oznav2/tectile_skin/electronics/README.md

<div dir="rtl" lang="he">

עברית · [English](README.en.md)

# אלקטרוניקת החישה של ROBOSKIN

זו תת־מערכת חישה עצמאית במתח נמוך לעור אלקטרוני מודולרי. טלאי מלא מודד 28 אתרי מגע נפרדים ושתי טמפרטורות מקומיות. כל טלאי ממיר את אותותיו מקומית ושולח אותם בצמת הזנה ו־CAN FD בעלת ארבעה חוטים. הבנייה הראשונית משתמשת ב־**ספק מעבדה מבודד ומיוצב של 5 V**.

## מה מסופק

- [מעגל טלאי](patch_circuit.json), [חיבורי פינים](patch_circuit_connections.csv) ו[שרטוט מעגל](../assets/electronics/patch_schematic.svg): ‏222 רכיבים ו־104 רשתות, כולל חיישנים מודפסים מרוחקים ונגדי אבחון. בבקר 88 נגדים ו־52 קבלים; 28 נגדי סוף הקו המרוחקים הם נוספים.
- [מעגל אזורי](region_circuit.json), [חיבורים אזוריים](region_circuit_connections.csv) ו[שרטוט צמה](../assets/electronics/wiring_diagram.svg): הזנה מוגנת, חיווי תקלה, איפוס ידני, שני סיומים קבועים ושמונה הסתעפויות מפוזרות על קו ראשי ליניארי רציף.
- [טבלת קצות צמה](harness_connections.csv), [חוזה הזנה](supply_contract.json), [הרכבה וקבלה](assembly_and_acceptance.md), [יומן מקורות יצרן](datasheet_traceability.md), [נתוני עלות רכיבים](patch_cost_inputs.csv), [BOM של המערכת](system_bom.csv) ו[תרחישי עלות](cost_scenarios.json).

ה־JSON הוא **מפרט מעגל ברמת פינים** הניתן לעריכה. קובצי `.net` התואמים הם יצוא בפורמט החלפה XML של KiCad. מחרוזות מארז הן רמזים, ולא הפניות מוסמכות לספריית טביעות רגל. קבצים אלה אינם סכמה מקורית, PCB מנותב, סטנסיל או שחרור לייצור. שרטוט סכמה ו־ERC, אימות טביעות רגל, ניתוב PCB ו־DRC ובדיקות פיזיות נשארים שלבי הנדסה נדרשים. אין טענה לאימות חומרה.

הפיקו מחדש ובדקו את קובצי המעגל המקוריים ללא חיבור לרשת:

<div dir="ltr">

```sh
python3 electronics/build_circuit.py
python3 electronics/test_circuit.py
```

</div>

שמונה בדיקות מכסות קישוריות, הקצאות פינים במארז, מיעון חיישנים עצמאי, כיסוי הגנה, טופולוגיית הזנה, מצב המתנה, סיום אפיק ועקביות פורמט ההחלפה. הן אינן מוכיחות חסינות להפרעות אלקטרומגנטיות, תשואת ייצור או תמונת קושחת MCU פועלת.

## חוזה חשמלי

השתמשו ב־4.75–5.25 V בכניסה האזורית, ובמתח נומינלי 5.00 V. יעד האדווה הוא לכל היותר 100 mV משיא לשיא ברוחב פס מדידה של 20 MHz. בצומת הרחוק ביותר, כניסת ה־LDO המוגנת חייבת להישאר לפחות 3.8 V תחת עומס השיא המדוד. לטלאי מוקצים 30 mA בממוצע ו־80 mA בשיא; לאזור של שמונה צמתים 240 mA בממוצע ו־640 mA בשיא. אלה הקצאות תכנון עד למדידה. הנתיך האלקטרוני האזורי הננעל בכיבוי הוא נומינלית 1 A; מגבלת ספק המעבדה היא 1.5 A לאחר בדיקות התנעה של צמתים נפרדים.

CAN FD משתמש ב־1 Mbit/s בבוררות וב־2 Mbit/s לנתונים. הגבילו את הקו הראשי הליניארי ל־2 m וכל הסתעפות ל־50 mm. הרכיבו בדיוק שני נגדי סיום של 120 Ω על הקו הראשי הקבוע. התנגדות CANH–CANL כאשר המתח כבוי צריכה להיות כ־60 Ω. ניתוק צומת משאיר את הקו הראשי ואת הסיומים שלמים; קצר בקו הראשי עדיין יכול להשבית את כל האזור.

מתאם הייחוס למעבדה הוא **PEAK IPEH-004022** המבודד. בחיבור D-sub שלו: פין 7 הוא CANH, פין 2 הוא CANL ופינים 3/6 הם אדמת החיישנים. השאירו את פין ההזנה האופציונלי 1 לא מחובר ואת הסיום הפנימי כבוי. קשרו את ממשק המארח למספר הסידורי או לנתיב USB של המתאם הפיזי. שם כמו `can0` אינו זהות התקן. [ממשק ומפת פינים של היצרן](https://www.peak-system.com/products/hardware/external-pc-interfaces/pcan-usb-fd/).

האדמה בצד האפיק של המתאם המבודד שייכת להזנת החיישנים. אוסצילוסקופ או מתכנת מוארק עלולים לגשר בשוגג על בידוד זה. השתמשו במדידה מבודדת או דיפרנציאלית מתאימה ואמתו את כל מסלולי הזרם החוזר לפני חיבור מתח למתקן.

## היקף החישה ודוגמת עלות

הטלאי הבסיסי מספק מיקום מגע, עוצמת מגע סדרית ושתי **טמפרטורות נקודתיות אמיתיות**. הוא אינו מספק כוח מכויל, גזירה, קִרבה, תמונה תרמית רציפה או עצירה בעלת דירוג בטיחות. מסלול סוף הקו המרוחק מזהה חלק מהנתקים במוליכים; הוא אינו יכול להוכיח שציפוי רגיש ללחץ שלם.

ב[דוגמה הכללית של שמונה בקרים](example_configuration.json) מספרי האתרים הפעילים הם `4, 6, 4, 6, 6, 28, 6, 28`: **88 אתרי מגע ו־16 נקודות NTC**. זו תצורת בדיקה נייחת, ולא טענה להתאמה או לכיסוי ברובוט מסוים. מסכות שהוכנסו לשירות משביתות ערוצי ADC שאינם בשימוש.

עלות היחידה המחושבת לטלאי מלא היא **$34.78 בכמות ייצור מונחת של 1,000 טלאים**: ‏($29.24 חומר והרכבה חיצונית + $3.30 תהליך סופי + $0.50 תיקון צפוי) / תשואה של 95%. הקצבת התהליך היא 345 שניות בנוכחות מפעיל בתעריף $24 לשעה, בתוספת 300 שניות תחנה בתעריף $12 לשעה. זו אינה הצעת מחיר קמעונאית לאב־טיפוס בן שמונה יחידות. בדוגמת היריעות הקצרות עלויות הבקר קבועות, ומונחות שש יריעות ב־$6 ושתיים ב־$12, כך שעלות חומרת הטלאים המחושבת היא $242.24. עם שער מעבדה אחד ב־$400, הקצבה של $67 לצמה אזורית, מפצל ומארז ותקציב $300 לספק רב־פעמי, הדוגמה מסתכמת ב־**$1,009.24**. הצעות מחיר בפועל לחומר בכמות קטנה, PCB והרכבה עשויות להיות גבוהות משמעותית. כלי ייצור, הנדסה, מחשב מארח, מכשירים אחרים, מס ומשלוח אינם כלולים.

ארבעה אזורים עצמאיים עם אותם שמונה טלאים מסתכמים במודל ב־$2,410.24. שמונה טלאים מלאים בני 28 אתרים באזור אחד מסתכמים ב־$1,045.24; ‏80 טלאים מלאים עם עשרה שערי מעבדה מבודדים ושתי רכזות USB מסתכמים ב־$7,852.40. אלה תרחישי רכש המסומנים בבירור, ולא מחירי מכירה מובטחים.

[כיול אינרציאלי מקומי אופציונלי](optional_calibration.md) מוסיף הקצבת חומרה נפרדת של $159.60 לשמונה IMU, ללא הנדסת קושחה, סנכרון וכיול. לטלאי המגע והטמפרטורה הבסיסי אין IMU והוא אינו יכול לבצע כיול עצמי אינרציאלי לבדו.

</div>
