oznav2/tectile_skin/hardware/03_Harness/README.md

<div dir="rtl" lang="he">

עברית · [English](README.en.md)

# צמות החיווט

כאן רשימת החומרים לצמות, 43 שרטוטי PDF ומפרט הכנה והרכבה.

| מסמך | תוכן |
| --- | --- |
| [רשימת חומרים](ROBOSKIN_Harness_BOM.xlsx) | 42 סוגי צמות: שם, חתך מוליך, מחברים, מגעים וכמויות |
| [שרטוטי ייצור](Drawings/) | המידות, הכיוונים, הסבולות והחיבורים לכל צמה |
| [מפרט הרכבה](Harness_Manufacturing_Specification.docx) | הכנה, סיומות ובדיקות |

יש להתאים את שם הצמה לשרטוט. ARM_10 מפנה ל־ARM_10_Signal_Cable.pdf. אין להסיק את חיבורי צמה אחת מחיבורי צמה בעלת שם דומה.

כבל הזנת הבקר שבדוגמה משתמש בחוט סיליקון 18AWG ובתקע XT30 זכר; אורכו הסופי 120±5 mm. כבל הסוללה לבקר הוא צמה אחרת, עם 14AWG, XT60 ו־300±10 mm.

[שרטוט BODY01](Drawings/ROBOSKIN-BODY01-0_Cable.pdf) · [רשימת חומרים לרובוט](../04_BOM/README.md) · [חומרה](../README.md)

## קטלוג מלא של שרטוטי הצמות

הבדיקה מול עץ המקור, מהדורה `18ca38832cde37a8a4349cff8fbb565f05c6f254`, מאשרת שכל **46 קובצי המקור** נמצאים במאגר: 43 שרטוטי PDF, רשימת חומרים אחת, מפרט הרכבה אחד ומסמך README. עם הגרסה האנגלית של README יש בתיקייה 47 קבצים. [רשומת המקור והמסירה](../provenance/delivery_inventory.json) מתעדת את נתיבי המקור והנתיבים המותאמים.

המספרים 1–42 להלן הם המספרים הסידוריים בגליון הראשון של רשימת החומרים, ולא מספרי חלק חדשים. הכמויות הועתקו מאותו גליון ומסתכמות ב־60 צמות; יש לאמת את התאמתן לתצורת הרובוט הנבנית. הגליון השני חוזר על פריטים 35–42 ואינו רשימת כמויות נוספת. לכל קובץ קישור ישיר; להורדה ב־GitHub יש לבחור **Download raw file**.

| פריט ברשימת החומרים | שם הצמה וקישור לשרטוט PDF | אזור ברשימת החומרים | כמות בגליון הראשון |
| --- | --- | --- | --- |
| 1 | [רשת בין NX לראש](Drawings/NX_Ethernet_HEAD_Cable.pdf) | ראש | 1 |
| 2 | [צמת ראש ROBOSKIN-HEAD1](Drawings/ROBOSKIN-HEAD1_Cable.pdf) | ראש | 1 |
| 3 | [צמת ראש ROBOSKIN-HEAD2](Drawings/ROBOSKIN-HEAD2_Cable.pdf) | ראש | 1 |
| 4 | [צמת ראש ROBOSKIN-HEAD3](Drawings/ROBOSKIN-HEAD3_Cable.pdf) | ראש | 1 |
| 5 | [צמת גוף ROBOSKIN-BODY01-0](Drawings/ROBOSKIN-BODY01-0_Cable.pdf) | בקר ראשי | 1 |
| 6 | [צמת גוף ROBOSKIN-BODY02-0](Drawings/ROBOSKIN-BODY02-0_Cable.pdf) | בקר ראשי | 1 |
| 7 | [צמת גוף ROBOSKIN-BODY03-0](Drawings/ROBOSKIN-BODY03-0_Cable.pdf) | בקר ראשי | 1 |
| 8 | [צמת גוף ROBOSKIN-BODY04-0](Drawings/ROBOSKIN-BODY04-0_Cable.pdf) | בקר ראשי | 1 |
| 9 | [צמת גוף ROBOSKIN-BODY05-0](Drawings/ROBOSKIN-BODY05-0_Cable.pdf) | בקר ראשי | 1 |
| 10 | [צמת גוף ROBOSKIN-BODY06-0](Drawings/ROBOSKIN-BODY06-0_Cable.pdf) | בקר ראשי | 1 |
| 11 | [רשת גוף Body_ETH](Drawings/Body_Ethernet_Cable.pdf) | בקר ראשי | 2 |
| 12 | [תקשורת גוף Body-485](Drawings/Body_RS485_Cable.pdf) | בקר ראשי | 1 |
| 13 | [עצירת חירום BODY-stop](Drawings/BODY_Estop_Cable.pdf) | בקר ראשי | 1 |
| 14 | [צמת לוח תאורה](Drawings/Lighting_Board_Cable.pdf) | בקר ראשי | 1 |
| 15 | [צמת זרוע ROBOSKIN-ARM01-0](Drawings/ROBOSKIN-ARM01-0_Cable.pdf) | זרוע / כף יד | 2 |
| 16 | [צמת זרוע ROBOSKIN-ARM02-0](Drawings/ROBOSKIN-ARM02-0_Cable.pdf) | זרוע / כף יד | 2 |
| 17 | [צמת זרוע ROBOSKIN-ARM03-0](Drawings/ROBOSKIN-ARM03-0_Cable.pdf) | זרוע / כף יד | 2 |
| 18 | [צמת זרוע ROBOSKIN-ARM04-0](Drawings/ROBOSKIN-ARM04-0_Cable.pdf) | זרוע / כף יד | 2 |
| 19 | [צמת זרוע ROBOSKIN-ARM05-0](Drawings/ROBOSKIN-ARM05-0_Cable.pdf) | זרוע / כף יד | 2 |
| 20 | [צמת זרוע ROBOSKIN-ARM06-0](Drawings/ROBOSKIN-ARM06-0_Cable.pdf) | זרוע / כף יד | 2 |
| 21 | [צמת זרוע ROBOSKIN-ARM07-0](Drawings/ROBOSKIN-ARM07-0_Cable.pdf) | זרוע / כף יד | 2 |
| 22 | [צמת זרוע ROBOSKIN-ARM08-0](Drawings/ROBOSKIN-ARM08-0_Cable.pdf) | זרוע / כף יד | 2 |
| 23 | [כבל אות ARM_10](Drawings/ARM_10_Signal_Cable.pdf) | זרוע / כף יד | 2 |
| 24 | [כבל מתאם לכף יד](Drawings/Hand_Adapter_Cable.pdf) | זרוע / כף יד | 2 |
| 25 | [צמת רגל ROBOSKIN-LEG01-0](Drawings/ROBOSKIN-LEG01-0_Cable.pdf) | רגל | 2 |
| 26 | [צמת רגל ROBOSKIN-LEG02-0](Drawings/ROBOSKIN-LEG02-0_Cable.pdf) | רגל | 2 |
| 27 | [צמת רגל ROBOSKIN-LEG03-0](Drawings/ROBOSKIN-LEG03-0_Cable.pdf) | רגל | 2 |
| 28 | [צמת רגל ROBOSKIN-LEG04-0](Drawings/ROBOSKIN-LEG04-0_Cable.pdf) | רגל | 2 |
| 29 | [צמת רגל ROBOSKIN-LEG05-0](Drawings/ROBOSKIN-LEG05-0_Cable.pdf) | רגל | 2 |
| 30 | [צמת רגל ROBOSKIN-LEG06-0](Drawings/ROBOSKIN-LEG06-0_Cable.pdf) | רגל | 2 |
| 31 | [צמת רגל ROBOSKIN-LEG07-0](Drawings/ROBOSKIN-LEG07-0_Cable.pdf) | רגל | 2 |
| 32 | [אותות Back-GPIO](Drawings/Back_GPIO_Cable.pdf) | לוח אחורי | 1 |
| 33 | [לחצן Back-Key](Drawings/Back_Key_Cable.pdf) | לוח אחורי | 1 |
| 34 | [רשת בין הלוח האחורי ל־NX](Drawings/Back_Ethernet_NX_Cable.pdf) | לוח אחורי | 1 |
| 35 | [הזנת BACK-POWER-NX](Drawings/BACK_POWER_NX_Cable.pdf) | לוח אחורי | 1 |
| 36 | [הזנת סוללה ללוח האחורי](Drawings/Battery_to_Back_Power_Cable.pdf) | לוח אחורי | 1 |
| 37 | [הזנת סוללה לבקר הראשי](Drawings/Battery_to_Main_Power_Cable.pdf) | לוח אחורי | 1 |
| 38 | [כבל אספקת הסוללה](Drawings/Battery_Power_Cable.pdf) | לוח אחורי | 1 |
| 39 | [כבל ארוך להגנת סוללת גיבוי](Drawings/Backup_Battery_Protection_Long_Cable.pdf) | לוח אחורי | 1 |
| 40 | [כבל קצר להגנת סוללת גיבוי](Drawings/Backup_Battery_Protection_Short_Cable.pdf) | לוח אחורי | 1 |
| 41 | [צמת הספק ROBOSKIN-POWER01-0](Drawings/ROBOSKIN-POWER01-0_Cable.pdf) | מותן | 1 |
| 42 | [צמת הספק ROBOSKIN-POWER02-0](Drawings/ROBOSKIN-POWER02-0_Cable.pdf) | מותן | 1 |
| ללא שורה נפרדת | [כבל הזנת הבקר](Drawings/Controller_Supply_Cable.pdf) | בקר ראשי | לא הוגדרה ב־BOM |

## פערי מקור שיש ליישב לפני ייצור

- **ARM_10:** פריט 23 ברשימת החומרים מציין `28AWG`, ואילו השרטוט המקורי מציין `22AWG`. הפער נשמר ומתועד; אין להזמין לפי אחד הערכים בלי אישור מפרט מאוחד.
- **ROBOSKIN-POWER02-0:** בשרטוט המקורי, רשימת החומרים והמידה הראשית מציינות אורך כולל של מוליך האות `190 mm`, ואילו טבלת חיבורי הפינים מציינת `260 mm`. אין לבחור אורך על סמך הדמיון ל־POWER01.
- **כבל הזנת הבקר:** השרטוט ה־43 קיים, אך אין לו שורה נפרדת ברשימת 42 סוגי הצמות. יש להגדיר את הכמות והשיוך שלו לתצורה לפני הפקת הזמנה.

אלה פערים שאותרו בבדיקת הקטלוג, ולא אישור הנדסי של כל פין או של כושר נשיאת הזרם. ההרכבה מחייבת הצלבה בין השרטוט המתאים, רשימת החומרים ומפרט ההכנה; יש לבדוק כיוון מבט במחבר, קוטביות, רציפות והיעדר קצר לפני חיבור מתח. לשרטוטים ולכמויות של עור החישה עצמו יש מסמך נפרד בקישור להלן.

[החיווט הנפרד של העור האלקטרוני](../../electronics/harness_connections.csv)

</div>
