oznav2/tectile_skin/hardware/00_Docs/README.en.md

[עברית](README.md) · English

# Hardware documents

[Hardware system architecture](ROBOSKIN_Hardware_Architecture.pdf)

First select the bill of materials for the required configuration. Then find the design and manufacturing files by ROBOSKIN part number.

| Document | Contents |
| --- | --- |
| [Bills of materials](../04_BOM/README.en.md) | Part numbers and quantities for each configuration |
| [Mechanics](../01_Mechanic/README.en.md) | Assemblies, models, drawings and manufacturing requirements |
| [Printed circuit boards](../02_PCB/README.en.md) | Component lists, Gerber files, placement coordinates and assembly requirements |
| [Harnesses](../03_Harness/README.en.md) | Bills of materials, drawings and assembly specification |

[Back to ROBOSKIN hardware](../README.en.md)
