oznav2/tectile_skin/hardware/02_PCB/11_RBE_PWR_140WCHG/README.md

<div dir="rtl" lang="he">

עברית · [English](README.en.md)

# הוראות הרכבה ללוח 140WCHG

[מעגלים](../README.md) · [חומרה](../../README.he.md)

מספר חלק: ROBOSKIN.0042. מהדורה: V1.0.

| סימון | מצב הרכבה | כמות ללוח |
| --- | --- | --- |
| R59 | NC - אין להרכיב | 0 |

הגיליון הראשי ב[רשימת הרכיבים](01_BOM_140WCHG_2026-09-09.xlsx) וב[קובץ CPL](04_CPL_140WCHG_2026-09-16.xlsx) כולל 164 סימוני רכיבים להרכבה.

הנגד 47kΩ, מספר יצרן FRC0603F4702TS, מורכב במיקומים R17,R30, בכמות 2 ללוח. NC_List שומר את R59 בכמות 0, ואין לכלול אותו בכמות לרכש.

בשורה 57 של ה־BOM, Unique ID משמר את קבוצת הייצוא המקורית, שכללה R59. המיפוי בין כל מזהה לסימון רכיב לא אומת. לרכש ולהרכבה יש להסתמך על Designator ו־Quantity בגיליון הראשי ועל ה־CPL התקף. בייצוא BOM להרכבה יש להשתמש בגיליון הראשי בלבד, ללא NC_List.

</div>
