oznav2/tectile_skin/electronics/datasheet_traceability.md

<div dir="rtl" lang="he">

עברית · [English](datasheet_traceability.en.md)

# יומן מקורות המעגל של ROBOSKIN

נבדק מול מסמכי יצרן בתאריך 2026-10-25. התכנון ברמת הפינים משתמש במארז ובגרסה המדויקים ששמם מופיע להלן. החלפה ברכיב דומה מאותה משפחה דורשת סקירה מחודשת של פינים, מתח והתנהגות. בדיקות קישוריות אינן מחליפות סקירת פריסת PCB או מדידות.

| סימון במעגל | רכיב מדויק / מקור | החלטת תכנון הנתמכת במקור |
|---|---|---|
| U1 | [ST STM32G0B1, DS13560](https://www.st.com/resource/en/datasheet/stm32g0b1vc.pdf) | STM32G0B1CBT6, ‏LQFP48 בגרסה שאינה N. טבלת פיני המארז והפונקציות החלופיות קובעות הקצאות ADC, FDCAN, SWD ו־I2C2 אופציונלי. |
| U2 | [TI TPS2553-1, SLVS841F](https://www.ti.com/lit/ds/symlink/tps2553-1.pdf) | פיני DBV: ‏IN 1, GND 2, EN 3, FAULT 4, ILIM 5, OUT 6. גרסת **-1** ננעלת בכיבוי; ל־TPS2553 הרגיל אין אותה תגובת תקלה. נגד קביעת זרם של 200 kΩ נמצא בתחום המוגדר; יש למדוד זרם ניתוק בתנאים המיועדים. |
| U3; אזורי U_MON | [TI TPS7A24, SBVS386E](https://www.ti.com/lit/ds/symlink/tps7a24.pdf) | גרסת 3.3 V קבועה: IN 1, GND 2, EN 3, NC 4, OUT 5. היצרן מתיר לחבר NC בגרסה הקבועה לאדמה לצורך ביצועים תרמיים. EN מחובר ל־IN. קיבול המוצא האפקטיבי חייב לעמוד בדרישת היציבות לאחר הפחתה עקב מתח הטיה וטמפרטורה. |
| U4 | [TI TCAN3413, SLLSFS8A](https://www.ti.com/lit/ds/symlink/tcan3413.pdf) | SOIC8: ‏TXD 1, GND 2, VCC 3, RXD 4, VIO 5, CANL 6, CANH 7, STB 8. ‏VCC ו־VIO משתמשים ב־3.3 V. נגד משיכה חומרתי שומר על מצב המתנה בזמן איפוס. |
| U_MUX0–3 | [TI TMUX1308, SCDS426E](https://www.ti.com/lit/ds/symlink/tmux1308.pdf) | PW/TSSOP16: ‏S0…S7 ממופים לפינים 13,14,15,12,1,5,2,4; ‏D=3; ‏EN=6 פעיל בנמוך; ‏7=NC; ‏8=GND; ‏A2/A1/A0=9/10/11; ‏VDD=16. שמרו מתחי חיישנים בתחום ההזנה הרגיל; התנהגות בהזרקת תקלה אינה מצב הפעלה. |
| D_A0–7 | [TI TPD4E1U06, SLVSBQ9E](https://www.ti.com/lit/ds/symlink/tpd4e1u06.pdf) | ערוצי הגנה DBV/SOT23-6 בפינים 1,6,3,4; אדמה 2; ‏NC 5. מקמו במחבר עם נתיבי חזרת פריקה קצרים. דירוגי ESD ברמת הרכיב אינם קובעים את חסינות מערכת העור. |
| D_CAN | [Nexperia PESD2CANFD24V-T](https://assets.nexperia.com/documents/data-sheet/PESD2CANFD24V-T.pdf) | שני קווי אפיק בפינים 1/2 והחזרה משותפת ב־3, כפי שמוצג במעגל יישום CAN. הימנעו מלולאות אדמה ארוכות וממסלולים מוגנים ולא מוגנים המקבילים זה לזה. |
| Y1 | [מתנד Abracon ASV](https://abracon.com/Oscillators/ASV.pdf) | פין 1 אפשור, 2 אדמה/מארז, 3 מוצא, 4 הזנה. ASV-8.000MHZ-LC-T בוחר 8 MHz, ‏3.3 V, ‏−40…85 °C ו־±50 ppm. נדרשת תצורת HSE bypass; זהו מתנד, ולא גביש חשוף. |
| אזורי U_REG | [TI TPS2595, SLVSE57C](https://www.ti.com/lit/ds/symlink/tps2595.pdf) | TPS259530 הוא הגרסה בעלת הגבלת מתח 5.7 V, אפשור פעיל בגבוה ונעילה בכיבוי. dVdt 1, EN/UVLO 2, IN 3/4, OUT 5, FAULT 6, ILM 7, GND 8; הפד החשוף מחובר לאדמה. פין 9 ברשימת הרשתות בפורמט ההחלפה מייצג פד חשוף זה. |
| צמה J1 / בית מחבר הסתעפות | [סדרת JST GH](https://www.jst-mfg.com/product/pdf/eng/eGH.pdf) | מחבר לוח BM04B-GHS-TBT עם בית GHR-04V-S ומגעי SSHL-002T-P0.2. אשרו טווח חוט ובידוד למסוף, כלי לחיצה וכיוון חיבור. מספור פינים חשמלי לבדו אינו שרטוט מבט מחבר. |
| גרסה אינרציאלית אופציונלית | [ST LSM6DSOX](https://www.st.com/resource/en/datasheet/lsm6dsox.pdf), [מודול Adafruit 4438](https://www.adafruit.com/product/4438) | גרסת IMU מקומית נפרדת; הזרם, הקושחה, הסנכרון והכיול שלה אינם כלולים בשקט בטלאי הבסיסי. |

אין גיליון נתונים של יצרן למבנה תאי החישה המודפס המותאם. טווח ההתנגדות, היסטרזיס, זחילה, הזדקנות, תגובה ללחות וסבולות למינציה חייבים להגיע ממדידות הקופונים והאצוות המתועדות. נגד סוף קו מודפס מוכיח מסלול מוליך, ולא ציפוי רגיש ללחץ שלם. השילוב הסופי של יריעה, מחבר ולוח חייב לעבור את רצף הקבלה לפני שהמערכת יכולה לדווח על כיסוי עור שימושי.

</div>
