oznav2/tectile_skin/templates/rfq.en.md

[עברית](rfq.md) · English

# Draft RFQ — protected 28-cell contact-skin cassette, revision 2

Status: draft, not sent. Buyer: Ilan. Delivery destination: Israel (complete address and Incoterm in the purchase order).

Please quote separately for 5, 30, 100, 1,000 and 10,000 units. State currency, quote validity, MOQ, lead time, tooling/NRE, tooling maintenance, payment terms, sample charges, shipment and taxes separately. Do not substitute materials or remove tests without an itemized alternate offer.

Reference: electronic_skin.md revision 2. The scope must identify one of:

- Complete printed sensor sheet: 28 independent resistive cells, 23 mm active squares on 25 mm pitch, seven columns/four rows; nominal sensing rectangle 175 x 100 mm; sealing margins, tail and detailed drawing attached at release.
- Controller PCBA: attached reviewed schematic, Gerbers, exact-MPN BOM, placement files, programming/test specification.
- Converted protective cover/cassette assembly: attached mechanical drawing, approved material grades/gauges, thermal-island and vent interfaces.

Sensor requirements: all 28 remote EOL resistors 100 kOhm nominal, 80–120 kOhm including specified aging; independent wiring with no passive matrix ghosting; 40-contact reinforced tail to the stated Hirose connector; isolated resistive islands; controlled spacers and back-directed vents; serialized lots and 100% continuity inspection. Quote internal sheet lamination and test in the sheet price. External protective cover, thermal flex and final force calibration are separate unless explicitly itemized.

Please provide:

1. Approved material/process stack, tolerances, tooling registration, tail contact construction, bend limits and storage life.
2. Sample raw resistance/force data, hysteresis, hold drift, humidity/temperature behavior and lifetime test conditions/sample sizes. Distinguish measured data from targets.
3. Quote for the test plan in sections 18–19, fixture/NRE costs, first-pass and final yield assumptions, rework/scrap policy, and test data export format.
4. Actual process time, operator attendance and station occupancy. Do not combine these into an undocumented flat calibration fee.
5. Artwork/tool ownership, material change notification, traceability, process/IP restrictions, second-source or continuity-of-supply terms.
6. A technical exception list against every unmet requirement. State whether the $12 sheet-cost objective at 1,000 units is attainable; if not, quote the real cost and the changes needed.

No production commitment is made by this inquiry. Sample acceptance and purchasing require the controlled drawing revision and written acceptance criteria. No supplier outreach was performed in preparing this draft.
