oznav2/tectile_skin/research/reference_index.en.md

[עברית](reference_index.md) · English

# Cheng bibliography: all 84 requested references

Evidence audit dated 24 October 2026. Original numbering is preserved. This covers the specified bibliography, not every publication in the field.

**Reading status matters:** full text available with specified section review is different from complete reading of every page; partial/indexed excerpts, abstracts and citations are explicitly labeled. See each record’s `read_scope`. No unavailable methods or measurements are invented.

| Access level | References |
|---|---:|
| ABSTRACT_ONLY | 29 |
| CITATION_ONLY | 13 |
| FULL_TEXT | 25 |
| PARTIAL_TEXT | 17 |

Detailed dossiers:

- [Sensing and materials](sensing_materials/review.en.md)
- [Calibration and networking](calibration_networks/review.en.md)
- [Control and applications](control_applications/review.en.md)

[Structured records](reference_index.json) retain source URLs, reading scope, findings, limitations and plan decisions.

| No. | Original source | Access | Exact reading scope |
|---:|---|---|---|
| 1 | [Automated tactile sensing](https://journals.sagepub.com/doi/10.1177/027836498200100201) | CITATION_ONLY | Publisher metadata and exposed footnotes; full article unavailable. Not treated as a full-text or abstract review. |
| 2 | [E-skin: From humanoids to humans](https://eprints.gla.ac.uk/183481/1/183481.pdf) | FULL_TEXT | Accepted manuscript: introduction and sections comparing electronic-skin requirements, integration routes and flexible/printed electronics; not every concluding paragraph or cited work. |
| 3 | [Tactile sensing—From humans to humanoids](https://www.robotcub.org/misc/papers/10_Dahiya_etal.pdf) | PARTIAL_TEXT | Indexed author/project PDF excerpts: classification figure 2, section III physiology, encoding and regional sensing requirements. Direct PDF retrieval failed; author-uploaded proof excerpts also located. |
| 4 | [Directions toward effective utilization of tactile skin: A review](https://eprints.gla.ac.uk/95989/) | ABSTRACT_ONLY | Glasgow institutional abstract and bibliographic record; TUM institutional abstract. Full original text not read. |
| 5 | [Proximity sensing in robot manipulator motion planning: System and implementation issues](https://www.edcheung.com/job/sbr/IEEE88.pdf) | FULL_TEXT | Author-hosted manuscript: system architecture/local planning, approximately manuscript pages 2–4; author project page identifying the publication. Not all experiments. |
| 6 | [Sensitive skin](https://resenv.media.mit.edu/classarchive/MAS965/readings/sensitiveskin.pdf) | FULL_TEXT | Original article via MIT teaching archive: introduction; hardware/device requirements and low-cost-process discussion, printed pp.46–47. Other portions not exhaustively read. |
| 7 | [Conformable, flexible, large-area networks of pressure and thermal sensors with organic transistor active matrixes](https://pmc.ncbi.nlm.nih.gov/articles/PMC1187825/) | FULL_TEXT | Open primary main text, fabrication and pressure/thermal experiments, figures 1–5 captions; not supplementary data or independent replication. |
| 8 | [Artificial Skin in Robotics: A Comprehensive Interface for System-Environment Interaction](https://publikationen.bibliothek.kit.edu/1000028782/2186259) | FULL_TEXT | Selected thesis text: design tradeoffs in chapter 3; chapter 4.1 test procedures, printed pp.152–159; conclusions. Not the complete 217-page PDF. |
| 9 | [Conformable and scalable tactile sensor skin for curved surfaces](https://bdml.stanford.edu/twiki/pub/Haptics/TactileChapterReferences/Ohmura-ICRA06.pdf) | FULL_TEXT | Original six-page article: abstract, requirements, sections III–IV and beginning of V, figure captions 1–10. Remaining experiment/conclusion paragraphs not exhaustively read. |
| 10 | [Development of the tactile sensor system of a human-interactive robot RI-MAN](https://repository.gatech.edu/bitstreams/39fe7cef-a8a4-4ebb-81a4-097c885fa7bd/download) | PARTIAL_TEXT | Indexed original first-page abstract/introduction from Georgia Tech repository. PDF download returned 403; main experiments not read. |
| 11 | [ARMAR-III: An integrated humanoid platform for sensory-motor control](https://h2t.iar.kit.edu/pdf/Asfour2006b.pdf) | FULL_TEXT | Original article sections on arm sensing and artificial skin, pp.2–3 of PDF, and hierarchical architecture/figure 5. Not all platform experiments. |
| 12 | [Design of human symbiotic robot TWENDY-ONE](https://waseda.elsevierpure.com/en/publications/design-of-human-symbiotic-robot-twendy-one/) | ABSTRACT_ONLY | Author-institution publication record and abstract. Original seven-page article not accessed. |
| 13 | [Humanoid robot which can lift a 30 kg box by whole body contact and tactile feedback](https://www.isi.imi.i.u-tokyo.ac.jp/publication/) | CITATION_ONLY | Author laboratory bibliography and publisher record link verified. Original article unavailable; secondary syndicated abstract seen but not used as verified experimental evidence. |
| 14 | [Whole body haptics for augmented humanoid task capabilities](https://link.springer.com/chapter/10.1007/978-3-642-14743-2_6) | ABSTRACT_ONLY | Publisher abstract, chapter metadata and references; subscription full chapter unavailable. |
| 15 | [An embedded artificial skin for humanoid robots](https://robotcub.org/misc/papers/08_cannata.pdf) | FULL_TEXT | Entire substantive five-page original article, including architecture, transducer, microcontroller, experiments and conclusions; figure captions. Images not independently resolved. |
| 16 | [Methods and technologies for the implementation of large-scale robot tactile sensors](https://www.researchgate.net/publication/224238240_Methods_and_Technologies_for_the_Implementation_of_Large-Scale_Robot_Tactile_Sensors) | FULL_TEXT | Author-uploaded manuscript: sections I, III, V and VI-A–D, assembly figure captions. Not every hysteresis equation or grasping trial. |
| 17 | [A flexible and robust large scale capacitive tactile system for robots](https://arxiv.org/pdf/1411.6837) | FULL_TEXT | Author manuscript sections III–IV, integration text and experimental figure captions; most main text read, not supplementary data. |
| 18 | [A new silicone structure for uSkin—A soft, distributed, digital 3-axis skin sensor and its integration on humanoid robot iCub](https://qmro.qmul.ac.uk/xmlui/bitstream/handle/123456789/55045/Jamone%20A%20New%20Silicone%202018%20Accepted.pdf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) | PARTIAL_TEXT | Indexed primary accepted manuscript section III-A/B, tableI and figure 1–2 captions; direct repository PDF retrieval failed. Calibration/results not fully read. |
| 19 | [An adjustable force sensitive sensor with an electromagnet for a soft, distributed, digital 3-axis skin sensor](https://waseda.elsevierpure.com/en/publications/an-adjustable-force-sensitive-sensor-with-an-electromagnet-for-a-/) | ABSTRACT_ONLY | Author-institution abstract and publication identity; original full text not read. |
| 20 | [A real-time distributed architecture for large-scale tactile sensing](https://ewh.ieee.org/soc/ras/conf/financiallycosponsored/IROS/2014/www.iros2014.org/images/download/IROS2014-Full-Conference-Digest.pdf) | ABSTRACT_ONLY | Official IROS2014 digest, p.134, and author-uploaded abstract; original seven-page paper not obtained. |
| 21 | [A real-time data acquisition and processing framework for large-scale robot skin](https://www.sciencedirect.com/science/article/pii/S0921889015000172) | PARTIAL_TEXT | Publisher-indexed introduction and selected architecture/implementation sections, including Skinware abstraction and historical test platform. Full results and figures not reviewed. |
| 22 | [Asynchronous, event-driven readout of POSFET devices for tactile sensing](https://doi.org/10.1109/ISCAS.2014.6865717) | CITATION_ONLY | Identity and conference pages2648–2651 checked against ISCAS proceedings contents; original abstract/body not obtained. DOI corroborated by later scholarly reference lists. |
| 23 | [Event-driven encoding of off-the-shelf tactile sensors for compression and latency optimisation for robotic skin](https://www.researchgate.net/publication/321816551_Event-driven_encoding_of_off-the-shelf_tactile_sensors_for_compression_and_latency_optimisation_for_robotic_skin) | PARTIAL_TEXT | Author-uploaded manuscript excerpts: architecture, encoding comparison and conclusions. Primary IIT laboratory publication listing also checked. Full paper was not independently downloaded. |
| 24 | [The event-driven software library for YARP—With algorithms and iCub applications](https://www.frontiersin.org/journals/robotics-and-ai/articles/10.3389/frobt.2017.00073/full) | PARTIAL_TEXT | Publisher-indexed sections3.2–3.3 on event representation, readers/queues and processing; complete article body not retrieved. |
| 25 | [Reactive motion control for human-robot tactile interaction](https://doi.org/10.1109/ROBOT.2002.1014313) | CITATION_ONLY | Citation identity checked against DBLP; a ResearchGate-hosted abstract was found, but no primary full text or primary abstract was successfully retrieved. The secondary abstract is not used as implementation evidence. |
| 26 | [Real-time collision avoidance in teleoperated whole-sensitive robot arm manipulators](https://ntrs.nasa.gov/citations/19930059726) | ABSTRACT_ONLY | NASA repository abstract and metadata. Author-hosted TR91.pdf was identified as an earlier technical report, not silently treated as the exact 1993 journal article. |
| 27 | [Whole-arm reactive collision avoidance control of kinematically redundant manipulators](https://dblp.org/rec/conf/icra/BoddyT93) | CITATION_ONLY | DBLP identity and secondary Science Explorer abstract located. No author/publisher full text retrieved; secondary abstract is excluded as technical proof. |
| 28 | [Programming by touch: The different way of human-robot interaction](https://elib.dlr.de/11914/) | CITATION_ONLY | DLR publication record; repository explicitly does not supply the full text. No algorithm inferred from the title. |
| 29 | [Manual guidance for industrial robot programming](https://iris.univpm.it/handle/11566/228093) | ABSTRACT_ONLY | University repository metadata and complete abstract; no attached full text available. |
| 30 | [Tactile sensing in intelligent robotic manipulation—A review](https://www.researchgate.net/publication/228667424_Tactile_sensing_in_intelligent_robotic_manipulation_-_a_review) | FULL_TEXT | Author-uploaded text: introduction, sections 5.2–5.7 and conclusions. KTH thesis reprint located but oversized PDF could not be retrieved. |
| 31 | [Sensitive manipulation: Manipulation through tactile feedback](https://lornat75.github.io/pdfs/2018-torresjara-sensitive.pdf) | FULL_TEXT | Author manuscript abstract/introduction, hardware figure 1 and sections 4.1.3–4.3, PDFpp.12–15. Not all experiments. |
| 32 | [High-density conformable tactile sensing glove](https://ieeexplore.ieee.org/document/6100898) | CITATION_ONLY | Author laboratory bibliography verified; original full text not accessed. Exact-paper syndicated abstract and a distinct 2012 JRSJarticle abstract were seen, and are not substituted for the original. |
| 33 | [Development and applications of high-density tactile sensing glove](https://link.springer.com/chapter/10.1007/978-3-642-31401-8_40) | ABSTRACT_ONLY | Publisher abstract and bibliographic record; subscription chapter not read in full. |
| 34 | [Tactile object class and internal state recognition for mobile manipulation](https://jsturm.de/publications/data/chitta10icra.pdf) | PARTIAL_TEXT | Indexed author-hosted original conference PDF methods/results excerpts, especially tablesII–IV. Direct PDF retrieval timed out; later journal version was kept distinct. |
| 35 | [Learning inverse dynamics models with contacts](https://www.robertocalandra.com/papers/calandra_icra_2016.pdf) | FULL_TEXT | Author PDF, 6 pages; abstract, §§II–III, §IV-A through E and conclusion read. Filename says 2016; bibliographic paper is 2015. |
| 36 | [A simple tactile sensing foot for humanoid robot and active ground slope recognition](https://doi.org/10.1109/ICMECH.2009.4957223) | ABSTRACT_ONLY | Publisher abstract and introduction excerpt, not the complete sensor/control evaluation. |
| 37 | [Design and experiment of the NAO humanoid robot’s plantar tactile sensor for surface classification](https://www.researchgate.net/publication/321122717_Design_and_Experiment_of_the_NAO_Humanoid_Robot%27s_Plantar_Tactile_Sensor_for_Surface_Classification) | FULL_TEXT | Author-uploaded original: abstract, sections III–Vthrough classifier setup, diagrams/captions. Final result table and conclusion not exhaustively read. |
| 38 | [An adaptive sensor foot for a bipedal and quadrupedal robot](https://www.dfki.de/web/forschung/projekte-publikationen/publikation/6214) | ABSTRACT_ONLY | DFKI institutional publication abstract and metadata. Original paper not read. |
| 39 | [A ZMP sensor for a biped robot](https://researchmap.jp/read0072509/published_papers/15818833/attachment_file.pdf) | PARTIAL_TEXT | Indexed author-hosted first-page abstract. Direct PDF retrieval 403; complete derivation and experiments not read. |
| 40 | [High-speed pressure sensor grid for humanoid robot foot](https://tus.elsevierpure.com/en/publications/high-speed-pressure-sensor-grid-for-humanoid-robot-foot/) | ABSTRACT_ONLY | Author-institution abstract and bibliographic record. Original six-page paper not accessed. |
| 41 | [Humanoid multimodal tactile-sensing modules](https://portal.fis.tum.de/en/publications/humanoid-multimodal-tactile-sensing-modules/) | ABSTRACT_ONLY | University bibliographic record and abstract; full methods, circuit and characterization tables not obtained. |
| 42 | [Integrating discrete force cells into multi-modal artificial skin](https://mediatum.ub.tum.de/doc/1116556/214040.pdf) | PARTIAL_TEXT | Repository-indexed first-page abstract, force-cell construction and introduction. Full force/displacement graphs and durability results not reviewed. |
| 43 | [Towards autonomous robotic skin spatial calibration: A framework based on vision and self-touch](https://doi.org/10.1109/IROS.2017.8202151) | CITATION_ONLY | Primary university publication list verifies identity; a secondary abstract describes RGB-D/self-touch, but original abstract/body was not obtained. The secondary <2mm result is deliberately not adopted as validated evidence. |
| 44 | [3D surface reconstruction for robotic body parts with artificial skins](https://mediatum.ub.tum.de/doc/1116558/621068.pdf) | PARTIAL_TEXT | Repository first-page abstract/introduction and university abstract. The supplied2019 review §II-C supplies additional secondary explanation of reconstruction. |
| 45 | [Open-loop self-calibration of articulated robots with artificial skins](https://mediatum.ub.tum.de/doc/1116557/877587.pdf) | PARTIAL_TEXT | Repository-indexed pages1–2 including algorithms1–2, requirements and experimental/simulation scope; university abstract read directly. Full numerical results not obtained. |
| 46 | [Automatic robot kinematic modeling with a modular artificial skin](https://portal.fis.tum.de/en/publications/automatic-robot-kinematic-modeling-with-a-modular-artificial-skin/) | ABSTRACT_ONLY | University abstract and bibliographic record read directly. Original six-page article unavailable. Supplied2019 review §II-D is secondary evidence for axis/SVD/radius sequence. |
| 47 | [3D spatial self-organization of a modular artificial skin](https://portal.fis.tum.de/en/publications/3d-spatial-self-organization-of-a-modular-artificial-skin) | ABSTRACT_ONLY | Primary university abstract and identity. Full equations and numerical experiments not obtained. |
| 48 | [Touch, in Principles of Neural Science, fifth edition, chapter23](https://accessmedicine.mhmedical.com/book.aspx?bookID=1049) | CITATION_ONLY | User-supplied2019 bibliography identifies chapter23, pp.498–529. Full chapter not obtained; publisher book URL is a locator, not a claim of chapter access. |
| 49 | [Touch is a team effort: Interplay of submodalities in cutaneous sensibility](https://pubmed.ncbi.nlm.nih.gov/25257208/) | ABSTRACT_ONLY | Original article abstract indexed by PubMed; full review body not obtained. |
| 50 | [Event-based signaling for reducing required data rates and processing power in a large-scale artificial robotic skin](https://mediatum.ub.tum.de/doc/1281179/868479268848.pdf) | PARTIAL_TEXT | Repository-indexed results page6, figures7–8/table/conclusion, plus official conference abstract. Whole methods not retrieved. |
| 51 | [Event-based signaling for large-scale artificial robotic skin—Realization and performance evaluation](https://mediatum.ub.tum.de/doc/1335609/document.pdf) | PARTIAL_TEXT | Repository-indexed introduction/architecture and primary university abstract; complete experiment methods not accessed. |
| 52 | [Efficient event-driven reactive control for large scale robot skin](https://mediatum.ub.tum.de/doc/1366849/document.pdf) | PARTIAL_TEXT | Repository first-page abstract/introduction. Detailed control proofs and full experimental plots not accessed. |
| 53 | [A128×128120dB15µs latency asynchronous temporal contrast vision sensor](https://doi.org/10.1109/JSSC.2007.914337) | PARTIAL_TEXT | Original journal-paper reproduction, concluding page575 and indexed abstract. The reproduction is on a secondary host; full article not retrieved. |
| 54 | [An asynchronous time-based image sensor](https://publications.ait.ac.at/en/publications/an-asynchronous-time-based-image-sensor/) | CITATION_ONLY | Primary institutional bibliographic metadata checked. A secondary abstract was found, but no original body or complete primary abstract was reviewed. |
| 55 | [AER EAR: A matched silicon cochlea pair with address event representation interface](https://researchers.westernsydney.edu.au/en/publications/aer-ear-a-matched-silicon-cochlea-pair-with-address-event-represe-3/) | ABSTRACT_ONLY | Primary institutional abstract. This is the2005conference paper, not the later similarly named journal work. |
| 56 | [VLSI analogs of neuronal visual processing: A synthesis of form and function](https://authors.library.caltech.edu/records/g2vmh-8fe19) | ABSTRACT_ONLY | Caltech thesis repository metadata and abstract. The full thesis was located but not read. |
| 57 | [Point-to-point connectivity between neuromorphic chips using address events](https://web.stanford.edu/group/brainsinsilicon/documents/00_journ_IEEEtsc_Point.pdf) | PARTIAL_TEXT | Author-hosted abstract and repository-indexed discussion/arbiter figures; not all19journal pages. |
| 58 | [Asynchronous DC-free serial protocol for event-based AER systems](https://iris.polito.it/handle/11583/2646243) | ABSTRACT_ONLY | Primary university abstract; original article file is restricted and was not requested from authors. |
| 59 | [A QVGA143dB dynamic range frame-free PWM image sensor with lossless pixel-level video compression and time-domain CDS](https://ieeexplore.ieee.org/document/5648367) | CITATION_ONLY | IEEE title/record and primary AIT institutional identity; original methods and figures not obtained. Similar2010ISSCC conference versions are not substituted. |
| 60 | [A new protocol for a low power sensor network](https://www.researchgate.net/publication/4075406_A_new_protocol_for_a_low_power_sensor_network) | ABSTRACT_ONLY | Author-uploaded abstract and official conference contents; original protocol details and results not read. |
| 61 | [Send-on-delta concept: An event-based data reporting strategy](https://mdpi-res.com/d_attachment/sensors/sensors-06-00049/article_deploy/sensors-06-00049.pdf) | FULL_TEXT | Official MDPI static PDF downloaded locally; all15pages49–63 read, including equations1–13, tables1–2, software example and references. Figure3 on p.58 visually inspected. |
| 62 | [A robust and efficient dynamic network protocol for a large-scale artificial robotic skin](https://mediatum.ub.tum.de/doc/1459302/136167106011.pdf) | PARTIAL_TEXT | Repository-indexed abstract, first-page introduction and topology/rerouting figure. Detailed implementation and remaining experiments not read. |
| 63 | [Realizing whole-body tactile interactions with a self-organizing, multi-modal artificial skin on a humanoid robot](https://staff.aist.go.jp/e.yoshida/papers/Mittendorfer_2014AR.pdf) | FULL_TEXT | Author PDF, 17 pages; hardware tables, §§3–4.3, §5, grasping experiments and limitations/conclusion examined. Equations for activity and sensory-motor mapping checked. |
| 64 | [From multi-modal tactile signals to a compliant control](https://mediatum.ub.tum.de/doc/1335611/document.pdf) | FULL_TEXT | Author PDF, 7 pages; §§II–III, IV-A and IV-D–F, experimental section and conclusion read. |
| 65 | [Whole-body active compliance control for humanoid robots with robot skin](https://portal.fis.tum.de/en/publications/whole-body-active-compliance-control-for-humanoid-robots-with-rob/) | ABSTRACT_ONLY | TUM author-affiliated abstract and metadata; original full paper unavailable. Cheng 2019's summary is secondary evidence, not a substitute full-text read. |
| 66 | [TOMM: Tactile omnidirectional mobile manipulator](https://portal.fis.tum.de/en/publications/tomm-tactile-omnidirectional-mobile-manipulator/) | ABSTRACT_ONLY | TUM publication record and full abstract; original implementation paper not read. |
| 67 | [An overview of null space projections for redundant, torque-controlled robots](https://elib.dlr.de/101443/2/NullspaceSurvey.pdf) | FULL_TEXT | DLR author manuscript, 17 PDF pages; §2 assumptions, consistency formulations, §4.2 actuator-limited experiment and §§5.1–5.2 discussion read. |
| 68 | [Synthesis of whole-body behaviors through hierarchical control of behavioral primitives](https://ai.stanford.edu/~lsentis/files/ijhr-05.pdf) | FULL_TEXT | Author-hosted journal PDF, 14 pages; §§1–4 including equations 17–22, §5 simulated example and discussion read. |
| 69 | [Efficient distributed torque computation for large scale robot skin](https://portal.fis.tum.de/en/publications/efficient-distributed-torque-computation-for-large-scale-robot-sk/) | ABSTRACT_ONLY | TUM abstract; original author PDF at mediatum/1459300 returned rate/access errors. Detailed fixed-point/poly approximation description available only through the user-supplied Cheng 2019 review. |
| 70 | [Tactile-based whole-body compliance with force propagation for mobile manipulators](https://portal.fis.tum.de/en/publications/tactile-based-whole-body-compliance-with-force-propagation-for-mo/) | ABSTRACT_ONLY | TUM abstract; primary PDF mediatum/1474210 identified but access failed. Earlier conference paper [77] read separately and not represented as this journal article. |
| 71 | [Humanoid robot HRP-2](https://doi.org/10.1109/ROBOT.2004.1307969) | CITATION_ONLY | Citation identity checked; third-party PDF mirror found but not successfully retrieved. Related AIST platform material is not substituted for the original article. |
| 72 | [Integration of robotic technologies for rapidly deployable robots](https://mediatum.ub.tum.de/doc/1446657/883306792253.pdf) | FULL_TEXT | Author PDF contains duplicated proof material (22 pages for an approximately 11-page manuscript); architecture, §V deployment/application results, footnote 13 and conclusion read. |
| 73 | [A survey of unknown object grasping and our fast grasping algorithm—C shape grasping](https://repository.tudelft.nl/record/uuid%3Ae16cac95-3ada-4950-b9ac-a0cdfc8cdaef) | ABSTRACT_ONLY | TU Delft original conference repository abstract and metadata. Related thesis chapter located but not used as a complete read of the conference paper. |
| 74 | [A unified approach for motion and force control of robot manipulators: The operational space formulation](https://khatib.stanford.edu/publications/pdfs/Khatib_1987_RA.pdf) | ABSTRACT_ONLY | Author-hosted first-page abstract/introduction indexed by search; direct PDF fetch repeatedly timed out. Full equation audit uses [64,68] and the supplied Cheng 2019 text instead. |
| 75 | [Robot Control: The Task Function Approach](https://books.google.com/books/about/Robot_Control.html?id=-DZSAAAAMAAJ) | CITATION_ONLY | Bibliographic book metadata; no chapter text retrieved or read. |
| 76 | [Integration of reactive, torque-based self-collision avoidance into a task hierarchy](https://elib.dlr.de/79360/4/Dietrich_TRO2012.pdf) | FULL_TEXT | DLR author manuscript, 15 PDF pages; formulation, damping/task-transition treatment, experiment setup and limitations examined. |
| 77 | [Tactile-based compliance with hierarchical force propagation for omnidirectional mobile manipulators](https://mediatum.ub.tum.de/doc/1336140/document.pdf) | FULL_TEXT | Author PDF, 6 pages; introduction and §II modeling assumptions, skin-force and propagation formulation read; not a complete experimental replication audit. |
| 78 | [Safe and dependable physical human-robot interaction in anthropic domains: State of the art and challenges](https://www.diag.uniroma1.it/~labrob/pub/papers/PHRIDOM_IROS06.pdf) | FULL_TEXT | Author-hosted workshop manuscript, 15 PDF pages; §§II-A, III-A/B and IV sensor/dependability discussion read. Version/pagination differ from publisher metadata; standards discussion is historical, not current compliance advice. |
| 79 | [Impedance control: An approach to manipulation: Part III—Applications](https://bpb-us-e1.wpmucdn.com/sites.mit.edu/dist/5/1384/files/2025/02/1985-impedance-control-an-approach-to-manipulation-part-III-applications.pdf) | FULL_TEXT | MIT-hosted original paper, 8 pages; introduction, impedance selection and obstacle-avoidance derivation read, especially pp. 17–20 and simplifying assumptions. |
| 80 | [A new actuation approach for human friendly robot design](https://khatib.stanford.edu/publications/pdfs/Zinn_2004_IJRR.pdf) | ABSTRACT_ONLY | Author-hosted journal abstract/first page and one search-indexed §3.1.3 passage on saturation inspected. Direct full PDF fetch failed. Closely titled ISER/ICRA versions are not substituted. |
| 81 | [Control of generalized contact motion and force in physical human-robot interaction](https://www.diag.uniroma1.it/deluca/pHRI_elective/ICRA15_Magrini_Flacco_ADL_ContactMotionForceControl_pHRI.pdf) | ABSTRACT_ONLY | Author-hosted abstract/introduction and search-indexed early modeling passages inspected; repeated direct PDF fetches timed out. Classified conservatively because full paper was not retrieved. |
| 82 | [Human-robot coexistence and contact handling with redundant robots](https://www.diag.uniroma1.it/~deluca/pHRI_elective/IROS17_Magrini_ADL_HRCoexistenceContactRedundant.pdf) | FULL_TEXT | Author PDF, 7 pages; introduction, §III including Remark 1, §IV handling logic and transition description read. |
| 83 | [Human body part multicontact recognition and detection methodology](https://sites.utexas.edu/hcrl/files/2016/01/paper-kwan-suk-icra.pdf) | ABSTRACT_ONLY | UT Austin author-hosted abstract/introduction via search index. Direct PDF fetch failed; author-uploaded secondary full text found but not substituted for a verified full read. |
| 84 | [Long-term training with a brain-machine interface-based gait protocol induces partial neurological recovery in paraplegic patients](https://www.nature.com/articles/srep30383) | ABSTRACT_ONLY | Publisher-indexed abstract and bibliographic identity; publisher full text redirected to an inaccessible identity service and PMC4980986 returned a browser challenge. No methods-section audit claimed. |

## Decisions and unresolved evidence

### [1] Automated tactile sensing

**Supported finding:** An early review establishing the historical depth of automated tactile sensing. No quantitative sensor result from this article is adopted here.

**Limit:** Published material reflects information acquired before January 1981; historical recommendations are not current component specifications.

**Action for this project:** Use only as historical background. Set limb requirements from the actual contact tasks and acceptance tests, rather than invoking human-equivalence targets from an unread historical review.

### [2] E-skin: From humanoids to humans

**Supported finding:** The viewpoint contrasts conventional components on flexible substrates with printed and ultrathin electronics. More discrete functionality competes with conformability; requirements depend on the application.

**Limit:** A perspective article is not evidence that a particular printed film has acceptable fatigue life, manufacturing yield, cost or multimodal accuracy.

**Action for this project:** Keep a small number of proven modalities in the first product. Put packaged electronics on mechanically supported islands; qualify the complete interconnect and cover. Track area, installed mass and repair time separately from sensor-element thickness.

### [3] Tactile sensing—From humans to humanoids

**Supported finding:** The review distinguishes cutaneous from joint/force sensing, fingertip arrays from large-area skin, and slowly adapting from rapidly adapting tactile channels. Receptor density and required temporal/spatial performance differ by body site.

**Limit:** Biological receptor counts and perceptual acuity do not directly specify electronic taxel pitch, ADC resolution or required robot bandwidth. This is a review, not validation of our sensor stack.

**Action for this project:** Preserve held-contact state alongside onset/change events. Specify coarse arm/leg contact localization independently from fingertip dexterity; retain joint encoders and actuator feedback. Test a sustained load so baseline adaptation cannot erase a real contact.

### [4] Directions toward effective utilization of tactile skin: A review

**Supported finding:** The authors frame useful tactile skin as a system problem involving distributed coverage, simultaneous contacts, acquisition, calibration and real-time interpretation.

**Limit:** The abstract supplies no verified circuit values, experimental operating envelope or manufacturing economics.

**Action for this project:** Keep an acceptance matrix spanning material, acquisition, communication, body coordinates and application. A working single taxel cannot close the multi-contact, coverage or latency requirements.

### [5] Proximity sensing in robot manipulator motion planning: System and implementation issues

**Supported finding:** The tested infrared arrangement provides a roughly 10–15 cm obstacle-detection envelope around the arm and coordinates sensing with about 50 commanded positions per second. Motion is constrained by the sensed free envelope.

**Limit:** The collision-avoidance argument depends on coverage, robot velocities, sensor characteristics and control timing; it is not a guarantee for arbitrary robots or objects.

**Action for this project:** Do not describe our pressure-only skin as detecting obstacles before touch. If proximity is added, validate every joint pose and object reflectance/angle against the actual stopping envelope and measured latency.

### [6] Sensitive skin

**Supported finding:** The paper explicitly links local processing, simple sensing structures, fault tolerance, repairability and manufacture. It discusses rigid active islands joined by flexible interconnects and warns that large-area signal paths collect noise.

**Limit:** The manufacturing costs and forecasts are historical; they cannot be imported into a 2026 BOM. Proposed future millions-of-sensors systems are not demonstrated production yield.

**Action for this project:** Keep analog runs short, digitize regionally, provide failed-channel reporting, and cost scrap/rework and replacement operations. Compare complete installed harnesses rather than copper mass alone.

### [7] Conformable, flexible, large-area networks of pressure and thermal sensors with organic transistor active matrixes

**Supported finding:** A 12×12 network with 4 mm pitch combines pressure and thermal layers. Net geometry permits 25% extension; larger extension breaks strut wiring. The reported 2, 000 cycles at 20% concern simplified gold test structures, not complete skin. Organic circuitry uses −20/−40 V biases.

**Limit:** The combined thermal demonstration and transistor protection do not establish long-term humidity, abrasion or joint-fatigue performance of a commercial laminate.

**Action for this project:** Use the established layered idea with simpler low-voltage electronics, but test heat paths and full-assembly strain independently. Do not substitute conductor-coupon fatigue for connector, adhesive, sensor and wear-cover fatigue.

### [8] Artificial Skin in Robotics: A Comprehensive Interface for System-Environment Interaction

**Supported finding:** The thesis separates sensitivity and collision protection and evaluates the sensor with its electronics. Its proposed testing includes static indentation, repeatability, dynamic impact, recovery and overload; filtering affects sensitivity and reaction time.

**Limit:** These proposed evaluation procedures are not a universal certification standard. The thesis itself identifies unresolved performance tradeoffs.

**Action for this project:** Add controlled dynamic indentation with an independent load/time reference, overload recovery and identical deployed filter settings. The thin TPU wear film is not an impact-energy absorber. Measure seam and mounted-curvature behavior, not flat coupons alone.

### [9] Conformable and scalable tactile sensor skin for curved surfaces

**Supported finding:** The implementation places 32 photo-reflector sensing elements and a microcontroller on a cut/fold flexible substrate. Optical emitters are time-shared to control power; local SMBus connects to an in-body ring network. Bus capacitance constrains scaling.

**Limit:** Address-space capacity is not simultaneous full-skin throughput. The reported bare-sheet mass excludes subsequently added foam and the complete installed network. Foldability does not imply repeated stretchability.

**Action for this project:** Use a small panel family and controlled mechanical relief. Measure aggregate power at the actual scan duty cycle, installed mass, and complete-frame freshness at maximum node count. Retain compact local analog wiring and a robust regional digital link.

### [10] Development of the tactile sensor system of a human-interactive robot RI-MAN

**Supported finding:** The original abstract reports an integrated soft areal tactile system on RI-MAN and a human-dummy lifting demonstration. No numerical sensor accuracy or robustness result from the full article is adopted here.

**Limit:** Demonstrating a complete robot handling a dummy does not isolate sensor contribution or validate the proposed resistive panel. Semiconductive-pressure-sensor construction described in other reviews is secondary evidence only.

**Action for this project:** Use a supported, low-mass test object for initial arm/body contact experiments. Document independently what skin detection contributes, what robot actuation contributes, and what protection is provided mechanically.

### [11] ARMAR-III: An integrated humanoid platform for sensory-motor control

**Supported finding:** Shoulder and arm skin is integrated through dedicated controllers into CAN, alongside separate joint-torque and wrist force/torque sensors. The architecture separates task planning, coordination and execution.

**Limit:** This platform paper does not provide a standalone production recipe or prove that coarse skin replaces accurate joint or wrist sensing.

**Action for this project:** Expose timestamped contact, location, confidence and faults through a dedicated driver. Leave actuator regulation in the existing robot control layer; test timeout handling at every boundary.

### [12] Design of human symbiotic robot TWENDY-ONE

**Supported finding:** The design combines passive arm mechanisms and mechanical softness in joints and skin, derived from a set of assistance-task requirements.

**Limit:** The abstract does not expose contact-force limits, hazard validation, individual skin accuracy or a component-level manufacturing cost.

**Action for this project:** Specify service tasks before adding modalities. Verify joint range, friction, cable pull and sensor prestress on a limb fixture; sensing alone cannot make an otherwise stiff mechanism mechanically compliant.

### [13] Humanoid robot which can lift a 30 kg box by whole body contact and tactile feedback

**Supported finding:** The article identity/title documents an early whole-body-contact and tactile-feedback claim. The 30 kg result is a title-level reported claim here, not an audited replication.

**Limit:** No verified gains, failure statistics, force distribution or safety conditions from the original are available in this review.

**Action for this project:** Cite the precedent without importing its payload. For our proof, compare skin-enabled and disabled behavior on the same restrained, low-energy fixture with objective contact-detection and response metrics.

### [14] Whole body haptics for augmented humanoid task capabilities

**Supported finding:** The abstract reports whole-body tactile covering of an adult-size humanoid and contact-motion experiments including a 66 kg human dummy.

**Limit:** The abstract alone cannot validate the loading conditions, control robustness or economics. It cannot justify human-lifting demonstrations with a home-lab prototype.

**Action for this project:** Keep the early demonstrator on arms and legs, with bounded low-load contact tasks and no human support. Explain the eventual application without implying its hardware/control validation is already complete.

### [15] An embedded artificial skin for humanoid robots

**Supported finding:** Twelve capacitive taxels per triangle use AD7147 conversion; up to 16 triangles/192 taxels connect through local buses to one MCU/CAN. A grounded deformable electrode enables contact from insulating objects and shielding. About 500 Hz averaged sensing trades spatial detail for speed; individual channels are slower.

**Limit:** The reported prototype is six triangles, with quantitative experiments ongoing. Three-to-five-millimeter foam differs from our thin laminate. Port count does not imply adaptive rerouting.

**Action for this project:** Keep local aggregation and distinguish normal-force sensing from bare capacitive human-touch detection. If evaluating capacitive alternatives, include the full ground-electrode, dielectric and cover stack and measure both spatial detail and response time.

### [16] Methods and technologies for the implementation of large-scale robot tactile sensors

**Supported finding:** The 16-bit CDC yielded 8 usable signal bits in that assembly. Drift adaptation freezes while touched. Probe geometry changes response, and some body configurations omit a top electrode and rely on a human ground plane.

**Limit:** The extracted drift pseudocode has an apparent missing minus sign versus its stated ±0.5 deadband; never copy it blindly. Published sensor performance does not transfer to our resistive laminate.

**Action for this project:** Freeze baseline during contact; test slow ramps and sustained loads. Measure actual noise-limited resolution. Test plastic, metal and gloved contacts. Calibrate several probe diameters and mounted curvature rather than claiming pressure accuracy from one probe.

### [17] A flexible and robust large scale capacitive tactile system for robots

**Supported finding:** The design uses clothing-industry 3D spacer fabric and removable covers. On the flat 2 mm dielectric prototype, 15 load cycles with one-minute rests gave a maximum 9.1 fF cycle difference at 28.6 kPa, roughly 5% of range. Pressure-insensitive reference capacitors compensate structural thermal drift; they are not surface thermometers. The reported acquisition operates at 25 Hz.

**Limit:** Ten-minute constant-displacement relaxation is not a constant-force creep or lifetime test. Neither its thickness nor performance transfers to a 1.5 mm 100 Hzresistive stack.

**Action for this project:** Use this as a capacitive fallback benchmark, subject to full-stack comparison. Separate thermal-point sensing from pressure compensation. Test both constant-force and constant-displacement holds plus local heating while loaded.

### [18] A new silicone structure for uSkin—A soft, distributed, digital 3-axis skin sensor and its integration on humanoid robot iCub

**Supported finding:** Sixteen magnetic 3-axis cells occupy 26×27×6.05 mm; approximately 1 mm mounting tape adds thickness. Bumps and air gaps reduce normal-to-shear mechanical coupling. A first soft-silicone attempt allowed magnets to attract each other.

**Limit:** Full assembly is thicker and more complex than a thin resistive film. Performance in motor magnetic fields, chosen cover adhesives and our limb geometry remains unverified.

**Action for this project:** Reserve this modality for a shear-sensing variant. If evaluated, test magnetic interference with motors energized, overload, cross-axis coupling and mounting-tape creep; include every protective/mounting layer in thickness and cost.

### [19] An adjustable force sensitive sensor with an electromagnet for a soft, distributed, digital 3-axis skin sensor

**Supported finding:** The prototype replaces a permanent magnet with an electromagnet so current can change force sensitivity in a soft magnetic sensor.

**Limit:** The abstract does not establish a mass-production cost or justify extra power, thermal coupling and calibration for approximate normal-pressure sensing.

**Action for this project:** Exclude electromagnets from the baseline. Add them only if a specified force-range problem cannot be met passively and a measured benefit exceeds coil-power, heat and driver cost.

### [20] A real-time distributed architecture for large-scale tactile sensing

**Supported finding:** Describes an EtherCAT-based distributed network connecting computational nodes associated with skin patches and evaluates the real-time architecture.

**Limit:** The accessible material does not establish the exact hardware cost, measured deadline distribution, or fault containment available to this project. EtherCAT results cannot certify a CAN FD implementation.

**Action for this project:** Adapt its separation of local acquisition, transport and host processing. Keep CAN FD for the low-cost baseline; qualify deadlines under maximum traffic before increasing node count.

### [21] A real-time data acquisition and processing framework for large-scale robot skin

**Supported finding:** Skinware separates tactile applications from particular sensors and network technologies and treats data coherence, consistency and timing as architectural concerns. Its reported environment includes RTAI and an older Linux platform.

**Limit:** Historical software-platform results do not establish present ROS2/Linux deadline behavior or direct STM32/CAN compatibility.

**Action for this project:** Adopt immutable complete-scan snapshots with versioned metadata and bounded producer-consumer queues. Keep real-time consumers independent from visualization, file I/O and discovery.

### [22] Asynchronous, event-driven readout of POSFET devices for tactile sensing

**Supported finding:** The title establishes an earlier POSFET/event-readout line of work. No device-level performance or circuit claim from this paper is relied upon here.

**Limit:** No original circuit schematic, process, power, noise or bandwidth was available for audit; a POSFET circuit cannot be presumed equivalent to the chosen resistive film.

**Action for this project:** Do not transplant or cost a POSFET circuit from this citation. The baseline continues to use a conventional ADC and firmware change detection; identify that as sampled event reporting.

### [23] Event-driven encoding of off-the-shelf tactile sensors for compression and latency optimisation for robotic skin

**Supported finding:** Studies event encodings of existing tactile sensors, including recorded iCub fingertip data, and describes an FPGA-based acquisition path with hierarchical event addressing. Sensor conversion and event transport are distinct stages.

**Limit:** Fingertip datasets, FPGA acquisition and AS-AER links do not demonstrate whole-limb resistive-film performance. Encoding simulations and hardware properties must be distinguished.

**Action for this project:** Adopt explicit body/patch/site identifiers, acquisition timestamps and a reproducible raw-data-versus-event comparison. Keep CAN integrity and periodic absolute snapshots; reject an FPGA hub as the minimum-cost baseline.

### [24] The event-driven software library for YARP—With algorithms and iCub applications

**Supported finding:** Provides event packet representations and software handling in YARP, with processing decoupled from receipt. The discussion recognizes large variations in event traffic and computation.

**Limit:** Its illustrative large-rate examples concern vision. A flexible event library does not establish a hard skin-control deadline or justify silently skipping required control updates.

**Action for this project:** Adapt recording/replay, typed event records and independent receive/processing threads. Use bounded queues with counters and an explicit overload state; make GUI frame dropping independent of tactile validity.

### [25] Reactive motion control for human-robot tactile interaction

**Supported finding:** The bibliographic record establishes tactile interaction control as a research subject by 2002; no equation, response rate or robustness result is verified here.

**Limit:** The controller's assumptions, saturation handling and experimental limits cannot be audited from the accessed material.

**Action for this project:** Retain as historical related work only. Implement our contact-to-response state machine from explicitly specified requirements and better-accessed sources [63,64,82], not this inaccessible paper.

### [26] Real-time collision avoidance in teleoperated whole-sensitive robot arm manipulators

**Supported finding:** The abstract describes combining operator commands with whole-arm sensing for reactive obstacle avoidance in teleoperation.

**Limit:** The original proof conditions, sensor range and timing are not available in the abstract. Contact-only resistive film cannot supply pre-contact distance.

**Action for this project:** Document pre-contact detection as an external robot capability. Bench demonstrations may report contact detection and subsequent response; they must not label the film a collision-prevention sensor.

### [27] Whole-arm reactive collision avoidance control of kinematically redundant manipulators

**Supported finding:** Citation confirms an early whole-arm reactive-control contribution. Its mathematical or experimental guarantees were not verified.

**Limit:** Insufficient evidence to reproduce the controller or infer performance on the proposed robot.

**Action for this project:** Our design must explicitly handle infeasible withdrawal: abort the application task and request the platform's validated stop/hold rather than promise a retreat direction for every contact configuration.

### [28] Programming by touch: The different way of human-robot interaction

**Supported finding:** Bibliographic prior art for programming robots by physical interaction.

**Limit:** No controller parameters, sensor specifications or validation details were inspected.

**Action for this project:** Treat teaching as an explicit operator-enabled mode. Record start, stop, allowed body zones and sampled robot trajectory independently from autonomous operation. Cite this paper only for historical positioning until its original text is available.

### [29] Manual guidance for industrial robot programming

**Supported finding:** The abstract describes manual robot programming using a force/torque sensor and demonstrates an industrial application.

**Limit:** Force/torque sensing is not equivalent to an uncalibrated normal-contact film. Exact control gains, task constraints and failure behavior remain unverified.

**Action for this project:** Measure teaching time, operator interventions and replay error in a controlled benchmark. Use the robot's supported hand-guiding function when available; do not substitute skin intensity for a specified six-axis sensor.

### [30] Tactile sensing in intelligent robotic manipulation—A review

**Supported finding:** The review separates distributed contact sensing from intrinsic force/torque sensing. It discusses mechanical inversion through soft covers, FSR/capacitive drift and hysteresis, and the loss of contact-pattern information in few-wire analog schemes.

**Limit:** Its supplier listings and dimensions are historical. A single resultant force/position cannot identify an arbitrary set of simultaneous contacts.

**Action for this project:** Preserve separate taxel identities for multi-contact limb sensing. Do not infer shear, friction, material hardness or accurate force from ordinal normal readings without additional measurement and a validated model.

### [31] Sensitive manipulation: Manipulation through tactile feedback

**Supported finding:** Obrero combines compliant actuation with tactile strategies for acquiring and maintaining contact. The text explicitly notes missed contacts at unsensed joint regions and a lift/retry strategy when immediate slip sensing is inadequate.

**Limit:** Success depends on hand hardware, force control and exploration strategies absent from our coarse arm/leg panels. It does not show that simply adding taxels delivers dexterity.

**Action for this project:** Include unsensed joint seams in coverage maps. Demonstrate one bounded contact-aware behavior and compare against a baseline, recording missed contacts; do not claim general slip detection or dexterous grasping.

### [32] High-density conformable tactile sensing glove

**Supported finding:** An established high-density sensing-glove research line. Original-paper performance numbers are not independently verified in this record.

**Limit:** Bibliographic aggregators merge the 2011 conference and 2012 Japanese journal article. Their results must not be silently treated as the same document.

**Action for this project:** For our arm/leg application, evaluate range-of-motion change, cable pull and pressure offsets with the covering installed. Tree/branch geometry is a useful candidate, but requires complete laminate fatigue testing.

### [33] Development and applications of high-density tactile sensing glove

**Supported finding:** The abstract describes 1, 052 pressure sites per hand using 1 mm elements on FPC, and human experiments relating pressure distribution to external-force direction and exploratory behavior.

**Limit:** Correlation in a human-worn glove does not establish calibrated robot shear-force measurement, full-body fatigue or inexpensive manufacturing.

**Action for this project:** Keep human-dexterity claims out of the limb-panel proof. If comparing density, state active area, sensor-element size and pitch separately, with installed mass and connectivity included.

### [34] Tactile object class and internal state recognition for mobile manipulation

**Supported finding:** At 20 N probing, reported container-class accuracy is 93.9%, while internal-state accuracy varies substantially by container (water bottles 32.5%). Stronger probing improves one container result, illustrating task and stimulus dependence.

**Limit:** An overall recognition number cannot be transferred across object types or contact forces; high probing forces can damage objects. These are controlled gripper observations, not generic limb-skin intelligence.

**Action for this project:** For any classifier, report per-class confusion matrices and separate test objects/sessions from training. Keep active exploratory-force tests outside the baseline ordinal-contact product unless actuator force is independently measured.

### [35] Learning inverse dynamics models with contacts

**Supported finding:** Mixtures of Gaussian-process contact experts predict torque residuals. In §III-A, tactile data select contacts; proximal force/torque readings supply force information. Experiments use additional calibrated joint-torque sensors as targets. The multiple-contact experiment is sequential contact at alternate obstacles.

**Limit:** This does not establish torque learning from the proposed film alone or arbitrary simultaneous-contact generalization. Ground-truth sensor calibration and training coverage matter.

**Action for this project:** Keep learned dynamics outside the first control path. An optional offline comparison must log synchronized encoders, skin, reference F/T and torque targets, and split training/test by physical trial and unseen pose/contact condition.

### [36] A simple tactile sensing foot for humanoid robot and active ground slope recognition

**Supported finding:** The work uses a small set of thin force-sensitive resistors and active foot interaction to classify ground slope rather than requiring a dense whole-foot image.

**Limit:** A foot-slope demonstration does not validate arm/leg pressure sensing or balance stability. Its load paths and contact geometry differ from shell-mounted skin.

**Action for this project:** Keep feet as a separate subsystem. Establish whether a future task needs contact presence, center of pressure, slope or detailed pressure distribution before selecting sensor count.

### [37] Design and experiment of the NAO humanoid robot’s plantar tactile sensor for surface classification

**Supported finding:** A 10×16 resistive array uses 400 samples/s acquisition, but the authors explicitly state 0.4 s per full image; a 20-site subset supports faster tracking. Classification aggregates multiple walking steps.

**Limit:** The text’s 360 total datasets versus 224 training+36 test is arithmetically inconsistent. The headline accuracy is not immediate response or demonstrated cross-robot generalization. Matrix bypass-current rejection is not established by the viewed block diagram.

**Action for this project:** Publish ADC rate, per-taxel rate, full-frame rate, scan skew and reaction latency separately. Never borrow 400 Hz as a full-array benchmark. Retain independent sensing islands unless simultaneous-contact electrical crosstalk is experimentally bounded.

### [38] An adaptive sensor foot for a bipedal and quadrupedal robot

**Supported finding:** The work concerns an adaptive foot mechanism and its sensor integration for different legged platforms, rather than simply applying a sensing film to an unchanged foot.

**Limit:** The abstract is insufficient to reproduce mechanics, control or load qualification. The institutional page’s pagination conflicts with Cheng’s bibliography.

**Action for this project:** Do not roll feet into the limb-panel BOM. A foot version needs its own contact mechanics, abrasion, overload, water/soil and gait-interface requirements.

### [39] A ZMP sensor for a biped robot

**Supported finding:** The abstract reports four wires, response within 1 ms, 0.2 g/cm²areal mass, and simultaneous total load and center-of-load position.

**Limit:** These are compressed aggregate outputs, not independent contact locations.0.2 g/cm²equals 2 kg/m²; “lightweight” must be compared using consistent units. No claim about general dynamic ZMP equivalence is adopted.

**Action for this project:** Test observability before replacing arrays: two equal separated contacts and one central contact can share a centroid. Our multi-contact requirement needs independent sites or another demonstrated reconstruction method.

### [40] High-speed pressure sensor grid for humanoid robot foot

**Supported finding:** The abstract reports a 32×32 matrix, 1 kHz sampling, 14-bit conversion and 0.6 mm force-sensitive rubber. It explicitly identifies bypass-current interference and a mitigation method.

**Limit:** The abstract cannot supply the exact mitigation circuit or demonstrate our laminate’s independence, accuracy or fatigue. ADC resolution is not mechanical force accuracy.

**Action for this project:** Our 100 Hzbody panels should not be marketed as equivalent to high-speed sole sensing. Any cheaper shared resistive matrix must pass a multi-contact test including unselected-row leakage, not merely isolated single presses.

### [41] Humanoid multimodal tactile-sensing modules

**Supported finding:** Describes modular off-the-shelf multimodal skin with local digitization/processing and network connectivity, including temperature, acceleration and proximity sensing.

**Limit:** This earlier hardware generation should not be conflated with the later force-cap version. Its multimodal capability is absent from a pressure-plus-NTC patch.

**Action for this project:** Adopt local processing and replaceable modules. Publish an explicit modality table: approximate normal contact and two temperature points in baseline; no shear, proximity or inertial self-localization.

### [42] Integrating discrete force cells into multi-modal artificial skin

**Supported finding:** Uses etched CuBe2 spring structures with capacitive measurement, three force cells per skin module, and automated assembly concepts. The paper reports2.5kHz acquisition filtered to250Hz and SNR greater than50dB.

**Limit:** These figures belong to a metal-spring capacitive transducer, not a printed resistive taxel. Encapsulation and mechanical preload affect performance. CuBe processing is not proposed for the home-lab film route.

**Action for this project:** Adopt mechanical overload stops, controlled preload and a cover-specific calibration record. Reject copying its performance numbers or force-cell BOM into the resistive design.

### [43] Towards autonomous robotic skin spatial calibration: A framework based on vision and self-touch

**Supported finding:** This is relevant prior art for spatial calibration using vision and robot-generated contacts; no exact original algorithm or performance claim is used in the design.

**Limit:** Reachability, camera calibration, occlusion and force-distributed contact centroids need examination before reproduction. The source available here is insufficient to promise its accuracy.

**Action for this project:** Keep registered CAD carriers as the baseline. Use external probing at marked sites as a measurable manufacturing check; describe any future vision/self-touch implementation as a separate reproduction.

### [44] 3D surface reconstruction for robotic body parts with artificial skins

**Supported finding:** Reconstruction uses the modular skin's known structural geometry and motion-related sensing. The approach concerns shaped, connected modules rather than an arbitrary uninstrumented stretchable sheet.

**Limit:** A shared CAN address list does not reveal physical adjacency; resistive touch values do not supply gravity vectors. Stretch and slip violate a fixed module geometry assumption.

**Action for this project:** Adopt a versioned body map with per-site position and unit normal derived from the rigid carrier. Bind map revision to the installed carrier and reject unknown revisions.

### [45] Open-loop self-calibration of articulated robots with artificial skins

**Supported finding:** Uses tri-axis accelerometers and isolated joint excitation to find segment/joint activity and construct kinematic models. Requires instrumented rigid segments and a static reference. Physical KUKA results establish structural exploration; parameter estimation is additionally demonstrated in simulation.

**Limit:** Does not validate autonomous geometry from pressure-only skin. Weak excitation, reference motion and unobserved degrees of freedom can make identification ambiguous. Full numerical error bounds were not inspected.

**Action for this project:** Adapt activity-matrix validation using a reusable stationary-reference/downstream IMU fixture and known joint states. Retain CAD geometry; label the fixture an adaptation, not a full reproduction of autonomous skin localization.

### [46] Automatic robot kinematic modeling with a modular artificial skin

**Supported finding:** Uses per-cell tri-axis accelerometers, open-loop motions and circle-point analysis to build a forward kinematic model. The abstract reports a physical UR5 experiment on an inertial dual-arm platform.

**Limit:** No original numerical errors, conditioning tests or implementation parameters were accessible. One revolute motion identifies perpendicular radius, not the axial component of a sensor offset; full geometry needs additional constraints.

**Action for this project:** Use axis/perpendicular-radius estimation only as an offline cross-check against CAD. Do not claim recovery of every DH offset, mass, inertia or friction from a dual-IMU experiment.

### [47] 3D spatial self-organization of a modular artificial skin

**Supported finding:** Combines skin-patch geometry with an active LED visual marker and a calibrated monocular camera for spatial registration, including partial visibility.

**Limit:** Self-organization here is not entirely camera-free. A pressure-only film lacks the per-cell inertial and active-marker information of the studied system.

**Action for this project:** Maintain a declared manual/CAD root transform. If camera registration is used in a fixture, make camera intrinsics, marker geometry and observation quality part of its calibration record.

### [48] Touch, in Principles of Neural Science, fifth edition, chapter23

**Supported finding:** Biological background cited by the2019 review. No receptor count, frequency range or quantitative biological claim is extracted here without the original chapter.

**Limit:** A biological analogy cannot establish robot sensitivity, safety, durability or wiring requirements.

**Action for this project:** Describe the design as functionally inspired by distributed sensing. Preserve persistent contact state and temperature measurements; avoid claiming replication of human skin's complete receptor system.

### [49] Touch is a team effort: Interplay of submodalities in cutaneous sensibility

**Supported finding:** The review emphasizes joint contributions of afferent submodalities to natural touch, rather than a simple one-receptor/one-percept correspondence.

**Limit:** It does not show that two engineered layers or sparse thermal sensors reproduce the capabilities of human skin.

**Action for this project:** Keep claims modality-specific. Fuse contact and temperature at the application layer without implying that sparse NTC readings provide a complete thermal image or that normal pressure measures shear.

### [50] Event-based signaling for reducing required data rates and processing power in a large-scale artificial robotic skin

**Supported finding:** A260-cell UR5 study reports remaining traffic of16.45% at rest and47.69% under heavy stimulation without timestamps; with timestamps,21.38% and62%. Compact packets of three events suit the correlated modalities studied.

**Limit:** These are remaining-traffic fractions, not reduction percentages. Packet format, timestamps and workload matter. The baseline's64-byte absolute CAN frames will not inherit these reductions.

**Action for this project:** Use this as a benchmark design, not a promised percentage. Specify maximum50% idle snapshot-count reduction for100Hzactive/50Hzidle, with smaller total savings after extra overhead.

### [51] Event-based signaling for large-scale artificial robotic skin—Realization and performance evaluation

**Supported finding:** Uses two260-cell patches with local processing. The abstract reports48.2% packet and17.79% CPU reductions in reactive control; a worst-case5000-cell extrapolation gives21.2% and17.46%, respectively.

**Limit:** The5000-cell result is an extrapolation, not a physical5000-cell validation. Traffic, CPU and control-rate metrics are different quantities.

**Action for this project:** Keep a periodic diagnostic mode and a hybrid event mode in the same firmware for controlled comparison. Publish measured patch count and extrapolated counts separately.

### [52] Efficient event-driven reactive control for large scale robot skin

**Supported finding:** Evaluates event-driven reactive control on TOMM with two253-cell patches. The abstract reports controller CPU reductions of78% idle and66% during contact relative to the tested synchronous reference.

**Limit:** Controller savings cannot be substituted for network or driver savings. Unchanged pressure does not imply unchanged joint torque when robot configuration changes.

**Action for this project:** Cache contact information or link-frame wrench contributions, but recompute their mapping with current joint states in a bounded controller cycle. Separate event receipt from command execution.

### [53] A128×128120dB15µs latency asynchronous temporal contrast vision sensor

**Supported finding:** A custom asynchronous contrast imager reports120dB dynamic range,15µs latency and23mW power. Its discussion identifies event-bandwidth limitations and lack of direct DC response.

**Limit:** These are optical custom-silicon results under the paper's conditions. They do not establish response time, energy or resolution for a scanned tactile array.

**Action for this project:** Use only as historical distinction between truly asynchronous transduction and100Hz sampled send-on-delta. Retain absolute contact samples so static loads remain observable.

### [54] An asynchronous time-based image sensor

**Supported finding:** Identified as prior work on asynchronous time-based optical sensing. No quantitative device claim is adopted.

**Limit:** It is an image-sensor design, not a tactile transducer or low-cost STM32 reference circuit.

**Action for this project:** Do not add custom timing-coded hardware to the baseline on this citation alone. Ordinary absolute ADC values plus timestamps are sufficient for the intended touch task.

### [55] AER EAR: A matched silicon cochlea pair with address event representation interface

**Supported finding:** Describes paired silicon cochleae, inner-hair-cell/spiking-neuron circuitry and address-event output; its experiment uses tones from different directions.

**Limit:** An auditory analog front end offers no directly transferable tactile resolution, component price or contact-safety guarantee.

**Action for this project:** Use it as a historical example of modality-specific local event generation. Keep pressure and temperature acquisition parameters independently specified.

### [56] VLSI analogs of neuronal visual processing: A synthesis of form and function

**Supported finding:** Develops analog VLSI visual processing and communication inspired by neural systems, including retina/stereo/optic-nerve concepts.

**Limit:** A thesis abstract cannot support detailed circuit reproduction or performance comparison. Visual neuromorphic circuitry does not specify the mechanics of electronic skin.

**Action for this project:** Cite as historical context if using the artificial-nervous-system analogy. Keep the engineering argument based on tested latency, reliability, mass and cost.

### [57] Point-to-point connectivity between neuromorphic chips using address events

**Supported finding:** Analyzes address-event communication and arbitration for time-multiplexed neuromorphic connections. Queueing and contention affect event timing and throughput.

**Limit:** AER timing properties do not remove finite bandwidth, arbitration delay or buffer limits, and do not automatically apply to CAN FD.

**Action for this project:** Adopt worst-case burst and queue analysis. Preserve acquisition timestamps and distinguish age at sampling from transport delay; report queue overflow as invalid coverage.

### [58] Asynchronous DC-free serial protocol for event-based AER systems

**Supported finding:** Proposes a serial event protocol with100Mbps raw rate and up to2.9million32-bit events/s; its abstract reports successful16-bit operation with ±2% clock mismatch, explicit flow control and AC-coupling compatibility.

**Limit:** These figures refer to that protocol and implementation. A differential pair does not make it electrically or logically interchangeable with CAN.

**Action for this project:** Retain CAN FD transceivers, arbitration, error detection and diagnostics. Consider AS-AER only after a measured bandwidth bottleneck justifies separate FPGA/PHY cost.

### [59] A QVGA143dB dynamic range frame-free PWM image sensor with lossless pixel-level video compression and time-domain CDS

**Supported finding:** Identifies prior work on frame-free optical sensing with time-domain encoding; no numerical claim beyond the bibliographic title is adopted as engineering evidence.

**Limit:** The2019 review's use as an example of absolute-value event coding does not make its optical circuit an appropriate tactile design.

**Action for this project:** Carry absolute values in the MCU frames; do not integrate received signed increments as the only persistent contact state.

### [60] A new protocol for a low power sensor network

**Supported finding:** Discusses event-oriented activity for battery-powered sensor networks, relating communication scheduling to energy consumption.

**Limit:** Energy benefits depend on the radio, duty cycle and application. A wired sensor that continues sampling at100Hz does not save ADC/MCU power simply because it sends fewer packets.

**Action for this project:** Separate bandwidth reduction from power reduction in the cost/performance table. Measure total rail current in both periodic and hybrid modes with identical scan schedules.

### [61] Send-on-delta concept: An event-based data reporting strategy

**Supported finding:** Separates continuous level-crossing from periodically sampled compound implementations (p.53). Its traffic analysis depends on signal slope, peak density and threshold, and its example compares59 periodic samples with7 events over1.2s at amplitude resolution0.2 (p.58). Heartbeat updates are already described on pp.60–61.

**Limit:** The analytical comparison assumes a specified signal and resolution; it is not a universal saving, hard latency guarantee or loss/reboot protocol. The sample-count example is a simulation, not a tactile-skin experiment.

**Action for this project:** Adapt to a hybrid:100Hz scanning, delta/contact/fault triggers and fresh absolute snapshots at least every20ms while idle. Include sequence, reboot/session identity and capture time; never treat silence as healthy.

### [62] A robust and efficient dynamic network protocol for a large-scale artificial robotic skin

**Supported finding:** Tests a multi-hop skin network with up to204cells. The original abstract reports recovery within50ms and more than30% packet-loss reduction from balancing relative to its previous protocol.

**Limit:** The supplied2019 review reports40ms and32% greater network size: those are distinct source/metric statements, not interchangeable guarantees. Rerouting requires an intact alternate physical path.

**Action for this project:** Reject literal mesh routing on the single shared CAN bus. Use regional segmentation, bounded failure detection and physical fault containment. Any redundancy needs additional buses/ports and its own BOM.

### [63] Realizing whole-body tactile interactions with a self-organizing, multi-modal artificial skin on a humanoid robot

**Supported finding:** The calibration assumptions include a fixed reference, rigid links, actuated revolute joints and accelerometer-equipped cells on body parts. Gravity-aligned motion can hide activity; complementary orientations help. HRP-2 uses balance/foot tasks above tactile upper-body behavior, with designated contact zones.

**Limit:** Closed-loop/underactuated structures are outside its stated calibration assumptions. The base low-cost patch lacks the required accelerometers and proximity channel. Incomplete skin coverage can leave forces unobserved.

**Action for this project:** Use versioned CAD/manual cell-to-link positions and normals first. A removable IMU jig must have its own repeatability tests; do not advertise automatic arbitrary-sheet reconstruction. Mark coverage gaps and allowed interaction zones explicitly.

### [64] From multi-modal tactile signals to a compliant control

**Supported finding:** Skin signals become weighted normal virtual forces, then Jacobian-transpose joint commands. The torque resolver includes virtual nonlinear dynamics initialized from measured robot state and inner velocity feedback to limit virtual/real drift. Dynamic-model construction is parametric, not identification of actual masses from geometry alone.

**Limit:** The paper is not a complete deployable controller for an unspecified actuator. Gains, physical/model parameters, tracking behavior, saturation and transport delay still require platform-specific validation.

**Action for this project:** Specify command units and robot API explicitly. Never scale torque directly into a position increment. Use an OEM-supported compliance/admittance interface or a separately tested bounded trajectory generator with state feedback, tracking-error limits and reset rules.

### [65] Whole-body active compliance control for humanoid robots with robot skin

**Supported finding:** The abstract describes hierarchical whole-body compliance on a position-controlled humanoid with more than 1,260 skin cells.

**Limit:** The abstract cannot establish reproducible balance constraints, gains, fault response or equivalence with our slower, less multimodal hardware.

**Action for this project:** Keep the humanoid's existing balance/stance controller authoritative. Demonstrate the skin on a fixed-base fixture before limb integration; expose contact observations to the OEM whole-body controller rather than directly commanding leg withdrawal.

### [66] TOMM: Tactile omnidirectional mobile manipulator

**Supported finding:** The described system combines two six-DOF arms, an omnidirectional wheeled base, exchangeable end effectors and multimodal skin, with integrated hardware/software/middleware.

**Limit:** A wheeled robot integration is not proof of stable bipedal response. Its platform cost and full integration effort cannot be inferred from the abstract.

**Action for this project:** Separate skin subsystem BOM from robot, gateway, software integration and tooling. First integration contract must name joint-state rate, command interface, clocks, error states and OEM supervisor ownership.

### [67] An overview of null space projections for redundant, torque-controlled robots

**Supported finding:** Torque projection consistency depends on the inverse/weighting choice. Successive projections are not generally a strict hierarchy beyond two tasks. A reported dynamically consistent formulation became unstable when requested torques exceeded actuator limits/bandwidth.

**Limit:** Full-row-rank assumptions and inertia-model errors matter. Algebraic null-space cancellation does not guarantee feasible, stable behavior after saturation or under rank changes.

**Action for this project:** Use the existing robot constraint solver. Test conflicting three-task cases, rank loss, actuator limits and task activation/deactivation. Require bounded commands and measured violation metrics; do not declare a weighted sum or naive projector a guaranteed priority controller.

### [68] Synthesis of whole-body behaviors through hierarchical control of behavioral primitives

**Supported finding:** Constraints, task behavior and posture are prioritized. Projected Jacobian rank indicates whether lower-priority motion remains feasible; an infeasible task can be modified or removed. The presented example is a simulated 24-DOF humanoid.

**Limit:** A mathematical hierarchy under model assumptions is not a certified bound on real contact forces; the physical actuator/network limitations of our robot are unspecified by this paper.

**Action for this project:** Define ordered responsibilities: platform stability and hard limits, collision/contact policy, application trajectory, posture. Log infeasibility and stop/hold decisions. Evaluate conflict cases in simulation before authorizing bounded fixture motion.

### [69] Efficient distributed torque computation for large scale robot skin

**Supported finding:** The abstract proposes moving skin torque computations to distributed electronics to reduce central computation burden.

**Limit:** No audited original implementation, error bound or timing budget. Reduced host computation does not remove network latency, joint-state distribution, stale data or common-mode faults.

**Action for this project:** Benchmark host computation and same-link wrench aggregation first. Keep individual contact records for constraints. Introduce MCU-side kinematics only after profiling shows a real bottleneck and synchronization/fault tests pass.

### [70] Tactile-based whole-body compliance with force propagation for mobile manipulators

**Supported finding:** The abstract describes constrained, limb-level optimization and propagation of unaccommodated interactions through a mobile robot, experimentally evaluated on a dual-arm platform.

**Limit:** No original full-text audit of constraint values, feasibility conditions or controller failure handling. A mobile-manipulator result does not establish walking-humanoid balance.

**Action for this project:** Represent unaccommodated contact as explicit supervisor status. Demand solver deadline, infeasibility, actuator saturation and stop/hold behavior in the robot integration specification; no automatic propagation into biped motion in the baseline.

### [71] Humanoid robot HRP-2

**Supported finding:** Establishes the identity of the humanoid platform used in later skin demonstrations; no original platform design data are used here.

**Limit:** This bibliography entry does not provide our robot's actuator, balance, thermal or payload specification.

**Action for this project:** Require a platform-specific integration sheet, including allowable added mass/inertia by link and supervisor behavior. The skin project must not inherit HRP-2 capability or reconstruct the humanoid from this citation.

### [72] Integration of robotic technologies for rapidly deployable robots

**Supported finding:** The work integrates skin, controls and teaching. It reports installation/calibration of skin on two industrial robots in about five hours. Its functional-safety discussion explicitly identifies a starting point and preliminary productization work.

**Limit:** Installation time is setup-specific, not a promised production takt time. This article does not certify the proposed skin or establish its commercial cost.

**Action for this project:** Time assembly, programming, calibration, fitting, remapping and replacement separately. Include integration/service labor in cost comparisons and publish failed/reworked units, not only successful demonstrations.

### [73] A survey of unknown object grasping and our fast grasping algorithm—C shape grasping

**Supported finding:** The abstract surveys unknown-object grasp methods and describes C-shape grasp selection from partial point clouds, evaluated in simulation.

**Limit:** This is a grasp-planning contribution, not an affordable limb-skin fabrication or calibrated-force result.

**Action for this project:** Out of scope for the arm/leg skin prototype. Keep grasp planner and hand sensing as external systems; do not add finger hardware, camera cost or grasp-success claims to the baseline skin deliverable.

### [74] A unified approach for motion and force control of robot manipulators: The operational space formulation

**Supported finding:** The abstract introduces a task-space dynamic framework for unified motion and force control.

**Limit:** No additional theorem or exact implementation parameter is asserted from this limited read. A Jacobian-transpose mapping is only meaningful with compatible origins, frames and units.

**Action for this project:** Unit-test virtual work: f dot (Jv qdot) equals (Jv transpose f) dot qdot. Check moment-origin transformations and distinguish applied environmental wrench from selected reaction command sign.

### [75] Robot Control: The Task Function Approach

**Supported finding:** Background reference identity only. No chapter-specific technical claim is made.

**Limit:** The book cannot be treated as an implementation manual actually inspected in this review.

**Action for this project:** For each implemented task, define coordinates, error, Jacobian, units, command interface, constraints and termination conditions directly in the project specification; support implemented formulas with the accessible papers.

### [76] Integration of reactive, torque-based self-collision avoidance into a task hierarchy

**Supported finding:** The method combines repulsive collision tasks with damping and smooth task activation to control torque discontinuities. Experiments use a fast torque-controlled platform; reported controller cycle is 1 ms.

**Limit:** Geometric closest-point changes and interacting repulsive fields complicate behavior. Its actuator interface and timing differ from our 100 Hz skin acquisition.

**Action for this project:** Inflate collision geometry by the assembled skin and cable envelope. Test contact enter/leave, changing nearest points and simultaneous contacts; bound command slope and record saturation. Do not equate sample rate with full control bandwidth.

### [77] Tactile-based compliance with hierarchical force propagation for omnidirectional mobile manipulators

**Supported finding:** The modeled mobile base is holonomic with planar translation and yaw. The assumptions explicitly neglect base tilting/instability and upper-limb coupling.

**Limit:** Those omissions are material for humanoid balance and loaded arm interaction. They cannot be carried silently into a biped product.

**Action for this project:** Use a fixed base for the proof of concept. Return unresolved contact status to an existing platform supervisor; disable autonomous base/leg response unless a separate model and balance-validation campaign covers it.

### [78] Safe and dependable physical human-robot interaction in anthropic domains: State of the art and challenges

**Supported finding:** The paper treats physical design, sensing, control, fault handling and maintenance as coupled dependability concerns. A soft cover does not remove the consequences of high effective inertia.

**Limit:** Its 2006 standards and injury-limit discussion are not present-day design limits. The paper supplies no safety qualification of this new film or electronics.

**Action for this project:** Inject open, short, stale data, reboot and wrong-map faults in the complete application chain. Verify that operator-visible coverage validity and platform stop/hold state reflect them. Test on an instrumented fixture before human contact experiments.

### [79] Impedance control: An approach to manipulation: Part III—Applications

**Supported finding:** Interaction control specifies a dynamic relationship between motion and force. The illustrative optimization trades interface force against motion error under explicit simplified environmental assumptions.

**Limit:** An illustrative continuous-time optimum does not fix robust digital gains for unknown contact stiffness, transport delay, actuator bandwidth or the nonlinear resistive skin.

**Action for this project:** Validate the complete sampled robot/controller/environment loop. Sweep fixture stiffness, delays and load classes; measure oscillation, peak reference force and settling. Do not claim passivity from positive damping alone or compute physical contact power from intensity units.

### [80] A new actuation approach for human friendly robot design

**Supported finding:** The abstract motivates reducing effective impedance while preserving torque performance. The inspected saturation passage explains loss of ideal torque-source behavior when the smaller actuator saturates.

**Limit:** No complete actuation-design or experimental audit; paper-specific performance cannot be assigned to our robot or skin.

**Action for this project:** Include reflected inertia, drive friction, limits and braking behavior in the integration contract. Compare added skin/harness mass by link and resulting inertia, not just total grams saved.

### [81] Control of generalized contact motion and force in physical human-robot interaction

**Supported finding:** The inspected text treats contact-point motion/force control using robot dynamics and contact geometry. A contact on an intermediate link has a different Jacobian from the end effector.

**Limit:** No full experimental/equation audit. Normal-only resistive sensing cannot recover arbitrary shear or six-axis wrench, and not every desired contact motion is mechanically realizable.

**Action for this project:** Store each taxel's rigid link, local position and unit normal. Construct its link-specific Jacobian; test zero influence of downstream joints. Keep vector force reconstruction outside the baseline specification.

### [82] Human-robot coexistence and contact handling with redundant robots

**Supported finding:** The method changes task behavior across contact-intensity thresholds and interpolates velocity during task abort to reduce jerk. Remark 1 specifies a single-contact algorithm in the reported formulation.

**Limit:** An extension discussion is not experimental proof for arbitrary simultaneous contacts. Gradual stopping trades reduced jerk against additional motion/time.

**Action for this project:** Use explicit MONITOR, CONTACT, CONTROLLED_HOLD and FAULT states with hysteresis and latched recovery. Opposing/multiple contacts or infeasible relief request OEM hold rather than ambiguous automatic withdrawal. Test both contact onset and release.

### [83] Human body part multicontact recognition and detection methodology

**Supported finding:** The system combines a 3D time-of-flight scanner with wheel-drivetrain torque sensing to associate contacts with body parts and classify predetermined interaction gestures.

**Limit:** This is sensor fusion with a restricted gesture vocabulary, not proof that normal touch intensity alone reveals arbitrary human intent or body part.

**Action for this project:** Expose contact facts separately from application intent. Deliberate teaching/interaction requires explicit enable and allowed zones; any later gesture model must publish confusion matrices including accidental-contact negatives.

### [84] Long-term training with a brain-machine interface-based gait protocol induces partial neurological recovery in paraplegic patients

**Supported finding:** The abstract reports outcomes in eight participants after a year of a combined brain-machine-interface gait-training protocol incorporating multiple feedback/training components.

**Limit:** The abstract does not isolate electronic skin's causal contribution. It does not establish clinical benefit of this proposed skin, nor authorize extrapolation to rehabilitation products.

**Action for this project:** Keep medical/rehabilitation claims outside the proof-of-concept article and commercial baseline. Sensory feedback may be mentioned as a distinct future application requiring its own clinical evidence and development program.
