oznav2/tectile_skin/hardware/02_PCB/01_USB3_Flexible_Interconnect/06_PCB_PDF_FPC_2026-09-18.pdf

CN1

CN4

Switch( ); ןיפ עטקמ; ןאז עטקמ

No. | Quantity | Comment | Designator | Footprint | Value | Manufacturer Part | Manufacturer | Supplier Part | Supplier
1 | 2 | GT-F0512SR 18-10S0101 | CN1,CN4 | 【FPC 】GT-F0512SR18-10S0101 | | GT-F0512SR 18-10S0101 | | | C21882308 | LCSC

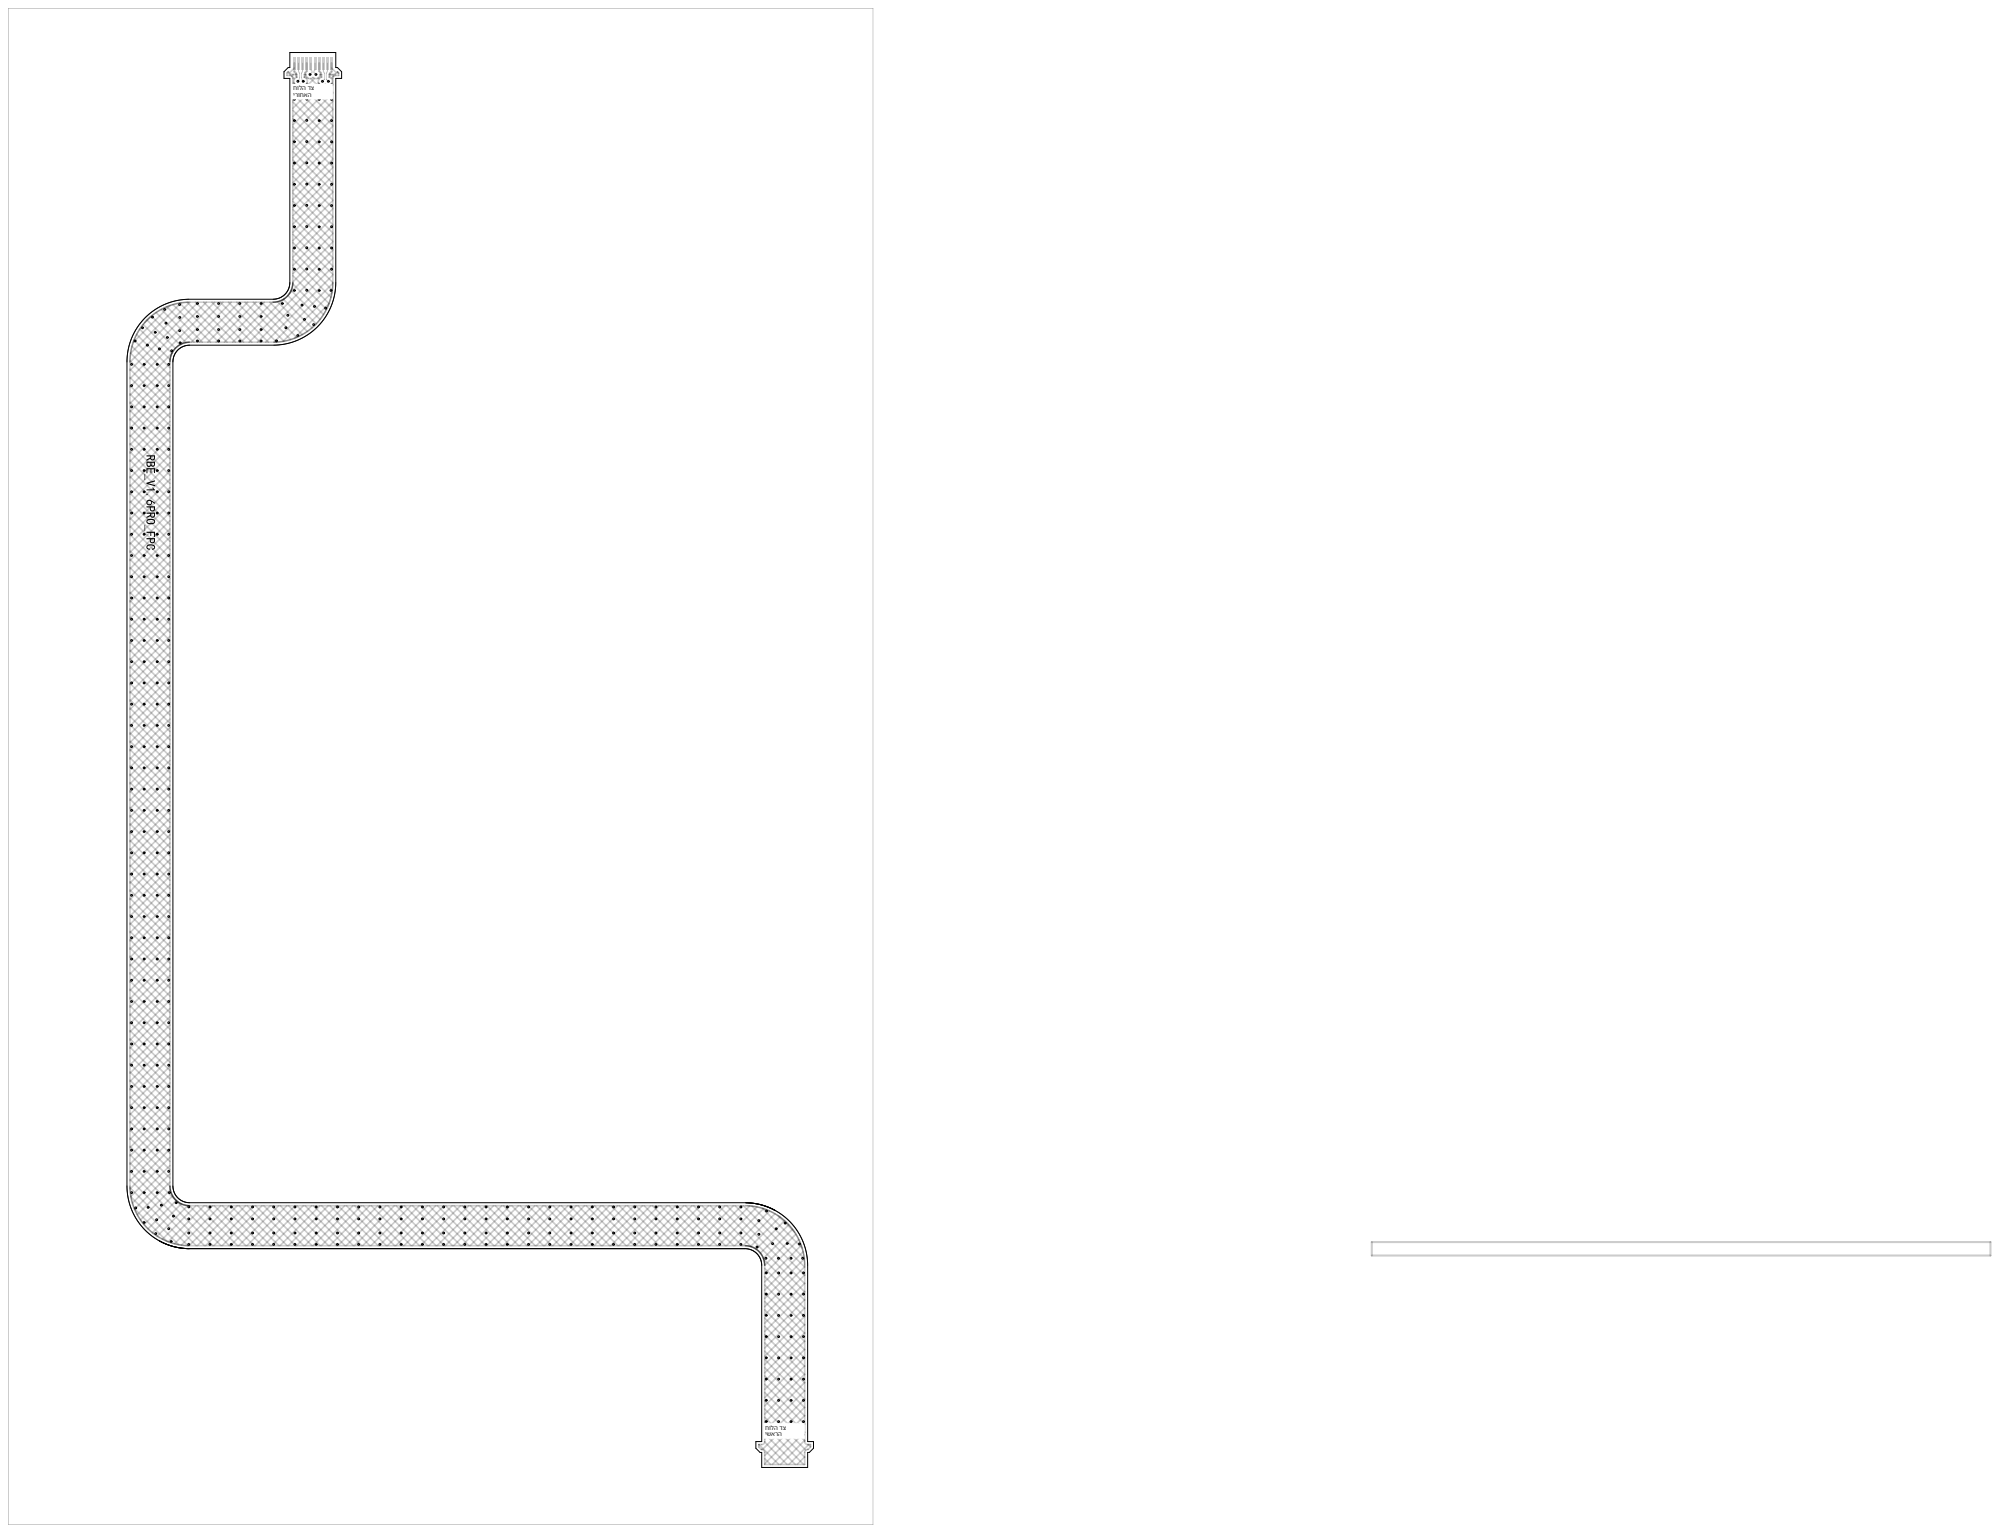
[picture p5: page 4]

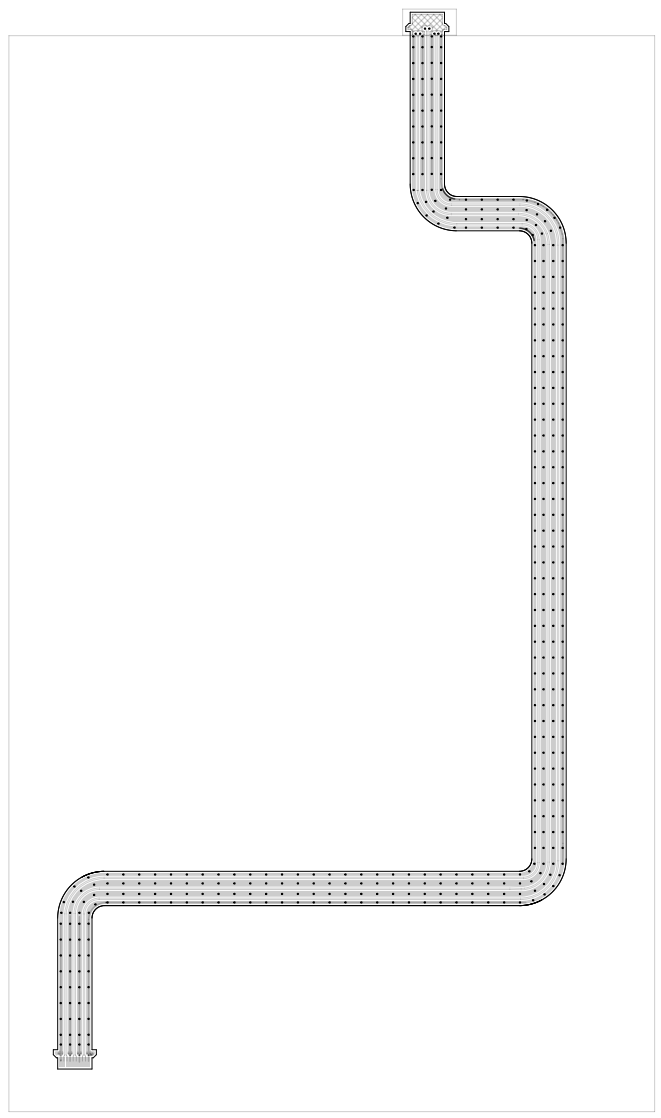
[picture p6: page 5]

ROBOSKIN | RP1-derived engineering record

English file: 06_PCB_PDF_FPC_2026-09-18.pdf
Status: derivative identification; NOT a manufacturing release.

Existing dimensions, tolerances, material and revision remain authoritative. Source engineering graphics and original attribution are retained. Technical notes may remain in the source language.
Only searchable project part IDs on original pages are replaced. Outlined/raster labels require the original CAD authoring application.

Original drawing pages: 6
Searchable ID replacements: 0
Source: Roboparty/rp1_hardware
Hardware licence: CERN-OHL-W-2.0 where applicable; see LICENSES.md. Original path and SHA256: electronic_skin/branding/file_manifest.json

Part aliases in this document:

תודימה , ורמשנ טוטרשבש תולובסהו םירמוחה . הדשו דומע ןייצמ לאמשמ רפסמה . | - ROBOSKIN טוטרשה טסקטל ירבע ארקמ

p3 T0700

ןיפ [ םש עטקמ ]

p3 T1384

ןאז [ םש עטקמ ]

p4 T1290

ירוחאה חולה דצ

p4 T0486

ישארה חולה דצ
