oznav2/tectile_skin/hardware/02_PCB/09_RBE-PWR-MINGMEI-BC/06_PCB_PDF_MINGMEI-BC_2026-09-16.pdf

U1

No. | Quantity | Comment | Designator | Footprint | Value | Manufacturer Part | Manufacturer | Supplier Part | Supplier
1 | 1 | SYCDM30P1 1R1 | U1 | SYCDM30P1 1R1

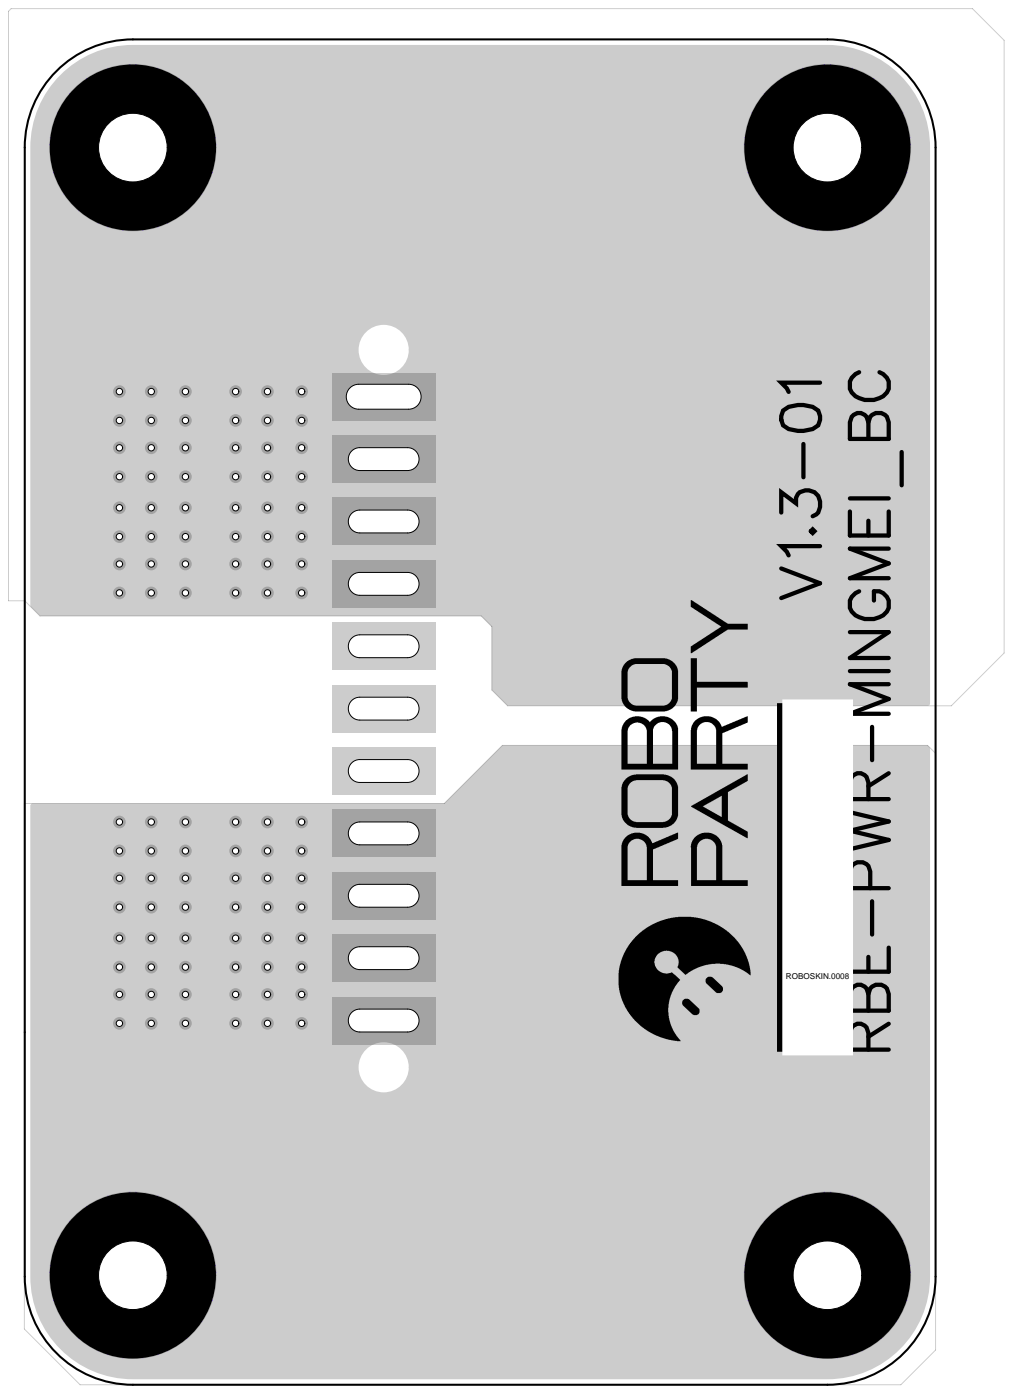
[picture p7: page 4]

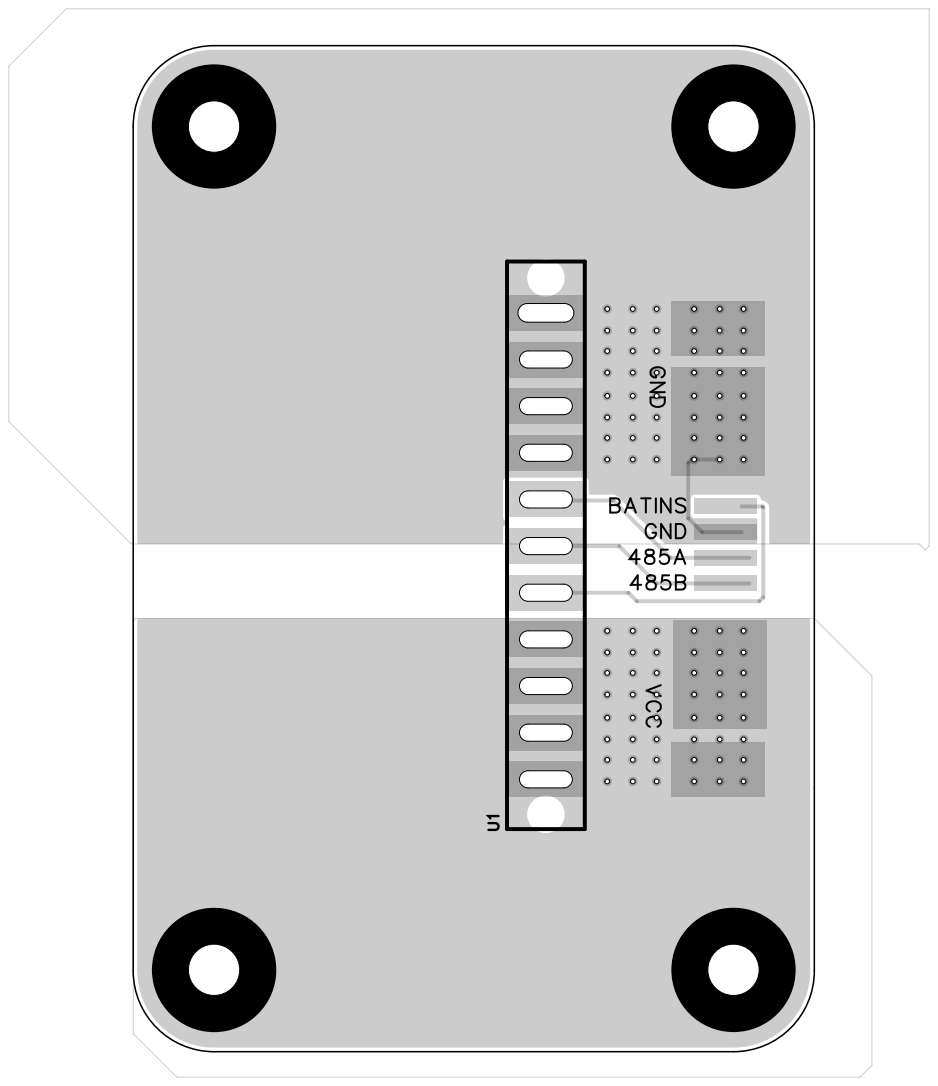
[picture p8: page 5]

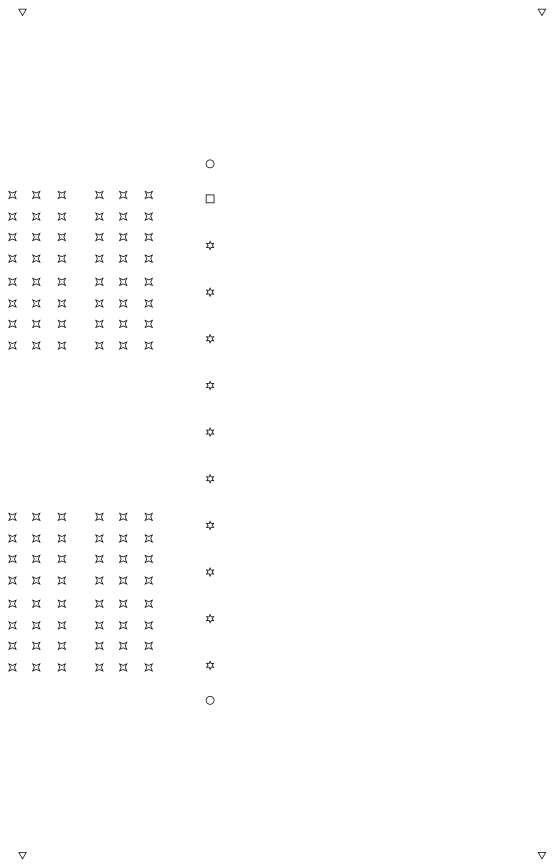
[picture p9: page 6]

ROBOSKIN | RP1-derived engineering record

English file: 06_PCB_PDF_MINGMEI-BC_2026-09-16.pdf
Status: derivative identification; NOT a manufacturing release.

Existing dimensions, tolerances, material and revision remain authoritative. Source engineering graphics and original attribution are retained. Technical notes may remain in the source language.
Only searchable project part IDs on original pages are replaced. Outlined/raster labels require the original CAD authoring application.

Original drawing pages: 6
Searchable ID replacements: 1
Source: Roboparty/rp1_hardware
Hardware licence: CERN-OHL-W-2.0 where applicable; see LICENSES.md. Original path and SHA256: electronic_skin/branding/file_manifest.json

Part aliases in this document:
YCL.E000060 -> ROBOSKIN.0008
