oznav2/tectile_skin/hardware/02_PCB/13_Lighting_Board/06_PCB_PDF_LAMP_2026-09-16.pdf

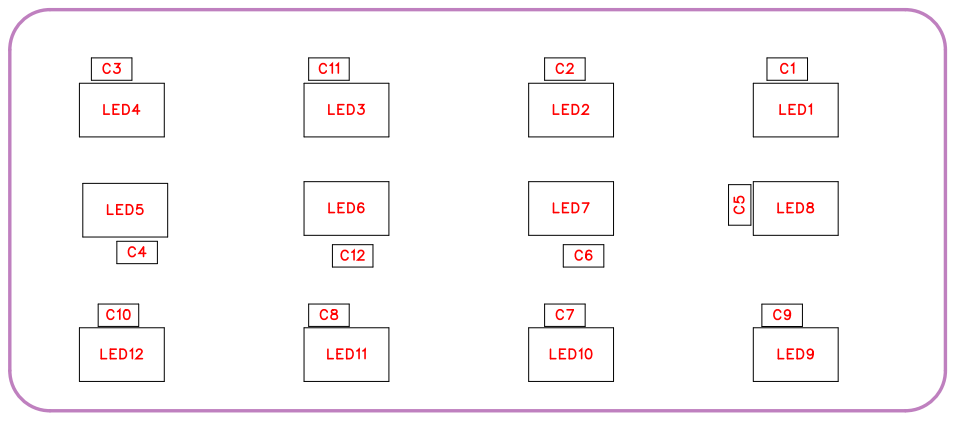
[picture p10: page 1]

No. | Quantity | Comment | Designator | Footprint | Value | Manufacturer Part | Manufacturer | Supplier Part | Supplier
1 | 12 | 100nF | C1,C2,C3,C4,C5,C6,C7,C8, C9,C10,C11,C12 | C0603 | 100nF | CC0603KRX 7R9BB104 | | | C14663 | LCSC
2 | 12 | WS2812B-MI NI-V3/W | LED1,LED2,LED3,LED4,LE D5,LED6,LED7,LED8,LED9 ,LED10,LED11,LED12 | LED-SMD_4 P-L3.5-W3.5-TL_WS2812 B | | WS2812B-MI NI-V3/W | worldsemi | | C527089 | LCSC

YAGEO( )

YAGEO

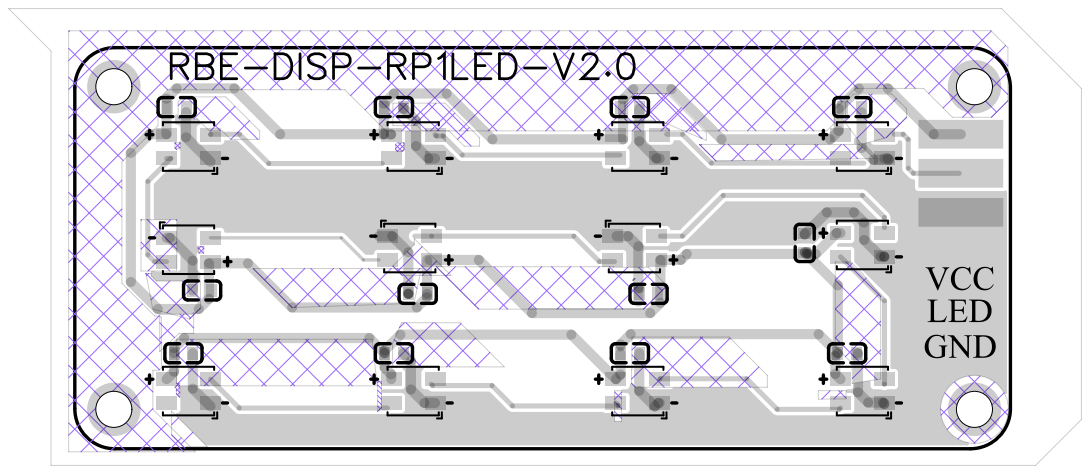
[picture p11: page 4]

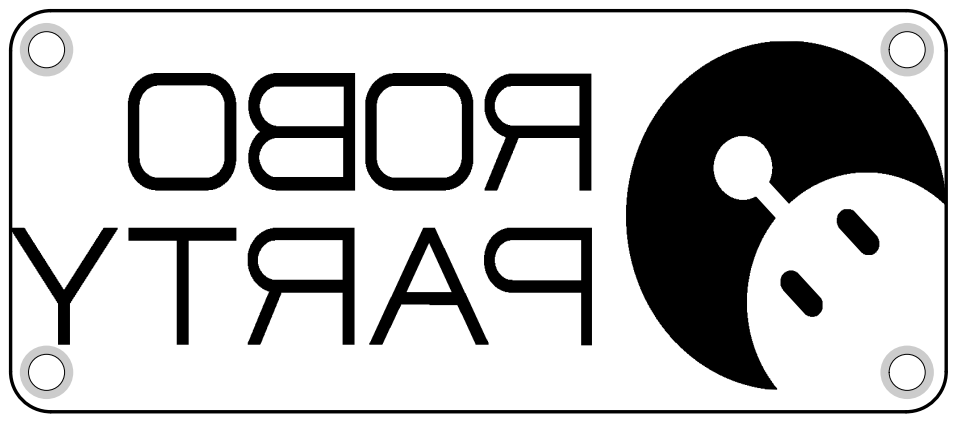
[picture p12: page 5]

ROBOSKIN | RP1-derived engineering record

English file: 06_PCB_PDF_LAMP_2026-09-16.pdf
Status: derivative identification; NOT a manufacturing release.

Existing dimensions, tolerances, material and revision remain authoritative. Source engineering graphics and original attribution are retained. Technical notes may remain in the source language.
Only searchable project part IDs on original pages are replaced. Outlined/raster labels require the original CAD authoring application.

Original drawing pages: 6
Searchable ID replacements: 0
Source: Roboparty/rp1_hardware
Hardware licence: CERN-OHL-W-2.0 where applicable; see LICENSES.md. Original path and SHA256: electronic_skin/branding/file_manifest.json

Part aliases in this document:

תודימה , ורמשנ טוטרשבש תולובסהו םירמוחה . הדשו דומע ןייצמ לאמשמ רפסמה . | - ROBOSKIN טוטרשה טסקטל ירבע ארקמ

p3 T0715

YAGEO
