oznav2/tectile_skin/hardware/02_PCB/14_Rear_Power_Indicator/06_PCB_PDF_INDICATOR_2026-09-16.pdf

H2

No. | Quantity | Comment | Designator | Footprint | Value | Manufacturer Part | Manufacturer | Supplier Part | Supplier
1 | 1 | HX PZ2.0-1x5P WZ-AM | H2 | HDR-TH_5P-P2.00-H-M_ HC-PZ200-1 0.5L-1X5PW A | | HX PZ2.0-1x5P WZ-AM | Hanxia UNI-
2 | 2 | 10k | R1,R45 | R0402 | 10k | 0402WGF10 02TCE | | C25744 | LCSC
3 | 2 | XL-A3528RG BC-BM | U1,U34 | LED-ARRAY-SMD_4P-L3. 2-W2.8-LS3. 5-BL_XL-A35 28RGBC-BM | | XL-A3528RG BC-BM | ROYAL XINGLIGHT | C3647023 | LCSC

hanxia(

) | C22438279 | LCSC

ROYAL( )

IGHT( )

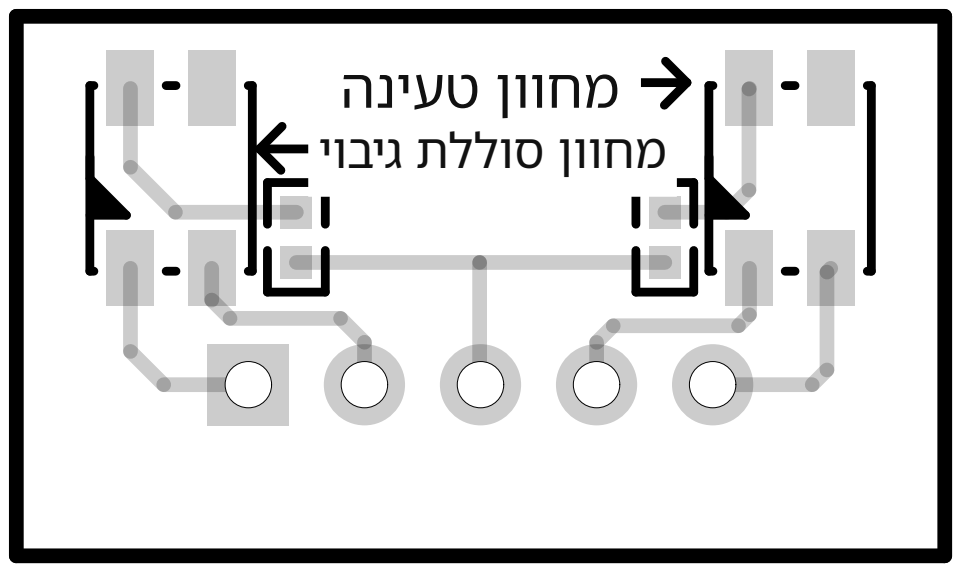
[picture p13: page 4]

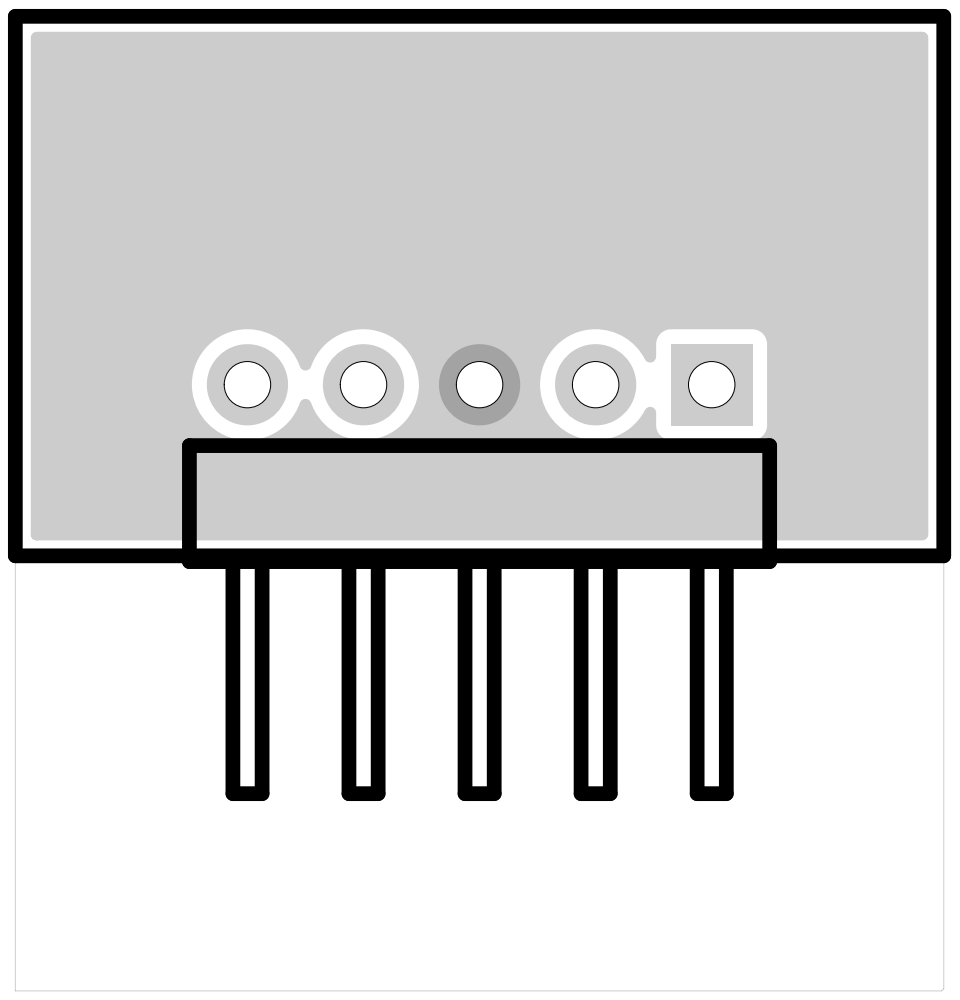
[picture p14: page 5]

ROBOSKIN | RP1-derived engineering record

English file: 06_PCB_PDF_INDICATOR_2026-09-16.pdf
Status: derivative identification; NOT a manufacturing release.

Existing dimensions, tolerances, material and revision remain authoritative. Source engineering graphics and original attribution are retained. Technical notes may remain in the source language.
Only searchable project part IDs on original pages are replaced. Outlined/raster labels require the original CAD authoring application.

Original drawing pages: 6
Searchable ID replacements: 0
Source: Roboparty/rp1_hardware
Hardware licence: CERN-OHL-W-2.0 where applicable; see LICENSES.md. Original path and SHA256: electronic_skin/branding/file_manifest.json

Part aliases in this document:

תודימה , ורמשנ טוטרשבש תולובסהו םירמוחה . הדשו דומע ןייצמ לאמשמ רפסמה . | - ROBOSKIN טוטרשה טסקטל ירבע ארקמ

p3 T1528

Hanxia

p3 T0665

UNI-ROYAL

p3 T0922

XINGLIGHT

p4 T0835

יוביג תללוס ןווחמ

p4 T0554

הניעט ןווחמ
