oznav2/tectile_skin/hardware/03_Harness/Drawings/Back_Ethernet_NX_Cable.pdf

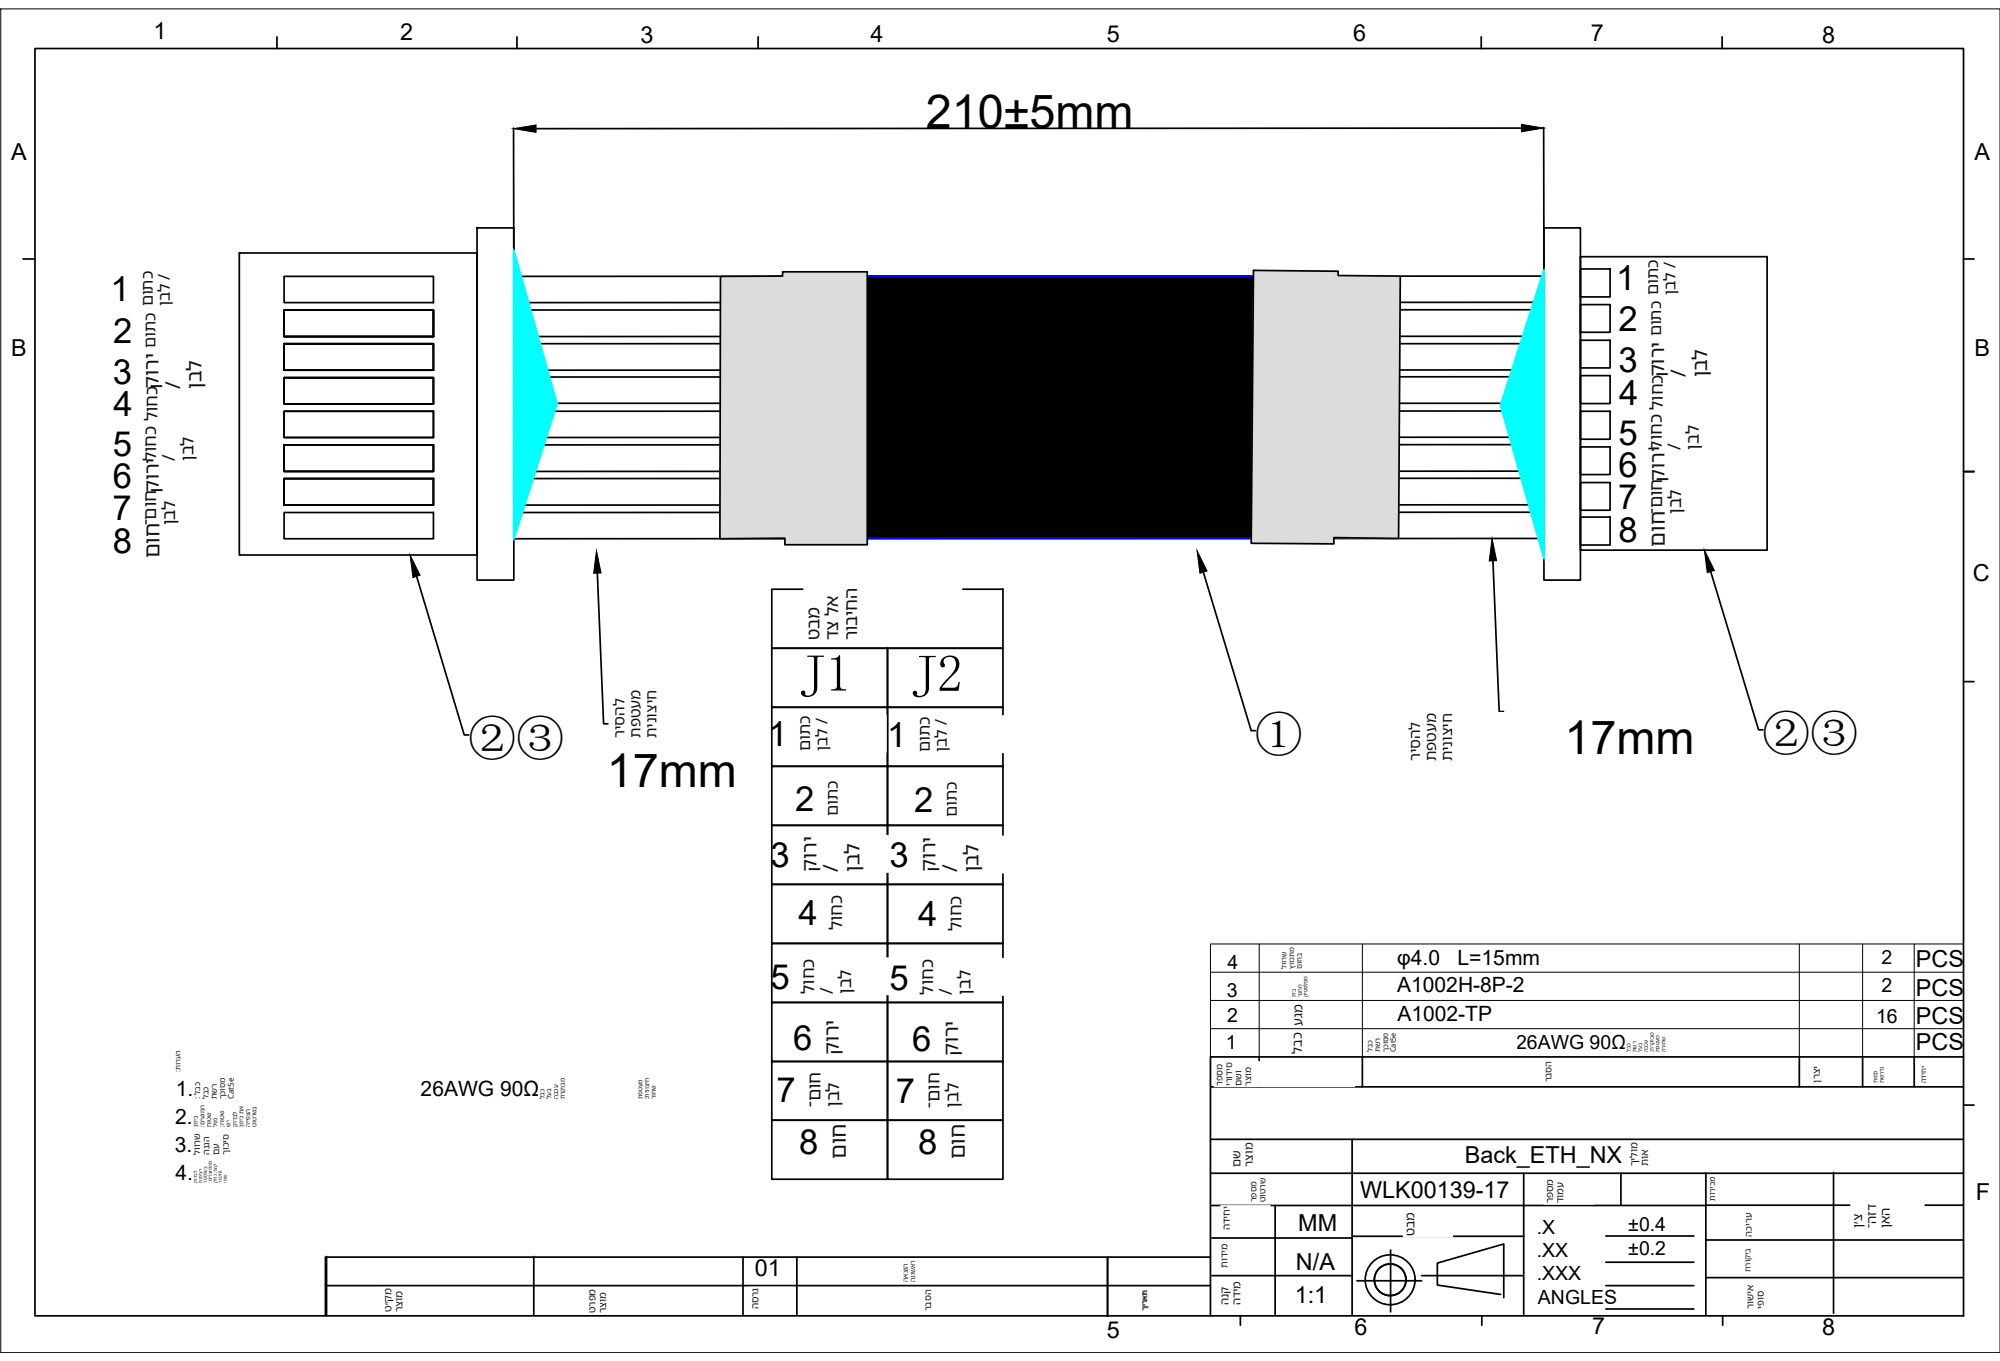
[picture p15: page 1]
MMN/A 1:1; .X.XX .XXX ANGLES ±0.4 ±0.2 1; ABCF 01; PCS PCS 1; PCS 23 210±5mm; Back_ETH_NX WLK00139-17 A1002-TP A1002H-8P-2 1.; 26AWG 90Ω 2. 3. 4.; 26AWG 90Ω 17mm 17mm; PCS; תודימ הדיחי; עגמ לבכ; ןוויכ תא; קתנ ,; ןבל / םותכ

ROBOSKIN | RP1-derived engineering record

English file: Back_Ethernet_NX_Cable.pdf
Status: derivative identification; NOT a manufacturing release.

Existing dimensions, tolerances, material and revision remain authoritative. Source engineering graphics and original attribution are retained. Technical notes may remain in the source language.
Only searchable project part IDs on original pages are replaced. Outlined/raster labels require the original CAD authoring application.

Original drawing pages: 1
Searchable ID replacements: 0
Source: Roboparty/rp1_hardware
Hardware licence: CERN-OHL-W-2.0 where applicable; see LICENSES.md. Original path and SHA256: electronic_skin/branding/file_manifest.json

Part aliases in this document:

תודימה , ורמשנ טוטרשבש תולובסהו םירמוחה . הדשו דומע ןייצמ לאמשמ רפסמה . | - ROBOSKIN טוטרשה טסקטל ירבע ארקמ

p1 T0889

רצומ םשו ירודיס רפסמ

p1 T1170

תשרדנ תומכ

p1 T0650

הדיחי

p1 T0509

רצומ םש

p1 T0717

טוטרש רפסמ

p1 T0859

תודימ

p1 T1094

הדימ הנק

p1 T1357

טבמ

p1 T1530

דומע רפסמ

p1 T1450

תוריכמ

p1 T0797

תרוקיב

p1 T1051

יפוס רושיא

p1 T1265

הכירע

p1 T0661

ןרצי

p1 T1008

ךיראת

p1 T1508

ןאה־הזד ן׳צ

p1 T0510

רצומ ט״קמ

p1 T1146

הסרג

p1 T1370

רבסה

p1 T1541

הנושאר האצוה

p1 T0511

רצומ טרפמ

p1 T1257

לבכ

p1 T1235

עגמ

p1 T0736

קיטסלפמ רבחמ תיב

תודימה , ורמשנ טוטרשבש תולובסהו םירמוחה . הדשו דומע ןייצמ לאמשמ רפסמה . | - ROBOSKIN טוטרשה טסקטל ירבע ארקמ

p1 T0540

תוא ךילומ

p1 T1372

תורעה :

p1 T1261

לבכ : ךכוסמ תשר לבכ e5Cat

p1 T1502

תרקובמ הבכע לעב לבכ

p1 T0746

תינוציח תפטעמ : רוחש

p1 T1236

םיעגמה ןוויכ : חוטש לומ חוטש ; טוטרשב הייפצה ןוויכ תא קודבל שי

p1 T0533

ךוכיס םע הנגה לוורש

p1 T0923

־ב תופיצר קודבל 100% םירצומהמ : רצק , יוגש רוביחו קתנ

p1 T0810

רוביחה דצ לא טבמ

p1 T1065

םותכ / ןבל

p1 T1064

םותכ

p1 T1271

קורי / ןבל

p1 T1339

לוחכ

p1 T1340

לוחכ / ןבל

p1 T1270

קורי

p1 T1059

ןבל־םוח

p1 T1058

םוח

p1 T1386

ךכוסמ תשר לבכ e5Cat

p1 T1504

תרקובמ הבכע לעב תשר לבכ ; הרוחש תפטעמ

p1 T0621

תינוציח תפטעמ ריסהל

p1 T1139

םוחב ץווכתמ לוורש
