oznav2/tectile_skin/hardware/03_Harness/Drawings/Hand_Adapter_Cable.pdf

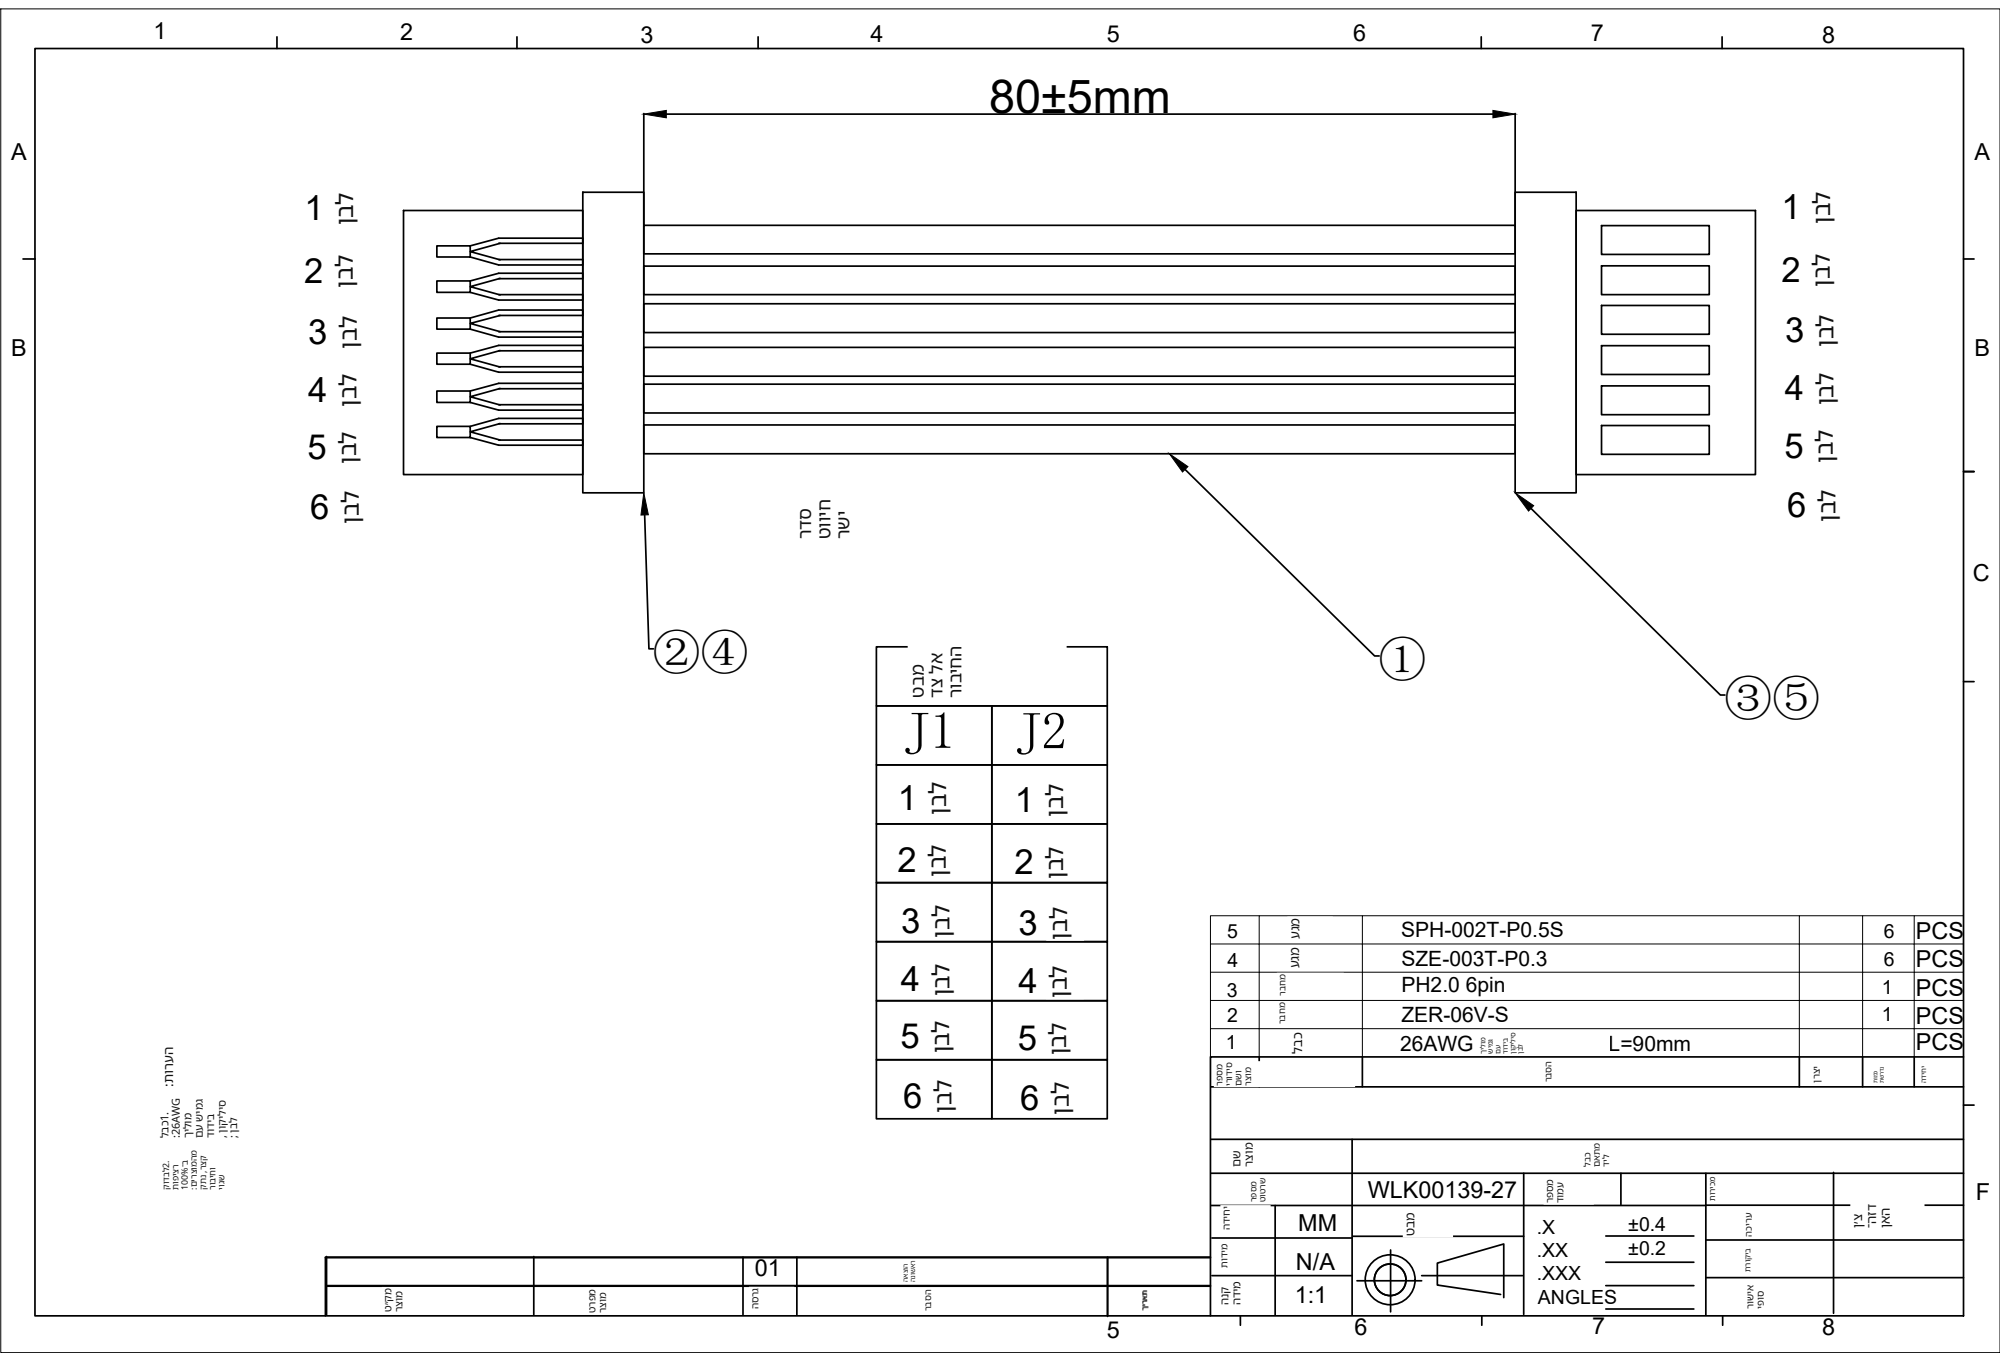
[picture p19: page 1]
MMN/A 1:1; .X.XX .XXX ANGLES ±0.4 ±0.2 1; ABCF 01; PCS PCS PCS PCS 1; PCS 2345 80±5mm; 26AWG; L=90mm ZER-06V-S PH2.0 6pin WLK00139-27 SZE-003T-P0.3 SPH-002T-P0.5S ②④; תודימ הדיחי; עגמ עגמ; לבכ 1.; םע שימג; קודבל 2.; קתנ ,

ןבל ןבל ןבל

ROBOSKIN | RP1-derived engineering record

English file: Hand_Adapter_Cable.pdf
Status: derivative identification; NOT a manufacturing release.

Existing dimensions, tolerances, material and revision remain authoritative. Source engineering graphics and original attribution are retained. Technical notes may remain in the source language.
Only searchable project part IDs on original pages are replaced. Outlined/raster labels require the original CAD authoring application.

Original drawing pages: 1
Searchable ID replacements: 0
Source: Roboparty/rp1_hardware
Hardware licence: CERN-OHL-W-2.0 where applicable; see LICENSES.md. Original path and SHA256: electronic_skin/branding/file_manifest.json

Part aliases in this document:

תודימה , ורמשנ טוטרשבש תולובסהו םירמוחה . הדשו דומע ןייצמ לאמשמ רפסמה . | - ROBOSKIN טוטרשה טסקטל ירבע ארקמ

p1 T0889

רצומ םשו ירודיס רפסמ

p1 T1170

תשרדנ תומכ

p1 T0650

הדיחי

p1 T0509

רצומ םש

p1 T0717

טוטרש רפסמ

p1 T0859

תודימ

p1 T1094

הדימ הנק

p1 T1357

טבמ

p1 T1530

דומע רפסמ

p1 T1450

תוריכמ

p1 T0797

תרוקיב

p1 T1051

יפוס רושיא

p1 T1265

הכירע

p1 T0661

ןרצי

p1 T1008

ךיראת

p1 T1508

ןאה־הזד ן׳צ

p1 T0510

רצומ ט״קמ

p1 T1146

הסרג

p1 T1370

רבסה

p1 T1541

הנושאר האצוה

p1 T0511

רצומ טרפמ

p1 T1257

לבכ

p1 T1419

רבחמ

p1 T1399

ןבל ןוקיליס דודיב םע שימג ךילומ

תודימה , ורמשנ טוטרשבש תולובסהו םירמוחה . הדשו דומע ןייצמ לאמשמ רפסמה . | - ROBOSKIN טוטרשה טסקטל ירבע ארקמ

p1 T1235

עגמ

p1 T1372

תורעה :

p1 T0039

1. לבכ AWG:26 ןוקיליס דודיב םע שימג ךילומ , ןבל ;

p1 T0065

2. ־ב תופיצר קודבל 100% םירצומהמ : רצק , יוגש רוביחו קתנ

p1 T0942

דיל םאתמ לבכ

p1 T1070

רשי טוויח רדס

p1 T0810

רוביחה דצ לא טבמ

p1 T1205

ןבל
