oznav2/tectile_skin/hardware/03_Harness/Drawings/ROBOSKIN-HEAD1_Cable.pdf

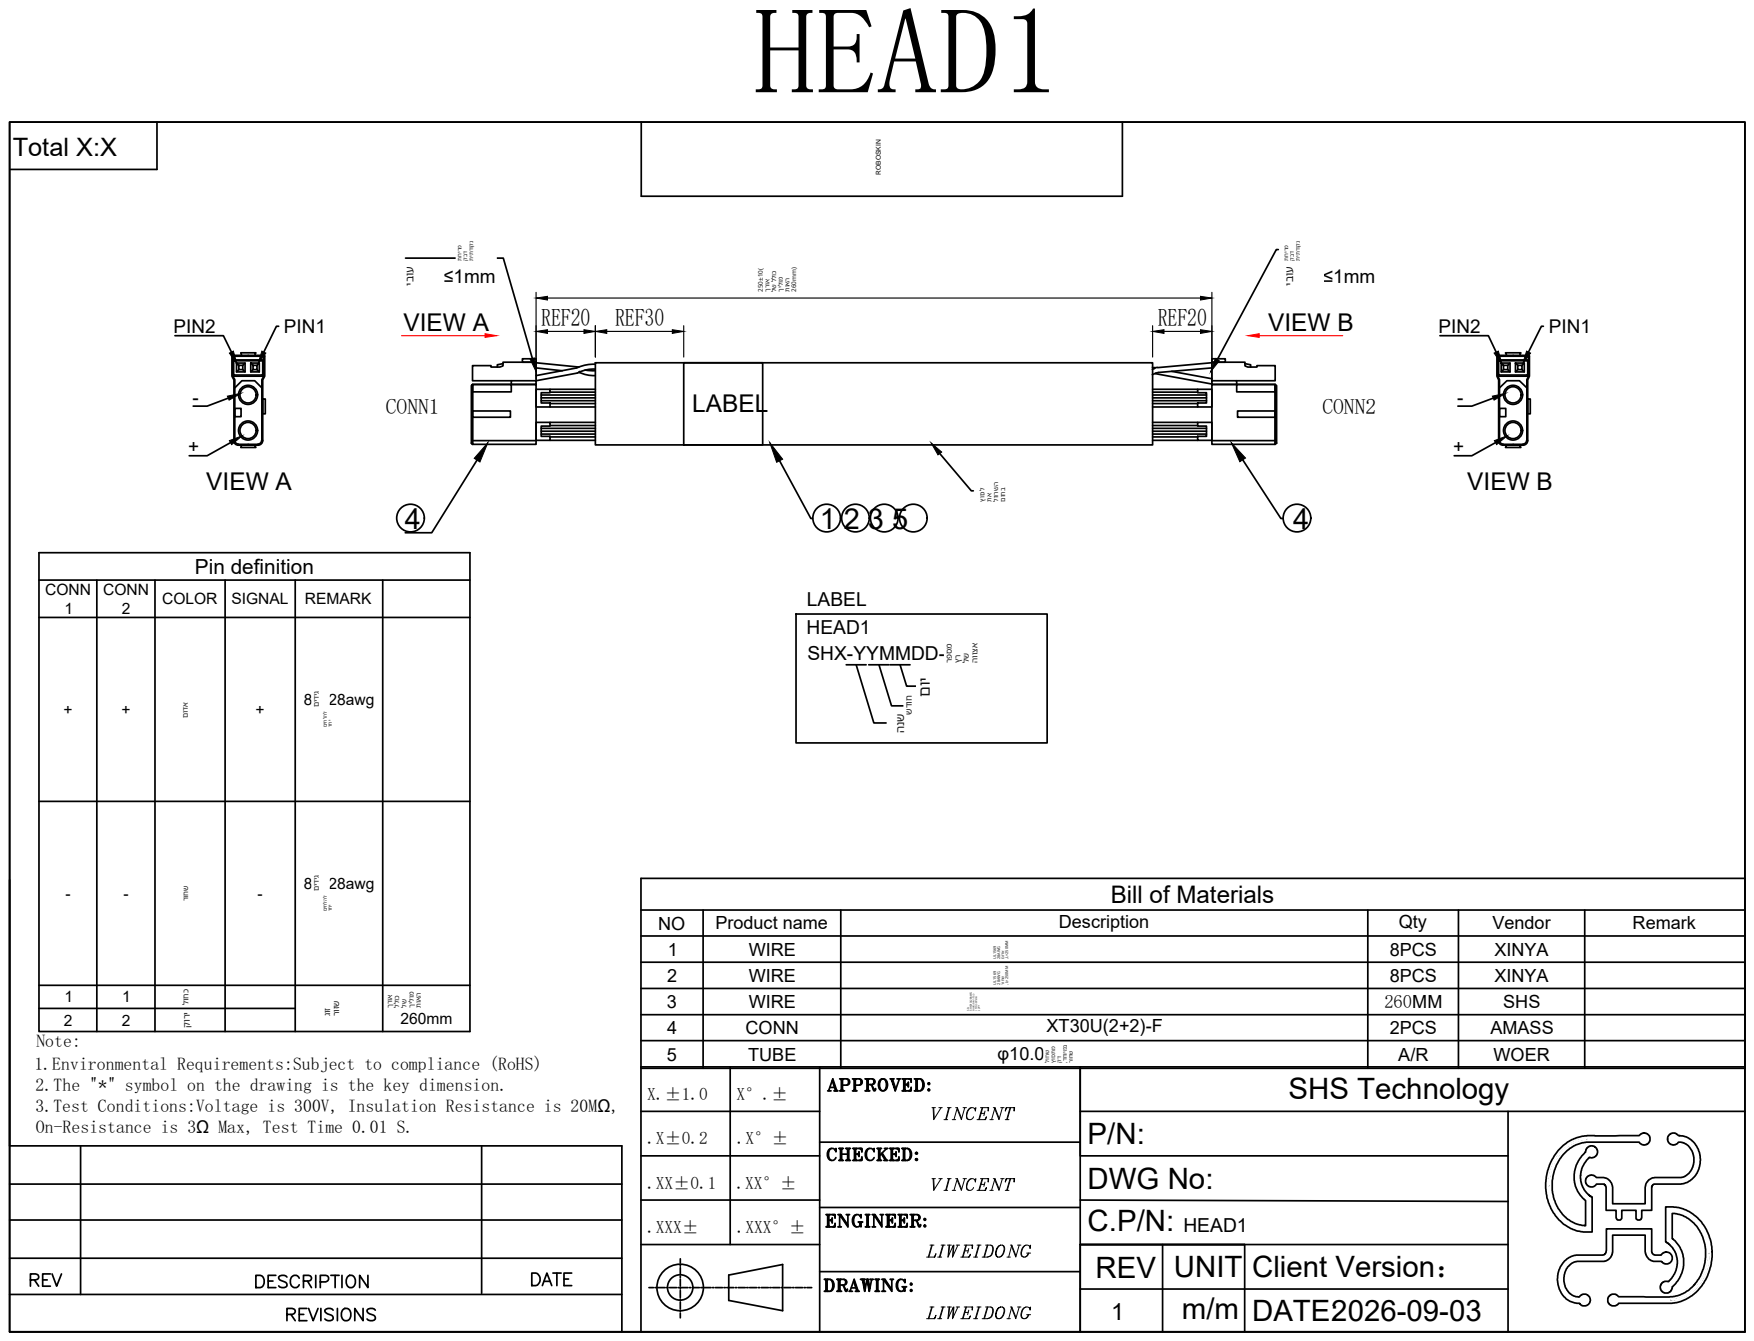
[picture p20: page 1]
+- PIN2; PIN1; .XXX±; .XXX°± .XX±0.1; DATE: C.P/N: REV; UNIT X.±1.0; DWG No:; SHS Technology P/N: 1; Client Version： Total X:X Note: 1.Environmental Requirements:Subject to compliance (RoHS) 2.The "*" symbol on the drawing is the key dimension. 3.Test Conditions:Voltage is 300V, Insulation Resistance is 20MΩ, On-Resistance is 3Ω Max, Test Time 0.01 S.; 2026-09-03 Bill of Materials NO; Product name; Description; Qty; Vendor; Remark 1; WIRE; 8PCS; XINYA 2; XINYA 3; SHS 4; CONN; 2PCS; AMASS 5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

תוגוזב תשר לבכ

## ROBOSKIN | RP1-derived engineering record

## English file: ROBOSKIN-HEAD1_Cable.pdf

Status: derivative identification; NOT a manufacturing release.

Existing dimensions, tolerances, material and revision remain authoritative. Source engineering graphics and original attribution are retained. Technical notes may remain in the source language.
Only searchable project part IDs on original pages are replaced. Outlined/raster labels require the original CAD authoring application.

## Original drawing pages: 1 Searchable ID replacements: 0 Source: Roboparty/rp1_hardware

Hardware licence: CERN-OHL-W-2.0 where applicable; see LICENSES.md.

## Original path and SHA256: electronic_skin/branding/file_manifest.json

## Part aliases in this document:

תודימה , ורמשנ טוטרשבש תולובסהו םירמוחה . הדשו דומע ןייצמ לאמשמ רפסמה . | - ROBOSKIN טוטרשה טסקטל ירבע ארקמ

p1 T0343

# ,L=250MM םודא UL1569 28AWG

p1 T0347

# ,L=250MM רוחש UL1569 28AWG

p1 T0328

## AWG28(010SHX-SR לוחכ םירוזש תוגוזב תשר לבכ / קורי )

p1 T1389

## דחוימב קד ץווכתמ לוורש , רוחש

p1 T0079

## )250±10 תואה ךילומ לש ללוכ ךרוא (mm260

p1 T1134

## תיתדוקנ קבד תחירמ

p1 T0666

## יבוע

p1 T0786

## םוחב לוורשה תא ץווכל

p1 T1247

## םודא

p1 T1282

## םידיג

p1 T0691

## דחי םיחלהל

p1 T1572

## רוחש

p1 T1339

## לוחכ

p1 T0671

## רוזש גוז

p1 T0541

## תואה ךילומ לש ללוכ ךרוא

p1 T1270

## קורי

p1 T0953

## הווצא לש ץר רפסמ

p1 T0884

## הנש

p1 T1018

## שדוח

p1 T1005

## םוי
