oznav2/tectile_skin/hardware/03_Harness/Drawings/ROBOSKIN-HEAD3_Cable.pdf

# HEAD03

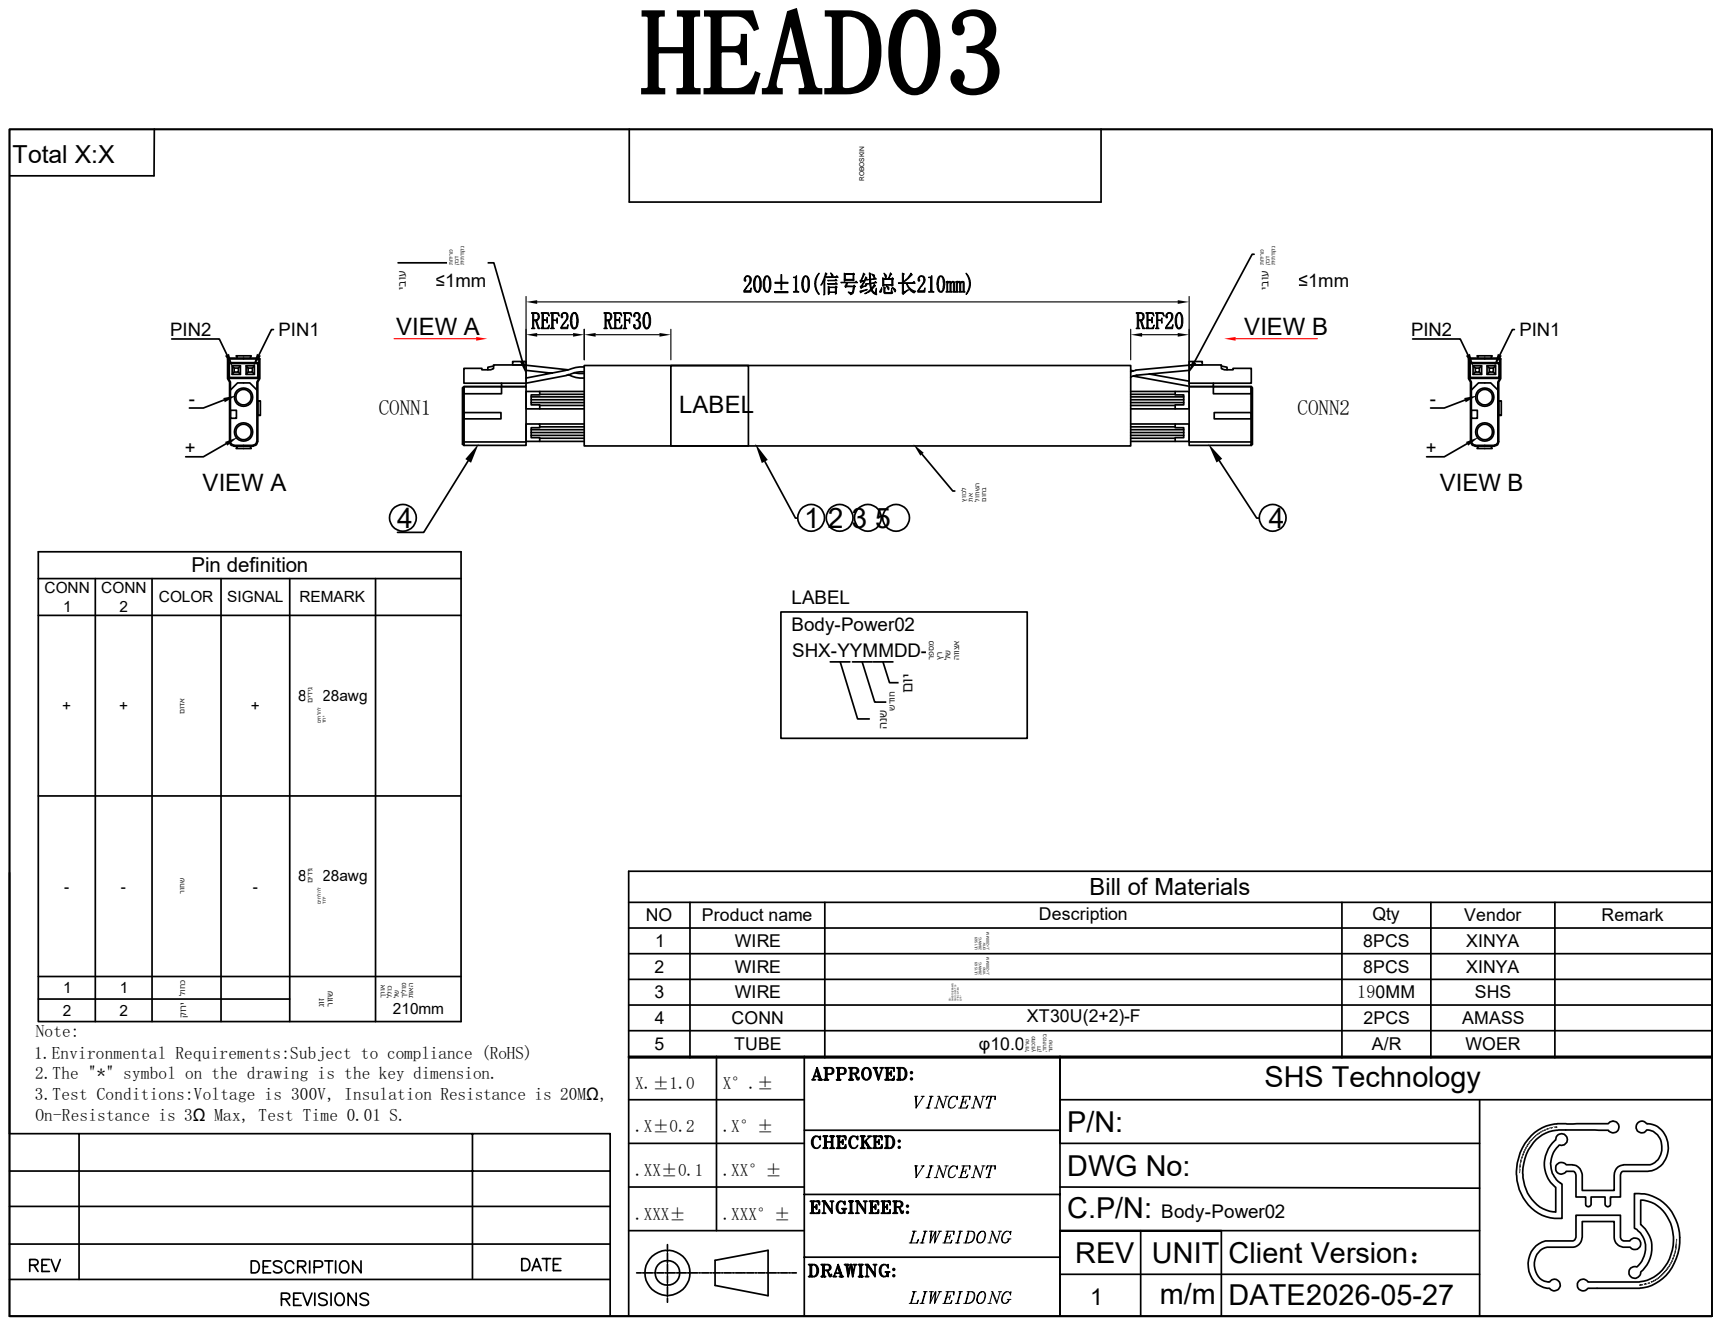
[picture p21: page 1]
+- PIN2; PIN1; .XXX±; .XXX°±; DATE:; REV; UNIT; DWG No:; SHS Technology; Client Version：; Total X:X; Product name; Description; Qty; Vendor; Remark; WIRE; 8PCS; XINYA; SHS; CONN; 2PCS; AMASS; TUBE; WOER; Body-Power02; CONN1; CONN2; +- VIEW A; PIN2; VIEW A; VIEW B; Pin definition; CONN 1; COLOR; SIGNAL; REMARK; 8 28awg -; 8 28awg; LABEL; UL1569 28AWG םודא; UL1569 28AWG רוחש; SHX010(28AWG; לוחכ םירוזש; קורי; לוורש; ץווכתמ; דחוימב; רוחש ,; תחירמ; קבד; תיתדוקנ; יבוע; ץווכל תא; לוורשה םוחב; םודא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

SHX-YYMMDD- LABEL
Body-Power02

Bill of Materials

Note:
1.Environmental Requirements:Subject to compliance (RoHS)
2.The "*" symbol on the drawing is the key dimension.
3.Test Conditions:Voltage is 300V, Insulation Resistance is 20MΩ,
On-Resistance is 3Ω Max, Test Time 0.01 S.

תוגוזב תשר לבכ

ROBOSKIN | RP1-derived engineering record

English file: ROBOSKIN-HEAD3_Cable.pdf
Status: derivative identification; NOT a manufacturing release.

Existing dimensions, tolerances, material and revision remain authoritative. Source engineering graphics and original attribution are retained. Technical notes may remain in the source language.
Only searchable project part IDs on original pages are replaced. Outlined/raster labels require the original CAD authoring application.

Original drawing pages: 1
Searchable ID replacements: 0
Source: Roboparty/rp1_hardware
Hardware licence: CERN-OHL-W-2.0 where applicable; see LICENSES.md. Original path and SHA256: electronic_skin/branding/file_manifest.json

Part aliases in this document:

תודימה , ורמשנ טוטרשבש תולובסהו םירמוחה . הדשו דומע ןייצמ לאמשמ רפסמה . | - ROBOSKIN טוטרשה טסקטל ירבע ארקמ

p1 T0342

,L=200MM םודא UL1569 28AWG

p1 T0346

,L=200MM רוחש UL1569 28AWG

p1 T0328

AWG28(010SHX-SR לוחכ םירוזש תוגוזב תשר לבכ / קורי )

p1 T1389

דחוימב קד ץווכתמ לוורש , רוחש

p1 T1134

תיתדוקנ קבד תחירמ

p1 T0666

יבוע

p1 T0786

םוחב לוורשה תא ץווכל

p1 T1247

םודא

p1 T1282

םידיג

p1 T0691

דחי םיחלהל

p1 T1572

רוחש

p1 T1339

לוחכ

p1 T0671

רוזש גוז

p1 T0541

תואה ךילומ לש ללוכ ךרוא

p1 T1270

קורי

p1 T0953

הווצא לש ץר רפסמ

p1 T0884

הנש

p1 T1018

שדוח

p1 T1005

םוי
