oznav2/tectile_skin/hardware/provenance/impedance_tables/Impedance_Stackup.he.pdf

## תובכש הנבמ | ROBOSKIN

רוקמה תלבט לש ירבע לולמת ; שדחמ בושיח אלל ורמשנ רוציי יכרע

יבוע (mm (יבוע (mil (רמוח יטרפ רמוח גוס הבכש םש

ללוכה יבועה חווט
1.4mm ~ 1.71mm L1 | דידר תשוחנ | 1oz | 1.38 | 0.0350 | L1 גרפרפ | 2116 RC54% 4.9mil | 4.58 | 0.1164
חול תביל 3L2/L | 0.13mm H/HOZ תשוחנ ללוכ וניא יבועה | 0.60 5.12 0.60 | 0.0152 0.1300 0.0152
תשוחנ אלל חול תשוחנ אלל חול | | | 0.1164 4.58 mil4.9 54%RC 2116 גרפרפ

L2
L3
| תשוחנ ללוכ וניא יבועה ; תשוחנ אלל חולל הבירצ H/H mm0.7 | | | תשוחנ אלל חול 0.7000 27.56
גרפרפ | 2116 RC54% 4.9mil | 4.58 | 0.1164
חול תביל 5L4/L | 0.13mm H/HOZ תשוחנ ללוכ וניא יבועה | 0.60 5.12 0.60 | 0.0152 0.1300 0.0152

L4
L5
גרפרפ | 2116 RC54% 4.9mil | 4.58 | 0.1164 L6 | דידר תשוחנ | 1oz | 1.38 | 0.0350 | L6

םיקיר ורמשנ םיקיר םיאת ; ךותב הבילהו תשוחנה יכרע רדס 3L2/L ךותבו 5L4/L רמשנ .

הדימ הנקב טוטרש וניאו תורושל תובכש ךיישמ ינועבצה רויאה . HOZ/H ־ו H/H רוקמ ינומיסכ ורמשנ .
