oznav2/tectile_skin/hardware/assets/images/cnc-part-drawing.png

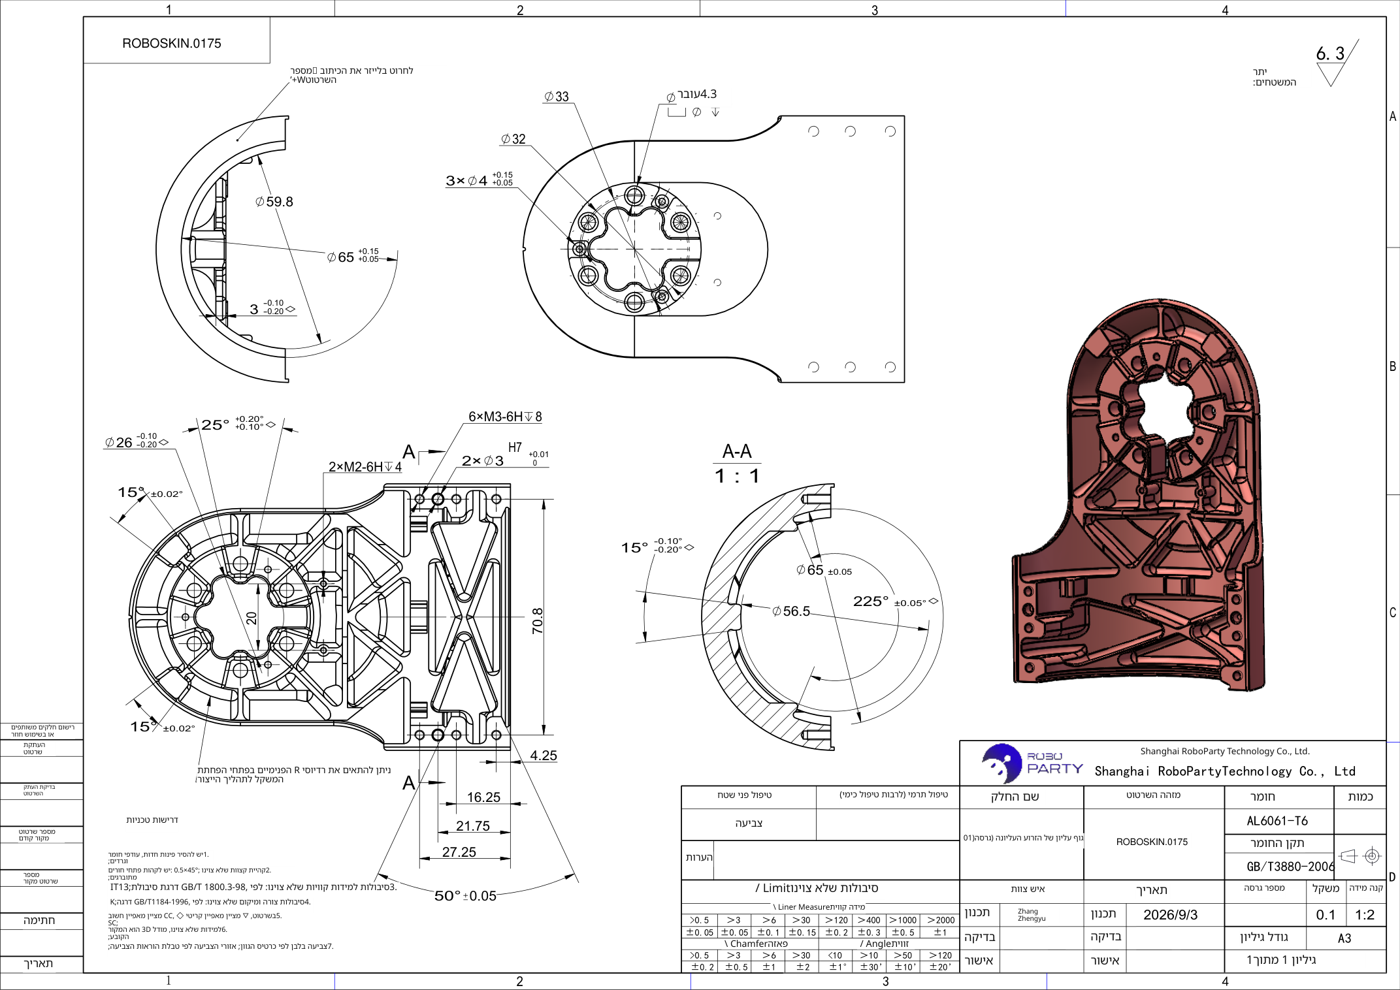
hardware/assets/images/cnc-part-drawing.png
