oznav2/tectile_skin/hardware/assets/images/harness-drawing.png

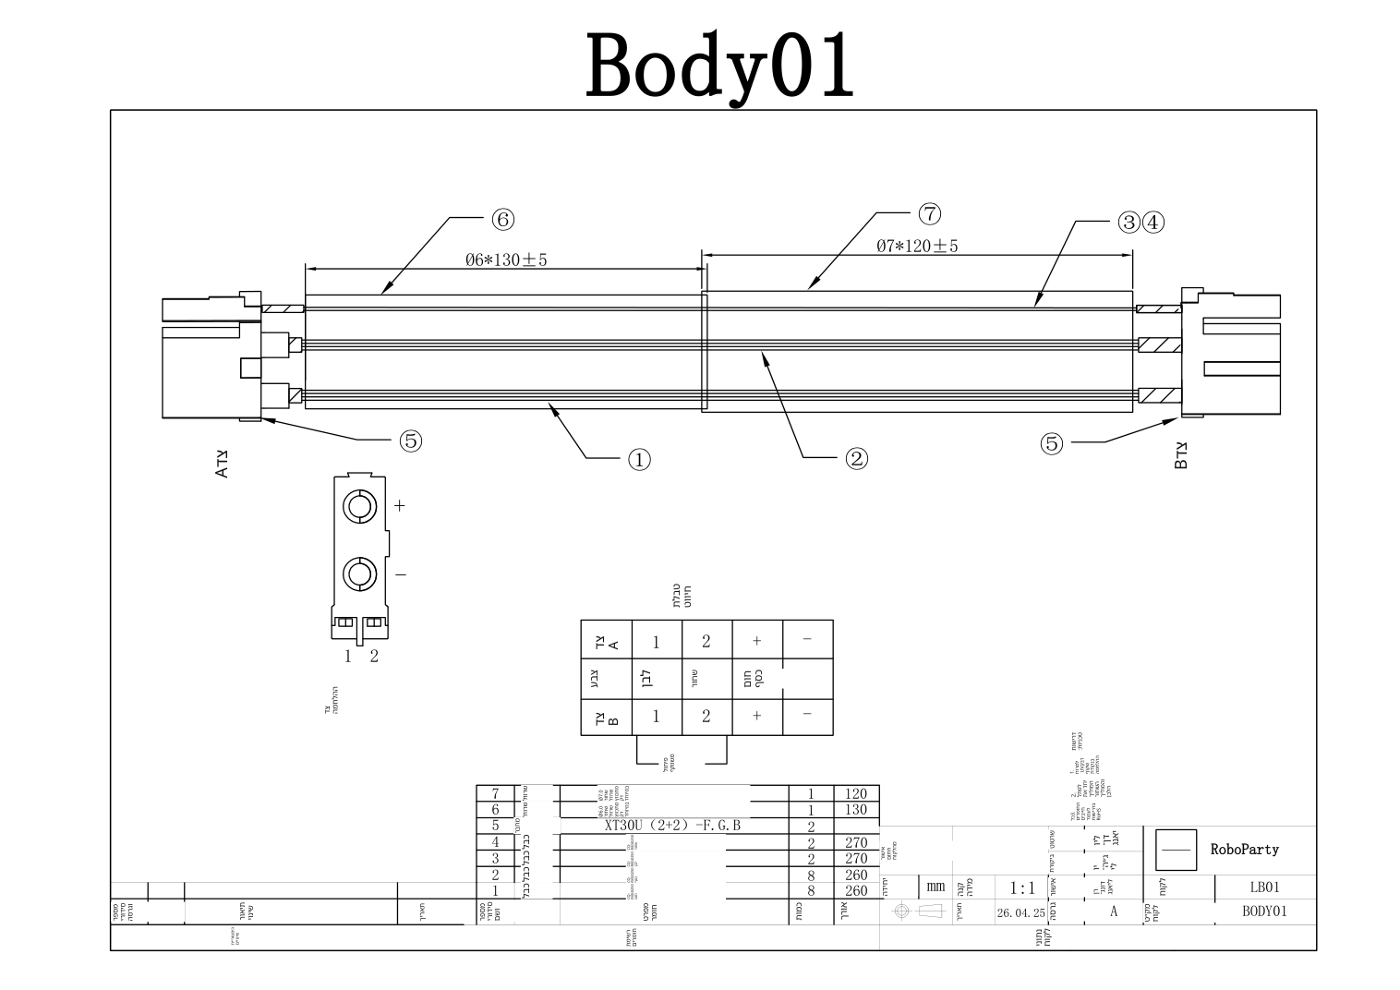
hardware/assets/images/harness-drawing.png
