oznav2/tectile_skin/hardware/assets/images/skin-placement-concept.he.png

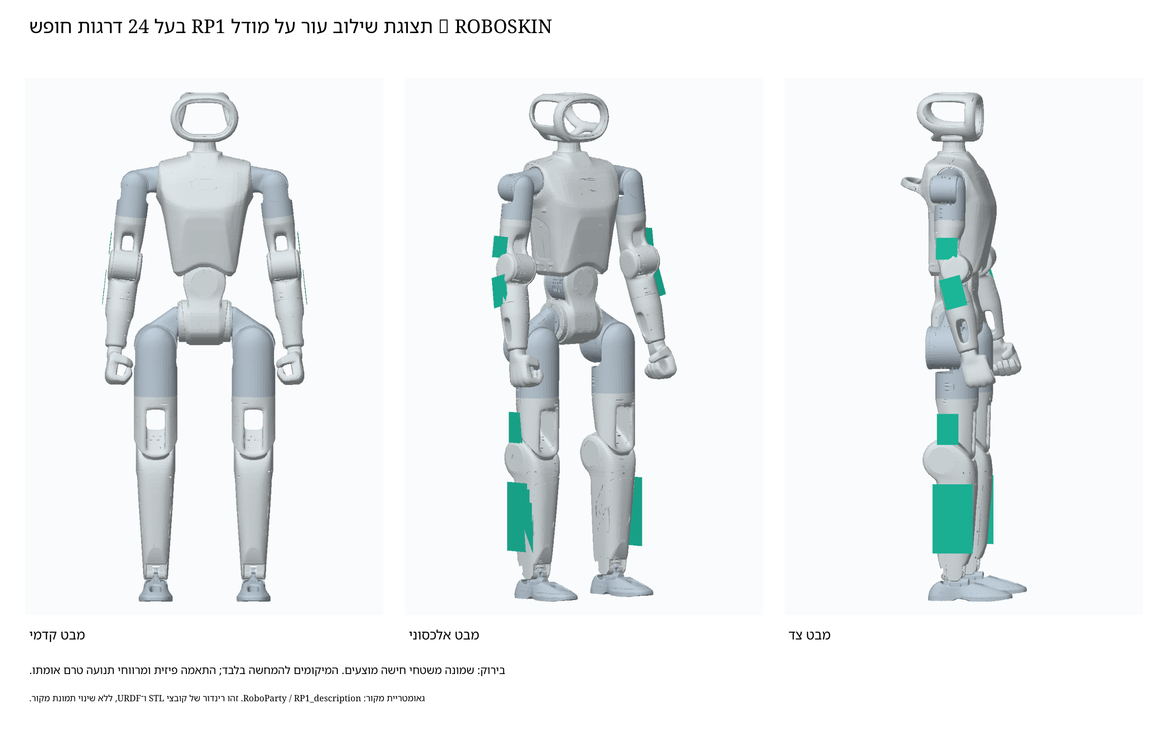
hardware/assets/images/skin-placement-concept.he.png
