oznav2/tectile_skin/hardware/provenance/impedance_tables/Impedance_Stackup.he.png

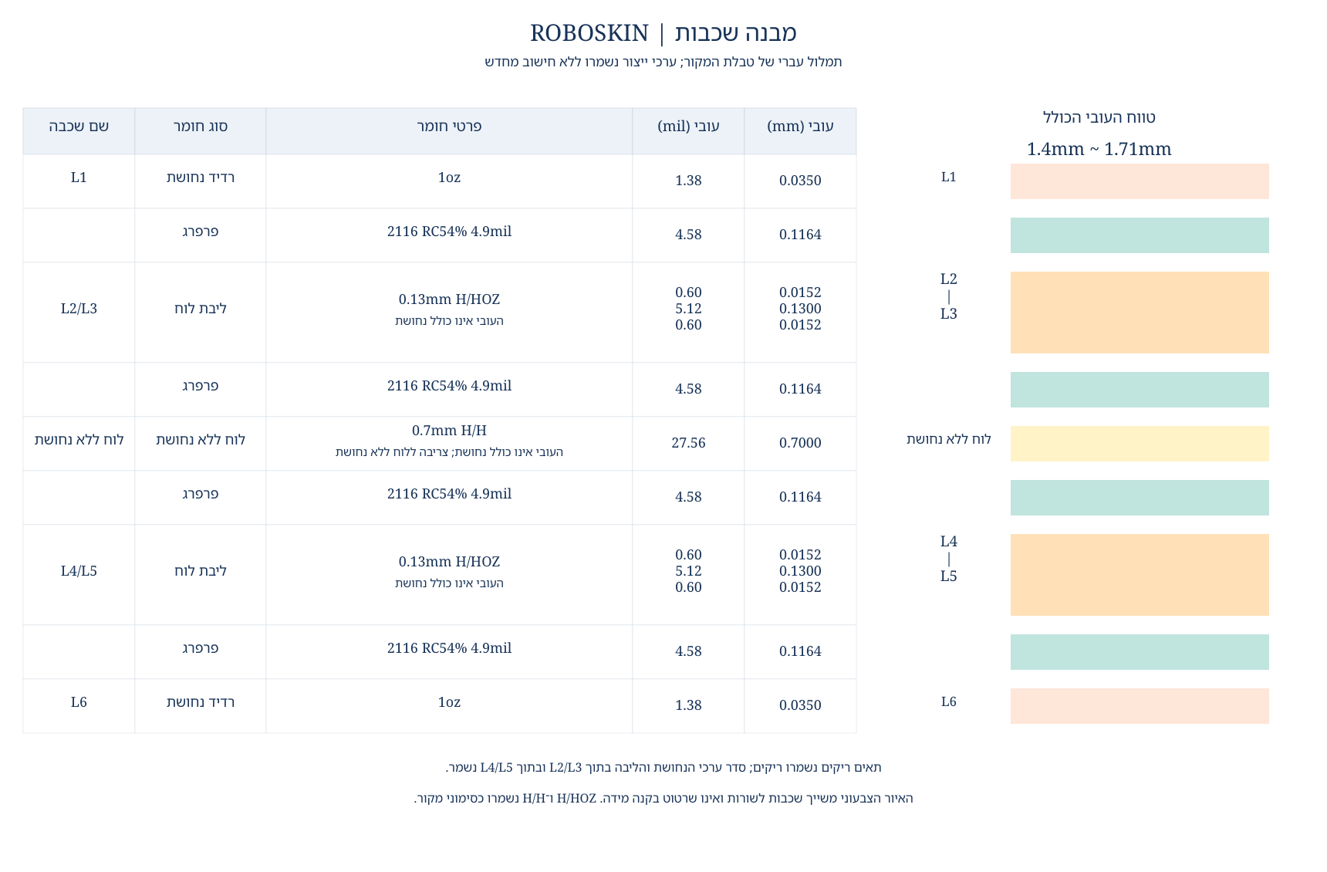
hardware/provenance/impedance_tables/Impedance_Stackup.he.png
