oznav2/tectile_skin/hardware/provenance/impedance_tables/Impedance_Traces.he.png

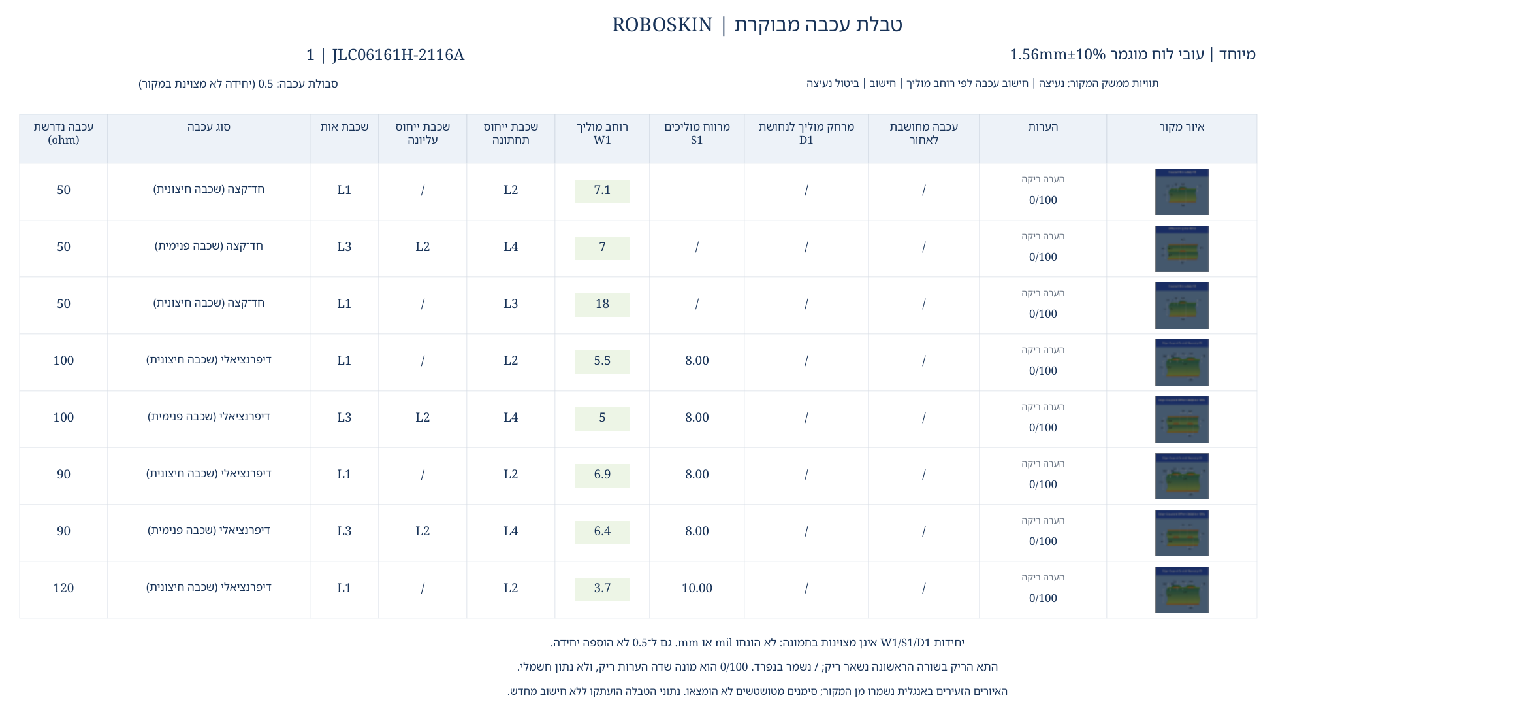
hardware/provenance/impedance_tables/Impedance_Traces.he.png
