oznav2/tectile_skin/hardware/02_PCB/01_USB3_Flexible_Interconnect/01_BOM_FPC_2026-09-18.xlsx

No. | Quantity | Comment | Designator | Footprint | Value | Manufacturer Part | Manufacturer | Supplier Part | Supplier
1 | 2 | GT-F0512SR18-10S0101 | CN1,CN4 | 【FPC】GT-F0512SR18-10S0101 |  | GT-F0512SR18-10S0101 | G-Switch | C21882308 | LCSC
