oznav2/tectile_skin/hardware/02_PCB/02_RBE-COMM-433TX/01_BOM_433TX_2026-09-20.xlsx

No. | Quantity | Comment | Designator | Footprint | Value | Manufacturer Part | Manufacturer | Supplier Part | Supplier
1 | 3 | 100nF | C1,C4,C7 | C0603 | 100nF | CC0603KRX7R9BB104,CGA0603X7R104K500JT | HRE,YAGEO | C14663,C6119867 | LCSC
2 | 2 | 30pF | C2,C3 | C0603 | 30pF | CC0603FRNPO9BN300 | YAGEO | C519491 | LCSC
3 | 1 | 1.5pF | C5 | C0603 | 1.5pF | 0603CG1R5C500NT | FH | C1639 | LCSC
4 | 1 | 100pF | C6 | C0603 | 100pF | CC0603JRNPO9BN101 | YAGEO | C14665 | LCSC
5 | 2 | 9pF | C10,C11 | C0603 | 9pF | CGA0603C0G9R0C500JT | HRE | C41361254 | LCSC
6 | 1 | 220nH | L1 | L0603 | 220nH | SDCL1608CR22JTDF | Sunlord | C22476 | LCSC
7 | 1 | 100nH | L2 | L0603 | 100nH | SDCL1608CR10JTDF | Sunlord | C74310 | LCSC
8 | 1 | 22nH | L3 | L0603 | 22nH | SDCL1608C22NJTDF | Sunlord | C12099 | LCSC
9 | 1 | KT-0603R | LED1 | LED0603-RD |  | KT-0603R | KENTO | C2286 | LCSC
10 | 1 | 4.7kΩ | R1 | R0603 | 4.7kΩ | 0603WAF4701T5E | UNI-ROYAL | C23162 | LCSC
11 | 1 | 100kΩ | R5 | R0603 | 100kΩ | 0603WAF1003T5E | UNI-ROYAL | C25803 | LCSC
12 | 1 | 10kΩ | R6 | R0603 | 10kΩ | 0603WAF1002T5E | UNI-ROYAL | C25804 | LCSC
13 | 1 | 6GHz | RF1 | IPEX-SMD_BWIPX-1-001E | 6GHz | BWIPX-1-001E | BAT WIRELESS | C496552 | LCSC
14 | 1 | SKSGPAE010 | SW1 | SW-SMD_SKSGAAE010 |  | SKSGPAE010 | ALPSALPINE | C125045 | LCSC
15 | 1 | LT4455 | U1 | SOT-23-6_L2.9-W1.6-P0.95-LS2.8-BL |  | LT4455 | Hummingbird Wireless | C5178904 | LCSC
16 | 1 | FB1527 | U2 | SOP-8_L4.9-W3.9-P1.27-LS6.0-BL |  | FB1527 | Hummingbird Wireless | C5182315 | LCSC
17 | 1 | XDCR-1220-006 | U3 | BAT-SMD_CR1220-2ZX |  | XDCR-1220-006 | LX | C7498147 | LCSC
18 | 1 | 13.56MHz | X1 | CRYSTAL-SMD_4P-L3.2-W2.5-BL-1 | 13.56MHz | TAXM13.56M4RLBCCT2T | YJX | C164051 | LCSC
