oznav2/tectile_skin/hardware/02_PCB/10_RBE-SENS-IMU/01_BOM_IMU_2026-09-09.xlsx

No. | Quantity | Comment | Designator | Footprint | Value | Manufacturer Part | Manufacturer | Supplier Part | Supplier | Pin Count | Name | Symbol | Unique ID | Datasheet
1 | 2 | 1uF | C1,C2 | C0603 | 1uF | CL10A105KO8NNNC | SAMSUNG | C1592 | LCSC | 2 | 1uF | CL10A105KO8NNNC | gge9,gge10 | https://item.szlcsc.com/datasheet/CL10A105KO8NNNC/1944.html
2 | 1 | 10uF | C3 | C0603 | 10uF | CL10A106MO8NQNC | SAMSUNG | C92487 | LCSC | 2 | 10uF | CL10A106MO8NQNC | gge4 | https://item.szlcsc.com/datasheet/CL10A106MO8NQNC/93680.html
3 | 2 | 100nF | C4,C6 | C0402 | 100nF | CL05B104KO5NNNC | SAMSUNG | C1525 | LCSC | 2 | 100nF | CL05B104KO5NNNC | gge5,gge6 | https://item.szlcsc.com/datasheet/CL05B104KO5NNNC/1877.html
4 | 2 | 100pF | C5,C7 | C0402 | 100pF | 0402CG101J500NT | FH | C1546 | LCSC | 2 | 100pF | 0402CG101J500NT | gge45,gge46 | https://atta.szlcsc.com/upload/public/pdf/source/20200305/C486355_26A10D38EF8C2A5C37091D0039909270.pdf
5 | 1 | 1N5819HW-7-F | D1 | SOD-123_L2.7-W1.6-LS3.7-RD |  | 1N5819HW-7-F | DIODES | C82544 | LCSC | 2 | 1N5819HW-7-F | 1N5819HW-7-F | gge2 | https://item.szlcsc.com/datasheet/1N5819HW-7-F/83701.html
6 | 1 | SM24CANB-02HTG | D14 | SOT-23-3_L2.9-W1.3-P1.90-LS2.4-BR |  | SM24CANB-02HTG | Littelfuse | C151237 | LCSC | 3 | SM24CANB-02HTG | SM24CANB-02HTG | gge44 | https://item.szlcsc.com/datasheet/SM24CANB-02HTG/162577.html
7 | 2 | SMD0603-010-24V | F1,F2 | F0603 |  | SMD0603-010-24V | Luhai Taiwan | C70048 | LCSC | 2 | SMD0603-010-24V | 0603-010-24V | gge42,gge43 | https://item.szlcsc.com/datasheet/SMD0603-010-24V/71143.html
8 | 1 | GL0603UG01 | LED1 | LED0603-RD |  | GL0603UG01 | Guiguang light | C51933293 | LCSC | 2 | GL0603UG01 | GL0603UG01 | gge51 | https://item.szlcsc.com/datasheet/GL0603UG01/54645989.html
9 | 3 | 1K | R1,R15,R17 | R0402 | 1K | 0402WGF330JTCE | UNI-ROYAL |  | LCSC | 2 | 1K | 0402WGF330JTCE | gge8,gge48,gge49 | https://item.szlcsc.com/datasheet/0402WGF330JTCE/25848.html
10 | 1 | 510R | R6 | R0402 | 510R | 0402WGF330JTCE | UNI-ROYAL |  | LCSC | 2 | 510R | 0402WGF330JTCE | gge50 | https://item.szlcsc.com/datasheet/0402WGF330JTCE/25848.html
11 | 1 | 120Ω | R14 | R0805 | 120Ω | 0805W8F1200T5E | UNI-ROYAL | C17437 | LCSC | 2 | 120Ω | 0805W8F1200T5E | gge47 | https://atta.szlcsc.com/upload/public/pdf/source/20200306/C422600_1E6D84923E4A46A82E41ADD87F860B5C.pdf
12 | 1 | SPX3819M5-3.3 | U1 | SOT-23-5_L2.9-W1.6-P0.95-LS2.8-BL |  | SPX3819M5-3.3 |  | C9900018941 | LCSC | 5 | SPX3819M5-3.3 | SPX3819M5-3.3 | gge11
13 | 1 | WAFER-GH1.25-4PWB | U2 | CONN-SMD_4P-P1.25_XUNPU_WAFER-GH1.25-4PWB |  | WAFER-GH1.25-4PWB | XUNPU | C3029379 | LCSC | 6 | WAFER-GH1.25-4PWB | WAFER-GH1.25-4PWB | gge52 | https://item.szlcsc.com/datasheet/WAFER-GH1.25-4PWB/3561391.html
14 | 1 | HI05XX | U3 | HI02_HI05 |  |  |  |  |  | 19 | HI05XX | HI05XX | gge1
15 | 1 | SIT3051TK | U4 | DFN-8_L3.0-W3.0-P0.65-BL-EP |  | SIT3051TK | SIT | C601078 | LCSC | 9 | SIT3051TK | SIT3051TK | gge41 | https://atta.szlcsc.com/upload/public/pdf/source/20200610/C601078_B1F4AB5D187DBA98E917965AB02FEC6C.pdf
16 | 4 | M2 בורג | U5,U6,U7,U8 | M2 בורג |  |  |  |  |  | 1 |  | M2 בורג | gge53,gge54,gge55,gge55_1
17 | 1 | SMF5.0CA | U9 | SOD-123FL_L2.8-W1.8-LS3.7-BI |  | SMF5.0CA | KUU | C2985633 | LCSC | 2 | SMF5.0CA | SMF5.0CA_C2985633 | gge56 | https://atta.szlcsc.com/upload/public/pdf/source/20211206/852276409897768D6E4CD85BFA43719B.pdf
