oznav2/tectile_skin/hardware/02_PCB/13_Lighting_Board/01_BOM_LAMP_2026-09-07.xlsx

No. | Quantity | Comment | Designator | Footprint | Value | Manufacturer Part | Manufacturer
1 | 12 | 100nF | C1,C2,C3,C4,C5,C6,C7,C8,C9,C10,C11,C12 | C0603 | 100nF | CC0603KRX7R9BB104 | YAGEO
2 | 12 | WS2812B-MINI-V3/W | LED1,LED2,LED3,LED4,LED5,LED6,LED7,LED8,LED9,LED10,LED11,LED12 | LED-SMD_4P-L3.5-W3.5-TL_WS2812B |  | WS2812B-MINI-V3/W | worldsemi
