oznav2/tectile_skin/hardware/02_PCB/14_Rear_Power_Indicator/01_BOM_INDICATOR_2026-09-16.xlsx

No. | Quantity | Comment | Designator | Footprint | Value | Manufacturer Part | Manufacturer | Supplier Part | Supplier
1 | 1 | HX PZ2.0-1x5P WZ-AM | H2 | HDR-TH_5P-P2.00-H-M_HC-PZ200-10.5L-1X5PWA |  | HX PZ2.0-1x5P WZ-AM | hanxia | C22438279 | LCSC
2 | 2 | 10kΩ | R1,R45 | R0402 | 10kΩ | 0402WGF1002TCE | UNI-ROYAL | C25744 | LCSC
3 | 2 | XL-A3528RGBC-BM | U1,U34 | LED-ARRAY-SMD_4P-L3.2-W2.8-LS3.5-BL_XL-A3528RGBC-BM |  | XL-A3528RGBC-BM | XINGLIGHT | C3647023 | LCSC
