oznav2/tectile_skin/research/sensing_materials/review.md

<div dir="rtl" lang="he">

עברית · [English](review.en.md)

# מקורות על חישה, חומרים ויישומים: סקירה ביקורתית

הוכן בתאריך 24 באוקטובר 2026 עבור התוכנית ההנדסית של הפרויקט. היקף: מקורות **1–19, 30–34 ו-36–40** של Cheng ועמיתיו, בדיוק 29 רשומות. שאר המקורות ו-ProxySKIN 2024 מטופלים בסקירה המרכזת. לא נרכש אף מאמר מקורי ולא נוצר קשר עם אף מחבר.

## מזכר שילוב

תצורת הבסיס שניתן להצדיק היא כיסוי זול וניתן להחלפה לגפיים, המזהה כמה מגעים ורמות יחסיות של העמסה בניצב למשטח, עם חישת טמפרטורה דלילה המוצהרת במפורש. סקירה זו תומכת בהמרה מקומית לדיגיטל ובתקשורת אזורית, אך **אינה** מבססת שמכלול שכבות החומר המוצע עבר את דרישות העייפות, הכיסוי, העלות או תפוקת הייצור התעשייתית התקינה. רמות הראיות שלהלן מבחינות בין גוף טקסט מלא, סעיפים נבחרים מהטקסט המלא, קטעים מקוריים מאונדקסים, תקצירים ראשוניים ואימות ביבליוגרפי בלבד.

שינויים קונקרטיים המומלצים למפרט הפרויקט:

1. **להפוך את מכניקת השכבות המותקנות לשער שחרור.** יש להכשיר את מכלול הכיסוי, הדבק, החיישן, שכבת התמיכה והכבל הסופי על עקמומיות הגפה המיועדת. יש למדוד את קו הבסיס והעומס המקדים לאחר ההתקנה ולאחר החלפת הכיסוי. יש להשתמש בתפר מחליק או חופף, או להשאיר רצועה עיוורת ממופה במפרקים; אין למתוח למינציה גמישה רגילה על פני קפל. הבסיס המתודולוגי הרלוונטי הוא [8], פרק 4.1, ו-[9], סעיפים III–IV. מוליך שניתן לכופף אינו מאמת לבדו מכלול עור.
2. **להפריד בין ההבטחות התרמיות.** שני חיישני ה-NTC מודדים את סביבתם התרמית המקומית. עצם חם קטן במקום אחר עלול שלא להתגלות. יש למפות מגע מחומם או מקורר ומבוקר על פני כל לוח ותפר, בעזרת מדידת טמפרטורת פני שטח עצמאית, ולתעד מיקום, כוח, מדרגת טמפרטורה, השהיית תגובה ואות לחץ כוזב. יש לבדוק חימום מקומי ושינוי אחיד של טמפרטורת הסביבה בנפרד. התקדים לשכבות משולבות [7] והפיצוי המבני ב-[17], סעיפים III ו-IV-E, הם מנגנונים שונים. אין לטעון לכיסוי תרמי מלא או להשתמש ב-NTC אלה כייחוס לפיצוי לחץ ללא ראיות.
3. **להוסיף בדיקות דינמיות וסטטיות בתנאים תואמים.** מפעיל קטן או חוד לחיצה עם ייחוס עומס הנדגם באופן עצמאי צריך להפעיל פרופילי מגע הניתנים לחזרה, במופעים אקראיים ביחס לסריקת 100 Hz. יש ללכוד את תחילת הכוח, רכישת ה-ADC, חותמת הזמן המשודרת והחלטת המחשב המארח על בסיס זמן משותף. יש להשתמש בהגדרות המסנן שיותקנו בפועל. יש לתעד הסתברות גילוי, כוח שיא לפני התגובה, זמן שחרור והתאוששות והיסט לאחר עומס יתר. מתחילים בלחיצה במעבדה באנרגיה נמוכה; הסרט החיצוני הדק אינו בולם פגיעה. [8], פרק 4.1, מספק את ההבחנה בין סוגי ההערכה.
4. **לאפיין ביושר את הכוח ואת גאומטריית המגע.** יש למדוד במרכז, בקצה, בתפר ובין אתרי חישה, עם חודי לחיצה קטנים, נומינליים ורחבים לפחות. יש להוסיף שני מגעים בו־זמניים, כמה מגעים סמוכים ועומס על שטח רחב; יש לדווח על בלבול בין אתרים שכנים. יש לפרסם ביצועים לפי סוגי מגע, במקום להמיר קריאות ADC שרירותיות ל-kPa. [16], סעיפים VI-B–D, חושף תלות בשטח המגע והשפעות של שדות קליטה. בטלאי שלנו, בעל פסיעה של 25 mm, שגיאת הכימות לבחירת האתר הקרוב לבדה מגיעה עד 12.5 mm בכל ציר, וכ-17.7 mm באלכסון בתוך תא מרובע אידאלי; המכניקה בפועל ואזורים מתים עלולים להחמיר אותה. זהו חסם גאומטרי, לא דיוק שנמדד.
5. **לשמור על יכולת ביקורת של ההסתגלות.** בעת אתחול יש להבחין בין כיול במצב ללא עומס שאומת, לבין מצב לא ידוע או בעל עומס מקדים. יש להקפיא את קו הבסיס כאשר מגע ננעל או נחשד, ולתעד כל קביעה מחדש של הבסיס. יש לבדוק עליית כוח איטית, עומס רצוף במשך 10 דקות ולוח ללא עומס הסובל מסחיפה תרמית. יש לאמת את השחרור בנפרד. [16], סעיף V, מספק דפוס מבוסס להקפאת אתר חישה בעת מגע, אך בפסאודו־קוד שחולץ ממנו יש אי־התאמה בסימן; יש לבדוק את המימוש שלנו בבדיקות יחידה מול תחום אי־התגובה החתום שאליו התכוונו המחברים.
6. **להשתמש בחלופת ייחוס הוגנת.** אם דגימת החומר ההתנגדותית אינה עומדת בדרישות החזרתיות, היציבות התרמית או ההזדקנות, יש להשוות מכלול קיבולי המבוסס על בד מרווח לפי [17], עם אותו שטח, עובי מותקן, כיסוי, מתקן מגע, דגימה וגבולות קבלה. אין להציג זאת כהחלפה ישירה או להניח שהקצב והעובי שפורסמו עומדים במפרט שלנו. יש לקבל הצעות מחיר עדכניות לחומרים ולתהליכים בנפרד; מאמרים ישנים מבססים מסלולי היתכנות, ולא מחירי 2026.
7. **לתקצב מידע ולא רק מספר חוטים.** שיטות מרכז־כובד בעלות ארבעה חוטים אינן יכולות לזהות באופן יחיד קבוצות שרירותיות של מגעים בו־זמניים [39]; סריקה מקומית פעילה [9, 15, 16] משמרת יותר מידע במחיר של אלקטרוניקה והספק. יש לשמר את הזהויות של כל 28 אתרי החישה. יש לתעד בנפרד את קצב המסגרות המלאות, פערי זמני הסריקה, גיל הדגימות והשהיית התעבורה. [37], סעיף IV, הוא אזהרה קונקרטית מפני פירוש שגוי של קצב המרה בודדת כקצב המערך המלא.
8. **לתחום את היישום ואת טענת החדשנות.** הפטיקה של כל הגוף, שכבות מגן, עור רב־חושי, CAN ועיבוד מקומי, ואלפי אתרי מישוש גמישים הם כולם ידע קודם. תרומה הראויה להשקעה יכולה להיות שילוב מדוד של עלות מותקנת ליחידת שטח, מסה נמוכה, החלפה מהירה, דיווח אמין על כמה מגעים וייצור שניתן לשחזר. יש להדגים זאת באמצעות מבחני ייחוס תואמים ולחשוף אזורים עיוורים. חישת עור לבדה אינה מוכיחה אינטראקציה פיזית בטוחה, בקרת כוח, שיווי משקל, מיומנות תנועה או תפיסה המקבילה לזו של אדם.

### ניסויים מוצעים בדגימות ובגפיים — המלצות הנדסיות שלנו

יש להשתמש בחמישה לוחות שהורכבו באופן עצמאי, ובהם לפחות שתי אצוות של חומר חישה או דבק כאשר הן זמינות. יש לשמור רישומי ייצור: אצוות הסרט, הכנת פני השטח, עובי הדבק, לחץ וזמן הלמינציה, יישור וזמן הקשיה או התייצבות. אין להשמיט לוחות שנכשלו בלי לדווח; יש לפרסם תפוקה תקינה במעבר ראשון ועבודת תיקון.

- בידוד חשמלי: להחליף את החיישנים בנגדים קבועים, לשנות ערוץ אחד לאורך תחום העכבה המיועד ולאמת את 27 הערוצים האחרים; לחזור כאשר PWM המנועים פעיל ותוך כיפוף הכבל. לאחר מכן לחזור על הבדיקה המכנית עם עומסים אמיתיים בשתי נקודות ועל שטח רחב. כך מפרידים בין צימוד חשמלי לפיזור מכני לגיטימי.
- סחיפה וזחילה: לתעד גם החזקות בכוח קבוע, באמצעות משקולת וגאומטריית מגע ידועה, וגם החזקות בהעתק קבוע, באמצעות חוד לחיצה מקובע, ולאחריהן שחרור והתאוששות. יש לשנות באקראי את סדר ההעמסה ולכלול מחזורים חוזרים ללא מנוחות ארוכות. יש לפרסם עקבות גולמיים וספים, כולל גילויים חיוביים ושליליים כוזבים.
- עקמומיות ותחזוקה: להשוות התקנה שטוחה, ברדיוס מינימלי וברדיוס נומינלי; החלפת כיסוי; התקנת כבל; ניגוב יבש ושימוש בנוזל הניקוי המוגדר. יש לחזור על בדיקות הגילוי אחרי כל פעולה. יש להגביל את הטענות לתנאים שנבדקו בפועל.
- תנועה: להשתמש במתקן מפרק לאורך תחום הזוויות והמהירויות המיועד, עם ניתוב הכבלים המורכב. למדוד תוספת מומנט וגרר, רפיון כבל, אירועים הנוצרים מקמטים ומאמץ במחברים. לבצע מחזורי תנועה במכלול המותקן, ולא רק ביריעה. להפריד בין מחזורי חקירה למחזורי הסמכה ולתעד כשלים.
- תרמיקה: להציב מגע בטמפרטורה ידועה מעל חיישני NTC, ביניהם ועל תפרים. לתעד את אזור הגילוי האפקטיבי ואת ההשהיה כאשר אלקטרוניקת הרובוט פועלת. לחזור תחת עומס מכני קבוע כדי לחשוף רגישות צולבת. מגע מחומם שלא התגלה מחוץ לאזור הכיסוי הנטען הוא ממצא על הכיסוי, ולא פגם בקושחה.
- כלכלת ייצור: למדוד בכל לוח את זמני המיקום, הלמינציה, הרכבת המחברים, התכנות, הבדיקה, הכיול וההחלפה. לחשב עלות ללוח שאושר לאחר פסילות ותיקונים, ולא רק את עלות חומרי הגלם. לכלול את החיישנים, הבקר, ההתקנה, ההגנה והצמה בסך המסה המותקנת.

אלה הוראות בדיקה ושערי החלטה, ולא טענות למוצר גמור שאומת בניסוי. כישלון חייב להביא לשינוי במכלול השכבות, בדרישה או בטענת המוצר; מאמר חיובי אינו יכול להחליף ראיות אלה.

## פירוט היקף הגישה למקורות

- `citation_only`: 3 מקורות.
- `primary_abstract`: 8 מקורות.
- `primary_full_text_main`: מקור 1.
- `primary_full_text_selected`: 12 מקורות.
- `primary_indexed_excerpt`: 5 מקורות.

`primary_full_text_main` פירושו שנקרא גוף הטקסט המהותי של המאמר; אין בכך טענה לשחזור עצמאי או לביקורת מלאה של כל העבודות המצוטטות. `primary_full_text_selected` מציין בכוונה היקף מצומצם יותר. `primary_indexed_excerpt` פירושו שרק החלקים הנגישים לחיפוש מתוך PDF מקורי של מחבר או מאגר היו זמינים, גם כאשר קיימת כתובת לטקסט המלא. `primary_abstract` תומך רק בטענות ברמת התקציר. `citation_only` מספק היסטוריה ביבליוגרפית, ללא טענה ניסויית שעברה ביקורת. כיתובי איורים נבדקו כאשר הדבר מצוין; תמונות שלא היו זמינות אינן מוצגות כאילו נבדקו חזותית.

ניסיונות הורדת PDF דרך המעטפת נכשלו עקב DNS בסביבת הבדיקה המוגבלת. שליפה באמצעות הדפדפן סיפקה טקסטים מלאים רבים, בעוד שמוציאים לאור מסוימים החזירו דפי אימות, 403, חריגת זמן או תשובות הזמינות למנויים בלבד. אלה פערי גישה, ולא ראיה לכך שאין במאמר תוצאות שימושיות. אין לצטט את החלקים שלא נבדקו כאילו הם מספקים פרטי מעגל מאומתים. סקירה זו אינה מבססת זמינות ספקים עכשווית, הצעות מחיר, חופש פעולה בתחום הפטנטים או הסמכת בטיחות.

## רשומות ממוספרות

### [1] Automated tactile sensing

L. D. Harmon, International Journal of Robotics Research 1(2), 3–32, 1982. [מקור ראשוני או רשומת זיהוי](https://journals.sagepub.com/doi/10.1177/027836498200100201)

**רמת ראיות:** citation_only

**היקף הקריאה:** מטא־נתונים של המוציא לאור והערות שוליים גלויות; המאמר המלא לא היה זמין. אין להתייחס לכך כסקירת טקסט מלא או תקציר.

**ממצא:** סקירה מוקדמת הממחישה את העומק ההיסטורי של חישת מישוש אוטומטית. לא מאומצת כאן שום תוצאה כמותית על חיישן מתוך מאמר זה.

**מגבלה:** החומר שפורסם משקף מידע שנאסף לפני ינואר 1981; המלצות היסטוריות אינן מפרטי רכיבים עדכניים.

**פעולה בתוכנית:** להשתמש רק כרקע היסטורי. לקבוע את דרישות הגפיים לפי משימות המגע בפועל ובדיקות הקבלה, במקום להסתמך על יעדי שקילות לאדם מתוך סקירה היסטורית שלא נקראה.

**השלכה על החדשנות:** אין לטעון שחישת מישוש במובנה הרחב היא רעיון חדש.

**הערה ביבליוגרפית או על הגישה:** המוציא לאור מציין עמודים 3–32; הביבליוגרפיה של Cheng ותעתיק המשתמש מציינים 3–31. DOI 10.1177/027836498200100201.

### [2] E-skin: From humanoids to humans

R. Dahiya, Proceedings of the IEEE 107(2), 247–252, 2019. [מקור ראשוני או רשומת זיהוי](https://eprints.gla.ac.uk/183481/1/183481.pdf)

**רמת ראיות:** primary_full_text_selected

**היקף הקריאה:** כתב יד שהתקבל לפרסום: המבוא וסעיפים המשווים בין דרישות עור אלקטרוני, מסלולי שילוב ואלקטרוניקה גמישה ומודפסת; לא כל פסקת סיכום או עבודה מצוטטת.

**ממצא:** מאמר העמדה משווה רכיבים רגילים על מצעים גמישים לאלקטרוניקה מודפסת ודקה במיוחד. תוספת תפקודים ברכיבים בדידים מתחרה ביכולת להתאים לצורת המשטח; הדרישות תלויות ביישום.

**מגבלה:** מאמר עמדה אינו ראיה לכך שלסרט מודפס מסוים יש חיי עייפות, תפוקת ייצור תקינה, עלות או דיוק רב־חושי קבילים.

**פעולה בתוכנית:** להשאיר במוצר הראשון מספר קטן של אופני חישה מוכחים. למקם אלקטרוניקה במארזים על איים הנתמכים מכנית; להכשיר את מלוא החיבורים והכיסוי. לעקוב אחר שטח, מסה מותקנת וזמן תיקון בנפרד מעובי רכיב החישה.

**השלכה על החדשנות:** עור רב־חושי גמיש ואלקטרוניקה מבוזרת כבר היו כיווני מחקר מבוססים.

**הערה ביבליוגרפית או על הגישה:** DOI 10.1109/JPROC.2018.2890729; כתב היד במאגר הוא מקור ראשוני של המחבר.

### [3] Tactile sensing—From humans to humanoids

R. S. Dahiya, G. Metta, M. Valle and G. Sandini, IEEE Transactions on Robotics 26(1), 1–20, 2010. [מקור ראשוני או רשומת זיהוי](https://www.robotcub.org/misc/papers/10_Dahiya_etal.pdf)

**רמת ראיות:** primary_indexed_excerpt

**היקף הקריאה:** קטעים מאונדקסים מתוך PDF של המחברים או הפרויקט: איור סיווג 2, סעיף III על פיזיולוגיה, קידוד ודרישות חישה אזוריות. השליפה הישירה של ה-PDF נכשלה; נמצאו גם קטעי הגהה שהעלה מחבר.

**ממצא:** הסקירה מבחינה בין חישה עורית לחישת מפרקים וכוח, בין מערכי קצות אצבעות לעור על שטח רחב, ובין ערוצי מישוש המסתגלים לאט לכאלה המסתגלים מהר. צפיפות הקולטנים והביצועים המרחביים והזמניים הנדרשים משתנים לפי אזור הגוף.

**מגבלה:** מספרי קולטנים ביולוגיים וחדות תפיסתית אינם מגדירים ישירות פסיעת אתרי חישה אלקטרוניים, רזולוציית ADC או רוחב פס נדרש לרובוט. זו סקירה, ולא אימות של מכלול החיישנים שלנו.

**פעולה בתוכנית:** לשמר מצב של מגע מתמשך לצד אירועי התחלה ושינוי. להגדיר איתור מגע גס בזרוע וברגל בנפרד ממיומנות קצות אצבעות; לשמר מקודדי מפרקים ומשוב מפעילים. לבדוק עומס מתמשך כדי שהסתגלות קו הבסיס לא תמחק מגע אמיתי.

**השלכה על החדשנות:** מבנה שכבות בהשראת ביולוגיה וצמצום נתונים בהשראה ביולוגית הם ידע קודם.

**הערה ביבליוגרפית או על הגישה:** DOI 10.1109/TRO.2009.2033627; הגהת מחבר: https://www.researchgate.net/publication/220032969_Tactile_Sensing-From_Humans_to_Humanoids

### [4] Directions toward effective utilization of tactile skin: A review

R. S. Dahiya et al., IEEE Sensors Journal 13(11), 4121–4138, 2013. [מקור ראשוני או רשומת זיהוי](https://eprints.gla.ac.uk/95989/)

**רמת ראיות:** primary_abstract

**היקף הקריאה:** תקציר מוסדי ורשומה ביבליוגרפית של Glasgow; תקציר מוסדי של TUM. הטקסט המקורי המלא לא נקרא.

**ממצא:** המחברים מציגים עור מישוש שימושי כבעיה מערכתית הכוללת כיסוי מבוזר, מגעים בו־זמניים, רכישה, כיול ופרשנות בזמן אמת.

**מגבלה:** התקציר אינו מספק ערכי מעגל מאומתים, מעטפת פעולה ניסויית או כלכלת ייצור.

**פעולה בתוכנית:** לשמר מטריצת קבלה החוצה חומר, רכישה, תקשורת, קואורדינטות גוף ויישום. אתר חישה בודד שפועל אינו סוגר את דרישות ריבוי המגעים, הכיסוי או ההשהיה.

**השלכה על החדשנות:** שילוב ברמת המערכת, בקרה מבוזרת וכיול הם נושאי מחקר ותיקים.

**הערה ביבליוגרפית או על הגישה:** DOI 10.1109/JSEN.2013.2279056. אימות נוסף של TUM: https://portal.fis.tum.de/en/publications/directions-toward-effective-utilization-of-tactile-skin-a-review/

### [5] Proximity sensing in robot manipulator motion planning: System and implementation issues

E. Cheung and V. J. Lumelsky, IEEE Transactions on Robotics and Automation 5(6), 740–751, 1989. [מקור ראשוני או רשומת זיהוי](https://www.edcheung.com/job/sbr/IEEE88.pdf)

**רמת ראיות:** primary_full_text_selected

**היקף הקריאה:** כתב יד באתר המחבר: ארכיטקטורת המערכת ותכנון מקומי, בערך עמודים 2–4 בכתב היד; דף הפרויקט של המחבר המזהה את הפרסום. לא כל הניסויים.

**ממצא:** סידור האינפרה־אדום שנבדק מספק מעטפת גילוי מכשולים של כ-10–15 cm סביב הזרוע, ומתאם את החישה עם כ-50 מיקומי פקודה בשנייה. התנועה מוגבלת למעטפת החופשית שנחשה.

**מגבלה:** הטיעון למניעת התנגשות תלוי בכיסוי, במהירויות הרובוט, במאפייני החיישנים ובתזמון הבקרה; אין זו הבטחה לכל רובוט או עצם.

**פעולה בתוכנית:** אין לתאר את העור שלנו, המבוסס על לחץ בלבד, כמזהה מכשולים לפני מגע. אם מוסיפים חישת קרבה, יש לאמת כל תנוחת מפרק וכל שילוב של החזריות עצם וזווית מול מעטפת העצירה בפועל וההשהיה שנמדדה.

**השלכה על החדשנות:** הימנעות ממכשולים באמצעות זרוע רגישה מבוזרת קדמה למוצר המוצע בעשרות שנים.

**הערה ביבליוגרפית או על הגישה:** מקור המחבר מזהה קובץ זה עם הפרסום משנת 1989 למרות שם הקובץ IEEE 88; דף הפרויקט https://www.edcheung.com/job/sbr/sbr.html.

### [6] Sensitive skin

V. J. Lumelsky, M. S. Shur and S. Wagner, IEEE Sensors Journal 1(1), 41–51, 2001. [מקור ראשוני או רשומת זיהוי](https://resenv.media.mit.edu/classarchive/MAS965/readings/sensitiveskin.pdf)

**רמת ראיות:** primary_full_text_selected

**היקף הקריאה:** המאמר המקורי דרך ארכיון הוראה של MIT: המבוא; דרישות חומרה והתקנים ודיון בתהליכים זולים, עמודים מודפסים 46–47. חלקים אחרים לא נקראו באופן ממצה.

**ממצא:** המאמר קושר במפורש עיבוד מקומי, מבני חישה פשוטים, עמידות לתקלות, יכולת תיקון וייצור. הוא דן באיים פעילים קשיחים המחוברים במוליכים גמישים, ומזהיר שנתיבי אות על פני שטח רחב קולטים רעש.

**מגבלה:** עלויות הייצור והתחזיות הן היסטוריות; אי אפשר להעבירן לרשימת חומרים של 2026. הצעות למערכות עתידיות עם מיליוני חיישנים אינן הוכחה לתפוקת ייצור תקינה.

**פעולה בתוכנית:** לשמור על קווים אנלוגיים קצרים, להמיר לדיגיטל באופן אזורי, לספק דיווח על ערוצים שנכשלו ולתמחר פסילות, תיקונים ופעולות החלפה. להשוות צמות מלאות במצב מותקן, ולא רק את מסת הנחושת.

**השלכה על החדשנות:** עור מלאכותי זול, מבוזר ועמיד לתקלות הוא יעד ותיק; הבידול חייב להימדד במימוש.

**הערה ביבליוגרפית או על הגישה:** DOI 10.1109/JSEN.2001.923586.

### [7] Conformable, flexible, large-area networks of pressure and thermal sensors with organic transistor active matrixes

T. Someya et al., PNAS 102(35), 12321–12325, 2005. [מקור ראשוני או רשומת זיהוי](https://pmc.ncbi.nlm.nih.gov/articles/PMC1187825/)

**רמת ראיות:** primary_full_text_selected

**היקף הקריאה:** גוף הטקסט הראשוני הפתוח, הייצור וניסויי הלחץ והטמפרטורה, וכיתובי איורים 1–5; ללא נתונים משלימים או שחזור עצמאי.

**ממצא:** רשת 12×12 בפסיעה של 4 mm משלבת שכבות לחץ וטמפרטורה. גאומטריית הרשת מאפשרת התארכות של 25%; התארכות גדולה יותר שוברת את החיווט במקטעי התמיכה. 2, 000 המחזורים שדווחו בהתארכות של 20% מתייחסים למבני בדיקת זהב מפושטים, ולא לעור שלם. המעגלים האורגניים משתמשים במתחי הטיה של −20/−40 V.

**מגבלה:** הדגמת החישה התרמית המשולבת והגנת הטרנזיסטורים אינן מבססות עמידות ארוכת טווח ללחות, לשחיקה או לעייפות מפרקים בלמינציה מסחרית.

**פעולה בתוכנית:** להשתמש ברעיון השכבות המבוסס עם אלקטרוניקה פשוטה יותר במתח נמוך, אך לבדוק מסלולי חום ומעוות של המכלול השלם בנפרד. אין להחליף בדיקת עייפות של מחברים, דבק, חיישן וכיסוי נשחק בבדיקת עייפות של דגימת מוליך.

**השלכה על החדשנות:** עור רב־שכבתי ללחץ ולטמפרטורה הוא ידע קודם מפורש משנת 2005.

**הערה ביבליוגרפית או על הגישה:** DOI 10.1073/pnas.0502392102. המאמר המלא נקרא עד הניסויים העיקריים המהותיים; אין טענה לבדיקה חזותית של כל התמונות.

### [8] Artificial Skin in Robotics: A Comprehensive Interface for System-Environment Interaction

M. Strohmayr, doctoral dissertation, Karlsruhe Institute of Technology, 2012. [מקור ראשוני או רשומת זיהוי](https://publikationen.bibliothek.kit.edu/1000028782/2186259)

**רמת ראיות:** primary_full_text_selected

**היקף הקריאה:** טקסט נבחר מהתזה: פשרות תכן בפרק 3; נהלי בדיקה בפרק 4.1, עמודים מודפסים 152–159; ומסקנות. לא כל קובץ ה-PDF בן 217 העמודים.

**ממצא:** התזה מפרידה בין רגישות להגנה מהתנגשות, ומעריכה את החיישן יחד עם האלקטרוניקה שלו. הבדיקות המוצעות כוללות לחיצה סטטית, חזרתיות, פגיעה דינמית, התאוששות ועומס יתר; הסינון משפיע על הרגישות ועל זמן התגובה.

**מגבלה:** נהלי ההערכה המוצעים אינם תקן הסמכה אוניברסלי. התזה עצמה מצביעה על פשרות ביצועים שטרם נפתרו.

**פעולה בתוכנית:** להוסיף לחיצה דינמית מבוקרת עם ייחוס עצמאי של עומס וזמן, התאוששות מעומס יתר והגדרות מסנן זהות לאלה שבהפעלה. סרט ה-TPU הדק נגד שחיקה אינו בולם אנרגיית פגיעה. למדוד התנהגות בתפרים ובעקמומיות מותקנת, ולא רק בדגימות שטוחות.

**השלכה על החדשנות:** שילוב הגנה מכנית עם חישה כבר מבוסס; מימוש דק ובר־תחזוקה עם ביצועים כמותיים עדיין עשוי לבדל את המוצר.

**הערה ביבליוגרפית או על הגישה:** כותרת KIT שלעיל מלאה יותר מהכותרת המקוצרת של Cheng, “Artificial skin for robots.” DOI 10.5445/IR/1000028782.

### [9] Conformable and scalable tactile sensor skin for curved surfaces

Y. Ohmura, Y. Kuniyoshi and A. Nagakubo, ICRA 2006, 1348–1353. [מקור ראשוני או רשומת זיהוי](https://bdml.stanford.edu/twiki/pub/Haptics/TactileChapterReferences/Ohmura-ICRA06.pdf)

**רמת ראיות:** primary_full_text_selected

**היקף הקריאה:** המאמר המקורי בן שישה עמודים: תקציר, דרישות, סעיפים III–IV ותחילת V, וכיתובי איורים 1–10. יתר פסקאות הניסוי והמסקנות לא נקראו באופן ממצה.

**ממצא:** המימוש מציב 32 רכיבי חישה אופטיים מבוססי החזרה ומיקרו־בקר על מצע גמיש חתוך ומקופל. הפולטים האופטיים מופעלים בחלוקת זמן כדי לשלוט בהספק; SMBus מקומי מתחבר לרשת טבעת בתוך הגוף. קיבול האפיק מגביל את ההתרחבות.

**מגבלה:** קיבולת מרחב הכתובות אינה קצב העברה בו־זמני של כל העור. מסת היריעה החשופה שדווחה אינה כוללת קצף שנוסף בהמשך ואת הרשת המותקנת המלאה. יכולת קיפול אינה מעידה על יכולת מתיחה חוזרת.

**פעולה בתוכנית:** להשתמש במשפחה קטנה של לוחות ובשחרור מאמצים מכני מבוקר. למדוד הספק כולל במחזור העבודה האמיתי של הסריקה, מסה מותקנת וטריות מסגרות מלאות במספר הצמתים המרבי. לשמר חיווט אנלוגי מקומי קצר וקישור דיגיטלי אזורי עמיד.

**השלכה על החדשנות:** סריקה מקומית, צמצום חיווט, מודולים המתאימים לצורת המשטח ועור הנחתך לפי צורה הודגמו ב-2006.

**הערה ביבליוגרפית או על הגישה:** DOI 10.1109/ROBOT.2006.1641896.

### [10] Development of the tactile sensor system of a human-interactive robot RI-MAN

T. Mukai, M. Onishi, T. Odashima, S. Hirano and Z. Luo, IEEE Transactions on Robotics 24(2), 505–512, 2008. [מקור ראשוני או רשומת זיהוי](https://repository.gatech.edu/bitstreams/39fe7cef-a8a4-4ebb-81a4-097c885fa7bd/download)

**רמת ראיות:** primary_indexed_excerpt

**היקף הקריאה:** תקציר ומבוא מאונדקסים מהעמוד הראשון המקורי, ממאגר Georgia Tech. הורדת ה-PDF החזירה 403; הניסויים המרכזיים לא נקראו.

**ממצא:** התקציר המקורי מדווח על מערכת מישוש רכה ושטחית משולבת ב-RI-MAN ועל הדגמת הרמת בובת אדם. לא מאומצת כאן שום תוצאה מספרית על דיוק חיישן או עמידותו מתוך המאמר המלא.

**מגבלה:** הדגמת רובוט שלם המטפל בבובה אינה מבודדת את תרומת החיישן ואינה מאמתת את הלוח ההתנגדותי המוצע. תיאור מבנה חיישן לחץ מוליך־למחצה בסקירות אחרות הוא ראיה משנית בלבד.

**פעולה בתוכנית:** להשתמש בעצם ניסוי נתמך ובעל מסה נמוכה בניסויי מגע ראשוניים בזרוע ובגוף. לתעד בנפרד את תרומת גילוי המגע בעור, את תרומת ההנעה ברובוט ואת ההגנה המסופקת מכנית.

**השלכה על החדשנות:** עור רובוטי רך על שטח רחב לסיוע פיזי הוא ידע קודם מבוסס.

**הערה ביבליוגרפית או על הגישה:** DOI 10.1109/TRO.2008.917006; מספר מאמר אצל המוציא לאור 4458232. פרקים פתוחים קשורים לא שימשו תחליף למקור זה.

### [11] ARMAR-III: An integrated humanoid platform for sensory-motor control

T. Asfour et al., IEEE-RAS Humanoid Robots, 2006, 169–175. [מקור ראשוני או רשומת זיהוי](https://h2t.iar.kit.edu/pdf/Asfour2006b.pdf)

**רמת ראיות:** primary_full_text_selected

**היקף הקריאה:** סעיפי המאמר המקורי העוסקים בחישה בזרוע ובעור מלאכותי, עמודים 2–3 ב-PDF, והארכיטקטורה ההיררכית ואיור 5. לא כל ניסויי הפלטפורמה.

**ממצא:** העור בכתף ובזרוע משולב ב-CAN באמצעות בקרים ייעודיים, לצד חיישני מומנט מפרקים וחיישני כוח ומומנט בשורש כף היד שהם נפרדים. הארכיטקטורה מפרידה בין תכנון משימה, תיאום וביצוע.

**מגבלה:** מאמר פלטפורמה זה אינו מספק מתכון ייצור עצמאי ואינו מוכיח שעור גס מחליף חישה מדויקת במפרקים או בשורש כף היד.

**פעולה בתוכנית:** לחשוף מגע, מיקום, רמת ביטחון ותקלות עם חותמות זמן דרך מנהל התקן ייעודי. להשאיר את ויסות המפעילים בשכבת בקרת הרובוט הקיימת; לבדוק טיפול בחריגת זמן בכל גבול ממשק.

**השלכה על החדשנות:** עיבוד עור מקומי המחובר ב-CAN ושילוב ברובוט שלם כבר התקיימו בשנת 2006.

**הערה ביבליוגרפית או על הגישה:** DOI 10.1109/ICHR.2006.321380.

### [12] Design of human symbiotic robot TWENDY-ONE

H. Iwata and S. Sugano, ICRA 2009, 580–586. [מקור ראשוני או רשומת זיהוי](https://waseda.elsevierpure.com/en/publications/design-of-human-symbiotic-robot-twendy-one/)

**רמת ראיות:** primary_abstract

**היקף הקריאה:** רשומת פרסום ותקציר במוסד המחברים. המאמר המקורי בן שבעת העמודים לא היה נגיש.

**ממצא:** התכן משלב מנגנונים פסיביים בזרוע ורכות מכנית במפרקים ובעור, שנגזרו ממערכת דרישות של משימות סיוע.

**מגבלה:** התקציר אינו חושף מגבלות כוח מגע, אימות סיכונים, דיוק של העור בנפרד או עלות ייצור ברמת רכיב.

**פעולה בתוכנית:** להגדיר משימות שירות לפני הוספת אופני חישה. לאמת טווחי מפרק, חיכוך, משיכת כבל ומאמץ מקדים בחיישן על מתקן גפה; חישה לבדה אינה יכולה להעניק היענות מכנית למנגנון קשיח.

**השלכה על החדשנות:** כיסוי רך בשילוב מנגנוני מפרק פסיביים הוא ידע קודם.

**הערה ביבליוגרפית או על הגישה:** DOI 10.1109/ROBOT.2009.5152702. המאמר היפני הקשור משנת 2008 על עיצוב המראה הוא פרסום נפרד.

### [13] Humanoid robot which can lift a 30 kg box by whole body contact and tactile feedback

Y. Ohmura and Y. Kuniyoshi, IROS 2007, 1136–1141. [מקור ראשוני או רשומת זיהוי](https://www.isi.imi.i.u-tokyo.ac.jp/publication/)

**רמת ראיות:** citation_only

**היקף הקריאה:** אומתו הביבליוגרפיה של מעבדת המחברים וקישור לרשומת המוציא לאור. המאמר המקורי לא היה זמין; נראה תקציר משני שהופץ במאגר אחר, אך הוא לא שימש ראיה ניסויית מאומתת.

**ממצא:** זהות המאמר וכותרתו מתעדות טענה מוקדמת למגע של כל הגוף ולמשוב מישוש. תוצאת 30 kg היא כאן טענה שדווחה בכותרת, ולא שחזור שעבר ביקורת.

**מגבלה:** אין בסקירה זו הגברים, סטטיסטיקת כשלים, התפלגות כוחות או תנאי בטיחות מאומתים מתוך המקור.

**פעולה בתוכנית:** לצטט את התקדים בלי לאמץ את כושר הנשיאה שלו. בהוכחת ההיתכנות שלנו יש להשוות התנהגות עם עור פעיל וללא עור פעיל על אותו מתקן מרוסן ובעל אנרגיה נמוכה, באמצעות מדדים אובייקטיביים לגילוי מגע ולתגובה.

**השלכה על החדשנות:** הרמה באמצעות מישוש של כל הגוף אינה רעיון יישומי חדש.

**הערה ביבליוגרפית או על הגישה:** DOI 10.1109/IROS.2007.4399592; אתר המוציא לאור https://ieeexplore.ieee.org/document/4399592 מחייב אימות JavaScript.

### [14] Whole body haptics for augmented humanoid task capabilities

Y. Kuniyoshi, Y. Ohmura and A. Nagakubo, Robotics Research, Springer Tracts in Advanced Robotics 66, 61–73. [מקור ראשוני או רשומת זיהוי](https://link.springer.com/chapter/10.1007/978-3-642-14743-2_6)

**רמת ראיות:** primary_abstract

**היקף הקריאה:** תקציר המוציא לאור, מטא־נתוני הפרק והמקורות; הפרק המלא המוגבל למנויים לא היה זמין.

**ממצא:** התקציר מדווח על כיסוי מישוש לכל הגוף של הומנואיד בגודל אדם בוגר ועל ניסויי תנועה במגע, לרבות בובת אדם במשקל 66 kg.

**מגבלה:** התקציר לבדו אינו מאמת את תנאי ההעמסה, עמידות הבקרה או הכלכלה. הוא אינו מצדיק הדגמות הרמת אדם באמצעות אב־טיפוס ממעבדה ביתית.

**פעולה בתוכנית:** להשאיר את המדגים הראשוני בזרועות וברגליים, במשימות מגע מוגבלות ובעומס נמוך, ללא נשיאת אדם. להסביר את היישום העתידי בלי לרמוז שאימות החומרה והבקרה שלו כבר הושלם.

**השלכה על החדשנות:** יכולת מגע של כל הגוף והפטיקה מבוזרת דמוית אדם הן מניעים מבוססים.

**הערה ביבליוגרפית או על הגישה:** הציטוט וזכויות היוצרים אצל המוציא לאור מציינים 2010; רשימת Cheng והמשתמש מציינת 2011, וגם ביבליוגרפיית המעבדה מציינת את הספר מ-2011. יש להשאיר גלוי את פער המהדורה והשנה. DOI 10.1007/978-3-642-14743-2_6.

### [15] An embedded artificial skin for humanoid robots

G. Cannata, M. Maggiali, G. Metta and G. Sandini, MFI 2008, 434–438. [מקור ראשוני או רשומת זיהוי](https://robotcub.org/misc/papers/08_cannata.pdf)

**רמת ראיות:** primary_full_text_main

**היקף הקריאה:** כל גוף המאמר המקורי המהותי בן חמשת העמודים, כולל ארכיטקטורה, מתמר, מיקרו־בקר, ניסויים ומסקנות; וכיתובי האיורים. התמונות לא פוענחו באופן עצמאי.

**ממצא:** שנים־עשר אתרי חישה קיבוליים בכל משולש משתמשים בהמרת AD7147; עד 16 משולשים או 192 אתרים מתחברים באפיקים מקומיים ל-MCU/CAN אחד. אלקטרודה מוארקת וניתנת לעיוות מאפשרת מגע בעצמים מבודדים ומספקת סיכוך. חישה ממוצעת בכ-500 Hz מחליפה פירוט מרחבי במהירות; ערוצים בודדים איטיים יותר.

**מגבלה:** אב־הטיפוס המדווח כולל שישה משולשים, והניסויים הכמותיים עדיין נמשכים. קצף בעובי שלושה עד חמישה מילימטרים שונה מהלמינציה הדקה שלנו. מספר יציאות אינו מעיד על ניתוב חלופי מסתגל.

**פעולה בתוכנית:** לשמר איגום מקומי ולהבחין בין חישת כוח ניצב לבין גילוי קיבולי בסיסי של מגע אדם. בבחינת חלופות קיבוליות יש לכלול את מלוא מכלול אלקטרודת ההארקה, הדיאלקטרי והכיסוי, ולמדוד גם פירוט מרחבי וגם זמן תגובה.

**השלכה על החדשנות:** מודולריות, המרה מקומית, איגום ב-CAN ורזולוציה מרחבית מסתגלת הם ידע קודם.

**הערה ביבליוגרפית או על הגישה:** DOI 10.1109/MFI.2008.4648033. יחידות שטח והספק שחולצו מקובץ PDF מוקדם אינן חד־משמעיות; לא מאומץ ערך של צפיפות הספק.

### [16] Methods and technologies for the implementation of large-scale robot tactile sensors

A. Schmitz et al., IEEE Transactions on Robotics 27(3), 389–400, 2011. [מקור ראשוני או רשומת זיהוי](https://www.researchgate.net/publication/224238240_Methods_and_Technologies_for_the_Implementation_of_Large-Scale_Robot_Tactile_Sensors)

**רמת ראיות:** primary_full_text_selected

**היקף הקריאה:** כתב יד שהעלה מחבר: סעיפים I, III, V ו-VI-A–D, וכיתובי איורי ההרכבה. לא כל משוואת היסטרזיס או ניסוי אחיזה.

**ממצא:** ממיר הקיבול לדיגיטל בעל 16 הסיביות סיפק 8 סיביות אות שימושיות באותו מכלול. הסתגלות לסחיפה נעצרת בעת מגע. גאומטריית הגשוש משנה את התגובה, ובכמה תצורות גוף אין אלקטרודה עליונה והמערכת מסתמכת על האדם כמישור הארקה.

**מגבלה:** בפסאודו־קוד הסחיפה שחולץ חסר כנראה סימן מינוס ביחס לתחום אי־התגובה המוצהר ±0.5; אין להעתיק אותו באופן עיוור. ביצועי החיישן שפורסמו אינם מועברים אוטומטית ללמינציה ההתנגדותית שלנו.

**פעולה בתוכנית:** להקפיא את קו הבסיס בזמן מגע; לבדוק עליות איטיות ועומסים מתמשכים. למדוד רזולוציה שימושית המוגבלת בפועל בידי רעש. לבדוק מגעי פלסטיק, מתכת וכפפה. לכייל כמה קוטרי גשוש ועקמומיות מותקנת במקום לטעון לדיוק לחץ מתוך גשוש יחיד.

**השלכה על החדשנות:** עור זול, ניתן להחלפה ומבוסס רכיבי מדף, עם אפיקים מבוזרים וכיול, הוא ידע קודם.

**הערה ביבליוגרפית או על הגישה:** DOI 10.1109/TRO.2011.2132930. מעלה הקובץ הוא השותף לכתיבה Marco Maggiali; כתובת האתר המקורית של המחבר מחזירה כעת 404.

### [17] A flexible and robust large scale capacitive tactile system for robots

P. Maiolino, M. Maggiali, G. Cannata, G. Metta and L. Natale, IEEE Sensors Journal 13(10), 3910–3917, 2013. [מקור ראשוני או רשומת זיהוי](https://arxiv.org/pdf/1411.6837)

**רמת ראיות:** primary_full_text_selected

**היקף הקריאה:** סעיפים III–IV בכתב יד המחברים, טקסט השילוב וכיתובי איורי הניסויים; רוב גוף הטקסט נקרא, אך לא הנתונים המשלימים.

**ממצא:** התכן משתמש בבד מרווח 3D מתעשיית הביגוד ובכיסויים נשלפים. באב־טיפוס שטוח עם דיאלקטרי בעובי 2 mm, 15 מחזורי העמסה עם מנוחות של דקה הניבו הפרש מחזורים מרבי של 9.1 fF ב-28.6 kPa, בערך 5% מהתחום. קבלי ייחוס שאינם רגישים ללחץ מפצים על סחיפה תרמית מבנית; הם אינם מדי טמפרטורת פני שטח. הרכישה המדווחת פועלת ב-25 Hz.

**מגבלה:** הרפיה במשך עשר דקות בהעתק קבוע אינה בדיקת זחילה בכוח קבוע או בדיקת אורך חיים. לא העובי ולא הביצועים עוברים אוטומטית למכלול התנגדותי בעובי 1.5 mm ובקצב 100 Hz.

**פעולה בתוכנית:** להשתמש כמבחן ייחוס לחלופה קיבולית, בכפוף להשוואת המכלול המלא. להפריד בין חישת טמפרטורה נקודתית לפיצוי לחץ. לבדוק החזקות בכוח קבוע ובהעתק קבוע, וגם חימום מקומי בזמן העמסה.

**השלכה על החדשנות:** עור רובוטי מבוסס בד, מוגן וניתן לתחזוקה קדם להצעה זו.

**הערה ביבליוגרפית או על הגישה:** DOI 10.1109/JSEN.2013.2258149. ההגשה ל-arXiv בשנת 2014 היא עותק מחברים של המאמר מ-2013.

### [18] A new silicone structure for uSkin—A soft, distributed, digital 3-axis skin sensor and its integration on humanoid robot iCub

T. P. Tomo et al., IEEE Robotics and Automation Letters 3(3), 2584–2591, 2018. [מקור ראשוני או רשומת זיהוי](https://qmro.qmul.ac.uk/xmlui/bitstream/handle/123456789/55045/Jamone%20A%20New%20Silicone%202018%20Accepted.pdf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)

**רמת ראיות:** primary_indexed_excerpt

**היקף הקריאה:** סעיפים III-A/B, טבלה I וכיתובי איורים 1–2 מאונדקסים בכתב היד הראשוני שהתקבל לפרסום; השליפה הישירה של ה-PDF מהמאגר נכשלה. הכיול והתוצאות לא נקראו במלואם.

**ממצא:** שישה־עשר תאים מגנטיים בעלי 3 צירים תופסים 26×27×6.05 mm; סרט התקנה בעובי כ-1 mm מוסיף לעובי. בליטות ומרווחי אוויר מפחיתים צימוד מכני מכוח ניצב לגזירה. בניסיון ראשון עם סיליקון רך המגנטים יכלו למשוך זה את זה.

**מגבלה:** המכלול השלם עבה ומורכב יותר מסרט התנגדותי דק. הביצועים בשדות מגנטיים של מנועים, עם דבקי הכיסוי שנבחרו ובגאומטריית הגפה שלנו עדיין לא אומתו.

**פעולה בתוכנית:** לשמור אופן חישה זה לגרסה החשה גזירה. אם ייבחן, יש לבדוק הפרעה מגנטית כאשר המנועים מופעלים, עומס יתר, צימוד בין צירים וזחילה של סרט ההתקנה; לכלול כל שכבת הגנה והתקנה בעובי ובעלות.

**השלכה על החדשנות:** עור דיגיטלי רך ומוגן בעל 3 צירי חישה כבר הודגם; כיסוי מפושט למגע ניצב מכוון למפרט שונה.

**הערה ביבליוגרפית או על הגישה:** יש להשתמש בכתב היד שהתקבל בשנת 2018 כמקור; אין להמציא דיוק כיול שלא אומת או DOI שלא אומת.

### [19] An adjustable force sensitive sensor with an electromagnet for a soft, distributed, digital 3-axis skin sensor

A. C. Holgado et al., IROS 2018, 2582–2588. [מקור ראשוני או רשומת זיהוי](https://waseda.elsevierpure.com/en/publications/an-adjustable-force-sensitive-sensor-with-an-electromagnet-for-a-/)

**רמת ראיות:** primary_abstract

**היקף הקריאה:** תקציר ממוסד המחברים וזיהוי הפרסום; הטקסט המקורי המלא לא נקרא.

**ממצא:** אב־הטיפוס מחליף מגנט קבוע באלקטרומגנט, כך שהזרם יכול לשנות את רגישות הכוח בחיישן מגנטי רך.

**מגבלה:** התקציר אינו מבסס עלות ייצור המוני ואינו מצדיק תוספת הספק, צימוד תרמי וכיול לצורך חישת לחץ ניצב בקירוב.

**פעולה בתוכנית:** לא לכלול אלקטרומגנטים בתצורת הבסיס. להוסיף אותם רק אם אי אפשר לענות באופן פסיבי על בעיית תחום כוח מוגדרת, ואם התועלת המדודה עולה על עלות הספק הסליל, החום ומעגל ההנעה.

**השלכה על החדשנות:** רגישות מישוש מגנטית הניתנת לכוונון אלקטרוני היא ידע קודם.

**הערה ביבליוגרפית או על הגישה:** DOI 10.1109/IROS.2018.8593757.

### [30] Tactile sensing in intelligent robotic manipulation—A review

J. Tegin and J. Wikander, Industrial Robot 32(1), 64–70, 2005. [מקור ראשוני או רשומת זיהוי](https://www.researchgate.net/publication/228667424_Tactile_sensing_in_intelligent_robotic_manipulation_-_a_review)

**רמת ראיות:** primary_full_text_selected

**היקף הקריאה:** טקסט שהעלה מחבר: המבוא, סעיפים 5.2–5.7 והמסקנות. נמצא הדפס חוזר בתזה של KTH, אך לא ניתן היה לשלוף את קובץ ה-PDF הגדול.

**ממצא:** הסקירה מפרידה בין חישת מגע מבוזרת לבין חישת כוח ומומנט פנימית. היא דנה בשחזור מכני הפוך דרך כיסויים רכים, בסחיפה ובהיסטרזיס של FSR וחיישנים קיבוליים, ובאובדן מידע על תבנית המגע בשיטות אנלוגיות בעלות מעט חוטים.

**מגבלה:** רשימות הספקים והמידות שלה הן היסטוריות. כוח ומיקום שקולים יחידים אינם יכולים לזהות קבוצה שרירותית של מגעים בו־זמניים.

**פעולה בתוכנית:** לשמר זהויות נפרדות של אתרי חישה לצורך חישה של כמה מגעים בגפה. אין להסיק גזירה, חיכוך, קשיות חומר או כוח מדויק מתוך קריאות יחסיות בכיוון הניצב, ללא מדידה נוספת ומודל מאומת.

**השלכה על החדשנות:** מערכים התנגדותיים, חישה קיבולית, עיבוד מקומי ופשרות של חישת מגע עם מעט חוטים הם תחומים מבוססים.

**הערה ביבליוגרפית או על הגישה:** DOI 10.1108/01439910510573318; מעלה הקובץ מזוהה כמחבר Johan Tegin.

### [31] Sensitive manipulation: Manipulation through tactile feedback

E. Torres-Jara and L. Natale, International Journal of Humanoid Robotics 15(1), 1850012, 2018. [מקור ראשוני או רשומת זיהוי](https://lornat75.github.io/pdfs/2018-torresjara-sensitive.pdf)

**רמת ראיות:** primary_full_text_selected

**היקף הקריאה:** תקציר ומבוא בכתב יד המחברים, איור חומרה 1 וסעיפים 4.1.3–4.3, עמודי PDF 12–15. לא כל הניסויים.

**ממצא:** Obrero משלב הנעה בעלת היענות עם אסטרטגיות מישוש להשגת מגע ולשימורו. הטקסט מציין במפורש מגעים שלא זוהו באזורי מפרקים לא מחוששים, ואסטרטגיית הרמה וניסיון חוזר כאשר חישת החלקה מיידית אינה מספקת.

**מגבלה:** ההצלחה תלויה בחומרת היד, בבקרת כוח ובאסטרטגיות חקירה שאינן קיימות בלוחות הגסים שלנו לזרועות ולרגליים. אין כאן הוכחה שעצם הוספת אתרי חישה מעניקה מיומנות תנועה.

**פעולה בתוכנית:** לכלול תפרי מפרקים שאינם מחוששים במפות הכיסוי. להדגים התנהגות מוגבלת אחת המודעת למגע ולהשוותה לבסיס, תוך תיעוד מגעים שלא זוהו; אין לטעון לגילוי החלקה כללי או לאחיזה מיומנת.

**השלכה על החדשנות:** מניפולציה המתחילה ממישוש וחקירת מגע פעילה הן ידע קודם.

**הערה ביבליוגרפית או על הגישה:** כתב היד שהתקבל לפרסום מתוארך לאוקטובר 2017, עבור הפרסום בשנת 2018.

### [32] High-density conformable tactile sensing glove

T. Sagisaka et al., IEEE-RAS Humanoids 2011, 537–542. [מקור ראשוני או רשומת זיהוי](https://ieeexplore.ieee.org/document/6100898)

**רמת ראיות:** citation_only

**היקף הקריאה:** אומתה הביבליוגרפיה של מעבדת המחברים; הטקסט המקורי המלא לא היה נגיש. נראו תקציר מופץ של המאמר המדויק ותקציר מאמר נפרד ב-JRSJ משנת 2012, והם לא שימשו תחליף למקור.

**ממצא:** זהו קו מחקר מבוסס של כפפות חישה בצפיפות גבוהה. נתוני הביצועים של המאמר המקורי אינם מאומתים באופן עצמאי ברשומה זו.

**מגבלה:** מאגרים ביבליוגרפיים מאחדים את מאמר הכנס מ-2011 ואת המאמר בכתב העת היפני מ-2012. אין להתייחס לתוצאותיהם בשתיקה כאילו נלקחו מאותו מסמך.

**פעולה בתוכנית:** ליישום הזרועות והרגליים שלנו, להעריך שינוי בטווח תנועה, משיכת כבלים והיסטי לחץ כאשר הכיסוי מותקן. גאומטריית עץ וענפים היא מועמדת שימושית, אך מחייבת בדיקת עייפות של הלמינציה המלאה.

**השלכה על החדשנות:** חישה צפופה המתאימה לצורת המשטח וניתוב המתחשב בתנועת מפרקים הם ידע קודם, ולא טענה רעיונית חדשה.

**הערה ביבליוגרפית או על הגישה:** DOI 10.1109/Humanoids.2011.6100898. מאמר ראשוני קשור מ-2012: https://www.jstage.jst.go.jp/article/jrsj/30/7/30_30_711/_article/-char/en (DOI 10.7210/jrsj.30.711).

### [33] Development and applications of high-density tactile sensing glove

T. Sagisaka, Y. Ohmura, A. Nagakubo, K. Ozaki and Y. Kuniyoshi, EuroHaptics 2012, LNCS 7282, 445–456. [מקור ראשוני או רשומת זיהוי](https://link.springer.com/chapter/10.1007/978-3-642-31401-8_40)

**רמת ראיות:** primary_abstract

**היקף הקריאה:** תקציר המוציא לאור והרשומה הביבליוגרפית; הפרק המוגבל למנויים לא נקרא במלואו.

**ממצא:** התקציר מתאר 1, 052 אתרי לחץ בכל יד, באמצעות רכיבים בגודל 1 mm על FPC, וניסויים בבני אדם הקושרים את התפלגות הלחץ לכיוון הכוח החיצוני ולהתנהגות חקירה.

**מגבלה:** מתאם בכפפה שנלבשת בידי אדם אינו מבסס מדידת כוח גזירה מכוילת ברובוט, עמידות לעייפות בכל הגוף או ייצור זול.

**פעולה בתוכנית:** לא לכלול טענות למיומנות אנושית בהוכחת ההיתכנות של לוח הגפה. בהשוואת צפיפות יש לציין בנפרד שטח פעיל, גודל רכיב החישה ופסיעה, תוך הכללת המסה המותקנת והחיבוריות.

**השלכה על החדשנות:** אלפי ערוצי מישוש עם ניתוב גמיש כבר הודגמו בציוד חישה לאדם.

**הערה ביבליוגרפית או על הגישה:** DOI 10.1007/978-3-642-31401-8_40. זהו פרסום שונה מ-[32].

### [34] Tactile object class and internal state recognition for mobile manipulation

S. Chitta, M. Piccoli and J. Sturm, ICRA 2010, 2342–2348. [מקור ראשוני או רשומת זיהוי](https://jsturm.de/publications/data/chitta10icra.pdf)

**רמת ראיות:** primary_indexed_excerpt

**היקף הקריאה:** קטעי שיטות ותוצאות מאונדקסים מתוך ה-PDF המקורי של הכנס, המאוחסן באתר מחבר, ובפרט טבלאות II–IV. השליפה הישירה של ה-PDF חרגה מזמן ההמתנה; הגרסה המאוחרת בכתב עת נשמרה כמקור נפרד.

**ממצא:** בגישוש בכוח 20 N, דיוק סיווג סוג המכל המדווח הוא 93.9%, בעוד שדיוק זיהוי המצב הפנימי משתנה מאוד לפי המכל — 32.5% בבקבוקי מים. גישוש חזק יותר משפר תוצאה של מכל מסוים, וממחיש תלות במשימה ובגירוי.

**מגבלה:** אי אפשר להעביר נתון זיהוי כולל בין סוגי עצמים או כוחות מגע; כוחות גישוש גבוהים עלולים להזיק לעצמים. אלה תצפיות מבוקרות במלקחיים, ולא אינטליגנציה כללית של עור גפה.

**פעולה בתוכנית:** לכל מסווג יש לפרסם מטריצות בלבול לפי מחלקה ולהפריד עצמים ומפגשי בדיקה מנתוני האימון. להשאיר בדיקות כוח חקירה פעיל מחוץ למוצר הבסיס של מגע יחסי, אלא אם כוח המפעיל נמדד באופן עצמאי.

**השלכה על החדשנות:** סיווג עצמים ומצבם באמצעות מישוש הוא ידע קודם; כל יתרון נטען מחייב מבחן משימה תואם.

**הערה ביבליוגרפית או על הגישה:** DOI 10.1109/ROBOT.2010.5509923. אין להחליף מאמר כנס זה בהרחבה לכתב עת chitta 10 tro.pdf.

### [36] A simple tactile sensing foot for humanoid robot and active ground slope recognition

K. Suwanratchatamanee, M. Matsumoto and S. Hashimoto, IEEE International Conference on Mechatronics, 2009, 1–6. [מקור ראשוני או רשומת זיהוי](https://doi.org/10.1109/ICMECH.2009.4957223)

**רמת ראיות:** primary_abstract

**היקף הקריאה:** תקציר המוציא לאור וקטע מהמבוא, ולא ההערכה המלאה של החיישן והבקרה.

**ממצא:** העבודה משתמשת במספר קטן של נגדים דקים הרגישים לכוח ובאינטראקציה פעילה של כף הרגל לסיווג שיפוע הקרקע, במקום לדרוש תמונה צפופה של כל כף הרגל.

**מגבלה:** הדגמת זיהוי שיפוע באמצעות כף רגל אינה מאמתת חישת לחץ בזרוע וברגל או יציבות שיווי משקל. מסלולי העומס וגאומטריית המגע שלה שונים מעור המותקן על מעטפת.

**פעולה בתוכנית:** להשאיר את כפות הרגליים כתת־מערכת נפרדת. לפני בחירת מספר החיישנים, לקבוע אם משימה עתידית דורשת נוכחות מגע, מרכז לחץ, שיפוע או התפלגות לחץ מפורטת.

**השלכה על החדשנות:** חישה דלילה מותאמת למשימה והסקה הפטית פעילה הן שיטות מבוססות.

**הערה ביבליוגרפית או על הגישה:** DOI 10.1109/ICMECH.2009.4957223.

### [37] Design and experiment of the NAO humanoid robot’s plantar tactile sensor for surface classification

Q. Yuan and J. Wang, ICISCE 2017, 931–935. [מקור ראשוני או רשומת זיהוי](https://www.researchgate.net/publication/321122717_Design_and_Experiment_of_the_NAO_Humanoid_Robot%27s_Plantar_Tactile_Sensor_for_Surface_Classification)

**רמת ראיות:** primary_full_text_selected

**היקף הקריאה:** המקור שהעלה מחבר: תקציר, סעיפים III–V עד הגדרת המסווג, תרשימים וכיתובים. טבלת התוצאות הסופית והמסקנה לא נקראו באופן ממצה.

**ממצא:** מערך התנגדותי 10×16 משתמש ברכישה של 400 דגימות לשנייה, אך המחברים מציינים במפורש 0.4 s לתמונה מלאה; תת־מערך של 20 אתרים תומך במעקב מהיר יותר. הסיווג מאגד כמה צעדי הליכה.

**מגבלה:** הנתון בטקסט של 360 מערכי נתונים בסך הכול אינו מתיישב חשבונית עם 224 לאימון ועוד 36 לבדיקה. נתון הדיוק הבולט אינו תגובה מיידית או הוכחת הכללה בין רובוטים. התרשים שנבדק אינו מבסס ביטול של זרמי מעקף במטריצה.

**פעולה בתוכנית:** לפרסם בנפרד קצב ADC, קצב לכל אתר חישה, קצב מסגרת מלאה, פערי סריקה והשהיית תגובה. אין להשתמש ב-400 Hz כמבחן ייחוס למערך המלא. לשמר איי חישה עצמאיים, אלא אם זליגה חשמלית בין מגעים בו־זמניים נחסמה בניסוי.

**השלכה על החדשנות:** עור התנגדותי זול בשילוב סיווג פשוט הוא ידע קודם.

**הערה ביבליוגרפית או על הגישה:** DOI 10.1109/ICISCE.2017.197. מעלה הקובץ הוא השותף לכתיבה Jianxiao Wang; לא נוצר עמו קשר.

### [38] An adaptive sensor foot for a bipedal and quadrupedal robot

K. Fondahl et al., BioRob 2012; Cheng lists 270–275. [מקור ראשוני או רשומת זיהוי](https://www.dfki.de/web/forschung/projekte-publikationen/publikation/6214)

**רמת ראיות:** primary_abstract

**היקף הקריאה:** תקציר ומטא־נתונים של הפרסום המוסדי ב-DFKI. המאמר המקורי לא נקרא.

**ממצא:** העבודה עוסקת במנגנון כף רגל מסתגל ובשילוב חיישנים בו עבור פלטפורמות שונות בעלות רגליים, ולא רק בהדבקת סרט חישה על כף רגל ללא שינוי.

**מגבלה:** התקציר אינו מספיק לשחזור המכניקה, הבקרה או הכשרת העומס. מספור העמודים בדף המוסדי סותר את הביבליוגרפיה של Cheng.

**פעולה בתוכנית:** אין לצרף כפות רגליים לרשימת החומרים של לוחות הגפיים. גרסת כף רגל דורשת דרישות נפרדות למכניקת מגע, שחיקה, עומס יתר, מים ואדמה, וממשק הליכה.

**השלכה על החדשנות:** כפות רגליים מסתגלות עם חיישנים הן קטגוריית מוצר ובעיה נפרדת ומבוססת.

**הערה ביבליוגרפית או על הגישה:** DFKI מציג 2780–2786, בעוד Cheng וציטוטים אחרים מציגים 270–275. יש לסמן את הפער ולא לבחור בשתיקה מטא־נתונים שלא אומתו.

### [39] A ZMP sensor for a biped robot

M. Shimojo, T. Araki, A. Ming and M. Ishikawa, ICRA 2006, 1200–1205. [מקור ראשוני או רשומת זיהוי](https://researchmap.jp/read0072509/published_papers/15818833/attachment_file.pdf)

**רמת ראיות:** primary_indexed_excerpt

**היקף הקריאה:** תקציר מאונדקס מהעמוד הראשון, המאוחסן באתר מחבר. השליפה הישירה של ה-PDF החזירה 403; הגזירה והניסויים המלאים לא נקראו.

**ממצא:** התקציר מדווח על ארבעה חוטים, תגובה בתוך 1 ms, מסה ליחידת שטח של 0.2 g/cm², ומדידה בו־זמנית של עומס כולל ושל מיקום מרכז העומס.

**מגבלה:** אלה פלטים מאוגדים ודחוסים, ולא מיקומי מגע עצמאיים. 0.2 g/cm² שווה ל-2 kg/m²; יש להשוות את התיאור ״קל משקל״ באמצעות יחידות עקביות. לא מאומצת כאן טענה לשקילות כללית לנקודת מומנט אפס דינמית.

**פעולה בתוכנית:** לבדוק יכולת הבחנה לפני החלפת מערכים: שני מגעים שווים ומרוחקים ומגע מרכזי אחד יכולים להניב אותו מרכז כובד. דרישת ריבוי המגעים שלנו מחייבת אתרים עצמאיים או שיטת שחזור אחרת שהודגמה.

**השלכה על החדשנות:** צמצום קיצוני של חוטים באמצעות איגום מרחבי אנלוגי הוא ידע קודם; הוא בא על חשבון מידע.

**הערה ביבליוגרפית או על הגישה:** DOI 10.1109/ROBOT.2006.1641872.

### [40] High-speed pressure sensor grid for humanoid robot foot

Y. Takahashi, K. Nishiwaki, S. Kagami, H. Mizoguchi and H. Inoue, IROS 2005, 3909–3914. [מקור ראשוני או רשומת זיהוי](https://tus.elsevierpure.com/en/publications/high-speed-pressure-sensor-grid-for-humanoid-robot-foot/)

**רמת ראיות:** primary_abstract

**היקף הקריאה:** תקציר ממוסד המחברים ורשומה ביבליוגרפית. המאמר המקורי בן ששת העמודים לא היה נגיש.

**ממצא:** התקציר מדווח על מטריצה 32×32, דגימה ב-1 kHz, המרה של 14 סיביות וגומי רגיש לכוח בעובי 0.6 mm. הוא מזהה במפורש הפרעה מזרמי מעקף ושיטה לצמצומה.

**מגבלה:** התקציר אינו יכול לספק את מעגל הצמצום המדויק או להדגים עצמאות, דיוק או עמידות לעייפות בלמינציה שלנו. רזולוציית ADC אינה דיוק מכני של כוח.

**פעולה בתוכנית:** אין לשווק את לוחות הגוף שלנו, הפועלים ב-100 Hz, כשקולים לחישת סוליה מהירה. כל מטריצה התנגדותית משותפת וזולה יותר חייבת לעבור בדיקה של כמה מגעים הכוללת זליגה בשורות שלא נבחרו, ולא רק לחיצות בודדות מבודדות.

**השלכה על החדשנות:** מערכי מישוש התנגדותיים צפופים ודקים ופתרונות לזליגה בזמן סריקה הם מחקר מבוסס היטב.

**הערה ביבליוגרפית או על הגישה:** DOI 10.1109/IROS.2005.1545126.

</div>
