oznav2/tectile_skin/hardware/02_PCB/03_RBE-MAIN-RK3588S/01_BOM_MAIN_2026-09-18.xlsx

No. | Quantity | Comment | Designator | Footprint | Value | Manufacturer Part | Manufacturer | Supplier Part | Supplier | Pin Count | Name | Symbol | Unique ID | Datasheet
1 | 110 | 100nF | C1,C2,C3,C4,C6,C7,C8,C9,C11,C12,C20,C21,C25,C43,C56,C60,C61,C62,C63,C64,C72,C74,C75,C78,C79,C80,C81,C82,C83,C84,C85,C86,C87,C88,C92,C93,C94,C95,C96,C97,C98,C101,C105,C107,C118,C120,C127,C131,C132,C134,C135,C136,C137,C140,C143,C144,C145,C146,C147,C150,C162,C166,C167,C168,C169,C170,C171,C172,C173,C174,C175,C177,C178,C179,C180,C181,C182,C183,C184,C185,C186,C187,C200,C201,C203,C205,C307,C310,C311,C314,C316,C319,C321,C336,C338,C342,C368,C371,C378,C394,C404,C405,C406,C408,C410,C413,C414,C430,C437,C438 | C0402 | 100nF | CC0402KRX7R9BB104 | YAGEO | C131394 | LCSC | 2 | 100nF |  | gge188_2,gge188_19,gge188_20,gge188_21,gge188_22,gge188_23,gge188_24,gge188_25,gge188_26,gge188_29,gge188_30,gge188_31,gge188_32,gge188_34,gge188_41,gge188_48,gge188_51,gge188_61,gge188_62,gge188_63,gge204_2,gge237,gge237_1,gge237_4,gge237_7,gge237_8,gge237_9,gge238,gge239,gge239_1,gge239_2,gge239_3,gge239_4,gge239_5,gge239_6,gge239_7,gge239_8,gge239_9,gge445,gge447,gge557_4,gge644_3,gge646_0,gge658_1,gge658_2,gge667_1,gge668_1,gge715_9,gge715_10,gge715_11,gge715_12,gge715_13,gge715_14,gge715_15,gge715_16,gge715_17,gge715_18,gge715_19,gge715_20,gge715_21,gge715_22,gge715_23,gge715_24,gge715_25,gge715_26,gge715_27,gge715_28,gge715_44,gge715_45,gge715_46,gge715_47,gge715_48,gge715_53,gge715_54,gge715_55,gge715_56,gge715_57,gge715_58,gge715_59,gge715_60,gge715_61,gge715_62,gge715_63,gge715_67,gge715_68,gge715_69,gge715_70,gge715_72,gge715_77,gge715_78,gge1034_0,gge1080,gge1081,gge1081_0,gge1086,gge1086_0,gge1086_1,gge1086_2,gge1086_3,gge1086_4,gge1086_12,gge1152,gge1152_0,gge1152_1,gge1152_2,gge1152_4,gge1152_5,gge1152_6,gge1156,gge2010 | https://atta.szlcsc.com/upload/public/pdf/source/20181008/C309510_22F155564471FAF6A489F7D68F34234E.pdf
2 | 2 | 1nF | C5,C10 | C1206 | 1nF | CC1206KKX7RDBB102 | YAGEO | C23631 | LCSC | 2 | 1nF |  | gge1378_0,gge1378_1 | https://item.szlcsc.com/datasheet/CC1206KKX7RDBB102/24367.html
3 | 10 | 10uF | C13,C32,C317,C318,C364,C365,C372,C403,C407,C421 | C0603 | 10uF | 0603X106K160NT | FH | C70225 | LCSC | 2 | 10uF |  | gge1672,gge1725,gge1752,gge1752_0,gge1753,gge1826,gge1827,gge1827_0,gge1909,gge1909_0 | https://item.szlcsc.com/datasheet/0603X106K160NT/71320.html
4 | 1 | 10uF | C22 | C0603 | 10uF | HGC0603R5106M350NTHJ | Chinocera | C22367827 | LCSC | 2 | 10uF |  | gge2038 | https://item.szlcsc.com/datasheet/HGC0603R5106M350NTHJ/23841132.html
5 | 1 | 1uF | C23 | C0805 | 1uF | CC0805KKX7R0BB105 | YAGEO | C5370002 | LCSC | 2 | 1uF |  | gge2041 | https://item.szlcsc.com/datasheet/CC0805KKX7R0BB105/6213252.html
6 | 15 | 100nF | C26,C30,C35,C39,C44,C55,C69,C151,C152,C155,C156,C412,C423,C424,C427 | C0603 | 100nF | TCC0603X7R104K101CT | CCTC | C696916 | LCSC | 2 | 100nF |  | gge1706,gge1706_0,gge1712,gge1718,gge1724,gge1731,gge1735,gge1739,gge1803,gge1803_0,gge1811,gge1811_0,gge1812,gge1812_0,gge1878 | https://item.szlcsc.com/datasheet/TCC0603X7R104K101CT/731000.html
7 | 8 | 4.7nF | C27,C31,C36,C40,C45,C47,C68,C392 | C0402 | 4.7nF | 0402B472K500NT | FH | C1538 | LCSC | 2 | 4.7nF |  | gge1681,gge1703,gge1709,gge1715,gge1721,gge1728,gge1734,gge1738 | https://item.szlcsc.com/datasheet/0402B472K500NT/1890.html
8 | 14 | 4.7pF | C28,C29,C33,C34,C37,C38,C41,C42,C46,C57,C66,C67,C99,C100 | C0402 | 4.7pF | 0402CG4R7C500NT | FH | C1569 | LCSC | 2 | 4.7pF |  | gge1704,gge1705,gge1710,gge1711,gge1716,gge1717,gge1722,gge1722_0,gge1723,gge1723_0,gge1729,gge1729_0,gge1730,gge1730_0 | https://item.szlcsc.com/datasheet/0402CG4R7C500NT/1921.html
9 | 2 | 18pF | C58,C59 | C0402 | 18pF | CC0402JRNPO9BN180 | YAGEO | C106202 | LCSC | 2 | 18pF |  | gge188_36,gge188_37 | https://item.szlcsc.com/datasheet/CC0402JRNPO9BN180/107417.html
10 | 13 | 22uF | C65,C104,C141,C308,C309,C320,C340,C341,C409,C415,C416,C417,C436 | C0603 | 22uF | GRM188R61A226ME15D | muRata | C84419 | LCSC | 2 | 22uF |  | gge96_2,gge592,gge664_1,gge664_2,gge665_2,gge1554_2,gge1554_3,gge1554_7,gge1554_8,gge1554_9,gge1554_10,gge1554_11,gge1554_12 | https://item.szlcsc.com/datasheet/GRM188R61A226ME15D/85589.html
11 | 5 | 5.6pF_NC | C70,C89,C91,C116,C117 | C0402 | 5.6pF_NC | 0402CG5R6C100NT | FH |  | LCSC | 2 | 5.6pF_NC |  | gge1770,gge1771,gge1772,gge1773,gge1774 | https://item.szlcsc.com/datasheet/0402CG5R6C100NT/270466.html
12 | 5 | 4.7uF | C71,C73,C76,C77,C108 | C0402 | 4.7uF | GRM155R61A475KEAAD | muRata | C77004 | LCSC | 2 | 4.7uF |  | gge188_33,gge188_40,gge188_59,gge188_60,gge449 | https://item.szlcsc.com/datasheet/GRM155R61A475KEAAD/78131.html
13 | 7 | 10uF | C90,C113,C122,C124,C138,C149,C305 | C0402 | 10uF | GRM155R61A106ME11D | muRata | C408132 | LCSC | 2 | 10uF |  | gge241,gge241_0,gge608,gge644_6,gge644_7,gge657_1,gge657_2 | https://atta.szlcsc.com/upload/public/pdf/source/20200305/C490387_23319AE8C154DEB24C505E6C82A8106A.pdf
14 | 2 | NC | C102,C103 | C0402 | NC | CC0402KRX7R9BB104 | YAGEO |  | LCSC | 2 | NC |  | gge439,gge440 | https://atta.szlcsc.com/upload/public/pdf/source/20181008/C309510_22F155564471FAF6A489F7D68F34234E.pdf
15 | 1 | 4.7uF | C106 | C0402 | 4.7uF | HGC0402R5475K100NTEJ | Chinocera | C7472956 | LCSC | 2 | 4.7uF |  | gge2017 | https://item.szlcsc.com/datasheet/HGC0402R5475K100NTEJ/8532803.html
16 | 2 | 7.5pF | C109,C110 | C0402 | 7.5pF | CC0402CRNPO9BN7R5 | YAGEO | C505479 | LCSC | 2 | 7.5pF |  | gge1987,gge1988 | https://item.szlcsc.com/datasheet/CC0402CRNPO9BN7R5/518690.html
17 | 2 | 9pF | C111,C112 | C0402 | 9pF | 0402CG9R0C500NT | FH | C1580 | LCSC | 2 | 9pF |  | gge1972,gge1973 | https://item.szlcsc.com/datasheet/0402CG9R0C500NT/1932.html
18 | 4 | 12pF | C114,C115,C163,C164 | C0402 | 12pF | CC0402JRNPO9BN120 | YAGEO | C106201 | LCSC | 2 | 12pF |  | gge693_1,gge694_1,gge1339,gge1340 | https://item.szlcsc.com/datasheet/CC0402JRNPO9BN120/107416.html
19 | 8 | 2.2uF | C119,C123,C126,C128,C129,C130,C133,C176 | C0402 | 2.2uF | CC0402KRX5R6BB225 | YAGEO | C326606 | LCSC | 2 | 2.2uF |  | gge635_3,gge635_7,gge635_8,gge635_9,gge635_10,gge635_11,gge635_12,gge645_0 | https://atta.szlcsc.com/upload/public/pdf/source/20181031/C326606_B801EDDCFBA8B15C0DF0980A1CD00BE3.pdf
20 | 2 | 1uF | C121,C125 | C0402 | 1uF | 0402X105K250NT | FH | C967571 | LCSC | 2 | 1uF |  | gge1780,gge1782 | https://item.szlcsc.com/datasheet/0402X105K250NT/1054203.html
21 | 5 | 220pF | C139,C306,C339,C439,C440 | C0402 | 220pF | 0402B221K500NT | FH | C1530 | LCSC | 2 | 220pF |  | gge1785,gge1790,gge1897,gge2023,gge2025 | https://item.szlcsc.com/datasheet/0402B221K500NT/1882.html
22 | 2 | 1uF | C153,C425 | C0805 | 1uF | 0805B105K101NT | FH | C5445369 | LCSC | 2 | 1uF |  | gge1805,gge1805_0 | https://item.szlcsc.com/datasheet/0805B105K101NT/6340629.html
23 | 1 | 150uF_NC | C159 | CAP-TH_BD8.0-P3.50-D0.5-FD | 150uF_NC | NPXD0901H151MJTM | Ymin |  | LCSC | 2 | 150uF_NC |  | gge1985 | https://item.szlcsc.com/datasheet/NPXD0901H151MJTM/21878190.html
24 | 5 | 10uF | C199,C206,C207,C208,C209 | C0402 | 10uF | HGC0402R5106M100NTEJ | Chinocera | C7472949 | LCSC | 2 | 10uF |  | gge2043,gge2044,gge2045,gge2046,gge2047 | https://atta.szlcsc.com/upload/public/pdf/source/20240320/FAC3FEC40A78BC5CCCE96C232A94D860.pdf
25 | 1 | 2pF | C202 | C0402 | 2pF | GJM1555C1H2R0BB01D | muRata | C161316 | LCSC | 2 | 2pF |  | gge1153 | https://item.szlcsc.com/datasheet/GJM1555C1H2R0BB01D/172697.html
26 | 1 | 5.6pF | C204 | C0402 | 5.6pF | GJM1555C1H5R6BB01D | muRata | C161329 | LCSC | 2 | 5.6pF |  | gge1154 | https://item.szlcsc.com/datasheet/GJM1555C1H5R6BB01D/172710.html
27 | 1 | 100uF | C315 | C0805 | 100uF | HGC0805R5107M6R3NSLJ | Chinocera | C49333236 | LCSC | 2 | 100uF |  | gge2021 | https://item.szlcsc.com/datasheet/HGC0805R5107M6R3NSLJ/51817927.html
28 | 1 | 22uF | C337 | C0603 | 22uF | HGC0603R5226M160NTHJ | Chinocera | C22367828 | LCSC | 2 | 22uF |  | gge1935 | https://item.szlcsc.com/datasheet/HGC0603R5226M160NTHJ/23841133.html
29 | 1 | 10uF | C357 | C1210 | 10uF | GRM32EC72A106KE05L | muRata | C576517 | LCSC | 2 | 10uF |  | gge1512_3 | https://item.szlcsc.com/datasheet/GRM32EC72A106KE05L/604008.html
30 | 2 | 680uF_NC | C359,C360 | CAP-TH_BD16.0-P7.50-D0.8-FD-H35.0 | 680uF_NC | ERA100V680M16X35 | JIERR |  | LCSC | 2 | 680uF_NC |  | gge1747,gge1748 | https://item.szlcsc.com/datasheet/ERA100V680M16X35/54596805.html
31 | 5 | 10uF | C361,C362,C363,C366,C369 | C1210 | 10uF | TCC1210X5R106K101MT | CCTC | C51892808 | LCSC | 2 | 10uF |  | gge1921,gge1922,gge1923,gge1924,gge1925 | https://item.szlcsc.com/datasheet/TCC1210X5R106K101MT/54576285.html
32 | 2 | 100nF | C374,C375 | C0201 | 100nF | 0201X104K250NT | FH | C5445371 | LCSC | 2 | 100nF |  | gge1917,gge1918 | https://item.szlcsc.com/datasheet/0201X104K250NT/6340631.html
33 | 3 | 47uF | C379,C431,C432 | C0805 | 47uF | HGC0805R5476M100NSLJ | Chinocera | C19103846 | LCSC | 2 | 47uF |  | gge1670,gge1670_0,gge1670_1 | https://item.szlcsc.com/datasheet/HGC0805R5476M100NSLJ/20314358.html
34 | 1 | 10pF | C391 | C0402 | 10pF | 0402CG100J500NT | FH | C1545 | LCSC | 2 | 10pF |  | gge1778 | https://item.szlcsc.com/datasheet/0402CG100J500NT/1897.html
35 | 2 | 18pF | C401,C402 | C0402 | 18pF | 0402CG180J500NT | FH | C1549 | LCSC | 2 | 18pF |  | gge1938,gge1939 | https://item.szlcsc.com/datasheet/0402CG180J500NT/1901.html
36 | 2 | 10uF | C411,C422 | C1210 | 10uF | FS32X106K101EGG | PSA | C5156756 | LCSC | 2 | 10uF |  | gge1964,gge1965 | https://item.szlcsc.com/datasheet/FS32X106K101EGG/5791227.html
37 | 1 | 100pF | C418 | C0402 | 100pF | 0402B101K500NT | FH | C2991538 | LCSC | 2 | 100pF |  | gge1934_0 | https://item.szlcsc.com/datasheet/0402B101K500NT/3454105.html
38 | 1 | 470pF | C419 | C0805 | 470pF | FCC0805B471K500DT | FOJAN | C5137598 | LCSC | 2 | 470pF |  | gge1980 | https://item.szlcsc.com/datasheet/FCC0805B471K500DT/5747050.html
39 | 1 | 1uF | C420 | C0805 | 1uF | CGA0805X7R105K101MT | HRE | C6119928 | LCSC | 2 | 1uF |  | gge1955 | https://item.szlcsc.com/datasheet/CGA0805X7R105K101MT/7062634.html
40 | 1 | 10uF | C426 | C0805 | 10uF | HGC0805R5106K500NSLJ | Chinocera | C22367830 | LCSC | 2 | 10uF |  | gge1999_0 | https://item.szlcsc.com/datasheet/HGC0805R5106K500NSLJ/23841135.html
41 | 2 | 22uF | C428,C429 | C0603 | 22uF | HGC0603R5226M100NTHJ | Chinocera | C7432770 | LCSC | 2 | 22uF |  | gge1989,gge1990 | https://item.szlcsc.com/datasheet/HGC0603R5226M100NTHJ/8438252.html
42 | 1 | 100uF_NC | C434 | CAP-TH_BD10.0-P5.00-D0.6-FD_2 | 100uF_NC | PA100V100M10x12 | JIERR |  | LCSC | 2 | 100uF_NC |  | gge1992 | https://item.szlcsc.com/datasheet/PA100V100M10x12/48680146.html
43 | 1 | KH-A1251WF-02A | CN1 | CONN-SMD_KH-A1251WF-02A |  | KH-A1251WF-02A | kinghelm | C2688769 | LCSC | 4 | KH-A1251WF-02A |  | gge613 | https://atta.szlcsc.com/upload/public/pdf/source/20210202/C2688769_0581F19AF012987BF76D2DE0C39F3F83.pdf
44 | 1 | PA-2AWB | CN2 | CONN-SMD_PA-2AWB |  | PA-2AWB | DLL | C22377969 | LCSC | 4 | PA-2AWB |  | gge1963 | https://item.szlcsc.com/datasheet/PA-2AWB/23898122.html
45 | 1 | XT30PW-M30.G.Y_NC | CN3 | CONN-TH_XT30PW-M |  | XT30PW-M30.G.Y_NC | AMASS | C431092 | LCSC | 4 | XT30PW-M30.G.Y_NC |  | gge1967 | https://item.szlcsc.com/datasheet/XT30PW-M30.G.Y/426930.html
46 | 3 | X1251WRS-03HF-LPSW | CN4,CN7,CN9 | CONN-SMD_3P-P1.25_X1251WRS-03HF-LPSW |  | X1251WRS-03HF-LPSW | XKB Connection | C388708 | LCSC | 5 | X1251WRS-03HF-LPSW |  | gge2014,gge2014_0,gge2014_1 | https://item.szlcsc.com/datasheet/X1251WRS-03HF-LPSW/363978.html
47 | 2 | A1257WV-S-7P | CN5,J5 | CONN-SMD_A1257WV-S-7P |  | A1257WV-S-7P | CJT | C225123 | LCSC | 9 | A1257WV-S-7P |  | gge1911,gge2003 | https://item.szlcsc.com/datasheet/A1257WV-S-7P/225406.html
48 | 1 | GT-F0512SR18-10S0101 | CN6 | FPC-SMD_10P-P0.50_GT-F0512SR18-10S0101 |  | GT-F0512SR18-10S0101 | G-Switch | C21882308 | LCSC | 12 | GT-F0512SR18-10S0101 |  | gge1916 | https://item.szlcsc.com/datasheet/GT-F0512SR18-10S0101/23309874.html
49 | 1 | XT60PW-M | CN8 | CONN-TH_XT60PW-M |  | XT60PW-M | AMASS | C98732 | LCSC | 4 | XT60PW-M |  | gge1660 | https://item.szlcsc.com/datasheet/XT60PW-M/99942.html
50 | 4 | SMTSOM2.515BTR | CN10,CN11,CN12,CN13 | SMD_BD5.6-D4.1 |  | SMTSOM2.515BTR | YIYUAN | C5221850 | LCSC | 2 | SMTSOM2.515BTR |  | gge2037,gge2037_0,gge2037_1,gge2037_2 | https://item.szlcsc.com/datasheet/SMTSOM2.515BTR/5921830.html
51 | 1 | PSM712-ES | D1 | SOT-23-3_L2.9-W1.3-P1.90-LS2.4-BR |  | PSM712-ES | ElecSuper | C5180294 | LCSC | 3 | PSM712-ES |  | gge1682 | https://item.szlcsc.com/datasheet/PSM712-ES/5837632.html
52 | 7 | PESD1CAN | D2,D3,D4,D5,D6,D9,D12 | SOT-23-3_L2.9-W1.6-P1.90-LS2.8-BR |  | PESD1CAN | BORN | C343993 | LCSC | 3 | PESD1CAN |  | gge152_2,gge152_3,gge152_4,gge152_5,gge152_6,gge152_7,gge152_8 | https://atta.szlcsc.com/upload/public/pdf/source/20181211/C343993_AF595724ADB82F42A1C256C97FD7AD6B.pdf
53 | 15 | LESD8D5.0CB1T5G | D7,D10,D11,D13,D14,D15,D16,D17,D18,D19,D20,D21,D30,D31,D38 | SOD-882_L1.0-W0.6-BI |  | LESD8D5.0CB1T5G | LRC | C2936709 | LCSC | 2 | LESD8D5.0CB1T5G |  | gge1692,gge1692_0,gge1693,gge1694,gge1695,gge1696,gge1697,gge1698,gge1699,gge1901,gge1902,gge1903,gge1904,gge1912,gge1913 | https://item.szlcsc.com/datasheet/LESD8D5.0CB1T5G/3289291.html
54 | 1 | 5.0SMDJ64CA-FL | D8 | SMC_L6.9-W5.9-LS7.9-BI |  | 5.0SMDJ64CA-FL | Wuxi Maxinmicro | C54410886 | LCSC | 2 | 5.0SMDJ64CA-FL |  | gge2015 | https://item.szlcsc.com/datasheet/8.0SMDJ64CA%252FT7/23930746.html
55 | 2 | ESD5304D-10/TR | D22,D23 | UDFN-10_L2.5-W1.0-P0.50-BL |  | ESD5304D-10/TR | WILLSEMI | C153722 | LCSC | 10 | ESD5304D-10/TR |  | gge1914,gge1915 | https://item.szlcsc.com/datasheet/ESD5304D-10%252FTR/165064.html
56 | 1 | SMAJ6.0CA | D24 | SMA_L4.3-W2.6-LS5.0-BI |  | SMAJ6.0CA | R+O | C19077526 | LCSC | 2 | SMAJ6.0CA |  | gge2036 | https://item.szlcsc.com/datasheet/SMAJ6.0CA/20275611.html
57 | 1 | 3.0SMBJ43CA | D25 | SMB_L4.4-W3.6-LS5.4-BI |  | 3.0SMBJ43CA | BORN | C54741057 | LCSC | 2 | 3.0SMBJ43CA |  | gge2026 | https://item.szlcsc.com/datasheet/3.0SMBJ43CA/58152478.html
58 | 1 | MMSZ5266B | D26 | SOD-123_L2.7-W1.6-LS3.7-RD-1 |  | MMSZ5266B | MSKSEMI | C5331081 | LCSC | 2 | MMSZ5266B |  | gge1808 | https://item.szlcsc.com/datasheet/MMSZ5266B/6090352.html
59 | 1 | SS510F | D32 | SMAF_L3.5-W2.6-LS4.7-RD |  | SS510F | R+O | C41411774 | LCSC | 2 | SS510F |  | gge1949 | https://item.szlcsc.com/datasheet/SS510F/43223717.html
60 | 2 | 1N4148WT | D34,D36 | SOD-523_L1.2-W0.8-LS1.6-RD |  | 1N4148WT | JSMSEMI | C917006 | LCSC | 2 | 1N4148WT |  | gge1969,gge1969_0 | https://item.szlcsc.com/datasheet/1N4148WT/991502.html
61 | 1 | MMSZ5259BT1G | D35 | SOD-123_L2.8-W1.8-LS3.7-RD |  | MMSZ5259BT1G | onsemi | C235987 | LCSC | 2 | MMSZ5259BT1G |  | gge1984 | https://item.szlcsc.com/datasheet/MMSZ5259BT1G/235603.html
62 | 1 | SMF6.0CA | D37 | SOD-123FL_L2.7-W1.8-LS3.8-BI |  | SMF6.0CA | R+O | C19077500 | LCSC | 2 | SMF6.0CA |  | gge2000 | https://item.szlcsc.com/datasheet/SMF6.0CA/20275585.html
63 | 2 | 1SMA5928A | D39,D40 | SMA_L4.3-W2.6-LS5.0-RD |  | 1SMA5928A | R+O | C19077490 | LCSC | 2 | 1SMA5928A |  | gge2022,gge2024 | https://item.szlcsc.com/datasheet/1SMA5928A/20275575.html
64 | 2 | KW30-8S-1H(800) | J1,J2 | KW30-8S-1H(800) |  |  |  |  |  | 10 |  |  | gge1665_3,gge1665_4
65 | 1 | A1257WV-S-3P | J12 | CONN-SMD_A1257WV-S-3P |  | A1257WV-S-3P | CJT | C225119 | LCSC | 5 | A1257WV-S-3P |  | gge2008 | https://item.szlcsc.com/datasheet/A1257WV-S-3P/225402.html
66 | 1 | HC-GH-2PLT | J13 | CONN-SMD_2P-P1.25_HCTL_HC-GH-2PLT |  | HC-GH-2PLT | HCTL | C3011953 | LCSC | 4 | HC-GH-2PLT |  | gge1910 | https://item.szlcsc.com/datasheet/HC-GH-2PLT/3516474.html
67 | 2 | GH-2AB | J14,J15 | CONN-SMD_2P-P1.25_GH-2AB |  | GH-2AB | DLL | C20617458 | LCSC | 4 | GH-2AB |  | gge1684,gge1685 | https://item.szlcsc.com/datasheet/GH-2AB/21991247.html
68 | 2 | SMTSOM225BTR | J16,J17 | SMD_BD5.6-D3.6 |  | SMTSOM225BTR | YIYUAN | C5301773 | LCSC | 4 | SMTSOM225BTR |  | gge1919,gge1920 | https://item.szlcsc.com/datasheet/SMTSOM225BTR/6053327.html
69 | 3 | df40c-100ds-0 | JP1,JP2,JP3 | CONN-SMD_DF40C-100DS-0.4V-51 מותאם |  |  |  |  |  | 100 |  |  | gge1001,gge1002,gge1003
70 | 2 | 350uH | L1,L3 | XFMR-SMD_24P-L16.5-W9.1-P1.27-LS9.7-BL | 350uH | HX5120NLTP-CND | CND-tek | C47575008 | LCSC | 24 | 350uH |  | gge1373_0,gge1373_1 | https://item.szlcsc.com/datasheet/HX5120NLTP-CND/49805152.html
71 | 3 | UPZ1608E101-3R0TF | L4,L22,L25 | L0603 |  | UPZ1608E101-3R0TF | Sunlord | C96995 | LCSC | 2 | UPZ1608E101-3R0TF |  | gge212,gge1779,gge1781 | https://atta.szlcsc.com/upload/public/pdf/source/20241120/C9D5916648BC7FD0D56BAC9E90177F44.pdf
72 | 5 | AMCW3225B-2-510T | L5,L6,L7,L8,L11 | FILTER-SMD_4P-L3.2-W2.5-TL-1 |  | AMCW3225B-2-510T | Sunlord | C2846143 | LCSC | 4 | AMCW3225B-2-510T |  | gge1756,gge1757,gge1758,gge1759,gge1760 | https://item.szlcsc.com/datasheet/AMCW3225B-2-510T/3040405.html
73 | 1 | 24nH | L9 | L0603_1 | 24nH | VHF160808H24NJT | FH | C139271 | LCSC | 2 | 24nH |  | gge28_1 | https://atta.szlcsc.com/upload/public/pdf/source/20230223/8EF545BE87E825DABED9AF3380ABCE94.pdf
74 | 1 | 2.2uH | L12 | IND-SMD_L2.5-W2.0_WPN2520X | 2.2uH | WPN252012H2R2MTY01 | Sunlord | C279858 | LCSC | 2 | 2.2uH |  | gge2016 | https://item.szlcsc.com/datasheet/WPN252012H2R2MTY01/266434.html
75 | 2 | ICMEF112P900MFR | L13,L31 | FILTER-SMD_ICMEF112P900M-1 |  | ICMEF112P900MFR | ICT | C125058 | LCSC | 6 | ICMEF112P900MFR |  | gge1674,gge1821 | https://item.szlcsc.com/datasheet/ICMEF112P900MFR/136334.html
76 | 2 | 1.5uH | L14,L30 | IND-SMD_L3.2-W2.5-YSMC322512H-R24MB | 1.5uH | AAPS322512M1R5F | Coilank | C47327440 | LCSC | 2 | 1.5uH |  | gge1786,gge1791 | https://item.szlcsc.com/datasheet/AAPS322512M1R5F/49538368.html
77 | 1 | BLM15PD121SN1D | L15 | L0402 |  | BLM15PD121SN1D | muRata | C76891 | LCSC | 2 | BLM15PD121SN1D |  | gge702_0 | https://item.szlcsc.com/datasheet/BLM15PD121SN1D/78018.html
78 | 1 | EPZ1005D121-2R0T | L18 | L0402 |  | EPZ1005D121-2R0T | Sunlord | C2994658 | LCSC | 2 | EPZ1005D121-2R0T |  | gge1769 | https://item.szlcsc.com/datasheet/EPZ1005D121-2R0T/3460558.html
79 | 1 | 39nH | L19 | L0603_1 | 39nH | SDCL1608C39NJTDF | Sunlord | C74308 | LCSC | 2 | 39nH |  | gge25 | https://atta.szlcsc.com/upload/public/pdf/source/20231027/6126A3AAC5912C34388756BE22DEE00C.pdf
80 | 1 | 2.2uH | L34 | IND-SMD_L4.4-W4.2 | 2.2uH | FXL0420-2R2-M | cjiang | C167206 | LCSC | 2 | 2.2uH |  | gge1958 | https://atta.szlcsc.com/upload/public/pdf/source/20240426/3189EA8206330E2108542F9E34E540E7.pdf
81 | 1 | 15uH | L37 | IND-SMD_L11.5-W10.0_FXL1040 | 15uH | FXL1040-150-M | cjiang | C475916 | LCSC | 2 | 15uH |  | gge1950 | https://item.szlcsc.com/datasheet/FXL1040-150-M/482449.html
82 | 1 | GL0603UB01 | LED2 | LED0603-RD_BLUE |  | GL0603UB01 | Guiguang light | C51933294 | LCSC | 2 | GL0603UB01 |  | gge1341_0 | https://item.szlcsc.com/datasheet/GL0603UB01/54645990.html
83 | 4 | GL0603UG01 | LED4,LED5,LED6,LED7 | LED0603-RD |  | GL0603UG01 | Guiguang light | C51933293 | LCSC | 2 | GL0603UG01 |  | gge1347_0,gge1348_0,gge1349_0,gge1350_0 | https://item.szlcsc.com/datasheet/GL0603UG01/54645989.html
84 | 1 | KT-0603R | LED14 | LED0603-RD |  | KT-0603R | KENTO | C2286 | LCSC | 2 | KT-0603R |  | gge21 | https://atta.szlcsc.com/upload/public/pdf/source/20160616/1466072038404.pdf
85 | 1 | 16-213SDRC/S530-A3/TR8 | LED15 | LED0402-R-RD |  | 16-213SDRC/S530-A3/TR8 | EVERLIGHT | C71911 | LCSC | 2 | 16-213SDRC/S530-A3/TR8 |  | gge1899
86 | 6 | BSS138P,215 | Q1,Q2,Q17,Q25,Q26,Q27 | SOT-23-3_L2.9-W1.6-P1.90-LS2.8-BR |  | BSS138P,215 | Nexperia | C75547 | LCSC | 3 | BSS138P,215 |  | gge1976,gge1977,gge1983,gge1983_0,gge1983_1,gge1983_2 | https://item.szlcsc.com/datasheet/BSS138P%252C215/76672.html
87 | 1 | HSBA0256 | Q4 | TDSON-8-4_IRF40H233 |  | HSBA0256 | HUASHUO | C2987720 | LCSC | 6 | HSBA0256 |  | gge2042 | https://item.szlcsc.com/datasheet/HSBA0256/3441830.html
88 | 1 | WST4041 | Q15 | SOT-23_L2.9-W1.3-P1.90-LS2.4-BR |  | WST4041 | WINSOK | C148357 | LCSC | 3 | WST4041 |  | gge1905 | https://item.szlcsc.com/datasheet/WST4041/159690.html
89 | 2 | BLP02N08-T | Q18,Q19 | TOLL-8_L10.4-W9.9-P1.20-LS11.7-BL |  | BLP02N08-T |  | C3151187 | LCSC | 10 | BLP02N08-T |  | gge1845,gge1846
90 | 1 | BSS138P,215-JSM | Q20 | SOT-23-3_L2.9-W1.3-P1.90-LS2.4-BR |  | BSS138P,215-JSM | JSMSEMI | C53113863 | LCSC | 3 | BSS138P,215-JSM |  | gge1683 | https://item.szlcsc.com/datasheet/BSS138P%252C215-JSM/56090850.html
91 | 4 | 0Ω | R1,R161,R336,R339 | R0402 | 0Ω | RC0402FR-070RL | YAGEO | C106231 | LCSC | 2 | 0Ω |  | gge1004,gge1157,gge1500_4,gge1500_7 | https://item.szlcsc.com/datasheet/RC0402FR-070RL/107446.html
92 | 8 | 75Ω | R2,R3,R4,R7,R9,R10,R11,R12 | R0402 | 75Ω | 0402WGF750JTCE | UNI-ROYAL | C25133 | LCSC | 2 | 75Ω |  | gge1374_1,gge1374_2,gge1374_3,gge1374_4,gge1374_5,gge1374_6,gge1374_7,gge1374_8 | https://item.szlcsc.com/datasheet/0402WGF750JTCE/25876.html
93 | 3 | 0Ω_NC | R5,R77,R369 | R0603 | 0Ω_NC | FRC0603F0000TS | FOJAN |  | LCSC | 2 | 0Ω_NC |  | gge1979_3,gge2048,gge2049
94 | 2 | 10kΩ | R6,R130 | R0402 | 10kΩ | FRC0402F1002TS | FOJAN | C2906861 | LCSC | 2 | 10kΩ |  | gge1974,gge2035 | https://item.szlcsc.com/datasheet/FRC0402F1002TS/3180374.html
95 | 14 | 4.7kΩ | R8,R83,R84,R85,R86,R87,R98,R99,R100,R102,R131,R132,R135,R347 | R0402 | 4.7kΩ | RC0402FR-074K7L | YAGEO | C105871 | LCSC | 2 | 4.7kΩ |  | gge29,gge30,gge30_3,gge30_6,gge30_11,gge652,gge653,gge654,gge655,gge781,gge782,gge783,gge784,gge785 | https://item.szlcsc.com/datasheet/RC0402FR-074K7L/107086.html
96 | 6 | 22Ω | R13,R30,R31,R45,R47,R49 | R0402 | 22Ω | RC-02K220JT | FH | C140177 | LCSC | 2 | 22Ω |  | gge1669,gge1763,gge1764,gge1765,gge1766,gge1767 | https://item.szlcsc.com/datasheet/RC-02K220JT/151503.html
97 | 4 | 10kΩ | R14,R15,R361,R364 | R0402 | 10kΩ | RC0402FR-0710KL | YAGEO |  | LCSC | 2 | 10kΩ |  | gge186_4,gge186_5,gge186_7,gge186_8 | https://item.szlcsc.com/datasheet/RC0402FR-0710KL/61542.html
98 | 16 | 60.4Ω | R16,R17,R18,R19,R20,R21,R22,R23,R24,R25,R26,R27,R28,R29,R320,R321 | R0603 | 60.4Ω | RS-03K60R4FT | FH | C304772 | LCSC | 2 | 60.4Ω |  | gge1679,gge1680,gge1701,gge1702,gge1707,gge1708,gge1713,gge1714,gge1719,gge1720,gge1726,gge1727,gge1732,gge1733,gge1736,gge1737 | https://item.szlcsc.com/datasheet/RS-03K60R4FT/288839.html
99 | 2 | 1kΩ | R46,R51 | R0402 | 1kΩ | FRC0402F1001TS | FOJAN | C2906864 | LCSC | 2 | 1kΩ |  | gge2039,gge2040 | https://item.szlcsc.com/datasheet/FRC0402F1001TS/3180377.html
100 | 4 | 0Ω | R50,R53,R360,R376 | R0402 | 0Ω | FRC0402F0000TS | FOJAN | C2906858 | LCSC | 2 | 0Ω |  | gge1991,gge2018,gge2018_0,gge2019
101 | 1 | 1MΩ_NC | R52 | R0402 | 1MΩ_NC | 0402WGF1004TCE | UNI-ROYAL |  | LCSC | 2 | 1MΩ_NC |  | gge2020 | https://atta.szlcsc.com/upload/public/pdf/source/20200306/C422600_1E6D84923E4A46A82E41ADD87F860B5C.pdf
102 | 22 | 10kΩ | R54,R55,R61,R62,R63,R64,R65,R69,R82,R92,R93,R143,R316,R318,R322,R324,R329,R331,R332,R362,R367,R373 | R0402 | 10kΩ | RC0402FR-0710KL | YAGEO | C60490 | LCSC | 2 | 10kΩ |  | gge181_3,gge182_2,gge183_2,gge183_12,gge183_13,gge183_14,gge183_15,gge184_2,gge186_6,gge187_2,gge187_3,gge276_1,gge276_2,gge276_3,gge278_1,gge278_2,gge606,gge606_0,gge607,gge688_2,gge688_3,gge688_4 | https://item.szlcsc.com/datasheet/RC0402FR-0710KL/61542.html
103 | 9 | 1kΩ | R56,R57,R58,R59,R60,R97,R159,R176,R363 | R0402 | 1kΩ | RC0402FR-071KL | YAGEO | C106235 | LCSC | 2 | 1kΩ |  | gge633,gge1039_0,gge1039_2,gge1039_3,gge1039_4,gge1039_5,gge1143,gge1158,gge1158_2 | https://item.szlcsc.com/datasheet/RC0402FR-071KL/107450.html
104 | 2 | 100kΩ_NC | R66,R67 | R0402 | 100kΩ_NC | THC02G1003BT | FH |  | LCSC | 2 | 100kΩ_NC |  | gge1691,gge1691_0 | https://item.szlcsc.com/datasheet/THC02G1003BT/49315420.html
105 | 1 | 1kΩ_NC | R68 | R0402 | 1kΩ_NC | RC0402FR-071KL | YAGEO |  | LCSC | 2 | 1kΩ_NC |  | gge1158_1 | https://item.szlcsc.com/datasheet/RC0402FR-071KL/107450.html
106 | 6 | 100kΩ | R70,R170,R171,R315,R341,R352 | R0402 | 100kΩ | THC02G1003BT | FH | C47120018 | LCSC | 2 | 100kΩ |  | gge1806,gge1806_0,gge1882_1,gge1893,gge1895,gge1907 | https://item.szlcsc.com/datasheet/THC02G1003BT/49315420.html
107 | 1 | 2.1kΩ | R71 | R0402 | 2.1kΩ | RC-02W2101FT | FH | C321368 | LCSC | 2 | 2.1kΩ |  | gge1807 | https://item.szlcsc.com/datasheet/RC-02W2101FT/302273.html
108 | 1 | 10kΩ_NC | R72 | R0402 | 10kΩ_NC | RC0402FR-0710KL | YAGEO |  | LCSC | 2 | 10kΩ_NC |  | gge186_9 | https://item.szlcsc.com/datasheet/RC0402FR-0710KL/61542.html
109 | 3 | 4.7kΩ | R90,R91,R175 | R0402 | 4.7kΩ | RC-02K4701FT | FH | C140158 | LCSC | 2 | 4.7kΩ |  | gge1776,gge1777,gge1898 | https://atta.szlcsc.com/upload/public/pdf/source/20140616/1457707091974.pdf
110 | 2 | 22Ω | R94,R95 | R0402 | 22Ω | 0402WGF220JTCE | UNI-ROYAL | C25092 | LCSC | 2 | 22Ω |  | gge1108,gge1109 | https://atta.szlcsc.com/upload/public/pdf/source/20200306/C422600_1E6D84923E4A46A82E41ADD87F860B5C.pdf
111 | 1 | 15kΩ | R96 | R0402 | 15kΩ | RC0402FR-0715KL | YAGEO | C114761 | LCSC | 2 | 15kΩ |  | gge632 | https://atta.szlcsc.com/upload/public/pdf/source/20180821/C275644_0D56F95EFF785E7D9A1FEF436B37DA78.pdf
112 | 2 | 2.49kΩ | R101,R138 | R0402 | 2.49kΩ | RC0402FR-072K49L | YAGEO | C145071 | LCSC | 2 | 2.49kΩ |  | gge30_0,gge634 | https://item.szlcsc.com/datasheet/RC0402FR-072K49L/156403.html
113 | 1 | 29.4kΩ | R119 | R0402 | 29.4kΩ | RT0402BRD0729K4L | YAGEO | C852690 | LCSC | 2 | 29.4kΩ |  | gge1784 | https://item.szlcsc.com/datasheet/RT0402BRD0729K4L/913012.html
114 | 2 | 49.9kΩ | R121,R305 | R0402 | 49.9kΩ | RC0402FR-0749K9L | YAGEO | C137969 | LCSC | 2 | 49.9kΩ |  | gge662_1,gge662_2 | https://item.szlcsc.com/datasheet/RC0402FR-0749K9L/149285.html
115 | 5 | 4.7kΩ_NC | R133,R134,R136,R139,R346 | R0402 | 4.7kΩ_NC | RC0402FR-074K7L | YAGEO |  | LCSC | 2 | 4.7kΩ_NC |  | gge30_5,gge30_7,gge30_8,gge30_10,gge30_12 | https://item.szlcsc.com/datasheet/RC0402FR-074K7L/107086.html
116 | 3 | 4.7kΩ | R137,R144,R146 | R0402 | 4.7kΩ | RC0402FR-074K7L | YAGEO |  | LCSC | 2 | 4.7kΩ |  | gge30_2,gge30_9,gge30_13 | https://item.szlcsc.com/datasheet/RC0402FR-074K7L/107086.html
117 | 1 | 10MΩ | R140 | R0603 | 10MΩ | RS-03L106JT | FH | C304795 | LCSC | 2 | 10MΩ |  | gge1819 | https://item.szlcsc.com/datasheet/RS-03L106JT/288862.html
118 | 4 | 2.2Ω | R141,R142,R311,R312 | R0201 | 2.2Ω | RC-01U2R2JT | FH | C320469 | LCSC | 2 | 2.2Ω |  | gge1677,gge1678,gge1823,gge1824 | https://item.szlcsc.com/datasheet/RC-01U2R2JT/301522.html
119 | 2 | 3.4kΩ | R145,R340 | R0402 | 3.4kΩ | RC-02K3401FT | FH | C453650 | LCSC | 2 | 3.4kΩ |  | gge1829,gge1829_0 | https://item.szlcsc.com/datasheet/RC-02K3401FT/455590.html
120 | 7 | 100Ω | R158,R160,R163,R164,R165,R370,R371 | R0402 | 100Ω | RC0402FR-07100RL | YAGEO | C106232 | LCSC | 2 | 100Ω |  | gge482,gge482_1,gge483,gge491_1,gge491_2,gge492_1,gge492_2 | https://item.szlcsc.com/datasheet/RC0402FR-07100RL/107447.html
121 | 1 | NC | R162 | R0402 | NC | FRC0402P000 TS | FOJAN |  | LCSC | 2 | NC |  | gge1157_0
122 | 1 | 4.7kΩ | R173 | R0402 | 4.7kΩ | FRC0402F4701TS | FOJAN | C2906869 | LCSC | 2 | 4.7kΩ |  | gge1960 | https://item.szlcsc.com/datasheet/FRC0402F4701TS/3180382.html
123 | 1 | 22.1kΩ | R174 | R0402 | 22.1kΩ | FRC0402F2212TS | FOJAN | C2929993 | LCSC | 2 | 22.1kΩ |  | gge1896 | https://item.szlcsc.com/datasheet/FRC0402F2212TS/3266926.html
124 | 1 | 41.2kΩ | R304 | R0603 | 41.2kΩ | FRC0603F4122TS | FOJAN | C2930101 | LCSC | 2 | 41.2kΩ |  | gge1788 | https://item.szlcsc.com/datasheet/FRC0603F4122TS/3267034.html
125 | 2 | 5.1kΩ | R309,R310 | R0402 | 5.1kΩ | FRC0402J512 TS | FOJAN | C2906948 | LCSC | 2 | 5.1kΩ |  | gge1833,gge1834
126 | 2 | 1kΩ | R317,R374 | R0402 | 1kΩ | TC02G1001BT | FH | C20616246 | LCSC | 2 | 1kΩ |  | gge1908,gge1908_1 | https://item.szlcsc.com/datasheet/TC02G1001BT/21982338.html
127 | 1 | 1kΩ | R323 | R0402 | 1kΩ | RT0402BRD071KL | YAGEO | C852624 | LCSC | 2 | 1kΩ |  | gge267_7 | https://item.szlcsc.com/datasheet/RT0402BRD071KL/912946.html
128 | 2 | 10kΩ | R325,R354 | R0603 | 10kΩ | FRC0603J103 TS | FOJAN | C2930027 | LCSC | 2 | 10kΩ |  | gge1998,gge1998_0 | https://item.szlcsc.com/datasheet/FRC0603J103%2520TS/3266960.html
129 | 1 | 2.7kΩ | R330 | R0402 | 2.7kΩ | RC-02K2701FT | FH | C324781 | LCSC | 2 | 2.7kΩ |  | gge1941 | https://item.szlcsc.com/datasheet/RC-02K2701FT/305306.html
130 | 1 | 16kΩ | R342 | R0402 | 16kΩ | FRC0402F1602TS | FOJAN | C2906863 | LCSC | 2 | 16kΩ |  | gge1951 | https://item.szlcsc.com/datasheet/FRC0402F1602TS/3180376.html
131 | 1 | 3kΩ | R343 | R0402 | 3kΩ | FRC0402F3001TS | FOJAN | C2909355 | LCSC | 2 | 3kΩ |  | gge1952
132 | 1 | 10Ω | R344 | R0603 | 10Ω | FRC0603F10R0TS | FOJAN | C2906983 | LCSC | 2 | 10Ω |  | gge1982 | https://item.szlcsc.com/datasheet/FRC0603F10R0TS/3180496.html
133 | 1 | 25mΩ | R345 | R1206 | 25mΩ | LRAM12CJTR025 | NCT | C5120994 | LCSC | 2 | 25mΩ |  | gge1956 | https://item.szlcsc.com/datasheet/LRAM12CJTR025/5707060.html
134 | 2 | 1kΩ | R350,R355 | R0603 | 1kΩ | FRC0603F1001TS | FOJAN | C2907002 | LCSC | 2 | 1kΩ |  | gge1997,gge1997_0
135 | 1 | 3.74kΩ | R353 | R0402 | 3.74kΩ | FRC0402F3741TS | FOJAN | C5154016 | LCSC | 2 | 3.74kΩ |  | gge1986
136 | 2 | 100Ω | R365,R366 | R0402 | 100Ω | FRC0402F1000TS | FOJAN | C2906860 | LCSC | 2 | 100Ω |  | gge2001,gge2002 | https://item.szlcsc.com/datasheet/FRC0402F1000TS/3180373.html
137 | 1 | 0Ω | R368 | R0603 | 0Ω | FRC0603F0000TS | FOJAN |  | LCSC | 2 | 0Ω |  | gge1979_2
138 | 1 | 1kΩ_NC | R372 | R0402 | 1kΩ_NC | TC02G1001BT | FH |  | LCSC | 2 | 1kΩ_NC |  | gge1908_0 | https://item.szlcsc.com/datasheet/TC02G1001BT/21982338.html
139 | 2 | 10kΩ_NC | R377,R378 | R0603 | 10kΩ_NC | FRC0603J103 TS | FOJAN |  | LCSC | 2 | 10kΩ_NC |  | gge1998_1,gge1998_2 | https://item.szlcsc.com/datasheet/FRC0603J103%2520TS/3266960.html
140 | 3 | TS-1009B-05026 | SW4,SW6,SW7 | SW-TH_3P-L4.5-W3.8-P3.10-LS1.9_TS-1009B-05026 |  | TS-1009B-05026 | XUNPU | C455252 | LCSC | 3 | TS-1009B-05026 |  | gge1052,gge1053,gge1053_1 | https://item.szlcsc.com/datasheet/TS-1009B-05026/457607.html
141 | 1 | TS-1145A-C-A | SW5 | SW-SMD_4P-L4.2-W3.2-P2.15-LS4.6 |  | TS-1145A-C-A | XKB Connectivity | C318903 | LCSC | 4 | TS-1145A-C-A |  | gge1161 | https://atta.szlcsc.com/upload/public/pdf/source/20200227/C318903_3041DAA81BF275941EC3AA6571F5210B.pdf
142 | 1 | DSHP02TSGER | SW8 | SW-SMD_DSHP02TSGER |  | DSHP02TSGER | Kangshen | C3293142 | LCSC | 4 | DSHP02TSGER |  | gge2004 | https://item.szlcsc.com/datasheet/DSHP02TSGER/3856577.html
143 | 1 | VPT85BB-01A | T1 | XFMR-SMD_L7.5-W6.7-P2.54-LS7.7-BL |  | VPT85BB-01A | VPSC | C2875071 | LCSC | 6 | VPT85BB-01A |  | gge200_1 | https://atta.szlcsc.com/upload/public/pdf/source/20210820/C2875071_390FAC4CEF949F570DEA6F3C83649DB9.pdf
144 | 2 | Test-Point | TP2,TP3 | Test-Point-0.5mm |  |  |  |  |  | 1 |  |  | gge1345,gge1346
145 | 1 | HPM5E31IPB1 | U1 | eLQFP-100 |  |  | HPMicro |  |  | 101 |  |  | gge57
146 | 1 | SMF6.0CA | U2 | SOD-123FL_L2.8-W1.8-LS3.7-BI |  | SMF6.0CA | GOODWORK | C2943871 | LCSC | 2 | SMF6.0CA |  | gge1673 | https://item.szlcsc.com/datasheet/SMF6.0CA/3328927.html
147 | 1 | SMF5.0CA | U3 | SOD-123FL_L2.8-W1.8-LS3.7-BI |  | SMF5.0CA | GOODWORK | C2980402 | LCSC | 2 | SMF5.0CA |  | gge1687 | https://item.szlcsc.com/datasheet/SMF5.0CA/3402138.html
148 | 1 | BAT54C | U4 | SOT-23-3_L2.9-W1.3-P1.90-LS2.8-BR |  | BAT54C | R+O | C22466350 | LCSC | 3 | BAT54C |  | gge1775 | https://item.szlcsc.com/datasheet/BAT54C/24165509.html
149 | 1 | FE1.1S-BQFN24B | U5 | WQFN-24_L4.0-W4.0-P0.50-TL-EP2.7 |  | FE1.1S-BQFN24B | TERMINUS | C6776948 | LCSC | 25 | FE1.1S-BQFN24B |  | gge1936 | https://item.szlcsc.com/datasheet/FE1.1S-BQFN24B/7735567.html
150 | 2 | SIT65HVD230DR | U6,U10 | SOP-8_L4.9-W3.9-P1.27-LS6.0-BL |  | SIT65HVD230DR | SIT | C496619 | LCSC | 8 | SIT65HVD230DR |  | gge1942,gge1943 | https://item.szlcsc.com/datasheet/SIT65HVD230DR/508325.html
151 | 1 | - | U8 | CRYSTAL-SMD_4P-L3.2-W2.5-BL_1 | - | E3SB12E00003KE | HOSONIC | C2757518 | LCSC | 4 | - |  | gge1937 | https://item.szlcsc.com/datasheet/E3SB12E00003KE/2873875.html
152 | 1 | YI160808U601-2R0T | U9 | L0603_1 |  | YI160808U601-2R0T | YJYCOIN | C2971884 | LCSC | 2 | YI160808U601-2R0T |  | gge1940 | https://atta.szlcsc.com/upload/public/pdf/source/20220124/1581248EA3A72409846849DDE53A1B42.pdf
153 | 5 | XT30PW(2+2)-M.G.B | U12,U15,U16,U20,U71 | CONN-TH_4P-XT30PW-M |  | XT30PW(2+2)-M.G.B | AMASS | C19268030 | LCSC | 4 | XT30PW(2+2)-M.G.B |  | gge65_4,gge65_5,gge65_6,gge65_7,gge65_8 | https://item.szlcsc.com/datasheet/XT30PW(2%252B2)-M.G.B/20526041.html
154 | 5 | ISO1044BDR | U13,U19,U21,U23,U30 | SOIC-8_L4.9-W3.9-P1.27-LS6.0-BL |  | ISO1044BDR | TI | C2878225 | LCSC | 8 | ISO1044BDR |  | gge1740,gge1741,gge1742,gge1743,gge1746 | https://www.ti.com/cn/lit/gpn/iso1044
155 | 2 | DSK36 | U14,U18 | SOD-123FL_L2.8-W1.9-LS3.7-RD |  | DSK36 | R+O | C22466353 | LCSC | 2 | DSK36 |  | gge202_1,gge203_1 | https://item.szlcsc.com/datasheet/DSK36/24165512.html
156 | 1 | VPS8505 | U17 | SOT-23-6_L2.9-W1.6-P0.95-LS2.8-BR |  | VPS8505 | VPSC | C2986360 | LCSC | 6 | VPS8505 |  | gge201_1 | https://atta.szlcsc.com/upload/public/pdf/source/20220325/B9A616CE51E2B61B0620210412D7773A.pdf
157 | 37 | BTC-311-ZN01 | U22,U25,U28,U29,U39,U40,U41,U44,U45,U49,U50,U51,U52,U54,U56,U57,U58,U59,U60,U61,U64,U69,U70,U77,U90,U91,U93,U94,U95,U96,U97,U98,U99,U100,U101,U102,U103 | CONN-SMD_BTC-311-ZN01 |  | BTC-311-ZN01 | BZXC | C41374301 | LCSC | 1 | BTC-311-ZN01 |  | gge1966,gge1966_0,gge1966_1,gge1966_2,gge1966_3,gge1966_4,gge1966_5,gge1966_6,gge1966_7,gge1966_8,gge1966_9,gge1966_10,gge1966_11,gge1966_12,gge1966_13,gge1966_14,gge1966_15,gge1966_16,gge1966_17,gge1966_18,gge1966_19,gge1966_20,gge1966_21,gge1966_22,gge1966_23,gge1966_24,gge1966_26,gge1966_27,gge1966_28,gge1966_29,gge1966_30,gge1966_31,gge1966_32,gge1966_33,gge1966_34,gge1966_35,gge1966_36 | https://item.szlcsc.com/datasheet/BTC-311-ZN01/43139437.html
158 | 1 | 4.7uH | U24 | L0806 | 4.7uH | DFE201612E-4R7M=P2 | muRata | C3223763 | LCSC | 2 | 4.7uH |  | gge2050 | https://item.szlcsc.com/datasheet/DFE201612E-4R7M%253DP2/3786782.html
159 | 2 | WAFER-GH1.25-4PWB | U26,U27 | CONN-SMD_4P-P1.25_XUNPU_WAFER-GH1.25-4PWB |  | WAFER-GH1.25-4PWB | XUNPU | C3029379 | LCSC | 6 | WAFER-GH1.25-4PWB |  | gge52,gge52_1 | https://item.szlcsc.com/datasheet/WAFER-GH1.25-4PWB/3561391.html
160 | 2 | 6GHz | U31,U62 | IPEX-SMD_BWIPX-1-001E | 6GHz | BWU.FL-IPEX1 | BAT WIRELESS | C5137195 | LCSC | 3 | 6GHz |  | gge1352,gge1970 | https://item.szlcsc.com/datasheet/BWU.FL-IPEX1/5745892.html
161 | 1 | AP6256 | U32 | QFN-44_L12.0-W12.0-P0.90-TL_AP6256 |  | AP6256 | AMPAK | C5248079 | LCSC | 47 | AP6256 |  | gge309 | https://item.szlcsc.com/datasheet/AP6256/5960630.html
162 | 1 | HYM8563S | U33 | MSOP-8_L3.0-W3.0-P0.65-LS5.0-BL |  | HYM8563S | HAOYU | C155754 | LCSC | 8 | HYM8563S |  | gge600 | https://atta.szlcsc.com/upload/public/pdf/source/20180126/C166681_15169517288131308513.pdf
163 | 1 | RTL8125BG-CG | U34 | TQFN-48_L6.0-W6.0-P0.40-BL-EP4.5 |  | RTL8125BG-CG | REALTEK | C3013605 | LCSC | 49 | RTL8125BG-CG |  | gge631
164 | 3 | SY8113IADC | U35,U72,U78 | TSOT-23-6_L2.9-W1.6-P0.95-LS2.8-BL |  | SY8113IADC | Silergy | C479075 | LCSC | 6 | SY8113IADC |  | gge1783,gge1789,gge1892 | https://item.szlcsc.com/datasheet/SY8113IADC/486367.html
165 | 1 | RS0104YUTQH12 | U36 | QFN-12_L2.0-W1.7-P0.40-BL |  | RS0104YUTQH12 | RUNIC | C5372422 | LCSC | 12 | RS0104YUTQH12 |  | gge671_1 | https://item.szlcsc.com/datasheet/RS0104YUTQH12/6223474.html
166 | 1 | RTL8367N-VB-CG | U37 | QFN-88_L10.0-W10.0-P0.40-BL-EP6.75 |  | RTL8367N-VB-CG | REALTEK | C2760851 | LCSC | 89 | RTL8367N-VB-CG |  | gge1344 | https://item.szlcsc.com/datasheet/RTL8367N-VB-CG/2883012.html
167 | 7 | ESD5451N | U38,U42,U43,U46,U47,U106,U107 | X1-DFN1006-2_L1.0-W0.6-P0.65-BI |  | ESD5451N | TECH PUBLIC | C2936977 | LCSC | 2 | ESD5451N |  | gge484,gge484_1,gge493,gge493_0,gge494,gge502_1,gge2013 | https://atta.szlcsc.com/upload/public/pdf/source/20211227/D040CF3F0222548C5BD9F7E690946783.pdf
168 | 2 | MX74502D23 | U48,U104 | UDFN-8L_L2.0-W3.0-P0.50-BL-EP |  | MX74502D23 | Wuxi Maxinmicro | C41433189 | LCSC | 9 | MX74502D23 |  | gge1801,gge1801_0 | https://item.szlcsc.com/datasheet/MX74502D23/43297040.html
169 | 1 | FJ1527-M1 | U53 | SOP-8_L4.9-W3.9-P1.27-LS6.0-BL-1 |  | FJ1527-M1 | Hummingbird Wireless | C5182316 | LCSC | 8 | FJ1527-M1 |  | gge19_2 | https://atta.szlcsc.com/upload/public/pdf/source/20220929/1A5669C68F85C805BCE5C55ADB41C512.pdf
170 | 1 | 13.52127MHz | U55 | CRYSTAL-SMD_4P-L3.2-W2.5-BL_1 | 13.52127MHz | TAXM13.52127M4RLBDDT2T | YJX | C2997669 | LCSC | 4 | 13.52127MHz |  | gge24 | https://item.szlcsc.com/datasheet/TAXM13.52127M4RLBDDT2T/3469852.html
171 | 1 | R30-1000602-Harwin | U65_NC | SMD_BD5.0-D3.0 |  | R30-1000602-Harwin | Harwin | x | LCSC | 4 | R30-1000602-Harwin |  | gge1023_1 | https://item.szlcsc.com/datasheet/R30-1000602-Harwin/49200836.html
172 | 3 | R30-1000602-Harwin | U66_NC,U67_NC,U68_NC | SMD_BD5.0-D3.0 |  | R30-1000602-Harwin | Harwin | C47018769 | LCSC | 4 | R30-1000602-Harwin |  | gge1024_1,gge1025_1,gge1026_1 | https://item.szlcsc.com/datasheet/R30-1000602-Harwin/49200836.html
173 | 1 | SIT3485EUA | U74 | MSOP-8_L3.0-W3.0-P0.65-LS5.0-BL |  | SIT3485EUA | SIT | C382671 | LCSC | 8 | SIT3485EUA |  | gge1676 | https://item.szlcsc.com/datasheet/SIT3485EUA/355696.html
174 | 2 | LPW5209AB5F | U75,U86 | SOT-23-5_L3.0-W1.7-P0.95-LS2.8-BL |  | LPW5209AB5F | LOWPOWER | C387727 | LCSC | 5 | LPW5209AB5F |  | gge1825,gge1825_0 | https://item.szlcsc.com/datasheet/LPW5209AB5F/361755.html
175 | 1 | LR670L | U79 | SOT-23-6_L2.9-W1.6-P0.95-LS2.9-BL |  | LR670L | Hummingbird Wireless | C22369154 | LCSC | 6 | LR670L |  | gge18_2 | https://item.szlcsc.com/datasheet/LR670L/23848179.html
176 | 1 | MST8A50QA-15A1Y | U87 | QFN-20_L5.0-W5.0-P0.80-TL_HP8105QA |  | MST8A50QA-15A1Y | MST | C22395101 | LCSC | 26 | MST8A50QA-15A1Y |  | gge1948 | https://item.szlcsc.com/datasheet/MST8A50QA-15A1Y/23991857.html
177 | 1 | RS0102YH8 | U105 | SOT-23-8_L3.0-W1.7-P0.65-LS2.8-BL |  | RS0102YH8 | RUNIC | C783414 | LCSC | 8 | RS0102YH8 |  | gge2009 | https://item.szlcsc.com/datasheet/RS0102YH8/837739.html
178 | 1 | X1515WRS-04-LPSW | USB3 | CONN-SMD_X1515WRS-04-LPSW |  | X1515WRS-04-LPSW | XKB Connection | C519197 | LCSC | 6 | X1515WRS-04-LPSW |  | gge1671 | https://item.szlcsc.com/datasheet/X1515WRS-04-LPSW/535927.html
179 | 1 | TYPE-C-31-M-12 | USBC1 | USB-C_SMD-TYPE-C-31-M-12_1 |  | TYPE-C-31-M-12 | Hanyoung, קוריאה | C165948 | LCSC | 16 | TYPE-C-31-M-12 |  | gge1822 | https://item.szlcsc.com/datasheet/TYPE-C-31-M-12/177331.html
180 | 1 | 24MHz | X3 | CRYSTAL-SMD_4P-L2.5-W2.0-BL | 24MHz | X252024MOB4SI | YXC | C371129 | LCSC | 4 | 24MHz |  | gge58_2 | https://item.szlcsc.com/datasheet/X252024MOB4SI/344726.html
181 | 1 | 37.4MHz | X4 | CRYSTAL-SMD_4P-L2.0-W1.6-BL | 37.4MHz | Q22FA12800078 | EPSON | C255897 | LCSC | 4 | 37.4MHz |  | gge452 | https://atta.szlcsc.com/upload/public/pdf/source/20230810/8C78D726E60425AED3A5C2279BDB1574.pdf
182 | 1 | 32.768kHz | X5 | OSC-SMD_L3.2-W1.5 | 32.768kHz | X321532768KGD2SI | YXC | C620155 | LCSC | 2 | 32.768kHz |  | gge1971 | https://item.szlcsc.com/datasheet/X321532768KGD2SI/649983.html
183 | 2 | 25MHz | X6,X7 | CRYSTAL-SMD_4P-L3.2-W2.5-BL | 25MHz | X322525MOB4SI | YXC | C9006 | LCSC | 4 | 25MHz |  | gge1338,gge1787 | https://atta.szlcsc.com/upload/public/pdf/source/20240329/19D5F850207469550BEB00D7DFEDBC7A.pdf
