oznav2/tectile_skin/hardware/02_PCB/05_RBE-PWR-HANDPlusPro/01_BOM_HAND_2026-09-09.xlsx

No. | Quantity | Comment | Designator | Footprint | Value | Manufacturer Part | Manufacturer | Supplier Part | Supplier | Pin Count | Name | Symbol | Unique ID | Datasheet
1 | 1 | 1.2nF | C1 | C0402 | 1.2nF | CL10B102KB8NNNC | SAMSUNG |  | LCSC | 2 | 1.2nF | CL10B102KB8NNNC | gge297 | https://item.szlcsc.com/datasheet/CL10B102KB8NNNC/1940.html
2 | 3 | 10uF | C2,C5,C20 | C1206 | 10uF | HGC1206R5106K500NSPJ | Chinocera | C7432781 | LCSC | 2 | 10uF | HGC1206R5106K500NSPJ | gge298,gge298_1,gge298_3 | https://item.szlcsc.com/datasheet/HGC1206R5106K500NSPJ/8438263.html
3 | 1 | 100nF | C3 | C0402 | 100nF | CGA0603X7R104K500JT | HRE | C6119867 | LCSC | 2 | 100nF | CGA0603X7R104K500JT | gge299 | https://item.szlcsc.com/datasheet/CGA0603X7R104K500JT/7062573.html
4 | 1 | 10pF | C4 | C0402 | 10pF | CL10C100JB8NNNC | SAMSUNG |  | LCSC | 2 | 10pF | CL10C100JB8NNNC | gge300 | https://item.szlcsc.com/datasheet/CL10C100JB8NNNC/1986.html
5 | 7 | 100nF | C6,C7,C8,C9,C10,C11,C13 | C0603 | 100nF | CGA0603X7R104K500JT | HRE | C6119867 | LCSC | 2 | 100nF | CGA0603X7R104K500JT | gge279,gge306,gge306_0,gge306_1,gge307,gge307_0,gge307_1 | https://item.szlcsc.com/datasheet/CGA0603X7R104K500JT/7062573.html
6 | 4 | 4.7uF | C12,C14,C25,C26 | C1206 | 4.7uF | HHV1206R7475M101NSPJ | Chinocera | C33546020 | LCSC | 2 | 4.7uF | HHV1206R7475M101NSPJ | gge111,gge112,gge112_0,gge112_1 | https://item.szlcsc.com/datasheet/HHV1206R7475M101NSPJ/35278498.html
7 | 1 | 56nF | C15 | C0402 | 56nF | CC0603KRX7R9BB563 | YAGEO | C282072 | LCSC | 2 | 56nF | CC0603KRX7R9BB563 | gge285 | https://atta.szlcsc.com/upload/public/pdf/source/20180910/C282072_33301C7F631E79921B82A8DAC6BCC5B3.pdf
8 | 1 | 2.2uF | C16 | C0402 | 2.2uF | CL10A225KO8NNNC | SAMSUNG | C23630 | LCSC | 2 | 2.2uF | CL10A225KO8NNNC | gge288 | https://item.szlcsc.com/datasheet/CL10A225KO8NNNC/24366.html
9 | 1 | 4.7nF | C17 | C0402 | 4.7nF | 0603B822K500NT | FH |  | LCSC | 2 | 4.7nF | 0603B822K500NT | gge289 | https://item.szlcsc.com/datasheet/0603B822K500NT/1413077.html
10 | 1 | 220pF | C18 | C0402 | 220pF | CL10C331JB8NNNC | SAMSUNG |  | LCSC | 2 | 220pF | CL10C331JB8NNNC | gge290 | https://item.szlcsc.com/datasheet/CL10C331JB8NNNC/2016.html
11 | 1 | SMBJ60A | D6 | SMB_L4.5-W3.7-LS5.4-RD |  | SMBJ60A | R+O | C49066953 | LCSC | 2 | SMBJ60A | SMBJ60A_C49066953 | gge346 | https://item.szlcsc.com/datasheet/SMBJ60A/51438149.html
12 | 1 | PH-6PWB | FPC1 | CONN-SMD_6P-P2.00_DEALON_PH-6PWB |  | PH-6PWB | DEALON | C2905023 | LCSC | 8 | PH-6PWB | PH-6PWB | gge303 | https://item.szlcsc.com/datasheet/PH-6PWB/3172308.html
13 | 1 | 33uH | L1 | IND-SMD_L11.5-W10.0_FXL1040 | 33uH | FXL1050-330-M | cjiang | C5359267 | LCSC | 2 | 33uH | FXL1050-330-M | gge322 | https://item.szlcsc.com/datasheet/FXL1050-330-M/6172043.html
14 | 1 | GL0603UG01 | LED1 | LED0603-RD |  | GL0603UG01 | Guiguang light | C51933293 | LCSC | 2 | GL0603UG01 | GL0603UG01 | gge305 | https://item.szlcsc.com/datasheet/GL0603UG01/54645989.html
15 | 2 | NTMFS6H864NL | Q1,Q4 | DFN-8_L5.9-W5.2-P1.27-LS6.2-BL |  | NTMFS6H864NL |  |  |  | 8 | NTMFS6H864NL | BSC117N08NS5ATMA1 | gge277,gge277_1 | https://item.szlcsc.com/datasheet/BSC117N08NS5/3841628.html
16 | 1 | 768Ω | R1 | R0402 | 768Ω | RT0603BRD07619RL | YAGEO |  | LCSC | 2 | 768Ω | RT0603BRD07619RL | gge318 | https://item.szlcsc.com/datasheet/RT0603BRD07619RL/742310.html
17 | 1 | 13.7Ω | R2 | R0402 | 13.7Ω | RC0603FR-075R76L | YAGEO |  | LCSC | 2 | 13.7Ω | RC0603FR-075R76L | gge296 | https://atta.szlcsc.com/upload/public/pdf/source/20200715/C482884_1DE0D9232CAFC393996D6EC5264E943B.pdf
18 | 1 | 110kΩ | R3 | R0402 | 110kΩ | FRC0603F2103TS | FOJAN |  | LCSC | 2 | 110kΩ | FRC0603F2103TS | gge281_0
19 | 1 | 750Ω | R4 | R0402 | 750Ω | FRC0603F7680TS | FOJAN |  | LCSC | 2 | 750Ω | FRC0603F7680TS | gge317
20 | 1 | 100kΩ | R5 | R0603 | 100kΩ | 0603WAF1003T5E | UNI-ROYAL | C25803 | LCSC | 2 | 100kΩ | 0603WAF1003T5E | gge319 | https://item.szlcsc.com/datasheet/0603WAF1003T5E/26546.html
21 | 2 | 0Ω | R6,R7 | R0402 | 0Ω | 0603WAF2002T5E | UNI-ROYAL |  | LCSC | 2 | 0Ω | 0603WAF2002T5E | gge287_0,gge287_1 | https://item.szlcsc.com/datasheet/0603WAF2002T5E/4591.html
22 | 1 | 120Ω | R8 | R0603 | 120Ω | FRC0603F1200TS | FOJAN | C2906988 | LCSC | 2 | 120Ω | FRC0603F1200TS | gge348 | https://item.szlcsc.com/datasheet/FRC0603F1200TS/3180501.html
23 | 1 | 100kΩ | R11 | R0402 | 100kΩ | FRC0603F2103TS | FOJAN |  | LCSC | 2 | 100kΩ | FRC0603F2103TS | gge281
24 | 1 | 7.68kΩ | R12 | R0402 | 7.68kΩ | FRC0603F7681TS | FOJAN | C2930128 | LCSC | 2 | 7.68kΩ | FRC0603F7681TS | gge282
25 | 1 | 2Ω | R13 | R0402 | 2Ω | FRC0603J2R0 TS | FOJAN | C2907139 | LCSC | 2 | 2Ω | FRC0603J2R0 TS | gge283
26 | 1 | 40.2kΩ | R14 | R0402 | 40.2kΩ | 0603WAF3922T5E | UNI-ROYAL |  | LCSC | 2 | 40.2kΩ | 0603WAF3922T5E | gge284 | https://item.szlcsc.com/datasheet/0603WAF3922T5E/23764.html
27 | 1 | 6.19kΩ | R17 | R0402 | 6.19kΩ | FRC0603F3741TS | FOJAN |  | LCSC | 2 | 6.19kΩ | FRC0603F3741TS | gge291
28 | 1 | 22.1kΩ | R19 | R0402 | 22.1kΩ | 0603WAF1802T5E | UNI-ROYAL |  | LCSC | 2 | 22.1kΩ | 0603WAF1802T5E | gge293 | https://item.szlcsc.com/datasheet/0603WAF1802T5E/26553.html
29 | 1 | DSPV02LSGET | SW1 | SW-SMD_DSPV02LSGET |  | DSPV02LSGET | Kangshen | C3293167 | LCSC | 4 | DSPV02LSGET | DSPV02LSGET_C3293167 | gge352 | https://item.szlcsc.com/datasheet/DSPV02LSGET/3856602.html
30 | 1 | S6B-PH-K-S(LF)(SN) | U2 | CONN-TH_6P-P2.00_S6B-PH-K-S-LF-SN |  | S6B-PH-K-S(LF)(SN) | JST | C157920 | LCSC | 6 | S6B-PH-K-S(LF)(SN) | S6B-PH-K-S-(LF)(SN) | gge351 | https://item.szlcsc.com/datasheet/S6B-PH-K-S(LF)(SN)/169268.html
31 | 1 | LM5145RGYR | U11 | VQFN-20_L4.5-W3.5-P0.50-BL-EP |  | LM5145RGYR | TI | C485912 | LCSC | 21 | LM5145RGYR | LM5145RGYR_1 | gge278 | https://www.ti.com/cn/lit/gpn/lm5145
