oznav2/tectile_skin/hardware/02_PCB/06_RBE-PWR-HEAD/01_BOM_HEAD_2026-09-09.xlsx

No. | Quantity | Comment | Designator | Footprint | Value | Manufacturer Part | Manufacturer | Supplier Part | Supplier | Pin Count | Name | Symbol | Unique ID | Datasheet
1 | 1 | PJ-327E-5A | AUDIO1 | AUDIO-SMD_PJ-327E-5A |  | PJ-327E-5A | Hanyoung, קוריאה | C145812 | LCSC | 5 | PJ-327E-5A | PJ-327E-5A | gge237 | https://item.szlcsc.com/datasheet/PJ-327E-5A/157144.html
2 | 6 | 220nF | C1,C2,C4,C38,C39,C40 | C0402 | 220nF | GRM155R61H224KE01D | muRata | C5159775 | LCSC | 2 | 220nF | GRM155R61H224KE01D | gge103,gge103_0,gge103_1,gge104,gge105,gge106 | https://item.szlcsc.com/datasheet/GRM155R61H224KE01D/5803626.html
3 | 8 | 100nF | C3,C5,C11,C21,C29,C33,C51,C148 | C0402 | 100nF | CL05B104KB54PNC | SAMSUNG | C307331 | LCSC | 2 | 100nF | CL05B104KB54PNC | gge647_1,gge1079_0,gge1079_1,gge1079_2,gge1079_3,gge1079_6,gge1079_8,gge1079_9 | https://item.szlcsc.com/datasheet/CL05B104KB54PNC/291005.html
4 | 4 | 3.3uF | C6,C7,C57,C58 | C0402 | 3.3uF | C1005X5R1A335KTJ00E | TDK | C695126 | LCSC | 2 | 3.3uF | C1005X5R1A335KTJ00E | gge122,gge123,gge124,gge125 | https://item.szlcsc.com/datasheet/C1005X5R1A335KTJ00E/728226.html
5 | 1 | 10uF | C8 | C0402 | 10uF | CL05A106MP5NUNC | SAMSUNG | C315248 | LCSC | 2 | 10uF | CL05A106MP5NUNC_C315248 | gge184_3 | https://atta.szlcsc.com/upload/public/pdf/source/20231220/1EF805BAE1520675928CC4638D279E74.pdf
6 | 4 | 47uF | C9,C55,C56,C106 | C1206 | 47uF | HGC1206R5476M160NSPJ | Chinocera | C7472975 | LCSC | 2 | 47uF | HGC1206R5476M160NSPJ | gge111_3,gge111_5,gge112_5,gge112_6 | https://item.szlcsc.com/datasheet/HGC1206R5476M160NSPJ/8532822.html
7 | 12 | 1uF | C10,C37,C41,C45,C46,C54,C117,C143,C144,C147,C154,C156 | C0402 | 1uF | CL05A105KA5NQNC | SAMSUNG | C52923 | LCSC | 2 | 1uF | CL05A105KA5NQNC | gge119,gge184_4,gge184_7,gge184_8,gge184_9,gge184_10,gge635,gge642_1,gge645,gge649_1,gge650_1,gge715_7 | https://item.szlcsc.com/datasheet/CL05A105KA5NQNC/53938.html
8 | 1 | 220uF | C12 | CAP-SMD_BD6.3-L6.6-W6.6-FD-1 | 220uF | MA16V220M6X8 | JIERR | C46550461 | LCSC | 2 | 220uF | MA16V220M6X8 | gge1132 | https://item.szlcsc.com/datasheet/MA16V220M6X8/48680155.html
9 | 3 | 100nF | C13,C20,C35 | C0603 | 100nF | CC0603KRX7R0BB104 | YAGEO | C113803 | LCSC | 2 | 100nF | CC0603KRX7R0BB104 | gge82_5,gge82_6,gge82_7 | https://item.szlcsc.com/datasheet/CC0603KRX7R0BB104/115039.html
10 | 2 | 12pF | C14,C19 | C0402 | 12pF | 0402CG120J500NT | FH | C1547 | LCSC | 2 | 12pF | 0402CG120J500NT | gge1114,gge1115 | https://item.szlcsc.com/datasheet/0402CG120J500NT/1899.html
11 | 3 | 10uF | C15,C126,C138 | C0402 | 10uF | GRM155R61A106ME11D | muRata | C408132 | LCSC | 2 | 10uF | GRM155R61A106ME11D | gge644,gge657_1,gge657_2 | https://atta.szlcsc.com/upload/public/pdf/source/20200305/C490387_23319AE8C154DEB24C505E6C82A8106A.pdf
12 | 3 | 100nF | C16,C23,C25 | C0402 | 100nF | FCC0402B104K160AT | FOJAN | C5137468 | LCSC | 2 | 100nF | FCC0402B104K160AT | gge1897,gge1897_1,gge1897_2 | https://item.szlcsc.com/datasheet/FCC0402B104K160AT/5746970.html
13 | 6 | 1nF | C17,C18,C43,C44,C49,C53 | C0402 | 1nF | CC0402KRX7R9BB102 | YAGEO | C106205 | LCSC | 2 | 1nF | CC0402KRX7R9BB102 | gge117_4,gge117_5,gge117_6,gge117_7,gge119_0,gge648_4 | https://atta.szlcsc.com/upload/public/pdf/source/20181008/C309510_22F155564471FAF6A489F7D68F34234E.pdf
14 | 3 | 22pF | C22,C32,C139 | C0402 | 22pF | CC0402JRNPO9BN220 | YAGEO | C106203 | LCSC | 2 | 22pF | CC0402JRNPO9BN220 | gge660_1,gge660_2,gge660_4 | https://item.szlcsc.com/datasheet/CC0402JRNPO9BN220/107418.html
15 | 14 | 100nF | C24,C27,C47,C48,C59,C136,C137,C140,C149,C151,C158,C160,C161,C336 | C0402 | 100nF | CC0402KRX7R9BB104 | YAGEO | C131394 | LCSC | 2 | 100nF | CC0402KRX7R9BB104 | gge648_1,gge648_2,gge648_3,gge658_1,gge658_2,gge666_1,gge666_2,gge715_1,gge715_3,gge715_4,gge715_67,gge715_70,gge1080_0,gge1081_0 | https://atta.szlcsc.com/upload/public/pdf/source/20181008/C309510_22F155564471FAF6A489F7D68F34234E.pdf
16 | 1 | 1nF | C26 | C0402 | 1nF | GRM1555C1H102JA01D | muRata | C76947 | LCSC | 2 | 1nF | GRM1555C1H102JA01D | gge203_1 | https://atta.szlcsc.com/upload/public/pdf/source/20180307/C76947_15204091165631407735.pdf
17 | 5 | 22uF | C34,C36,C42,C128,C141 | C0603 | 22uF | GRM188R61A226ME15D | muRata | C84419 | LCSC | 2 | 22uF | GRM188R61A226ME15D | gge638,gge664_1,gge664_2,gge1554_4,gge1554_5 | https://item.szlcsc.com/datasheet/GRM188R61A226ME15D/85589.html
18 | 1 | 4.7uF | C50 | C1210 | 4.7uF | FS32X475K101EGG | PSA | C381466 | LCSC | 2 | 4.7uF | FS32X475K101EGG | gge81_1 | https://item.szlcsc.com/datasheet/FS32X475K101EGG/354087.html
19 | 1 | 22uF | C52 | C0603 | 22uF | HGC0603R5226M160NTHJ | Chinocera | C22367828 | LCSC | 2 | 22uF | HGC0603R5226M160NTHJ | gge1935_0 | https://item.szlcsc.com/datasheet/HGC0603R5226M160NTHJ/23841133.html
20 | 2 | 22uF | C60,C63 | CAP-SMD_BD6.3-L6.6-W6.6-FD-A | 22uF | 2201010609TR | NJCON | C19270543 | LCSC | 2 | 22uF | 2201010609TR | gge1627,gge1627_0 | https://item.szlcsc.com/datasheet/2201010609TR/20537233.html
21 | 1 | 47nF | C61 | C0402 | 47nF | CC0402KRX7R9BB473 | YAGEO | C272875 | LCSC | 2 | 47nF | CC0402KRX7R9BB473 | gge1315_0 | https://item.szlcsc.com/datasheet/CC0402KRX7R9BB473/261267.html
22 | 1 | 2.2uF | C62 | C0402 | 2.2uF | CL05A225KO5NQNC | SAMSUNG | C170151 | LCSC | 2 | 2.2uF | CL05A225KO5NQNC | gge120_1 | https://item.szlcsc.com/datasheet/CL05A225KO5NQNC/181536.html
23 | 2 | 47pF | C64,C66 | C0402 | 47pF | CC0402JRNPO9BN470 | YAGEO | C60137 | LCSC | 2 | 47pF | CC0402JRNPO9BN470 | gge1316_0,gge1317_0 | https://atta.szlcsc.com/upload/public/pdf/source/20170505/1493957838062.pdf
24 | 1 | 10uF | C68 | C0603 | 10uF | FCC0603X106K100CT | FOJAN | C5137565 | LCSC | 2 | 10uF | FCC0603X106K100CT | gge1894 | https://item.szlcsc.com/datasheet/FCC0603X106K100CT/5747017.html
25 | 2 | 12pF | C114,C115 | C0402 | 12pF | CC0402JRNPO9BN120 | YAGEO | C106201 | LCSC | 2 | 12pF | CC0402JRNPO9BN120 | gge693_1,gge694_1 | https://item.szlcsc.com/datasheet/CC0402JRNPO9BN120/107416.html
26 | 1 | 2.2uF | C127 | C0402 | 2.2uF | CC0402KRX5R6BB225 | YAGEO | C326606 | LCSC | 2 | 2.2uF | CC0402KRX5R6BB225 | gge637 | https://atta.szlcsc.com/upload/public/pdf/source/20181031/C326606_B801EDDCFBA8B15C0DF0980A1CD00BE3.pdf
27 | 1 | WAFER-GH1.25-3PWB | CN1 | CONN-TH_3P-P1.25_GH1.25 |  | WAFER-GH1.25-3PWB | XUNPU | C3029378 | LCSC | 5 | WAFER-GH1.25-3PWB | WAFER-GH1.25-3PWB | gge1632 | https://item.szlcsc.com/datasheet/WAFER-GH1.25-3PWB/3561390.html
28 | 1 | XT30(2+2)PB-M.G.B | CN2 | CONN-TH_XT30PB-M |  | XT30(2+2)PB-M.G.B | AMASS | C19268029 | LCSC | 4 | XT30(2+2)PB-M.G.B | XT30(2+2)PB-M.G.B | gge1096 | https://item.szlcsc.com/datasheet/XT30(2%252B2)PB-M.G.B/20526040.html
29 | 3 | XH-2A | CN3,CN4,CN9 | CONN-TH_XH-2A |  | XH-2A | BOOMELE | C20079 | LCSC | 2 | XH-2A | XH-2A | gge68_1,gge68_2,gge68_3 | https://atta.szlcsc.com/upload/public/pdf/source/20151225/1457707654857.pdf
30 | 1 | A1252WV-S-2P | CN5 | CONN-SMD_A1252WV-S-2P |  | A1252WV-S-2P | CJT | C400040 | LCSC | 4 | A1252WV-S-2P | A1252WV-S-2P | gge1633 | https://item.szlcsc.com/datasheet/A1252WV-S-2P/383469.html
31 | 1 | KH-FG0.5-H2.0-30PIN | CN6 | FPC-SMD_KH-FG0.5-H2.0-30PIN |  | KH-FG0.5-H2.0-30PIN | kinghelm | C2797216 | LCSC | 32 | KH-FG0.5-H2.0-30PIN | KH-FG0.5-H2.0-30PIN | gge211 | https://item.szlcsc.com/datasheet/KH-FG0.5-H2.0-30PIN/2935748.html
32 | 1 | PESD1CAN | D1 | SOT-23-3_L2.9-W1.6-P1.90-LS2.8-BR |  | PESD1CAN | BORN | C343993 | LCSC | 3 | PESD1CAN | PESD1CAN_C343993 | gge152_6 | https://atta.szlcsc.com/upload/public/pdf/source/20181211/C343993_AF595724ADB82F42A1C256C97FD7AD6B.pdf
33 | 2 | 1N5819WS | D2,D3 | SOD-323_L1.8-W1.3-LS2.5-RD |  | 1N5819WS | Hottech | C191023 | LCSC | 2 | 1N5819WS | 1N5819WS | gge1118,gge1119 | https://item.szlcsc.com/datasheet/1N5819WS/213850.html
34 | 1 | SMBJ60A | D4 | SMB_L4.5-W3.7-LS5.4-RD |  | SMBJ60A | R+O | C49066953 | LCSC | 2 | SMBJ60A | SMBJ60A_C49066953 | gge346 | https://item.szlcsc.com/datasheet/SMBJ60A/51438149.html
35 | 1 | PMEG4010BEA,115 | D5 | SOD-323_L1.8-W1.3-LS2.5-RD |  | PMEG4010BEA,115 | Nexperia | C36975 | LCSC | 2 | PMEG4010BEA,115 | PMEG4010BEA | gge215 | https://item.szlcsc.com/datasheet/PMEG4010BEA%252C115/37953.html
36 | 3 | RCLAMP0524P | D6,D7,D8 | DFN2510-10_L2.5-W1.0-P0.50-BL |  | RCLAMP0524P | TECH PUBLIC | C907837 | LCSC | 10 | RCLAMP0524P | RCLAMP0524P_C907837 | gge1651,gge1651_0,gge1652 | https://item.szlcsc.com/datasheet/RCLAMP0524P/973924.html
37 | 1 | FPC-0.5AZF2-30PLCR5 | FPC1 | FPC-SMD_FPC-0.5AZF2-30PLCR5 |  | FPC-0.5AZF2-30PLCR5 | XUNPU | C54796568 | LCSC | 32 | FPC-0.5AZF2-30PLCR5 | FPC-0.5AZF2-30PLCR5 | gge1617 | https://item.szlcsc.com/datasheet/FPC-0.5AZF2-30PLCR5/58238189.html
38 | 1 | FPC-0.5AZF2-16PLCR5 | FPC3 | FPC-SMD_FPC-0.5AZF2-16PLCR5 |  | FPC-0.5AZF2-16PLCR5 | XUNPU | C54796561 | LCSC | 18 | FPC-0.5AZF2-16PLCR5 | FPC-0.5AZF2-16PLCR5 | gge1616 | https://item.szlcsc.com/datasheet/FPC-0.5AZF2-16PLCR5/58238182.html
39 | 1 | HB-PH9-254220PB2GOW | H2 | CONN-SMD_HB-PH9-254220PB2GOW |  | HB-PH9-254220PB2GOW | HANBO | C42396895 | LCSC | 40 | HB-PH9-254220PB2GOW | HB-PH9-254220PB2GOW | gge1897_0 | https://item.szlcsc.com/datasheet/HB-PH9-254220PB2GOW/44346235.html
40 | 4 | MPZ2012S101ATD25 | L2,L3,L4,L5 | L0805 |  | MPZ2012S101ATD25 | TDK | C307776 | LCSC | 2 | MPZ2012S101ATD25 | MPZ2012S101ATD25 | gge1124,gge1125,gge1126,gge1127 | https://item.szlcsc.com/datasheet/MPZ2012S101ATD25/291450.html
41 | 1 | BLM31PG121SN1L | L6 | L1206 |  | BLM31PG121SN1L | muRata | C85841 | LCSC | 2 | BLM31PG121SN1L | BLM31PG121SN1L | gge1898 | https://item.szlcsc.com/datasheet/BLM31PG121SN1L/87017.html
42 | 1 | 10uH | L7 | IND-SMD_L2.5-W2.0 | 10uH | FTC252012S100MBCA | cjiang | C5832376 | LCSC | 2 | 10uH | FTC252012S100MBCA | gge214 | https://atta.szlcsc.com/upload/public/pdf/source/20230602/8FFEDA9C0247A92A0D4B67554BFE4091.pdf
43 | 1 | ACT45B-101-2P-TL003 | L8 | FILTER-SMD_4P-L4.5-W3.2-TL_ACT45B |  | ACT45B-101-2P-TL003 | TDK | C88056 | LCSC | 4 | ACT45B-101-2P-TL003 | ACT45B-101-2P-TL003 | gge146_4 | https://atta.szlcsc.com/upload/public/pdf/source/20161123/1479873126504.pdf
44 | 2 | 2.2uH | L9,L14 | IND-SMD_L2.5-W2.0_WPN252012H | 2.2uH | WPN252012H2R2MT | Sunlord | C98350 | LCSC | 2 | 2.2uH | WPN252012H2R2MT | gge663_1,gge663_2 | https://atta.szlcsc.com/upload/public/pdf/source/20231024/AA72387348CB63159A6CBE41DDE5ECDA.pdf
45 | 1 | 3.3uH | L10 | IND-SMD_L4.4-W4.2_SPM4020T | 3.3uH | PCR0420-3R3-M | JIERR | C53896857 | LCSC | 2 | 3.3uH | PCR0420-3R3-M | gge1893 | https://item.szlcsc.com/datasheet/PCR0420-3R3-M/57092539.html
46 | 1 | 10uH | L11 | IND-SMD_L7.3-W6.8 | 10uH | FXL0630-100-M | cjiang | C167223 | LCSC | 2 | 10uH | FXL0630-100-M | gge1899 | https://atta.szlcsc.com/upload/public/pdf/source/20240426/3189EA8206330E2108542F9E34E540E7.pdf
47 | 1 | BLM18PG121SN1D | L13 | L0603 |  | BLM18PG121SN1D | muRata | C14709 | LCSC | 2 | BLM18PG121SN1D | BLM18PG121SN1D_C14709 | gge639 | https://atta.szlcsc.com/upload/public/pdf/source/20130704/1457706621422.pdf
48 | 2 | SQSA84CENW-T1_GE3 | Q1,Q2 | WDFN-5_L3.1-W3.1-P0.65-BL_1 |  | SQSA84CENW-T1_GE3 | VISHAY | C20346183 | LCSC | 5 | SQSA84CENW-T1_GE3 | SQSA84CENW-T1_GE3 | gge1130,gge1131 | https://item.szlcsc.com/datasheet/SQSA84CENW-T1_GE3/21671711.html
49 | 1 | 6.49kΩ | R1 | R0402 | 6.49kΩ | RT0402BRD076K49L | YAGEO | C852898 | LCSC | 2 | 6.49kΩ | RT0402BRD076K49L | gge1088 | https://item.szlcsc.com/datasheet/RT0402BRD076K49L/913220.html
50 | 1 | 200kΩ | R2 | R0402 | 200kΩ | 0402WGF2003TCE | UNI-ROYAL | C25764 | LCSC | 2 | 200kΩ | 0402WGF2003TCE | gge1637 | https://item.szlcsc.com/datasheet/0402WGF2003TCE/26507.html
51 | 12 | 4.7kΩ | R3,R19,R20,R21,R31,R32,R98,R99,R100,R102,R122,R125 | R0402 | 4.7kΩ | RC0402FR-074K7L | YAGEO | C105871 | LCSC | 2 | 4.7kΩ | RC0402FR-074K7L | gge652,gge653,gge654,gge655,gge1116,gge1116_0,gge1116_1,gge1117,gge1117_0,gge1117_1,gge1121,gge1122 | https://item.szlcsc.com/datasheet/RC0402FR-074K7L/107086.html
52 | 3 | 10kΩ | R4,R18,R25 | R0402 | 10kΩ | 0402WGF1002TCE | UNI-ROYAL | C25744 | LCSC | 2 | 10kΩ | 0402WGF1002TCE | gge1061,gge1061_0,gge1061_1 | https://item.szlcsc.com/datasheet/0402WGF1002TCE/26487.html
53 | 1 | 5mΩ | R5 | R1206 | 5mΩ | RE1206F1R005 | JIERR | C46961735 | LCSC | 2 | 5mΩ | RE1206F1R005 | gge1123 | https://item.szlcsc.com/datasheet/RE1206F1R005/49133274.html
54 | 1 | 10kΩ | R8 | R0402 | 10kΩ | RC0402FR-0710KL | YAGEO | C60490 | LCSC | 2 | 10kΩ | RC0402FR-0710KL | gge1648 | https://item.szlcsc.com/datasheet/RC0402FR-0710KL/61542.html
55 | 1 | 41.2kΩ | R9 | R0402 | 41.2kΩ | FRC0402F4122TS | FOJAN | C2998053 | LCSC | 2 | 41.2kΩ | FRC0402F4122TS | gge101_1
56 | 1 | 100kΩ | R10 | R0402 | 100kΩ | THC02G1003BT | FH | C47120018 | LCSC | 2 | 100kΩ | THC02G1003BT | gge1893_0 | https://item.szlcsc.com/datasheet/THC02G1003BT/49315420.html
57 | 1 | 15kΩ | R11 | R0402 | 15kΩ | FRC0402F1502TS | FOJAN | C2909322 | LCSC | 2 | 15kΩ | FRC0402F1502TS | gge1895 | https://item.szlcsc.com/datasheet/FRC0402F1502TS/3186257.html
58 | 1 | 110kΩ | R12 | R0402 | 110kΩ | FRC0402F1103TS | FOJAN | C2909311 | LCSC | 2 | 110kΩ | FRC0402F1103TS | gge1896 | https://item.szlcsc.com/datasheet/FRC0402F1103TS/3186246.html
59 | 2 | 10kΩ | R14,R34 | R0402 | 10kΩ | FRC0402F1002TS | FOJAN | C2906861 | LCSC | 2 | 10kΩ | FRC0402F1002TS | gge151_1,gge1091_1 | https://item.szlcsc.com/datasheet/FRC0402F1002TS/3180374.html
60 | 1 | 48.7kΩ | R15 | R0402 | 48.7kΩ | RT0402BRD0748K7L | YAGEO | C852805 | LCSC | 2 | 48.7kΩ | RT0402BRD0748K7L | gge1058 | https://item.szlcsc.com/datasheet/RT0402BRD0748K7L/913127.html
61 | 6 | 1kΩ | R16,R17,R22,R33,R87,R97 | R0402 | 1kΩ | RC0402FR-071KL | YAGEO | C106235 | LCSC | 2 | 1kΩ | RC0402FR-071KL | gge182_3,gge633,gge1091,gge1091_0,gge1092,gge1092_0 | https://item.szlcsc.com/datasheet/RC0402FR-071KL/107450.html
62 | 1 | 100kΩ | R23 | R0402 | 100kΩ | AC0402FR-07100KL | YAGEO | C144809 | LCSC | 2 | 100kΩ | AC0402FR-07100KL | gge120 | https://item.szlcsc.com/datasheet/AC0402FR-07100KL/156141.html
63 | 1 | 20kΩ | R24 | R0402 | 20kΩ | FRC0402F2002TS | FOJAN | C2906867 | LCSC | 2 | 20kΩ | FRC0402F2002TS | gge121 | https://item.szlcsc.com/datasheet/FRC0402F2002TS/3180380.html
64 | 1 | 5.1Ω | R26 | R0402 | 5.1Ω | FRC0402F5R10TS | FOJAN | C2909363 | LCSC | 2 | 5.1Ω | FRC0402F5R10TS | gge215_0 | https://item.szlcsc.com/datasheet/FRC0402F5R10TS/3186298.html
65 | 2 | 30kΩ | R27,R119 | R0402 | 30kΩ | RC0402FR-0730KL | YAGEO | C138008 | LCSC | 2 | 30kΩ | RC0402FR-0730KL | gge1079_4,gge1079_5 | https://item.szlcsc.com/datasheet/RC0402FR-0730KL/149324.html
66 | 1 | 6.8kΩ | R28 | R0402 | 6.8kΩ | FRC0402F6801TS | FOJAN | C2906876 | LCSC | 2 | 6.8kΩ | FRC0402F6801TS | gge662_2
67 | 1 | 61.9kΩ | R30 | R0402 | 61.9kΩ | FRC0402F6192TS | FOJAN | C2933106 | LCSC | 2 | 61.9kΩ | FRC0402F6192TS | gge125_1
68 | 2 | 0Ω | R35,R36 | R0402 | 0Ω | FRC0402F0000TS | FOJAN | C2906858 | LCSC | 2 | 0Ω | FRC0402F0000TS | gge1634,gge1635 | https://item.szlcsc.com/datasheet/FRC0402F0000TS/3180371.html
69 | 2 | 60.4Ω | R70,R72 | R0402 | 60.4Ω | RC0402FR-0760R4L | YAGEO | C137954 | LCSC | 2 | 60.4Ω | RC0402FR-0760R4L | gge1373_0,gge1374_0 | https://item.szlcsc.com/datasheet/RC0402FR-0760R4L/149270.html
70 | 1 | 15kΩ | R96 | R0402 | 15kΩ | RC0402FR-0715KL | YAGEO | C114761 | LCSC | 2 | 15kΩ | RC0402FR-0715KL | gge632 | https://atta.szlcsc.com/upload/public/pdf/source/20180821/C275644_0D56F95EFF785E7D9A1FEF436B37DA78.pdf
71 | 1 | 2.49kΩ | R101 | R0402 | 2.49kΩ | RC0402FR-072K49L | YAGEO | C145071 | LCSC | 2 | 2.49kΩ | RC0402FR-072K49L | gge634 | https://item.szlcsc.com/datasheet/RC0402FR-072K49L/156403.html
72 | 1 | 49.9kΩ | R121 | R0402 | 49.9kΩ | RC0402FR-0749K9L | YAGEO | C137969 | LCSC | 2 | 49.9kΩ | RC0402FR-0749K9L | gge662_1 | https://item.szlcsc.com/datasheet/RC0402FR-0749K9L/149285.html
73 | 2 | 470Ω | R123,R124 | R0402 | 470Ω | 0402WGF4700TCE | UNI-ROYAL | C25117 | LCSC | 2 | 470Ω | 0402WGF4700TCE | gge1353,gge1354 | https://item.szlcsc.com/datasheet/0402WGF4700TCE/25860.html
74 | 1 | HR911130A | RJ1 | RJ45-TH_HR911130A |  | HR911130A | HANRUN | C54408 | LCSC | 16 | HR911130A | HR911130A | gge556_2 | https://atta.szlcsc.com/upload/public/pdf/source/20151014/1457707458393.pdf
75 | 1 | MCP2518FDT-E/QBB | U1 | VDFN-14_L4.5-W3.0-P0.65-BL-EP |  | MCP2518FDT-E/QBB | MICROCHIP | C621395 | LCSC | 15 | MCP2518FDT-E/QBB | MCP2518FDT-E/QBB | gge1133 | https://item.szlcsc.com/datasheet/MCP2518FDT-E%252FQBB/651400.html
76 | 1 | TCAN1044VDRBRQ1 | U2 | VSON-8_L3.0-W3.0-P0.65-BR-EP |  | TCAN1044VDRBRQ1 | TI | C5215851 | LCSC | 9 | TCAN1044VDRBRQ1 | TCAN1044VDRBRQ1 | gge1134 | https://www.ti.com.cn/cn/lit/ds/symlink/tcan1044-q1.pdf
77 | 11 | RCLAMP0522P | U3,U10,U15,U16,U17,U18,U19,U20,U21,U22,U23 | DFN-6_L1.6-W1.0-P0.50-BL |  | RCLAMP0522P | TECH PUBLIC | C2937020 | LCSC | 6 | RCLAMP0522P | RCLAMP0522P_C2937020 | gge1654,gge1654_0,gge1654_1,gge1654_2,gge1654_3,gge1654_4,gge1654_5,gge1654_6,gge1654_7,gge1654_8,gge1654_9 | https://item.szlcsc.com/datasheet/RCLAMP0522P/3290367.html
78 | 1 | TPA3118D2DAPR | U4 | HTSSOP-32_L11.0-W6.1-P0.65-LS8.1-BL-EP |  | TPA3118D2DAPR | TI | C46497 | LCSC | 33 | TPA3118D2DAPR | TPA3118D2DAPR | gge1090 | https://www.ti.com/cn/lit/gpn/tpa3118d2
79 | 1 | MT9201 | U5 | SOT-23-6_L2.9-W1.6-P0.95-LS2.8-BR |  | MT9201 | Xi’an Aerospace Minxin | C182966 | LCSC | 6 | MT9201 | MT9201 | gge213 | https://item.szlcsc.com/datasheet/MT9201/194368.html
80 | 1 | PCF8563TS/5,118 | U6 | TSSOP-8_L3.0-W3.0-P0.65-LS4.9-BL |  | PCF8563TS/5,118 | NXP | C27397 | LCSC | 8 | PCF8563TS/5,118 | PCF8563TS/5,118 | gge1135 | https://www.nxp.com.cn/docs/zh/data-sheet/PCF8563.pdf
81 | 1 | ATECC608A-SSHDA-T | U7 | SOIC-8_L4.9-W3.9-P1.27-LS6.0-BL |  | ATECC608A-SSHDA-T | MICROCHIP | C616024 | LCSC | 8 | ATECC608A-SSHDA-T | ATECC608A-SSHDA-T_C616024 | gge1630 | https://item.szlcsc.com/datasheet/ATECC608A-SSHDA-T/646002.html
82 | 1 | SN74LVC2G17DBVR | U8 | SOT-23-6_L2.9-W1.6-P0.95-LS2.8-BL |  | SN74LVC2G17DBVR | TI | C10429 | LCSC | 6 | SN74LVC2G17DBVR | SN74LVC2G17DBVR | gge1628 | https://www.ti.com/cn/lit/gpn/sn74lvc2g17
83 | 1 | TPS7A2028PDBVR | U9 | SOT-23-5_L2.9-W1.6-P0.95-LS2.8-BR |  | TPS7A2028PDBVR | TI | C2869847 | LCSC | 5 | TPS7A2028PDBVR | TPS7A2028PDBVR | gge1620 | https://www.ti.com/cn/lit/ds/symlink/tps7a20.pdf
84 | 2 | ETA3409S2F | U11,U35 | SOT-23-5_L2.9-W1.6-P0.95-LS2.8-BL |  | ETA3409S2F | ETA | C7465553 | LCSC | 5 | ETA3409S2F | ETA3409S2F | gge656_1,gge656_2 | https://atta.szlcsc.com/upload/public/pdf/source/20230717/1A18EB96698AD4DC30E5926DF3CDB8A4.pdf
85 | 1 | LM5148RGYR | U12 | VQFN-24_L5.5-W3.5-P0.50-BL-EP-2 |  | LM5148RGYR | TI | C7470701 | LCSC | 25 | LM5148RGYR | LM5148RGYR | gge79_1 | https://item.szlcsc.com/datasheet/LM5148RGYR/8521547.html
86 | 1 | TPS7A2018PDBVR | U13 | TSOT-23-5_L2.9-W1.6-P0.95-LS2.8-BL |  | TPS7A2018PDBVR | TI | C963430 | LCSC | 5 | TPS7A2018PDBVR | TPS7A2018PDBVR | gge1619_0 | https://www.ti.com/cn/lit/gpn/tps7a20
87 | 1 | BMI088 | U14 | LGA-16_L4.5-W3.0-P0.50-BL |  | BMI088 | Bosch | C194919 | LCSC | 16 | BMI088 | BMI088 | gge1631 | https://item.szlcsc.com/datasheet/BMI088/239391.html
88 | 1 | RTL8125BG-CG | U34 | TQFN-48_L6.0-W6.0-P0.40-BL-EP4.5 |  | RTL8125BG-CG | REALTEK | C3013605 | LCSC | 49 | RTL8125BG-CG | RTL8125BG-CG | gge631
89 | 1 | RS0104YUTQH12 | U36 | QFN-12_L2.0-W1.7-P0.40-BL |  | RS0104YUTQH12 | RUNIC | C5372422 | LCSC | 12 | RS0104YUTQH12 | RS0104YUTQH12 | gge671_1 | https://item.szlcsc.com/datasheet/RS0104YUTQH12/6223474.html
90 | 1 | SY8113IADC | U78 | TSOT-23-6_L2.9-W1.6-P0.95-LS2.8-BL |  | SY8113IADC | Silergy | C479075 | LCSC | 6 | SY8113IADC | SY8113IADC | gge1892 | https://item.szlcsc.com/datasheet/SY8113IADC/486367.html
91 | 1 | 32.768kHz | X1 | OSC-SMD_L3.2-W1.5 | 32.768kHz | SC-32S32.768kHz20PPM12.5pF | Seiko | C97606 | LCSC | 2 | 32.768kHz | SC-32S32.768kHz20PPM12.5pF | gge1113 | https://atta.szlcsc.com/upload/public/pdf/source/20170713/C97606_1499914220652816606.pdf
92 | 1 | 20MHz | X2 | CRYSTAL-SMD_3P-L3.2-W1.3-P1.2-BL | 20MHz | CSTNE20M0V530000R0 | muRata | C882604 | LCSC | 3 | 20MHz | CSTNE20M0V530000R0 | gge1136 | https://atta.szlcsc.com/upload/public/pdf/source/20201228/C882604_347FF01650DA2E09F24949E4003C4D77.pdf
93 | 1 | 25MHz | X3 | CRYSTAL-SMD_4P-L2.0-W1.6-BL-A | 25MHz | XC21M4-25.000-F12NLDTL | HCI | C3034312 | LCSC | 4 | 25MHz | XC21M4-25.000-F12NLDTL | gge1624 | https://item.szlcsc.com/datasheet/XC21M4-25.000-F12NLDTL/3578870.html
