oznav2/tectile_skin/hardware/02_PCB/07_RBE-PWR-HOTSWAP/01_BOM_HOTSWAP_2026-09-18.xlsx

No. | Quantity | Comment | Designator | Footprint | Value | Manufacturer Part | Manufacturer | Supplier Part | Supplier
1 | 4 | 1uF | C1,C22,C23,C24 | C0603 | 1uF | TCC0603X7R473J500CT | CCTC |  | LCSC
2 | 4 | 1UF | C2,C3,C4,C5 | C0603 | 1UF | TCC0603X7R473J500CT | CCTC |  | LCSC
3 | 1 | 10UF | C6 | C0603 | 10UF | TCC0603X7R473J500CT | CCTC |  | LCSC
4 | 4 | 10nF | C7,C17,C21,C32 | C0603 | 10nF | TCC0603X7R473J500CT | CCTC |  | LCSC
5 | 5 | 100nF | C18,C19,C20,C30,C31 | C0603 | 100nF | TCC0603X7R473J500CT | CCTC |  | LCSC
6 | 1 | 10uF | C25 | C0603 | 10uF | TCC0603X7R473J500CT | CCTC |  | LCSC
7 | 3 | 1N4148WS | D1,D11,D13 | SOD-323_L1.8-W1.3-LS2.5-RD |  | 1N4148WS | CJ | C2128 | LCSC
8 | 8 | WST3052 | Q1,Q2,Q3,Q4,Q5,Q6,Q11,Q14 | SOT-323-3_L2.1-W1.3-P1.30-LS2.3-BL |  | WST3052 | WINSOK | C719079 | LCSC
9 | 4 | SP60N02BGNK | Q7,Q8,Q9,Q10 | DFN-5_L4.9-W5.9-P1.27-LS6.2-BL |  | SP60N02BGNK | Siliup | C22385420 | LCSC
10 | 2 | MMBT5401W | Q12,Q13 | SOT-323-3_L2.0-W1.3-P1.30-LS2.1-BL |  | MMBT5401W | CBI | C5362105 | LCSC
11 | 1 | SS8050 | Q15 | SOT-323-3_L2.2-W1.3-P1.30-LS2.1-BR |  | SS8050 | CJ | C109068 | LCSC
12 | 1 | 2N7002W | Q16 | SOT-323-3_L2.0-W1.3-P1.30-LS2.1-BR |  | 2N7002W | R+O | C7420322 | LCSC
13 | 1 | SS8550 | Q17 | SOT-323-3_L2.0-W1.3-P1.30-LS2.1-BR |  | SS8550 | CJ | C109069 | LCSC
14 | 11 | 1K | R1,R4,R6,R8,R11,R14,R15,R19,R23,R34,R40 | R0603 | 1K | RT0603FRE10475RL | YAGEO |  | LCSC
15 | 12 | 1M | R2,R3,R5,R7,R9,R17,R18,R20,R24,R28,R37,R41 | R0603 | 1M | RT0603FRE10475RL | YAGEO |  | LCSC
16 | 5 | 10M | R10,R12,R26,R43,R46 | R0603 | 10M | RT0603FRE10475RL | YAGEO |  | LCSC
17 | 1 | 2M | R13 | R0603 | 2M | RT0603FRE10475RL | YAGEO |  | LCSC
18 | 2 | 2K | R16,R27 | R0603 | 2K | RT0603FRE10475RL | YAGEO |  | LCSC
19 | 1 | NTC | R21 | R0603 |  | NTC |  | C9900010675 | LCSC
20 | 1 | 7K | R22 | R0603 | 7K | RT0603FRE10475RL | YAGEO |  | LCSC
21 | 1 | 220K | R25 | R0603 | 220K | RT0603FRE10475RL | YAGEO |  | LCSC
22 | 8 | 100Ω | R29,R30,R31,R32,R33,R38,R39,R42 | R1206 | 100Ω | 1206W4F1000T5E | UNI-ROYAL | C17901 | LCSC
23 | 2 | 5mΩ | R35,R36 | R1206 | 5mΩ | RE1206F1R005 | JIERR | C46961735 | LCSC
24 | 1 | 10K | R44 | R0603 | 10K | RT0603FRE10475RL | YAGEO |  | LCSC
25 | 1 | 10R | R45 | R0603 | 10R | RT0603FRE10475RL | YAGEO |  | LCSC
26 | 2 | ZX-XH2.54-5PWT | U1,U3 | CONN-SMD_5P-P2.54_MEGASTAR_ZX-XH2.54-5PWT |  | ZX-XH2.54-5PWT | Megastar | C7429674 | LCSC
27 | 2 | BM3451TNDC-T28A | U2,U4 | TSSOP-28_L9.7-W4.4-P0.65-LS6.4-BL |  | BM3451TNDC-T28A |  | C2886281 | LCSC
