oznav2/tectile_skin/hardware/02_PCB/11_RBE_PWR_140WCHG/01_BOM_140WCHG_2026-09-09.xlsx

Sheet: BOM_RBE_PWR_140WCHG_1_2026-09-0
No. | Quantity | Comment | Designator | Footprint | Value | Manufacturer Part | Manufacturer | Supplier Part | Supplier | Pin Count | Name | Symbol | Unique ID | Datasheet
1 | 1 | 2.4kHz | BUZZER1 | BUZ-TH_BD12.0-P7.60-D0.6-FD | 2.4kHz | TMB12A05 | Huaneng | C96093 | LCSC | 2 | 2.4kHz | TMB12A05 | gge126 | https://item.szlcsc.com/datasheet/TMB12A05/97297.html
2 | 3 | 68uF | C1,C2,C10 | CAP-SMD_BD10.0-L10.3-W10.3-FD | 68uF | HV2A686M1010PZ | HONOR | C42436725 | LCSC | 2 | 68uF | HV2A686M1010PZ | gge30,gge31,gge33 | https://item.szlcsc.com/datasheet/HV2A686M1010PZ/44477725.html
3 | 1 | 150uF | C3 | CAP-SMD_BD10.0-L10.3-W10.3-LS10.9-FD | 150uF | HV1H157M1010PZ | HONOR | C5246563 | LCSC | 2 | 150uF | HV1H157M1010PZ | gge124 | https://item.szlcsc.com/datasheet/HV1H157M1010PZ/5957456.html
4 | 30 | 100nF | C4,C13,C16,C18,C19,C20,C22,C25,C27,C28,C29,C31,C32,C33,C34,C35,C38,C39,C40,C41,C42,C44,C45,C46,C50,C51,C52,C55,C58,C96 | C0603 | 100nF | CGA0603X7R104K500JT | HRE | C6119867 | LCSC | 2 | 100nF | 100nF,Capacitance,C_0.1uF_50V_0402 | 8cd7cb7f1f101f95,gge6,gge49,gge49_1,gge64,gge68,gge75,gge82,gge82_1,gge82_2,gge82_3,gge82_4,gge85,gge85bc56028a384ae4,gge85bc56028a384ae4_0,gge85_1,gge85_2,gge85_3,gge85_4,gge85_5,gge85_6,gge85_7,gge85_8,gge86,gge87,gge88,gge91,gge91_2,ggee5afa86f15bd4111,ggee5afa86f15bd4111_0 | https://item.szlcsc.com/datasheet/CGA0603X7R104K500JT/7062573.html
5 | 1 | 10uF | C5 | C1210 | 10uF | FS32X106K101EGG | PSA | C5156756 | LCSC | 2 | 10uF | FS32X106K101EGG | gge32 | https://item.szlcsc.com/datasheet/FS32X106K101EGG/5791227.html
6 | 1 | 22uF | C6 | C1210 | 22uF | GMK325BJ226MM-P | TAIYO YUDEN | C778721 | LCSC | 2 | 22uF | GMK325BJ226MM-P | gge38 | https://item.szlcsc.com/datasheet/GMK325BJ226MM-P/827584.html
7 | 1 | 2.2uF | C7 | C0603 | 2.2uF | CL10A225KO8NNNC | SAMSUNG | C23630 | LCSC | 2 | 2.2uF | Capacitance | gge40 | https://item.szlcsc.com/datasheet/CL10A225KO8NNNC/24366.html
8 | 1 | 4.7uF | C8 | C0603 | 4.7uF | CGA0603X5R475K250JT | HRE | C6119856 | LCSC | 2 | 4.7uF | Capacitance | gge42 | https://item.szlcsc.com/datasheet/CGA0603X5R475K250JT/7062562.html
9 | 1 | 470nF | C9 | C0603 | 470nF | CL10B474KA8NNNC | SAMSUNG | C1623 | LCSC | 2 | 470nF | Capacitance | gge43 | https://item.szlcsc.com/datasheet/CL10B474KA8NNNC/1975.html
10 | 1 | 68nF | C11 | C0603 | 68nF | CC0603KRX7R9BB683 | YAGEO | C107098 | LCSC | 2 | 68nF | Capacitance | gge47 | https://item.szlcsc.com/datasheet/CC0603KRX7R9BB683/108314.html
11 | 1 | 470pF | C12 | C0603 | 470pF | CL10B471KB8NNNC | SAMSUNG | C22396 | LCSC | 2 | 470pF | Capacitance | gge48 | https://item.szlcsc.com/datasheet/CL10B471KB8NNNC/23121.html
12 | 1 | 100pF | C14 | C0603 | 100pF | CL10C101JB8NNNC | SAMSUNG | C14858 | LCSC | 2 | 100pF | Capacitance | gge60 | https://item.szlcsc.com/datasheet/CL10C101JB8NNNC/15530.html
13 | 1 | 470nF | C15 | C0603 | 470nF | 0603B474K500NT | FH | C77572 | LCSC | 2 | 470nF | 0603B474K500NT | gge59 | https://item.szlcsc.com/datasheet/0603B474K500NT/78701.html
14 | 1 | 1nF | C17 | C0603 | 1nF | CL10B102KB8NNNC | SAMSUNG | C1588 | LCSC | 2 | 1nF | Capacitance | gge71 | https://item.szlcsc.com/datasheet/CL10B102KB8NNNC/1940.html
15 | 2 | 1uF | C21,C30 | C0603 | 1uF | CGA0603X5R105K500JT | HRE | C6119852 | LCSC | 2 | 1uF | Capacitance | gge74,gge90 | https://item.szlcsc.com/datasheet/CGA0603X5R105K500JT/7062558.html
16 | 2 | 10uF | C23,C24 | C0805 | 10uF | CGA0805X5R106K250MT | HRE | C6119887 | LCSC | 2 | 10uF | Capacitance | gge7,gge8 | https://item.szlcsc.com/datasheet/CGA0805X5R106K250MT/7062593.html
17 | 1 | 47uF | C26 | CAP-SMD_BD8.0-L8.3-W8.3-FD | 47uF | VP2A470M0810 | HONOR | C4054390 | LCSC | 2 | 47uF | VP2A470M0810 | gge19 | https://item.szlcsc.com/datasheet/VP2A470M0810/4623622.html
18 | 1 | 1uF | C36 | C0603 | 1uF | CGA0603X5R105K350JT | HRE | C6119865 | LCSC | 2 | 1uF | CGA0603X5R105K350JT | gge96 | https://item.szlcsc.com/datasheet/CGA0603X5R105K350JT/7062571.html
19 | 2 | 2.2uF | C37,C57 | C0603 |  | CL10A225KB8NNNC | SAMSUNG | C913904 | LCSC | 2 | 2.2uF | 2.2uF | ggeb94a525588fa0987,ggeb94a525588fa0987_0
20 | 4 | 10uF | C53,C54,C59,C61 | C0603 |  | GRM188R6YA106MA73D | muRata | C194427 | LCSC | 2 | 10uF | 10uF | gge53c2a9c55d2eb354,gge53c2a9c55d2eb354_0,ggef478a34fe6f5b412,ggef478a34fe6f5b412_0
21 | 1 | ZX-XH2.54-2PWT | CN1 | CONN-SMD_2P-P2.50-WT |  | ZX-XH2.54-2PWT | Megastar | C7429671 | LCSC | 4 | ZX-XH2.54-2PWT | XH2.54-2P | gge133 | https://item.szlcsc.com/datasheet/ZX-XH2.54-2PWT/8427588.html
22 | 1 | BAT46WS | D1 | SOD-323_L1.8-W1.3-LS2.5-RD |  | BAT46WS | FUXINSEMI | C908225 | LCSC | 2 | BAT46WS | BAT46WS_C908225 | gge5 | https://item.szlcsc.com/datasheet/BAT46WS/974467.html
23 | 1 | BAT46WS | D2 | SOD-323_L1.8-W1.3-LS2.5-FD |  | BAT46WS | YANGJIE | C968054 | LCSC | 2 | BAT46WS | BAT46WS_C968054 | gge39 | https://item.szlcsc.com/datasheet/BAT46WS/1054931.html
24 | 1 | 1N5819WS | D3 | SOD-323_L1.8-W1.3-LS2.5-RD |  | 1N5819WS | Hottech | C191023 | LCSC | 2 | 1N5819WS | 1N5819WS | gge52 | https://item.szlcsc.com/datasheet/1N5819WS/213850.html
25 | 2 | 1N4148WS | D5,D6 | SOD-323_L1.8-W1.3-LS2.5-RD |  | 1N4148WS | CJ | C2128 | LCSC | 2 | 1N4148WS | 1N4148WS T4 | gge69,gge69_1 | https://item.szlcsc.com/datasheet/1N4148WS/2485.html
26 | 1 | PSM712-ES | D18 | SOT23-3 |  | PSM712-ES | ElecSuper | C5180294 | LCSC | 3 | PSM712-ES | D_ESD_PSM712 | eed2a997abc83db1 | https://item.szlcsc.com/datasheet/PSM712-ES/5837632.html
27 | 1 | 5A | F1 | FUSE-SMD_L6.1-W2.6 |  | 5A | Littelfuse | C48467 | LCSC | 2 | 5A | 0451005.MRL | gge16 | https://item.szlcsc.com/datasheet/0451005.MRL/49474.html
28 | 2 | HDR-F_2.54_2x4 | H1,H2 | HDR-TH_8P-P2.54-V-F-R2-C4-S2.54-1 |  |  |  | C92271 |  | 8 |  | HDR-F-2.54_2x4 | gge128_0,gge129_0
29 | 1 | HDR-F_2.54_2x10 | H3 | HDR-TH_20P-P2.54-V-R2-C10-S2.54 |  |  |  | C30867 |  | 20 |  | HDR-F-2.54_2x10 | gge113
30 | 1 | HDR-M_2.54_2x10 | H4 | HDR-TH_20P-P2.54-V-M-R2-C10-S2.54 |  |  |  |  |  | 20 |  | HDR-M-2.54_2x10 | gge114
31 | 1 | SYCDM30P11R1 | J14 | J_SYCDM30P11R1 | A01MA16B-M05E01A |  |  |  |  | 11 | SYCDM30P11R1 | J_SYCDM30P11R1 | 279d117cb1c13a50
32 | 1 | 10uH | L1 | IND-SMD_L11.5-W10.0_FXL1040 | 10uH | FXL1050-100-M | cjiang | C5359264 | LCSC | 2 | 10uH | FXL1050-100-M | gge35 | https://item.szlcsc.com/datasheet/FXL1050-100-M/6172040.html
33 | 1 | 47uH | L2 | IND-SMD_L18.3-W17.0 | 47uH | YSPIA1770-470M | YJYCOIN | C2971891 | LCSC | 2 | 47uH | YSPIA1770-470M | gge26 | https://atta.szlcsc.com/upload/public/pdf/source/20220124/AFD3580CA341458E8A85A27ABB6A909D.pdf
34 | 2 | 22uH | L3,L4 | IND-SMD_L4.5-W4.1_SRP4020TA | 22uH | PSPMAA0402-220M-ANP | PROD | C5273842 | LCSC | 2 | 22uH | PSPMAA0402-220M-ANP | gge28,gge28_0 | https://item.szlcsc.com/datasheet/PSPMAA0402-220M-ANP/6003692.html
35 | 1 | TC5050RGBF08-3CJH-AF53A | LED1 | LED-SMD_6P-L5.0-W5.0-TL_TC5050RGBF08 |  | TC5050RGBF08-3CJH-AF53A | TCWIN | C784540 | LCSC | 6 | TC5050RGBF08-3CJH-AF53A | TC5050RGBF08-3CJH-AF53A | gge108 | https://item.szlcsc.com/datasheet/TC5050RGBF08-3CJH-AF53A/839886.html
36 | 1 | מודול OLED ‏0.96‏ _4P | OLED1 | 0.96OLED_4P |  |  |  |  |  | 4 |  | מודול OLED ‏0.96‏ _4P | gge109
37 | 3 | S8050 | Q1,Q2,Q3 | SOT-23-3_L3.0-W1.7-P0.95-LS2.9-BR |  | S8050 | CJ | C2146 | LCSC | 3 | S8050 | S8050_C2146 | gge11,gge11_0,gge11_1 | https://item.szlcsc.com/datasheet/S8050%2520J3Y(RANGE%253A200-350)/2503.html
38 | 1 | FMMT417TD | Q4 | SOT-23-3_L2.9-W1.3-P1.90-LS2.4-BR |  | FMMT417TD | DIODES | C508216 | LCSC | 3 | FMMT417TD | FMMT417TD | gge17 | https://atta.szlcsc.com/upload/public/pdf/source/20200407/C508216_1B21C919DFEEE5E3D3F09687EF246F0D.pdf
39 | 2 | BSC0805LS | Q5,Q7 | PG-TDSON-8_L5.2-W5.9-P1.27-LS6.2-BL-EP |  | BSC0805LS | Infineon | C534374 | LCSC | 9 | BSC0805LS | BSC0805LS | gge25,gge34 | https://item.szlcsc.com/datasheet/BSC0805LS/554758.html
40 | 1 | HSBA0119 | Q6 | TDSON-8_L5.9-W5.2-P1.27-BL-1 |  | HSBA0119 | HUASHUO | C53244070 | LCSC | 5 | HSBA0119 | HSBA0119 | gge18 | https://item.szlcsc.com/datasheet/HSBA0119/56300310.html
41 | 1 | 221kΩ | R1 | R0603 | 221kΩ | FRC0603F2213TS | FOJAN | C7467463 | LCSC | 2 | 221kΩ | נגד | gge41 | https://item.szlcsc.com/datasheet/FRC0603F2213TS/8514079.html
42 | 1 | 210kΩ | R2 | R0603 | 210kΩ | FRC0603F2103TS | FOJAN | C2933168 | LCSC | 2 | 210kΩ | נגד | gge23
43 | 9 | 1kΩ | R3,R18,R34,R38,R43,R51,R54,R56,R58 | R0603 | 1kΩ | FRC0603F1001TS | FOJAN | C2907002 | LCSC | 2 | 1kΩ | נגד | gge10,gge10_0,gge10_2,gge53,gge73,gge89,gge89_3,gge119,gge130
44 | 1 | 36kΩ | R4 | R0603 | 36kΩ | FRC0603F3602TS | FOJAN | C2930097 | LCSC | 2 | 36kΩ | נגד | gge44
45 | 1 | 82kΩ | R5 | R0603 | 82kΩ | FRC0603F8202TS | FOJAN | C2907072 | LCSC | 2 | 82kΩ | נגד | gge45
46 | 5 | 100kΩ | R6,R16,R20,R31,R48 | R0603 | 100kΩ | 0603WAF1003T5E | UNI-ROYAL | C25803 | LCSC | 2 | 100kΩ | 100K, נגד | gge13,gge14,gge44d86ec776fb3fc6,gge44d86ec776fb3fc6_0,gge80 | https://item.szlcsc.com/datasheet/0603WAF1003T5E/26546.html
47 | 2 | 24kΩ | R7,R53 | R0603 | 24kΩ | 0603WAF2402T5E | UNI-ROYAL | C23352 | LCSC | 2 | 24kΩ | 24kΩ | gge0da9252778c788c6,gge0da9252778c788c6_0 | https://item.szlcsc.com/datasheet/0603WAF2402T5E/24085.html
48 | 1 | 10mΩ | R8 | R2512 | 10mΩ | RE2512F3R010 | JIERR | C46961753 | LCSC | 2 | 10mΩ | RE2512F3R010 | gge29 | https://item.szlcsc.com/datasheet/RE2512F3R010/49133292.html
49 | 1 | 1.62kΩ | R9 | R0603 | 1.62kΩ | RT0603BRD071K62L | YAGEO | C705742 | LCSC | 2 | 1.62kΩ | נגד | gge56 | https://item.szlcsc.com/datasheet/RT0603BRD071K62L/742262.html
50 | 1 | 68.1kΩ | R10 | R0603 | 68.1kΩ | RT0603BRD0768K1L | YAGEO | C861521 | LCSC | 2 | 68.1kΩ | נגד | gge57 | https://item.szlcsc.com/datasheet/RT0603BRD0768K1L/921859.html
51 | 1 | 3.65kΩ | R11 | R0603 | 3.65kΩ | RT0603BRD073K65L | YAGEO | C705773 | LCSC | 2 | 3.65kΩ | נגד | gge58 | https://atta.szlcsc.com/upload/public/pdf/source/20200720/C705773_9345DB94710983EA8D0D98D8260D0374.pdf
52 | 5 | 100Ω | R12,R21,R22,R27,R40 | R0603 | 100Ω | RC0603FR-07100RL | YAGEO | C105588 | LCSC | 2 | 100Ω | נגד | gge61,gge62,gge65,gge66,gge73_1 | https://atta.szlcsc.com/upload/public/pdf/source/20180316/70C0E2BDAE7FCC62C531A5A58D202EE1.pdf
53 | 1 | 20kΩ | R13 | R0603 | 20kΩ | 0603WAF2002T5E | UNI-ROYAL | C4184 | LCSC | 2 | 20kΩ | נגד | gge46 | https://item.szlcsc.com/datasheet/0603WAF2002T5E/4591.html
54 | 1 | 3.3Ω | R14 | R0603 | 3.3Ω | FRC0603F3R30TS | FOJAN | C2930016 | LCSC | 2 | 3.3Ω | נגד | gge50
55 | 5 | 10kΩ | R15,R24,R32,R39,R52 | R0603 | 10kΩ | FRC0603J103 TS | FOJAN | C2930027 | LCSC | 2 | 10kΩ | נגד | gge15,gge51,gge70,gge70_0,gge92 | https://item.szlcsc.com/datasheet/FRC0603J103%2520TS/3266960.html
56 | 2 | 47kΩ | R17,R30 | R0603 | 47kΩ | FRC0603F4702TS | FOJAN | C2907042 | LCSC | 2 | 47kΩ | נגד | gge4,gge78,gge78_0
57 | 1 | 0Ω | R19 | R0603 | 0Ω | RC0603FR-070RL | YAGEO | C100044 | LCSC | 2 | 0Ω | נגד | gge54 | https://item.szlcsc.com/datasheet/RC0603FR-070RL/101258.html
58 | 1 | 49.9kΩ | R23 | R0603 | 49.9kΩ | RT0603BRD0749K9L | YAGEO | C705780 | LCSC | 2 | 49.9kΩ | נגד | gge67 | https://atta.szlcsc.com/upload/public/pdf/source/20200720/C705780_F3A910B126B710106636B4713CA67D34.pdf
59 | 1 | 1Ω | R25 | R0603 | 1Ω | FRC0603J1R0 TS | FOJAN | C2907116 | LCSC | 2 | 1Ω | נגד | gge55
60 | 10 | 4.7kΩ | R26,R33,R35,R36,R37,R41,R46,R49,R50,R57 | R0603 | 4.7kΩ | RC0603FR-074K7L | YAGEO | C99782 | LCSC | 2 | 4.7kΩ | נגד | gge72,gge79,gge81,gge83,gge83_1,gge83_2,gge83_4,gge83_5,gge84,gge84_1 | https://item.szlcsc.com/datasheet/RC0603FR-074K7L/100996.html
61 | 1 | 10Ω | R28 | R1206 | 10Ω | 1206W4F100JT5E | UNI-ROYAL | C17903 | LCSC | 2 | 10Ω | 1206W4F100JT5E | gge20 | https://item.szlcsc.com/datasheet/1206W4F100JT5E/18591.html
62 | 1 | 470kΩ | R29 | R0603 | 470kΩ | FRC0603F4703TS | FOJAN | C2907040 | LCSC | 2 | 470kΩ | נגד | gge3
63 | 2 | 220Ω | R42,R45 | R0603 | 220Ω | 0603WAJ0221T5E | UNI-ROYAL | C1226 | LCSC | 2 | 220Ω | נגד | gge73_2,gge73_4 | https://atta.szlcsc.com/upload/public/pdf/source/20200306/C422600_1E6D84923E4A46A82E41ADD87F860B5C.pdf
64 | 1 | 470Ω | R44 | R0603 | 470Ω | 0603WAF4700T5E | UNI-ROYAL | C23179 | LCSC | 2 | 470Ω | נגד | gge73_3 | https://item.szlcsc.com/datasheet/0603WAF4700T5E/23906.html
65 | 1 | 130kΩ | R47 | R0603 | 130kΩ | FRC0603F1303TS | FOJAN | C2906991 | LCSC | 2 | 130kΩ | נגד | gge41_2
66 | 1 | 10Ω | R55 | R0603 | 10Ω | RC0603FR-0710RL | YAGEO | C109318 | LCSC | 2 | 10Ω | נגד | gge10_1 | https://atta.szlcsc.com/upload/public/pdf/source/20180316/70C0E2BDAE7FCC62C531A5A58D202EE1.pdf
67 | 1 | 120Ω | R91 | R0603 | 120Ω | FRC0603F1200TS | FOJAN | C2906988 | LCSC | 2 | 120Ω | R_120R_0603_1% | 3fa8a17005a8482a
68 | 1 | K2-1103SP-O4SW-04 | SW1 | Key_SMD_12x12x7.3 |  | K2-1103SP-O4SW-04 | Hanyoung, קוריאה | C223790 | LCSC | 4 | K2-1103SP-O4SW-04 | לחצן מגע רגעי | gge102 | https://item.szlcsc.com/datasheet/K2-1103SP-O4SW-04/223935.html
69 | 2 | TS-1088-AR02016 | SW2,SW3 | SW-SMD_L3.9-W3.0-P4.45 |  | TS-1088-AR02016 | XUNPU | C720477 | LCSC | 2 | TS-1088-AR02016 | TS-1088-AR02016 | gge120,gge120_0 | https://item.szlcsc.com/datasheet/TS-1088-AR02016/763484.html
70 | 1 | ITR1502SR40A/TR8 | SW4 | SW-SMD_4P-L4.0-W3.0_ITR1502SR40A-TR8 |  | ITR1502SR40A/TR8 | EVERLIGHT | C183793 | LCSC | 4 | ITR1502SR40A/TR8 | ITR1502SR40A/TR8 | gge127 | https://atta.szlcsc.com/upload/public/pdf/source/20210824/788DB0FEA34120D89E4A3F95527B4996.pdf
71 | 1 | CH224A | U1 | ESSOP-10_L4.9-W3.9-P1.0-LS6.0-TL-EP |  | CH224A | WCH | C42459160 | LCSC | 11 | CH224A | CH224A | gge1 | https://item.szlcsc.com/datasheet/CH224A/44538670.html
72 | 1 | LM5122MHX/NOPB | U2 | HTSSOP-20_L6.5-W4.4-P0.65-LS6.4-BL-EP |  | LM5122MHX/NOPB | TI | C77241 | LCSC | 21 | LM5122MHX/NOPB | LM5122MHX/NOPB | gge24 | https://www.ti.com/cn/lit/gpn/lm5122
73 | 1 | STM32F103C8T6 | U3 | LQFP-48_L7.0-W7.0-P0.50-LS9.0-BL |  | STM32F103C8T6 | ST | C8734 | LCSC | 48 | STM32F103C8T6 | STM32F103C8T6 | gge100 | https://item.szlcsc.com/datasheet/STM32F103C8T6/9243.html
74 | 1 | LMV358IDR | U4 | SOIC-8_L4.9-W3.9-P1.27-LS6.0-BL |  | LMV358IDR | TI | C63813 | LCSC | 8 | LMV358IDR | LMV358IDR | gge63 | https://www.ti.com/cn/lit/gpn/lmv358
75 | 1 | TMP100NA/3K | U5 | SOT-23-6_L2.9-W1.6-P0.95-LS2.8-BR |  | TMP100NA/3K | TI | C31810 | LCSC | 6 | TMP100NA/3K | TMP100NA/3K | gge76 | https://www.ti.com/cn/lit/gpn/tmp100
76 | 1 | ME6231A33PG | U6 | SOT-89-3_L4.5-W2.5-P1.50-LS4.2-BR |  | ME6231A33PG | MICRONE | C2681684 | LCSC | 3 | ME6231A33PG | ME6231A33PG | gge9 | https://item.szlcsc.com/datasheet/ME6231A33PG/2775123.html
77 | 1 | GT-USB-7010ASV | U8 | USB-C-SMD_G-SWITCH_GT-USB-7010ASV |  | GT-USB-7010ASV | G-Switch | C2988369 | LCSC | 16 | GT-USB-7010ASV | GT-USB-7010ASV | gge99 | https://atta.szlcsc.com/upload/public/pdf/source/20230327/DF227B64686AC8FA0AD1775797F2C3F1.pdf
78 | 1 | MM3Z15 | U9 | SOD-323_L1.7-W1.3-LS2.6-RD-1 |  | MM3Z15 | R+O | C22399890 | LCSC | 2 | MM3Z15 | MM3Z15_C22399890 | gge21 | https://item.szlcsc.com/datasheet/MM3Z15/24018232.html
79 | 1 | MAX13487EESA+T | U10 | SOIC-8_L4.9-W3.9-P1.27-LS6.0-BL |  | MAX13487EESA+T | ADI/MAXIM | C18347 | LCSC | 8 | MAX13487EESA+T | MAX13487EESA | gge41_1 | https://atta.szlcsc.com/upload/public/pdf/source/20130828/1457706641959.pdf
80 | 1 | WAFER-GH1.25-6PWB | U11 | CONN-SMD_6P-P1.25_XUNPU_WAFER-GH1.25-6PWB |  | WAFER-GH1.25-6PWB | XUNPU | C3029381 | LCSC | 8 | WAFER-GH1.25-6PWB | WAFER-GH1.25-6PWB | gge129 | https://item.szlcsc.com/datasheet/WAFER-GH1.25-6PWB/3561393.html
81 | 1 | CH343K | U12 | ESSOP-10_L4.9-W3.9-P1.0-LS6.0-TL-EP |  | CH343K | WCH | C5832295 | LCSC | 11 | CH343K | CH343K | gge111 | https://item.szlcsc.com/datasheet/CH343K/6763415.html
82 | 1 | W25Q128JVSIQ | U13 | SOIC-8_L5.3-W5.3-P1.27-LS8.0-BL |  | W25Q128JVSIQ | Winbond | C97521 | LCSC | 8 | W25Q128JVSIQ | W25Q128JVSIQTR | gge128 | https://item.szlcsc.com/datasheet/W25Q128JVSIQ/98729.html
83 | 2 | PM254-2-04-Z-8.5 | U14,U19 | HDR-TH_8P-P2.54-V-F-R2-C4-S2.54 |  | PM254-2-04-Z-8.5 | HCTL | C2897405 | LCSC | 8 | PM254-2-04-Z-8.5 | PM254-2-04-Z-8.5 | gge131,gge132 | https://item.szlcsc.com/datasheet/PM254-2-04-Z-8.5/3142410.html
84 | 1 | INA139NA/250 | U15 | TSOT-23-5_L2.9-W1.6-P0.95-LS2.8-BR |  | INA139NA/250 | TI | C189201 | LCSC | 5 | INA139NA/250 | INA139NA/250 | gge27 | https://www.ti.com/cn/lit/gpn/ina139
85 | 2 | LMR51610XDBVR | U16,U17 | SOT-23-6_L2.9-W1.6-P0.95-LS2.8-BR |  | LMR51610XDBVR | TI | C20539658 | LCSC | 6 | LMR51610XDBVR | LMR51610XDBVR | gge122,gge122_0 | https://atta.szlcsc.com/upload/public/pdf/source/20240112/FA5D53F5D264F9958129C86E08D1F3BB.pdf
86 | 1 | 8MHz | X1 | OSC-SMD_3P-L3.2-W1.3-P1.20 | 8MHz | CSTNE8M00G520000R0 | muRata | C907975 | LCSC | 3 | 8MHz | CSTNE8M00G520000R0 | gge121 | https://item.szlcsc.com/datasheet/CSTNE8M00G520000R0/973876.html

Sheet: NC_List
No. | Quantity | Comment | Designator | Footprint | Value | Manufacturer Part | Manufacturer | Supplier Part | Supplier | Pin Count | Name | Symbol | Unique ID | Datasheet | מצב הרכבה | סימוני רכיבים של הקבוצה המקורית | מזהה Unique ID של הקבוצה המקורית | הוראות שימוש
NC-1 | 0 | 47kΩ | R59 | R0603 | 47kΩ | FRC0603F4702TS | FOJAN | C2907042 | LCSC | 2 | 47kΩ | נגד |  |  | NC / לא להרכיב | R17,R30,R59 | gge4,gge78,gge78_0 | כמות להרכבת לוח יחיד:0; לא להרכיב. מזהה הקבוצה המקורי משמש לעקיבות בלבד; אין להסיק ממנו מזהה של רכיב בודד
