oznav2/tectile_skin/hardware/02_PCB/12_RBE_PWR_BACKHUB/01_BOM_BACKHUB_2026-09-14.xlsx

No. | Quantity | Comment | Designator | Footprint | Value | Device | Tolerance
1 | 7 | 100nF | C1,C3,C7,C8,C10,C11,C14 | C0201 | 100nF | GRM033R61E104KE14D,GRM033Z71C104KE14D | ±10%
2 | 6 | 1uF | C2,C38,C57,C96,C128,C421 | C0402 | 1uF | CC0402KRX5R6BB105,HGC0402R5105K500NTEJ | ±10%
3 | 47 | 100nF | C4,C5,C6,C18,C20,C22,C24,C25,C26,C27,C28,C29,C30,C31,C32,C33,C34,C35,C41,C43,C44,C45,C46,C47,C48,C50,C52,C53,C54,C55,C56,C58,C59,C67,C89,C99,C103,C104,C109,C112,C132,C134,C137,C226,C274,C413,C414 | C0402 | 100nF | CC0402KRX7R9BB104 | ±10%
4 | 2 | 12pF | C9,C13 | C0402 | 12pF | CC0402JRNPO9BN120 | ±5%
5 | 3 | 1nF | C12,C75,C79 | C1206 | 1nF | 1206B102K202NT | ±10%
6 | 4 | 10uF | C15,C17,C36,C37 | C0402 | 10uF | CL05A106MQ5NUNC,GRM155R61A106ME11D | ±20%
7 | 7 | 22uF | C16,C135,C136,C138,C415,C416,C417 | C0603 | 22uF | CL10A226MQ8NRNC,GRM188R61A226ME15D,HGC0603R5226M160NTHJ | ±20%
8 | 3 | 100pF | C19,C62,C418 | C0402 | 100pF | 0402B101K500NT,CAP_0603,CC0402JRNPO9BN101 | ±5%,±10%
9 | 2 | 33pF | C21,C23 | C0402 | 33pF | CC0402JRNPO9BN330 | ±5%
10 | 1 | 120uF | C39 | CAP-SMD_BD6.3-L6.6-W6.6-FD-A | 120uF | OVZ121M1DTR-0606 | ±20%
11 | 3 | 10uF | C40,C94,C95 | C0603 | 10uF | CL10A106MP8NNNC,HGC0603R5106M350NTHJ | ±20%
12 | 2 | 10uF | C42,C65 | C1206 | 10uF | CL31A106KAHNNNE,HGC1206R5106K500NSPJ | ±10%
13 | 17 | 100nF | C49,C64,C71,C72,C73,C74,C81,C91,C92,C110,C118,C120,C122,C343,C344,C350,C351 | C0603 | 100nF | 0603B104K500NT,CAP_0603,CC0603KRX7R0BB104,CGA0603X7R104K500JT,CL10B104KB8NNNC,TCC0603X7R104K101CT | ±10%
14 | 1 | 1nF | C51 | C0603 | 1nF | CL10B102KB8NNNC | ±10%
15 | 2 | 10nF | C60,C275 | C0402 | 10nF | CC0402KRX7R9BB103 | ±10%
16 | 4 | 2.2uF | C61,C88,C90,C111 | C0402 | 2.2uF | CAP_0603,CL05A225KA5NUNC,CL05A225KP5NSNC | ±10%
17 | 1 | 4.7uF | C63 | C0402 | 4.7uF | CAP_0603
18 | 2 | 470nF | C66,C68 | C0402 | 470nF | CAP_0603,GRM155R61H474KE11D | ±10%
19 | 10 | 10uF | C70,C80,C97,C105,C106,C107,C117,C348,C349,C355 | C1210 | 10uF | FS32X106K101EGG,TCC1210X5R106K101MT | ±10%
20 | 5 | 22uF | C76,C221,C222,C223,C224 | C1210 | 22uF | CGA1210X5R226K350RT,GMK325BJ226MM-P | ±10%,±20%
21 | 1 | 68nF | C77 | C0402 | 68nF | CAP_0603
22 | 1 | 470pF | C78 | C0402 | 470pF | CAP_0603
23 | 6 | 22uF | C82,C83,C84,C85,C86,C87 | C1206 | 22uF | HGC1206R5226M350NSPJ | ±20%
24 | 3 | 1uF | C93,C116,C119 | C0603 | 1uF | CGA0603X5R105K500JT | ±10%
25 | 1 | 220uF | C98 | CAP-TH_BD8.0-P3.50-D0.5-FD | 220uF | ERA35V220M8X12 | ±20%
26 | 2 | 1nF | C100,C102 | C0402 | 1nF | CC0402KRX7R9BB102,FCC0402B103K500AT | ±10%
27 | 1 | 68uF | C101 | CAP-SMD_BD6.3-L6.6-W6.6-LS7.3-FD | 68uF | SPT1VM680E05TRVZC | ±20%
28 | 1 | 47uF | C108 | CAP-SMD_BD6.3-L6.6-W6.6-FD | 47uF | MA50V47M6X9 | ±20%
29 | 4 | 10pF | C113,C114,C229,C277 | C0402 | 10pF | CC0402JRNPO9BN100,CL05C100JB5NNNC | ±5%
30 | 1 | 2.2nF | C115 | C0402 | 2.2nF | CC0402KRX7R9BB222 | ±10%
31 | 1 | 2.2uF | C121 | C0603 |  | 2.2uF
32 | 2 | 10uF | C123,C124 | C0603 |  | 10uF
33 | 1 | 4.7uF | C126 | C0805 | 4.7uF | HGC0805R7475K500NSLJ | ±10%
34 | 1 | 220pF | C139 | C0402 | 220pF | 0402B221K500NT | ±10%
35 | 2 | 4.7uF | C217,C265 | C0603 | 4.7uF | TCC0603X5R475K350CT | ±10%
36 | 2 | 47nF | C220,C227 | C0402 | 47nF | 0402B473K500NT | ±10%
37 | 2 | 22uF | C257,C347 | CAP-SMD_BD6.3-L6.6-W6.6-LS7.3-FD | 22uF | 189RV0021 | ±20%
38 | 6 | 4.7uF | C258,C259,C345,C346,C352,C353 | C1206 | 4.7uF | CGA1206X7R475K101NT | ±10%
39 | 1 | 470pF | C419 | C0805 | 470pF | FCC0805B471K500DT | ±10%
40 | 1 | 1uF | C420 | C0805 | 1uF | CGA0805X7R105K101MT | ±10%
41 | 1 | XT30UPB-F30.G.Y | CN1 | CONN-TH_XT30UPB-F |  | XT30UPB-F30.G.Y
42 | 2 | KW30-8S-1V(800) | CN2,CN3 | CONN-SMD_8P-P1.00-KW30-8S-1V-800 |  | KW30-8S-1V(800)
43 | 1 | GT-F0512SR18-10S0101 | CN4 | FPC-SMD_10P-P0.50_GT-F0512SR18-10S0101 |  | GT-F0512SR18-10S0101
44 | 1 | XT30UPB-M | CN5 | CONN-TH_XT30UPB-M |  | XT30UPB-M
45 | 1 | A1257WV-S-7P | CN6 | CONN-SMD_A1257WV-S-7P |  | A1257WV-S-7P
46 | 1 | A1257WV-S-6P-LCP | CN7 | CONN-SMD_A1257WV-S-6P |  | A1257WV-S-6P-LCP
47 | 3 | LAIL-PHC2.0-2P-01-PH-LT | CN8,CN12,CN13 | CONN-SMD_LAIL-PHC2.0-2P-01-PH-LT |  | LAIL-PHC2.0-2P-01-PH-LT
48 | 2 | XT30PW-M30.G.Y | CN9,CN10 | CONN-TH_XT30PW-M |  | XT30PW-M30.G.Y
49 | 1 | A1257WV-S-4P-LCP | CN11 | CONN-SMD_A1257WV-S-4P |  | A1257WV-S-4P-LCP
50 | 1 | SMF40CA | D1 | SOD-123FL_L2.8-W1.8-LS3.7-BI |  | SMF40CA_C42371749
51 | 1 | 1N5819WS | D3 | SOD-323_L1.8-W1.3-LS2.5-RD |  | 1N5819WS_C191023
52 | 2 | 1N4148WS | D5,D6 | SOD-323_L1.8-W1.3-LS2.5-RD |  | 1N4148WS_C2128
53 | 1 | BAT46WS | D10 | SOD-323_L1.8-W1.3-LS2.5-FD |  | BAT46WS_C968054
54 | 1 | SMF28CA | D11 | SOD-123FL_L2.7-W1.8-LS3.8-BI |  | SMF28CA_C19077517
55 | 5 | 1N4148WT | D12,D14,D15,D16,D17 | SOD-523_L1.2-W0.8-LS1.6-FD |  | 1N4148WT_C7420320
56 | 1 | SMBJ60A | D13 | SMB_L4.5-W3.7-LS5.4-RD |  | SMBJ60A_C49066953
57 | 1 | SS510F | D32 | SMAF_L3.5-W2.6-LS4.7-RD |  | SS510F_C41411774
58 | 4 | ICMEF112P900MFR | L1,L2,L3,L5 | FILTER-SMD_ICMEF112P900M-1 |  | ICMEF112P900MFR
59 | 1 | BLM15PD121SN1D | L4 | L0402 |  | BLM15PD121SN1D | ±25%
60 | 1 | 47uH | L6 | IND-SMD_L13.8-W12.6_H6.5 | 47uH | YSPI1365-470M | ±20%
61 | 1 | 22uH | L7 | IND-SMD_L13.5-W12.6_YSPI1335T-1R0M | 22uH | XR1365-220M | ±20%
62 | 1 | 2.2uH | L8 | IND-SMD_L4.4-W4.2 | 2.2uH | FXL0420-2R2-M | ±20%
63 | 1 | 15uH | L9 | IND-SMD_L8.5-W8.0_ZEMS0850 | 15uH | ZEMS0850-150M | ±20%
64 | 1 | 22uH | L10 | IND-SMD_L4.5-W4.1_SRP4020TA | 22uH | PSPMAA0402-220M-ANP | ±20%
65 | 1 | 10uH | L11 | IND-SMD_L13.5-W12.6_FAUL136X | 10uH | FXL1360-100-M | ±20%
66 | 1 | 16-213SDRC/S530-A3/TR8 | LED3 | LED0402-R-RD |  | 16-213SDRC/S530-A3/TR8
67 | 5 | BSC072N08NS5 | Q1,Q6,Q8,Q9,Q10 | DFN-8_L5.9-W5.2-P1.27-LS6.2-BL |  | BSC072N08NS5
68 | 1 | S8050 | Q2 | SOT-23-3_L3.0-W1.7-P0.95-LS2.9-BR |  | S8050 J3Y(RANGE:200-350)
69 | 2 | BSC0805LS | Q3,Q4 | PG-TDSON-8_L5.2-W5.9-P1.27-LS6.2-BL-EP |  | BSC0805LS
70 | 2 | IAUC40N08S5L140ATMA1 | Q5,Q7 | PG-TDSON-8-L5.5-W5.2-P1.27-LS6.4-BL |  | IAUC40N08S5L140ATMA1
71 | 1 | SS8050 | Q12 | SOT-23_L2.9-W1.3-P1.90-LS2.4-BR |  | SS8050_C431710
72 | 1 | CJ2101 | Q13 | SOT-323_L2.0-W1.3-P1.30-LS2.1-BR |  | CJ2101
73 | 3 | 10kΩ | R1,R2,R3 | R0201 | 10kΩ | 0201WMF1002TEE | ±1%
74 | 7 | 4.7kΩ | R4,R37,R38,R49,R50,R63,R90 | R0402 | 4.7kΩ | 0402WGF4701TCE,RC0402FR-074K7L,RCA024K7JLF | ±1%,±5%
75 | 1 | 15kΩ | R5 | R0402 | 15kΩ | RC0402FR-0715KL | ±1%
76 | 20 | 10kΩ | R6,R7,R8,R11,R12,R13,R14,R15,R40,R42,R48,R62,R65,R79,R83,R84,R89,R216,R254,R260 | R0402 | 10kΩ | 0402WGF1002TCE,RC0402FR-0710KL | ±1%
77 | 10 | 100kΩ | R9,R16,R44,R81,R82,R105,R118,R119,R258,R341 | R0402 | 100kΩ | FRC0402J104 TS,RC0402FR-07100KL,RT0402BRD07100KL,THC02G1003BT | ±0.1%,±1%,±5%
78 | 1 | 30kΩ | R10 | R0402 | 30kΩ | RC0402FR-0730KL | ±1%
79 | 1 | 2MΩ_NC | R17 | R0402 | 2MΩ_NC | 0402WGF2004TCE | ±1%
80 | 8 | 0Ω | R18,R86,R87,R88,R98,R213,R220,R251 | R0402 | 0Ω | FRC0402F0000TS,RC0402FR-070RL | ±1%
81 | 1 | 2MΩ | R19 | R0402 | 2MΩ | 0402WGF2004TCE | ±1%
82 | 3 | 1MΩ | R20,R75,R104 | R0805 | 1MΩ | 0805W8J0105T5E | ±5%
83 | 6 | 2.2Ω | R21,R22,R26,R27,R28,R29 | R0201 | 2.2Ω | 0201WMF220KTEE | ±1%
84 | 6 | 0Ω | R23,R25,R30,R31,R32,R33 | R0201 | 0Ω | 0201WMF0000TEE | ±1%
85 | 1 | 20kΩ | R24 | R0201 | 20kΩ | 0201WMF2002TEE | ±1%
86 | 1 | NC | R34 | R0805 | NC | RE0805FAR000 | ±1%
87 | 3 | 2.2kΩ | R35,R262,R263 | R0402 | 2.2kΩ | 0402WGF2201TCE,FRC0402F2201TS | ±1%
88 | 2 | 100Ω | R36,R60 | R0603 | 100Ω | FRC0603F1000TS,RC0603FR-07100RL | ±1%
89 | 3 | 100kΩ | R39,R107,R111 | R0603 | 100kΩ | 0603WAF1003T5E,FRC0603F1003TS | ±1%
90 | 1 | 1kΩ | R41 | R0402 | 1kΩ | RC0402FR-071KL | ±1%
91 | 1 | 47kΩ | R43 | R0402 | 47kΩ | 0402WGF4702TCE | ±1%
92 | 2 | 124kΩ | R46,R106 | R0402 | 124kΩ | FRC0402F1243TS | ±1%
93 | 1 | 1K | R47 | R0603 | 1K | Res_0603
94 | 5 | 10kΩ | R51,R52,R57,R59,R108 | R0603 | 10kΩ | RC0603FR-0710KL,RT0603BRD0710KL | ±0.1%,±1%
95 | 1 | 3.3Ω | R53 | R0402 | 3.3Ω | 0402WGF330KTCE | ±1%
96 | 6 | 100Ω | R54,R61,R94,R95,R113,R114 | R0402 | 100Ω | 0402WGF1000TCE,RC0402FR-07100RL | ±1%
97 | 1 | 49.9kΩ | R55 | R0603 | 49.9kΩ | RT0603BRD0749K9L | ±0.1%
98 | 1 | 210kΩ | R56 | R0402 | 210kΩ | 0402WGF2103TCE | ±1%
99 | 1 | 27kΩ | R58 | R0402 | 27kΩ | FRC0402F2702TS | ±1%
100 | 1 | 1Ω | R64 | R0603 | 1Ω | FRC0603J1R0 TS | ±5%
101 | 1 | 10mΩ | R66 | R1206 | 10mΩ | JER1206F1R010 | ±1%
102 | 1 | 36K | R67 | R0402 | 36K | Res_0603
103 | 1 | 1K | R68 | R0402 | 1K | Res_0603
104 | 1 | 82K | R69 | R0402 | 82K | Res_0603
105 | 1 | 20K | R70 | R0402 | 20K | Res_0603
106 | 1 | 82kΩ | R71 | R0603 | 82kΩ | FRC0603F8202TS | ±1%
107 | 1 | 1.62K | R72 | R0402 | 1.62K | Res_0603
108 | 1 | 3.65K | R73 | R0402 | 3.65K | Res_0603
109 | 1 | 2.05kΩ | R74 | R0402 | 2.05kΩ | FRC0402F2051TS | ±1%
110 | 1 | 68.1kΩ | R76 | R0402 | 68.1kΩ | FRC0402F6812TS | ±1%
111 | 1 | NC | R77 | R0402 | 0R/0402 | 0R/0402
112 | 1 | 5mΩ | R78 | R1206 | 5mΩ | FRM121WFR005TM | ±1%
113 | 2 | 47Ω | R80,R101 | R0402 | 47Ω | RC0402FR-0747RL | ±1%
114 | 2 | 49.9kΩ | R91,R92 | R0402 | 49.9kΩ | FRC0402F4992TS | ±1%
115 | 1 | 62kΩ | R93 | R0402 | 62kΩ | FRC0402F2002TS | ±1%
116 | 1 | 249kΩ | R96 | R0402 | 249kΩ | ERJ2RKF2493X | ±1%
117 | 1 | 6.49K | R99 | R0402 | 20k±0.1%/0402 | 20k±0.1%/0402
118 | 1 | 41.2kΩ | R100 | R0402 | 41.2kΩ | 0402WGF4122TCE | ±1%
119 | 1 | 56kΩ | R102 | R0402 | 56kΩ | FRC0402F5602TS | ±1%
120 | 1 | 61.9kΩ | R103 | R0402 | 61.9kΩ | FRC0402F6192TS | ±1%
121 | 1 | 0Ω | R109 | R0603 | 0Ω | RC0603FR-070RL | ±1%
122 | 1 | 221kΩ | R110 | R0603 | 221kΩ | FRC0603F2213TS | ±1%
123 | 1 | 24kΩ | R112 | R0603 | 24kΩ | 0603WAF2402T5E | ±1%
124 | 1 | 22.1kΩ | R121 | R0402 | 22.1kΩ | FRC0402F2212TS | ±1%
125 | 2 | 1MΩ | R207,R245 | R0402 | 1MΩ | FRC0402J105 TS | ±5%
126 | 2 | 46.4kΩ | R208,R246 | R0402 | 46.4kΩ | FRC0402F4642TS | ±1%
127 | 2 | 2.2Ω | R210,R248 | R0603 | 2.2Ω | FRC0603J2R2TS | ±5%
128 | 4 | NC | R212,R218,R250,R256 | R0402 | NC | 0402WGF5102TCE,RC0402FR-070RL | ±1%
129 | 1 | 51kΩ | R214 | R0402 | 51kΩ | PTFR0402B51K0N9 | ±0.1%
130 | 1 | 40.2kΩ | R222 | R0402 | 40.2kΩ | 0402WGF4022TCE | ±1%
131 | 1 | 1.6kΩ | R224 | R0402 | 1.6kΩ | 0402WGF1601TCE | ±1%
132 | 1 | 1.27kΩ | R225 | R0402 | 1.27kΩ | 0402WGF1271TCE | ±1%
133 | 4 | 0Ω_NC | R252,R255,R257,R261 | R0402 | 0Ω_NC | RC0402FR-070RL | ±1%
134 | 1 | 120kΩ | R253 | R0402 | 120kΩ | TC0250B1203TCC | ±0.1%
135 | 1 | 16kΩ | R342 | R0402 | 16kΩ | FRC0402F1602TS | ±1%
136 | 1 | 3kΩ | R343 | R0402 | 3kΩ | FRC0402F3001TS | ±1%
137 | 1 | 10Ω | R344 | R0805 | 10Ω | FRC0805J100 TS | ±5%
138 | 1 | 25mΩ | R345 | R1206 | 25mΩ | LRAM12CJTR025 | ±5%
139 | 5 | Test-Point | TP1,TP2,TP3,TP4,TP5 | Test-Point-0.5mm |  | Test-Point
140 | 1 | GL3523-OTY30 | U1 | QFN-76_L9.0-W9.0-P0.40-BL-EP |  | GL3523-OTY30
141 | 1 | ZD25WQ16CEIGR | U2 | USON-8_L3.0-W2.0-P0.50-BL-EP |  | ZD25WQ16CEIGR
142 | 1 | 2.2uH | U3 | IND-SMD_L2.5-W2.0-VLS252012CX-150M | 2.2uH | FXLB252012-2R2-M | ±20%
143 | 1 | SY6280AAC | U4 | SOT-23-5_L3.0-W1.7-P0.95-LS2.8-BL |  | SY6280AAC_C55136
144 | 1 | TMP100NA/3K | U5 | SOT-23-6_L2.9-W1.6-P0.95-LS2.8-BR |  | TMP100NA/3K | ±2℃
145 | 1 | LM5050MK-1/NOPB | U6 | TSOT-23-6_L2.9-W1.6-P0.95-LS2.8-BR |  | LM5050MK-1/NOPB
146 | 1 | STM32F103C8T6 | U7 | LQFP-48_L7.0-W7.0-P0.50-LS9.0-BL |  | STM32F103C8T6
147 | 1 | PM200-1-05-Z-4.3 | U8 | HDR-TH_5P-P2.00-V-F-A |  | PM200-1-05-Z-4.3_C3012131
148 | 1 | CH224A | U9 | ESSOP-10_L4.9-W3.9-P1.0-LS6.0-TL-EP |  | CH224A
149 | 1 | 4.7uH | U10 | IND-SMD_L11.6-W10.1 | 4.7uH | CYA1050-4.7UH | ±20%
150 | 1 | LMV358IDR | U11 | SOIC-8_L4.9-W3.9-P1.27-LS6.0-BL |  | LMV358IDR
151 | 1 | INA139NA/250 | U12 | TSOT-23-5_L2.9-W1.6-P0.95-LS2.8-BR |  | INA139NA/250
152 | 1 | LMR51610XDBVR | U13 | SOT-23-6_L2.9-W1.6-P0.95-LS2.8-BR |  | LMR51610XDBVR
153 | 1 | CH340N | U14 | SOP-8_L4.9-W3.9-P1.27-LS6.0-BL |  | CH340N
154 | 1 | LM5122MHX/NOPB | U15 | HTSSOP-20_L6.5-W4.4-P0.65-LS6.4-BL-EP |  | LM5122MHX/NOPB
155 | 1 | XKB X02AQ070GWDD1 | U16 | XKB X02AQ070GWDDX |  | XKB X02AQ070GWDD1
156 | 1 | LMV358AIDDFR | U17 | TSOT-23-8_L2.9-W1.6-P0.65-LS2.8-BR |  | LMV358AIDDFR
157 | 2 | SMTWEM220STR | U18,U23 | SMD-1_BD4.4-D2.8 |  | SMTWEM220STR
158 | 3 | HC-USB3.0-L168-WP | U19,U20,U21 | USB-TH_USB3.0-A |  | HC-USB3.0-L168-WP
159 | 1 | SY8113IADC | U22 | TSOT-23-6_L2.9-W1.6-P0.95-LS2.8-BL |  | SY8113IADC
160 | 1 | TL431ACDBZR | U24 | SOT-23-3_L3.0-W1.7-P0.95-LS2.9-BR |  | TL431ACDBZR | ±1%
161 | 1 | INA169NA/250 | U25 | SOT-23-5_L2.9-W1.6-P0.95-LS2.8-TL |  | INA169NA/250
162 | 1 | ZX-SH1.0-8PWT | U26 | CONN-SMD_8P-P1.00_MEGASTAR_ZX-SH1.0-8PWT |  | ZX-SH1.0-8PWT
163 | 5 | SEUC10F5V4U | U27,U29,U30,U32,U33 | DFN2510-10_L2.5-W1.0-P0.50-BL |  | SEUC10F5V4U
164 | 1 | LM5148RGYR | U28 | VQFN-24_L5.5-W3.5-P0.50-BL-EP-2 |  | LM5148RGYR
165 | 1 | S6B-PH-K-S(LF)(SN) | U31 | CONN-TH_6P-P2.00_S6B-PH-K-S-LF-SN |  | S6B-PH-K-S(LF)(SN)
166 | 2 | MP9931GR-Z | U53,U55 | QFN-23_L4.0-W4.0-P0.50-TL_MP9931GR |  | MP9931GR-Z
167 | 1 | MST8A50QA-15A1Y | U87 | QFN-20_L5.0-W5.0-P0.80-TL_HP8105QA |  | MST8A50QA-15A1Y
168 | 1 | TYPE-C-31-M-12 | USBC1 | USB-C_SMD-TYPE-C-31-M-12_1 |  | TYPE-C-31-M-12
169 | 1 | 25MHz | X1 | CRYSTAL-SMD_4P-L3.2-W2.5-BL_1 | 25MHz | X322525MOB4SI
170 | 1 | 8MHz | X2 | OSC-SMD_3P-L3.2-W1.3-P1.20 | 8MHz | CSTNE8M00G520000R0
