oznav2/tectile_skin/hardware/01_Mechanic/02_Manufacturing/02_3D_Printing/STEP_3D_Models/ROBOSKIN.0228-02_kickme_version_main_board_bracket.step

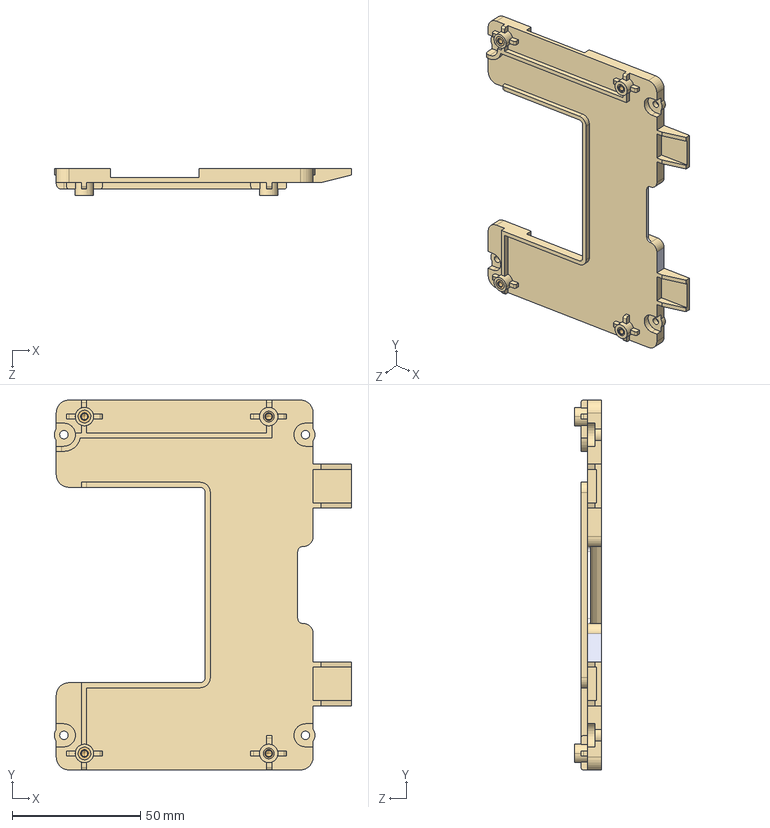
[picture p27: CAD file, 2026-10-24]
hardware/01_Mechanic/02_Manufacturing/02_3D_Printing/STEP_3D_Models/ROBOSKIN.0228-02_kickme_version_main_board_bracket.step
115.7 x 144.0 x 10.5 mm
