oznav2/tectile_skin/hardware/01_Mechanic/02_Manufacturing/02_3D_Printing/STEP_3D_Models/ROBOSKIN.0275_main_controller_FPC_clamping_plate.step

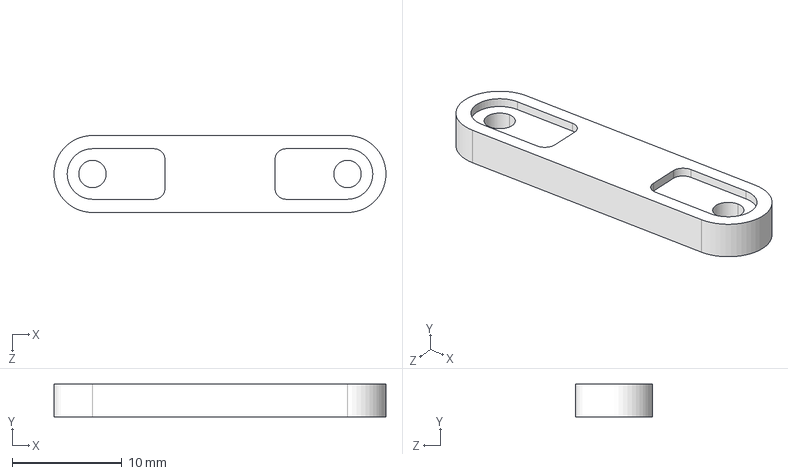
[picture p28: CAD file, 2026-10-24]
hardware/01_Mechanic/02_Manufacturing/02_3D_Printing/STEP_3D_Models/ROBOSKIN.0275_main_controller_FPC_clamping_plate.step
30.2 x 3.00 x 7.00 mm
