oznav2/tectile_skin/hardware/01_Mechanic/02_Manufacturing/01_CNC/5DOF/ROBOSKIN.0136_mirrored_cosmetic_hand_cover.step

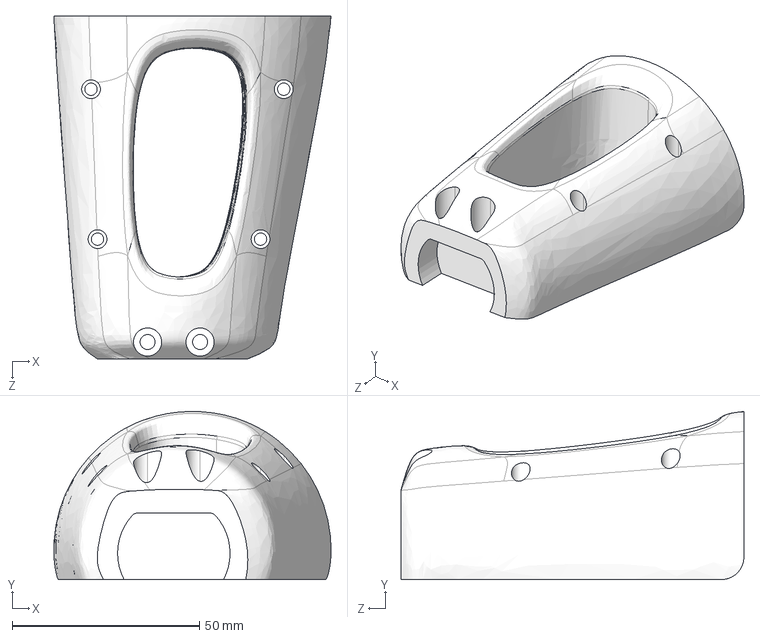
[picture p29: CAD file, 2026-10-24]
hardware/01_Mechanic/02_Manufacturing/01_CNC/5DOF/ROBOSKIN.0136_mirrored_cosmetic_hand_cover.step
73.9 x 44.8 x 91.4 mm
