oznav2/tectile_skin/hardware/01_Mechanic/02_Manufacturing/01_CNC/7DOF/ROBOSKIN.0159_wrist_lower_clamp.step

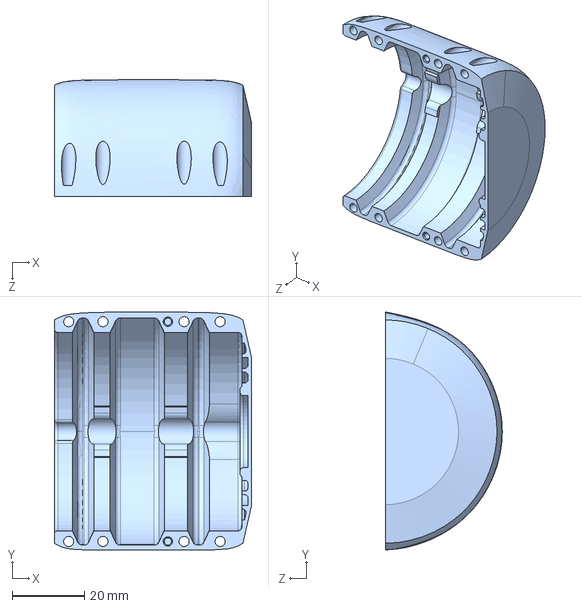
[picture p30: CAD file, 2026-10-24]
hardware/01_Mechanic/02_Manufacturing/01_CNC/7DOF/ROBOSKIN.0159_wrist_lower_clamp.step
54.7 x 66.0 x 32.3 mm
