oznav2/tectile_skin/hardware/01_Mechanic/02_Manufacturing/01_CNC/Common/ROBOSKIN.0178_upper_arm_lower_rear_segment_(01_revision_).step

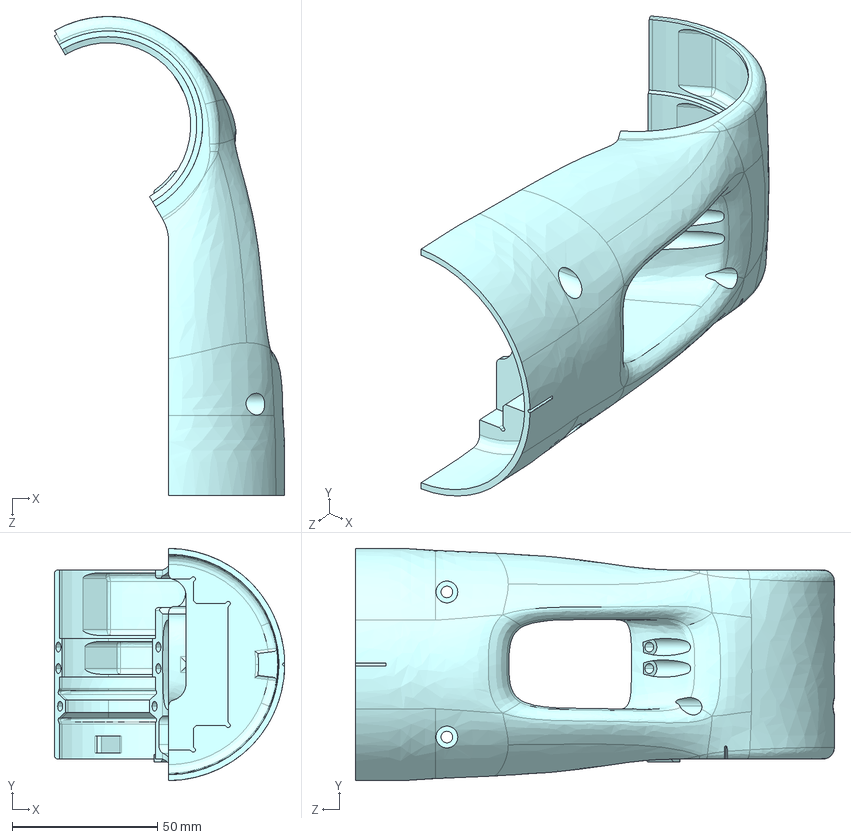
[picture p31: CAD file, 2026-10-24]
hardware/01_Mechanic/02_Manufacturing/01_CNC/Common/ROBOSKIN.0178_upper_arm_lower_rear_segment_(01_revision_).step
79.4 x 80.0 x 165.1 mm
