oznav2/tectile_skin/hardware/01_Mechanic/02_Manufacturing/02_3D_Printing/STEP_3D_Models/ROBOSKIN.0285_fan_bracket.step

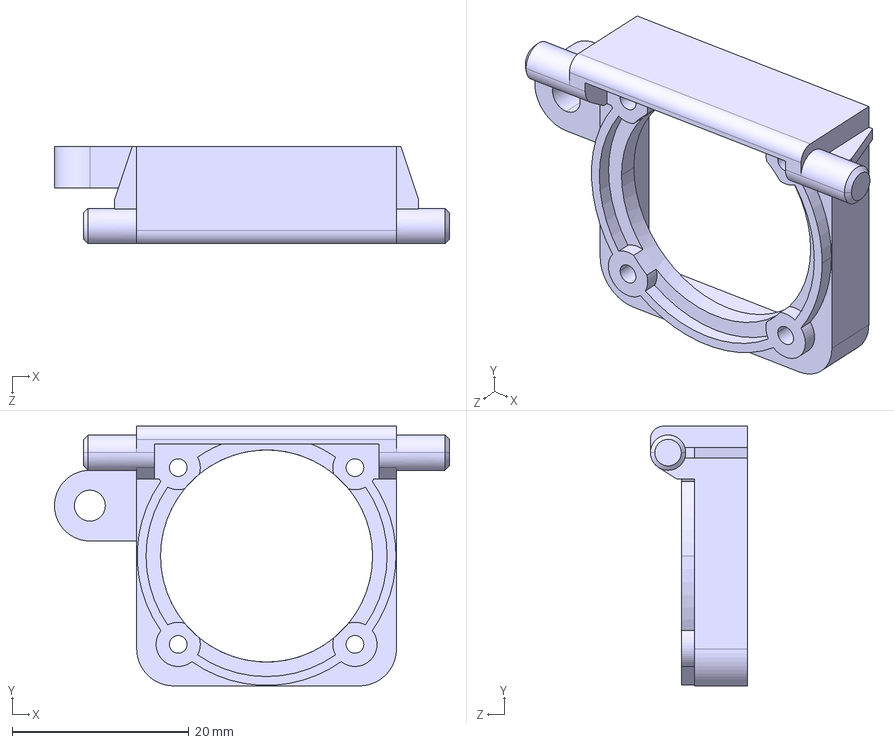
[picture p32: CAD file, 2026-10-24]
hardware/01_Mechanic/02_Manufacturing/02_3D_Printing/STEP_3D_Models/ROBOSKIN.0285_fan_bracket.step
44.7 x 29.4 x 11.0 mm
