oznav2/tectile_skin/hardware/01_Mechanic/02_Manufacturing/03_Rubber/STEP_3D_Models/ROBOSKIN.0222_kickme_handle_rubber_plug_-l.step

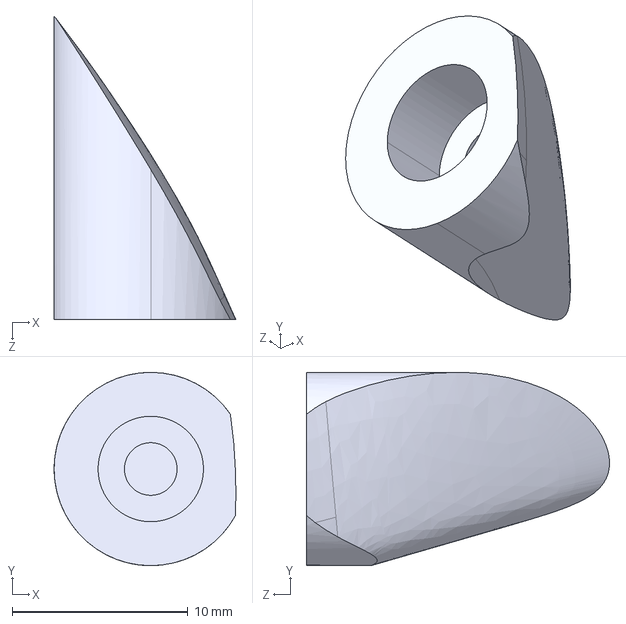
[picture p33: CAD file, 2026-10-24]
hardware/01_Mechanic/02_Manufacturing/03_Rubber/STEP_3D_Models/ROBOSKIN.0222_kickme_handle_rubber_plug_-l.step
10.3 x 11.0 x 17.2 mm
