oznav2/tectile_skin/hardware/02_PCB/01_USB3_Flexible_Interconnect/03_3D_FPC_2026-09-18.step

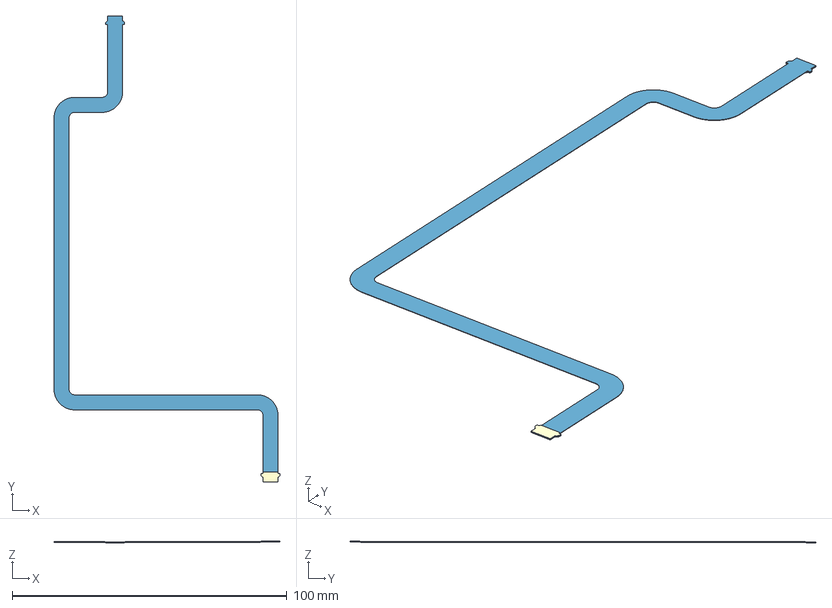
[picture p34: CAD file, 2026-10-24]
hardware/02_PCB/01_USB3_Flexible_Interconnect/03_3D_FPC_2026-09-18.step
82.2 x 169.4 x 0.553 mm
Board~poVE
TopCopper~poVE
BottomCopper~poVE
TopSilkscreen~poVE
BottomSilkscreen~poVE
TopFpcStiffener~poVE
BottomFpcStiffener~poVE
