oznav2/tectile_skin/hardware/02_PCB/02_RBE-COMM-433TX/03_3D_433TX_2026-09-20.step

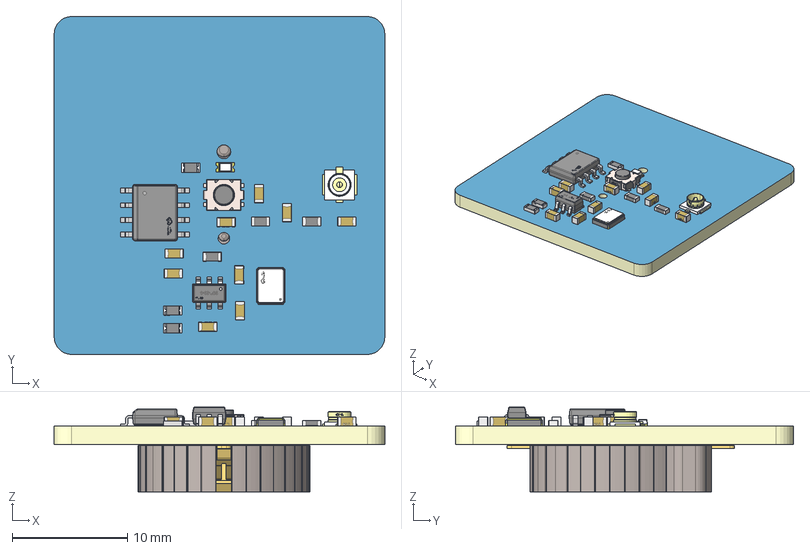
[picture p35: CAD file, 2026-10-24]
hardware/02_PCB/02_RBE-COMM-433TX/03_3D_433TX_2026-09-20.step
28.7 x 29.3 x 7.34 mm
Board~Lsh6
TopCopper~Lsh6
BottomCopper~Lsh6
TopSilkscreen~Lsh6
BottomSilkscreen~Lsh6
TopFpcStiffener~Lsh6
BottomFpcStiffener~Lsh6
R0603~R0603~dOpS x 3
IPEX-SMD_BWIPX-1-001E~IPEX-SMD_BWIPX-1-001E~TqN1
BAT-SMD_CR1220-2ZX~BAT-SMD_CR1220-2~wOGA
L0603~L0603_L1.6-W0.8-H0.5_BEAD~E0fA x 3
SW-SMD_SKSGAAE010~SW-SMD_SKSGAAE010~mAHP
C0603~C0603_L1.6-W0.8-H0.8~3UoM x 9
LED0603-RD~LED0603-RD~DBn9
SOP-8_L4.9-W3.9-P1.27-LS6.0-BL~SOP-8_L4.9-W3.9-P1.27-LS6.0-BL-1~WF6H
CRYSTAL-SMD_4P-L3.2-W2.5-BL-1~CRYSTAL-SMD_4P-L3.2-W2.5-BL-1~ABPg
SOT-23-6_L2.9-W1.6-P0.95-LS2.8-BL~SOT-23-6_L2.9-W1.6-H1.5-LS2.8-P0.95~3JCM
