oznav2/tectile_skin/hardware/02_PCB/08_RBE-PWR-MCAP/03_3D_MCAP_2026-09-16.step

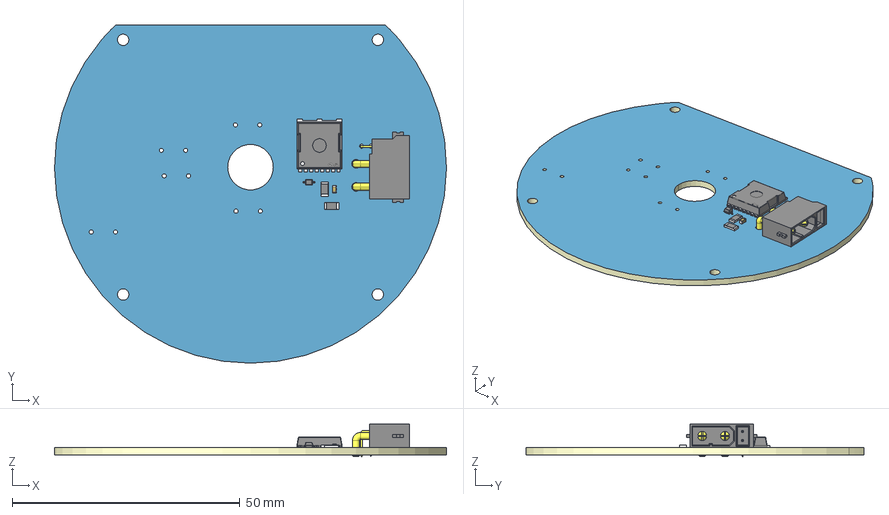
[picture p39: CAD file, 2026-10-24]
hardware/02_PCB/08_RBE-PWR-MCAP/03_3D_MCAP_2026-09-16.step
86.0 x 74.2 x 7.17 mm
Board~UFTE
TopCopper~UFTE
BottomCopper~UFTE
TopSilkscreen~UFTE
BottomSilkscreen~UFTE
TopFpcStiffener~UFTE
BottomFpcStiffener~UFTE
C0603~C0603_L1.6-W0.8-H0.8~OswC
R1206~R1206_L3.2-W1.6-H0.6~WF8j x 2
TOLL-8_L10.4-W9.9-P1.20-LS11.7-BL_2~TOLL-8_L10.4-W9.9-P1.20-LS11.7-BL_2~Hblh
CONN-TH_4P-XT30PW-M~CONN-TH_4P-XT30PW-M~c5ru
SOD-323F_L2.0-W1.6-LS2.5-RD~SOD-323F_L1.6-W1.3-H1.1-LS2.7~sj1o
