oznav2/tectile_skin/hardware/02_PCB/09_RBE-PWR-MINGMEI-BC/03_3D_MINGMEI-BC_2026-09-16.step

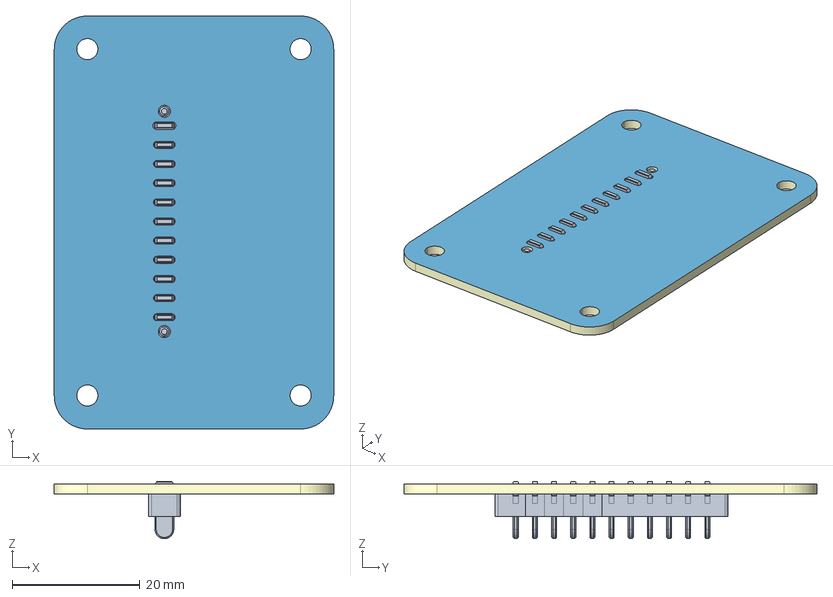
[picture p40: CAD file, 2026-10-24]
hardware/02_PCB/09_RBE-PWR-MINGMEI-BC/03_3D_MINGMEI-BC_2026-09-16.step
43.8 x 64.7 x 9.00 mm
Board~KxZj
TopCopper~KxZj
BottomCopper~KxZj
TopSilkscreen~KxZj
BottomSilkscreen~KxZj
TopFpcStiffener~KxZj
BottomFpcStiffener~KxZj
SYCDM30P11R1~SYCDM30P11R1~M28y x 6
