oznav2/tectile_skin/hardware/02_PCB/13_Lighting_Board/03_3D_LAMP_2026-09-16.step

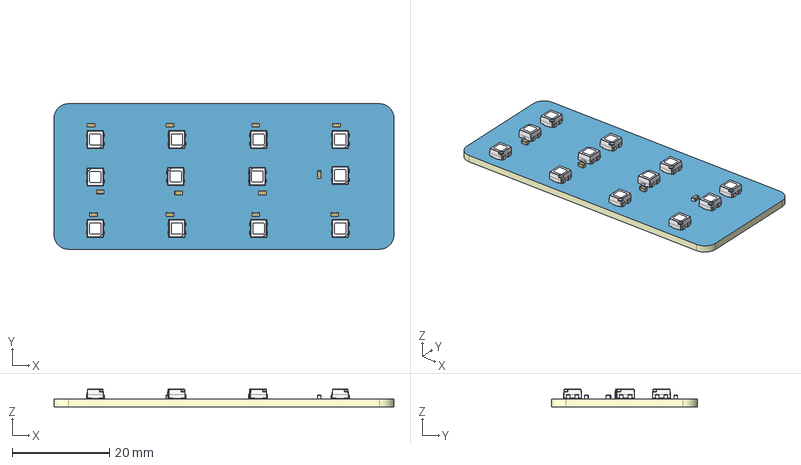
[picture p42: CAD file, 2026-10-24]
hardware/02_PCB/13_Lighting_Board/03_3D_LAMP_2026-09-16.step
70.0 x 30.0 x 3.66 mm
Board~5MKU
TopCopper~5MKU
BottomCopper~5MKU
TopSilkscreen~5MKU
BottomSilkscreen~5MKU
TopFpcStiffener~5MKU
BottomFpcStiffener~5MKU
C0603~C0603_L1.6-W0.8-H0.8~CtSf x 12
LED-SMD_4P-L3.5-W3.5-TL_WS2812B~LED3535-4P_L3.5-W3.5-H1.9-LS3.7~pZrN x 12
