oznav2/tectile_skin/hardware/02_PCB/14_Rear_Power_Indicator/03_3D_INDICATOR_2026-09-16.step

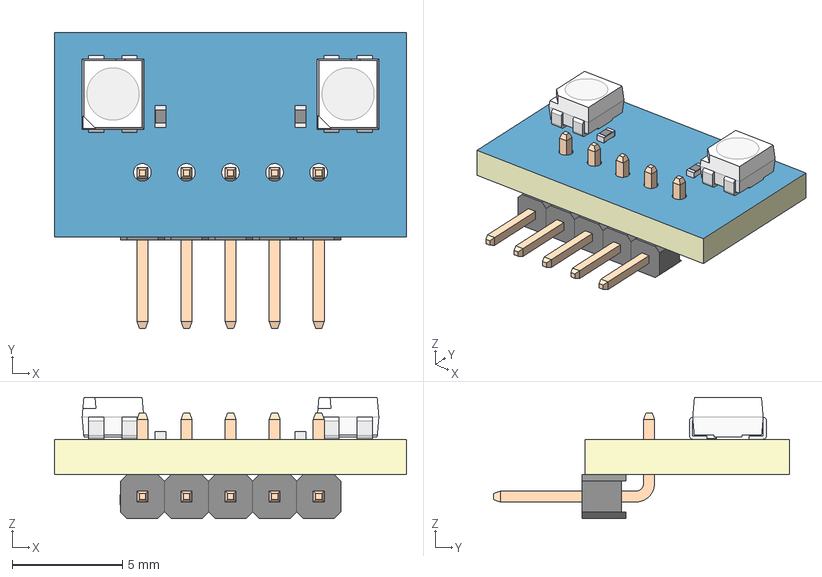
[picture p43: CAD file, 2026-10-24]
hardware/02_PCB/14_Rear_Power_Indicator/03_3D_INDICATOR_2026-09-16.step
16.0 x 13.4 x 5.50 mm
Board~iQUq
TopCopper~iQUq
BottomCopper~iQUq
TopSilkscreen~iQUq
BottomSilkscreen~iQUq
TopFpcStiffener~iQUq
BottomFpcStiffener~iQUq
R0402~R0402_L1.0-W0.5-H0.4~vvgK x 2
HDR-TH_5P-P2.00-H-M_HC-PZ200-10.5L-1X5PWA~HDR-TH_5P-P2.00-H-M_HC-PZ200-10.5L-1X5PWA~uuY6
LED-ARRAY-SMD_4P-L3.2-W2.8-LS3.5-BL_XL-A3528RGBC-BM~LED-ARRAY-SMD_4P-L3.2-W2.8-LS3.5-BL_XL-A3528RGBC-BM~TB6t x 2
