oznav2/tectile_skin/hardware/01_Mechanic/02_Manufacturing/01_CNC/5DOF/ROBOSKIN.0134_mirrored_cosmetic_hand_body.step

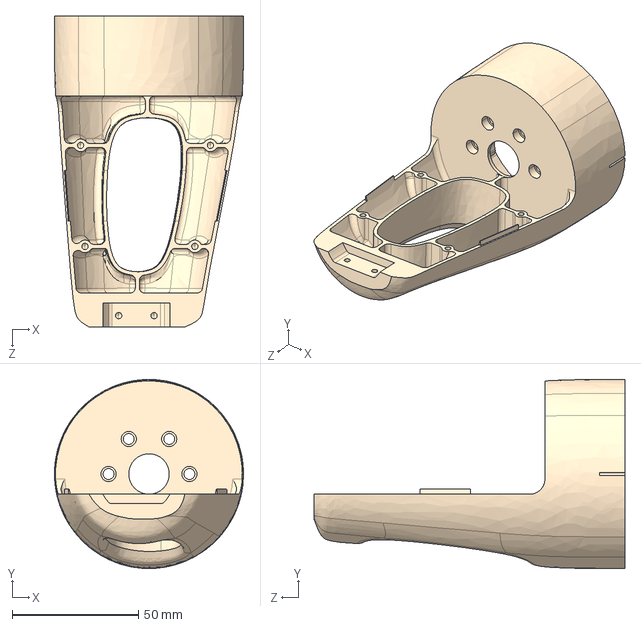
[picture p44: CAD file, 2026-10-24]
hardware/01_Mechanic/02_Manufacturing/01_CNC/5DOF/ROBOSKIN.0134_mirrored_cosmetic_hand_body.step
74.9 x 74.8 x 123.2 mm
