oznav2/tectile_skin/hardware/01_Mechanic/02_Manufacturing/01_CNC/7DOF/ROBOSKIN.0113_adapter_board_retainer.step

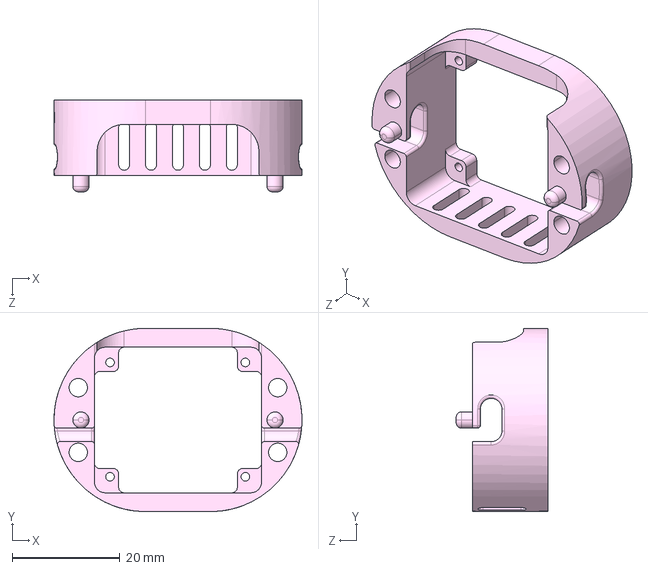
[picture p45: CAD file, 2026-10-24]
hardware/01_Mechanic/02_Manufacturing/01_CNC/7DOF/ROBOSKIN.0113_adapter_board_retainer.step
46.0 x 34.0 x 17.0 mm
