oznav2/tectile_skin/hardware/01_Mechanic/02_Manufacturing/01_CNC/Common/ROBOSKIN.0084_hip_joint_limit_ring_(LS_revision_).step

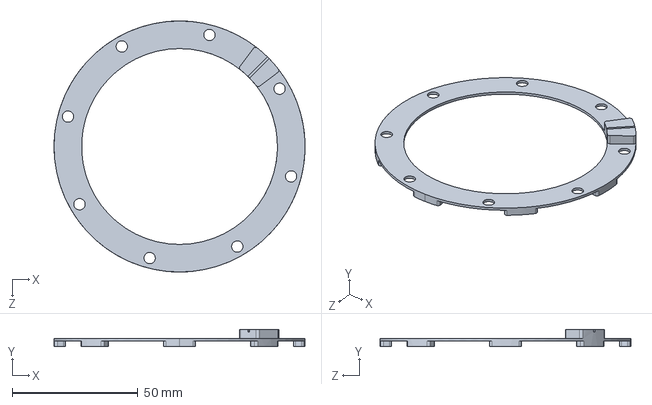
[picture p46: CAD file, 2026-10-24]
hardware/01_Mechanic/02_Manufacturing/01_CNC/Common/ROBOSKIN.0084_hip_joint_limit_ring_(LS_revision_).step
100.0 x 6.80 x 100.0 mm
