oznav2/tectile_skin/hardware/01_Mechanic/02_Manufacturing/02_3D_Printing/STEP_3D_Models/ROBOSKIN.0269_hip_fan_cable_guard_block_01_revision.step

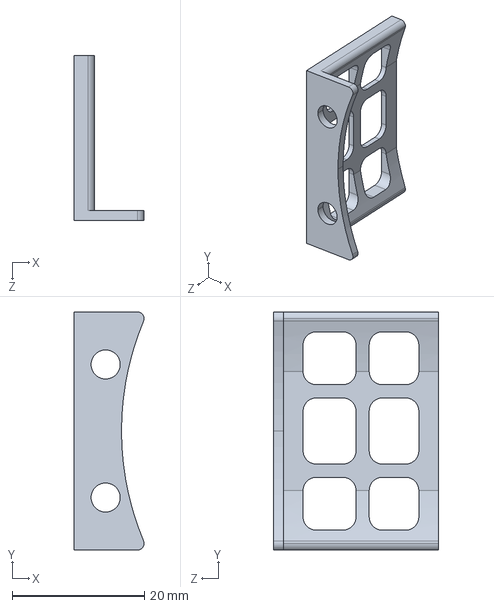
[picture p47: CAD file, 2026-10-24]
hardware/01_Mechanic/02_Manufacturing/02_3D_Printing/STEP_3D_Models/ROBOSKIN.0269_hip_fan_cable_guard_block_01_revision.step
10.6 x 36.0 x 25.0 mm
