oznav2/tectile_skin/hardware/01_Mechanic/02_Manufacturing/03_Rubber/STEP_3D_Models/ROBOSKIN.0223_kickme_handle_rubber_plug_-r.step

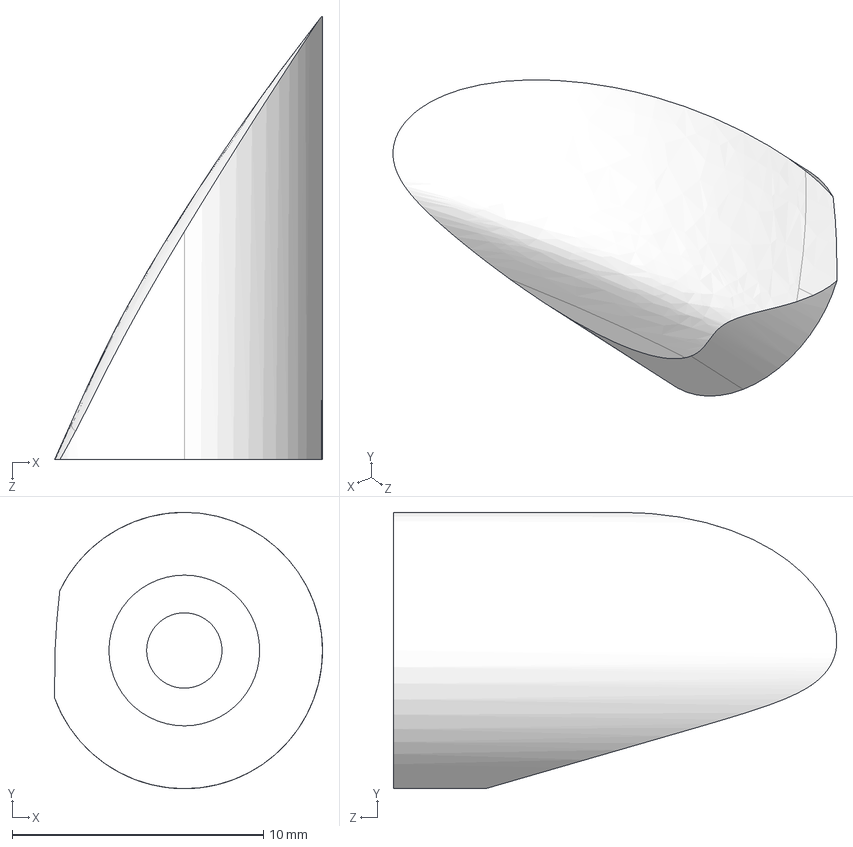
[picture p48: CAD file, 2026-10-24]
hardware/01_Mechanic/02_Manufacturing/03_Rubber/STEP_3D_Models/ROBOSKIN.0223_kickme_handle_rubber_plug_-r.step
10.7 x 11.0 x 17.7 mm
