oznav2/tectile_skin/hardware/01_Mechanic/02_Manufacturing/01_CNC/7DOF/ROBOSKIN.0123_55_limit_ring.step

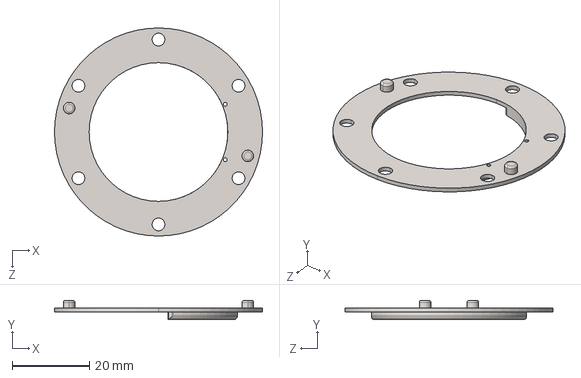
[picture p49: CAD file, 2026-10-24]
hardware/01_Mechanic/02_Manufacturing/01_CNC/7DOF/ROBOSKIN.0123_55_limit_ring.step
54.0 x 5.00 x 54.0 mm
