oznav2/tectile_skin/hardware/01_Mechanic/02_Manufacturing/01_CNC/Common/ROBOSKIN.0126_fan_retention_bracket_(_waist_).step

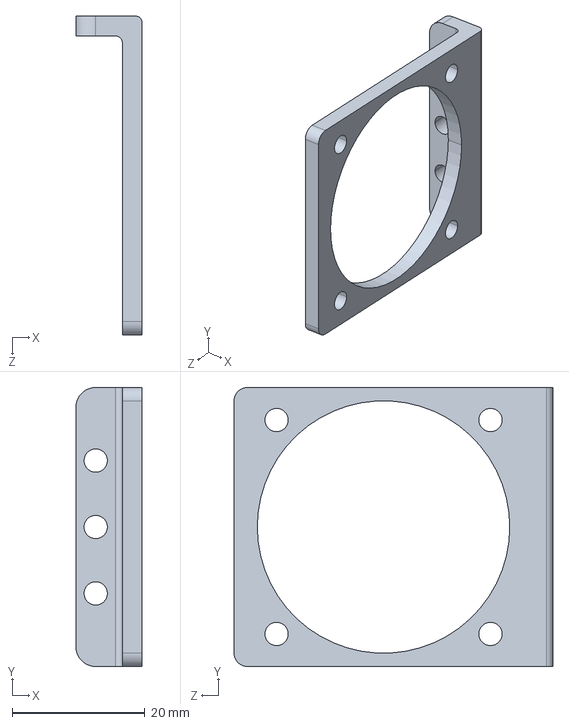
[picture p50: CAD file, 2026-10-24]
hardware/01_Mechanic/02_Manufacturing/01_CNC/Common/ROBOSKIN.0126_fan_retention_bracket_(_waist_).step
10.0 x 42.0 x 48.0 mm
