oznav2/tectile_skin/hardware/01_Mechanic/02_Manufacturing/02_3D_Printing/STEP_3D_Models/ROBOSKIN.0264-02_interactive_head_side_trim_cover_-R.step

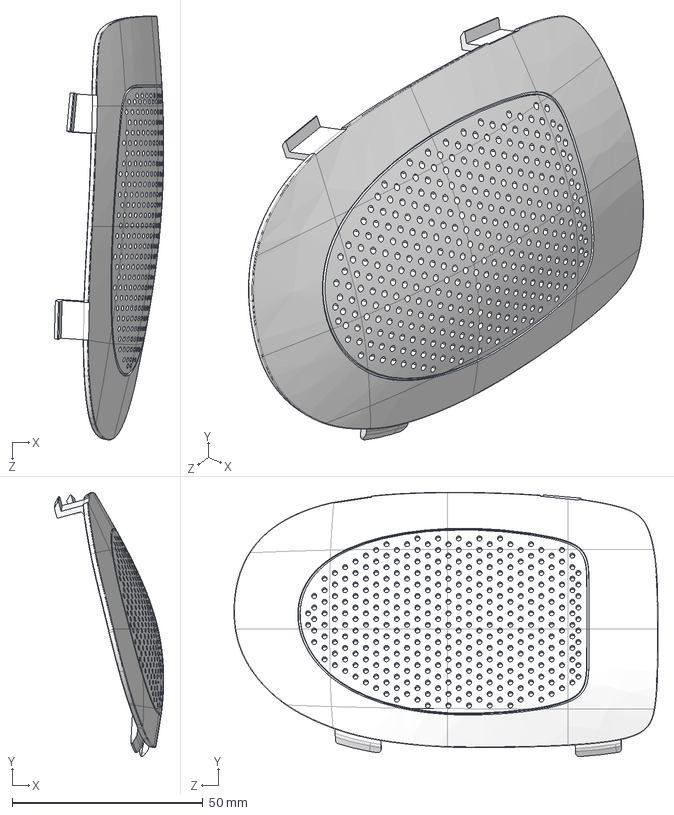
[picture p51: CAD file, 2026-10-24]
hardware/01_Mechanic/02_Manufacturing/02_3D_Printing/STEP_3D_Models/ROBOSKIN.0264-02_interactive_head_side_trim_cover_-R.step
28.7 x 69.4 x 111.3 mm
