oznav2/tectile_skin/hardware/01_Mechanic/02_Manufacturing/03_Rubber/STEP_3D_Models/ROBOSKIN.0131_cosmetic_hand_body.step

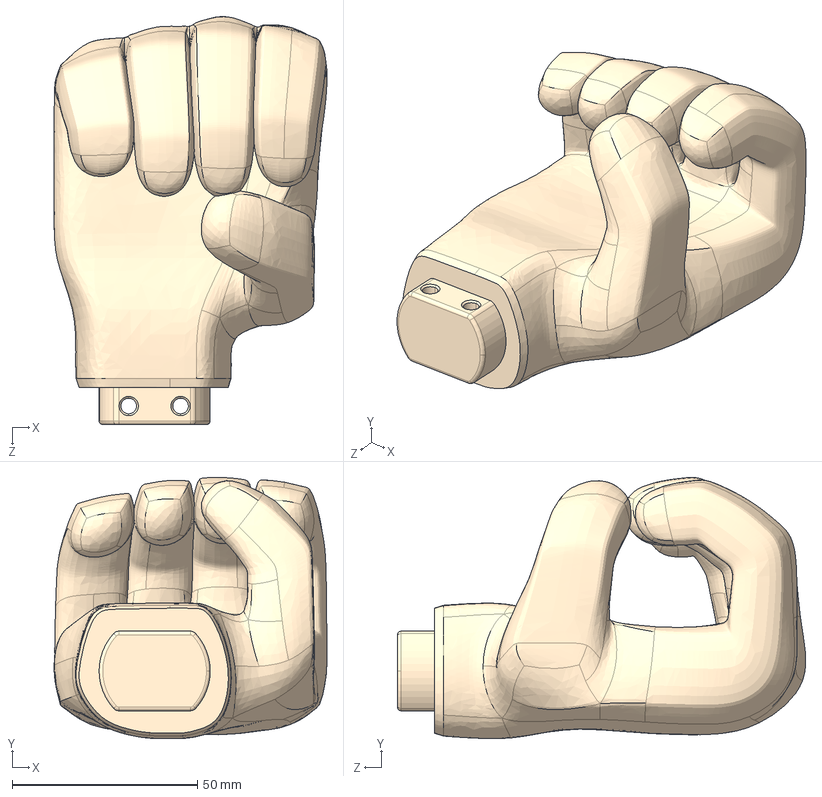
[picture p52: CAD file, 2026-10-24]
hardware/01_Mechanic/02_Manufacturing/03_Rubber/STEP_3D_Models/ROBOSKIN.0131_cosmetic_hand_body.step
73.7 x 70.5 x 110.2 mm
