oznav2/tectile_skin/hardware/01_Mechanic/02_Manufacturing/01_CNC/7DOF/ROBOSKIN.0157_mirrored_wrist_body.step

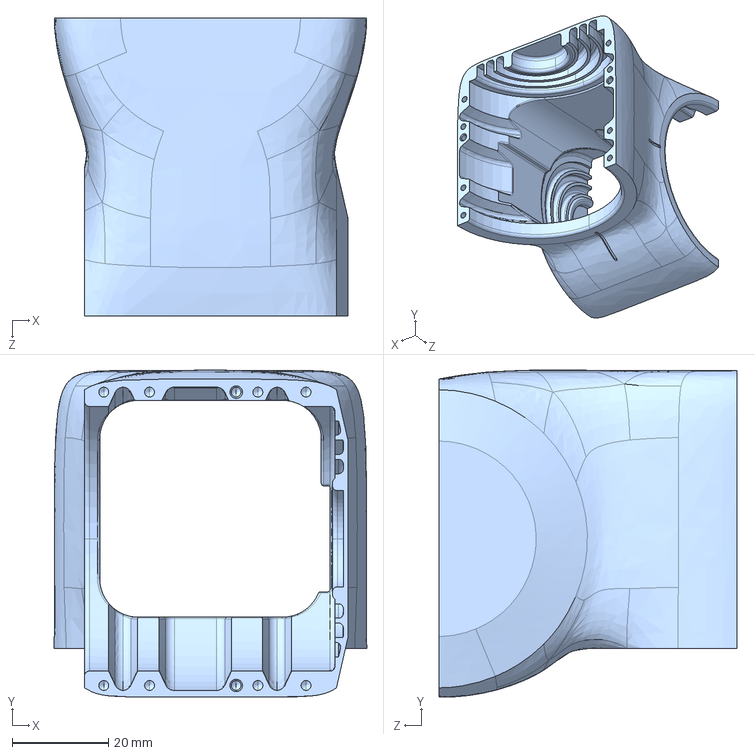
[picture p53: CAD file, 2026-10-24]
hardware/01_Mechanic/02_Manufacturing/01_CNC/7DOF/ROBOSKIN.0157_mirrored_wrist_body.step
64.9 x 67.9 x 61.9 mm
