oznav2/tectile_skin/hardware/01_Mechanic/02_Manufacturing/01_CNC/Common/ROBOSKIN.0277_LOGO_light_light_blocking_foam.step

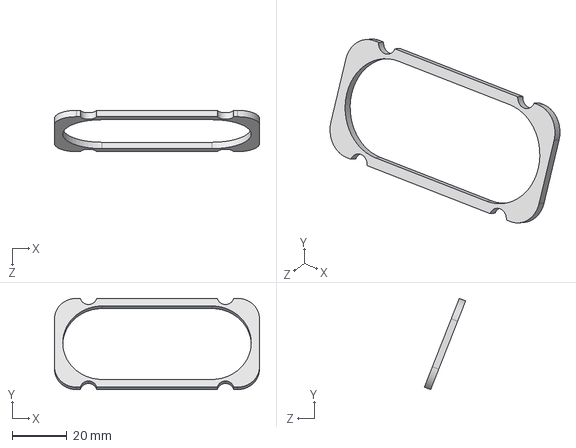
[picture p54: CAD file, 2026-10-24]
hardware/01_Mechanic/02_Manufacturing/01_CNC/Common/ROBOSKIN.0277_LOGO_light_light_blocking_foam.step
74.8 x 33.3 x 15.1 mm
