oznav2/tectile_skin/hardware/01_Mechanic/02_Manufacturing/02_3D_Printing/STEP_3D_Models/ROBOSKIN.0226_vertical_mount_backplane_shell.step

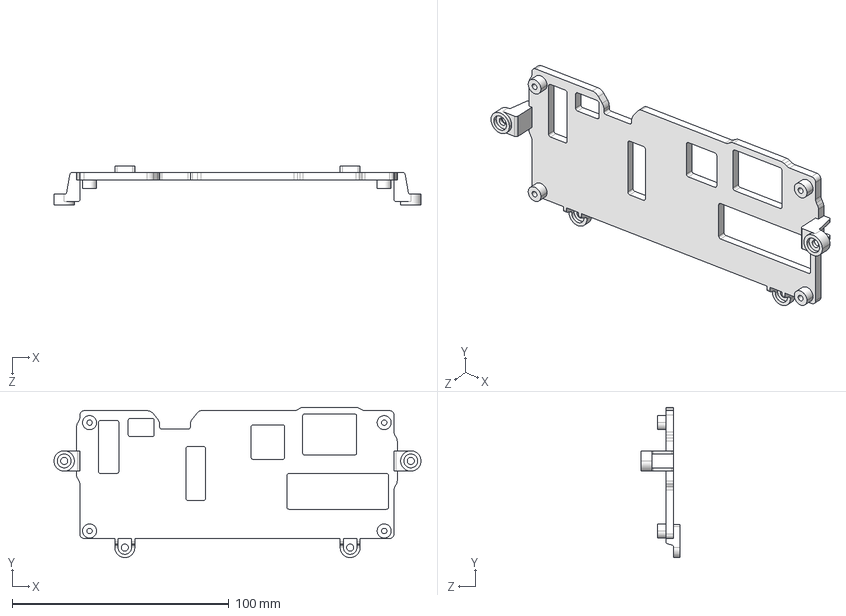
[picture p55: CAD file, 2026-10-24]
hardware/01_Mechanic/02_Manufacturing/02_3D_Printing/STEP_3D_Models/ROBOSKIN.0226_vertical_mount_backplane_shell.step
169.4 x 69.3 x 18.0 mm
