oznav2/tectile_skin/hardware/01_Mechanic/02_Manufacturing/03_Rubber/STEP_3D_Models/ROBOSKIN.0104_hip_joint_rubber_cover.step

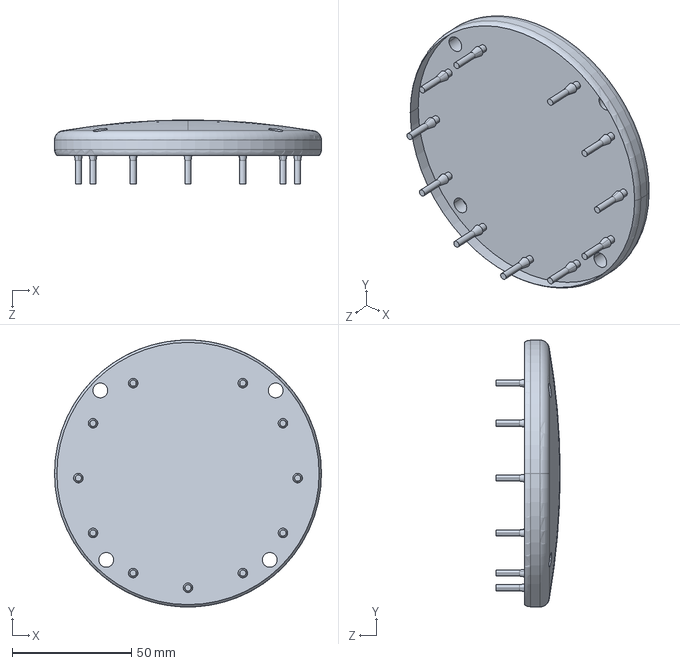
[picture p56: CAD file, 2026-10-24]
hardware/01_Mechanic/02_Manufacturing/03_Rubber/STEP_3D_Models/ROBOSKIN.0104_hip_joint_rubber_cover.step
112.0 x 111.9 x 27.0 mm
