oznav2/tectile_skin/hardware/01_Mechanic/02_Manufacturing/01_CNC/7DOF/ROBOSKIN.0001_forearm_lower_body.step

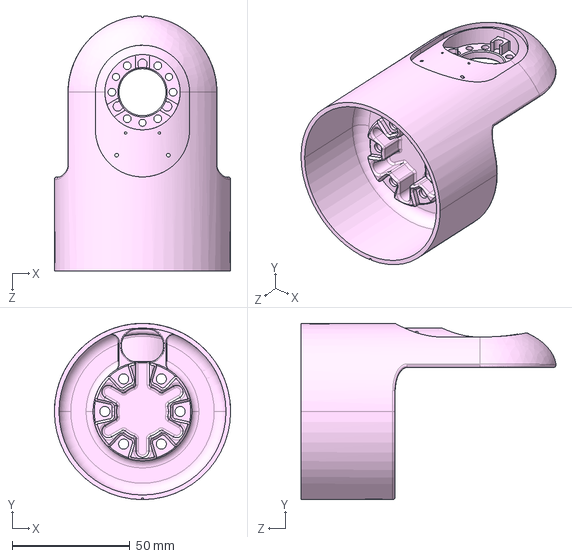
[picture p57: CAD file, 2026-10-24]
hardware/01_Mechanic/02_Manufacturing/01_CNC/7DOF/ROBOSKIN.0001_forearm_lower_body.step
74.9 x 74.9 x 108.4 mm
