oznav2/tectile_skin/hardware/01_Mechanic/02_Manufacturing/01_CNC/Common/ROBOSKIN.0172_speaker_bracket.step

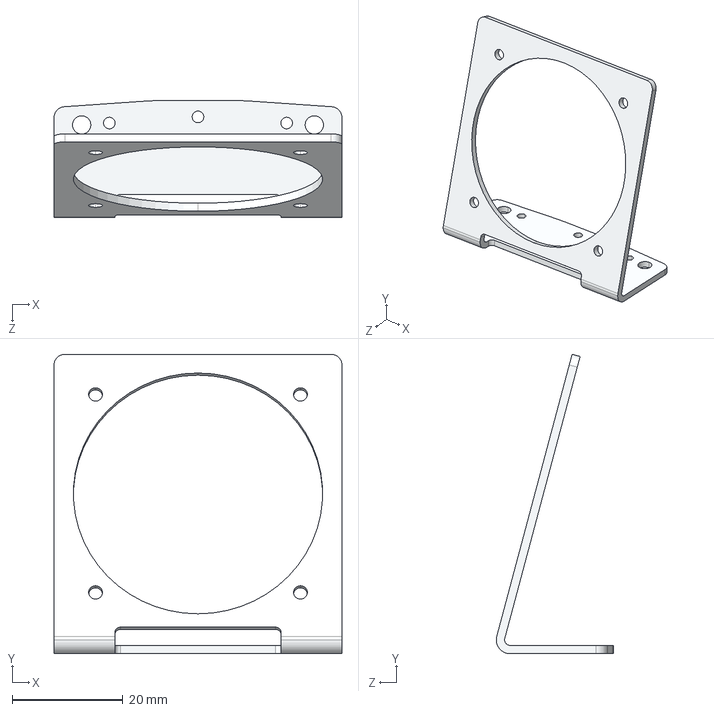
[picture p58: CAD file, 2026-10-24]
hardware/01_Mechanic/02_Manufacturing/01_CNC/Common/ROBOSKIN.0172_speaker_bracket.step
52.0 x 54.1 x 21.2 mm
