oznav2/tectile_skin/hardware/01_Mechanic/02_Manufacturing/01_CNC/7DOF/ROBOSKIN.0158_wrist_upper_clamp.step

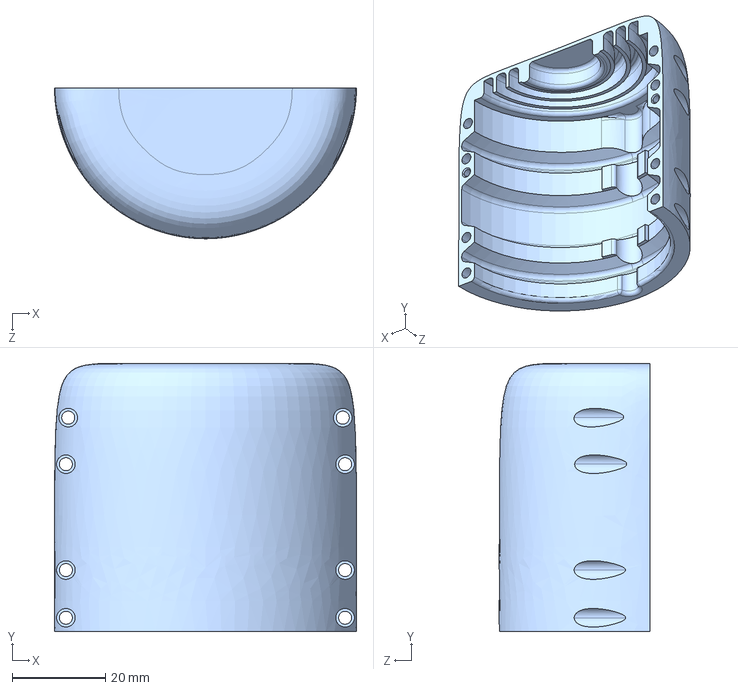
[picture p60: CAD file, 2026-10-24]
hardware/01_Mechanic/02_Manufacturing/01_CNC/7DOF/ROBOSKIN.0158_wrist_upper_clamp.step
64.9 x 57.7 x 32.4 mm
