oznav2/tectile_skin/hardware/01_Mechanic/02_Manufacturing/01_CNC/Common/ROBOSKIN.0185_mirrored_75_shoulder_clamp_(01_revision_).step

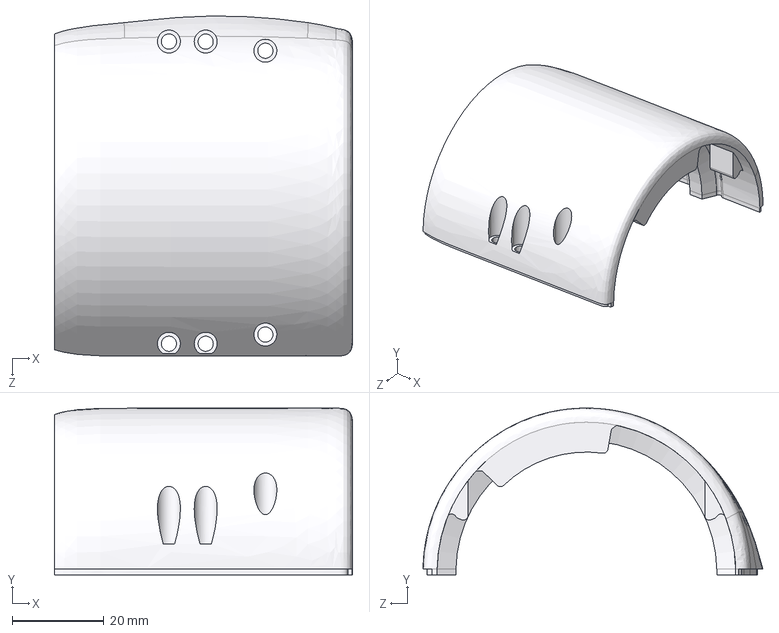
[picture p61: CAD file, 2026-10-24]
hardware/01_Mechanic/02_Manufacturing/01_CNC/Common/ROBOSKIN.0185_mirrored_75_shoulder_clamp_(01_revision_).step
65.0 x 36.3 x 74.0 mm
