oznav2/tectile_skin/hardware/01_Mechanic/02_Manufacturing/03_Rubber/STEP_3D_Models/ROBOSKIN.0239-02_debug_port_soft_rubber_cover.step

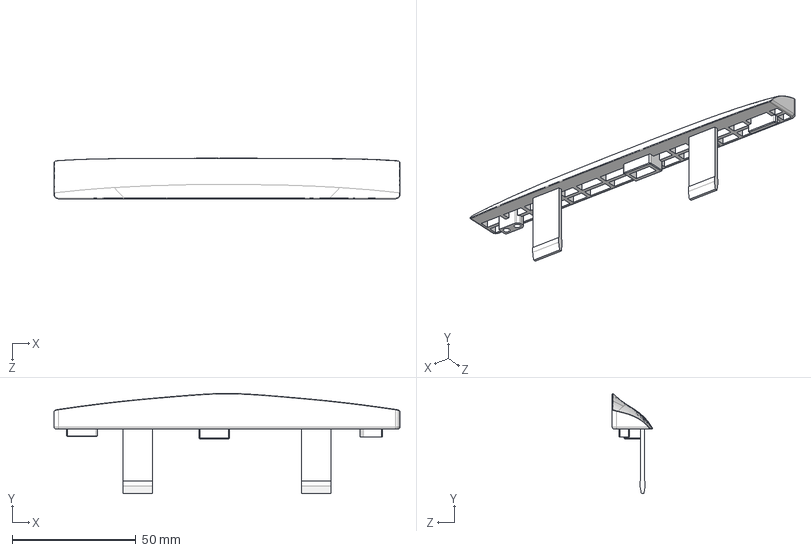
[picture p63: CAD file, 2026-10-24]
hardware/01_Mechanic/02_Manufacturing/03_Rubber/STEP_3D_Models/ROBOSKIN.0239-02_debug_port_soft_rubber_cover.step
139.6 x 40.4 x 16.3 mm
