oznav2/tectile_skin/hardware/01_Mechanic/02_Manufacturing/01_CNC/Common/ROBOSKIN.0200_mirrored_thigh_lower_body_left_(02_revision_).step

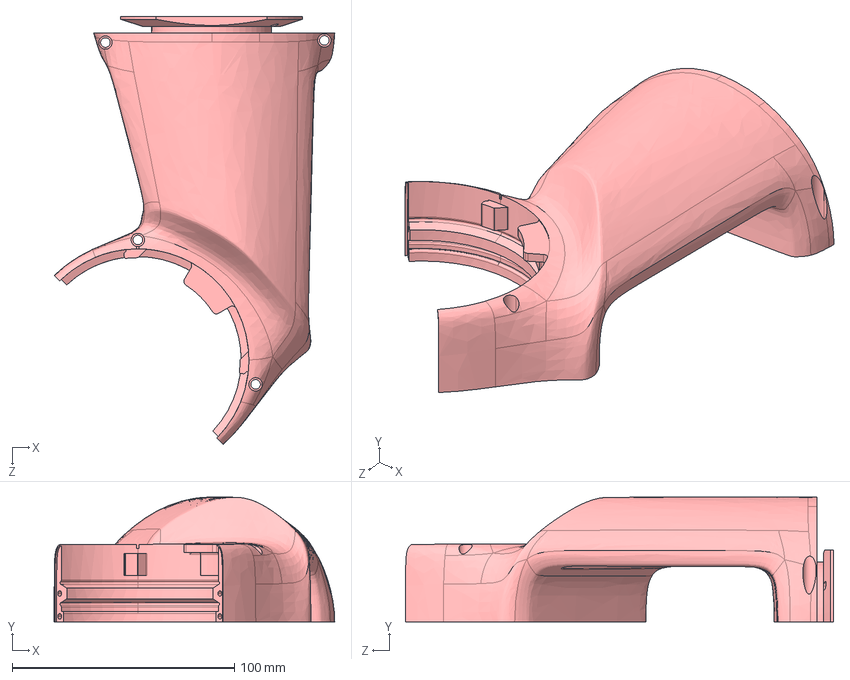
[picture p64: CAD file, 2026-10-24]
hardware/01_Mechanic/02_Manufacturing/01_CNC/Common/ROBOSKIN.0200_mirrored_thigh_lower_body_left_(02_revision_).step
126.3 x 56.2 x 192.7 mm
