oznav2/tectile_skin/hardware/01_Mechanic/02_Manufacturing/03_Rubber/STEP_3D_Models/ROBOSKIN.0089_hip_joint_impact_pad.step

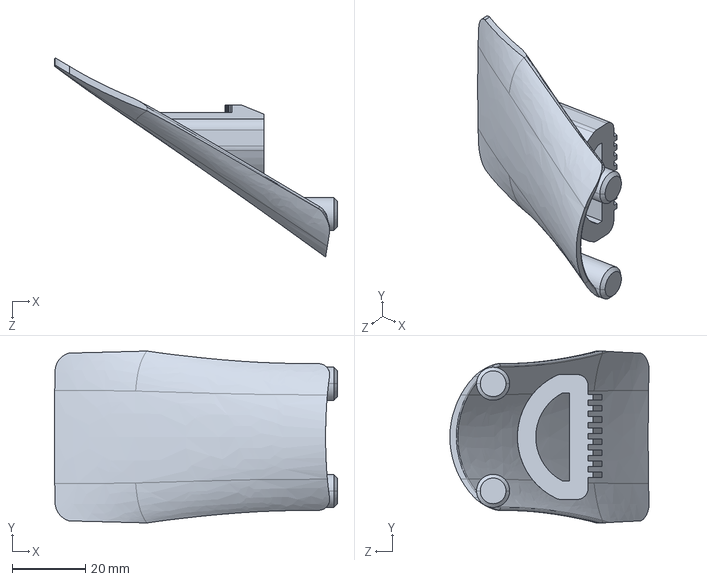
[picture p66: CAD file, 2026-10-24]
hardware/01_Mechanic/02_Manufacturing/03_Rubber/STEP_3D_Models/ROBOSKIN.0089_hip_joint_impact_pad.step
77.0 x 46.8 x 54.2 mm
