oznav2/tectile_skin/hardware/01_Mechanic/02_Manufacturing/01_CNC/7DOF/ROBOSKIN.0114_RP_Hand_adapter.step

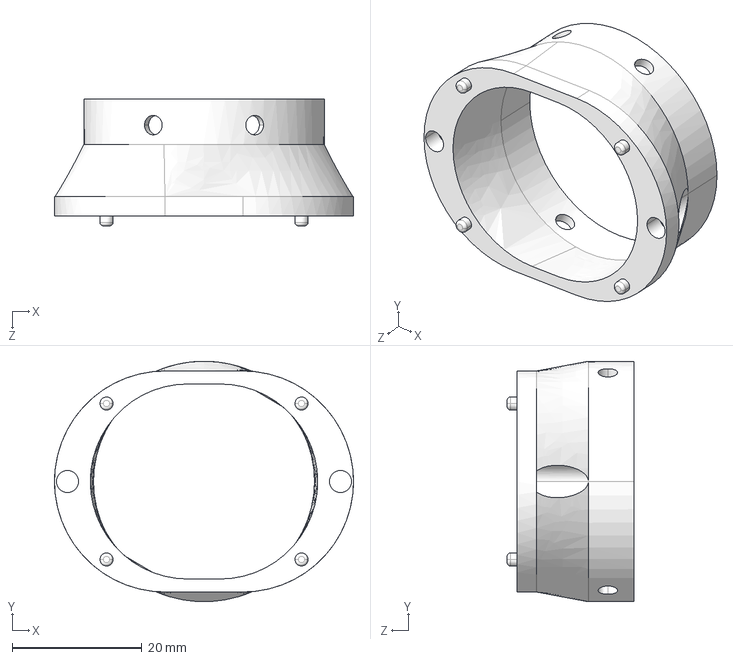
[picture p67: CAD file, 2026-10-24]
hardware/01_Mechanic/02_Manufacturing/01_CNC/7DOF/ROBOSKIN.0114_RP_Hand_adapter.step
46.0 x 37.0 x 19.5 mm
