oznav2/tectile_skin/hardware/01_Mechanic/02_Manufacturing/01_CNC/Common/ROBOSKIN.0103_hip_joint_front_cover_plate.step

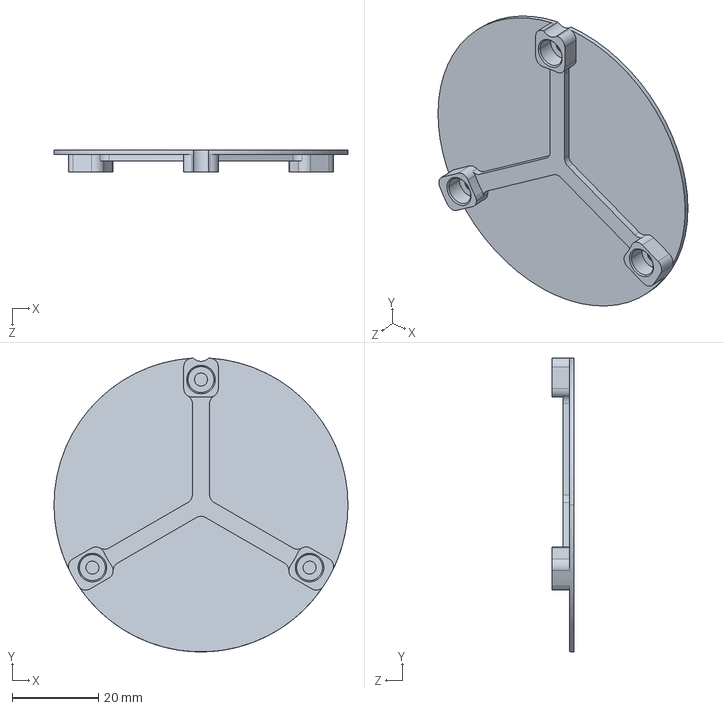
[picture p68: CAD file, 2026-10-24]
hardware/01_Mechanic/02_Manufacturing/01_CNC/Common/ROBOSKIN.0103_hip_joint_front_cover_plate.step
68.0 x 68.0 x 5.00 mm
