oznav2/tectile_skin/hardware/01_Mechanic/02_Manufacturing/02_3D_Printing/STEP_3D_Models/ROBOSKIN.0166_waist_roll_cable_retention_block.step

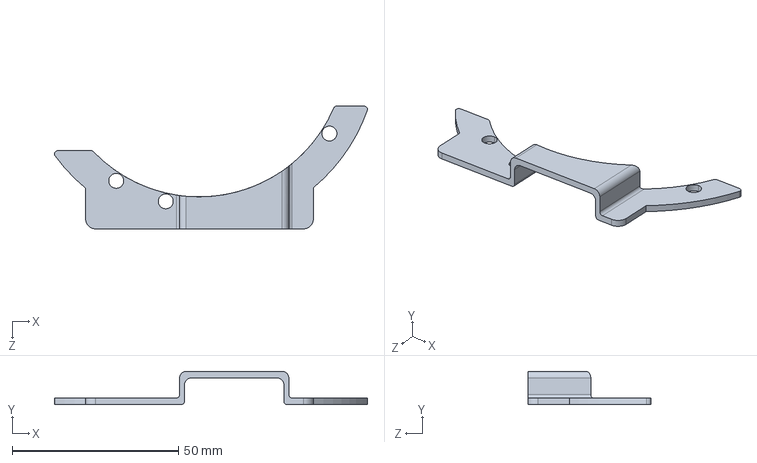
[picture p69: CAD file, 2026-10-24]
hardware/01_Mechanic/02_Manufacturing/02_3D_Printing/STEP_3D_Models/ROBOSKIN.0166_waist_roll_cable_retention_block.step
94.3 x 10.0 x 37.0 mm
