oznav2/tectile_skin/hardware/01_Mechanic/02_Manufacturing/03_Rubber/STEP_3D_Models/ROBOSKIN.0128_handle_rubber_sleeve.step

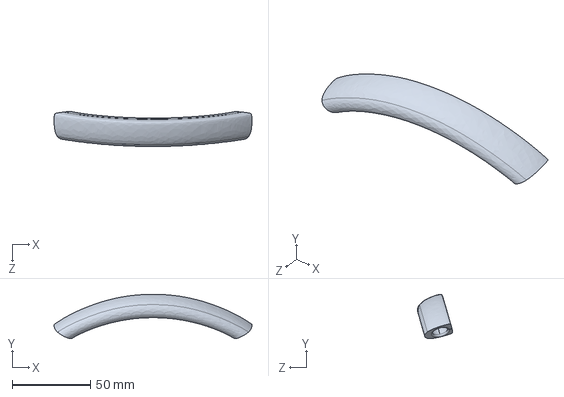
[picture p70: CAD file, 2026-10-24]
hardware/01_Mechanic/02_Manufacturing/03_Rubber/STEP_3D_Models/ROBOSKIN.0128_handle_rubber_sleeve.step
126.3 x 28.3 x 22.4 mm
