oznav2/tectile_skin/hardware/01_Mechanic/02_Manufacturing/01_CNC/7DOF/ROBOSKIN.0112_wrist_end_body.step

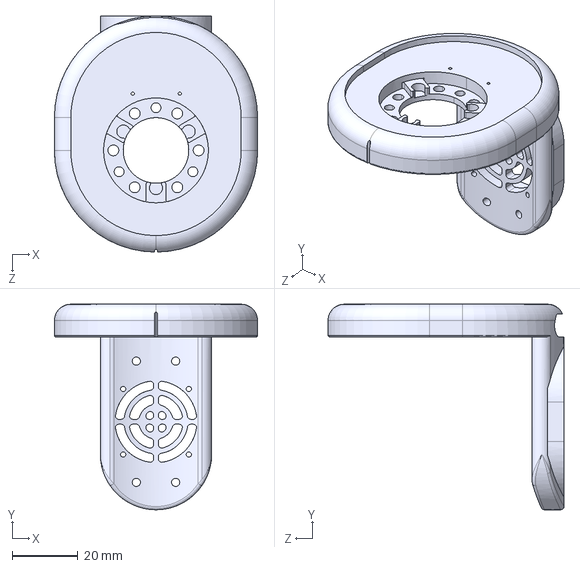
[picture p71: CAD file, 2026-10-24]
hardware/01_Mechanic/02_Manufacturing/01_CNC/7DOF/ROBOSKIN.0112_wrist_end_body.step
62.0 x 62.7 x 72.0 mm
