oznav2/tectile_skin/hardware/01_Mechanic/02_Manufacturing/01_CNC/Common/ROBOSKIN.0151_shin_ankle_spacer_block.step

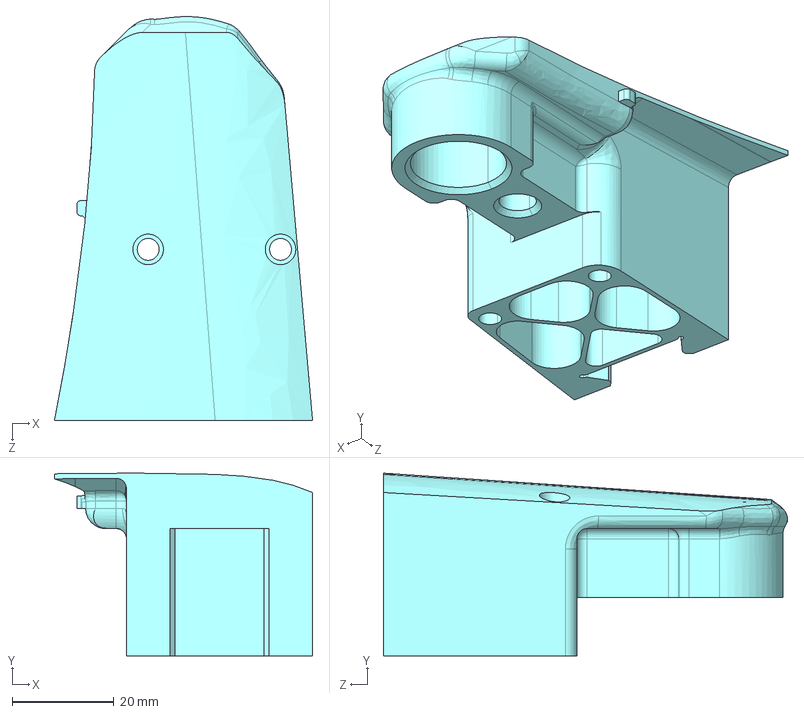
[picture p72: CAD file, 2026-10-24]
hardware/01_Mechanic/02_Manufacturing/01_CNC/Common/ROBOSKIN.0151_shin_ankle_spacer_block.step
50.7 x 35.9 x 79.4 mm
