oznav2/tectile_skin/hardware/01_Mechanic/02_Manufacturing/02_3D_Printing/STEP_3D_Models/ROBOSKIN.0111_wrist_end_cover_plate.step

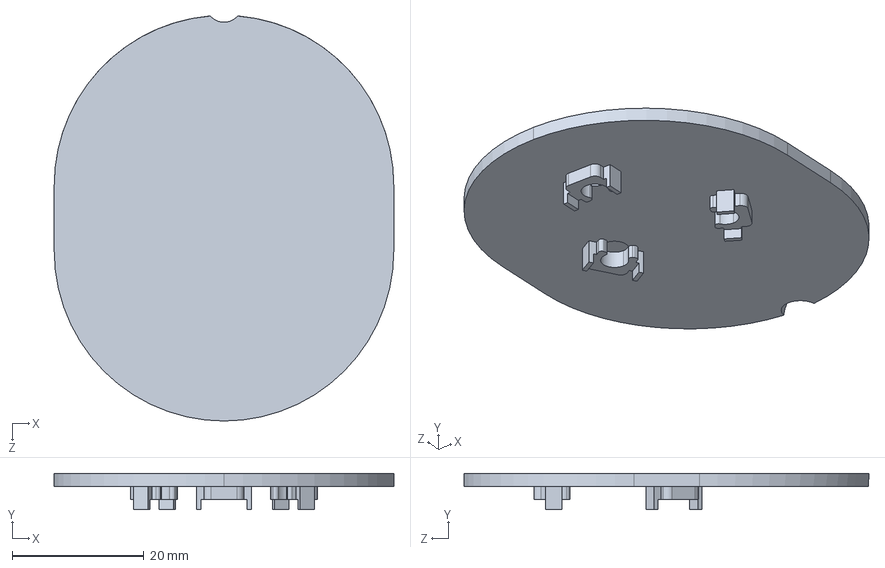
[picture p73: CAD file, 2026-10-24]
hardware/01_Mechanic/02_Manufacturing/02_3D_Printing/STEP_3D_Models/ROBOSKIN.0111_wrist_end_cover_plate.step
51.5 x 5.50 x 61.4 mm
