oznav2/tectile_skin/hardware/01_Mechanic/02_Manufacturing/01_CNC/Common/ROBOSKIN.0231_interactive_head_mounting_bracket.step

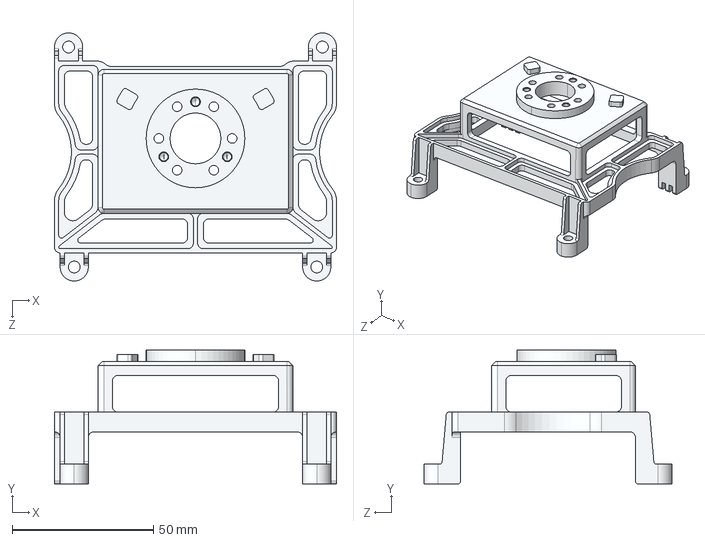
[picture p74: CAD file, 2026-10-24]
hardware/01_Mechanic/02_Manufacturing/01_CNC/Common/ROBOSKIN.0231_interactive_head_mounting_bracket.step
100.0 x 47.5 x 88.0 mm
