oznav2/tectile_skin/hardware/01_Mechanic/02_Manufacturing/01_CNC/Common/ROBOSKIN.0246_mirrored_97_limit_ring.step

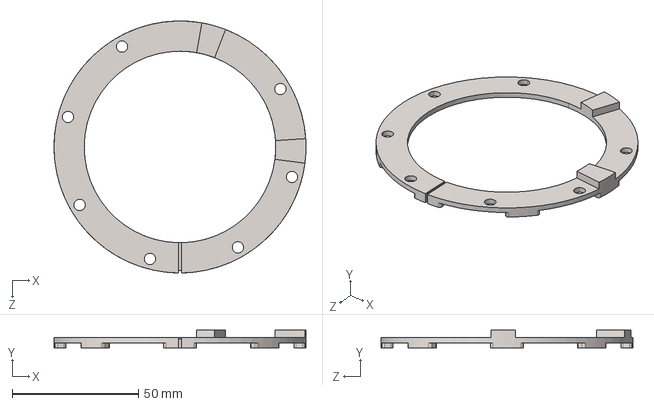
[picture p76: CAD file, 2026-10-24]
hardware/01_Mechanic/02_Manufacturing/01_CNC/Common/ROBOSKIN.0246_mirrored_97_limit_ring.step
100.0 x 7.00 x 100.0 mm
