oznav2/tectile_skin/hardware/01_Mechanic/02_Manufacturing/02_3D_Printing/STEP_3D_Models/ROBOSKIN.0106_upper_arm_upper_cover.step

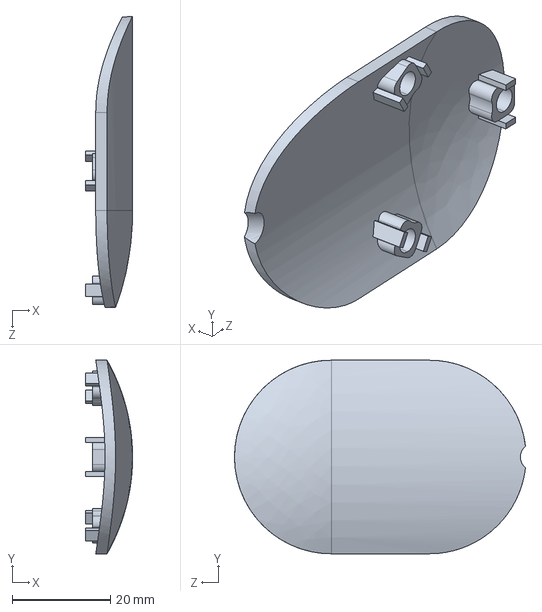
[picture p77: CAD file, 2026-10-24]
hardware/01_Mechanic/02_Manufacturing/02_3D_Printing/STEP_3D_Models/ROBOSKIN.0106_upper_arm_upper_cover.step
9.64 x 39.5 x 59.4 mm
