oznav2/tectile_skin/hardware/01_Mechanic/02_Manufacturing/01_CNC/Common/ROBOSKIN.0154_mirrored_shin_body_right.step

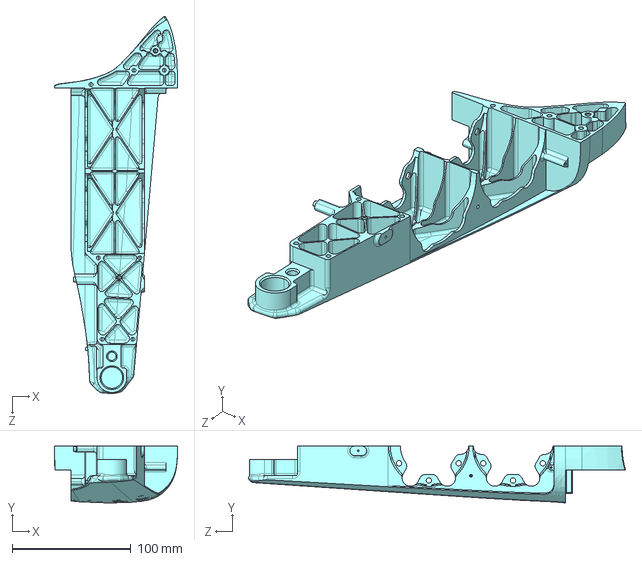
[picture p78: CAD file, 2026-10-24]
hardware/01_Mechanic/02_Manufacturing/01_CNC/Common/ROBOSKIN.0154_mirrored_shin_body_right.step
103.7 x 47.9 x 317.8 mm
