oznav2/tectile_skin/hardware/01_Mechanic/02_Manufacturing/02_3D_Printing/STEP_3D_Models/ROBOSKIN.0262-02_interactive_head_rear_trim_cover.step

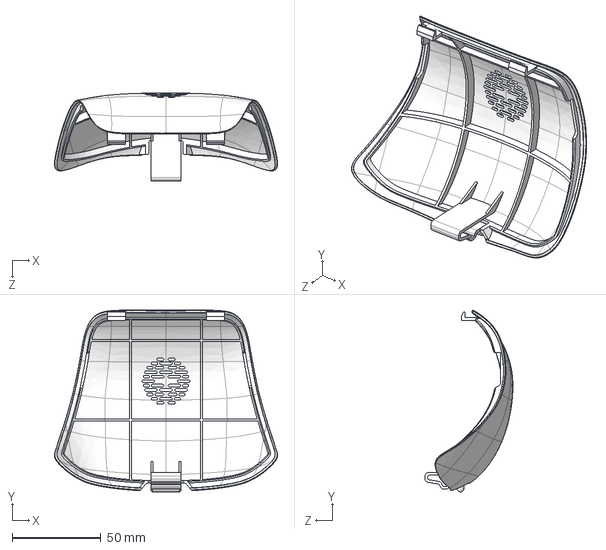
[picture p79: CAD file, 2026-10-24]
hardware/01_Mechanic/02_Manufacturing/02_3D_Printing/STEP_3D_Models/ROBOSKIN.0262-02_interactive_head_rear_trim_cover.step
125.9 x 102.6 x 49.6 mm
