oznav2/tectile_skin/hardware/01_Mechanic/02_Manufacturing/01_CNC/Common/ROBOSKIN.0219_waist_bracket.step

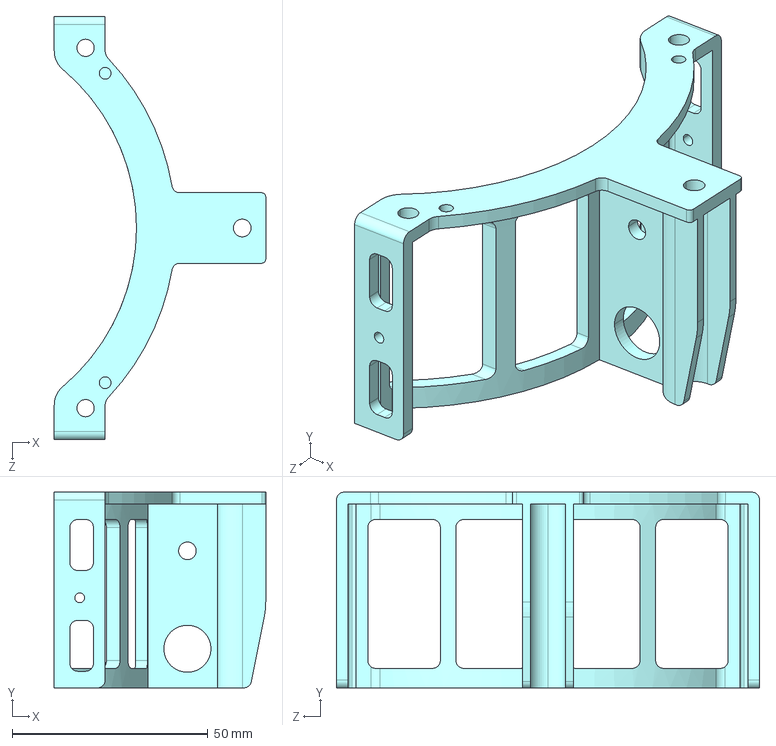
[picture p80: CAD file, 2026-10-24]
hardware/01_Mechanic/02_Manufacturing/01_CNC/Common/ROBOSKIN.0219_waist_bracket.step
54.0 x 50.0 x 108.0 mm
