oznav2/tectile_skin/hardware/01_Mechanic/02_Manufacturing/02_3D_Printing/STEP_3D_Models/ROBOSKIN.0284_collector_board_isolation_cover.step

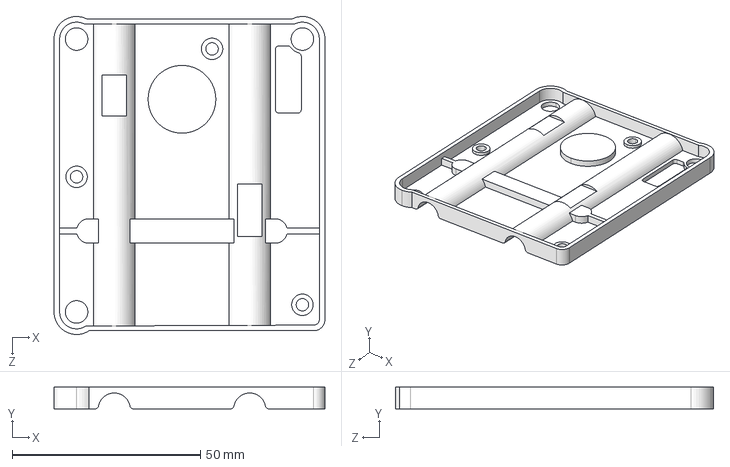
[picture p81: CAD file, 2026-10-24]
hardware/01_Mechanic/02_Manufacturing/02_3D_Printing/STEP_3D_Models/ROBOSKIN.0284_collector_board_isolation_cover.step
72.0 x 5.83 x 84.5 mm
