oznav2/tectile_skin/hardware/01_Mechanic/02_Manufacturing/01_CNC/Common/ROBOSKIN.0196_thigh_lower_motor_clamp_(01_revision_).step

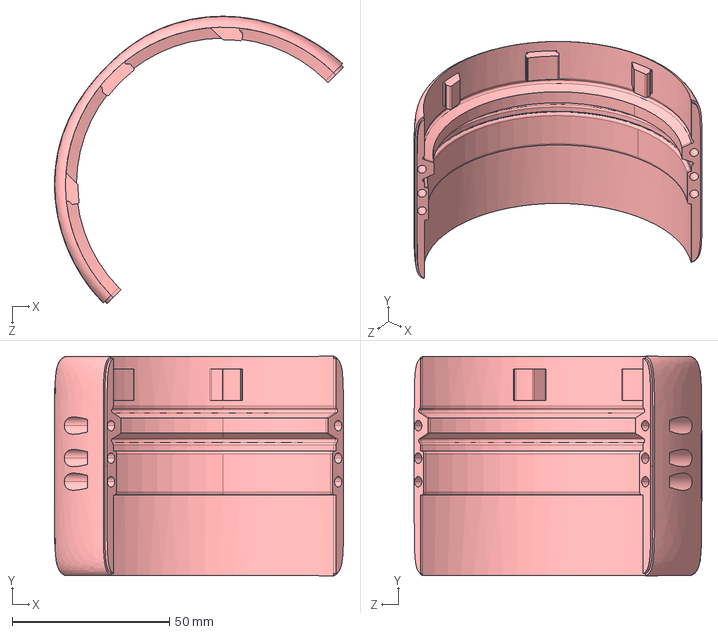
[picture p82: CAD file, 2026-10-24]
hardware/01_Mechanic/02_Manufacturing/01_CNC/Common/ROBOSKIN.0196_thigh_lower_motor_clamp_(01_revision_).step
91.8 x 69.8 x 91.3 mm
