oznav2/tectile_skin/hardware/01_Mechanic/02_Manufacturing/02_3D_Printing/STEP_3D_Models/ROBOSKIN.0274_neck_cable_guide_clip.step

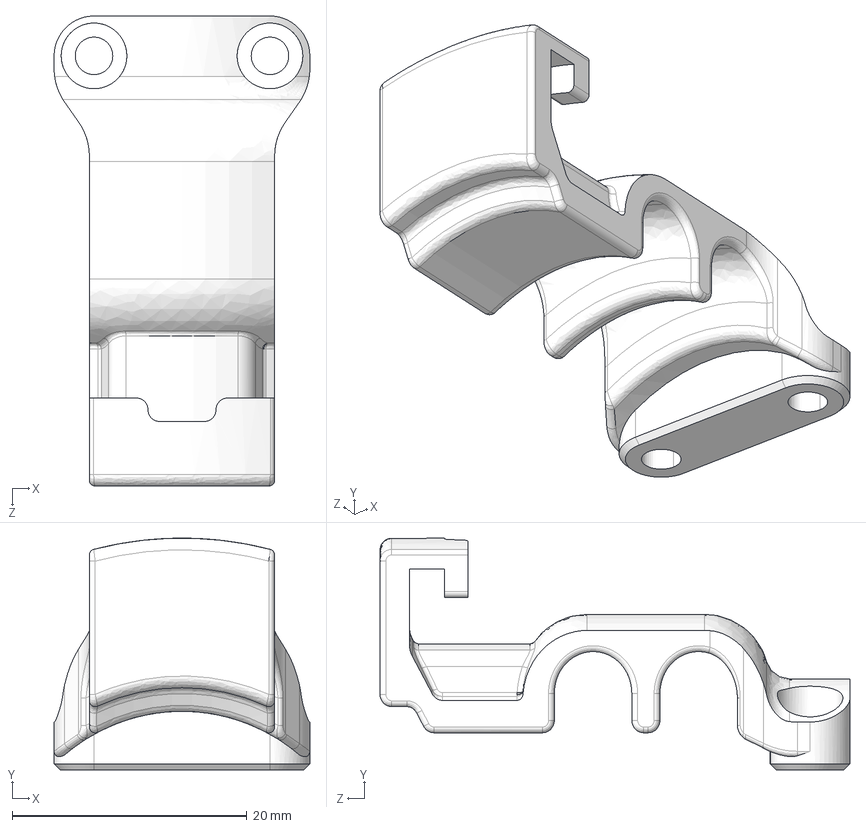
[picture p83: CAD file, 2026-10-24]
hardware/01_Mechanic/02_Manufacturing/02_3D_Printing/STEP_3D_Models/ROBOSKIN.0274_neck_cable_guide_clip.step
21.8 x 19.7 x 40.1 mm
