oznav2/tectile_skin/hardware/01_Mechanic/02_Manufacturing/01_CNC/Common/ROBOSKIN.0081_hip_joint_rear_(LS_revision_).step

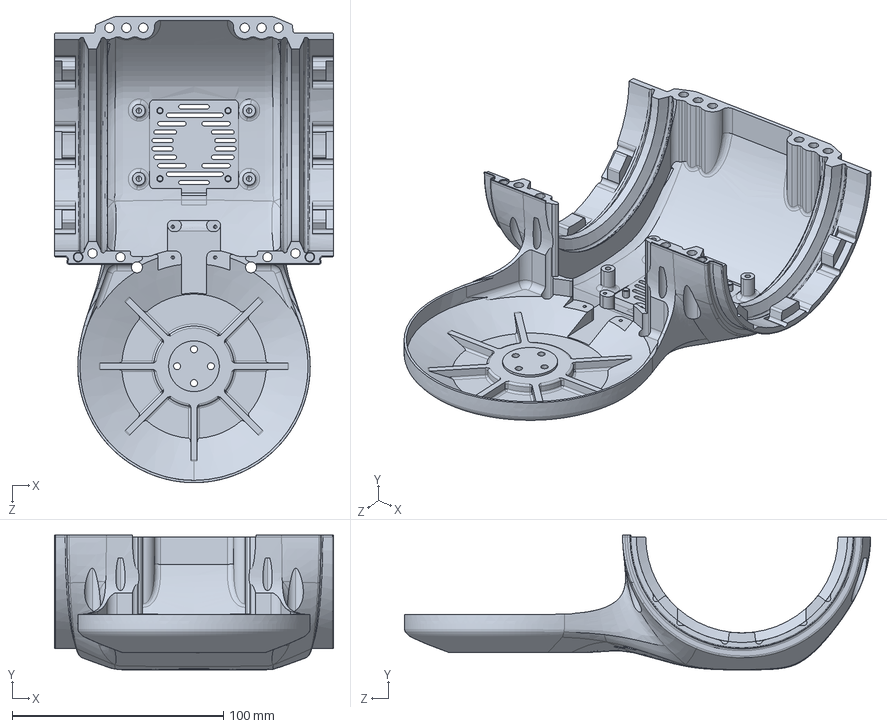
[picture p84: CAD file, 2026-10-24]
hardware/01_Mechanic/02_Manufacturing/01_CNC/Common/ROBOSKIN.0081_hip_joint_rear_(LS_revision_).step
132.0 x 63.8 x 220.7 mm
