oznav2/tectile_skin/hardware/01_Mechanic/02_Manufacturing/01_CNC/Common/ROBOSKIN.0164_thigh_lower_cover_plate_right.step

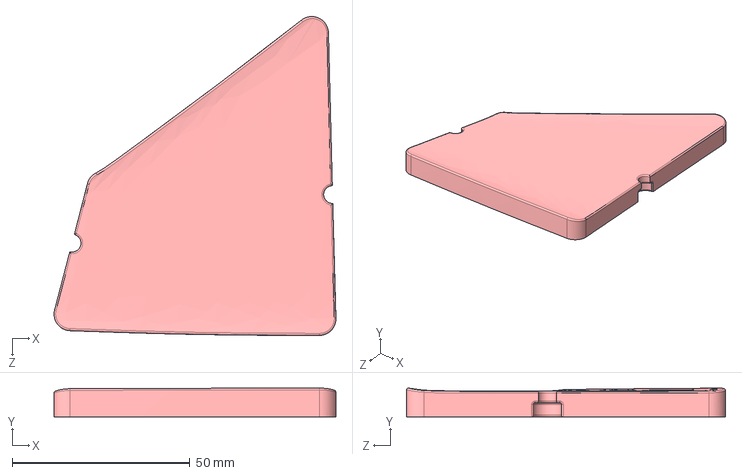
[picture p86: CAD file, 2026-10-24]
hardware/01_Mechanic/02_Manufacturing/01_CNC/Common/ROBOSKIN.0164_thigh_lower_cover_plate_right.step
79.4 x 8.15 x 89.8 mm
