oznav2/tectile_skin/hardware/01_Mechanic/02_Manufacturing/02_3D_Printing/STEP_3D_Models/ROBOSKIN.0288_interactive_head_cable_channel.step

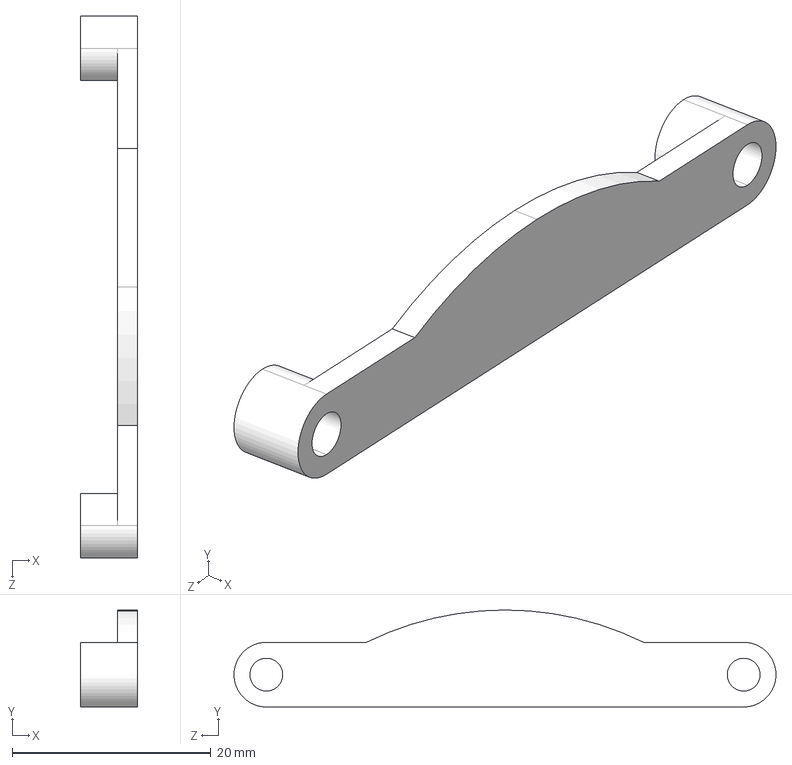
[picture p87: CAD file, 2026-10-24]
hardware/01_Mechanic/02_Manufacturing/02_3D_Printing/STEP_3D_Models/ROBOSKIN.0288_interactive_head_cable_channel.step
5.70 x 9.75 x 54.5 mm
