oznav2/tectile_skin/hardware/01_Mechanic/02_Manufacturing/01_CNC/Common/ROBOSKIN.0148_shin_motor_spacer_block.step

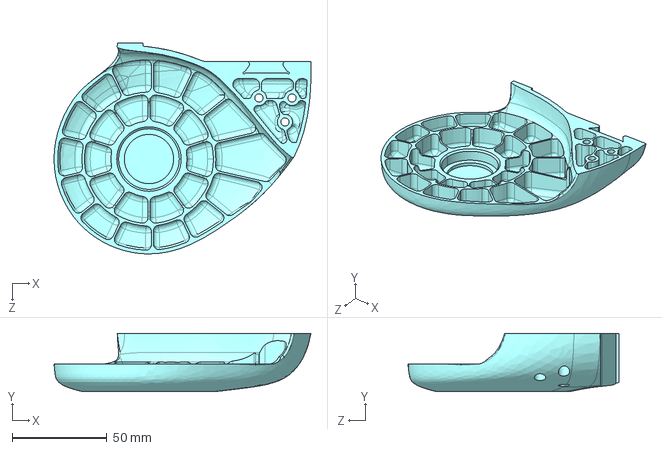
[picture p88: CAD file, 2026-10-24]
hardware/01_Mechanic/02_Manufacturing/01_CNC/Common/ROBOSKIN.0148_shin_motor_spacer_block.step
135.5 x 30.7 x 111.2 mm
