oznav2/tectile_skin/hardware/01_Mechanic/02_Manufacturing/02_3D_Printing/STEP_3D_Models/ROBOSKIN.0282_Mingmei_battery_bay_upper_segment.step

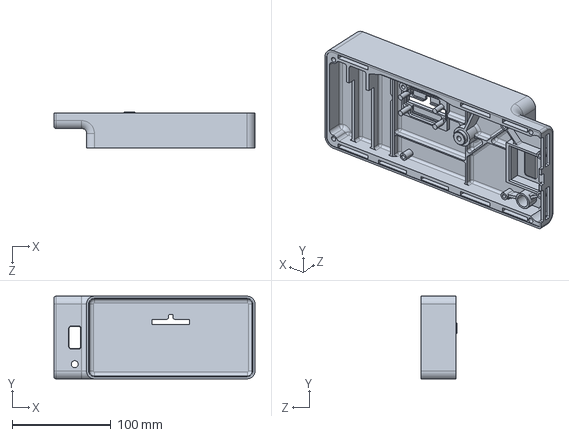
[picture p89: CAD file, 2026-10-24]
hardware/01_Mechanic/02_Manufacturing/02_3D_Printing/STEP_3D_Models/ROBOSKIN.0282_Mingmei_battery_bay_upper_segment.step
203.8 x 83.8 x 36.9 mm
