oznav2/tectile_skin/hardware/01_Mechanic/02_Manufacturing/02_3D_Printing/STEP_3D_Models/ROBOSKIN.0256-02_interactive_head_screen_bottom_bracket.step

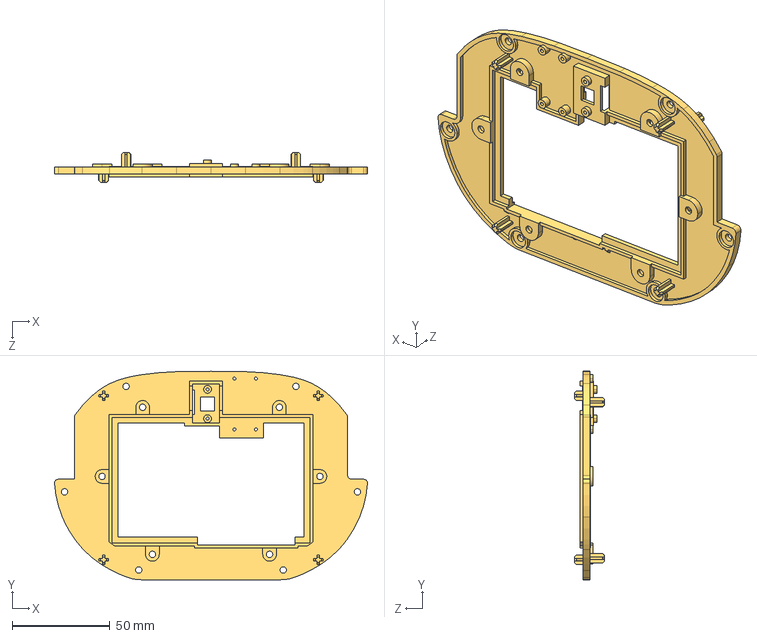
[picture p90: CAD file, 2026-10-24]
hardware/01_Mechanic/02_Manufacturing/02_3D_Printing/STEP_3D_Models/ROBOSKIN.0256-02_interactive_head_screen_bottom_bracket.step
160.3 x 106.8 x 15.5 mm
