oznav2/tectile_skin/hardware/01_Mechanic/02_Manufacturing/01_CNC/Common/ROBOSKIN.0192_thigh_clamp_(_production_).step

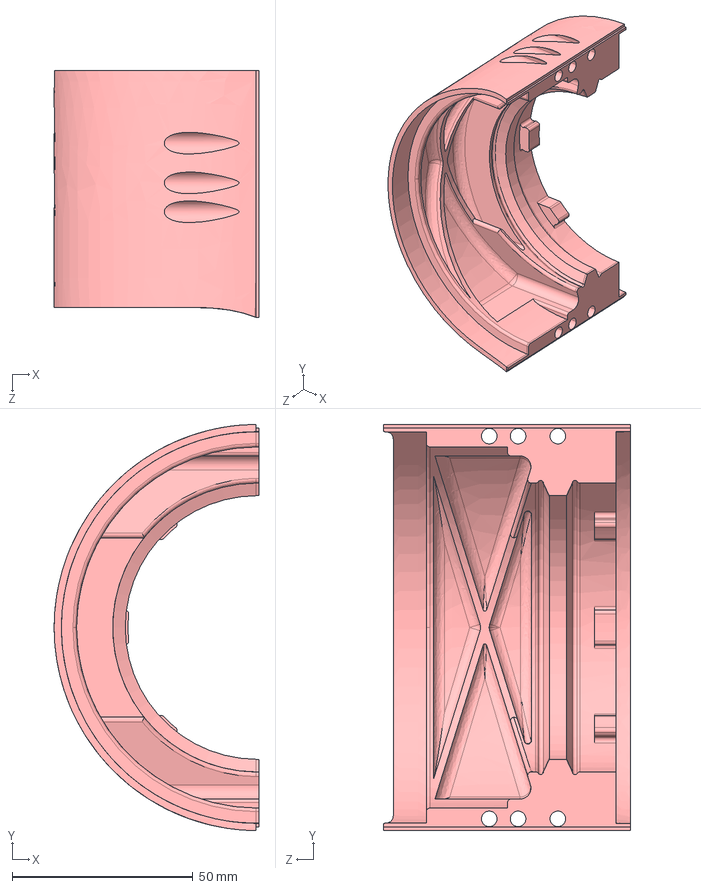
[picture p91: CAD file, 2026-10-24]
hardware/01_Mechanic/02_Manufacturing/01_CNC/Common/ROBOSKIN.0192_thigh_clamp_(_production_).step
56.7 x 112.4 x 68.4 mm
