oznav2/tectile_skin/hardware/01_Mechanic/02_Manufacturing/02_3D_Printing/STEP_3D_Models/ROBOSKIN.0260-02_interactive_head_SOC_plate_body_bracket.step

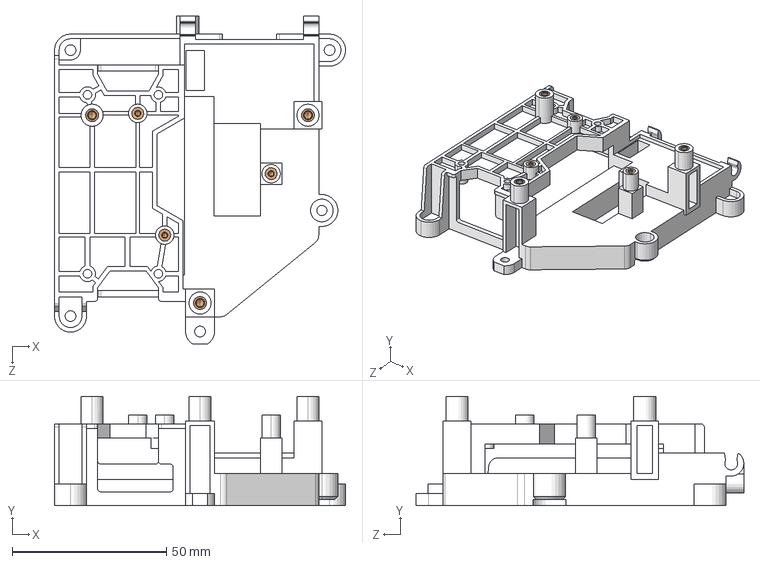
[picture p92: CAD file, 2026-10-24]
hardware/01_Mechanic/02_Manufacturing/02_3D_Printing/STEP_3D_Models/ROBOSKIN.0260-02_interactive_head_SOC_plate_body_bracket.step
94.4 x 35.5 x 106.3 mm
