oznav2/tectile_skin/hardware/01_Mechanic/02_Manufacturing/01_CNC/Common/ROBOSKIN.0082_hip_joint_left_(LS_revision_).step

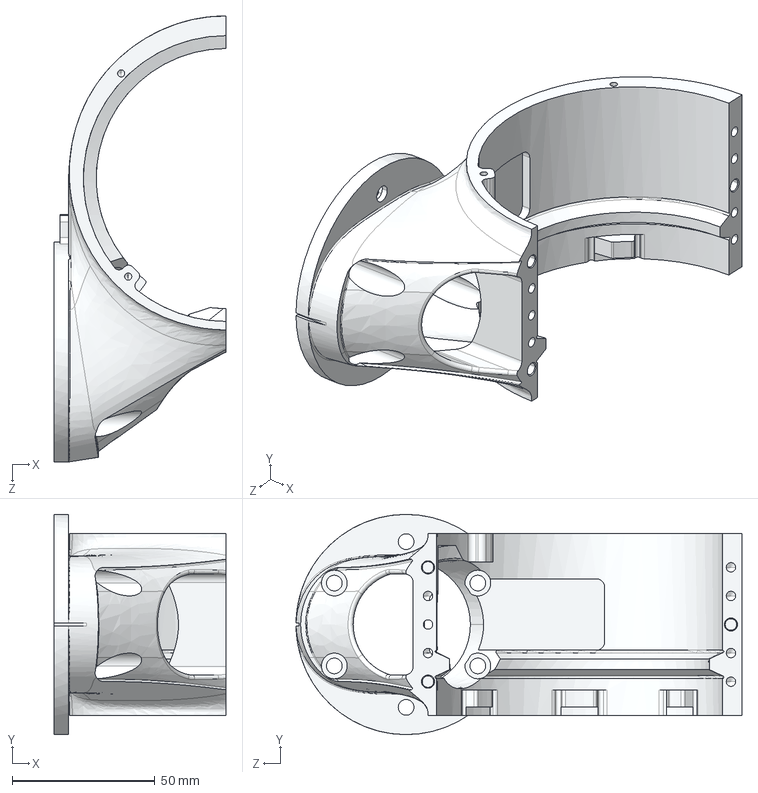
[picture p95: CAD file, 2026-10-24]
hardware/01_Mechanic/02_Manufacturing/01_CNC/Common/ROBOSKIN.0082_hip_joint_left_(LS_revision_).step
60.2 x 77.1 x 156.1 mm
