oznav2/tectile_skin/hardware/01_Mechanic/02_Manufacturing/02_3D_Printing/STEP_3D_Models/ROBOSKIN.0110_wrist_end_cable_retention_block.step

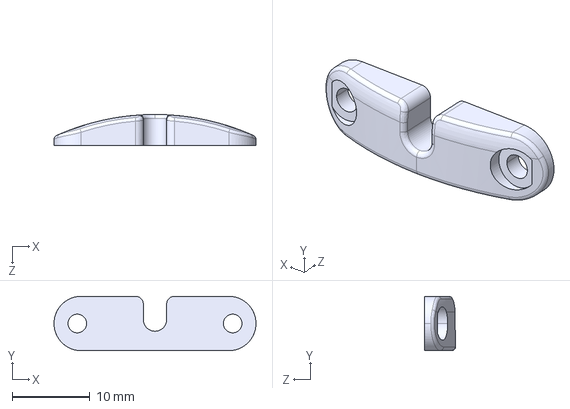
[picture p96: CAD file, 2026-10-24]
hardware/01_Mechanic/02_Manufacturing/02_3D_Printing/STEP_3D_Models/ROBOSKIN.0110_wrist_end_cable_retention_block.step
26.0 x 7.00 x 4.00 mm
