oznav2/tectile_skin/hardware/01_Mechanic/02_Manufacturing/01_CNC/Common/ROBOSKIN.0088_hip_joint_right_clamp.step

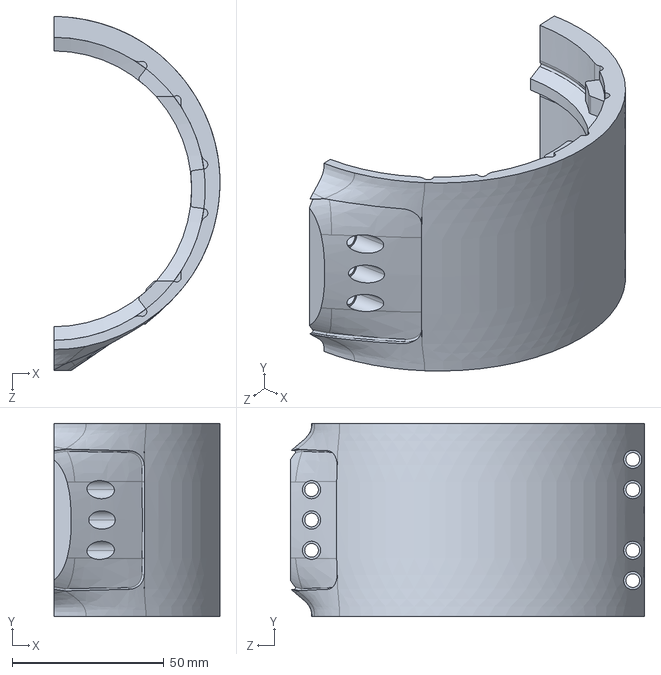
[picture p97: CAD file, 2026-10-24]
hardware/01_Mechanic/02_Manufacturing/01_CNC/Common/ROBOSKIN.0088_hip_joint_right_clamp.step
54.8 x 63.8 x 116.8 mm
