oznav2/tectile_skin/hardware/01_Mechanic/02_Manufacturing/02_3D_Printing/STEP_3D_Models/ROBOSKIN.0276_backplane_FPC_clamping_plate.step

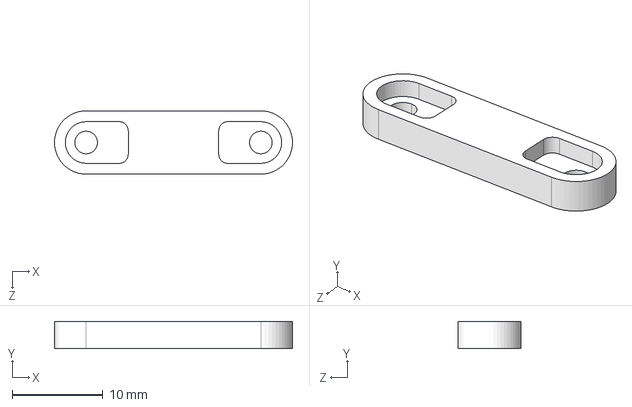
[picture p98: CAD file, 2026-10-24]
hardware/01_Mechanic/02_Manufacturing/02_3D_Printing/STEP_3D_Models/ROBOSKIN.0276_backplane_FPC_clamping_plate.step
26.3 x 3.00 x 7.00 mm
