oznav2/tectile_skin/hardware/01_Mechanic/02_Manufacturing/02_3D_Printing/STEP_3D_Models/ROBOSKIN.0092_cable_clamp_block_1.step

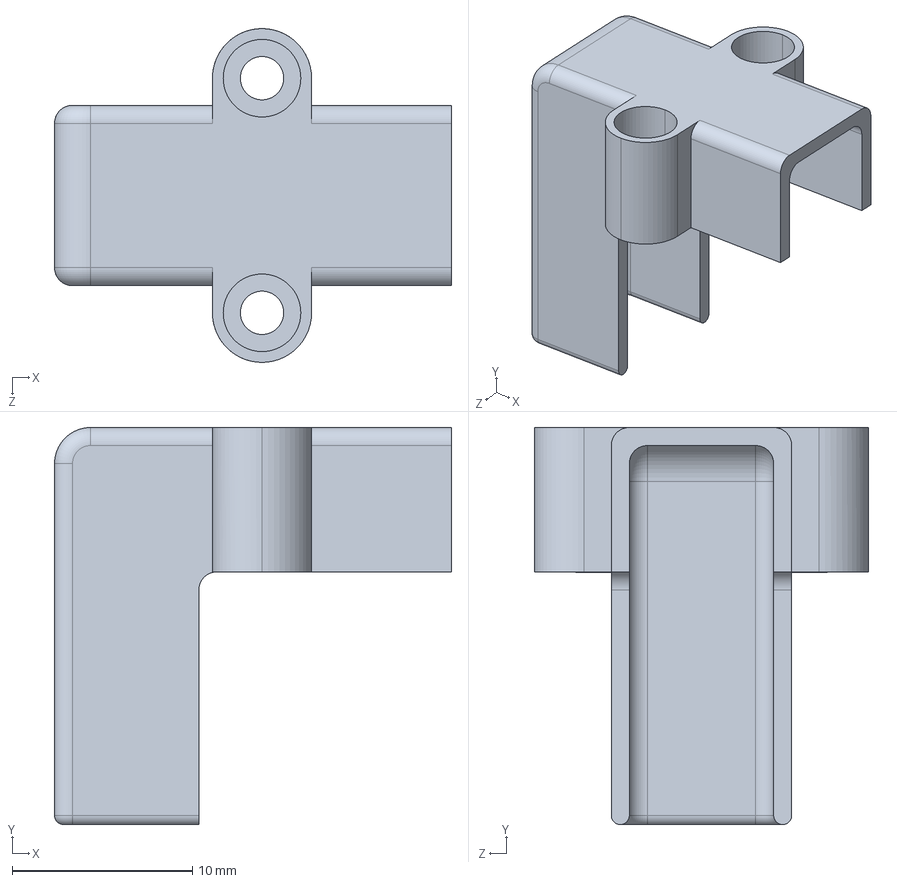
[picture p99: CAD file, 2026-10-24]
hardware/01_Mechanic/02_Manufacturing/02_3D_Printing/STEP_3D_Models/ROBOSKIN.0092_cable_clamp_block_1.step
22.0 x 22.0 x 18.5 mm
