oznav2/tectile_skin/hardware/01_Mechanic/02_Manufacturing/02_3D_Printing/STEP_3D_Models/ROBOSKIN.0118_arm_cable_clamp_block_2.step

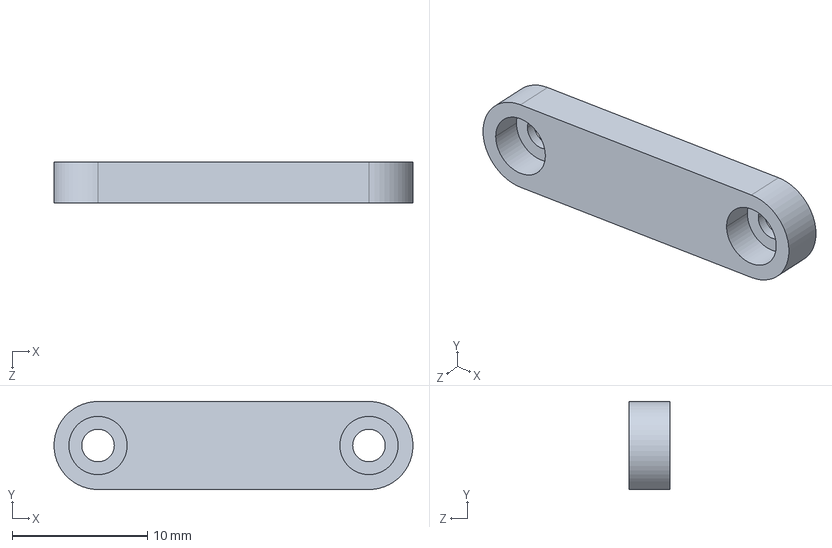
[picture p100: CAD file, 2026-10-24]
hardware/01_Mechanic/02_Manufacturing/02_3D_Printing/STEP_3D_Models/ROBOSKIN.0118_arm_cable_clamp_block_2.step
26.5 x 6.50 x 3.00 mm
