oznav2/tectile_skin/hardware/01_Mechanic/02_Manufacturing/01_CNC/Common/ROBOSKIN.0186_mirrored_75_shoulder_body_(01_revision_).step

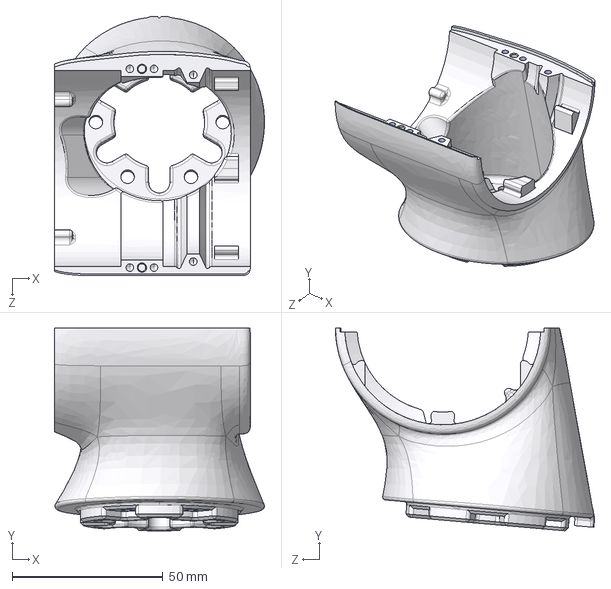
[picture p101: CAD file, 2026-10-24]
hardware/01_Mechanic/02_Manufacturing/01_CNC/Common/ROBOSKIN.0186_mirrored_75_shoulder_body_(01_revision_).step
69.5 x 67.1 x 85.9 mm
