oznav2/tectile_skin/hardware/01_Mechanic/02_Manufacturing/02_3D_Printing/STEP_3D_Models/ROBOSKIN.0095_shin_cable_clamp_block_2.step

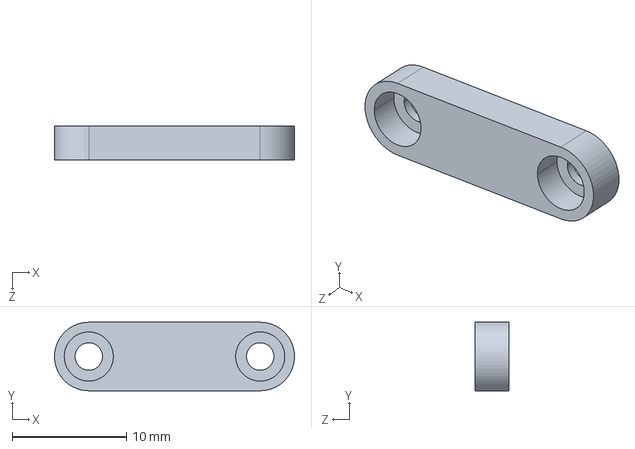
[picture p102: CAD file, 2026-10-24]
hardware/01_Mechanic/02_Manufacturing/02_3D_Printing/STEP_3D_Models/ROBOSKIN.0095_shin_cable_clamp_block_2.step
21.0 x 6.00 x 3.00 mm
