oznav2/tectile_skin/hardware/01_Mechanic/02_Manufacturing/01_CNC/Common/ROBOSKIN.0190_Roll_travel_stop.step

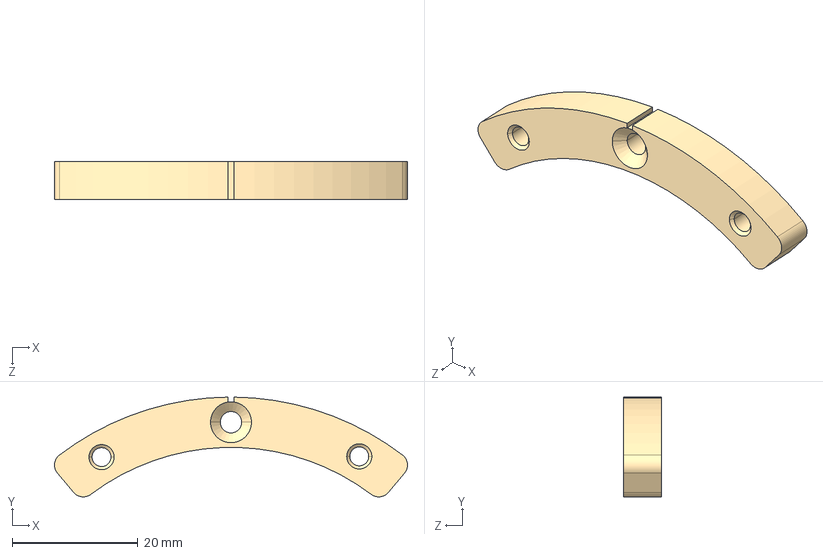
[picture p103: CAD file, 2026-10-24]
hardware/01_Mechanic/02_Manufacturing/01_CNC/Common/ROBOSKIN.0190_Roll_travel_stop.step
56.2 x 15.9 x 6.00 mm
