oznav2/tectile_skin/hardware/01_Mechanic/02_Manufacturing/02_3D_Printing/STEP_3D_Models/ROBOSKIN.0109_mirrored_forearm_upper_cover.step

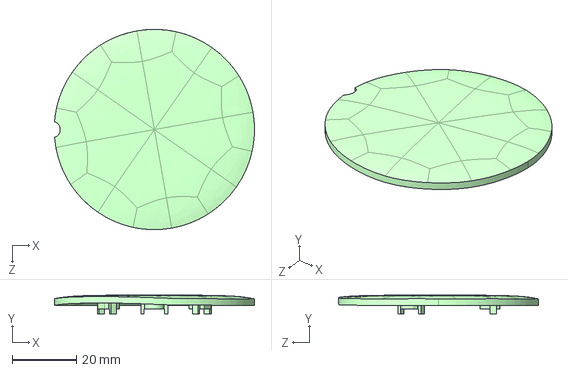
[picture p104: CAD file, 2026-10-24]
hardware/01_Mechanic/02_Manufacturing/02_3D_Printing/STEP_3D_Models/ROBOSKIN.0109_mirrored_forearm_upper_cover.step
62.4 x 5.84 x 62.5 mm
