oznav2/tectile_skin/hardware/01_Mechanic/02_Manufacturing/01_CNC/Common/ROBOSKIN.0119_elbow_bearing_housing.step

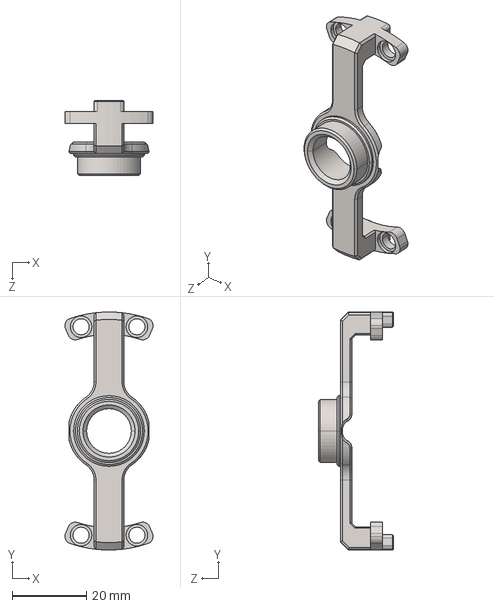
[picture p105: CAD file, 2026-10-24]
hardware/01_Mechanic/02_Manufacturing/01_CNC/Common/ROBOSKIN.0119_elbow_bearing_housing.step
23.7 x 64.0 x 20.2 mm
