oznav2/tectile_skin/hardware/01_Mechanic/02_Manufacturing/02_3D_Printing/STEP_3D_Models/ROBOSKIN.0257-02_interactive_screen_top_cover.step

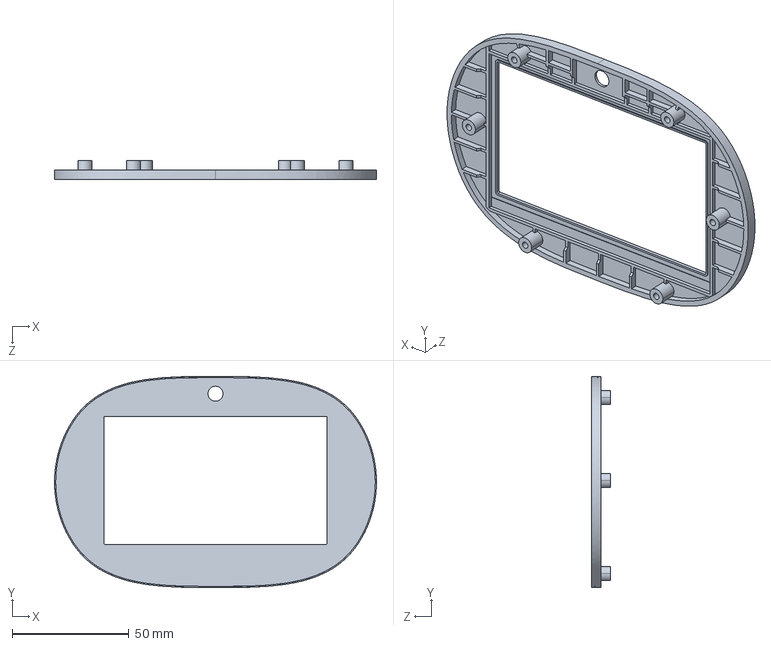
[picture p106: CAD file, 2026-10-24]
hardware/01_Mechanic/02_Manufacturing/02_3D_Printing/STEP_3D_Models/ROBOSKIN.0257-02_interactive_screen_top_cover.step
137.8 x 90.4 x 8.00 mm
