oznav2/tectile_skin/hardware/01_Mechanic/02_Manufacturing/01_CNC/Common/ROBOSKIN.0225_handle_-kickme.step

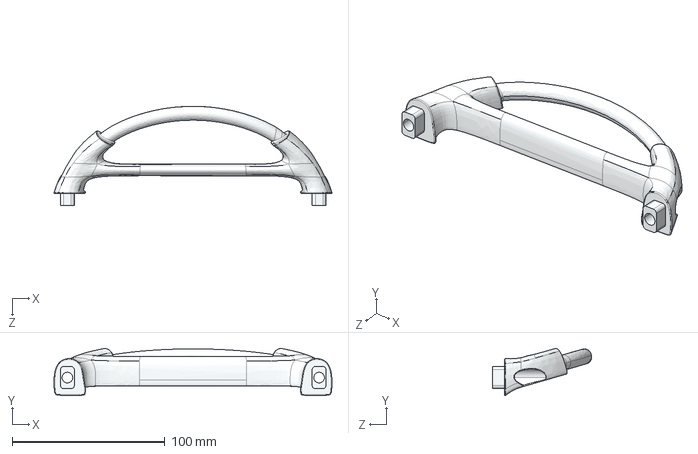
[picture p107: CAD file, 2026-10-24]
hardware/01_Mechanic/02_Manufacturing/01_CNC/Common/ROBOSKIN.0225_handle_-kickme.step
182.3 x 30.8 x 65.2 mm
