oznav2/tectile_skin/hardware/01_Mechanic/02_Manufacturing/02_3D_Printing/STEP_3D_Models/ROBOSKIN.0121_arm_cable_clamp_block_3.step

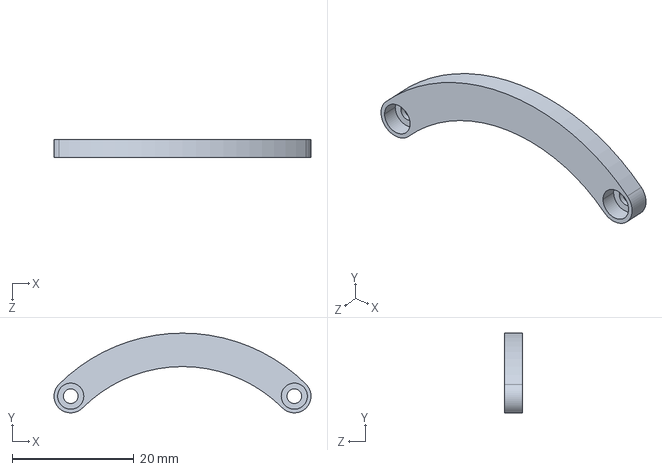
[picture p108: CAD file, 2026-10-24]
hardware/01_Mechanic/02_Manufacturing/02_3D_Printing/STEP_3D_Models/ROBOSKIN.0121_arm_cable_clamp_block_3.step
42.3 x 13.1 x 3.00 mm
