oznav2/tectile_skin/hardware/01_Mechanic/02_Manufacturing/01_CNC/Common/ROBOSKIN.0102_mirrored_Pitch_travel_stop.step

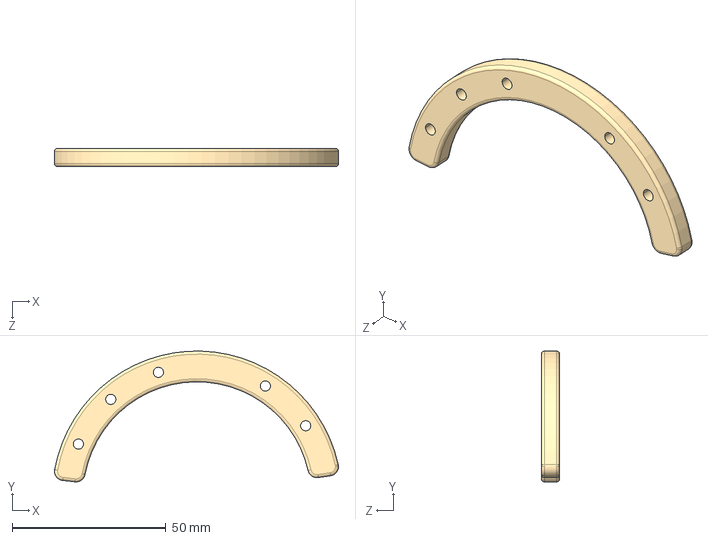
[picture p109: CAD file, 2026-10-24]
hardware/01_Mechanic/02_Manufacturing/01_CNC/Common/ROBOSKIN.0102_mirrored_Pitch_travel_stop.step
92.2 x 42.5 x 6.00 mm
