oznav2/tectile_skin/hardware/01_Mechanic/02_Manufacturing/02_3D_Printing/STEP_3D_Models/ROBOSKIN.0283_Mingmei_battery_bay_lower_segment.step

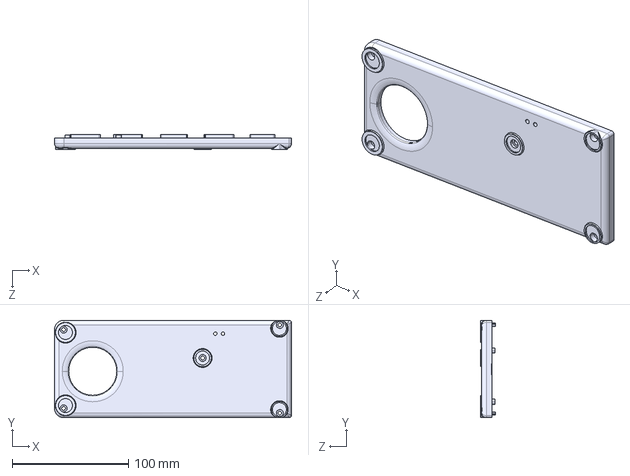
[picture p112: CAD file, 2026-10-24]
hardware/01_Mechanic/02_Manufacturing/02_3D_Printing/STEP_3D_Models/ROBOSKIN.0283_Mingmei_battery_bay_lower_segment.step
203.8 x 83.8 x 13.0 mm
