oznav2/tectile_skin/hardware/01_Mechanic/02_Manufacturing/01_CNC/Common/ROBOSKIN.0086_waist_motor_housing_(LS_revision_).step

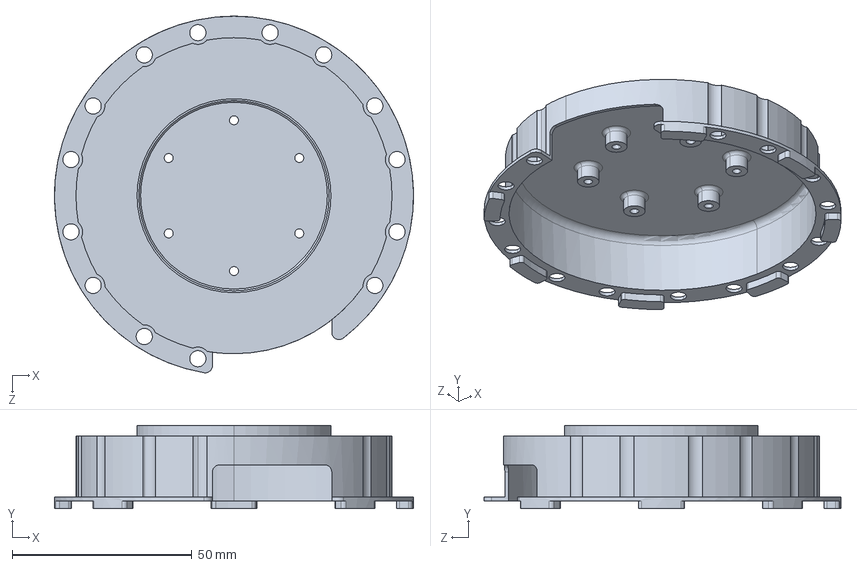
[picture p113: CAD file, 2026-10-24]
hardware/01_Mechanic/02_Manufacturing/01_CNC/Common/ROBOSKIN.0086_waist_motor_housing_(LS_revision_).step
100.0 x 23.2 x 99.3 mm
