oznav2/tectile_skin/hardware/01_Mechanic/02_Manufacturing/01_CNC/Common/ROBOSKIN.0273_motion_head_base_mounting_adapter.step

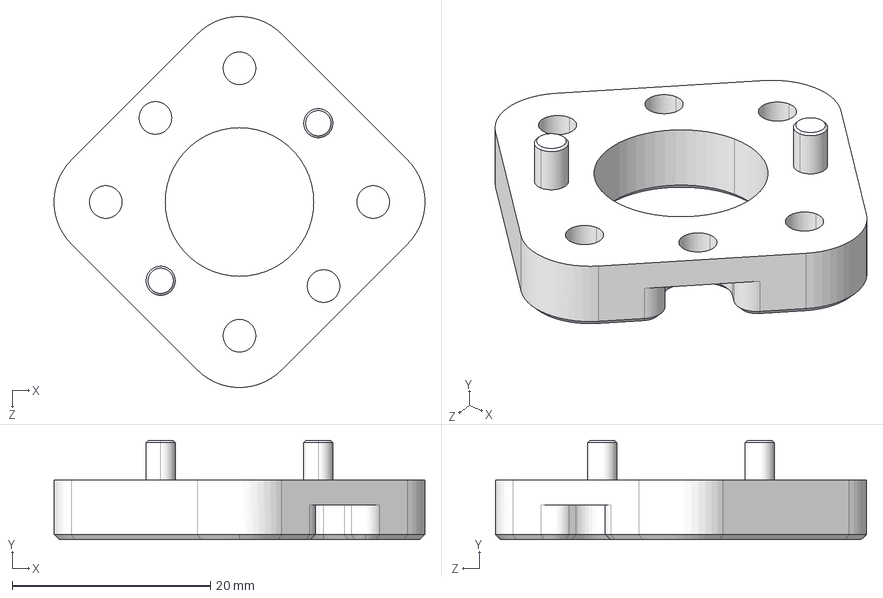
[picture p115: CAD file, 2026-10-24]
hardware/01_Mechanic/02_Manufacturing/01_CNC/Common/ROBOSKIN.0273_motion_head_base_mounting_adapter.step
37.4 x 10.0 x 37.5 mm
