oznav2/tectile_skin/hardware/01_Mechanic/02_Manufacturing/02_3D_Printing/STEP_3D_Models/ROBOSKIN.0259-02_interactive_head_lower_outer_shell_bracket.step

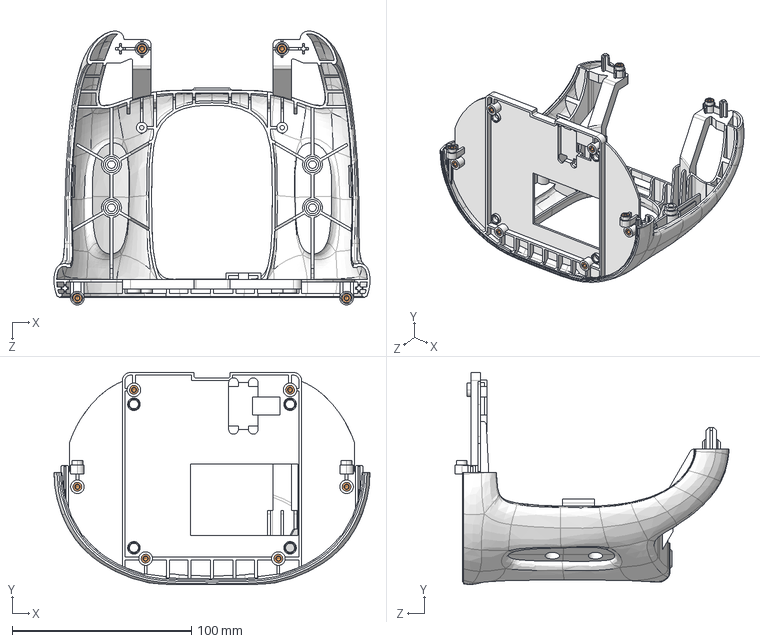
[picture p116: CAD file, 2026-10-24]
hardware/01_Mechanic/02_Manufacturing/02_3D_Printing/STEP_3D_Models/ROBOSKIN.0259-02_interactive_head_lower_outer_shell_bracket.step
176.1 x 118.1 x 152.6 mm
