oznav2/tectile_skin/hardware/01_Mechanic/02_Manufacturing/01_CNC/Common/ROBOSKIN.0189_sole_retention_number_2_(02_revision_).step

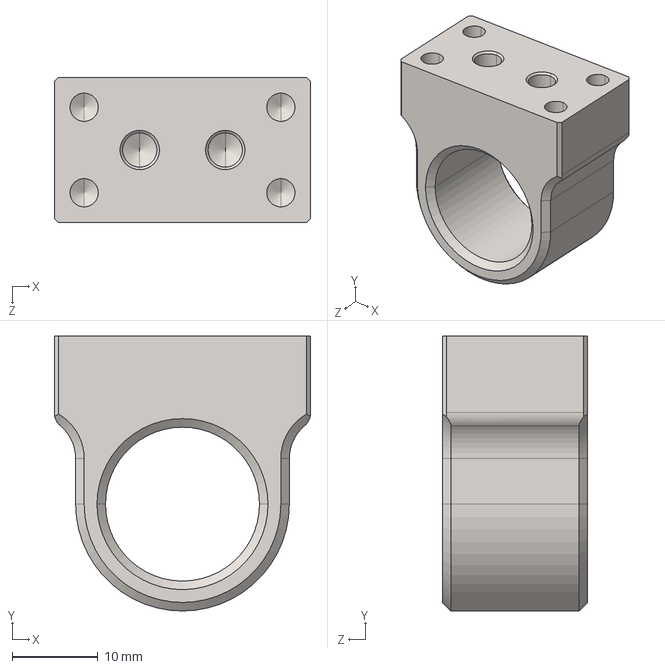
[picture p117: CAD file, 2026-10-24]
hardware/01_Mechanic/02_Manufacturing/01_CNC/Common/ROBOSKIN.0189_sole_retention_number_2_(02_revision_).step
30.0 x 32.2 x 17.0 mm
