oznav2/tectile_skin/hardware/01_Mechanic/02_Manufacturing/01_CNC/Common/ROBOSKIN.0153_mirrored_shin_body_left.step

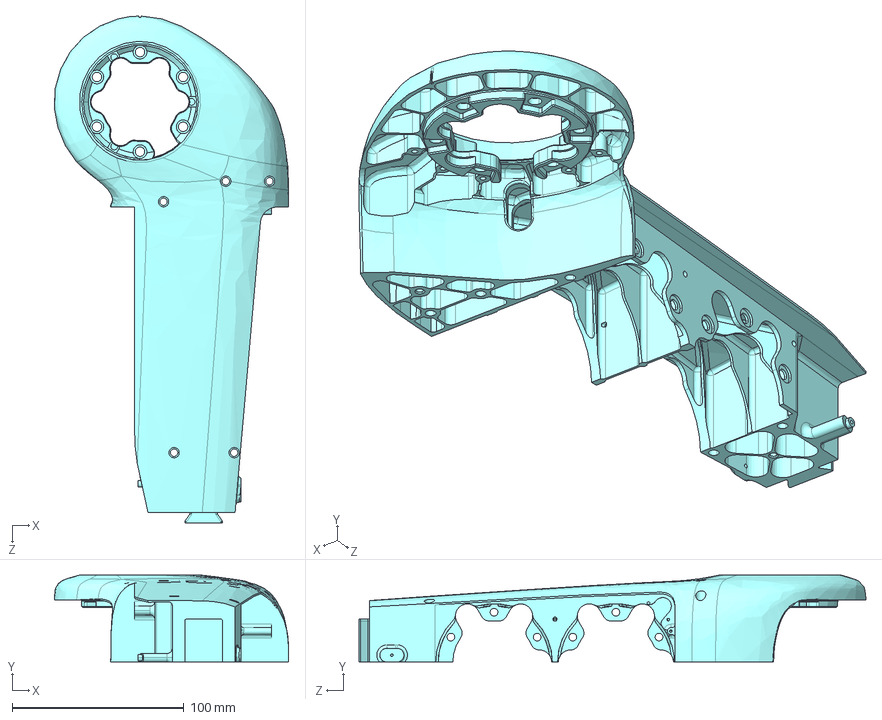
[picture p118: CAD file, 2026-10-24]
hardware/01_Mechanic/02_Manufacturing/01_CNC/Common/ROBOSKIN.0153_mirrored_shin_body_left.step
136.6 x 50.7 x 295.4 mm
