oznav2/tectile_skin/hardware/01_Mechanic/02_Manufacturing/02_3D_Printing/STEP_3D_Models/ROBOSKIN.0234_Damiao_orin_bracket.step

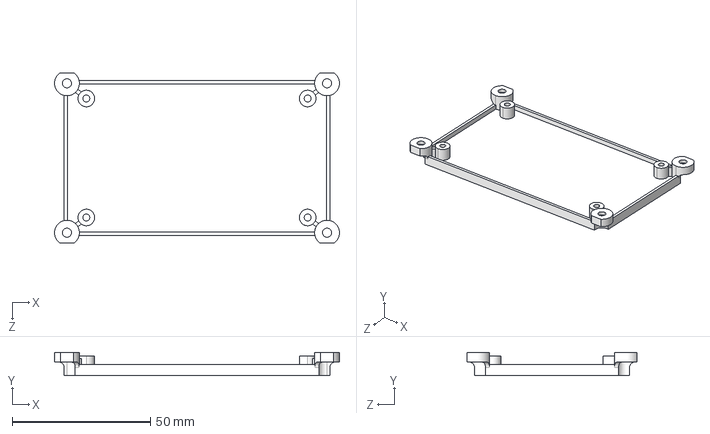
[picture p119: CAD file, 2026-10-24]
hardware/01_Mechanic/02_Manufacturing/02_3D_Printing/STEP_3D_Models/ROBOSKIN.0234_Damiao_orin_bracket.step
103.0 x 8.40 x 61.6 mm
