oznav2/tectile_skin/hardware/01_Mechanic/02_Manufacturing/02_3D_Printing/STEP_3D_Models/ROBOSKIN.0122_arm_cable_clamp_block_5.step

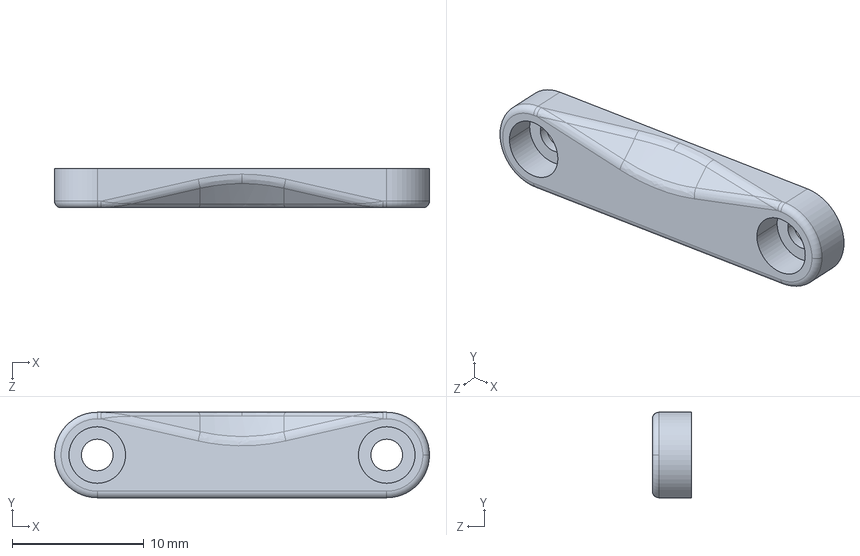
[picture p120: CAD file, 2026-10-24]
hardware/01_Mechanic/02_Manufacturing/02_3D_Printing/STEP_3D_Models/ROBOSKIN.0122_arm_cable_clamp_block_5.step
28.5 x 6.50 x 3.00 mm
