oznav2/tectile_skin/hardware/01_Mechanic/02_Manufacturing/01_CNC/Common/ROBOSKIN.0168_PITCH-YAW_motor_connection_bracket.step

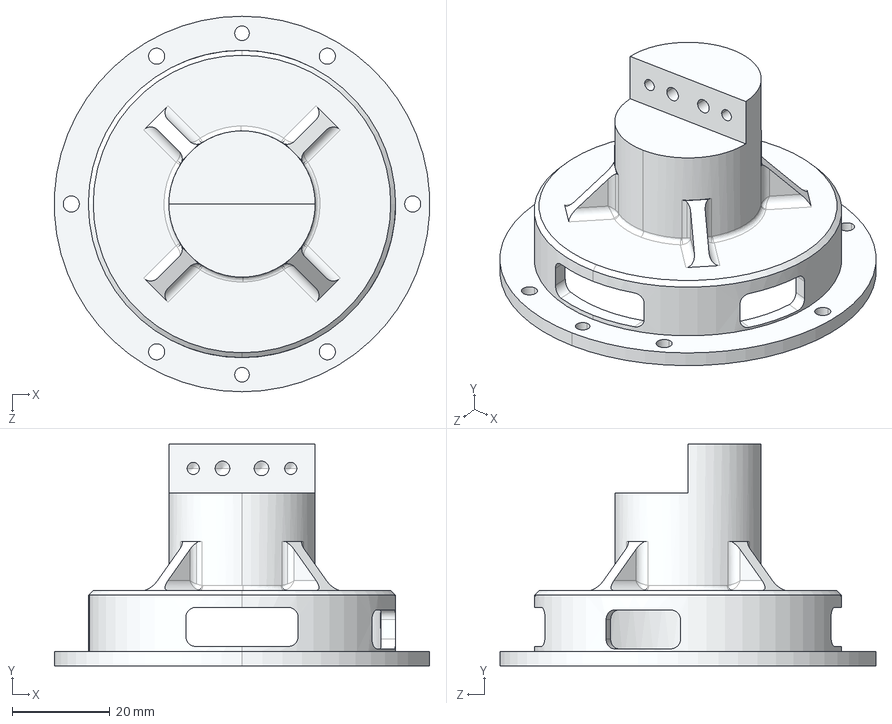
[picture p121: CAD file, 2026-10-24]
hardware/01_Mechanic/02_Manufacturing/01_CNC/Common/ROBOSKIN.0168_PITCH-YAW_motor_connection_bracket.step
76.9 x 45.5 x 77.0 mm
