oznav2/tectile_skin/hardware/01_Mechanic/02_Manufacturing/01_CNC/Common/ROBOSKIN.0242_front_shell_latch.step

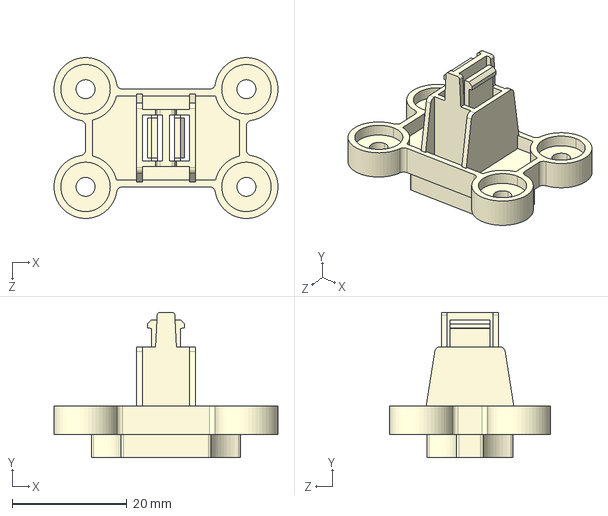
[picture p122: CAD file, 2026-10-24]
hardware/01_Mechanic/02_Manufacturing/01_CNC/Common/ROBOSKIN.0242_front_shell_latch.step
39.0 x 25.3 x 28.0 mm
