oznav2/tectile_skin/hardware/01_Mechanic/02_Manufacturing/02_3D_Printing/STEP_3D_Models/ROBOSKIN.0191_leg_cable_clip_(75_motor_).step

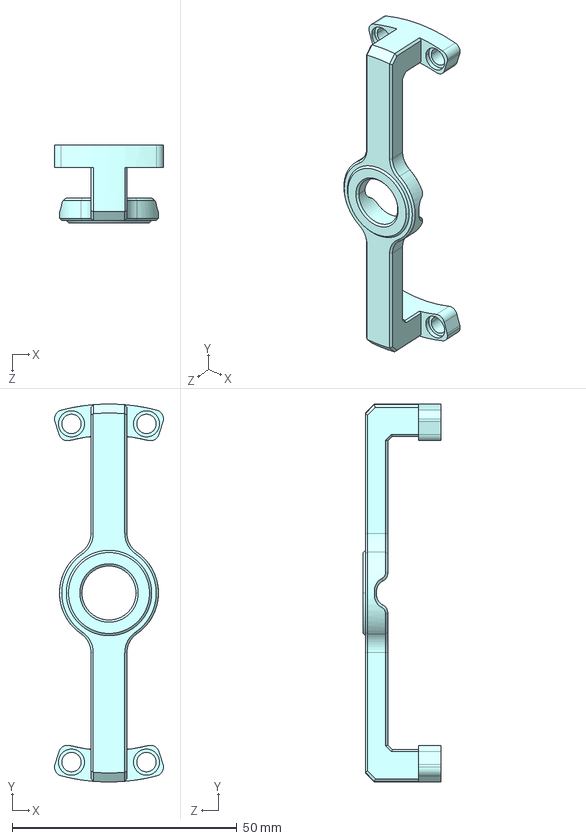
[picture p123: CAD file, 2026-10-24]
hardware/01_Mechanic/02_Manufacturing/02_3D_Printing/STEP_3D_Models/ROBOSKIN.0191_leg_cable_clip_(75_motor_).step
24.2 x 84.0 x 17.3 mm
