oznav2/tectile_skin/hardware/01_Mechanic/02_Manufacturing/01_CNC/Common/ROBOSKIN.0169_PITCH-YAW_motor_flange_bracket.step

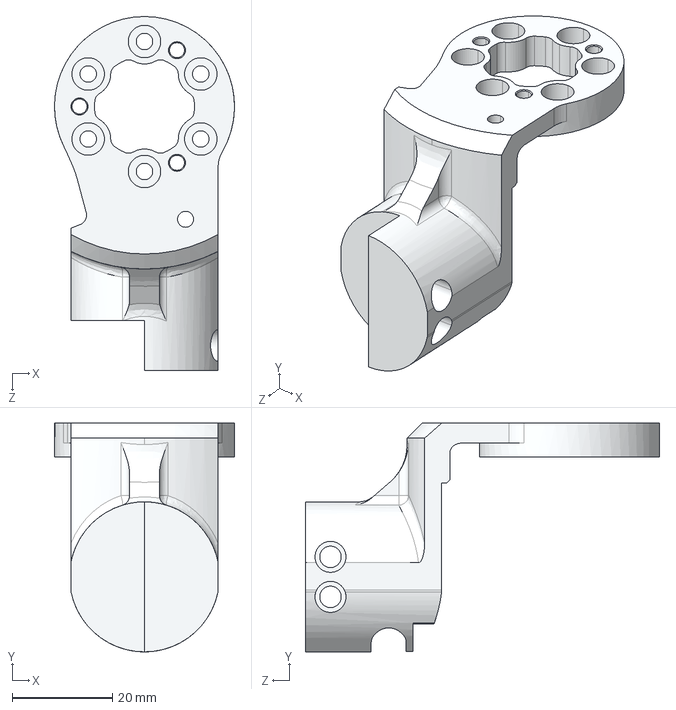
[picture p124: CAD file, 2026-10-24]
hardware/01_Mechanic/02_Manufacturing/01_CNC/Common/ROBOSKIN.0169_PITCH-YAW_motor_flange_bracket.step
36.0 x 45.8 x 70.8 mm
