oznav2/tectile_skin/hardware/01_Mechanic/02_Manufacturing/01_CNC/Common/ROBOSKIN.0127_fan_retention_cover_plate.step

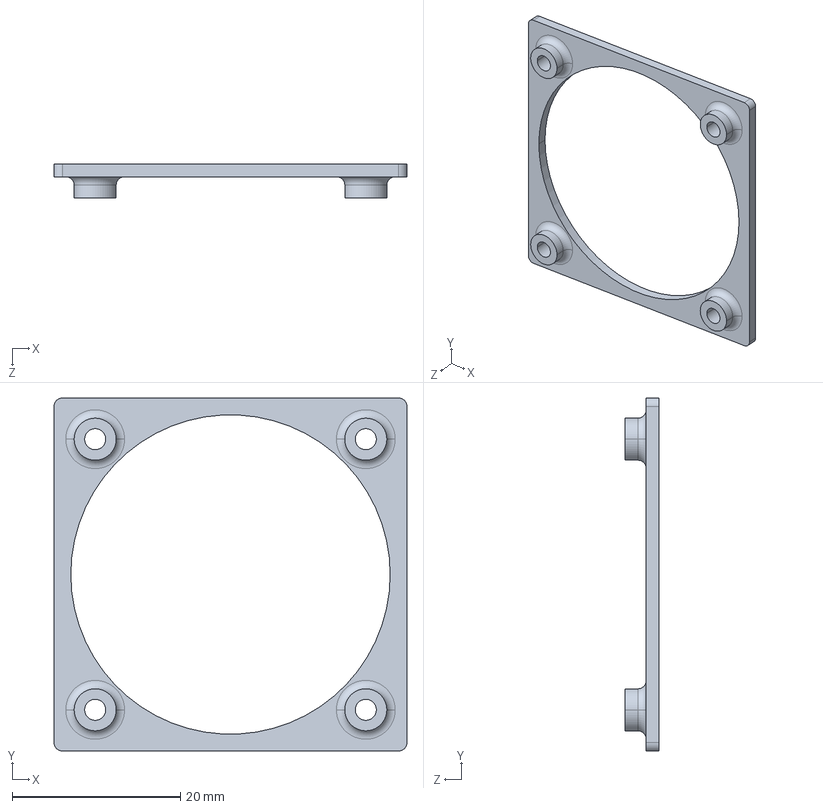
[picture p125: CAD file, 2026-10-24]
hardware/01_Mechanic/02_Manufacturing/01_CNC/Common/ROBOSKIN.0127_fan_retention_cover_plate.step
42.0 x 42.0 x 4.00 mm
