oznav2/tectile_skin/hardware/01_Mechanic/02_Manufacturing/02_3D_Printing/STEP_3D_Models/ROBOSKIN.0250_waist_cable_retention_block.step

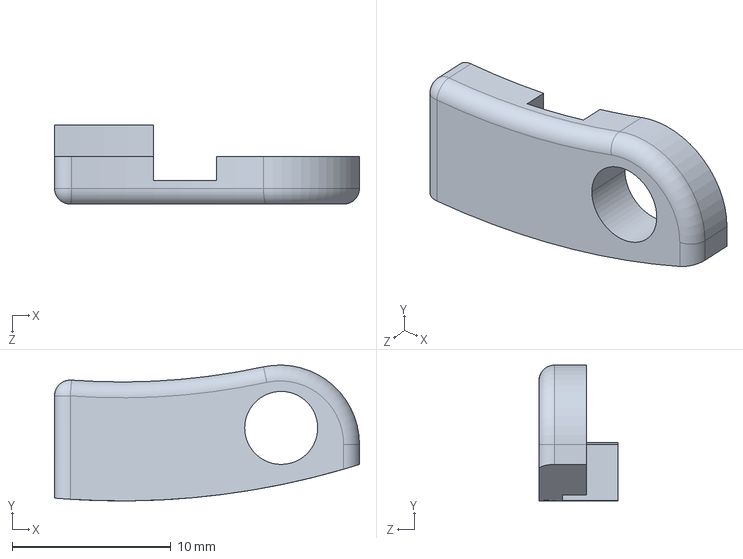
[picture p126: CAD file, 2026-10-24]
hardware/01_Mechanic/02_Manufacturing/02_3D_Printing/STEP_3D_Models/ROBOSKIN.0250_waist_cable_retention_block.step
19.2 x 8.56 x 5.00 mm
