oznav2/tectile_skin/hardware/01_Mechanic/02_Manufacturing/01_CNC/Common/ROBOSKIN.0175_upper_arm_upper_body_(01_revision_).step

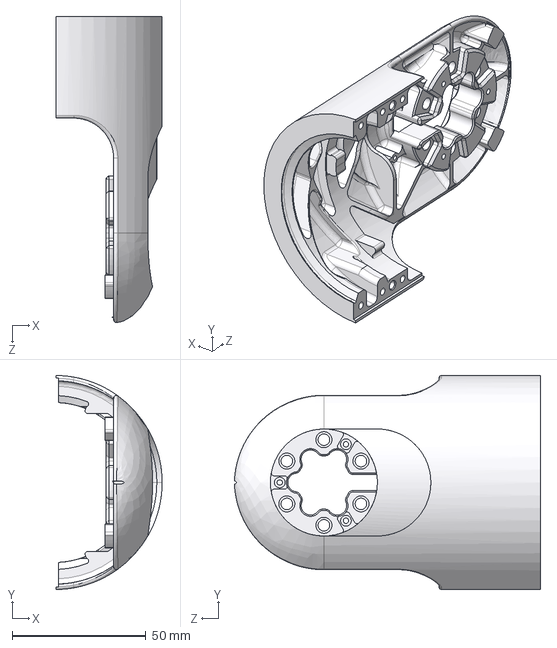
[picture p127: CAD file, 2026-10-24]
hardware/01_Mechanic/02_Manufacturing/01_CNC/Common/ROBOSKIN.0175_upper_arm_upper_body_(01_revision_).step
39.8 x 80.0 x 114.4 mm
