oznav2/tectile_skin/hardware/01_Mechanic/02_Manufacturing/02_3D_Printing/STEP_3D_Models/ROBOSKIN.0255-02_interactive_head_outer_shell_front_cover.step

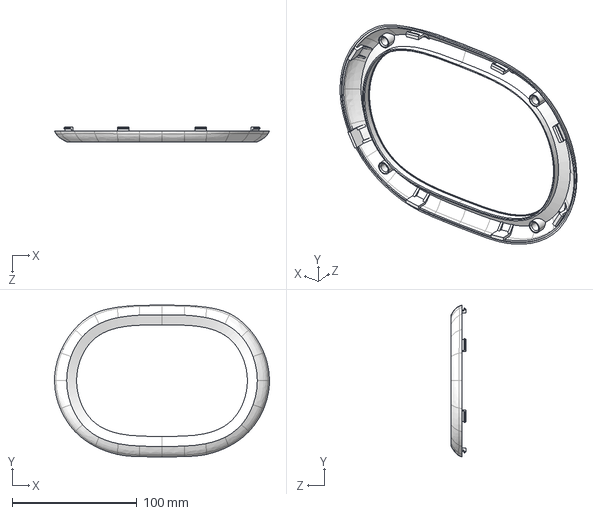
[picture p128: CAD file, 2026-10-24]
hardware/01_Mechanic/02_Manufacturing/02_3D_Printing/STEP_3D_Models/ROBOSKIN.0255-02_interactive_head_outer_shell_front_cover.step
172.5 x 121.8 x 11.8 mm
