oznav2/tectile_skin/hardware/01_Mechanic/02_Manufacturing/01_CNC/Common/ROBOSKIN.0085_hip_joint_motor_cover_plate.step

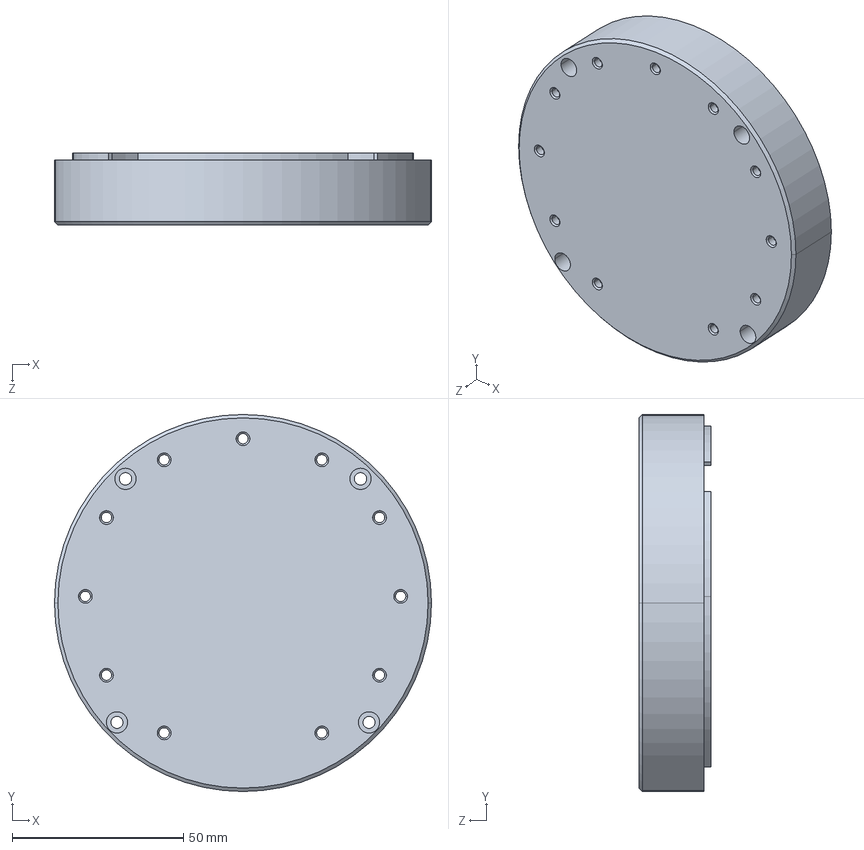
[picture p129: CAD file, 2026-10-24]
hardware/01_Mechanic/02_Manufacturing/01_CNC/Common/ROBOSKIN.0085_hip_joint_motor_cover_plate.step
110.0 x 110.0 x 21.0 mm
