oznav2/tectile_skin/hardware/01_Mechanic/02_Manufacturing/01_CNC/Common/ROBOSKIN.0278_shin_front_cover_plate.step

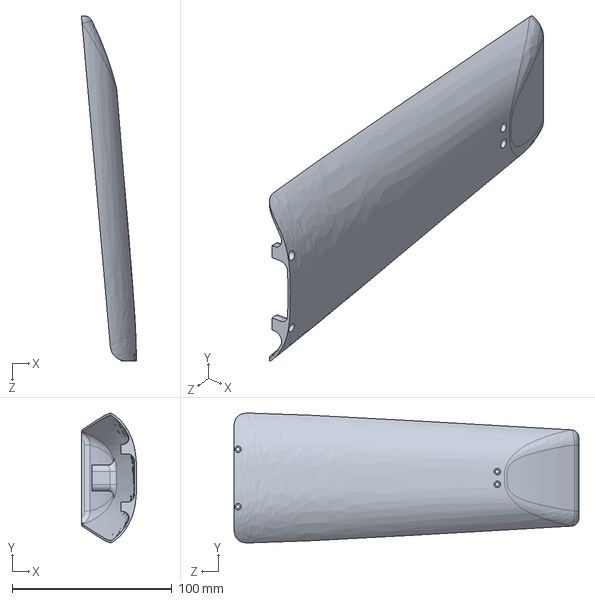
[picture p130: CAD file, 2026-10-24]
hardware/01_Mechanic/02_Manufacturing/01_CNC/Common/ROBOSKIN.0278_shin_front_cover_plate.step
34.6 x 81.4 x 216.2 mm
