oznav2/tectile_skin/hardware/01_Mechanic/02_Manufacturing/02_3D_Printing/STEP_3D_Models/ROBOSKIN.0261-02_interactive_head_upper_trim_cover.step

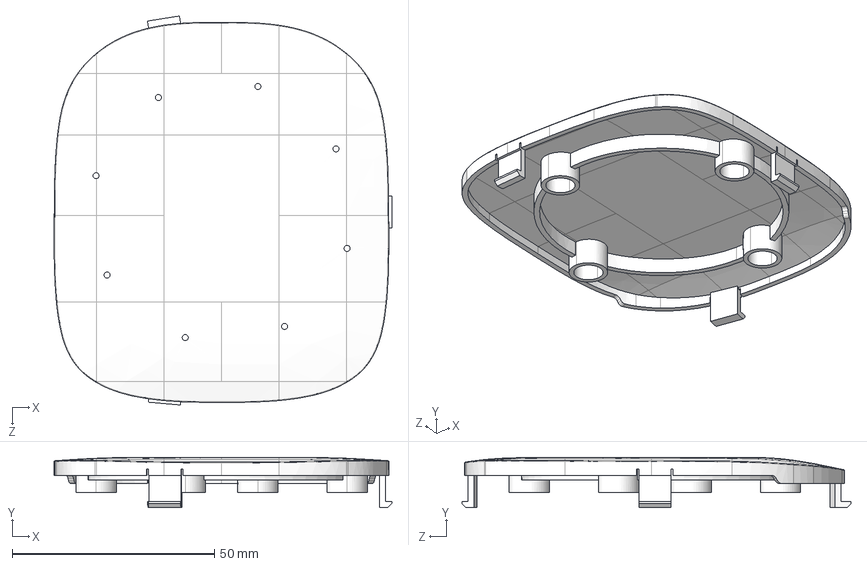
[picture p131: CAD file, 2026-10-24]
hardware/01_Mechanic/02_Manufacturing/02_3D_Printing/STEP_3D_Models/ROBOSKIN.0261-02_interactive_head_upper_trim_cover.step
83.4 x 12.5 x 96.2 mm
