oznav2/tectile_skin/hardware/01_Mechanic/02_Manufacturing/02_3D_Printing/STEP_3D_Models/ROBOSKIN.0142_thigh_cover_(_production_).step

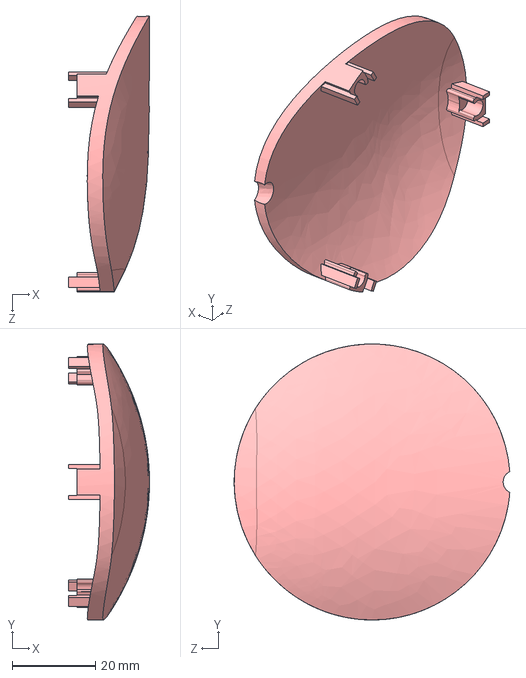
[picture p133: CAD file, 2026-10-24]
hardware/01_Mechanic/02_Manufacturing/02_3D_Printing/STEP_3D_Models/ROBOSKIN.0142_thigh_cover_(_production_).step
19.5 x 66.5 x 66.4 mm
