oznav2/tectile_skin/hardware/01_Mechanic/02_Manufacturing/01_CNC/Common/ROBOSKIN.0115_arm_adapter_flange.step

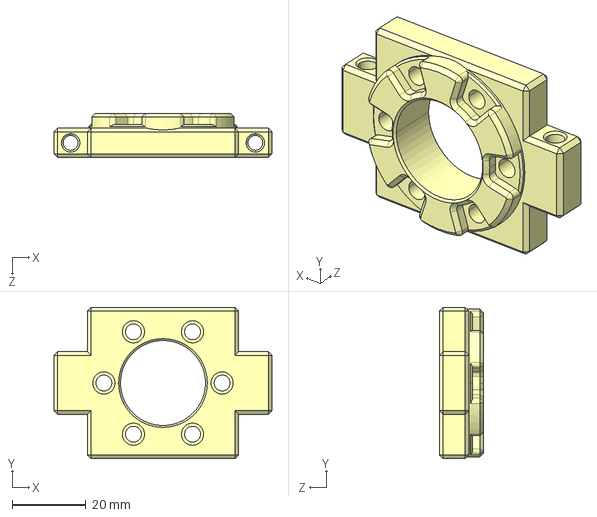
[picture p134: CAD file, 2026-10-24]
hardware/01_Mechanic/02_Manufacturing/01_CNC/Common/ROBOSKIN.0115_arm_adapter_flange.step
59.0 x 41.0 x 12.0 mm
