oznav2/tectile_skin/hardware/01_Mechanic/02_Manufacturing/01_CNC/Common/ROBOSKIN.0230-02_PC_cushion_bracket.step

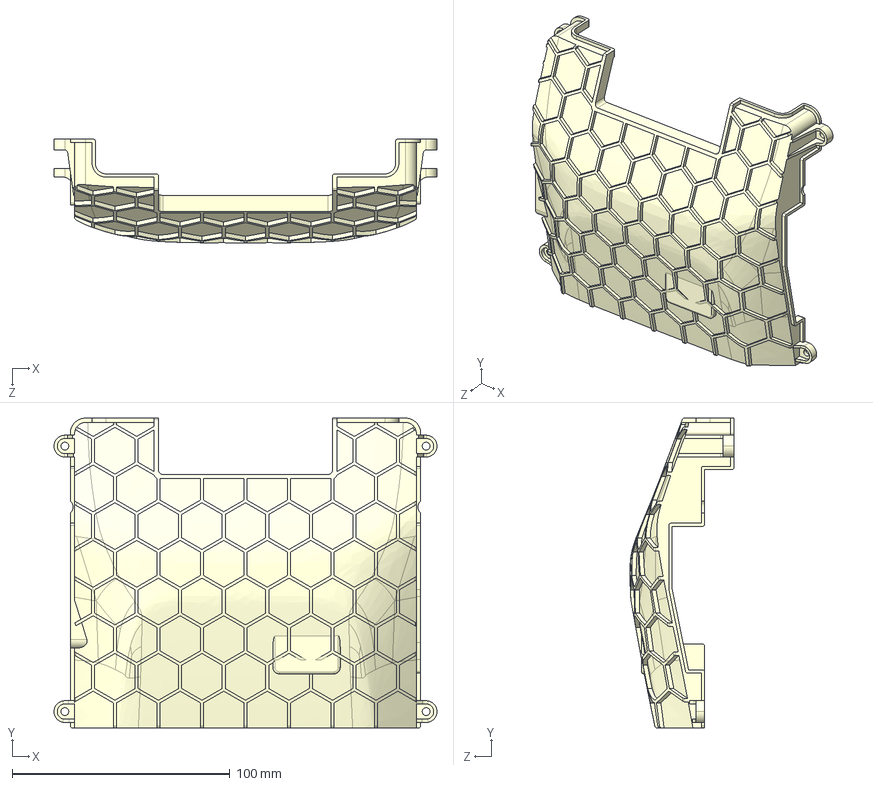
[picture p135: CAD file, 2026-10-24]
hardware/01_Mechanic/02_Manufacturing/01_CNC/Common/ROBOSKIN.0230-02_PC_cushion_bracket.step
176.0 x 142.4 x 47.8 mm
