oznav2/tectile_skin/hardware/01_Mechanic/02_Manufacturing/02_3D_Printing/STEP_3D_Models/ROBOSKIN.0241_auxiliary_battery_rear_shell.step

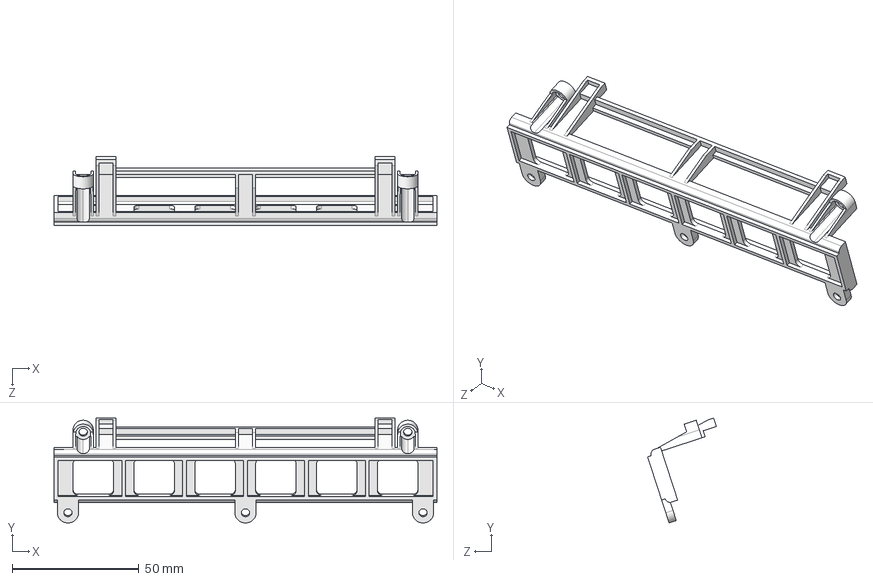
[picture p136: CAD file, 2026-10-24]
hardware/01_Mechanic/02_Manufacturing/02_3D_Printing/STEP_3D_Models/ROBOSKIN.0241_auxiliary_battery_rear_shell.step
151.0 x 41.3 x 27.1 mm
