oznav2/tectile_skin/hardware/01_Mechanic/02_Manufacturing/01_CNC/Common/ROBOSKIN.0170-02_head_PITCH_motor_flange.step

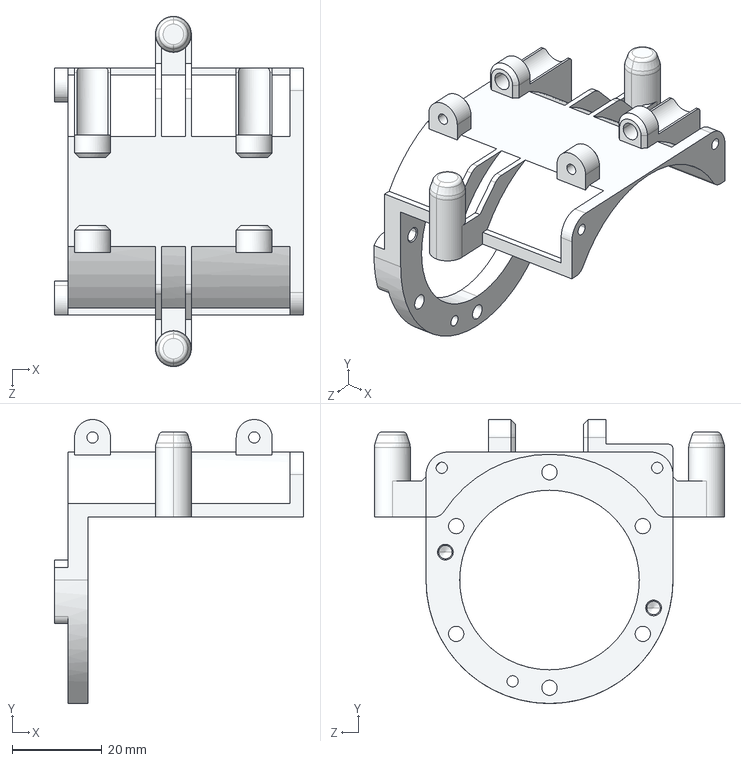
[picture p137: CAD file, 2026-10-24]
hardware/01_Mechanic/02_Manufacturing/01_CNC/Common/ROBOSKIN.0170-02_head_PITCH_motor_flange.step
55.5 x 63.2 x 78.0 mm
