oznav2/tectile_skin/hardware/01_Mechanic/02_Manufacturing/01_CNC/Common/ROBOSKIN.0160_thigh_clamp_rear.step

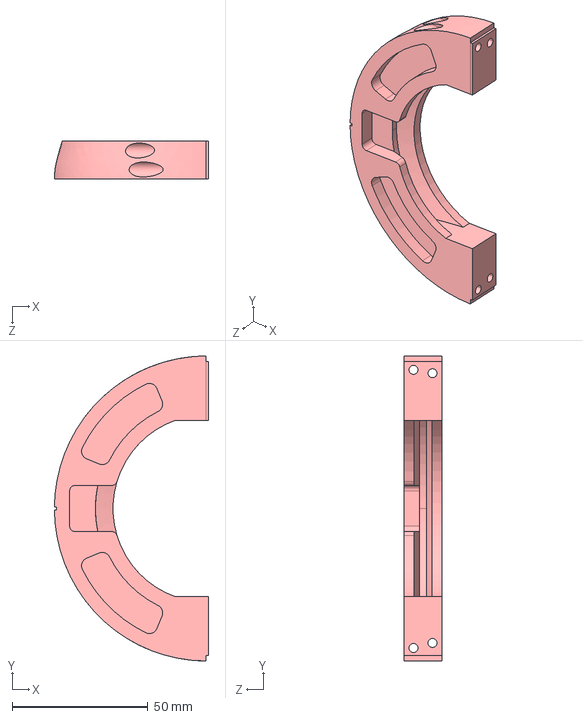
[picture p139: CAD file, 2026-10-24]
hardware/01_Mechanic/02_Manufacturing/01_CNC/Common/ROBOSKIN.0160_thigh_clamp_rear.step
56.9 x 112.4 x 14.0 mm
