oznav2/tectile_skin/hardware/01_Mechanic/02_Manufacturing/02_3D_Printing/STEP_3D_Models/ROBOSKIN.0258-02_interactive_head_upper_outer_shell_bracket.step

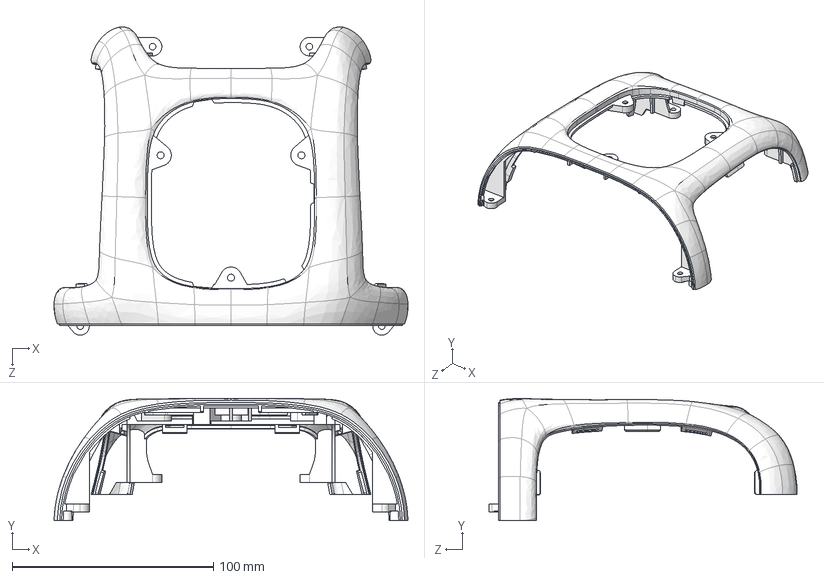
[picture p140: CAD file, 2026-10-24]
hardware/01_Mechanic/02_Manufacturing/02_3D_Printing/STEP_3D_Models/ROBOSKIN.0258-02_interactive_head_upper_outer_shell_bracket.step
176.1 x 60.7 x 153.4 mm
