oznav2/tectile_skin/hardware/01_Mechanic/02_Manufacturing/01_CNC/Common/ROBOSKIN.0181_mirrored_forearm_upper_body_left_(02_revision_).step

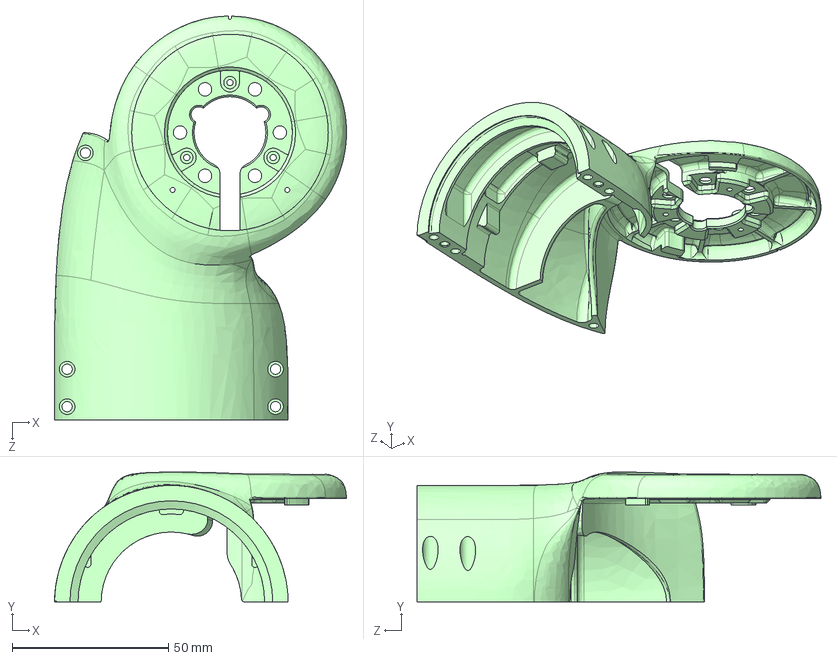
[picture p141: CAD file, 2026-10-24]
hardware/01_Mechanic/02_Manufacturing/01_CNC/Common/ROBOSKIN.0181_mirrored_forearm_upper_body_left_(02_revision_).step
93.6 x 41.6 x 129.4 mm
