oznav2/tectile_skin/hardware/01_Mechanic/02_Manufacturing/02_3D_Printing/STEP_3D_Models/ROBOSKIN.0227_kickme_version_battery_guide_bracket.step

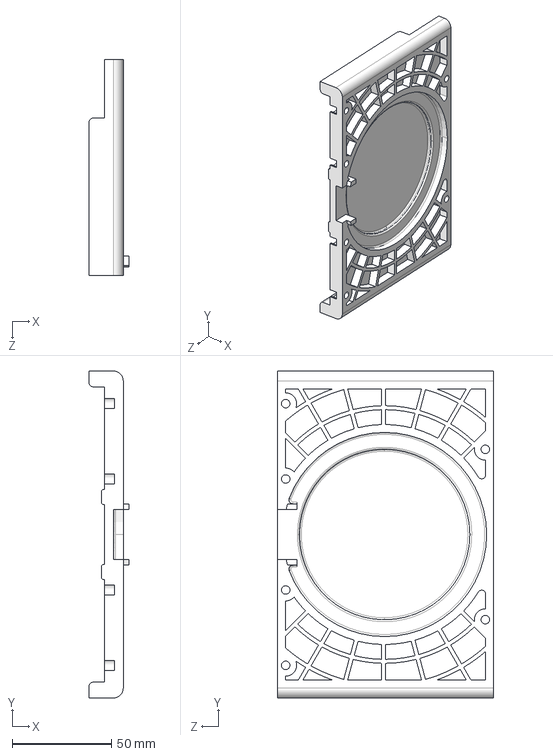
[picture p142: CAD file, 2026-10-24]
hardware/01_Mechanic/02_Manufacturing/02_3D_Printing/STEP_3D_Models/ROBOSKIN.0227_kickme_version_battery_guide_bracket.step
20.4 x 165.0 x 109.1 mm
