oznav2/tectile_skin/hardware/01_Mechanic/02_Manufacturing/01_CNC/Common/ROBOSKIN.0229-02_EPP_cushion_layer.step

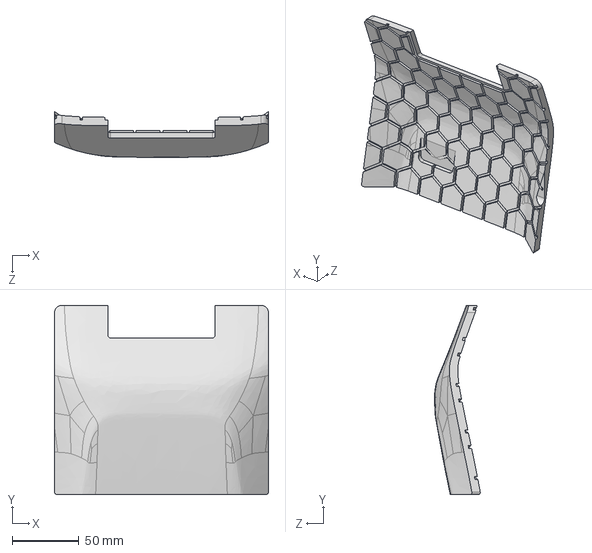
[picture p143: CAD file, 2026-10-24]
hardware/01_Mechanic/02_Manufacturing/01_CNC/Common/ROBOSKIN.0229-02_EPP_cushion_layer.step
160.0 x 141.5 x 34.1 mm
