oznav2/tectile_skin/hardware/01_Mechanic/02_Manufacturing/01_CNC/Common/ROBOSKIN.0091_Yaw_travel_stop_3.step

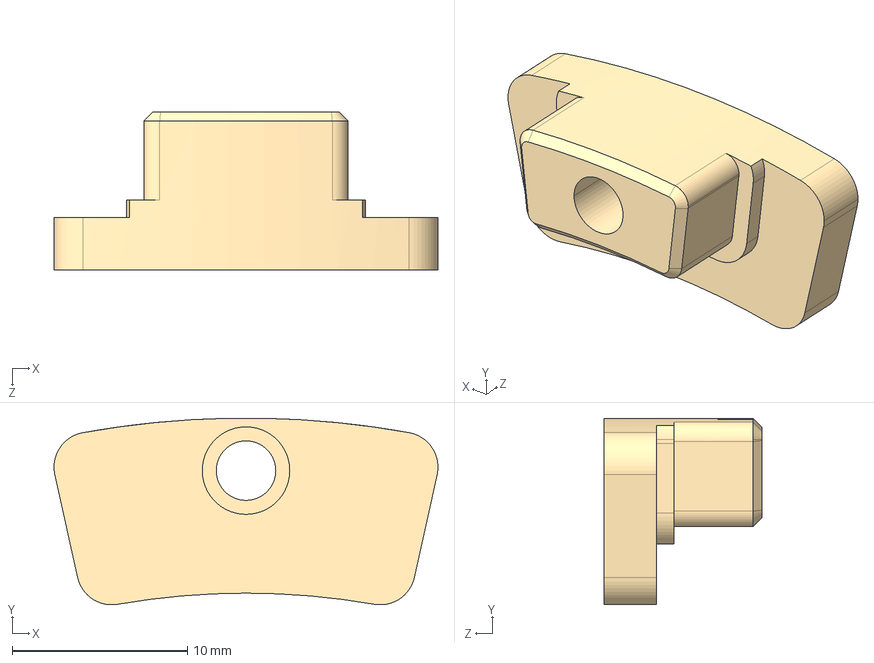
[picture p145: CAD file, 2026-10-24]
hardware/01_Mechanic/02_Manufacturing/01_CNC/Common/ROBOSKIN.0091_Yaw_travel_stop_3.step
21.9 x 10.7 x 9.00 mm
