oznav2/tectile_skin/hardware/01_Mechanic/02_Manufacturing/01_CNC/Common/ROBOSKIN.0245-03_charger_board_mounting_and_locating_bracket.step

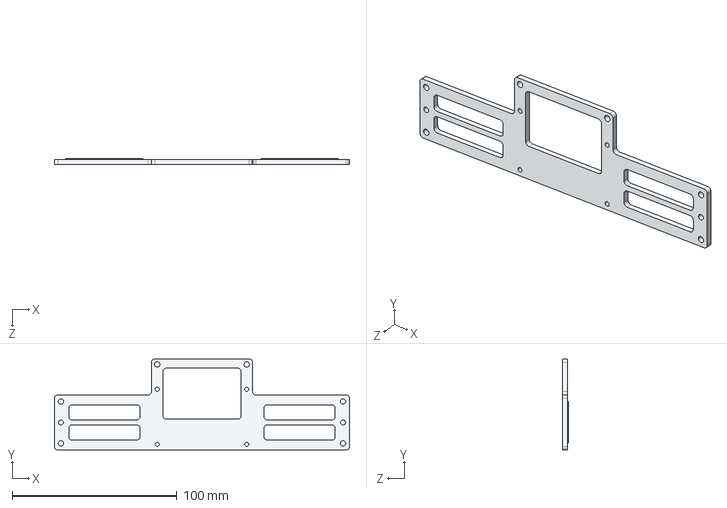
[picture p146: CAD file, 2026-10-24]
hardware/01_Mechanic/02_Manufacturing/01_CNC/Common/ROBOSKIN.0245-03_charger_board_mounting_and_locating_bracket.step
179.0 x 55.2 x 3.60 mm
