oznav2/tectile_skin/hardware/01_Mechanic/02_Manufacturing/01_CNC/Common/ROBOSKIN.0287_screen_damping_foam.step

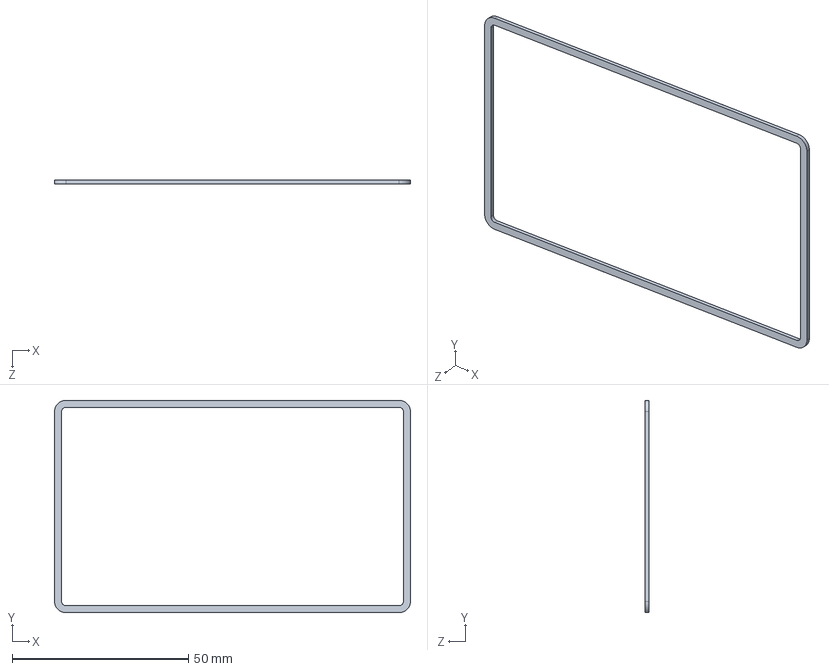
[picture p147: CAD file, 2026-10-24]
hardware/01_Mechanic/02_Manufacturing/01_CNC/Common/ROBOSKIN.0287_screen_damping_foam.step
101.0 x 60.2 x 1 mm
