oznav2/tectile_skin/hardware/01_Mechanic/02_Manufacturing/01_CNC/Common/ROBOSKIN.0233-03_kickme_version_torso_front_shell.step

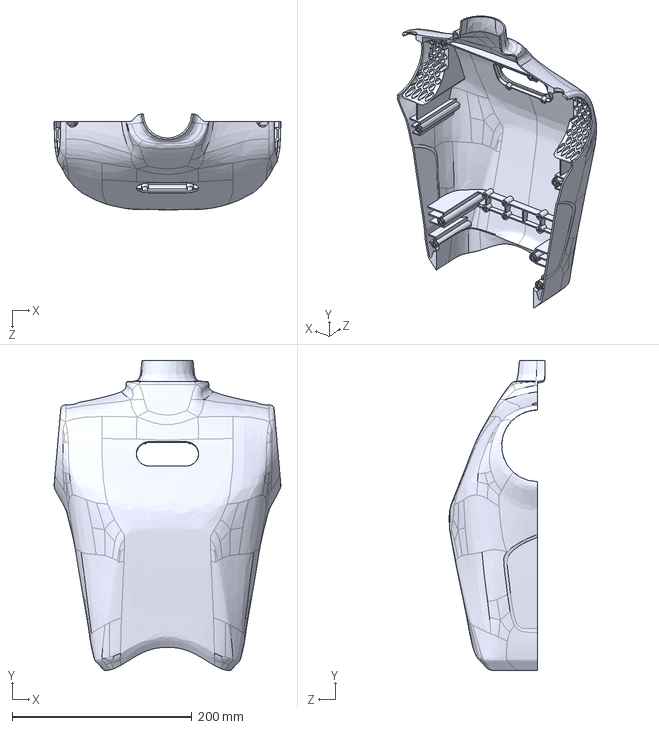
[picture p148: CAD file, 2026-10-24]
hardware/01_Mechanic/02_Manufacturing/01_CNC/Common/ROBOSKIN.0233-03_kickme_version_torso_front_shell.step
252.0 x 344.5 x 106.2 mm
