oznav2/tectile_skin/hardware/01_Mechanic/02_Manufacturing/01_CNC/Common/ROBOSKIN.0198_thigh_flange_left.step

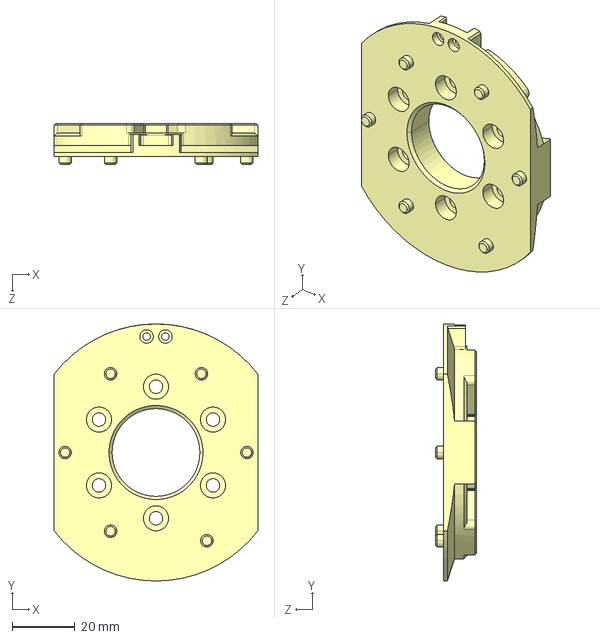
[picture p149: CAD file, 2026-10-24]
hardware/01_Mechanic/02_Manufacturing/01_CNC/Common/ROBOSKIN.0198_thigh_flange_left.step
65.0 x 82.0 x 13.0 mm
