oznav2/tectile_skin/hardware/01_Mechanic/02_Manufacturing/01_CNC/Common/ROBOSKIN.0105_knee_bearing_housing.step

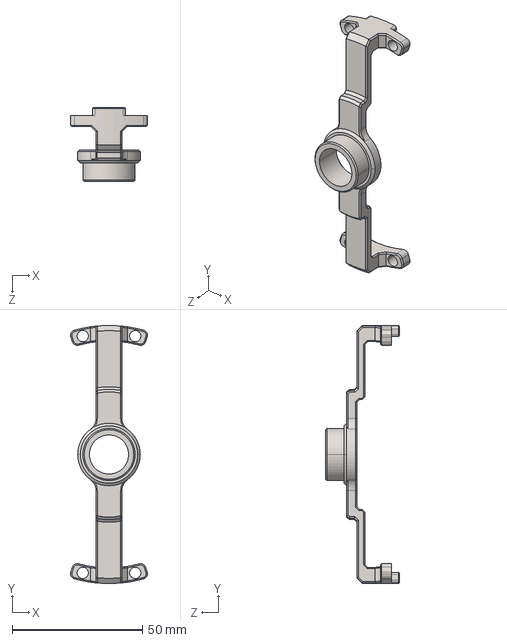
[picture p151: CAD file, 2026-10-24]
hardware/01_Mechanic/02_Manufacturing/01_CNC/Common/ROBOSKIN.0105_knee_bearing_housing.step
29.5 x 99.0 x 28.2 mm
