oznav2/tectile_skin/hardware/01_Mechanic/02_Manufacturing/01_CNC/Common/ROBOSKIN.0077_waist_Roll_limit_ring.step

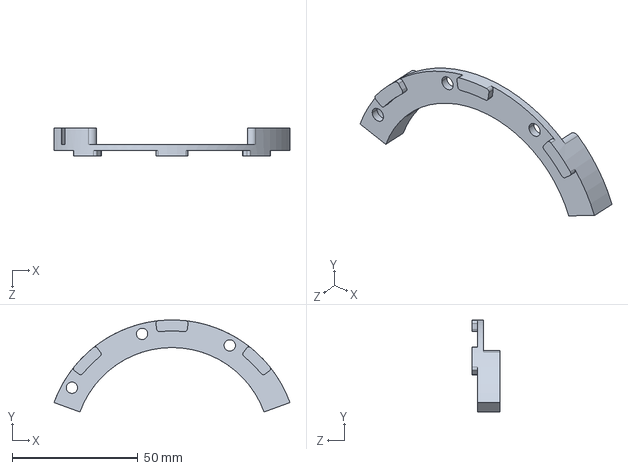
[picture p152: CAD file, 2026-10-24]
hardware/01_Mechanic/02_Manufacturing/01_CNC/Common/ROBOSKIN.0077_waist_Roll_limit_ring.step
94.0 x 36.6 x 11.2 mm
