oznav2/tectile_skin/hardware/01_Mechanic/02_Manufacturing/01_CNC/Common/ROBOSKIN.0176_upper_arm_upper_clamp_(01_revision_).step

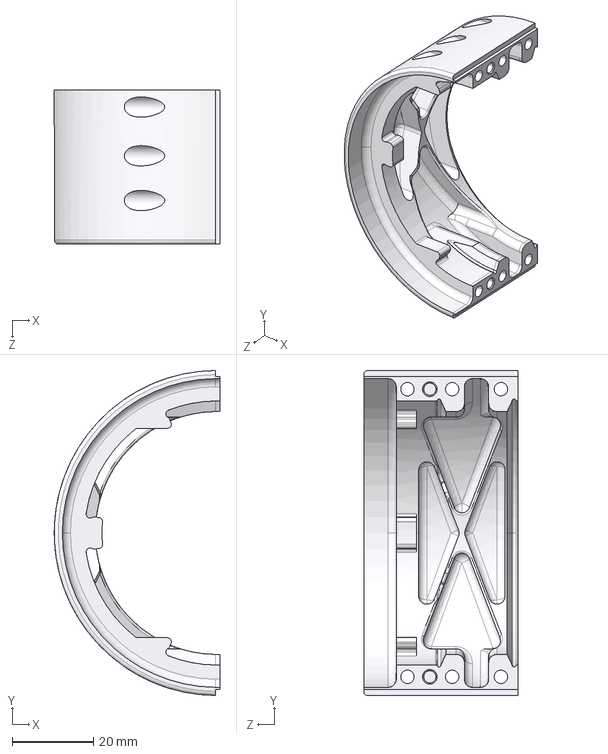
[picture p153: CAD file, 2026-10-24]
hardware/01_Mechanic/02_Manufacturing/01_CNC/Common/ROBOSKIN.0176_upper_arm_upper_clamp_(01_revision_).step
40.7 x 80.0 x 38.0 mm
