oznav2/tectile_skin/hardware/01_Mechanic/02_Manufacturing/01_CNC/Common/ROBOSKIN.0079_waist_number_1_clamp_(LS_revision_).step

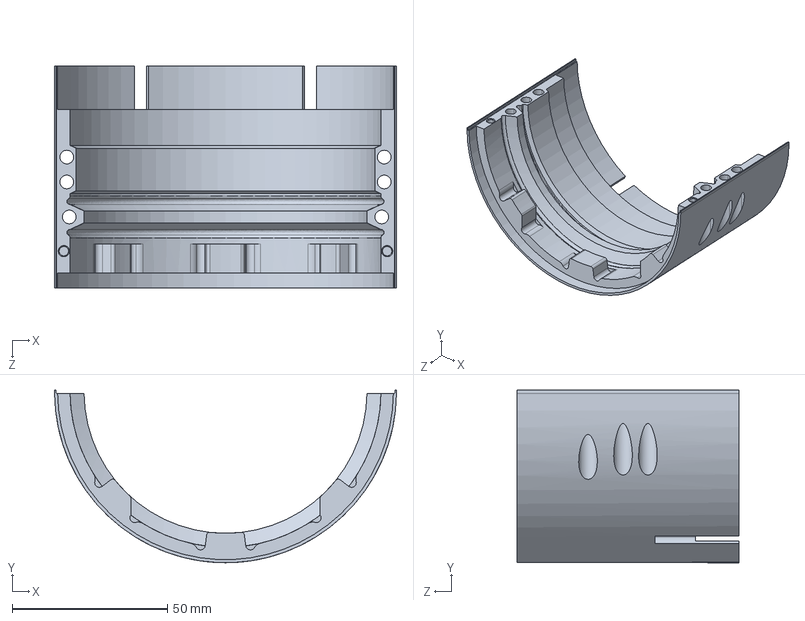
[picture p154: CAD file, 2026-10-24]
hardware/01_Mechanic/02_Manufacturing/01_CNC/Common/ROBOSKIN.0079_waist_number_1_clamp_(LS_revision_).step
110.0 x 55.5 x 71.2 mm
