oznav2/tectile_skin/hardware/01_Mechanic/02_Manufacturing/01_CNC/Common/ROBOSKIN.0177_upper_arm_lower_front_segment_(01_revision_).step

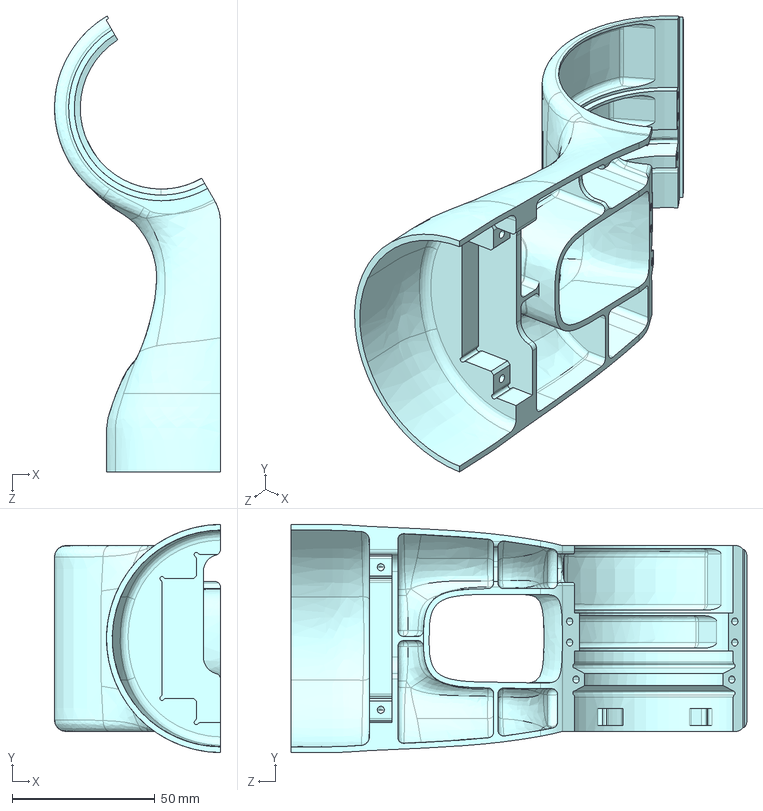
[picture p155: CAD file, 2026-10-24]
hardware/01_Mechanic/02_Manufacturing/01_CNC/Common/ROBOSKIN.0177_upper_arm_lower_front_segment_(01_revision_).step
58.2 x 80.0 x 160.0 mm
