oznav2/tectile_skin/hardware/01_Mechanic/02_Manufacturing/01_CNC/Common/ROBOSKIN.0182_mirrored_forearm_upper_body_right_(02_revision_).step

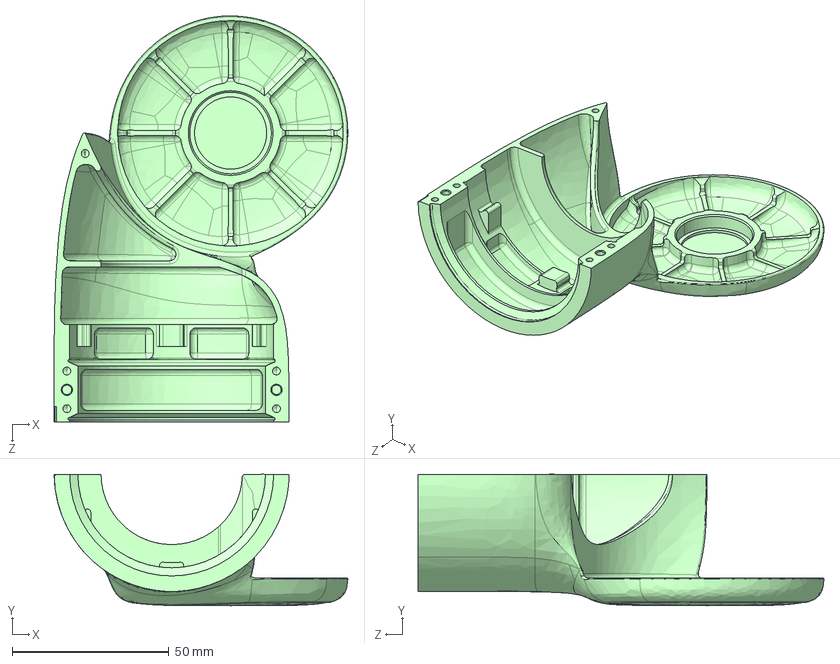
[picture p156: CAD file, 2026-10-24]
hardware/01_Mechanic/02_Manufacturing/01_CNC/Common/ROBOSKIN.0182_mirrored_forearm_upper_body_right_(02_revision_).step
93.6 x 41.9 x 129.4 mm
