oznav2/tectile_skin/(list of files, cad)

Other CAD files:
hardware/02_PCB/03_RBE-MAIN-RK3588S/03_3D_MAIN_2026-09-09.step
hardware/02_PCB/06_RBE-PWR-HEAD/03_3D_HEAD_2026-09-28.step
hardware/02_PCB/11_RBE_PWR_140WCHG/03_3D_140WCHG_2026-09-16.step
hardware/01_Mechanic/02_Manufacturing/01_CNC/5DOF/ROBOSKIN.0132_cosmetic_hand_body.step
hardware/01_Mechanic/02_Manufacturing/01_CNC/5DOF/ROBOSKIN.0133_cosmetic_hand_cover.step
hardware/01_Mechanic/02_Manufacturing/03_Rubber/STEP_3D_Models/ROBOSKIN.0135_mirrored_cosmetic_hand_body.step
hardware/01_Mechanic/02_Manufacturing/01_CNC/7DOF/ROBOSKIN.0156_wrist_body.step
hardware/01_Mechanic/02_Manufacturing/01_CNC/Common/ROBOSKIN.0199_mirrored_thigh_lower_motor_clamp_(01_revision_).step
hardware/01_Mechanic/02_Manufacturing/01_CNC/Common/ROBOSKIN.0173_75_shoulder_clamp_(01_revision_).step
hardware/01_Mechanic/02_Manufacturing/01_CNC/Common/ROBOSKIN.0232-03_kickme_version_torso_rear_shell.step
hardware/01_Mechanic/02_Manufacturing/01_CNC/Common/ROBOSKIN.0184_mirrored_upper_arm_lower_rear_segment_(01_revision_).step
hardware/01_Mechanic/02_Manufacturing/02_3D_Printing/STEP_3D_Models/ROBOSKIN.0139_mirrored_75_shoulder_cover.step
hardware/01_Mechanic/02_Manufacturing/01_CNC/Common/ROBOSKIN.0163_thigh_lower_cover_plate_left.step
hardware/01_Mechanic/02_Manufacturing/02_3D_Printing/STEP_3D_Models/ROBOSKIN.0107_forearm_upper_cover.step
hardware/01_Mechanic/02_Manufacturing/01_CNC/Common/ROBOSKIN.0150_shin_body_left.step
hardware/01_Mechanic/02_Manufacturing/01_CNC/Common/ROBOSKIN.0155_mirrored_shin_motor_spacer_block.step
hardware/01_Mechanic/02_Manufacturing/02_3D_Printing/STEP_3D_Models/ROBOSKIN.0263-02_interactive_head_side_trim_cover_-L.step
hardware/01_Mechanic/02_Manufacturing/01_CNC/Common/ROBOSKIN.0197_thigh_lower_body_left_(02_revision_).step
hardware/01_Mechanic/02_Manufacturing/01_CNC/Common/ROBOSKIN.0193_thigh_body_(_production_).step
hardware/01_Mechanic/02_Manufacturing/01_CNC/Common/ROBOSKIN.0087_hip_joint_left_clamp.step
hardware/01_Mechanic/02_Manufacturing/01_CNC/Common/ROBOSKIN.0078_waist_number_1_(LS_revision_).step
hardware/01_Mechanic/02_Manufacturing/01_CNC/Common/ROBOSKIN.0080_hip_joint_front_(LS_revision_).step
hardware/01_Mechanic/02_Manufacturing/01_CNC/Common/ROBOSKIN.0083_hip_joint_right_(LS_revision_).step
hardware/01_Mechanic/02_Manufacturing/01_CNC/Common/ROBOSKIN.0090_fan_mounting_block.step
hardware/01_Mechanic/02_Manufacturing/01_CNC/Common/ROBOSKIN.0096_Pitch_travel_stop.step
hardware/01_Mechanic/02_Manufacturing/01_CNC/Common/ROBOSKIN.0097_sole_cross_shaft.step
hardware/01_Mechanic/02_Manufacturing/01_CNC/Common/ROBOSKIN.0120_limit_ring_2.step
hardware/01_Mechanic/02_Manufacturing/01_CNC/Common/ROBOSKIN.0124_shoulder_clamp.step
hardware/01_Mechanic/02_Manufacturing/01_CNC/Common/ROBOSKIN.0138_75_limit_ring.step
hardware/01_Mechanic/02_Manufacturing/01_CNC/Common/ROBOSKIN.0143_hip_joint_rear_cover_plate.step
hardware/01_Mechanic/02_Manufacturing/01_CNC/Common/ROBOSKIN.0149_shin_body_right.step
hardware/01_Mechanic/02_Manufacturing/01_CNC/Common/ROBOSKIN.0152_mirrored_shin_ankle_spacer_block.step
hardware/01_Mechanic/02_Manufacturing/01_CNC/Common/ROBOSKIN.0161_thigh_clamp_front.step
hardware/01_Mechanic/02_Manufacturing/01_CNC/Common/ROBOSKIN.0162_thigh_lower_body_right.step
hardware/01_Mechanic/02_Manufacturing/01_CNC/Common/ROBOSKIN.0167_YAW_motor_mounting_bracket.step
hardware/01_Mechanic/02_Manufacturing/01_CNC/Common/ROBOSKIN.0171_collector_board_body_bracket.step
hardware/01_Mechanic/02_Manufacturing/01_CNC/Common/ROBOSKIN.0174_75_shoulder_body_(01_revision_).step
hardware/01_Mechanic/02_Manufacturing/01_CNC/Common/ROBOSKIN.0179_forearm_upper_body_left_(02_revision_).step
hardware/01_Mechanic/02_Manufacturing/01_CNC/Common/ROBOSKIN.0180_forearm_upper_body_right_(02_revision_).step
hardware/01_Mechanic/02_Manufacturing/01_CNC/Common/ROBOSKIN.0183_mirrored_upper_arm_lower_front_segment_(01_revision_).step
hardware/01_Mechanic/02_Manufacturing/01_CNC/Common/ROBOSKIN.0194_Yaw_travel_stop_4(03_revision_).step
hardware/01_Mechanic/02_Manufacturing/01_CNC/Common/ROBOSKIN.0195_thigh_flange_right.step
hardware/01_Mechanic/02_Manufacturing/01_CNC/Common/ROBOSKIN.0204_mirrored_thigh_lower_body_right.step
hardware/01_Mechanic/02_Manufacturing/01_CNC/Common/ROBOSKIN.0220-02_outer_topology_bracket.step
hardware/01_Mechanic/02_Manufacturing/01_CNC/Common/ROBOSKIN.0221_kickme_version_torso_frame.step
hardware/01_Mechanic/02_Manufacturing/01_CNC/Common/ROBOSKIN.0235_foot_plate.step
hardware/01_Mechanic/02_Manufacturing/01_CNC/Common/ROBOSKIN.0247_97_limit_ring.step
hardware/01_Mechanic/02_Manufacturing/01_CNC/Common/ROBOSKIN.0249_motion_head_bracket.step
hardware/01_Mechanic/02_Manufacturing/01_CNC/Common/ROBOSKIN.0254_ankle_limit_ring_2.step
hardware/01_Mechanic/02_Manufacturing/01_CNC/Common/ROBOSKIN.0271_insole.step
hardware/01_Mechanic/02_Manufacturing/01_CNC/Common/ROBOSKIN.0279_shin_rear_cover_plate.step
hardware/01_Mechanic/02_Manufacturing/01_CNC/Common/ROBOSKIN.0280_side_cable_channel.step
hardware/01_Mechanic/02_Manufacturing/01_CNC/Common/ROBOSKIN.0281_motion_control_expansion_board.step
hardware/01_Mechanic/02_Manufacturing/01_CNC/Common/ROBOSKIN.0286_interactive_head_adhesive_light_blocking_glass.step
hardware/01_Mechanic/02_Manufacturing/02_3D_Printing/STEP_3D_Models/ROBOSKIN.0251_KICKME_motion_head_screw_concealment_cover.step
