oznav2/tectile_skin/electronics/assembly_and_acceptance.md

<div dir="rtl" lang="he">

עברית · [English](assembly_and_acceptance.en.md)

# הרכבה וקבלה במעבדה של ROBOSKIN

## 1. אימות ערוץ חיישן פסיבי אחד

השתמשו במתקן נייח, בספק מבודד ומוגבל זרם, ברב־מודד דיגיטלי ובנגדי ייחוס מכוילים. חברו נגד 22 kΩ ‏1% מ־3.3 V ל־`SNS0`; חברו את חיישן הבדיקה ונגד סוף קו של 100 kΩ במקביל מ־`SNS0` לאדמה. נגד סוף הקו שייך למיקום החיישן המרוחק. הוסיפו התנגדות טורית 1 kΩ מ־`SNS0` לכניסת המרבב ו־100 pF מכניסה זו לאדמה. פעלו לפי המעגל החוזר ב־[patch_schematic.svg](../assets/electronics/patch_schematic.svg).

התחילו ב־3.3 V עם מגבלת מקור של 100 mA. עם חיישן לא עמוס בעל התנגדות גבוהה, מתח המחלק הנומינלי הוא 2.705 V. פתיחת המוליך המרוחק צריכה להעלות את המתח המדוד לכיוון 3.3 V; הקטנת התנגדות החיישן צריכה להוריד אותו. השתמשו בייחוסי נתק, 100 kΩ, ‏47 kΩ, ‏10 kΩ, ‏1 kΩ וקצר כדי לקבוע את מלוא הטווח לפני בדיקת יריעה מודפסת. קצר מתמשך ומגע ברוויה עשויים להיות בלתי ניתנים להבחנה; שמרו עמימות זו בתקפות המדווחת.

## 2. אימות בחירה אנלוגית והמרה לדיגיטל

הרכיבו TMUX1308PWR אחד על מתאם TSSOP16 מאומת. חברו את VDD בפין 16 למסילת 3.3 V האנלוגית, אדמה בפין 8, מוצא משותף בפין 3 ופיני כתובת 11/10/9. ‏EN בפין 6 פעיל בנמוך; פין 7 אינו מחובר. סדר המארז של S0–S7 הוא **13, 14, 15, 12, 1, 5, 2, 4**. זה אינו סדר פינים רציף. חברו נגדים ידועים ושונים לכניסות ואמתו כל כתובת.

מסלול ADC ב־MCU כולל נגד מוצא מרבב של 4.7 kΩ וקבל מקבילי ל־ADC של 100 pF. התחילו בהתייצבות של 250 µs לאחר שינויי כתובת, כולל זמן רכישת הדגימה הנדרש ב־ADC. תעדו מעברים בין עומס להיעדר עומס והגדילו את זמן ההתייצבות רק אם המדידות דורשות זאת. סריקת ADC, קוצב זמן, DMA ותעבורה טורית דורשים קושחת MCU; קוד Python במארח אינו תחליף שניתן לצרוב. מספר פין במחבר לוח פיתוח אינו מספר פין במארז LQFP48 של הבקר.

ארבעת מחלקי הייחוס של הבנקים משתמשים בהתנגדויות עליונה/תחתונה של 30k/10k, ‏15k/10k, ‏10k/15k ו־10k/30k. עבור מלוא טווח של 12 סיביות, 4095, הקודים הנומינליים הם 1024, ‏1638, ‏2457 ו־3071. חלונות התקפות הראשוניים הם ±80 ספירות. רמות שונות חושפות החלפת בנקים ומיעון תקוע. אמתו כל ערוץ חישה בנוסף לערוצי ייחוס אלה.

עם הטיה של 22 kΩ ומסלול סוף קו 100 kΩ ‏±20%, הקוד הנומינלי ללא עומס הוא 3357. הקצבת הזליגה הכוללת במסלול הנבחר היא **3 µA**, המשותפת למרבב, ל־MCU, להתקני ESD, לזיהום PCB ולזליגה על פני השטח. דרשו שמתח הייחוס האנלוגי יישאר לפחות 3.1 V. זיהוי נתק התחלתי הוא מעל 3900 בשלוש סריקות עוקבות; סף קצר או עומס יתר התחלתי הוא מתחת ל־30. ניקוי תקלת שירות שננעלה דורש 100 סריקות תקינות ואישור מפעיל. ספים אלה חייבים לעמוד בבדיקות הטמפרטורה והזליגה המדודות; אין הם היתר להסתיר מוליך שבור באמצעות הקלת מגבלות.

## 3. בניית הבקר והאזור המוגן

העבירו את [patch_circuit.json](patch_circuit.json) ואת [region_circuit.json](region_circuit.json) לפרויקט EDA מקורי עם טביעות רגל מוסמכות למארזים. סקרו את כל הסכמה, פינים שאינם בשימוש, פדים תרמיים, נתיב חזרת ייחוס, כיוון מחברים, מצב מעקף שעון וחיבורי מתכנת. הריצו ERC, ואז נתבו עם אדמה רציפה ונתיבי חזרה קצרים לקבלי עקיפה ולהגנה, והריצו DRC. רשימות הרשתות XML המסופקות אינן מבצעות שלבים אלה.

הזמינו תחילה שלושה בקרים מורכבים. בדקו חיבורי הלחמה ומדדו התנגדות מסילות ללא מתח. הזינו אחד ממקור מבודד של 5.00 V עם מגבלת זרם 100 mA. מדדו `5V_NODE`, `3V3` ו־`3V3_A`; חקרו זרם התנעה חריג לפני הגדלת המגבלה. אשרו מתנד 8 MHz, התנהגות איפוס, מצב המתנה ב־CAN בזמן איפוס והיעדר הזנה חוזרת מ־UART או SWD. פד 3.3 V של כלי הניפוי הוא חיבור לחישת מתח, ולא כניסת הזנה נוספת.

ה־TPS259530DSGR האזורי משתמש בנגד ILM של 2.05 kΩ, קבל dVdt של 180 nF, מחלק אפשור 100 kΩ/39 kΩ ולחצן איפוס ידני. מסילת הניטור הנפרדת של 3.3 V בצד הכניסה שומרת על משמעות חיווי התקלה לאחר שהמוצא המוגן כבה. אמתו זרם הסתערות, זרם ניתוק ואיפוס נעילה בפועל עם עומס מבוקר לפני חיבור כמה טלאים. פרטי רכיבים ופינים מופיעים ב[יומן מקורות היצרן](datasheet_traceability.md).

## 4. הרכבת צמת התקשורת

השתמשו בטבלת קצות החיבור ב־[harness_connections.csv](harness_connections.csv). הקו הראשי נושא 5 V, אדמה, CANH ו־CANL. השתמשו בזוג שזור בעל עכבה נומינלית 120 Ω ל־CAN ובמוליכי הזנה 24 AWG. אב־טיפוס נייח יכול להשתמש בכבל שזור מתאים; שימוש בתנועה דורש כבל שהוסמך במפורש לכיפוף ולפיתול. אין כאן טענה לאורך חיים של כבל נע.

צרו הסתעפויות קצרות של 26 AWG, באורך עד 50 mm, עם בתי GHR-04V-S ומגעי SSHL-002T-P0.2 המתחברים למחברי לוח BM04B-GHS-TBT. אמתו טווח חוט ובידוד והשתמשו בתהליך הלחיצה של יצרן המגע. אין לכפות מוליך 24 AWG למסוף ההסתעפות 26 AWG שנבחר. שמרו על רציפות הקו הראשי בכל הסתעפות. סמנו כיוון מחבר ובדקו חשמלית את כל הקצוות הממוספרים לפני חיבור מתח; מספרי הפינים בטבלה אינם שרטוט מבט מחבר.

הרכיבו את שני נגדי הסיום הקבועים של 120 Ω ‏1% בקצה הקרוב והרחוק. בדקו כ־60 Ω בין CANH ל־CANL ללא מתח. חברו את מתאם CAN FD המבודד, הכניסו צומת אחד לשירות עם UID בן 96 סיביות ומפת החיישנים הפיזית שלו, ואז הוסיפו צמתים אחד־אחד. בדקו זהויות כפולות, נתונים ישנים, מסכות לא תקפות והסרה והתקנה מחדש. נתקו הזנה לפני טיפול במחברים אלה.

## 5. תיעוד ראיות קבלה

| בדיקה | שיטה | יעד קבלה ראשוני |
|---|---|---|
| זהות ערוץ | ייחוסים שונים בכל כניסת חיישן או ייחוס | ללא החלפת ערוצים או מגע בו־זמני שגוי |
| אנלוג וזליגה | חמישה בקרים; הייחוסים לעיל; 10/25/40 °C; הזנה מזערית ומרבית | לפחות 100 ספירות בין התפלגויות מנוחה ונתק מדודות; הקצבת זליגה מצטברת של 3 µA; ערוצי ייחוס בחלונותיהם; חזרתיות לאחר התייצבות בתוך 20 ספירות |
| טמפרטורה | חמש טמפרטורות לערוץ מורכב בין 10 ל־60 °C, בתוספת נקודות בדיקה עצמאיות | כיול מונוטוני; מיקומים נקודתיים נפרדים מתועדים; אין להסיק טמפרטורת משטח משתי נקודות |
| הזנה בעומס | שמונה צמתים בזרם שיא מדוד; מדידה דיפרנציאלית בקצה הרחוק | כניסה אזורית 4.75–5.25 V, אדווה ≤100 mVpp ב־20 MHz, כניסת LDO מוגנת בקצה הרחוק ≥3.8 V |
| קצר בצומת | תקלה מבוקרת אחרי מגביל הזרם של צומת אחד | צמתים אחרים שומרים על הזנה ודיווח תקפים או מתאוששים בתוך יעד התכנון המוצהר של 40 ms; הצומת שכשל נשאר לא תקף |
| קצר בקו הראשי | מתקן בדיקה אזורי מוגבל זרם | האזור ננעל בכיבוי; אזורים המוגנים בנפרד נשארים תקפים |
| הפרעת הזנה | ירידת מתח מבוקרת וחזרה ל־5 V | כל כיסוי שאבד נעשה ישן או לא תקף; אין להניח התאוששות עד לבדיקות זהות ותקפות עדכניות |
| עומס אפיק מרבי | שמונה צמתים, צמה אמיתית באורך 2 m, מארח ורכזת USB אמיתיים | תזמון 1M/2M נכון; תיעוד שגיאות, אובדן, עומס אפיק ואחוזון 99.9 של גיל הנתונים מול תקציב היישום |
| הפרעה מכנית | כיפוף לוח מותקן והפעלת נתיב הכבל המיועד | אין מגע שווא הנגרם מעומס מקדים, מתיחת כבל או שפשוף; אין תפס או מוליך פגומים |
| שירות | הסרת צומת אחד שמתחו כבוי והתקנתו מחדש | הקו הראשי הקבוע ושני הסיומים נשמרים; הזהות נשארת חד־משמעית |

שמרו נתוני גלם, זהות מתקן, אצוות רכיבים, גיבובי קושחה ובנייה וכשלים. יעד תכנון או תוצאת הדמיה אינם מעבר בדיקה מדוד. האלקטרוניקה אינה מערכת הגנת מגע בעלת דירוג בטיחות.

## 6. רצף ייצור

שמרו את למינציית החישה המודפסת, המעגל הגמיש התרמי הדו־נקודתי, הבקר המורכב וכיסוי ההגנה כתת־מכלולים הניתנים לבדיקה בנפרד. אין להעביר את 28 הערוצים האנלוגיים דרך מפרק נע. ציינו במפורש בבקשת הצעת המחיר התנגדות מודפסת, סבולת סוף קו, הידבקות למינציה, היסטרזיס וזחילה בלחץ, אוורור, עובי שכבת הגנה, פחת, כלים, הזמנה מזערית ובדיקה חשמלית של 100%. היריעה המודפסת נשארת הנחת עלות תלוית תהליך ללא הצעת מחיר, עד שקיימות דוגמאות ספק ובדיקות אצווה אמיתיות.

השתמשו בקסטה ניתנת להסרה ומכוונת כדי להחליף יריעה שחוקה בלי להשליך את הבקר. לפני הרחבה מעבר לשלושה לוחות, עברו את הבדיקות החשמליות עם הלמינציה והכיסוי האמיתיים, בדקו שלוש אצוות חומר ותעדו זמני הרכבה, צריבה ובדיקה. קבלו הצעות אב־טיפוס לפי כמות מוגדרת: מודל העלות המפורסם לטלאי מניח 1,000 טלאים ואינו קובע מחיר קמעונאי לשמונה יחידות.

</div>
