oznav2/tectile_skin/hardware/02_PCB/03_RBE-MAIN-RK3588S/07_Assembly_Reference_MAIN.en.txt

Use sufficient solder to cover the entire solder pad.
Do not populate components marked NC.
