oznav2/tectile_skin/hardware/02_PCB/12_RBE_PWR_BACKHUB/05_Assembly_Requirements_BACKHUB.pdf

| | יסדנה ץבוק םש ירוחא םיקשממ חול טירפ םש : | RBE-PWR-BACKHUB
| ROBOSKIN.0297 | הסרג רפסמ : יאלמב טירפ דוק : | V2.1
| 6 | חול יבוע :(mm (חולב תובכש רפסמ : | 1.6
תובכשה רדס : | 1、TOP 2、GND02 3、SIG03 4、 POWER04 5、GND05 6、BOT
| FR-4 | | ןבל ישמה תספדה עבצ : רוחש הכסמה ויד עבצ : Shengyi חולה רמוח גתומ : חולה רמוח :

לש הבכרהו רוציי תושירד ךמסמ PCBA

| הזוחב תומכה יפל רוצייל תומכ :
| יפל GERBER רוציי תטיש :
| בהז רומיג חטש ינפ לופיט הליבטב
| ףרשב םירוח יולימ תובכש ירבעמב לופיט :
| 1OZ | תובכשב תשוחנ יבוע תינוציח תשוחנ יבוע תוימינפ : | 0.5OZ
| | תורעה הגרד 2 ןקת IPC
| | תורעה : ןכ הבכע תרקב תשרדנ םאה | טוטרשב טוריפ ואר ףרוצמה 1
| ROHS | | ךילהת ירטמרפ חודו הקידב חוד םישרדנ תוחוד : םייטנוולר םינקת
| רוצייה לנאפ תא ןנכתי קפסה לנאפב רודיס תטיש
תיוות רוזא עובק םוקימ ןיא ; יפל דימצהל ןרציה תריחב | | תורעה :

תורעה

ROBOSKIN

ROBOSKIN | RP1-derived engineering record

English file: 05_Assembly_Requirements_BACKHUB.pdf
Status: derivative identification; NOT a manufacturing release.

Existing dimensions, tolerances, material and revision remain authoritative. Source engineering graphics and original attribution are retained. Technical notes may remain in the source language.
Only searchable project part IDs on original pages are replaced. Outlined/raster labels require the original CAD authoring application.

Original drawing pages: 1
Searchable ID replacements: 0
Source: Roboparty/rp1_hardware
Hardware licence: CERN-OHL-W-2.0 where applicable; see LICENSES.md. Original path and SHA256: electronic_skin/branding/file_manifest.json

Part aliases in this document:
YCL.E000191 -> unmapped; review required

תודימה , ורמשנ טוטרשבש תולובסהו םירמוחה . הדשו דומע ןייצמ לאמשמ רפסמה . | - ROBOSKIN טוטרשה טסקטל ירבע ארקמ

p1 T0447

p1 T0277

לש הבכרהו רוציי תושירד ךמסמ PCBA

p1 T1154

טירפ םש :

p1 T1292

ירוחא םיקשממ חול

p1 T0873

יסדנה ץבוק םש

p1 T0789

יאלמב טירפ דוק :

p1 T1148

הסרג רפסמ :

p1 T1264

חולב תובכש רפסמ :

p1 T1039

חול יבוע :(mm (

p1 T0683

תובכשה רדס :

p1 T1041

חולה רמוח :

p1 T1040

חולה רמוח גתומ :

p1 T1167

Shengyi

p1 T1105

הכסמה ויד עבצ :

p1 T1577

רוחש

p1 T0466

ישמה תספדה עבצ :

p1 T1208

ןבל

p1 T0633

רוצייל תומכ :

p1 T0963

הזוחב תומכה יפל

p1 T0634

רוציי תטיש :

p1 T0962

יפל GERBER

p1 T1350

חטש ינפ לופיט

p1 T1104

הליבטב בהז רומיג

p1 T1404

תובכש ירבעמב לופיט :

ROBOSKIN

תודימה , ורמשנ טוטרשבש תולובסהו םירמוחה . הדשו דומע ןייצמ לאמשמ רפסמה . | - ROBOSKIN טוטרשה טסקטל ירבע ארקמ

p1 T1049

ףרשב םירוח יולימ

p1 T1351

תינוציח תשוחנ יבוע

p1 T0596

תוימינפ תובכשב תשוחנ יבוע :

p1 T0242

ןקת IPC

p1 T0492

הגרד 2

p1 T0740

תורעה

p1 T1015

הבכע תרקב תשרדנ םאה

p1 T1014

ןכ

p1 T1372

תורעה :

p1 T1368

ףרוצמה טוטרשב טוריפ ואר 1

p1 T1215

םייטנוולר םינקת

p1 T0981

םישרדנ תוחוד :

p1 T1056

ךילהת ירטמרפ חודו הקידב חוד

p1 T0960

לנאפב רודיס תטיש

p1 T0529

רוצייה לנאפ תא ןנכתי קפסה

p1 T1048

תיוות רוזא

p1 T0462

עובק םוקימ ןיא ; ןרציה תריחב יפל דימצהל
