oznav2/tectile_skin/hardware/02_PCB/02_RBE-COMM-433TX/05_Assembly_Requirements_433TX.xlsx

ROBOSKIN מסמך דרישות ייצור והרכבה של PCBA
שם פריט: | RBE-COMM-433TX | שם קובץ הנדסי | RBE-COMM-433TX
קוד פריט במלאי: | ROBOSKIN.0041 | מספר גרסה: | V1.0
מספר שכבות בלוח: | 2 | עובי לוח(mm): | 1.6
סדר השכבות: | 1、TOP 2、BOT
חומר הלוח: | FR-4 | מותג חומר הלוח: | Shengyi
צבע דיו המסכה: | ירוק | צבע הדפסת המשי: | לבן
כמות לייצור: | לפי הכמות בחוזה
שיטת ייצור: | לפי GERBER
טיפול פני שטח | HASL המכיל עופרת
טיפול במעברי שכבות: | מילוי חורים בשרף
עובי נחושת חיצונית | 1OZ | עובי נחושת בשכבות פנימיות: | 0.5OZ
תקן IPC | דרגה2 | הערות
האם נדרשת בקרת עכבה | כן | הערות: | אין
תקנים רלוונטיים | ROHS | דוחות נדרשים: | דוח בדיקה ודוח פרמטרי תהליך
שיטת סידור בפאנל | הספק יתכנן את פאנל הייצור
אזור תווית | אין מיקום קבוע; להצמיד לפי בחירת היצרן | הערות:
הערות
