oznav2/tectile_skin/hardware/02_PCB/03_RBE-MAIN-RK3588S/05_Assembly_Requirements_MAIN.xlsx

Sheet: מידע בסיסי
ROBOSKIN מסמך דרישות ייצור והרכבה של PCBA
שם פריט: | לוח הבקר הראשי | שם קובץ הנדסי | RBE_ בקר ראשי _CTRL_MAIN_REV.A
קוד פריט במלאי: | ROBOSKIN.0073 | מספר גרסה: | V1.6.1pro
מספר שכבות בלוח: | 6 | עובי לוח(mm): | 1.6
סדר השכבות: | 1、TOP 2、GND02 3、SIG03 4、GND04 5、GND05 6、BOT
חומר הלוח: | FR-4 | מותג חומר הלוח: | Shengyi דרגהA S1000-2M
צבע דיו המסכה: | שחור | צבע הדפסת המשי: | לבן
כמות לייצור: | לפי הכמות בחוזה | בקרת עכבה: | ±5%
שיטת ייצור: | לפי GERBER
טיפול פני שטח | גימור זהב בטבילה
טיפול במעברי שכבות: | מילוי חורים בשרף
עובי נחושת חיצונית | 1OZ | עובי נחושת בשכבות פנימיות: | 0.5OZ
תקן IPC | דרגה2 | הערות
האם נדרשת בקרת עכבה | כן | הערות: | ראו פירוט בשרטוט המצורף1
תקנים רלוונטיים | ROHS | דוחות נדרשים: | דוח בדיקה, דוח פרמטרי תהליך ובדיקת התנגדות נמוכה בארבעה מוליכים
שיטת סידור בפאנל | הספק יתכנן את פאנל הייצור
אזור תווית | אין מיקום קבוע; להצמיד לפי בחירת היצרן | הערות:
הערות

Sheet: שרטוט מצורף 1
=DISPIMG("ID_822914369CC94B629AFD1D5AB6E34DEF",1) | TOP שכבה 100Ω תיאום עכבה דיפרנציאלית
=DISPIMG("ID_C4928B74F0AA4FDAA98752FEAF11365E",1) | BOT שכבה 100Ω תיאום עכבה דיפרנציאלית
=DISPIMG("ID_98744D6D509A4B2D9A87698C6921E555",1) | BOT שכבה 90Ω תיאום עכבה דיפרנציאלית
=DISPIMG("ID_FE2F1D1276914D8E8459EDA1951F8834",1) | SIG03 שכבה 120Ω תיאום עכבה דיפרנציאלית
