oznav2/tectile_skin/hardware/02_PCB/05_RBE-PWR-HANDPlusPro/05_Assembly_Requirements_HAND.xlsx

ROBOSKIN מסמך דרישות ייצור והרכבה של PCBA
שם פריט: | לוח מתאם ליד | שם קובץ הנדסי | RBE-PWR-HANDPlusPro
קוד פריט במלאי: | ROBOSKIN.0040 | מספר גרסה: | V1.0
מספר שכבות בלוח: | 4 | עובי לוח(mm): | 1.6
סדר השכבות: | 1、TOP 2、POWER02 3、GND03 4、BOT
חומר הלוח: | FR-4 | מותג חומר הלוח: | Shengyi
צבע דיו המסכה: | ירוק | צבע הדפסת המשי: | לבן
כמות לייצור: | לפי הכמות בחוזה
שיטת ייצור: | לפי GERBER
טיפול פני שטח | HASL המכיל עופרת
טיפול במעברי שכבות: | מילוי חורים בשרף
עובי נחושת חיצונית | 1OZ | עובי נחושת בשכבות פנימיות: | 0.5OZ
תקן IPC | דרגה2 | הערות
האם נדרשת בקרת עכבה | כן | הערות: | אין
תקנים רלוונטיים | ROHS | דוחות נדרשים: | דוח בדיקה ודוח פרמטרי תהליך
שיטת סידור בפאנל | הספק יתכנן את פאנל הייצור
אזור תווית | אין מיקום קבוע; להצמיד לפי בחירת היצרן | הערות:
הערות
