oznav2/tectile_skin/hardware/02_PCB/09_RBE-PWR-MINGMEI-BC/05_Assembly_Requirements_MINGMEI-BC.xlsx

ROBOSKIN מסמך דרישות ייצור והרכבה של PCBA
שם פריט: | לוח מתאם לסוללה | שם קובץ הנדסי | RBE-PWR-MINGMEI_BC_1
קוד פריט במלאי: | ROBOSKIN.0008 | מספר גרסה: | V1.1
מספר שכבות בלוח: | 2 | עובי לוח(mm): | 1.6
סדר השכבות: | 1、TOP 2、BOT
חומר הלוח: | FR-4 | מותג חומר הלוח: | Shengyi
צבע דיו המסכה: | אדום | צבע הדפסת המשי: | לבן
כמות לייצור: | לפי הכמות בחוזה
שיטת ייצור: | לפי GERBER
טיפול פני שטח | HASL ללא עופרת
טיפול במעברי שכבות: | כיסוי במסכת הלחמה
עובי נחושת חיצונית | 1OZ | עובי נחושת בשכבות פנימיות: | 0.5OZ
תקן IPC | דרגה2 | הערות
האם נדרשת בקרת עכבה | כן | הערות: | אין
תקנים רלוונטיים | ROHS | דוחות נדרשים: | דוח בדיקה ודוח פרמטרי תהליך
שיטת סידור בפאנל | הספק יתכנן את פאנל הייצור
אזור תווית | אין מיקום קבוע; להצמיד לפי בחירת היצרן | הערות:
הערות
