oznav2/tectile_skin/hardware/02_PCB/13_Lighting_Board/05_Assembly_Requirements_LAMP.xlsx

ROBOSKIN מסמך דרישות ייצור והרכבה של PCBA
שם פריט: | לוח תאורה | שם קובץ הנדסי | לוח תאורה
קוד פריט במלאי: | ROBOSKIN.0010 | מספר גרסה: | V2.0
מספר שכבות בלוח: | 2 | עובי לוח(mm): | 1.6
סדר השכבות: | 1、TOP 2、BOT
חומר הלוח: | לוח על מצע אלומיניום | מותג חומר הלוח: | Shengyi
צבע דיו המסכה: | לבן | צבע הדפסת המשי: | שחור
כמות לייצור: | לפי הכמות בחוזה
שיטת ייצור: | לפי GERBER
טיפול פני שטח | HASL המכיל עופרת
טיפול במעברי שכבות: | מילוי חורים בשרף
עובי נחושת חיצונית | 1OZ | עובי נחושת בשכבות פנימיות: | 0.5OZ
תקן IPC | דרגה2 | הערות
האם נדרשת בקרת עכבה | כן | הערות: | אין
תקנים רלוונטיים | ROHS | דוחות נדרשים: | דוח בדיקה ודוח פרמטרי תהליך
שיטת סידור בפאנל | הספק יתכנן את פאנל הייצור
אזור תווית | אין מיקום קבוע; להצמיד לפי בחירת היצרן | הערות:
הערות
