oznav2/tectile_skin/hardware/03_Harness/Harness_Manufacturing_Specification.docx

###### ROBOSKIN — מפרט ייצור צמות חיווט

# 1. תחולת המפרט ומסמכי הייחוס

המפרט חל על הכנת החומרים, חיתוך החוטים, חיבור הקצוות, התקנת השרוולים, ההרכבה והבדיקה של צמות החיווט הפנימיות של ROBOSKIN, בראש, בבקר הראשי, בידיים, ברגליים, בלוח האחורי ובמותניים.

לחומרים ולכמויות יש לעיין בקובץ ROBOSKIN_Harness_BOM.xlsx. למידות, לסבולות, לצבעי החוטים, לסדר החיבורים ולדרישות הייצור יש לעיין בשרטוט המתאים בתיקייה Drawings/. שמות הצמות בטבלת BOM מאפשרים לפתוח את השרטוטים; כבל ARM_10 תואם לשרטוט ARM_10_Signal_Cable.pdf.

מסמך זה מגדיר תהליך ייצור כללי. יש לייצר כל צמה לפי השרטוט שלה. גובה הלחיצה, תנאי ההלחמה, ההקשיה והבדיקות החשמליות ייקבעו לפי השרטוט ולפי מפרטי החומרים, המגעים והמחברים שבהם משתמשים.

# 2. הכנת חומרים וכלי עבודה

פריט | דרישות אימות
כבל | יש לוודא לפי השרטוט את המפרט, הצבע, מספר החוטים והאורך. אין להחליף את הבחירה המוגדרת בבחירה המשמשת צמה אחרת מאותה סדרה.
מחברים ומגעים | יש לוודא את הדגם, מספר הפינים, התאמת המגעים למחבר, כיוון ההכנסה ומנגנון הנעילה. יש להבחין בין קצה A לקצה B, או בין J1 ל-J2, לפי השרטוט.
חומרי עזר | יש לוודא את מפרט שרוולי הכיווץ ואורכם, את סרט ההדבקה ואת דבק ה-UV. החומרים חייבים לעמוד בדרישות הסביבתיות שבשרטוט. כאשר נדרש נתך הלחמה נטול עופרת, אין להשתמש בנתך המכיל עופרת.
כלי ייצור | כלים לחיתוך ולקילוף חוטים, כלי לחיצה עם ראצ'ט או מכונת לחיצה המתאימים למגעים, ותחנת הלחמה מבוקרת טמפרטורה. לפי התהליך יש להכין גם אקדח אוויר חם, מתקן לשזירת חוטים ומנורת UV.
כלי בדיקה | כלי מדידה למידות ולגובה הלחיצה, מד כוח משיכה ומתקן לבדיקת רציפות בצמות. יש להכין ציוד לבדיקות בידוד ועמידה במתח בהתאם לדרישות הבדיקה הרלוונטיות.

# 3. תהליך הייצור הכללי

שלב | דרישות ביצוע
הכנת חומרים וחיתוך חוטים | יש לבחור את החומרים ולחתוך את החוטים לפי השרטוט המתאים, תוך שמירה על האורך והסבולת שנקבעו בו. יש לסמן זמנית את שני הקצוות כדי למנוע ערבוב חוטים.
קילוף ושזירת חוטים | אורך הקילוף חייב להתאים לשיטת חיבור הקצה. אין לפגוע בחוט, לקטוע תילי מוליך או להשאיר תילים מפוזרים. יש לבצע את קטעי הזוגות השזורים ואת הטיפול בסיכוך לפי השרטוט.
חיבור הקצוות | יש לבצע לחיצה והלחמה בהתאם להוראות המתאימות בסעיף 4. לפני החיבור יש לוודא את מספור הפינים, את צד המבט ואת צבעי החוטים.
הגנה והרכבה | יש להשחיל מראש את שרוולי הכיווץ. לאחר חיבור הקצוות יש ליישם דבק, להקשיח אותו, לכווץ את השרוולים ולסגור את בית המחבר לפי השרטוט. מיקום חומרי ההגנה לא יפריע לחיבור או לנעילה.
בדיקה ומסירה | יש לבדוק בכל צמה את המראה, המידות, סדר החיבורים והרציפות. לאחר השלמת הבדיקות המדגמיות והתיעוד הנדרשים, יש למיין ולמסור לפי שמות הפריטים והכמויות ב-BOM.

# 4. דרישות לחיבור הקצוות ולהגנתם

## 4.1 לחיצת מגעים

יש להשתמש בכלים ובתבניות לחיצה המתאימים לדגם המגע ולמפרט החוט. אסור להשתמש בפלייר שפיץ או בקאטר כתחליף לכלי לחיצה.

כנפי לחיצת המוליך חייבות להקיף את המוליך במלואו. יש למקם את המוליך ואת הבידוד לפי מפרט המגע. כנפי לחיצת הבידוד חייבות לאחוז במעטפת בלי לחתוך אותה. אין להשאיר תילי מוליך קטועים או מפוזרים; המגע לא יהיה מוטה, סדוק או מעוות.

בפריט הראשון יש למדוד את גובה הלחיצה ולהעריך אותו לפי מפרט המגע. יש לבדוק את משטח המגע החשמלי ואת מנגנון הנעילה ולוודא שאינם חסומים או פגומים.

יש להכניס את המגעים לבית המחבר בסדר המוגדר בשרטוט, לוודא שננעלו במקומם ולבצע בדיקת משיכה לאחור. אין לאפשר יציאת מגע, מיקום שגוי או תנועה חריגה.

## 4.2 הלחמת מחברים מסדרת XT

לפני ההלחמה יש לוודא את קוטביות התקע ואת סדר החיבורים ולהשחיל את שרוולי הכיווץ הנדרשים. יש לצפות מראש בבדיל את כוסיות ההלחמה ואת קצות החוטים לפי התהליך, ולבקר את הטמפרטורה ואת משך ההלחמה כדי למנוע פגיעה בבית המחבר או בבידוד החוט.

נקודות ההלחמה חייבות להיות מלאות, ללא הלחמה לקויה, גשרי בדיל, בליטות חדות או תילי מוליך מפוזרים. אין למשוך את החוטים לפני שההלחמה התקררה. יש ליישם דבק UV שקוף בנקודות ההלחמה לפי השרטוט ולהקשיחו לפי דרישות חומר הדבק.

יש לוודא את קוטביות חוטי ההזנה ואת התאמת הפינים לפי השרטוט של כל צמה. במהלך הייצור והבדיקה הצמה חייבת להיות מנותקת מהסוללה ומהציוד. לפני חיבור מתח יש לאמת את הקוטביות ואת הבידוד.

## 4.3 דוגמת חיווט Body01

הטבלה הבאה מתייחסת רק לטבלת החיבורים בשרטוט ROBOSKIN-BODY01-0_Cable.pdf. צד המבט הוא צד ההלחמה המוצג בשרטוט. בצמות אחרות יש להשתמש בהגדרות הפינים והצבעים שבשרטוטים שלהן.

ההתאמה | 1 | 2 | + | −
כוסית הלחמה בקצה A | 1 | 2 | + | −
צבע החוט | לבן | שחור | חום | כסוף
כוסית הלחמה בקצה B | 1 | 2 | + | −

בצמת Body01 יש לשזור יחד את החוט השחור והחוט הלבן לפי השרטוט, ולסדר את החוט החום והחוט הכסוף לפי השרטוט. יש להשתמש בשרוולי כיווץ שחורים דקי דופן במיוחד בקטרים Ø6.0 ו-Ø7.0; האורך והמיקום יהיו לפי שרטוט זה.

## 4.4 שרוולים והרכבה

יש להתקין את שרוולי הכיווץ, סרט ההדבקה והסימונים לפי השרטוט. יש לבקר את טמפרטורת הכיווץ לפי דרישות השרוול ולחמם באופן אחיד עד להצמדה, ללא בועות, חריכה או נזק למעטפת.

חומרי ההגנה חייבים לכסות במלואם את האזורים שנקבעו. בית המחבר חייב להיסגר במקומו, ומנגנון הנעילה חייב לפעול כראוי. בצמות Ethernet יש לשמור על מבנה הזוגות השזורים ועל הטיפול בסיכוך שנקבעו בשרטוט.

# 5. בדיקה ומסירה

קריטריוני הבדיקה הם השרטוט של הצמה המתאימה, טבלת החיבורים ומפרטי הרכיבים שבהם משתמשים. יש ליישם בנפרד את דרישות המתח, ההתנגדות, משך הבדיקה, סבולת האורך וכוח המשיכה שנקבעו בשרטוט.

פריט לבדיקה | היקף הבדיקה | דרישות קבלה
מראה ומידות | כל צמה בנפרד | החוטים, המחברים, המגעים ושרוולי הכיווץ חייבים להתאים לשרטוט. המידות ומיקומי הקטעים חייבים לעמוד בסבולות השרטוט. בית המחבר ומנגנון הנעילה חייבים להיות תקינים, והבידוד חייב להיות ללא שריטות, סימני חום או קיפולים חדים בלתי הפיכים.
לחיצות ונקודות הלחמה | כל צמה בנפרד | הלחיצות חייבות להיות שלמות והמגעים נעולים באופן אמין. נקודות ההלחמה יהיו ללא הלחמה לקויה, גשרי בדיל או תילי מוליך מפוזרים. דבק ה-UV וחומרי ההגנה הנדרשים בשרטוט חייבים להיות במקומם.
רציפות וסדר החיבורים | כל צמה בנפרד | יש לבדוק נקודה אחר נקודה את המגעים המתאימים לפי טבלת החיבורים ולוודא שאין נתק, קצר או חיבור במיקום שגוי. יש להעריך את התנגדות הרציפות לפי תנאי הבדיקה שבשרטוט.
צמות Ethernet | כל צמה בנפרד | יש לוודא בנפרד את סדר החיבורים והרציפות של כל אחד מ-8 הגידים ולבדוק שאין קצרים בין הגידים. השזירה, כיוון המגעים והטיפול בסיכוך יהיו לפי השרטוט.
בידוד ועמידה במתח | לפי השרטוט ודרישות הבדיקה | יש לבדוק את הצמה בנפרד לפי תנאי הבדיקה שנקבעו. התנגדות הבידוד, זרם הזליגה והתוצאה חייבים לעמוד בדרישות, ללא פריצת בידוד או קשת חשמלית. יש לבדוק כל צמת הזנת מתח בנפרד.
כוח משיכה של חיבור בלחיצה | פריט ראשון ובדיקות מדגמיות | יש לבדוק את כוח המשיכה לפי המפרטים המתאימים למגע ולחוט. בכל אצווה יש לבצע בדיקת משיכה הרסנית בפריט הראשון, ולאחר מכן, מכל 50 פריטים, יש לבדוק פריט 1. אסור להרכיב ברובוט פריט ששימש לבדיקה הרסנית.
עמידות נקודת ההלחמה במשיכה | בדיקה מדגמית | יש לבדוק לפי הדרישות המתאימות. נקודת ההלחמה לא תיסדק, והחוט והגנת הדבק לא ייכשלו.
עליית טמפרטורה וכושר נשיאת זרם | בדגם חדש או בעת החלפת חומר | יש לבצע אימות דגם בהתאם לחוטים, למחברים ולדרישות המערכת בפועל. יש לשמור את תנאי הבדיקה ואת תוצאותיה.

## 5.1 הגדרת אצווה וטיפול בחריגות

לצורך בדיקות משיכה, אצווה מורכבת מצמות מאותו דגם שיוצרו בידי אותו עובד ובאותו סוג חוט. אם הפריט הראשון או פריט מדגמי נכשל, יש לבודד את האצווה הרלוונטית, לכוון את הכלים או לתקן את התהליך ולבדוק מחדש. יש למסור רק לאחר שהבדיקה עברה.

## 5.2 רישומי בדיקה ומסירה

לכל אצווה יש לשמור את מדידת גובה הלחיצה בפריט הראשון, תוצאות בדיקת המשיכה ההרסנית, תוצאות הרציפות לכל צמה ואת רישומי בדיקות הבידוד והעמידה במתח הנדרשות. הרישומים חייבים לאפשר זיהוי של שם הצמה ושל האצווה.

לאחר מעבר הבדיקה, יש למיין לפי שמות הצמות שבקובץ ROBOSKIN_Harness_BOM.xlsx ולוודא את הכמויות. אם נדרש סימון, יש לבצעו לפי השרטוט. לפני מסירת צמות להזנה מסוללה יש לוודא שוב את הקוטביות.

מפרט ייצור צמות חיווט · עמוד

ROBOSKIN · ROBOSKIN
