oznav2/tectile_skin/hardware/01_Mechanic/02_Manufacturing/01_CNC/5DOF/ROBOSKIN.0132_cosmetic_hand_body.pdf

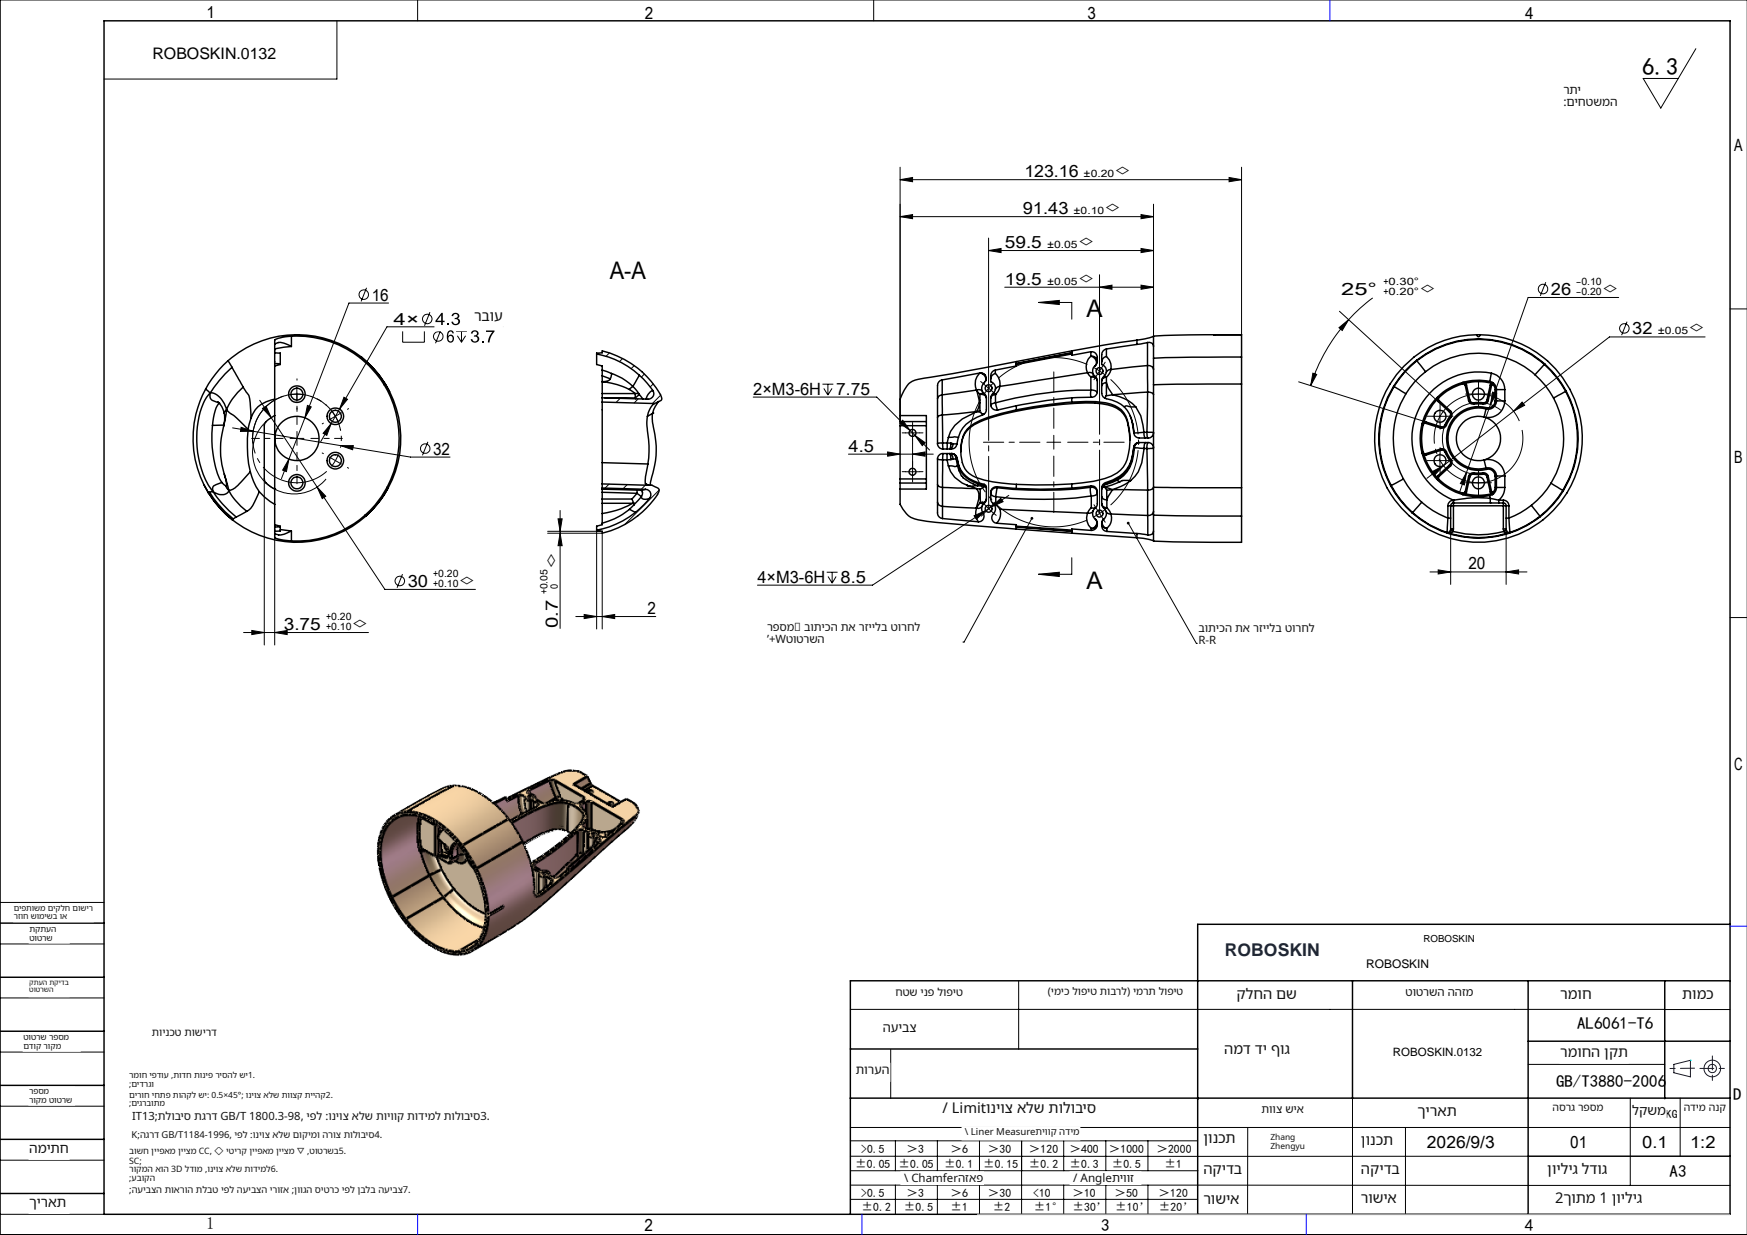
[picture p157: page 1]
תוינכט תושירד; 5. טוטרשב , ▽ יטירק ןייפאמ ןייצמ ◇ ,CC בושח ןייפאמ ןייצמ; 4. וניוצ אלש םוקימו הרוצ תולוביס : יפל 1184-1996,T/GB הגרד ;K; 3. וניוצ אלש תויווק תודימל תולוביס : יפל 1800.3-98, T/GB תלוביס תגרד ;13IT; םיחטשמה :; טוטרש רפסמ םדוק רוקמ; רוקמ טוטרש; קתעה תקידב; תווצ שיא; הסרג רפסמ; Zhengyu \ Liner Measure; הדימ תיווק; ןויליג לדוג; רמוחה ןקת

רתי 7. ןווגה סיטרכ יפל ןבלב העיבצ ; העיבצה תוארוה תלבט יפל העיבצה ירוזא ;

רפסמ בותיכה תא רזיילב טורחל
טוטרשה W+ ’

בותיכה תא רזיילב טורחל

םיפתושמ םיקלח םושיר
רזוח שומישב וא
תקתעה
טוטרש

תומכ ימרת לופיט ( ימיכ לופיט תוברל ) חטש ינפ לופיט

רמוח טוטרשה ההזמ קלחה םש

המד די ףוג

1. תודח תוניפ ריסהל שי , רמוח יפדוע
םידרגו ;
2. וניוצ אלש תווצק תייהק ;45°×0.5 : םירוח יחתפ תוהקל שי
םיגרבותמ ;

וניוצ אלש תולוביס Limit /

הדימ הנק לקשמ

ןונכת
הקידב
ןויליג 1 ךותמ 2 רושיא

6. וניוצ אלש תודימל , לדומ D3 רוקמה אוה
עבוקה ;

תיווז Angle / הזאפ Chamfer \

>0.5 | ＞3 | ＞6 | ＞30 | <10 | ＞10 | ＞50 | ＞120
±0.2 | ±0.5 | ±1 | ±2 | ±1° | ±30’ | ±10’ ±20’

ROBOSKIN | RP1-derived engineering record

English file: ROBOSKIN.0132_cosmetic_hand_body.pdf
Status: derivative identification; NOT a manufacturing release.

Existing dimensions, tolerances, material and revision remain authoritative. Source engineering graphics and original attribution are retained. Technical notes may remain in the source language.
Only searchable project part IDs on original pages are replaced. Outlined/raster labels require the original CAD authoring application.

Original drawing pages: 1
Searchable ID replacements: 2
Source: Roboparty/rp1_hardware
Hardware licence: CERN-OHL-W-2.0 where applicable; see LICENSES.md. Original path and SHA256: electronic_skin/branding/file_manifest.json

Part aliases in this document:
YCL.M000372 -> ROBOSKIN.0132

תודימה , ורמשנ טוטרשבש תולובסהו םירמוחה . הדשו דומע ןייצמ לאמשמ רפסמה . | - ROBOSKIN טוטרשה טסקטל ירבע ארקמ

p1 T1126

בותיכה תא רזיילב טורחל R-R

p1 T1122

טוטרשה רפסמ בותיכה תא רזיילב טורחל W+ ’

p1 T0111

4.3 רבוע

p1 T0954

תוינכט תושירד

p1 T0026

1. תודח תוניפ ריסהל שי , םידרגו רמוח יפדוע ;

p1 T0069

2. וניוצ אלש תווצק תייהק ;45°×0.5 : םיגרבותמ םירוח יחתפ תוהקל שי ;

p1 T0103

3. וניוצ אלש תויווק תודימל תולוביס : יפל 1800.3-98, T/GB תלוביס תגרד ;13IT

p1 T0122

4. וניוצ אלש םוקימו הרוצ תולוביס : יפל 1184-1996,T/GB הגרד ;K

p1 T0133

5. טוטרשב , ▽ יטירק ןייפאמ ןייצמ ◇ ,CC בושח ןייפאמ ןייצמ ;SC

p1 T0143

6. וניוצ אלש תודימל , לדומ D3 עבוקה רוקמה אוה ;

p1 T0153

7. ןווגה סיטרכ יפל ןבלב העיבצ ; העיבצה תוארוה תלבט יפל העיבצה ירוזא ;

p1 T0573

םיחטשמה רתי :

p1 T1009

םדוק רוקמ טוטרש רפסמ

p1 T1239

המיתח

p1 T1006

ךיראת

p1 T0893

רוקמ טוטרש רפסמ

p1 T0546

רזוח שומישב וא םיפתושמ םיקלח םושיר

p1 T0980

טוטרשה קתעה תקידב

p1 T0979

טוטרש תקתעה

p1 T1426

המד די ףוג

p1 T0990

תומכ

p1 T1350

חטש ינפ לופיט

p1 T1137

ימרת לופיט ( ימיכ לופיט תוברל )

p1 T0740

תורעה

תודימה , ורמשנ טוטרשבש תולובסהו םירמוחה . הדשו דומע ןייצמ לאמשמ רפסמה . | - ROBOSKIN טוטרשה טסקטל ירבע ארקמ

p1 T0707

העיבצ

p1 T1025

רמוח

p1 T0719

טוטרשה ההזמ

p1 T0447

p1 T1520

קלחה םש

p1 T1093

הדימ הנק

p1 T1437

לקשמ

p1 T1365

ןונכת

p1 T0513

תווצ שיא

p1 T0796

הקידב

p1 T0951

רושיא

p1 T0568

ןויליג 1 ךותמ 2

p1 T1147

הסרג רפסמ

p1 T0900

### Zhang Zhengyu

p1 T1256

### תיווק הדימ Measure Liner \

p1 T0543

### הזאפ Chamfer \

p1 T1363

### תיווז Angle /

p1 T1020

וניוצ אלש תולוביס Limit /

p1 T0720

ןויליג לדוג

p1 T1007

ךיראת

p1 T1026

רמוחה ןקת

ROBOSKIN
