oznav2/tectile_skin/hardware/01_Mechanic/02_Manufacturing/01_CNC/7DOF/ROBOSKIN.0156_wrist_body.pdf

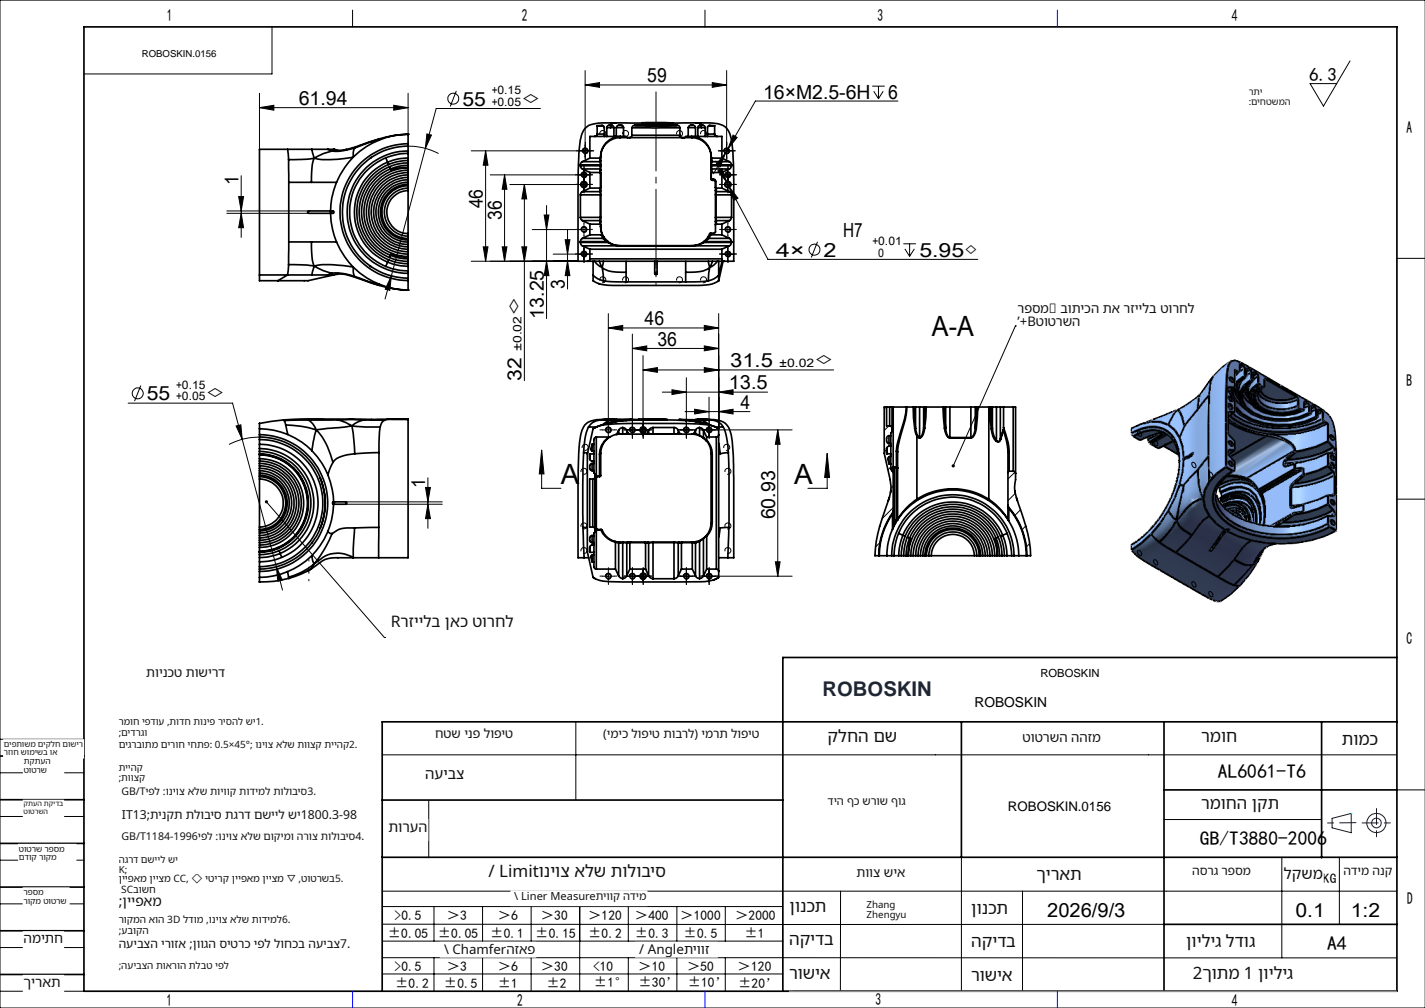
[picture p158: page 1]
תוינכט תושירד; תייהק; 2. וניוצ אלש תווצק תייהק ;45°×0.5 : םיגרבותמ םירוח יחתפ; תווצק ;; הגרד םשייל שי; 4. וניוצ אלש םוקימו הרוצ תולוביס : יפל 1184-1996T/GB; 1800.3-98 תינקת תלוביס תגרד םשייל שי ;13IT; 3. וניוצ אלש תויווק תודימל תולוביס : יפל T/GB; העיבצה תוארוה תלבט יפל ;; 7. ןווגה סיטרכ יפל לוחכב העיבצ ; העיבצה ירוזא; םיחטשמה :; טוטרש רפסמ םדוק רוקמ; רוקמ טוטרש; קתעה תקידב; ןויליג לדוג; הסרג רפסמ; תווצ שיא; הדימ הנק לקשמ

רפסמ בותיכה תא רזיילב טורחל
טוטרשה B+ ’

רזיילב ןאכ טורחל R

1. תודח תוניפ ריסהל שי , רמוח יפדוע
םידרגו ;

ימרת לופיט ( ימיכ לופיט תוברל ) חטש ינפ לופיט

רמוח טוטרשה ההזמ קלחה םש

םיפתושמ םיקלח םושיר
רזוח שומישב וא
תקתעה
טוטרש

רמוחה ןקת דיה ףכ שרוש ףוג

וניוצ אלש תולוביס Limit /

5. טוטרשב , ▽ יטירק ןייפאמ ןייצמ ◇ ,CC ןייפאמ ןייצמ
בושח SC
ןייפאמ ;

תיווק הדימ Measure Liner \

ןונכת
הקידב
ןויליג 1 ךותמ 2 רושיא

6. וניוצ אלש תודימל , לדומ D3 רוקמה אוה
עבוקה ;

>0.5 | ＞3 | ＞6 | ＞30 | ＞120 | ＞400 | ＞1000 | ＞2000
±0.05 | ±0.05 | ±0.1 | ±0.15 | ±0.2 | ±0.3

תיווז Angle / הזאפ Chamfer \

ךיראת | | | ±0.2 | ±0.5 | ±1 | ±2 | ±1° | ±30’ ±10’ ±20’

ROBOSKIN | RP1-derived engineering record

English file: ROBOSKIN.0156_wrist_body.pdf
Status: derivative identification; NOT a manufacturing release.

Existing dimensions, tolerances, material and revision remain authoritative. Source engineering graphics and original attribution are retained. Technical notes may remain in the source language.
Only searchable project part IDs on original pages are replaced. Outlined/raster labels require the original CAD authoring application.

Original drawing pages: 1
Searchable ID replacements: 2
Source: Roboparty/rp1_hardware
Hardware licence: CERN-OHL-W-2.0 where applicable; see LICENSES.md. Original path and SHA256: electronic_skin/branding/file_manifest.json

Part aliases in this document:
YCL.M000471 -> ROBOSKIN.0156

תודימה , ורמשנ טוטרשבש תולובסהו םירמוחה . הדשו דומע ןייצמ לאמשמ רפסמה . | - ROBOSKIN טוטרשה טסקטל ירבע ארקמ

p1 T1074

רזיילב ןאכ טורחל R

p1 T1120

טוטרשה רפסמ בותיכה תא רזיילב טורחל B+ ’

p1 T0954

תוינכט תושירד

p1 T0026

1. תודח תוניפ ריסהל שי , םידרגו רמוח יפדוע ;

p1 T0066

2. וניוצ אלש תווצק תייהק ;45°×0.5 : םיגרבותמ םירוח יחתפ

p1 T0545

תווצק תייהק ;

p1 T0099

3. וניוצ אלש תויווק תודימל תולוביס : יפל T/GB

p1 T0053

1800.3-98 תינקת תלוביס תגרד םשייל שי ;13IT

p1 T0121

4. וניוצ אלש םוקימו הרוצ תולוביס : יפל 1184-1996T/GB

p1 T0250

הגרד םשייל שי ;K

p1 T0130

5. טוטרשב , ▽ יטירק ןייפאמ ןייצמ ◇ ,CC בושח ןייפאמ ןייצמ SC

p1 T1155

ןייפאמ ;

p1 T0143

6. וניוצ אלש תודימל , לדומ D3 עבוקה רוקמה אוה ;

p1 T0154

7. ןווגה סיטרכ יפל לוחכב העיבצ ; העיבצה ירוזא

p1 T0669

העיבצה תוארוה תלבט יפל ;

p1 T0573

םיחטשמה רתי :

p1 T1009

םדוק רוקמ טוטרש רפסמ

p1 T1239

המיתח

p1 T1006

ךיראת

p1 T0893

רוקמ טוטרש רפסמ

p1 T0546

רזוח שומישב וא םיפתושמ םיקלח םושיר

p1 T0980

טוטרשה קתעה תקידב

p1 T0979

טוטרש תקתעה

p1 T1365

ןונכת

p1 T1007

ךיראת

p1 T0720

ןויליג לדוג

p1 T1020

וניוצ אלש תולוביס Limit /

p1 T1363

### תיווז Angle /

p1 T0543

### הזאפ Chamfer \

p1 T1256

### תיווק הדימ Measure Liner \

p1 T0900

### Zhang Zhengyu

p1 T0951

רושיא

p1 T1147

הסרג רפסמ

p1 T0796

הקידב

p1 T0568

ןויליג 1 ךותמ 2

p1 T0513

תווצ שיא

p1 T1437

לקשמ

p1 T1093

הדימ הנק

p1 T1520

קלחה םש

p1 T0447

p1 T0719

טוטרשה ההזמ

p1 T1025

רמוח

p1 T0707

העיבצ

p1 T0740

תורעה

p1 T1137

ימרת לופיט ( ימיכ לופיט תוברל )

p1 T1350

חטש ינפ לופיט

p1 T0990

תומכ

p1 T0928

דיה ףכ שרוש ףוג

ROBOSKIN

p1 T1026

רמוחה ןקת
