oznav2/tectile_skin/hardware/02_PCB/01_USB3_Flexible_Interconnect/05_Assembly_Requirements_FPC.xlsx

ROBOSKIN מסמך דרישות ייצור והרכבה של PCBA
שם פריט: | מעגל גמיש FPC | שם קובץ הנדסי | V1.6pro usb3.0 fpc
קוד פריט במלאי: | ROBOSKIN.0066 | מספר גרסה: | V1.0
מספר שכבות בלוח: | 2 | עובי לוח(mm): | 0.11
סדר השכבות: | 1、TOP 2、BOT
חומר הלוח: | מעגל גמיש FPC | מותג חומר הלוח: | Shengyi
צבע דיו המסכה: | צהוב | צבע הדפסת המשי: | לבן
כמות לייצור: | לפי הכמות בחוזה
שיטת ייצור: | לפי GERBER
טיפול פני שטח | גימור זהב בטבילה
טיפול במעברי שכבות: | לא נדרש
עובי נחושת חיצונית | 1/3 OZ | עובי נחושת בשכבות פנימיות: | ללא שכבה פנימית
תקן IPC | דרגה2 | הערות | חיזוק PI בעובי0.225; בקרת עכבה בטווח±10%
האם נדרשת בקרת עכבה | כן | הערות:
תקנים רלוונטיים | ROHS | דוחות נדרשים: | דוח בדיקה ודוח פרמטרי תהליך
שיטת סידור בפאנל | הספק יתכנן את פאנל הייצור |  | עכבה של90 אוהם
אזור תווית | אין מיקום קבוע; להצמיד לפי בחירת היצרן | הערות:
הערות
