oznav2/tectile_skin/hardware/01_Mechanic/02_Manufacturing/02_3D_Printing/CMF_Specification/ROBOSKIN_3D_Print_CMF_Specification.xlsx

מספר סידורי | מזהה החלק | שם החלק | צבע | חומר | תהליך | תמונה מוקטנת של מבט תלת־ממדי
1 | ROBOSKIN.0106 | מכסה עליון של הזרוע העליונה | אפור | ABS | ליטוש וצביעה בהתזה
2 | ROBOSKIN.0107 | מכסה עליון של האמה | אפור | ABS | ליטוש וצביעה בהתזה
3 | ROBOSKIN.0108 | מכסה תחתון של האמה | אפור | ABS | ליטוש וצביעה בהתזה
4 | ROBOSKIN.0109 | מכסה עליון של האמה — גרסת מראה | אפור | ABS | ליטוש וצביעה בהתזה
5 | ROBOSKIN.0111 | לוח כיסוי קצה שורש כף היד | אפור | ABS | ליטוש וצביעה בהתזה
6 | ROBOSKIN.0137 | מכסה כתף 75 | כחול | ABS | ליטוש וצביעה בהתזה
7 | ROBOSKIN.0139 | מכסה כתף 75 — גרסת מראה | כחול | ABS | ליטוש וצביעה בהתזה
8 | ROBOSKIN.0142 | מכסה הירך | אפור | ABS | ליטוש וצביעה בהתזה
9 | ROBOSKIN.0145 | לוח כיסוי השוק | אפור | ABS | ליטוש וצביעה בהתזה
10 | ROBOSKIN.0240 | logo מכסה תאורה | לבן | ABS | ליטוש וצביעה בהתזה
11 | ROBOSKIN.0251 | כיסוי מסתיר ברגים לראש בקרת התנועה | לבן | ABS | ליטוש וצביעה בהתזה
12 | ROBOSKIN.0253 | חזית הראש בגרסת KICKME | לבן | שרף UFS9002 | ליטוש וצביעה בהתזה
13 | ROBOSKIN.0255 | כיסוי קדמי של מעטפת הראש האינטראקטיבי | לבן | ABS | ליטוש וצביעה בהתזה
14 | ROBOSKIN.0257 | מכסה עליון למסך הראש האינטראקטיבי | שחור | ABS | ליטוש וצביעה בהתזה
15 | ROBOSKIN.0258 | תושבת מעטפת עליונה של הראש האינטראקטיבי | לבן | ABS | ליטוש וצביעה בהתזה
16 | ROBOSKIN.0259 | תושבת מעטפת תחתונה של הראש האינטראקטיבי | לבן | ABS | ליטוש וצביעה בהתזה
17 | ROBOSKIN.0261 | כיסוי דקורטיבי עליון של הראש האינטראקטיבי | לבן | ABS | ליטוש וצביעה בהתזה
18 | ROBOSKIN.0262 | כיסוי דקורטיבי אחורי של הראש האינטראקטיבי | לבן | ABS | ליטוש וצביעה בהתזה
19 | ROBOSKIN.0263 | כיסוי דקורטיבי צדי של הראש האינטראקטיבי-L | לבן | ABS | ליטוש וצביעה בהתזה
20 | ROBOSKIN.0264 | כיסוי דקורטיבי צדי של הראש האינטראקטיבי-R | לבן | ABS | ליטוש וצביעה בהתזה
