oznav2/tectile_skin/hardware/02_PCB/01_USB3_Flexible_Interconnect/07_Assembly_Reference_FPC.jpg

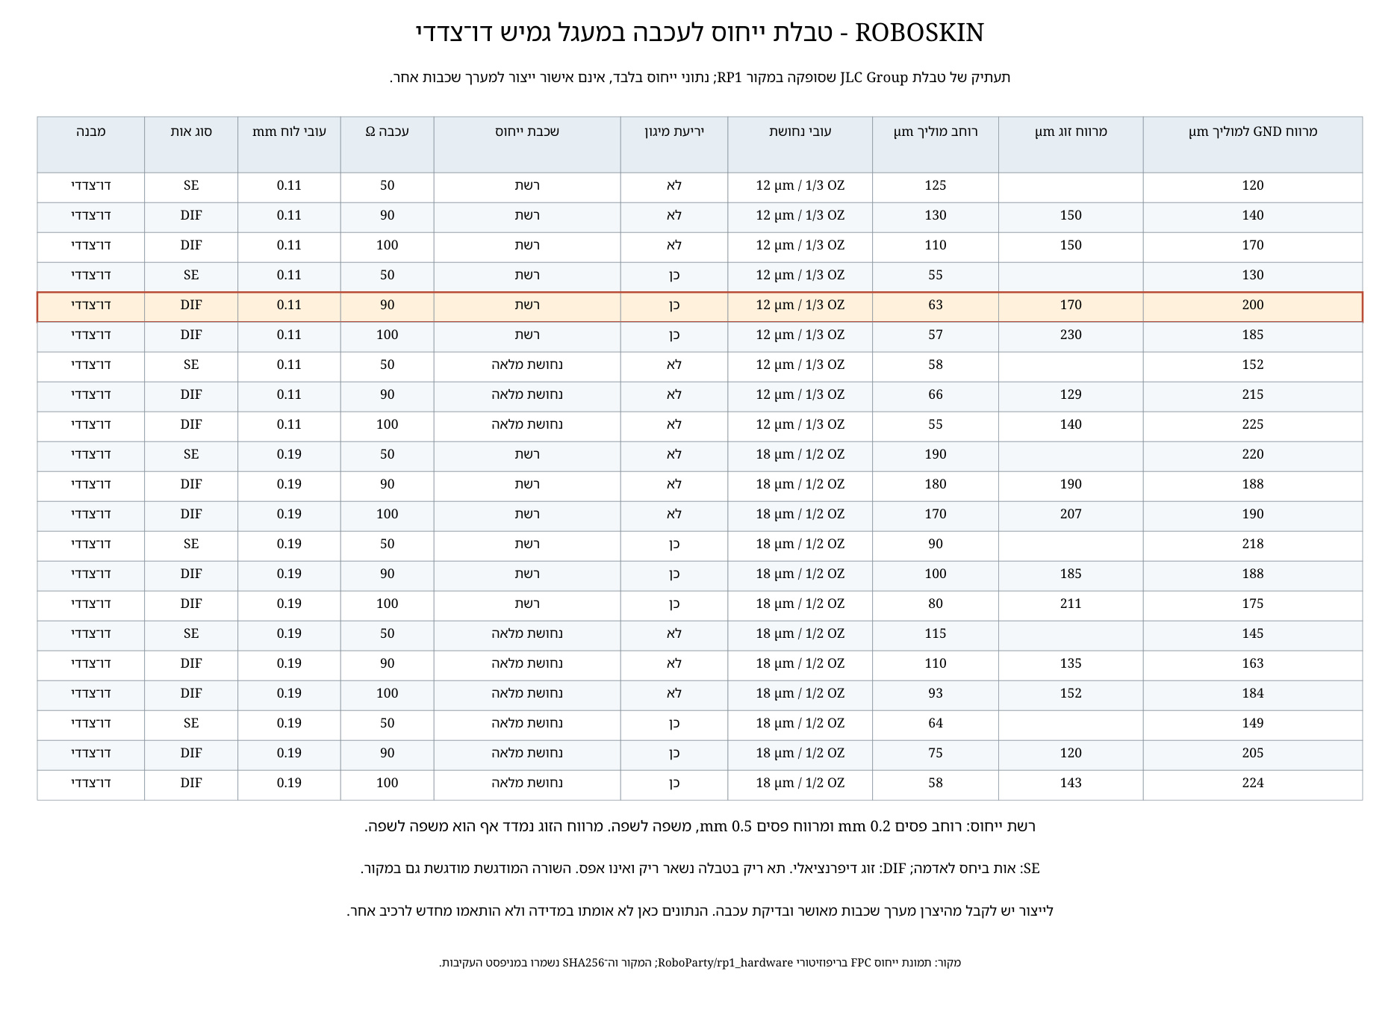
hardware/02_PCB/01_USB3_Flexible_Interconnect/07_Assembly_Reference_FPC.jpg
