oznav2/tectile_skin/hardware/02_PCB/03_RBE-MAIN-RK3588S/07_Assembly_Reference_MAIN.jpg

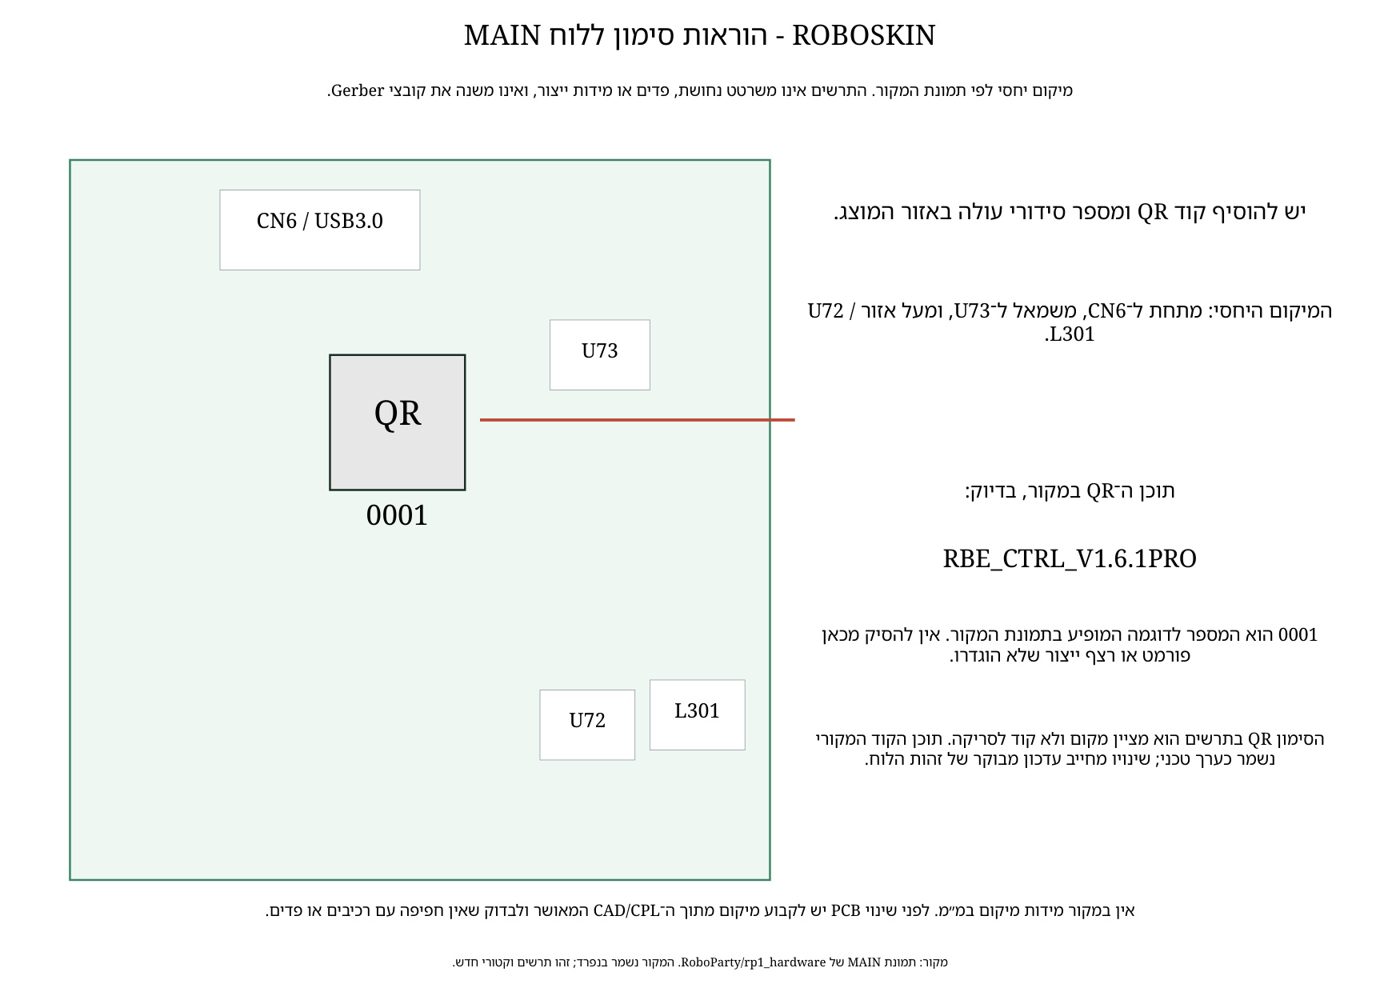
hardware/02_PCB/03_RBE-MAIN-RK3588S/07_Assembly_Reference_MAIN.jpg
