oznav2/tectile_skin/electronics/optional_calibration.md

<div dir="rtl" lang="he">

עברית · [English](optional_calibration.en.md)

# גרסת כיול אינרציאלי אופציונלית של ROBOSKIN

לעור הבסיסי יש מגע וטמפרטורה בלבד. הוסיפו IMU אחד בעל שישה צירים, המיוחס בקשיחות לכל אחד משמונת בקרי הדוגמה, אם בודקים לוקליזציית ציר מפרק או טלאי בסגנון Cheng. זו גרסת חומרה וקושחה המתומחרת בנפרד. שמונה תצפיות אינרציאליות אינן 88 תצפיות על תאי חישה הנעים באופן עצמאי; הניחו טרנספורמציית טלאי־לחוליה ידועה ויציבה רק היכן שההתקנה קשיחה בפועל.

מודול מעבדה: **Adafruit 4438, LSM6DSOX**. עמוד היצרן מציג $11.95, מדידות ב־6 צירים, I²C/SPI ולוח בגודל 25.6×17.8×4.6 mm ובמסה 1.7 g. הזמינות הנוכחית שונה בין עמודים מאונדקסים, ולכן המחיר הוא מחיר מחירון שנצפה, ולא הצעת מחיר לאספקה. שמונה מודולים בתוספת $3 לחיווט מקומי ו־$5 להקצבת מתקון ובדיקה לכל אחד מסתכמים ב־**$159.60**, ללא הנדסת קושחה, סנכרון, מתקנים וכיול. אין לשלב זאת בעלות העור הבסיסי או לטעון שהדבר מספק כיול אוטומטי ללא מימוש. [מודול ותכנון מקור](https://www.adafruit.com/product/4438), [גיליון נתוני חיישן ST](https://www.st.com/resource/en/datasheet/lsm6dsox.pdf).

חיווט תוספת לבקר הייצור:

| חיבור מודול | חיבור בקר | כלל |
|---|---|---|
| VIN |3V3 |השתמשו בהזנת 3.3 V לתוספת זו; כללו את הזרם המדוד שלה בתקציב הצומת |
| GND |GND |מסלול החזרה מקומי קצר |
| SCL |PA11, LQFP48 pin33, AF6 I2C2_SCL |מקומי ≤50 mm; אין להעביר I²C לאורך הגפה |
| SDA |PA12, LQFP48 pin34, AF6 I2C2_SDA |מקומי ≤50 mm; בדקו נגדי משיכה בלוח ההרחבה לפני הוספת נגדים במקביל |
| INT1 |PA4, LQFP48 pin15, EXTI4 |החתימו בזמן את פסיקת מוכנות הדגימה באותו תחום שעון חומרה של דגימות העור |

שלושת פיני ה־MCU האלה אינם בשימוש ברשימת הרשתות הבסיסית, ויש לשנות אותם במכוון בגרסה זו. אין להחיל מיפוי מחדש של PA9/PA10, המתנגש בפונקציות תקלה ושירות, ואין להקצות מחדש את פיני CAN RX/TX של העור, 47/48. מיפוי הציוד ההיקפי מתועד ב־ST DS13560, טבלה 13; פיני מארז 33/34 לפי טבלה 12. [נתוני MCU של ST](https://www.st.com/resource/en/datasheet/stm32g0b1vc.pdf).

התחילו בפלט מסונכרן של מד תאוצה וגירוסקופ ב־416 Hz, בטווחים ±4 g ו־±500 מעלות לשנייה; אשרו קידודי אוגרים, זהות שבב והתנהגות חותמות זמן וחריגות מול מהדורת החיישן בפועל. השתמשו בהעברות פסיקה/DMA ב־I²C מקומי של 400 kHz ותעדו חותמות זמן של דגימה מוכנה, רצף, קנה מידה, כיוון צירים וחריגות FIFO. שמרו נתוני גלם ודגימות מקודדי מפרקים, ולא רק כיוון לאחר מיזוג. מצב כיול חייב להיות בעל פורמט מנות מוצהר משלו ועומס CAN מדוד; מסגרת המגע הבסיסית בת 64 הבתים אינה מכילה מטען אינרציאלי מומצא.

לפני התאמת מודל: כיול מד תאוצה בשש פאות; הטיית גירוסקופ במנוחה בטמפרטורות הרלוונטיות; מדידת היסט וסחיפת חותמות זמן מול לכידת מקודד מפרק; אימות סימן ומסגרת באמצעות תנועה קטנה ידועה. הניעו מפרק נתמך אחד בכל פעם בתוך הטווח הצר שאומת מכנית, במהירות איטית חוזרת ועם תאוצה זוויתית מדידה מספקת. השוו תאוצה לאחר חיסור כבידה ותאוצה משיקית למודל. תא סמוך לציר או עירור לא מספיק יוצרים רדיוס שאינו ניתן לצפייה; דווחו זאת במקום להחזיר אפס בביטחון. אמתו את הטרנספורמציות שהוסקו מול ציוני דרך עצמאיים שנמדדו. הפרידו בין הכנסה לשירות להרשאות פיקוד לרובוט.

IMU מרכזי יחיד אינו יכול להחליף את שמונה התצפיות המרחביות האלה. עיוות יריעה גמישה מפר גם את הנחת הטלאי הקשיח; לוחות צרים ותמיכה יציבה מצמצמים את הבעיה, ואילו הסרת חיישנים כדי לחסוך בעלות הופכת חלק מטענות הכיול העצמי לבלתי זמינות.

</div>
