oznav2/tectile_skin/research/calibration_networks/review.en.md

[עברית](review.md) · English

# Calibration, event transport and network evidence review

Reviewed 2026-10-24. Scope: Cheng et al. (2019), references20–24 and41–62, all27 assigned entries.

This is an evidence audit and a set of engineering adaptations for the proposed28-contact-site/two-NTC patch. It is not a claim to have read27 complete originals. Access obtained:1 complete full text,12 partial texts,9 abstracts and5 citation-only records. Ref61 was downloaded from the official MDPI static repository and read in full. Many primary repository PDFs returned429 or timed out. Indexed manuscript excerpts were usable, but missing methods and plots remain explicitly missing. The complete2019 review supplied by the user gives additional context and algorithms; it does not replace access to every underlying experiment.

The source ledger is [references.json](references.json). Each numbered entry below identifies exactly what was read. "Plan action" and "test" are engineering recommendations for this project, not claims that the cited authors validated this hardware. No authors were contacted and no paywalls bypassed.

## Changes that should enter the plan now

1. **Use the cheapest geometry that is actually observable.** Keep a mechanically registered carrier with a versioned CAD map containing every site's position and outward unit normal. A curved carrier needs different normals at different sites. Network discovery finds electronic identities; it does not determine where a patch is attached. The baseline has no per-site accelerometer, active LED marker or proximity sensor, so it cannot execute the complete TUM localization pipeline. References44–47 make these hardware distinctions important. The proposed removable dual-IMU fixture is an adaptation for checking known geometry.

2. **Separate three different calibration products.** The activity matrix says which joints influence which segments. Axis/perpendicular-radius estimation checks limited geometric parameters. A full forward model additionally needs frame conventions, link offsets, joint zeros and root registration. None of these establishes link mass, inertia or friction. Ref45 explicitly separates physical structural tests from simulated parameter estimation; ref46 later reports a physical UR5 experiment. Do not combine their evidence into an unmeasured accuracy claim for our fixture. See the [ref45 primary abstract](https://portal.fis.tum.de/en/publications/open-loop-self-calibration-of-articulated-robots-with-artificial-/) and [ref46 primary abstract](https://portal.fis.tum.de/en/publications/automatic-robot-kinematic-modeling-with-a-modular-artificial-skin/).

3. **Adopt a conservative send-on-delta hybrid, with a valid periodic fallback.** Scan at100Hz regardless of transmission mode. Send complete absolute snapshots at100Hz during active contact, transitions and faults; allow50Hz only in validated idle conditions. Contact, release, overload and diagnostic changes override a simple amplitude deadband. Fresh capture timestamps and a20ms idle refresh allow the existing40ms age gate to remain meaningful. Provision the network for every node at100Hz. The reduction in idle snapshot count is at most50%, before additional diagnostics. Historical packet/CPU results cannot be copied into this design; references50–52 use different packet formats and workloads. Ref61 already discusses heartbeat updates on pp.60–61, so adding a heartbeat is also prior art.

4. **Make loss and silence visible.** Absolute snapshots prevent accumulation of signed-increment reconstruction drift, but do not recover a short event that occurred and ended during a loss interval. An event sequence, session/boot identity, capture time, valid-site mask and timeout behavior must be specified within the actual wire format. A CAN acknowledgment is not confirmation that the host application consumed the sample. A successfully queued message is also not necessarily a transmitted one. Set the sender's last-reported reference on successful transmission completion, and do not clear pending transition/fault information merely because a queue was full.

5. **Do not put a mesh promise on a bus.** Ref62 studies multi-hop alternative paths. A shared CAN trunk has neither the same routing structure nor an alternate route around a physical short. Region separation limits the damage, while a second independent bus costs hardware and wiring. Describe actual containment and measured recovery for each physical fault. The original [ref62 abstract](https://mediatum.ub.tum.de/doc/1459302/136167106011.pdf) reports within50ms in its tested network; this is not a CAN requirement already met.

6. **Keep control geometry current when tactile values stay constant.** A fixed contact on a moving link changes its base-frame location and often its joint-torque contribution. Use a regularly scheduled control loop with current joint state. Cache a valid link-frame contact estimate or wrench if useful, then remap it each control cycle. Event receipt should update a bounded state store, not directly dispatch asynchronous motor commands. Ref52 motivates event computation; it does not justify caching a world-frame Jacobian indefinitely.

7. **Use prior art to sharpen the commercial claim.** Modular robot skin, distributed computation, event coding, skin self-calibration and reactive whole-body control all predate this project. The testable opportunity is a low-cost replaceable limb skin with reproducible manufacture, quantified approximation error, documented reliability and an auditable installed cost. The references do not yet demonstrate those results for our materials or process.

## Concrete calibration protocol and limits

The following is an engineering adaptation, not a verbatim reproduction of refs45–47.

**Fixture and records.** Use a mechanically keyed reference IMU on the stationary robot base and a keyed moving IMU on a known carrier location. Record IMU serial numbers, calibration coefficients, sensor-to-fixture rotations, fixture-to-link pose, sampling period and joint-state time alignment. A6-axis IMU adds a gyro that can help estimate motion axis; the cited papers' essential sensing is accelerometry. Extra gyro data does not remove the need to calibrate mounting orientation and lever arm. Do not infer global heading from gravity alone.

**Stationary check.** Measure bias/noise with both fixtures stationary. Collect several static orientations when possible to distinguish bias and scale error. Compare the reference movement against the allowed stationary baseline. Reject a run if the root moved; treating a walking humanoid as a fixed base invalidates this simple experiment.

**Excitation.** Use an existing robot controller to move one selected joint within its already validated motion limits, returning to its initial position. Record encoder angle and trustworthy angular derivatives along with sensor samples. Repeat in both directions and in multiple poses. Increase neither acceleration nor travel automatically to obtain a better signal. If the available motion cannot excite the parameter sufficiently, retain the CAD value and report an unobservable calibration result.

**Frame conversion.** An accelerometer measures specific force. In a common frame, a = R f + g, subject to its convention and calibration. Subtracting raw three-axis measurements from differently oriented sensors is incorrect. Reference subtraction must respect the separate rotations and possible translational acceleration of each mounting point.

**Activity matrix.** Compare motion-dependent energy against the measured stationary distribution and vibrations on unconnected links. Estimate which segment responds to which joint; cross-check against the known kinematic tree. Reject a row with ambiguous activity instead of assigning it automatically. A detachable fixture can inspect segments sequentially; this is different from observing every cell simultaneously.

**Axis and radius.** For an isolated rigid revolute motion about a stationary axis:

    a = alpha × r + omega × (omega × r)

With known axis, angular acceleration and angular velocity, fit the observable perpendicular radius using all valid samples and report residuals. The component of r along the joint axis lies in the measurement nullspace. A single-joint run therefore cannot recover that axial offset. Pure or nearly constant-speed motion also gives little tangential excitation. Gravity-only orientation leaves yaw unobservable. These are physical identifiability limits, not deficiencies that a more complex optimizer can eliminate.

**Conditioning and held-out validation.** Publish the regression singular values, noise level, residual distribution and bootstrap or repeated-run uncertainty. Select an acceptance bound from the required application accuracy and fixture metrology before looking at results. Compare with independently measured carrier geometry and poses excluded from the fit. A small training residual is insufficient. Keep the original CAD model if a fitted parameter fails any gate.

**Body-map release.** Store map revision, root transform, carrier model, per-site position/normal, calibration version and permitted installation orientation together. Replacing a cover may alter pressure calibration; replacing or reversing a carrier can invalidate spatial calibration. Simulate a known inward force at several sites and verify the resulting commanded retreat is outward with the intended units.

## Concrete event/network qualification

Use raw recordings and synthetic transport fault injection so periodic and hybrid modes see identical input.

| Case | Required observation |
|---|---|
| Quiet motor-off and motor-on | Site noise, false transition rate, actual idle frame rate, current consumption |
| Slow pressure ramp | No threshold-sized permanent bias; preserved absolute samples; no inappropriate zero tracking |
| Contact held60s | Contact remains asserted; creep/drift reported separately |
| Brief touch and release | Acquisition-detectable pulses appear; clearly report pulses shorter than the10ms scan interval may be missed |
| All sites and all nodes active | No reliance on idle compression; bounded queues and maximum acquisition age |
| Lost frame and lost burst | Sequence gap visible; next absolute frame restores current state; missed transient remains acknowledged as unknown |
| Reboot, timestamp wrap, duplicate frame | Old-session/replayed data rejected; fresh identity and timing required |
| Stopped sensor scan but running CAN | Capture age fails even if receive timestamps continue changing |
| Failed UI/logger | Acquisition and control validity unaffected; display may drop frames independently |
| Open branch, open trunk, bus short, gateway reset | Measured fault scope and stale transition for each; no fictional rerouting |
| Constant contact with changing joint pose | Recomputed geometric control matches periodic reference |

Derive delta thresholds from measured noise, quantization and the desired smallest meaningful change, then freeze/version them for the qualification run. Do not let adaptive noise suppression silently increase the threshold during real contact. Use hysteresis and explicit state transitions for contact/release. The latency budget must include scan phase, filtering, queueing, arbitration, gateway transfer and control scheduling. A100Hz scan alone permits up to10ms phase delay before filtering or networking.

Report both median and tail/worst-observed latency, plus the test duration and number of samples. A worst-observed number is not a mathematical hard bound; queue and scheduling analysis are also required before a deterministic timing claim. This plan's40ms validity threshold is an application design parameter, not a guarantee proven by the cited studies.

## Reference-by-reference ledger

### [20] A real-time distributed architecture for large-scale tactile sensing

E. Baglini, S. Youssefi, F. Mastrogiovanni and G. Cannata; 2014. [Source](https://ewh.ieee.org/soc/ras/conf/financiallycosponsored/IROS/2014/www.iros2014.org/images/download/IROS2014-Full-Conference-Digest.pdf); DOI [10.1109/IROS.2014.6942778](https://doi.org/10.1109/IROS.2014.6942778).

**Access: ABSTRACT_ONLY.** Official IROS2014 digest, p.134, and author-uploaded abstract; original seven-page paper not obtained.

**Finding.** Describes an EtherCAT-based distributed network connecting computational nodes associated with skin patches and evaluates the real-time architecture.

**Limit.** The accessible material does not establish the exact hardware cost, measured deadline distribution, or fault containment available to this project. EtherCAT results cannot certify a CAN FD implementation.

**Plan action.** Adapt its separation of local acquisition, transport and host processing. Keep CAN FD for the low-cost baseline; qualify deadlines under maximum traffic before increasing node count.

**Verification.** Timestamp ADC scan completion, CAN transmission, gateway reception and consumer execution separately. Test every region at maximum active traffic while logging, displaying data and injecting node resets.

**Prior art.** Distributed patch processing and real-time tactile networking are established prior art.

Additional locators: [1](https://www.researchgate.net/publication/271072617_A_real-time_distributed_architecture_for_large-scale_tactile_sensing). Their access status is described above; a link does not imply full-text review.

### [21] A real-time data acquisition and processing framework for large-scale robot skin

S. Youssefi, S. Denei, F. Mastrogiovanni and G. Cannata; 2015. [Source](https://www.sciencedirect.com/science/article/pii/S0921889015000172); DOI [10.1016/j.robot.2015.01.009](https://doi.org/10.1016/j.robot.2015.01.009).

**Access: PARTIAL_TEXT.** Publisher-indexed introduction and selected architecture/implementation sections, including Skinware abstraction and historical test platform. Full results and figures not reviewed.

**Finding.** Skinware separates tactile applications from particular sensors and network technologies and treats data coherence, consistency and timing as architectural concerns. Its reported environment includes RTAI and an older Linux platform.

**Limit.** Historical software-platform results do not establish present ROS2/Linux deadline behavior or direct STM32/CAN compatibility.

**Plan action.** Adopt immutable complete-scan snapshots with versioned metadata and bounded producer-consumer queues. Keep real-time consumers independent from visualization, file I/O and discovery.

**Verification.** Freeze or crash the UI/logger while exercising acquisition. Assert the control consumer sees either a coherent fresh snapshot or an explicit invalid/stale state, never a mixture of scans.

**Prior art.** A common sensor abstraction and real-time skin middleware are established; contribution must be reproducible integration quality and cost.

### [22] Asynchronous, event-driven readout of POSFET devices for tactile sensing

S. Caviglia, M. Valle and C. Bartolozzi; 2014. [Source](https://doi.org/10.1109/ISCAS.2014.6865717); DOI [10.1109/ISCAS.2014.6865717](https://doi.org/10.1109/ISCAS.2014.6865717).

**Access: CITATION_ONLY.** Identity and conference pages2648–2651 checked against ISCAS proceedings contents; original abstract/body not obtained. DOI corroborated by later scholarly reference lists.

**Finding.** The title establishes an earlier POSFET/event-readout line of work. No device-level performance or circuit claim from this paper is relied upon here.

**Limit.** No original circuit schematic, process, power, noise or bandwidth was available for audit; a POSFET circuit cannot be presumed equivalent to the chosen resistive film.

**Plan action.** Do not transplant or cost a POSFET circuit from this citation. The baseline continues to use a conventional ADC and firmware change detection; identify that as sampled event reporting.

**Verification.** Document actual scan period and first-sample latency. Do not label the MCU design a continuously asynchronous transducer.

**Prior art.** The title is enough to flag asynchronous tactile readout as pre-existing work; performance comparison requires the original paper.

Additional locators: [1](https://www.proceedings.com/content/022/022887webtoc.pdf). Their access status is described above; a link does not imply full-text review.

### [23] Event-driven encoding of off-the-shelf tactile sensors for compression and latency optimisation for robotic skin

C. Bartolozzi et al.; 2017. [Source](https://www.researchgate.net/publication/321816551_Event-driven_encoding_of_off-the-shelf_tactile_sensors_for_compression_and_latency_optimisation_for_robotic_skin); DOI [10.1109/IROS.2017.8202153](https://doi.org/10.1109/IROS.2017.8202153).

**Access: PARTIAL_TEXT.** Author-uploaded manuscript excerpts: architecture, encoding comparison and conclusions. Primary IIT laboratory publication listing also checked. Full paper was not independently downloaded.

**Finding.** Studies event encodings of existing tactile sensors, including recorded iCub fingertip data, and describes an FPGA-based acquisition path with hierarchical event addressing. Sensor conversion and event transport are distinct stages.

**Limit.** Fingertip datasets, FPGA acquisition and AS-AER links do not demonstrate whole-limb resistive-film performance. Encoding simulations and hardware properties must be distinguished.

**Plan action.** Adopt explicit body/patch/site identifiers, acquisition timestamps and a reproducible raw-data-versus-event comparison. Keep CAN integrity and periodic absolute snapshots; reject an FPGA hub as the minimum-cost baseline.

**Verification.** Replay identical raw recordings through periodic and hybrid encoders. Report event onset misses, absolute reconstruction error, bytes on the wire and end-to-end age, including packet overhead.

**Prior art.** Off-the-shelf tactile event conversion, address hierarchies and event compression are prior art.

Additional locators: [1](https://edpr.iit.it/neuromorphic-icub-infrastructure). Their access status is described above; a link does not imply full-text review.

### [24] The event-driven software library for YARP—With algorithms and iCub applications

A. Glover, V. Vasco, M. Iacono and C. Bartolozzi; 2018. [Source](https://www.frontiersin.org/journals/robotics-and-ai/articles/10.3389/frobt.2017.00073/full); DOI [10.3389/frobt.2017.00073](https://doi.org/10.3389/frobt.2017.00073).

**Access: PARTIAL_TEXT.** Publisher-indexed sections3.2–3.3 on event representation, readers/queues and processing; complete article body not retrieved.

**Finding.** Provides event packet representations and software handling in YARP, with processing decoupled from receipt. The discussion recognizes large variations in event traffic and computation.

**Limit.** Its illustrative large-rate examples concern vision. A flexible event library does not establish a hard skin-control deadline or justify silently skipping required control updates.

**Plan action.** Adapt recording/replay, typed event records and independent receive/processing threads. Use bounded queues with counters and an explicit overload state; make GUI frame dropping independent of tactile validity.

**Verification.** Burst all sites simultaneously, pause each consumer, then resume. Verify bounded memory, monotonically sequenced records and deterministic stale-data handling.

**Prior art.** Event middleware and replay are established infrastructure; do not market them as a new sensory nervous system.

### [41] Humanoid multimodal tactile-sensing modules

P. Mittendorfer and G. Cheng; 2011. [Source](https://portal.fis.tum.de/en/publications/humanoid-multimodal-tactile-sensing-modules/); DOI [10.1109/TRO.2011.2106330](https://doi.org/10.1109/TRO.2011.2106330).

**Access: ABSTRACT_ONLY.** University bibliographic record and abstract; full methods, circuit and characterization tables not obtained.

**Finding.** Describes modular off-the-shelf multimodal skin with local digitization/processing and network connectivity, including temperature, acceleration and proximity sensing.

**Limit.** This earlier hardware generation should not be conflated with the later force-cap version. Its multimodal capability is absent from a pressure-plus-NTC patch.

**Plan action.** Adopt local processing and replaceable modules. Publish an explicit modality table: approximate normal contact and two temperature points in baseline; no shear, proximity or inertial self-localization.

**Verification.** For every advertised modality, demonstrate a repeatable stimulus, calibration, uncertainty and fault response using the actual production-intent patch.

**Prior art.** Modular multimodal cells and local intelligence existed by2011.

### [42] Integrating discrete force cells into multi-modal artificial skin

P. Mittendorfer and G. Cheng; 2012. [Source](https://mediatum.ub.tum.de/doc/1116556/214040.pdf); DOI [10.1109/HUMANOIDS.2012.6651619](https://doi.org/10.1109/HUMANOIDS.2012.6651619).

**Access: PARTIAL_TEXT.** Repository-indexed first-page abstract, force-cell construction and introduction. Full force/displacement graphs and durability results not reviewed.

**Finding.** Uses etched CuBe2 spring structures with capacitive measurement, three force cells per skin module, and automated assembly concepts. The paper reports2.5kHz acquisition filtered to250Hz and SNR greater than50dB.

**Limit.** These figures belong to a metal-spring capacitive transducer, not a printed resistive taxel. Encapsulation and mechanical preload affect performance. CuBe processing is not proposed for the home-lab film route.

**Plan action.** Adopt mechanical overload stops, controlled preload and a cover-specific calibration record. Reject copying its performance numbers or force-cell BOM into the resistive design.

**Verification.** Calibrate each finished cover/sensor/carrier stack, repeat after remounting and after overload, and measure loading/unloading hysteresis and zero drift.

**Prior art.** Protected multimodal force cells and assembly-oriented mechanics are prior art.

### [43] Towards autonomous robotic skin spatial calibration: A framework based on vision and self-touch

A. Albini, S. Denei and G. Cannata; 2017. [Source](https://doi.org/10.1109/IROS.2017.8202151); DOI [10.1109/IROS.2017.8202151](https://doi.org/10.1109/IROS.2017.8202151).

**Access: CITATION_ONLY.** Primary university publication list verifies identity; a secondary abstract describes RGB-D/self-touch, but original abstract/body was not obtained. The secondary <2mm result is deliberately not adopted as validated evidence.

**Finding.** This is relevant prior art for spatial calibration using vision and robot-generated contacts; no exact original algorithm or performance claim is used in the design.

**Limit.** Reachability, camera calibration, occlusion and force-distributed contact centroids need examination before reproduction. The source available here is insufficient to promise its accuracy.

**Plan action.** Keep registered CAD carriers as the baseline. Use external probing at marked sites as a measurable manufacturing check; describe any future vision/self-touch implementation as a separate reproduction.

**Verification.** Blindly probe predeclared site centers in several poses and report position and normal errors against the fixture geometry, rather than only fitting error.

**Prior art.** Vision-assisted and self-touch spatial registration are not a new claim for this project.

Additional locators: [1](https://eng.ox.ac.uk/publications/?personId=23467), [2](https://eurekamag.com/research/100/009/100009247.php). Their access status is described above; a link does not imply full-text review.

### [44] 3D surface reconstruction for robotic body parts with artificial skins

P. Mittendorfer and G. Cheng; 2012. [Source](https://mediatum.ub.tum.de/doc/1116558/621068.pdf); DOI [10.1109/IROS.2012.6385559](https://doi.org/10.1109/IROS.2012.6385559).

**Access: PARTIAL_TEXT.** Repository first-page abstract/introduction and university abstract. The supplied2019 review §II-C supplies additional secondary explanation of reconstruction.

**Finding.** Reconstruction uses the modular skin's known structural geometry and motion-related sensing. The approach concerns shaped, connected modules rather than an arbitrary uninstrumented stretchable sheet.

**Limit.** A shared CAN address list does not reveal physical adjacency; resistive touch values do not supply gravity vectors. Stretch and slip violate a fixed module geometry assumption.

**Plan action.** Adopt a versioned body map with per-site position and unit normal derived from the rigid carrier. Bind map revision to the installed carrier and reject unknown revisions.

**Verification.** Check normals at curved-edge sites as well as patch centers. Remount and probe several positions; inhibit control if the carrier cannot be registered within the declared tolerance.

**Prior art.** Automatic surface reconstruction from instrumented skin is existing work, but is not implemented by the baseline BOM.

Additional locators: [1](https://portal.fis.tum.de/en/publications/3d-surface-reconstruction-for-robotic-body-parts-with-artificial-/). Their access status is described above; a link does not imply full-text review.

### [45] Open-loop self-calibration of articulated robots with artificial skins

P. Mittendorfer and G. Cheng; 2012. [Source](https://mediatum.ub.tum.de/doc/1116557/877587.pdf); DOI [10.1109/ICRA.2012.6224881](https://doi.org/10.1109/ICRA.2012.6224881).

**Access: PARTIAL_TEXT.** Repository-indexed pages1–2 including algorithms1–2, requirements and experimental/simulation scope; university abstract read directly. Full numerical results not obtained.

**Finding.** Uses tri-axis accelerometers and isolated joint excitation to find segment/joint activity and construct kinematic models. Requires instrumented rigid segments and a static reference. Physical KUKA results establish structural exploration; parameter estimation is additionally demonstrated in simulation.

**Limit.** Does not validate autonomous geometry from pressure-only skin. Weak excitation, reference motion and unobserved degrees of freedom can make identification ambiguous. Full numerical error bounds were not inspected.

**Plan action.** Adapt activity-matrix validation using a reusable stationary-reference/downstream IMU fixture and known joint states. Retain CAD geometry; label the fixture an adaptation, not a full reproduction of autonomous skin localization.

**Verification.** Use one joint at a time; repeat with reversed motion and held-out poses. Compare detected influence with the robot kinematic tree and reject low-SNR or inconsistent results.

**Prior art.** Activity matrices, motor excitation and accelerometer-based structural self-calibration are prior art.

Additional locators: [1](https://portal.fis.tum.de/en/publications/open-loop-self-calibration-of-articulated-robots-with-artificial-/). Their access status is described above; a link does not imply full-text review.

### [46] Automatic robot kinematic modeling with a modular artificial skin

P. Mittendorfer, E. Dean and G. Cheng; 2014. [Source](https://portal.fis.tum.de/en/publications/automatic-robot-kinematic-modeling-with-a-modular-artificial-skin/); DOI [10.1109/HUMANOIDS.2014.7041447](https://doi.org/10.1109/HUMANOIDS.2014.7041447).

**Access: ABSTRACT_ONLY.** University abstract and bibliographic record read directly. Original six-page article unavailable. Supplied2019 review §II-D is secondary evidence for axis/SVD/radius sequence.

**Finding.** Uses per-cell tri-axis accelerometers, open-loop motions and circle-point analysis to build a forward kinematic model. The abstract reports a physical UR5 experiment on an inertial dual-arm platform.

**Limit.** No original numerical errors, conditioning tests or implementation parameters were accessible. One revolute motion identifies perpendicular radius, not the axial component of a sensor offset; full geometry needs additional constraints.

**Plan action.** Use axis/perpendicular-radius estimation only as an offline cross-check against CAD. Do not claim recovery of every DH offset, mass, inertia or friction from a dual-IMU experiment.

**Verification.** Fit acceleration versus known angular acceleration, retain confidence intervals and residuals, and validate against independent measured radii and unseen poses. Reject rank-deficient fits.

**Prior art.** Automatic kinematic modeling from skin acceleration precedes this project. A low-cost reusable fixture may be an implementation distinction, subject to measurement.

Bibliographic note: Humanoids2014 proceedings; university record lists publication12Feb2015. Both dates refer to the same paper.

### [47] 3D spatial self-organization of a modular artificial skin

P. Mittendorfer, E. Dean and G. Cheng; 2014. [Source](https://portal.fis.tum.de/en/publications/3d-spatial-self-organization-of-a-modular-artificial-skin); DOI [10.1109/IROS.2014.6943120](https://doi.org/10.1109/IROS.2014.6943120).

**Access: ABSTRACT_ONLY.** Primary university abstract and identity. Full equations and numerical experiments not obtained.

**Finding.** Combines skin-patch geometry with an active LED visual marker and a calibrated monocular camera for spatial registration, including partial visibility.

**Limit.** Self-organization here is not entirely camera-free. A pressure-only film lacks the per-cell inertial and active-marker information of the studied system.

**Plan action.** Maintain a declared manual/CAD root transform. If camera registration is used in a fixture, make camera intrinsics, marker geometry and observation quality part of its calibration record.

**Verification.** Register from several independent views; probe points withheld from the transform fit and verify the transform direction and units.

**Prior art.** Camera-assisted skin registration is prior art; baseline simplicity is a cost/design choice, not a discovery.

### [48] Touch, in Principles of Neural Science, fifth edition, chapter23

E. P. Gardner and K. O. Johnson; 2013. [Source](https://accessmedicine.mhmedical.com/book.aspx?bookID=1049).

**Access: CITATION_ONLY.** User-supplied2019 bibliography identifies chapter23, pp.498–529. Full chapter not obtained; publisher book URL is a locator, not a claim of chapter access.

**Finding.** Biological background cited by the2019 review. No receptor count, frequency range or quantitative biological claim is extracted here without the original chapter.

**Limit.** A biological analogy cannot establish robot sensitivity, safety, durability or wiring requirements.

**Plan action.** Describe the design as functionally inspired by distributed sensing. Preserve persistent contact state and temperature measurements; avoid claiming replication of human skin's complete receptor system.

**Verification.** Maintain a held contact for at least60s and verify it never disappears merely because signal change becomes small. Measure drift separately from valid sustained contact.

**Prior art.** Distributed sensing inspired by skin is a long-established concept.

### [49] Touch is a team effort: Interplay of submodalities in cutaneous sensibility

H. P. Saal and S. J. Bensmaia; 2014. [Source](https://pubmed.ncbi.nlm.nih.gov/25257208/); DOI [10.1016/j.tins.2014.08.012](https://doi.org/10.1016/j.tins.2014.08.012).

**Access: ABSTRACT_ONLY.** Original article abstract indexed by PubMed; full review body not obtained.

**Finding.** The review emphasizes joint contributions of afferent submodalities to natural touch, rather than a simple one-receptor/one-percept correspondence.

**Limit.** It does not show that two engineered layers or sparse thermal sensors reproduce the capabilities of human skin.

**Plan action.** Keep claims modality-specific. Fuse contact and temperature at the application layer without implying that sparse NTC readings provide a complete thermal image or that normal pressure measures shear.

**Verification.** Test thermal drift during contact and heat without contact. Report each modality's spatial sampling, temporal response and cross-sensitivity separately.

**Prior art.** Biological multimodal integration is motivation, not an invention claim for a pressure/temperature laminate.

### [50] Event-based signaling for reducing required data rates and processing power in a large-scale artificial robotic skin

F. Bergner, P. Mittendorfer, E. Dean-Leon and G. Cheng; 2015. [Source](https://mediatum.ub.tum.de/doc/1281179/868479268848.pdf).

**Access: PARTIAL_TEXT.** Repository-indexed results page6, figures7–8/table/conclusion, plus official conference abstract. Whole methods not retrieved.

**Finding.** A260-cell UR5 study reports remaining traffic of16.45% at rest and47.69% under heavy stimulation without timestamps; with timestamps,21.38% and62%. Compact packets of three events suit the correlated modalities studied.

**Limit.** These are remaining-traffic fractions, not reduction percentages. Packet format, timestamps and workload matter. The baseline's64-byte absolute CAN frames will not inherit these reductions.

**Plan action.** Use this as a benchmark design, not a promised percentage. Specify maximum50% idle snapshot-count reduction for100Hzactive/50Hzidle, with smaller total savings after extra overhead.

**Verification.** Run quiet, motor-moving, stroking, impact and simultaneous-contact workloads. Count complete wire traffic and CPU time, not only useful sensor bytes.

**Prior art.** Local send-on-change for large robot skin and compression benchmarks are prior art.

Additional locators: [1](https://iros2015.informatik.uni-hamburg.de/docs/IROS_Digest_WWW.pdf). Their access status is described above; a link does not imply full-text review.

### [51] Event-based signaling for large-scale artificial robotic skin—Realization and performance evaluation

F. Bergner, E. Dean-Leon and G. Cheng; 2016. [Source](https://mediatum.ub.tum.de/doc/1335609/document.pdf); DOI [10.1109/IROS.2016.7759722](https://doi.org/10.1109/IROS.2016.7759722).

**Access: PARTIAL_TEXT.** Repository-indexed introduction/architecture and primary university abstract; complete experiment methods not accessed.

**Finding.** Uses two260-cell patches with local processing. The abstract reports48.2% packet and17.79% CPU reductions in reactive control; a worst-case5000-cell extrapolation gives21.2% and17.46%, respectively.

**Limit.** The5000-cell result is an extrapolation, not a physical5000-cell validation. Traffic, CPU and control-rate metrics are different quantities.

**Plan action.** Keep a periodic diagnostic mode and a hybrid event mode in the same firmware for controlled comparison. Publish measured patch count and extrapolated counts separately.

**Verification.** Replay identical captures in both modes with the same host code. Measure CPU, latency, dropped samples and reconstruction error at1,8 and multiple independent regions.

**Prior art.** Switchable periodic/event skin operation and performance comparisons were already demonstrated.

Additional locators: [1](https://portal.fis.tum.de/en/publications/event-based-signaling-for-large-scale-artificial-robotic-skin-rea/). Their access status is described above; a link does not imply full-text review.

### [52] Efficient event-driven reactive control for large scale robot skin

F. Bergner, E. Dean-Leon and G. Cheng; 2017. [Source](https://mediatum.ub.tum.de/doc/1366849/document.pdf); DOI [10.1109/ICRA.2017.7989051](https://doi.org/10.1109/ICRA.2017.7989051).

**Access: PARTIAL_TEXT.** Repository first-page abstract/introduction. Detailed control proofs and full experimental plots not accessed.

**Finding.** Evaluates event-driven reactive control on TOMM with two253-cell patches. The abstract reports controller CPU reductions of78% idle and66% during contact relative to the tested synchronous reference.

**Limit.** Controller savings cannot be substituted for network or driver savings. Unchanged pressure does not imply unchanged joint torque when robot configuration changes.

**Plan action.** Cache contact information or link-frame wrench contributions, but recompute their mapping with current joint states in a bounded controller cycle. Separate event receipt from command execution.

**Verification.** Hold one contact steady while changing joint pose in simulation. Compare event-mode joint torques against a fully recomputed periodic reference, including stale/missing frames.

**Prior art.** Event-driven reactive control is prior art; the project's value must lie in verified affordability and integration.

### [53] A128×128120dB15µs latency asynchronous temporal contrast vision sensor

P. Lichtsteiner, C. Posch and T. Delbruck; 2008. [Source](https://doi.org/10.1109/JSSC.2007.914337); DOI [10.1109/JSSC.2007.914337](https://doi.org/10.1109/JSSC.2007.914337).

**Access: PARTIAL_TEXT.** Original journal-paper reproduction, concluding page575 and indexed abstract. The reproduction is on a secondary host; full article not retrieved.

**Finding.** A custom asynchronous contrast imager reports120dB dynamic range,15µs latency and23mW power. Its discussion identifies event-bandwidth limitations and lack of direct DC response.

**Limit.** These are optical custom-silicon results under the paper's conditions. They do not establish response time, energy or resolution for a scanned tactile array.

**Plan action.** Use only as historical distinction between truly asynchronous transduction and100Hz sampled send-on-delta. Retain absolute contact samples so static loads remain observable.

**Verification.** Measure tactile latency with a stimulus reference and oscilloscope; never infer it from the event-camera title.

**Prior art.** Custom event sensors and address-event transmission have decades of prior art.

Additional locators: [1](https://scispace.com/pdf/a-128-times-128-120-db-15-mu-s-latency-asynchronous-temporal-3bv4hgi11i.pdf). Their access status is described above; a link does not imply full-text review.

### [54] An asynchronous time-based image sensor

C. Posch, D. Matolin and R. Wohlgenannt; 2008. [Source](https://publications.ait.ac.at/en/publications/an-asynchronous-time-based-image-sensor/); DOI [10.1109/ISCAS.2008.4541871](https://doi.org/10.1109/ISCAS.2008.4541871).

**Access: CITATION_ONLY.** Primary institutional bibliographic metadata checked. A secondary abstract was found, but no original body or complete primary abstract was reviewed.

**Finding.** Identified as prior work on asynchronous time-based optical sensing. No quantitative device claim is adopted.

**Limit.** It is an image-sensor design, not a tactile transducer or low-cost STM32 reference circuit.

**Plan action.** Do not add custom timing-coded hardware to the baseline on this citation alone. Ordinary absolute ADC values plus timestamps are sufficient for the intended touch task.

**Verification.** Document acquisition instant separately from packet arrival and verify that changing event encoding does not change the underlying sampling limit.

**Prior art.** Time-based event representations are established and are not a defensible novel claim here.

### [55] AER EAR: A matched silicon cochlea pair with address event representation interface

A. van Schaik and S.-C. Liu; 2005. [Source](https://researchers.westernsydney.edu.au/en/publications/aer-ear-a-matched-silicon-cochlea-pair-with-address-event-represe-3/); DOI [10.1109/ISCAS.2005.1465560](https://doi.org/10.1109/ISCAS.2005.1465560).

**Access: ABSTRACT_ONLY.** Primary institutional abstract. This is the2005conference paper, not the later similarly named journal work.

**Finding.** Describes paired silicon cochleae, inner-hair-cell/spiking-neuron circuitry and address-event output; its experiment uses tones from different directions.

**Limit.** An auditory analog front end offers no directly transferable tactile resolution, component price or contact-safety guarantee.

**Plan action.** Use it as a historical example of modality-specific local event generation. Keep pressure and temperature acquisition parameters independently specified.

**Verification.** Verify both modalities retain correct physical units, sampling schedules and invalid-data flags when packed into shared transport.

**Prior art.** Neuromorphic sensory event coding predates this project.

### [56] VLSI analogs of neuronal visual processing: A synthesis of form and function

M. Mahowald; 1992. [Source](https://authors.library.caltech.edu/records/g2vmh-8fe19); DOI [10.7907/Z9CZ35CD](https://doi.org/10.7907/Z9CZ35CD).

**Access: ABSTRACT_ONLY.** Caltech thesis repository metadata and abstract. The full thesis was located but not read.

**Finding.** Develops analog VLSI visual processing and communication inspired by neural systems, including retina/stereo/optic-nerve concepts.

**Limit.** A thesis abstract cannot support detailed circuit reproduction or performance comparison. Visual neuromorphic circuitry does not specify the mechanics of electronic skin.

**Plan action.** Cite as historical context if using the artificial-nervous-system analogy. Keep the engineering argument based on tested latency, reliability, mass and cost.

**Verification.** Audit the article's novelty claims against documented prior art and distinguish implementation economics from a new sensory-computing principle.

**Prior art.** Neural-inspired distributed sensing and event communication are longstanding.

### [57] Point-to-point connectivity between neuromorphic chips using address events

K. A. Boahen; 2000. [Source](https://web.stanford.edu/group/brainsinsilicon/documents/00_journ_IEEEtsc_Point.pdf); DOI [10.1109/82.842110](https://doi.org/10.1109/82.842110).

**Access: PARTIAL_TEXT.** Author-hosted abstract and repository-indexed discussion/arbiter figures; not all19journal pages.

**Finding.** Analyzes address-event communication and arbitration for time-multiplexed neuromorphic connections. Queueing and contention affect event timing and throughput.

**Limit.** AER timing properties do not remove finite bandwidth, arbitration delay or buffer limits, and do not automatically apply to CAN FD.

**Plan action.** Adopt worst-case burst and queue analysis. Preserve acquisition timestamps and distinguish age at sampling from transport delay; report queue overflow as invalid coverage.

**Verification.** Align maximum-rate reports from every node and inject retransmissions. Measure worst observed age and overflow behavior, not merely mean latency.

**Prior art.** Sparse addresses and asynchronous arbitration are prior art.

Additional locators: [1](https://repository.upenn.edu/bitstreams/4087da08-9301-4ab1-9de3-47924602da72/download). Their access status is described above; a link does not imply full-text review.

### [58] Asynchronous DC-free serial protocol for event-based AER systems

P. M. Ros, M. Crepaldi, C. Bartolozzi and D. Demarchi; 2015. [Source](https://iris.polito.it/handle/11583/2646243); DOI [10.1109/ICECS.2015.7440295](https://doi.org/10.1109/ICECS.2015.7440295).

**Access: ABSTRACT_ONLY.** Primary university abstract; original article file is restricted and was not requested from authors.

**Finding.** Proposes a serial event protocol with100Mbps raw rate and up to2.9million32-bit events/s; its abstract reports successful16-bit operation with ±2% clock mismatch, explicit flow control and AC-coupling compatibility.

**Limit.** These figures refer to that protocol and implementation. A differential pair does not make it electrically or logically interchangeable with CAN.

**Plan action.** Retain CAN FD transceivers, arbitration, error detection and diagnostics. Consider AS-AER only after a measured bandwidth bottleneck justifies separate FPGA/PHY cost.

**Verification.** Validate the actual CAN line, termination, bit timing and error recovery. Never substitute AS-AER bitrates into the CAN capacity calculation.

**Prior art.** Serial event transport over a small wire count is already established.

### [59] A QVGA143dB dynamic range frame-free PWM image sensor with lossless pixel-level video compression and time-domain CDS

C. Posch, D. Matolin and R. Wohlgenannt; 2011. [Source](https://ieeexplore.ieee.org/document/5648367).

**Access: CITATION_ONLY.** IEEE title/record and primary AIT institutional identity; original methods and figures not obtained. Similar2010ISSCC conference versions are not substituted.

**Finding.** Identifies prior work on frame-free optical sensing with time-domain encoding; no numerical claim beyond the bibliographic title is adopted as engineering evidence.

**Limit.** The2019 review's use as an example of absolute-value event coding does not make its optical circuit an appropriate tactile design.

**Plan action.** Carry absolute values in the MCU frames; do not integrate received signed increments as the only persistent contact state.

**Verification.** Drop a contact-onset packet and confirm a subsequent absolute snapshot restores the current state. Also report that the missed transient itself cannot be reconstructed.

**Prior art.** Absolute-value/time-coded event sensing is not new.

Additional locators: [1](https://publications.ait.ac.at/en/publications/a-qvga-143-db-dynamic-range-frame-free-pwm-image-sensor-with-loss/). Their access status is described above; a link does not imply full-text review.

### [60] A new protocol for a low power sensor network

M. Neugebauer and K. Kabitzsch; 2004. [Source](https://www.researchgate.net/publication/4075406_A_new_protocol_for_a_low_power_sensor_network); DOI [10.1109/PCCC.2004.1395037](https://doi.org/10.1109/PCCC.2004.1395037).

**Access: ABSTRACT_ONLY.** Author-uploaded abstract and official conference contents; original protocol details and results not read.

**Finding.** Discusses event-oriented activity for battery-powered sensor networks, relating communication scheduling to energy consumption.

**Limit.** Energy benefits depend on the radio, duty cycle and application. A wired sensor that continues sampling at100Hz does not save ADC/MCU power simply because it sends fewer packets.

**Plan action.** Separate bandwidth reduction from power reduction in the cost/performance table. Measure total rail current in both periodic and hybrid modes with identical scan schedules.

**Verification.** Measure quiet, contact and fault-mode current at the patch input and regional hub; include quiescent regulators and termination/transceiver activity.

**Prior art.** Event-based low-power sensor networking was established well before this project.

Additional locators: [1](https://www.ipccc.org/ipccc2004/TableOfContents.htm). Their access status is described above; a link does not imply full-text review.

### [61] Send-on-delta concept: An event-based data reporting strategy

M. Miskowicz; 2006. [Source](https://mdpi-res.com/d_attachment/sensors/sensors-06-00049/article_deploy/sensors-06-00049.pdf); DOI [10.3390/s6010049](https://doi.org/10.3390/s6010049).

**Access: FULL_TEXT.** Official MDPI static PDF downloaded locally; all15pages49–63 read, including equations1–13, tables1–2, software example and references. Figure3 on p.58 visually inspected.

**Finding.** Separates continuous level-crossing from periodically sampled compound implementations (p.53). Its traffic analysis depends on signal slope, peak density and threshold, and its example compares59 periodic samples with7 events over1.2s at amplitude resolution0.2 (p.58). Heartbeat updates are already described on pp.60–61.

**Limit.** The analytical comparison assumes a specified signal and resolution; it is not a universal saving, hard latency guarantee or loss/reboot protocol. The sample-count example is a simulation, not a tactile-skin experiment.

**Plan action.** Adapt to a hybrid:100Hz scanning, delta/contact/fault triggers and fresh absolute snapshots at least every20ms while idle. Include sequence, reboot/session identity and capture time; never treat silence as healthy.

**Verification.** Test delta-boundary noise, slow ramps, sustained contacts, burst loss, reboot, timestamp wrap and queue rejection. Keep100Hz worst-case provisioning and measure achieved savings.

**Prior art.** Send-on-delta, compound sampled implementations and added heartbeat updates are all established; this project adapts them.

Additional locators: [1](https://citeseerx.ist.psu.edu/document?doi=e16d4fa920e6886be986d915b768dc166e7761e0&repid=rep1&type=pdf), [2](https://www.researchgate.net/publication/26546799_Send-On-Delta_Concept_An_Event-Based_Data_Reporting_Strategy). Their access status is described above; a link does not imply full-text review.

### [62] A robust and efficient dynamic network protocol for a large-scale artificial robotic skin

C. Bader, F. Bergner and G. Cheng; 2018. [Source](https://mediatum.ub.tum.de/doc/1459302/136167106011.pdf).

**Access: PARTIAL_TEXT.** Repository-indexed abstract, first-page introduction and topology/rerouting figure. Detailed implementation and remaining experiments not read.

**Finding.** Tests a multi-hop skin network with up to204cells. The original abstract reports recovery within50ms and more than30% packet-loss reduction from balancing relative to its previous protocol.

**Limit.** The supplied2019 review reports40ms and32% greater network size: those are distinct source/metric statements, not interchangeable guarantees. Rerouting requires an intact alternate physical path.

**Plan action.** Reject literal mesh routing on the single shared CAN bus. Use regional segmentation, bounded failure detection and physical fault containment. Any redundancy needs additional buses/ports and its own BOM.

**Verification.** Unplug a node, break a trunk, short the bus and reset the gateway separately. Record the actual affected region and recovery; do not claim single-wirebreak survival from software alone.

**Prior art.** Dynamic robotic-skin routing and load balancing are prior art, but are not functions of the baseline CAN topology.

## Evidence completeness and release consequence

All27 assigned references have a record and an explicit adoption/adaptation/rejection decision. Five originals remain citation-only:22,43,48,54,59. Nine were available only as abstracts:20,41,46,47,49,55,56,58,60. Twelve yielded partial original text:21,23,24,42,44,45,50,51,52,53,57,62. Ref61 was read in full; its downloaded PDF, extracted text and inspected Figure3 rendering were retained in the local research workspace. This repository links the source and does not redistribute those artifacts. No other entry should be described as a complete full-text review.

These limits do not prevent building the conservative CAD-registered, ADC-sampled, CAN-networked proof of concept. They do prevent representing it as an exact reproduction of the inaccessible algorithms, promising their reported performance, or claiming a literature-complete novelty assessment. The project should retain explicit tests and release gates rather than turn a paper's result into an unmeasured specification. The record contains no vendor quotation, certification or patent freedom-to-operate conclusion.
