oznav2/tectile_skin/research/calibration_networks/review.md

<div dir="rtl" lang="he">

עברית · [English](review.en.md)

# סקירת הראיות על כיול, העברת אירועים ורשתות

נבדק בתאריך 2026-10-24. היקף: Cheng ועמיתיו (2019), מקורות 20–24 ו-41–62, כל 27 הרשומות שהוקצו.

זהו מבדק ראיות ומכלול התאמות הנדסיות עבור הטלאי המוצע בעל 28 אתרי מגע ושני חיישני NTC. אין זו טענה שנקראו 27 מקורות מקוריים במלואם. היקף הגישה שהושג: טקסט מלא 1, 12 טקסטים חלקיים, 9 תקצירים ו-5 רשומות ביבליוגרפיות בלבד. מקור 61 הורד מהמאגר הסטטי הרשמי של MDPI ונקרא במלואו. קובצי PDF רבים במאגרים ראשוניים החזירו 429 או חרגו מזמן ההמתנה. קטעים מאונדקסים של כתבי יד היו שימושיים, אך שיטות וגרפים חסרים נשארים מסומנים במפורש כחסרים. הסקירה המלאה משנת 2019 שסיפק המשתמש מוסיפה הקשר ואלגוריתמים; היא אינה מחליפה גישה לכל ניסוי שעליו היא מתבססת.

רשימת המקורות היא [references.json](references.json). כל רשומה ממוספרת להלן מזהה בדיוק מה נקרא. ״פעולה בתוכנית״ ו״בדיקה״ הן המלצות הנדסיות לפרויקט זה, ולא טענות שהמחברים המצוטטים אימתו חומרה זו. לא נוצר קשר עם מחברים ולא נעקפו חומות תשלום.

## שינויים שיש להכניס לתוכנית כעת

1. **להשתמש בגאומטריה הזולה ביותר שאכן ניתנת לזיהוי.** לשמר תושבת הרשומה מכנית במיקום ידוע, עם מפת CAD בעלת גרסה הכוללת את מיקום כל אתר ואת נורמל היחידה שלו הפונה החוצה. תושבת מעוקלת מחייבת נורמלים שונים באתרים שונים. גילוי ברשת מוצא זהויות אלקטרוניות; הוא אינו קובע היכן טלאי מחובר. בתצורת הבסיס אין מד תאוצה בכל אתר, סמן LED פעיל או חיישן קרבה, ולכן היא אינה יכולה להריץ את תהליך האיכון המלא של TUM. מקורות 44–47 מדגישים את חשיבות ההבדלים האלה בחומרה. המתקן הנשלף המוצע בעל שני חיישני IMU הוא התאמה לצורך בדיקת גאומטריה ידועה.

2. **להפריד בין שלושה תוצרי כיול שונים.** מטריצת הפעילות מתארת אילו מפרקים משפיעים על אילו מקטעים. אמידת ציר ורדיוס ניצב בודקת פרמטרים גאומטריים מוגבלים. מודל קינמטי קדמי מלא זקוק בנוסף למוסכמות מערכות צירים, היסטי חוליות, אפסי מפרקים ורישום מסגרת הבסיס. אף אחד מאלה אינו קובע מסה, אינרציה או חיכוך של חוליה. מקור 45 מפריד במפורש בין בדיקות מבניות פיזיות לאמידת פרמטרים בסימולציה; מקור 46 מדווח מאוחר יותר על ניסוי פיזי ב-UR5. אין לשלב את ראיותיהם לטענת דיוק שלא נמדדה עבור המתקן שלנו. ראו [התקציר הראשוני של מקור 45](https://portal.fis.tum.de/en/publications/open-loop-self-calibration-of-articulated-robots-with-artificial-/) ו-[התקציר הראשוני של מקור 46](https://portal.fis.tum.de/en/publications/automatic-robot-kinematic-modeling-with-a-modular-artificial-skin/).

3. **לאמץ שידור משולב ושמרני לפי שינוי, עם חלופה מחזורית תקפה.** לסרוק ב-100 Hz ללא תלות במצב השידור. לשדר תמונות מצב מוחלטות ומלאות ב-100 Hz בזמן מגע פעיל, מעברים ותקלות; לאפשר 50 Hz רק בתנאי חוסר פעילות שאומתו. מגע, שחרור, עומס יתר ושינויים אבחוניים גוברים על תחום אי־תגובה פשוט של משרעת. חותמות רכישה טריות ורענון של 20 ms בחוסר פעילות מאפשרים לסף הגיל הקיים של 40 ms להישאר משמעותי. יש לתכנן את קיבולת הרשת לכל צומת ב-100 Hz. הצמצום במספר תמונות המצב בחוסר פעילות הוא לכל היותר 50%, לפני אבחון נוסף. אי אפשר להעתיק לתכן זה תוצאות היסטוריות של חבילות או CPU; מקורות 50–52 משתמשים בפורמטי חבילות ובעומסי עבודה שונים. מקור 61 כבר דן בעדכוני חיות בעמודים 60–61, ולכן גם הוספת הודעת חיות היא ידע קודם.

4. **להפוך אובדן ושקט לנראים.** תמונות מצב מוחלטות מונעות הצטברות סחיפה בשחזור מתוספות חתומות, אך אינן משחזרות אירוע קצר שהתחיל והסתיים בפרק זמן של אובדן. יש להגדיר רצף אירועים, זהות הפעלה ואתחול, זמן רכישה, מסכת אתרים תקפים והתנהגות בחריגת זמן בתוך פורמט התעבורה בפועל. אישור CAN אינו אישור שהיישום במחשב המארח צרך את הדגימה. גם הודעה שהוכנסה בהצלחה לתור אינה בהכרח הודעה ששודרה. יש לקבוע את ייחוס הדיווח האחרון של המשדר רק לאחר השלמת שידור מוצלחת, ולא למחוק מידע ממתין על מעבר או תקלה רק משום שהתור היה מלא.

5. **אין לייחס לאפיק הבטחות של רשת אריג.** מקור 62 חוקר נתיבים חלופיים מרובי דילוגים. לקו ראשי משותף של CAN אין אותו מבנה ניתוב ואין נתיב חלופי העוקף קצר פיזי. הפרדת אזורים מגבילה את הנזק, ואילו אפיק עצמאי שני כרוך בחומרה ובחיווט נוספים. יש לתאר את בידוד התקלה בפועל ואת ההתאוששות שנמדדה לכל תקלה פיזית. [התקציר המקורי של מקור 62](https://mediatum.ub.tum.de/doc/1459302/136167106011.pdf) מדווח על התאוששות בתוך 50 ms ברשת שנבדקה בו; זו אינה דרישת CAN שכבר הושגה.

6. **לשמור על גאומטריית בקרה עדכנית גם כאשר ערכי המישוש קבועים.** מגע קבוע על חוליה נעה משנה את מיקומו במערכת צירי הבסיס, ולעיתים קרובות גם את תרומתו למומנט המפרקים. יש להשתמש בחוג בקרה המתוזמן בקביעות עם מצב מפרקים עדכני. אפשר לשמור אומדן מגע תקף או וקטור כוח ומומנט במערכת צירי החוליה אם הדבר מועיל, ואז למפות אותו מחדש בכל מחזור בקרה. קבלת אירוע צריכה לעדכן מאגר מצבים חסום, ולא לשגר ישירות פקודות מנועים אסינכרוניות. מקור 52 מצדיק חישוב מבוסס אירועים; הוא אינו מצדיק שמירת יעקוביאן במערכת העולם ללא הגבלת זמן.

7. **להשתמש בידע קודם לחידוד הטענה המסחרית.** עור רובוטי מודולרי, חישוב מבוזר, קידוד אירועים, כיול עצמי של העור ובקרה תגובתית של כל הגוף קדמו כולם לפרויקט זה. ההזדמנות הניתנת לבדיקה היא עור גפיים זול וניתן להחלפה, עם ייצור שניתן לשחזר, שגיאת קירוב כמותית, אמינות מתועדת ועלות מותקנת שניתנת לביקורת. המקורות עדיין אינם מדגימים תוצאות אלה עבור החומרים או התהליך שלנו.

## פרוטוקול כיול קונקרטי ומגבלותיו

להלן התאמה הנדסית, ולא שחזור מילולי של מקורות 45–47.

**מתקן ותיעוד.** להשתמש ב-IMU ייחוס בעל מיקום וכיוון הנקבעים במפתח מכני על בסיס הרובוט הנייח, וב-IMU נע עם מפתח מכני במיקום ידוע בתושבת. לתעד מספרים סידוריים של חיישני IMU, מקדמי כיול, סיבובים בין חיישן למתקן, תנוחת המתקן ביחס לחוליה, זמן דגימה ויישור הזמנים עם מצב המפרקים. IMU בעל 6 צירים מוסיף גירוסקופ שיכול לסייע באמידת ציר התנועה; החישה המהותית במאמרים המצוטטים היא תאוצה. מידע נוסף מהגירוסקופ אינו מבטל את הצורך בכיול כיוון ההתקנה וזרוע המנוף. אין להסיק כיוון אופקי גלובלי מהכבידה בלבד.

**בדיקת נייחות.** למדוד היסט ורעש כאשר שני המתקנים נייחים. ככל שניתן, לאסוף כמה כיוונים סטטיים כדי להבחין בין שגיאת היסט לשגיאת קנה מידה. להשוות את תנועת הייחוס לרמת הנייחות המותרת. לפסול ריצה אם הבסיס זז; התייחסות להומנואיד הולך כאל בסיס מקובע פוסלת ניסוי פשוט זה.

**עירור.** להשתמש בבקר רובוט קיים כדי להזיז מפרק נבחר אחד בתוך גבולות התנועה שכבר אומתו לו, ולחזור למיקומו ההתחלתי. לתעד זווית מקודד ונגזרות זוויתיות אמינות לצד דגימות החיישנים. לחזור בשני הכיוונים ובכמה תנוחות. אין להגדיל אוטומטית תאוצה או מהלך כדי להשיג אות טוב יותר. אם התנועה הזמינה אינה יכולה לעורר את הפרמטר במידה מספקת, יש לשמר את ערך ה-CAD ולדווח שתוצאת הכיול אינה ניתנת לזיהוי.

**המרת מערכות צירים.** מד תאוצה מודד כוח סגולי. במערכת צירים משותפת, a = R f + g, בהתאם למוסכמה ולכיול שלו. חיסור מדידות גולמיות בשלושה צירים מחיישנים בעלי כיוונים שונים הוא שגוי. חיסור הייחוס חייב להתחשב בסיבובים הנפרדים ובתאוצה הקווית האפשרית של כל נקודת התקנה.

**מטריצת פעילות.** להשוות אנרגיה התלויה בתנועה להתפלגות הנייחת שנמדדה ולרעידות בחוליות לא מחוברות. לאמוד איזה מקטע מגיב לאיזה מפרק, ולהצליב עם העץ הקינמטי הידוע. לפסול שורה בעלת פעילות לא חד־משמעית במקום להקצות אותה אוטומטית. מתקן נתיק יכול לבדוק מקטעים ברצף; הדבר שונה מתצפית בו־זמנית בכל תא.

**ציר ורדיוס.** עבור תנועה סיבובית קשיחה ומבודדת סביב ציר נייח:

    a = alpha × r + omega × (omega × r)

כאשר הציר, התאוצה הזוויתית והמהירות הזוויתית ידועים, יש להתאים את הרדיוס הניצב שניתן לזהות באמצעות כל הדגימות התקפות, ולדווח על שאריות ההתאמה. הרכיב של r לאורך ציר המפרק נמצא במרחב האפס של המדידה. לכן ריצה של מפרק יחיד אינה יכולה לשחזר היסט צירי זה. גם תנועה במהירות קבועה או כמעט קבועה מספקת עירור משיקי מועט. כיוון הנלמד מהכבידה בלבד משאיר את זווית הסבסוב בלתי נצפית. אלה מגבלות פיזיקליות של יכולת הזיהוי, ולא ליקויים שאופטימייזר מורכב יותר יכול לבטל.

**התניה ואימות על נתונים שהוחזקו מחוץ להתאמה.** לפרסם את הערכים הסינגולריים של הרגרסיה, רמת הרעש, התפלגות השאריות ואי־ודאות המוערכת באמצעות דגימה חוזרת או ריצות חוזרות. לבחור גבול קבלה לפי דיוק היישום הנדרש ומטרולוגיית המתקן לפני צפייה בתוצאות. להשוות לגאומטריית תושבת שנמדדה באופן עצמאי ולתנוחות שלא נכללו בהתאמה. שארית אימון קטנה אינה מספיקה. לשמר את מודל ה-CAD המקורי אם פרמטר מותאם נכשל בשער כלשהו.

**שחרור מפת גוף.** לשמור יחד את מהדורת המפה, טרנספורמציית הבסיס, מודל התושבת, מיקום ונורמל של כל אתר, גרסת הכיול וכיוון ההתקנה המותר. החלפת כיסוי עשויה לשנות את כיול הלחץ; החלפה או היפוך של תושבת עלולים לפסול את הכיול המרחבי. לדמות כוח ידוע הפונה פנימה בכמה אתרים, ולוודא שפקודת הנסיגה המתקבלת פונה החוצה וביחידות המיועדות.

## הכשרה קונקרטית של אירועים ורשת

יש להשתמש בהקלטות גולמיות ובהזרקת תקלות תעבורה סינתטית, כך שהמצב המחזורי והמצב המשולב יקבלו קלט זהה.

| מקרה | תצפית נדרשת |
|---|---|
| שקט כשהמנועים כבויים וכשהם פועלים | רעש באתרי החישה, קצב מעברים כוזבים, קצב המסגרות בפועל בחוסר פעילות וצריכת זרם |
| עליית לחץ איטית | אין היסט קבוע בגודל הסף; הדגימות המוחלטות נשמרות; אין מעקב אפס שאינו מתאים |
| מגע המוחזק במשך 60 s | מצב המגע נשאר פעיל; זחילה וסחיפה מדווחות בנפרד |
| נגיעה קצרה ושחרור | פולסים הניתנים לגילוי ברכישה מופיעים; יש לציין בבירור שפולסים קצרים ממרווח הסריקה של 10 ms עלולים להתפספס |
| כל האתרים וכל הצמתים פעילים | אין הסתמכות על דחיסה בחוסר פעילות; תורים חסומים וגיל רכישה מרבי |
| מסגרת אבודה ופרץ אבוד | פער ברצף נראה; המסגרת המוחלטת הבאה משחזרת את המצב הנוכחי; האירוע החולף שהוחמץ ממשיך להיות מסומן כלא ידוע |
| אתחול, גלישת חותמת זמן, מסגרת כפולה | נתונים מהפעלה ישנה או משוחזרים נדחים; נדרשים זהות ותזמון חדשים |
| סריקת החיישנים נעצרת אך CAN ממשיך לפעול | גיל הרכישה נכשל גם אם חותמות זמן הקבלה ממשיכות להשתנות |
| ממשק המשתמש או רשם הנתונים נכשל | הרכישה ותקפות הבקרה אינן מושפעות; התצוגה רשאית להשמיט מסגרות באופן עצמאי |
| נתק בענף, נתק בקו הראשי, קצר באפיק, איפוס שער התקשורת | היקף תקלה ומעבר למצב מיושן נמדדים לכל מקרה; ללא ניתוב חלופי דמיוני |
| מגע קבוע עם שינוי תנוחת המפרק | הבקרה הגאומטרית המחושבת מחדש תואמת את הייחוס המחזורי |

יש לגזור את ספי השינוי מהרעש הנמדד, מהכימות ומהשינוי המשמעותי הקטן ביותר הרצוי, ואז להקפיא אותם ולשייך להם גרסה לריצת ההכשרה. אין לאפשר לדיכוי רעש מסתגל להגדיל בשקט את הסף בזמן מגע אמיתי. יש להשתמש בהיסטרזיס ובמעברי מצב מפורשים למגע ולשחרור. תקציב ההשהיה חייב לכלול מופע סריקה, סינון, תורים, בוררות באפיק, מעבר בשער התקשורת ותזמון הבקרה. סריקה ב-100 Hz לבדה מאפשרת השהיית מופע של עד 10 ms לפני סינון או תקשורת.

יש לדווח גם על חציון ההשהיה וגם על זנב ההתפלגות וההשהיה הגרועה ביותר שנצפתה, בצירוף משך הבדיקה ומספר הדגימות. הערך הגרוע ביותר שנצפה אינו חסם קשיח מתמטי; נדרשים גם ניתוחי תורים ותזמון לפני טענה לתזמון דטרמיניסטי. סף התקפות של 40 ms בתוכנית זו הוא פרמטר תכן יישומי, ולא הבטחה שהמחקרים המצוטטים הוכיחו.

## רישום פרטני לכל מקור

### [20] A real-time distributed architecture for large-scale tactile sensing

E. Baglini, S. Youssefi, F. Mastrogiovanni and G. Cannata; 2014. [מקור](https://ewh.ieee.org/soc/ras/conf/financiallycosponsored/IROS/2014/www.iros2014.org/images/download/IROS2014-Full-Conference-Digest.pdf); DOI [10.1109/IROS.2014.6942778](https://doi.org/10.1109/IROS.2014.6942778).

**גישה: ABSTRACT_ONLY.** תקציר הכנס הרשמי IROS 2014, עמוד 134, ותקציר שהעלה מחבר; המאמר המקורי בן שבעת העמודים לא הושג.

**ממצא.** מתאר רשת מבוזרת מבוססת EtherCAT המחברת צומתי חישוב המשויכים לטלאי עור, ומעריך את ארכיטקטורת הזמן האמיתי.

**מגבלה.** החומר הנגיש אינו מבסס את עלות החומרה המדויקת, התפלגות מועדי הביצוע שנמדדה או יכולת בידוד התקלות הזמינה לפרויקט זה. תוצאות EtherCAT אינן יכולות להכשיר מימוש CAN FD.

**פעולה בתוכנית.** לאמץ בהתאמה את ההפרדה בין רכישה מקומית, תעבורה ועיבוד במחשב המארח. להשאיר CAN FD בתצורת הבסיס הזולה; להכשיר עמידה בזמנים תחת תעבורה מרבית לפני הגדלת מספר הצמתים.

**אימות.** לתעד בנפרד חותמות זמן של סיום סריקת ADC, שידור CAN, קבלה בשער התקשורת והרצת הצרכן. לבדוק כל אזור בתעבורה פעילה מרבית, תוך רישום, הצגת נתונים והזרקת איפוסי צמתים.

**ידע קודם.** עיבוד מבוזר בטלאים ותקשורת מישוש בזמן אמת הם ידע קודם מבוסס.

מיקומים נוספים: [1](https://www.researchgate.net/publication/271072617_A_real-time_distributed_architecture_for_large-scale_tactile_sensing). מצב הגישה אליהם מתואר לעיל; קישור אינו מעיד על סקירת טקסט מלא.

### [21] A real-time data acquisition and processing framework for large-scale robot skin

S. Youssefi, S. Denei, F. Mastrogiovanni and G. Cannata; 2015. [מקור](https://www.sciencedirect.com/science/article/pii/S0921889015000172); DOI [10.1016/j.robot.2015.01.009](https://doi.org/10.1016/j.robot.2015.01.009).

**גישה: PARTIAL_TEXT.** מבוא מאונדקס אצל המוציא לאור וסעיפי ארכיטקטורה ומימוש נבחרים, כולל הפשטת Skinware ופלטפורמת הבדיקה ההיסטורית. התוצאות והאיורים המלאים לא נבדקו.

**ממצא.** Skinware מפרידה בין יישומי מישוש לחיישנים ולטכנולוגיות רשת מסוימים, ומתייחסת ללכידות הנתונים, לעקביות ולתזמון כשיקולים ארכיטקטוניים. הסביבה המדווחת כוללת RTAI ופלטפורמת Linux ישנה יותר.

**מגבלה.** תוצאות מפלטפורמת תוכנה היסטורית אינן מבססות עמידה עכשווית במועדי ביצוע ב-ROS2/Linux או תאימות ישירה ל-STM32/CAN.

**פעולה בתוכנית.** לאמץ תמונות מצב מלאות של סריקה, שאינן ניתנות לשינוי, עם מטא־נתונים בעלי גרסה ותורי יצרן־צרכן חסומים. לשמור על עצמאות צרכני הזמן האמיתי מהמחשה, מקלט ופלט לקבצים ומגילוי התקנים.

**אימות.** להקפיא או להפיל את ממשק המשתמש ורשם הנתונים בזמן רכישה. לוודא שצרכן הבקרה רואה תמונת מצב עקבית וטרייה או מצב מפורש לא תקף או מיושן, ולעולם לא ערבוב בין סריקות.

**ידע קודם.** הפשטת חיישנים משותפת ותוכנת תיווך לעור בזמן אמת הן תשתיות מבוססות; התרומה צריכה להיות איכות שילוב ועלות שניתן לשחזר.

### [22] Asynchronous, event-driven readout of POSFET devices for tactile sensing

S. Caviglia, M. Valle and C. Bartolozzi; 2014. [מקור](https://doi.org/10.1109/ISCAS.2014.6865717); DOI [10.1109/ISCAS.2014.6865717](https://doi.org/10.1109/ISCAS.2014.6865717).

**גישה: CITATION_ONLY.** זהות המאמר ועמודי הכנס 2648–2651 נבדקו מול תוכן העניינים של מאמרי ISCAS; התקציר וגוף המאמר המקוריים לא הושגו. ה-DOI אושר גם ברשימות מקורות מדעיות מאוחרות יותר.

**ממצא.** הכותרת מבססת קיומו של קו עבודה מוקדם על POSFET וקריאה מבוססת אירועים. אין הסתמכות כאן על טענת ביצוע ברמת התקן או על טענת מעגל ממאמר זה.

**מגבלה.** לא היו זמינים לביקורת תרשים מעגל מקורי, תהליך ייצור, הספק, רעש או רוחב פס; אין להניח שמעגל POSFET שקול לסרט ההתנגדותי שנבחר.

**פעולה בתוכנית.** אין להעתיק מעגל POSFET או לתמחרו מתוך ציטוט זה. תצורת הבסיס ממשיכה להשתמש ב-ADC רגיל ובגילוי שינויים בקושחה; יש לתאר זאת כדיווח אירועים מדגימות.

**אימות.** לתעד את זמן הסריקה בפועל ואת ההשהיה עד הדגימה הראשונה. אין לכנות את תכן ה-MCU מתמר אסינכרוני רציף.

**ידע קודם.** הכותרת מספיקה כדי לזהות קריאת מישוש אסינכרונית כעבודה קיימת; השוואת ביצועים מחייבת את המאמר המקורי.

מיקומים נוספים: [1](https://www.proceedings.com/content/022/022887webtoc.pdf). מצב הגישה אליהם מתואר לעיל; קישור אינו מעיד על סקירת טקסט מלא.

### [23] Event-driven encoding of off-the-shelf tactile sensors for compression and latency optimisation for robotic skin

C. Bartolozzi et al.; 2017. [מקור](https://www.researchgate.net/publication/321816551_Event-driven_encoding_of_off-the-shelf_tactile_sensors_for_compression_and_latency_optimisation_for_robotic_skin); DOI [10.1109/IROS.2017.8202153](https://doi.org/10.1109/IROS.2017.8202153).

**גישה: PARTIAL_TEXT.** קטעים מכתב יד שהעלה מחבר: ארכיטקטורה, השוואת קידודים ומסקנות. נבדקה גם רשימת הפרסומים הראשונית של מעבדת IIT. המאמר המלא לא הורד באופן עצמאי.

**ממצא.** בוחן קידודי אירועים של חיישני מישוש קיימים, כולל נתונים מוקלטים מקצות האצבעות של iCub, ומתאר מסלול רכישה מבוסס FPGA עם מיעון אירועים היררכי. המרת החיישן והעברת האירועים הן שלבים נפרדים.

**מגבלה.** מערכי נתונים מקצות אצבעות, רכישת FPGA וקישורי AS-AER אינם מדגימים ביצועי סרט התנגדותי על גפה שלמה. יש להבחין בין סימולציות קידוד למאפייני החומרה.

**פעולה בתוכנית.** לאמץ מזהים מפורשים לגוף, לטלאי ולאתר, חותמות זמן רכישה והשוואה ניתנת לשחזור בין נתונים גולמיים לאירועים. לשמר בדיקות תקינות CAN ותמונות מצב מוחלטות מחזוריות; לא לכלול רכזת FPGA בתצורת הבסיס בעלת העלות המזערית.

**אימות.** להעביר אותן הקלטות גולמיות דרך מקודד מחזורי ומקודד משולב. לדווח על החמצת תחילת אירועים, שגיאת שחזור מוחלטת, מספר הבתים על הקו וגיל מקצה לקצה, כולל תקורת החבילות.

**ידע קודם.** המרת חיישני מישוש מהמדף לאירועים, היררכיות כתובות ודחיסת אירועים הן ידע קודם.

מיקומים נוספים: [1](https://edpr.iit.it/neuromorphic-icub-infrastructure). מצב הגישה אליהם מתואר לעיל; קישור אינו מעיד על סקירת טקסט מלא.

### [24] The event-driven software library for YARP—With algorithms and iCub applications

A. Glover, V. Vasco, M. Iacono and C. Bartolozzi; 2018. [מקור](https://www.frontiersin.org/journals/robotics-and-ai/articles/10.3389/frobt.2017.00073/full); DOI [10.3389/frobt.2017.00073](https://doi.org/10.3389/frobt.2017.00073).

**גישה: PARTIAL_TEXT.** סעיפים 3.2–3.3 המאונדקסים אצל המוציא לאור, על ייצוג אירועים, קוראים ותורים ועיבוד; גוף המאמר המלא לא נשלף.

**ממצא.** מספק ייצוגי חבילות אירועים וטיפול בתוכנה ב-YARP, תוך הפרדת העיבוד מהקבלה. הדיון מכיר בשינויים גדולים בעומס תעבורת האירועים ובחישוב.

**מגבלה.** הדוגמאות ההמחשתיות לקצבים גבוהים עוסקות בראייה. ספריית אירועים גמישה אינה מבססת מועד ביצוע קשיח לבקרת עור ואינה מצדיקה דילוג שקט על עדכוני בקרה נדרשים.

**פעולה בתוכנית.** לאמץ בהתאמה הקלטה ושחזור, רשומות אירועים בעלות טיפוסים ותהליכוני קבלה ועיבוד נפרדים. להשתמש בתורים חסומים עם מונים ועם מצב עומס יתר מפורש; להפריד בין השמטת מסגרות בממשק הגרפי לתקפות המישוש.

**אימות.** ליצור פרץ בו־זמני מכל האתרים, להשהות כל צרכן ואז להפעילו שוב. לאמת זיכרון חסום, רצף רשומות מונוטוני וטיפול דטרמיניסטי בנתונים מיושנים.

**ידע קודם.** תוכנת תיווך לאירועים ושחזור הם תשתית מבוססת; אין לשווקם כמערכת עצבים חושית חדשה.

### [41] Humanoid multimodal tactile-sensing modules

P. Mittendorfer and G. Cheng; 2011. [מקור](https://portal.fis.tum.de/en/publications/humanoid-multimodal-tactile-sensing-modules/); DOI [10.1109/TRO.2011.2106330](https://doi.org/10.1109/TRO.2011.2106330).

**גישה: ABSTRACT_ONLY.** רשומה ביבליוגרפית ותקציר באוניברסיטה; השיטות המלאות, המעגל וטבלאות האפיון לא הושגו.

**ממצא.** מתאר עור רב־חושי מודולרי מרכיבי מדף, עם המרה לדיגיטל ועיבוד מקומיים וחיבור לרשת, לרבות חישת טמפרטורה, תאוצה וקרבה.

**מגבלה.** אין לערבב דור חומרה מוקדם זה עם הגרסה המאוחרת הכוללת כיסוי חישת כוח. יכולותיו הרב־חושיות אינן קיימות בטלאי המשלב לחץ ו-NTC.

**פעולה בתוכנית.** לאמץ עיבוד מקומי ומודולים הניתנים להחלפה. לפרסם טבלת אופני חישה מפורשת: מגע ניצב בקירוב ושתי נקודות טמפרטורה בבסיס; ללא גזירה, קרבה או איכון עצמי אינרציאלי.

**אימות.** לכל אופן חישה המפורסם במוצר, להדגים גירוי חוזר, כיול, אי־ודאות ותגובה לתקלה באמצעות הטלאי האמיתי המיועד לייצור.

**ידע קודם.** תאים מודולריים רב־חושיים ועיבוד מקומי התקיימו כבר ב-2011.

### [42] Integrating discrete force cells into multi-modal artificial skin

P. Mittendorfer and G. Cheng; 2012. [מקור](https://mediatum.ub.tum.de/doc/1116556/214040.pdf); DOI [10.1109/HUMANOIDS.2012.6651619](https://doi.org/10.1109/HUMANOIDS.2012.6651619).

**גישה: PARTIAL_TEXT.** תקציר מהעמוד הראשון, מבנה תא הכוח והמבוא, המאונדקסים במאגר. גרפי הכוח וההעתק המלאים ותוצאות העמידות לא נבדקו.

**ממצא.** משתמש במבני קפיץ צרובים מ-CuBe2 עם מדידה קיבולית, בשלושה תאי כוח בכל מודול עור וברעיונות להרכבה אוטומטית. המאמר מדווח על רכישה ב-2.5 kHz המסוננת ל-250 Hz ועל יחס אות לרעש גדול מ-50 dB.

**מגבלה.** נתונים אלה שייכים למתמר קיבולי בעל קפיץ מתכתי, ולא לאתר חישה התנגדותי מודפס. העטיפה והעומס המקדים המכני משפיעים על הביצועים. עיבוד CuBe אינו מוצע למסלול הסרט במעבדה הביתית.

**פעולה בתוכנית.** לאמץ מעצורים מכניים לעומס יתר, עומס מקדים מבוקר ורשומת כיול ספציפית לכיסוי. אין להעתיק את נתוני הביצועים או את רשימת החומרים של תא הכוח אל התכן ההתנגדותי.

**אימות.** לכייל כל מכלול גמור של כיסוי, חיישן ותושבת, לחזור לאחר התקנה מחדש ולאחר עומס יתר, ולמדוד היסטרזיס בהעמסה ובפריקה וסחיפת אפס.

**ידע קודם.** תאי כוח רב־חושיים מוגנים ומכניקה המכוונת להרכבה הם ידע קודם.

### [43] Towards autonomous robotic skin spatial calibration: A framework based on vision and self-touch

A. Albini, S. Denei and G. Cannata; 2017. [מקור](https://doi.org/10.1109/IROS.2017.8202151); DOI [10.1109/IROS.2017.8202151](https://doi.org/10.1109/IROS.2017.8202151).

**גישה: CITATION_ONLY.** רשימת פרסומים אוניברסיטאית ראשונית מאמתת את זהות המאמר; תקציר משני מתאר RGB-D ומגע עצמי, אך התקציר וגוף המאמר המקוריים לא הושגו. התוצאה המשנית <2 mm אינה מאומצת במכוון כראיה מאומתת.

**ממצא.** זהו ידע קודם רלוונטי לכיול מרחבי באמצעות ראייה ומגעים שהרובוט יוצר; בתכן לא נעשה שימוש באלגוריתם מקורי מדויק או בטענת ביצועים מדויקת.

**מגבלה.** יש לבחון יכולת הגעה, כיול מצלמה, הסתרה ומרכזי מגע הנובעים מפיזור כוח לפני שחזור. המקור הזמין כאן אינו מספיק להבטחת הדיוק שלו.

**פעולה בתוכנית.** לשמר תושבות CAD הרשומות במיקום ידוע כתצורת הבסיס. להשתמש בגישוש חיצוני באתרים מסומנים כבדיקת ייצור מדידה; לתאר כל מימוש עתידי של ראייה ומגע עצמי כשחזור נפרד.

**אימות.** לגשש באופן עיוור במרכזי אתרים שהוגדרו מראש בכמה תנוחות, ולדווח על שגיאות מיקום ונורמל ביחס לגאומטריית המתקן, ולא רק על שגיאת ההתאמה.

**ידע קודם.** רישום מרחבי בסיוע ראייה ומגע עצמי אינו טענה חדשה של פרויקט זה.

מיקומים נוספים: [1](https://eng.ox.ac.uk/publications/?personId=23467), [2](https://eurekamag.com/research/100/009/100009247.php). מצב הגישה אליהם מתואר לעיל; קישור אינו מעיד על סקירת טקסט מלא.

### [44] 3D surface reconstruction for robotic body parts with artificial skins

P. Mittendorfer and G. Cheng; 2012. [מקור](https://mediatum.ub.tum.de/doc/1116558/621068.pdf); DOI [10.1109/IROS.2012.6385559](https://doi.org/10.1109/IROS.2012.6385559).

**גישה: PARTIAL_TEXT.** תקציר ומבוא מהעמוד הראשון במאגר ותקציר אוניברסיטאי. הסקירה מ-2019 שסופקה, סעיף II-C, מוסיפה הסבר משני על השחזור.

**ממצא.** השחזור משתמש בגאומטריה המבנית הידועה של העור המודולרי ובחישה הקשורה לתנועה. השיטה עוסקת במודולים מעוצבים ומחוברים, ולא ביריעה נמתחת שרירותית ללא חיישני המכשור הדרושים.

**מגבלה.** רשימת כתובות משותפת ב-CAN אינה מגלה סמיכות פיזית; ערכי מגע התנגדותיים אינם מספקים וקטורי כבידה. מתיחה והחלקה מפרות את הנחת הגאומטריה הקבועה של המודול.

**פעולה בתוכנית.** לאמץ מפת גוף בעלת גרסה, עם מיקום ונורמל יחידה לכל אתר הנגזרים מהתושבת הקשיחה. לקשור את מהדורת המפה לתושבת המותקנת ולדחות מהדורות לא ידועות.

**אימות.** לבדוק נורמלים באתרים שבקצוות מעוקלים וגם במרכזי הטלאים. להתקין מחדש ולגשש בכמה מיקומים; לחסום בקרה אם אי אפשר לרשום את התושבת בתוך הסבולת המוצהרת.

**ידע קודם.** שחזור אוטומטי של פני שטח מעור הכולל מכשור הוא עבודה קיימת, אך רשימת החומרים של תצורת הבסיס אינה מממשת אותו.

מיקומים נוספים: [1](https://portal.fis.tum.de/en/publications/3d-surface-reconstruction-for-robotic-body-parts-with-artificial-/). מצב הגישה אליהם מתואר לעיל; קישור אינו מעיד על סקירת טקסט מלא.

### [45] Open-loop self-calibration of articulated robots with artificial skins

P. Mittendorfer and G. Cheng; 2012. [מקור](https://mediatum.ub.tum.de/doc/1116557/877587.pdf); DOI [10.1109/ICRA.2012.6224881](https://doi.org/10.1109/ICRA.2012.6224881).

**גישה: PARTIAL_TEXT.** עמודים 1–2 המאונדקסים במאגר, כולל אלגוריתמים 1–2, דרישות והיקף הניסויים והסימולציה; התקציר האוניברסיטאי נקרא ישירות. התוצאות המספריות המלאות לא הושגו.

**ממצא.** משתמש במדי תאוצה תלת־ציריים ובעירור מפרקים מבודד כדי לזהות פעילות מקטעים ומפרקים ולבנות מודלים קינמטיים. נדרשים מקטעים קשיחים הכוללים חיישנים וייחוס סטטי. תוצאות פיזיות ב-KUKA מבססות חקירה מבנית; אמידת פרמטרים מודגמת בנוסף בסימולציה.

**מגבלה.** העבודה אינה מאמתת גאומטריה אוטונומית מתוך עור לחץ בלבד. עירור חלש, תנועת הייחוס ודרגות חופש שלא נצפו עלולים ליצור זיהוי לא חד־משמעי. חסמי השגיאה המספריים המלאים לא נבדקו.

**פעולה בתוכנית.** להתאים אימות של מטריצת הפעילות באמצעות מתקן IMU רב־פעמי הכולל ייחוס נייח וחיישן בהמשך השרשרת, ועם מצבי מפרקים ידועים. לשמר גאומטריית CAD; לתאר את המתקן כהתאמה, ולא כשחזור מלא של איכון עור אוטונומי.

**אימות.** להשתמש במפרק אחד בכל פעם; לחזור בתנועה הפוכה ובתנוחות שלא השתתפו בהתאמה. להשוות את ההשפעה שזוהתה לעץ הקינמטי של הרובוט, ולדחות תוצאות עם יחס אות לרעש נמוך או תוצאות לא עקביות.

**ידע קודם.** מטריצות פעילות, עירור מנועים וכיול עצמי מבני מבוסס מדי תאוצה הם ידע קודם.

מיקומים נוספים: [1](https://portal.fis.tum.de/en/publications/open-loop-self-calibration-of-articulated-robots-with-artificial-/). מצב הגישה אליהם מתואר לעיל; קישור אינו מעיד על סקירת טקסט מלא.

### [46] Automatic robot kinematic modeling with a modular artificial skin

P. Mittendorfer, E. Dean and G. Cheng; 2014. [מקור](https://portal.fis.tum.de/en/publications/automatic-robot-kinematic-modeling-with-a-modular-artificial-skin/); DOI [10.1109/HUMANOIDS.2014.7041447](https://doi.org/10.1109/HUMANOIDS.2014.7041447).

**גישה: ABSTRACT_ONLY.** התקציר האוניברסיטאי והרשומה הביבליוגרפית נקראו ישירות. המאמר המקורי בן ששת העמודים לא היה זמין. סקירת 2019 שסופקה, סעיף II-D, היא ראיה משנית לרצף ציר, SVD ורדיוס.

**ממצא.** משתמש במדי תאוצה תלת־ציריים בכל תא, בתנועות בחוג פתוח ובניתוח נקודות מעגל כדי לבנות מודל קינמטי קדמי. התקציר מדווח על ניסוי פיזי ב-UR5 על פלטפורמה אינרציאלית בעלת שתי זרועות.

**מגבלה.** לא היו נגישים שגיאות מספריות מקוריות, בדיקות התניה או פרמטרי מימוש. תנועה סיבובית יחידה מזהה רדיוס ניצב, ולא את הרכיב הצירי של היסט החיישן; גאומטריה מלאה מחייבת אילוצים נוספים.

**פעולה בתוכנית.** להשתמש באמידת ציר ורדיוס ניצב רק כבדיקת הצלבה לא מקוונת מול CAD. אין לטעון לשחזור כל היסט DH, מסה, אינרציה או חיכוך מתוך ניסוי עם שני חיישני IMU.

**אימות.** להתאים תאוצה לתאוצה זוויתית ידועה, לשמור רווחי סמך ושאריות, ולאמת מול רדיוסים שנמדדו באופן עצמאי ותנוחות שלא נראו בהתאמה. לדחות התאמות בעלות חוסר בדרגה.

**ידע קודם.** מידול קינמטי אוטומטי באמצעות תאוצת העור קדם לפרויקט זה. מתקן זול ורב־פעמי עשוי להוות בידול במימוש, בכפוף למדידה.

הערה ביבליוגרפית: קובץ מאמרי Humanoids 2014; הרשומה האוניברסיטאית מציינת פרסום ב-12 בפברואר 2015. שני התאריכים מתייחסים לאותו מאמר.

### [47] 3D spatial self-organization of a modular artificial skin

P. Mittendorfer, E. Dean and G. Cheng; 2014. [מקור](https://portal.fis.tum.de/en/publications/3d-spatial-self-organization-of-a-modular-artificial-skin); DOI [10.1109/IROS.2014.6943120](https://doi.org/10.1109/IROS.2014.6943120).

**גישה: ABSTRACT_ONLY.** תקציר ראשוני באוניברסיטה וזיהוי המאמר. המשוואות המלאות והניסויים המספריים לא הושגו.

**ממצא.** משלב גאומטריה של טלאי עור עם סמן LED חזותי פעיל ומצלמה חד־עינית מכוילת לצורך רישום מרחבי, גם בתנאי נראות חלקית.

**מגבלה.** הארגון העצמי כאן אינו נטול מצלמה לחלוטין. לסרט לחץ בלבד חסרים המידע האינרציאלי בכל תא והסמן הפעיל של המערכת שנחקרה.

**פעולה בתוכנית.** לשמר טרנספורמציית בסיס ידנית או מ-CAD המוצהרת במפורש. אם משתמשים ברישום מצלמה במתקן, יש לכלול ברשומת הכיול את הפרמטרים הפנימיים של המצלמה, גאומטריית הסמן ואיכות התצפיות.

**אימות.** לבצע רישום מכמה זוויות צפייה עצמאיות; לגשש בנקודות שלא נכללו בהתאמת הטרנספורמציה ולאמת את כיוונה ואת היחידות.

**ידע קודם.** רישום עור בסיוע מצלמה הוא ידע קודם; פשטות תצורת הבסיס היא בחירת עלות ותכן, ולא תגלית.

### [48] Touch, in Principles of Neural Science, fifth edition, chapter23

E. P. Gardner and K. O. Johnson; 2013. [מקור](https://accessmedicine.mhmedical.com/book.aspx?bookID=1049).

**גישה: CITATION_ONLY.** הביבליוגרפיה מ-2019 שסיפק המשתמש מזהה את פרק 23, עמודים 498–529. הפרק המלא לא הושג; כתובת הספר אצל המוציא לאור היא אמצעי איתור, ולא טענה לגישה לפרק.

**ממצא.** רקע ביולוגי המצוטט בסקירת 2019. אין לחלץ כאן מספר קולטנים, תחום תדרים או טענה ביולוגית כמותית ללא הפרק המקורי.

**מגבלה.** אנלוגיה ביולוגית אינה יכולה לבסס רגישות, בטיחות, עמידות או דרישות חיווט של רובוט.

**פעולה בתוכנית.** לתאר את התכן כמקבל השראה תפקודית מחישה מבוזרת. לשמר מצב מגע מתמשך ומדידות טמפרטורה; להימנע מטענה לשחזור מלוא מערכת הקולטנים של עור האדם.

**אימות.** להחזיק מגע במשך 60 s לפחות ולוודא שאינו נעלם רק משום שהשינוי באות נעשה קטן. למדוד סחיפה בנפרד ממגע מתמשך תקף.

**ידע קודם.** חישה מבוזרת בהשראת העור היא רעיון מבוסס זה מכבר.

### [49] Touch is a team effort: Interplay of submodalities in cutaneous sensibility

H. P. Saal and S. J. Bensmaia; 2014. [מקור](https://pubmed.ncbi.nlm.nih.gov/25257208/); DOI [10.1016/j.tins.2014.08.012](https://doi.org/10.1016/j.tins.2014.08.012).

**גישה: ABSTRACT_ONLY.** תקציר המאמר המקורי המאונדקס ב-PubMed; גוף הסקירה המלא לא הושג.

**ממצא.** הסקירה מדגישה את התרומות המשותפות של תתי־סוגים של מסלולי תחושה עולים לתחושת המגע הטבעית, ולא התאמה פשוטה של קולטן אחד לתחושה אחת.

**מגבלה.** אין בה הוכחה ששתי שכבות הנדסיות או חיישני חום דלילים משחזרים את יכולות עור האדם.

**פעולה בתוכנית.** לשמור על טענות ספציפיות לכל אופן חישה. לאחד מגע וטמפרטורה בשכבת היישום בלי לרמוז שקריאות NTC דלילות מספקות תמונה תרמית מלאה, או שלחץ ניצב מודד גזירה.

**אימות.** לבדוק סחיפה תרמית בזמן מגע וחום ללא מגע. לדווח בנפרד על הדגימה המרחבית, התגובה בזמן והרגישות הצולבת של כל אופן חישה.

**ידע קודם.** שילוב ביולוגי רב־חושי הוא מניע לתכן, ולא טענת המצאה עבור למינציית לחץ וטמפרטורה.

### [50] Event-based signaling for reducing required data rates and processing power in a large-scale artificial robotic skin

F. Bergner, P. Mittendorfer, E. Dean-Leon and G. Cheng; 2015. [מקור](https://mediatum.ub.tum.de/doc/1281179/868479268848.pdf).

**גישה: PARTIAL_TEXT.** עמוד תוצאות 6 המאונדקס במאגר, איורים 7–8, טבלה ומסקנה, וכן תקציר רשמי של הכנס. מלוא השיטות לא נשלפו.

**ממצא.** מחקר על UR5 בעל 260 תאים מדווח שתעבורת הנתונים שנותרה היא 16.45% במנוחה ו-47.69% תחת גירוי כבד ללא חותמות זמן; עם חותמות זמן, 21.38% ו-62%. חבילות קומפקטיות של שלושה אירועים מתאימות לאופני החישה המתואמים שנחקרו.

**מגבלה.** אלה שיעורי התעבורה שנותרה, ולא אחוזי ההפחתה. פורמט החבילה, חותמות הזמן ועומס העבודה משפיעים. מסגרות CAN מוחלטות של 64 בתים בתצורת הבסיס לא יקבלו אוטומטית הפחתות אלה.

**פעולה בתוכנית.** להשתמש בכך כתכן למבחן ייחוס, ולא כאחוז מובטח. להגדיר הפחתה מרבית של 50% במספר תמונות המצב בחוסר פעילות, עבור 100 Hz בפעילות ו-50 Hz בחוסר פעילות, עם חיסכון כולל קטן יותר אחרי תקורה נוספת.

**אימות.** להריץ עומסים של שקט, תנועת מנועים, ליטוף, פגיעה ומגעים בו־זמניים. לספור את מלוא התעבורה על הקו ואת זמן המעבד, ולא רק בתי חיישנים שימושיים.

**ידע קודם.** שידור מקומי לפי שינוי בעור רובוטי רחב היקף ומבחני דחיסה הם ידע קודם.

מיקומים נוספים: [1](https://iros2015.informatik.uni-hamburg.de/docs/IROS_Digest_WWW.pdf). מצב הגישה אליהם מתואר לעיל; קישור אינו מעיד על סקירת טקסט מלא.

### [51] Event-based signaling for large-scale artificial robotic skin—Realization and performance evaluation

F. Bergner, E. Dean-Leon and G. Cheng; 2016. [מקור](https://mediatum.ub.tum.de/doc/1335609/document.pdf); DOI [10.1109/IROS.2016.7759722](https://doi.org/10.1109/IROS.2016.7759722).

**גישה: PARTIAL_TEXT.** מבוא וארכיטקטורה המאונדקסים במאגר ותקציר ראשוני באוניברסיטה; שיטות הניסוי המלאות לא היו נגישות.

**ממצא.** משתמש בשני טלאים בעלי 260 תאים עם עיבוד מקומי. התקציר מדווח על הפחתה של 48.2% בחבילות ושל 17.79% בעומס CPU בבקרה תגובתית; אקסטרפולציה למקרה גרוע של 5000 תאים מניבה 21.2% ו-17.46%, בהתאמה.

**מגבלה.** תוצאת 5000 התאים היא אקסטרפולציה, ולא אימות פיזי של 5000 תאים. מדדי תעבורה, עומס מעבד וקצב בקרה הם גדלים שונים.

**פעולה בתוכנית.** לשמור באותה קושחה מצב אבחון מחזורי ומצב אירועים משולב, לצורך השוואה מבוקרת. לפרסם בנפרד את מספרי הטלאים שנמדדו ואת אלה שחושבו באקסטרפולציה.

**אימות.** לשחזר אותן הקלטות בשני המצבים עם אותו קוד במחשב המארח. למדוד עומס CPU, השהיה, דגימות שהושמטו ושגיאת שחזור ב-1, ב-8 ובכמה אזורים עצמאיים.

**ידע קודם.** פעולת עור הניתנת למעבר בין מצב מחזורי למצב אירועים והשוואות הביצועים ביניהם כבר הודגמו.

מיקומים נוספים: [1](https://portal.fis.tum.de/en/publications/event-based-signaling-for-large-scale-artificial-robotic-skin-rea/). מצב הגישה אליהם מתואר לעיל; קישור אינו מעיד על סקירת טקסט מלא.

### [52] Efficient event-driven reactive control for large scale robot skin

F. Bergner, E. Dean-Leon and G. Cheng; 2017. [מקור](https://mediatum.ub.tum.de/doc/1366849/document.pdf); DOI [10.1109/ICRA.2017.7989051](https://doi.org/10.1109/ICRA.2017.7989051).

**גישה: PARTIAL_TEXT.** תקציר ומבוא מהעמוד הראשון במאגר. הוכחות הבקרה המפורטות וגרפי הניסויים המלאים לא היו נגישים.

**ממצא.** מעריך בקרה תגובתית מבוססת אירועים ב-TOMM עם שני טלאים בעלי 253 תאים. התקציר מדווח על ירידה בעומס המעבד של הבקר בשיעור 78% בחוסר פעילות ו-66% בזמן מגע, ביחס לייחוס הסינכרוני שנבדק.

**מגבלה.** אין להשתמש בחיסכון בבקר כתחליף לחיסכון ברשת או במנהל ההתקן. לחץ שאינו משתנה אינו מעיד על מומנט מפרק שאינו משתנה כאשר תצורת הרובוט משתנה.

**פעולה בתוכנית.** לשמור מידע מגע או תרומות כוח ומומנט במערכת צירי החוליה, אך לחשב מחדש את המיפוי שלהן עם מצבי מפרקים עדכניים במחזור בקרה חסום בזמן. להפריד בין קבלת אירועים לביצוע פקודות.

**אימות.** להחזיק מגע אחד קבוע תוך שינוי תנוחת מפרק בסימולציה. להשוות מומנטי מפרקים במצב אירועים לייחוס מחזורי המחושב מחדש במלואו, כולל מסגרות מיושנות או חסרות.

**ידע קודם.** בקרה תגובתית מבוססת אירועים היא ידע קודם; ערך הפרויקט חייב להיות בעלות נגישה ובשילוב שאומתו.

### [53] A128×128120dB15µs latency asynchronous temporal contrast vision sensor

P. Lichtsteiner, C. Posch and T. Delbruck; 2008. [מקור](https://doi.org/10.1109/JSSC.2007.914337); DOI [10.1109/JSSC.2007.914337](https://doi.org/10.1109/JSSC.2007.914337).

**גישה: PARTIAL_TEXT.** העתק של המאמר המקורי בכתב העת, עמוד סיום 575 ותקציר מאונדקס. ההעתק נמצא במאגר משני; המאמר המלא לא נשלף.

**ממצא.** חיישן תמונה ייעודי ואסינכרוני לשינויי ניגודיות מדווח על תחום דינמי של 120 dB, השהיה של 15 µs והספק של 23 mW. הדיון מצביע על מגבלות רוחב פס של אירועים ועל היעדר תגובת DC ישירה.

**מגבלה.** אלה תוצאות אופטיות בשבב ייעודי ובתנאי המאמר. הן אינן מבססות זמן תגובה, צריכת אנרגיה או רזולוציה של מערך מישוש נסרק.

**פעולה בתוכנית.** להשתמש רק כהבחנה היסטורית בין התמרה אסינכרונית אמיתית לבין שידור לפי שינוי הנדגם ב-100 Hz. לשמר דגימות מגע מוחלטות כדי שעומסים סטטיים יישארו נצפים.

**אימות.** למדוד השהיית מישוש עם ייחוס גירוי ואוסצילוסקופ; אין להסיק אותה מכותרת מאמר על מצלמת אירועים.

**ידע קודם.** לחיישני אירועים ייעודיים ולשידור אירועים באמצעות כתובות יש ידע קודם בן עשרות שנים.

מיקומים נוספים: [1](https://scispace.com/pdf/a-128-times-128-120-db-15-mu-s-latency-asynchronous-temporal-3bv4hgi11i.pdf). מצב הגישה אליהם מתואר לעיל; קישור אינו מעיד על סקירת טקסט מלא.

### [54] An asynchronous time-based image sensor

C. Posch, D. Matolin and R. Wohlgenannt; 2008. [מקור](https://publications.ait.ac.at/en/publications/an-asynchronous-time-based-image-sensor/); DOI [10.1109/ISCAS.2008.4541871](https://doi.org/10.1109/ISCAS.2008.4541871).

**גישה: CITATION_ONLY.** נבדקו מטא־נתונים ביבליוגרפיים מוסדיים ראשוניים. נמצא תקציר משני, אך לא נבדקו גוף מקורי או תקציר ראשוני מלא.

**ממצא.** זוהה כעבודה קודמת על חישה אופטית אסינכרונית מבוססת זמן. לא מאומצת שום טענה כמותית על ההתקן.

**מגבלה.** זהו תכן של חיישן תמונה, ולא מתמר מישוש או מעגל ייחוס זול ל-STM32.

**פעולה בתוכנית.** אין להוסיף לתצורת הבסיס חומרה ייעודית המקודדת בזמן על סמך ציטוט זה בלבד. ערכי ADC מוחלטים רגילים בצירוף חותמות זמן מספיקים למשימת המגע המיועדת.

**אימות.** לתעד את רגע הרכישה בנפרד מהגעת החבילה, ולוודא ששינוי קידוד האירוע אינו משנה את מגבלת הדגימה הבסיסית.

**ידע קודם.** ייצוגי אירועים מבוססי זמן כבר מבוססים, ואינם טענת חדשנות שניתן להצדיק כאן.

### [55] AER EAR: A matched silicon cochlea pair with address event representation interface

A. van Schaik and S.-C. Liu; 2005. [מקור](https://researchers.westernsydney.edu.au/en/publications/aer-ear-a-matched-silicon-cochlea-pair-with-address-event-represe-3/); DOI [10.1109/ISCAS.2005.1465560](https://doi.org/10.1109/ISCAS.2005.1465560).

**גישה: ABSTRACT_ONLY.** תקציר מוסדי ראשוני. זהו מאמר הכנס משנת 2005, ולא העבודה המאוחרת בכתב עת בעלת השם הדומה.

**ממצא.** מתאר זוג שבלולי אוזן בסיליקון, מעגלי תאי שערה פנימיים ונוירונים פולטים דחפים, ופלט אירועים ממוען; הניסוי משתמש בצלילים מכיוונים שונים.

**מגבלה.** שלב מבוא אנלוגי לשמיעה אינו מספק רזולוציית מישוש, מחיר רכיב או הבטחת בטיחות מגע שניתן להעביר ישירות.

**פעולה בתוכנית.** להשתמש כדוגמה היסטורית ליצירת אירועים מקומית המותאמת לאופן החישה. להגדיר בנפרד את פרמטרי הרכישה של לחץ ושל טמפרטורה.

**אימות.** לוודא ששני אופני החישה משמרים יחידות פיזיקליות נכונות, תזמוני דגימה ודגלי נתונים לא תקפים כאשר אורזים אותם בתעבורה משותפת.

**ידע קודם.** קידוד אירועים חושיים נוירומורפי קדם לפרויקט זה.

### [56] VLSI analogs of neuronal visual processing: A synthesis of form and function

M. Mahowald; 1992. [מקור](https://authors.library.caltech.edu/records/g2vmh-8fe19); DOI [10.7907/Z9CZ35CD](https://doi.org/10.7907/Z9CZ35CD).

**גישה: ABSTRACT_ONLY.** מטא־נתונים ותקציר במאגר התזות של Caltech. התזה המלאה אותרה אך לא נקראה.

**ממצא.** מפתח עיבוד חזותי ותקשורת ב-VLSI אנלוגי בהשראת מערכות עצביות, כולל רעיונות של רשתית, סטריאו ועצב הראייה.

**מגבלה.** תקציר תזה אינו יכול לתמוך בשחזור מעגל מפורט או בהשוואת ביצועים. מעגלים נוירומורפיים חזותיים אינם מגדירים את המכניקה של עור אלקטרוני.

**פעולה בתוכנית.** לצטט כרקע היסטורי אם משתמשים באנלוגיה של מערכת עצבים מלאכותית. לבסס את הטיעון ההנדסי על השהיה, אמינות, מסה ועלות שנבדקו.

**אימות.** לבקר את טענות החדשנות של המאמר המתוכנן מול ידע קודם מתועד, ולהבחין בין כלכלת המימוש לבין עיקרון חדש של חישוב חושי.

**ידע קודם.** חישה מבוזרת ותקשורת אירועים בהשראת מערכות עצביות הן רעיונות ותיקים.

### [57] Point-to-point connectivity between neuromorphic chips using address events

K. A. Boahen; 2000. [מקור](https://web.stanford.edu/group/brainsinsilicon/documents/00_journ_IEEEtsc_Point.pdf); DOI [10.1109/82.842110](https://doi.org/10.1109/82.842110).

**גישה: PARTIAL_TEXT.** תקציר באתר המחבר ודיון ואיורי בוררות המאונדקסים במאגר; לא כל 19 עמודי המאמר בכתב העת.

**ממצא.** מנתח תקשורת אירועים ממוענת ובוררות עבור חיבורים נוירומורפיים בריבוב זמן. תורים ותחרות על משאבים משפיעים על תזמון האירועים ועל קצב ההעברה.

**מגבלה.** מאפייני התזמון של AER אינם מבטלים רוחב פס סופי, השהיית בוררות או מגבלות חוצצים, ואינם חלים אוטומטית על CAN FD.

**פעולה בתוכנית.** לאמץ ניתוח של פרצים ותורים במקרה הגרוע. לשמר חותמות זמן רכישה ולהבחין בין גיל בעת הדגימה להשהיית התעבורה; לדווח על גלישת תור ככיסוי לא תקף.

**אימות.** ליישר בזמן דיווחים בקצב המרבי מכל הצמתים ולהזריק שידורים חוזרים. למדוד את הגיל הגרוע ביותר שנצפה ואת ההתנהגות בגלישה, ולא רק השהיה ממוצעת.

**ידע קודם.** כתובות דלילות ובוררות אסינכרונית הן ידע קודם.

מיקומים נוספים: [1](https://repository.upenn.edu/bitstreams/4087da08-9301-4ab1-9de3-47924602da72/download). מצב הגישה אליהם מתואר לעיל; קישור אינו מעיד על סקירת טקסט מלא.

### [58] Asynchronous DC-free serial protocol for event-based AER systems

P. M. Ros, M. Crepaldi, C. Bartolozzi and D. Demarchi; 2015. [מקור](https://iris.polito.it/handle/11583/2646243); DOI [10.1109/ICECS.2015.7440295](https://doi.org/10.1109/ICECS.2015.7440295).

**גישה: ABSTRACT_ONLY.** תקציר ראשוני באוניברסיטה; הגישה לקובץ המאמר המקורי מוגבלת והוא לא התבקש מהמחברים.

**ממצא.** מציע פרוטוקול אירועים טורי בקצב גולמי של 100 Mbps ועד 2.9 מיליון אירועים בני 32 סיביות בשנייה; התקציר מדווח על פעולה מוצלחת ב-16 סיביות עם אי־התאמה של ±2% בין שעונים, בקרת זרימה מפורשת ותאימות לצימוד AC.

**מגבלה.** הנתונים מתייחסים לפרוטוקול ולמימוש המסוימים. זוג מוליכים דיפרנציאלי אינו הופך אותו לתחליף חשמלי או לוגי ל-CAN.

**פעולה בתוכנית.** לשמר משדרי־מקלטי CAN FD, בוררות, גילוי שגיאות ואבחון. לשקול AS-AER רק לאחר שצוואר בקבוק מדוד ברוחב הפס מצדיק עלות נפרדת של FPGA/PHY.

**אימות.** לאמת את קו ה-CAN בפועל, הסיומות, תזמון הסיביות וההתאוששות משגיאות. אין להציב קצבי סיביות של AS-AER בחישוב קיבולת CAN.

**ידע קודם.** העברת אירועים טורית על מספר קטן של חוטים כבר מבוססת.

### [59] A QVGA143dB dynamic range frame-free PWM image sensor with lossless pixel-level video compression and time-domain CDS

C. Posch, D. Matolin and R. Wohlgenannt; 2011. [מקור](https://ieeexplore.ieee.org/document/5648367).

**גישה: CITATION_ONLY.** כותרת ורשומה של IEEE וזהות מוסדית ראשונית ב-AIT; השיטות והאיורים המקוריים לא הושגו. גרסאות דומות מכנס ISSCC משנת 2010 אינן משמשות תחליף.

**ממצא.** מזהה עבודה קודמת על חישה אופטית ללא מסגרות עם קידוד בתחום הזמן; שום טענה מספרית מעבר לכותרת הביבליוגרפית אינה מאומצת כראיה הנדסית.

**מגבלה.** השימוש בסקירת 2019 בדוגמה לקידוד אירועים בערכים מוחלטים אינו הופך את המעגל האופטי שלה לתכן מישוש מתאים.

**פעולה בתוכנית.** להעביר ערכים מוחלטים במסגרות ה-MCU; אין לבצע אינטגרציה של תוספות חתומות שהתקבלו כמקור היחיד למצב מגע מתמשך.

**אימות.** להשמיט חבילת תחילת מגע ולוודא שתמונת מצב מוחלטת עוקבת משחזרת את המצב הנוכחי. יש לדווח גם שהאירוע החולף שהוחמץ עצמו אינו ניתן לשחזור.

**ידע קודם.** חישת אירועים עם ערכים מוחלטים או קידוד זמן אינה חדשה.

מיקומים נוספים: [1](https://publications.ait.ac.at/en/publications/a-qvga-143-db-dynamic-range-frame-free-pwm-image-sensor-with-loss/). מצב הגישה אליהם מתואר לעיל; קישור אינו מעיד על סקירת טקסט מלא.

### [60] A new protocol for a low power sensor network

M. Neugebauer and K. Kabitzsch; 2004. [מקור](https://www.researchgate.net/publication/4075406_A_new_protocol_for_a_low_power_sensor_network); DOI [10.1109/PCCC.2004.1395037](https://doi.org/10.1109/PCCC.2004.1395037).

**גישה: ABSTRACT_ONLY.** תקציר שהעלה מחבר ותוכן עניינים רשמי של הכנס; פרטי הפרוטוקול והתוצאות המקוריים לא נקראו.

**ממצא.** דן בפעילות מכוונת אירועים ברשתות חיישנים המופעלות מסוללה, תוך קישור בין תזמון התקשורת לצריכת אנרגיה.

**מגבלה.** יתרונות האנרגיה תלויים ברדיו, במחזור העבודה וביישום. חיישן קווי שממשיך לדגום ב-100 Hz אינו חוסך הספק ADC או MCU רק משום שהוא שולח פחות חבילות.

**פעולה בתוכנית.** להפריד בטבלת העלות והביצועים בין הפחתת רוחב פס להפחתת הספק. למדוד את זרם האספקה הכולל במצב מחזורי ובמצב משולב עם לוחות זמנים זהים של סריקה.

**אימות.** למדוד זרם בשקט, במגע ובמצב תקלה בכניסת הטלאי וברכזת האזורית; לכלול צריכת מנוחה של מייצבים ופעילות סיומות ומשדרי־מקלטים.

**ידע קודם.** רשתות חיישנים חסכוניות בהספק המבוססות על אירועים היו מבוססות זמן רב לפני פרויקט זה.

מיקומים נוספים: [1](https://www.ipccc.org/ipccc2004/TableOfContents.htm). מצב הגישה אליהם מתואר לעיל; קישור אינו מעיד על סקירת טקסט מלא.

### [61] Send-on-delta concept: An event-based data reporting strategy

M. Miskowicz; 2006. [מקור](https://mdpi-res.com/d_attachment/sensors/sensors-06-00049/article_deploy/sensors-06-00049.pdf); DOI [10.3390/s6010049](https://doi.org/10.3390/s6010049).

**גישה: FULL_TEXT.** קובץ PDF סטטי רשמי של MDPI הורד מקומית; כל 15 העמודים 49–63 נקראו, כולל משוואות 1–13, טבלאות 1–2, דוגמת תוכנה ומקורות. איור 3 בעמוד 58 נבדק חזותית.

**ממצא.** מפריד בין חציית רמה רציפה למימושים משולבים הנדגמים באופן מחזורי, בעמוד 53. ניתוח התעבורה תלוי בשיפוע האות, בצפיפות השיאים ובסף; הדוגמה משווה 59 דגימות מחזוריות ל-7 אירועים במשך 1.2 s ברזולוציית משרעת 0.2, בעמוד 58. עדכוני חיות מתוארים כבר בעמודים 60–61.

**מגבלה.** ההשוואה האנליטית מניחה אות ורזולוציה מוגדרים; היא אינה חיסכון אוניברסלי, הבטחת השהיה קשיחה או פרוטוקול לאובדן ולאתחול. דוגמת מספר הדגימות היא סימולציה, ולא ניסוי בעור מישוש.

**פעולה בתוכנית.** להתאים למצב משולב: סריקה ב-100 Hz, טריגרים לשינוי, למגע ולתקלה, ותמונות מצב מוחלטות וטריות לפחות כל 20 ms בחוסר פעילות. לכלול מספר רצף, זהות אתחול והפעלה וזמן רכישה; לעולם אין לפרש שקט כבריאות תקינה.

**אימות.** לבדוק רעש בגבול סף השינוי, עליות איטיות, מגעים מתמשכים, אובדן פרצים, אתחול, גלישת חותמות זמן ודחיית הכנסה לתור. לשמור על תכנון קיבולת למקרה הגרוע של 100 Hz ולמדוד את החיסכון שהושג.

**ידע קודם.** שידור לפי שינוי, מימושים משולבים הנדגמים מחזורית והוספת עדכוני חיות הם כולם ידע מבוסס; הפרויקט מתאים אותם לצרכיו.

מיקומים נוספים: [1](https://citeseerx.ist.psu.edu/document?doi=e16d4fa920e6886be986d915b768dc166e7761e0&repid=rep1&type=pdf), [2](https://www.researchgate.net/publication/26546799_Send-On-Delta_Concept_An_Event-Based_Data_Reporting_Strategy). מצב הגישה אליהם מתואר לעיל; קישור אינו מעיד על סקירת טקסט מלא.

### [62] A robust and efficient dynamic network protocol for a large-scale artificial robotic skin

C. Bader, F. Bergner and G. Cheng; 2018. [מקור](https://mediatum.ub.tum.de/doc/1459302/136167106011.pdf).

**גישה: PARTIAL_TEXT.** תקציר מאונדקס במאגר, מבוא מהעמוד הראשון ואיור טופולוגיה וניתוב מחדש. המימוש המפורט ויתר הניסויים לא נקראו.

**ממצא.** בודק רשת עור מרובת דילוגים עם עד 204 תאים. התקציר המקורי מדווח על התאוששות בתוך 50 ms ועל הפחתה של יותר מ-30% באובדן חבילות עקב איזון, ביחס לפרוטוקול הקודם שלהם.

**מגבלה.** סקירת 2019 שסופקה מדווחת על 40 ms ועל גודל רשת גדול ב-32%: אלה הצהרות נפרדות של מקור ומדד, ולא הבטחות הניתנות להחלפה. ניתוב מחדש מחייב נתיב פיזי חלופי תקין.

**פעולה בתוכנית.** לדחות מימוש מילולי של ניתוב אריג על אפיק CAN משותף יחיד. להשתמש בפילוח אזורי, בגילוי תקלות חסום בזמן ובבידוד תקלות פיזי. כל יתירות מחייבת אפיקים או יציאות נוספים ורשימת חומרים משלה.

**אימות.** לנתק צומת, לקטוע קו ראשי, לקצר את האפיק ולאפס את שער התקשורת בנפרד. לתעד את האזור שנפגע בפועל ואת ההתאוששות; אין לטעון לשרידות נתק חוט יחיד באמצעות תוכנה בלבד.

**ידע קודם.** ניתוב דינמי ואיזון עומס בעור רובוטי הם ידע קודם, אך אינם פונקציות של טופולוגיית CAN בתצורת הבסיס.

## שלמות הראיות והשלכתה על שחרור המוצר

לכל 27 המקורות שהוקצו קיימת רשומה והחלטה מפורשת על אימוץ, התאמה או דחייה. חמישה מקורות נשארים ביבליוגרפיים בלבד: 22,43,48,54,59. תשעה היו נגישים רק כתקצירים: 20,41,46,47,49,55,56,58,60. שנים־עשר סיפקו טקסט מקורי חלקי: 21,23,24,42,44,45,50,51,52,53,57,62. מקור 61 נקרא במלואו; ה-PDF שהורד, הטקסט שחולץ וההדמיה של איור 3 שנבדקה נשמרו בסביבת המחקר המקומית. מאגר זה מקשר למקור ואינו מפיץ את הקבצים האלה. אין לתאר אף רשומה אחרת כסקירת טקסט מלא וממצה.

מגבלות אלה אינן מונעות בניית הוכחת היתכנות שמרנית הרשומה לפי CAD, נדגמת ב-ADC ומחוברת ברשת CAN. הן כן מונעות הצגתה כשחזור מדויק של האלגוריתמים שאינם נגישים, הבטחת הביצועים שדווחו בהם, או טענה להערכת חדשנות המקיפה את כל הספרות. על הפרויקט לשמר בדיקות ושערי שחרור מפורשים, במקום להפוך תוצאת מאמר למפרט שלא נמדד. הרשומה אינה כוללת הצעת מחיר מספק, הסמכה או מסקנה לגבי חופש פעולה בתחום הפטנטים.

</div>
