oznav2/tectile_skin/hardware/01_Mechanic/02_Manufacturing/03_Rubber/PDF_Drawings/ROBOSKIN.0239-02_debug_port_soft_rubber_cover.pdf

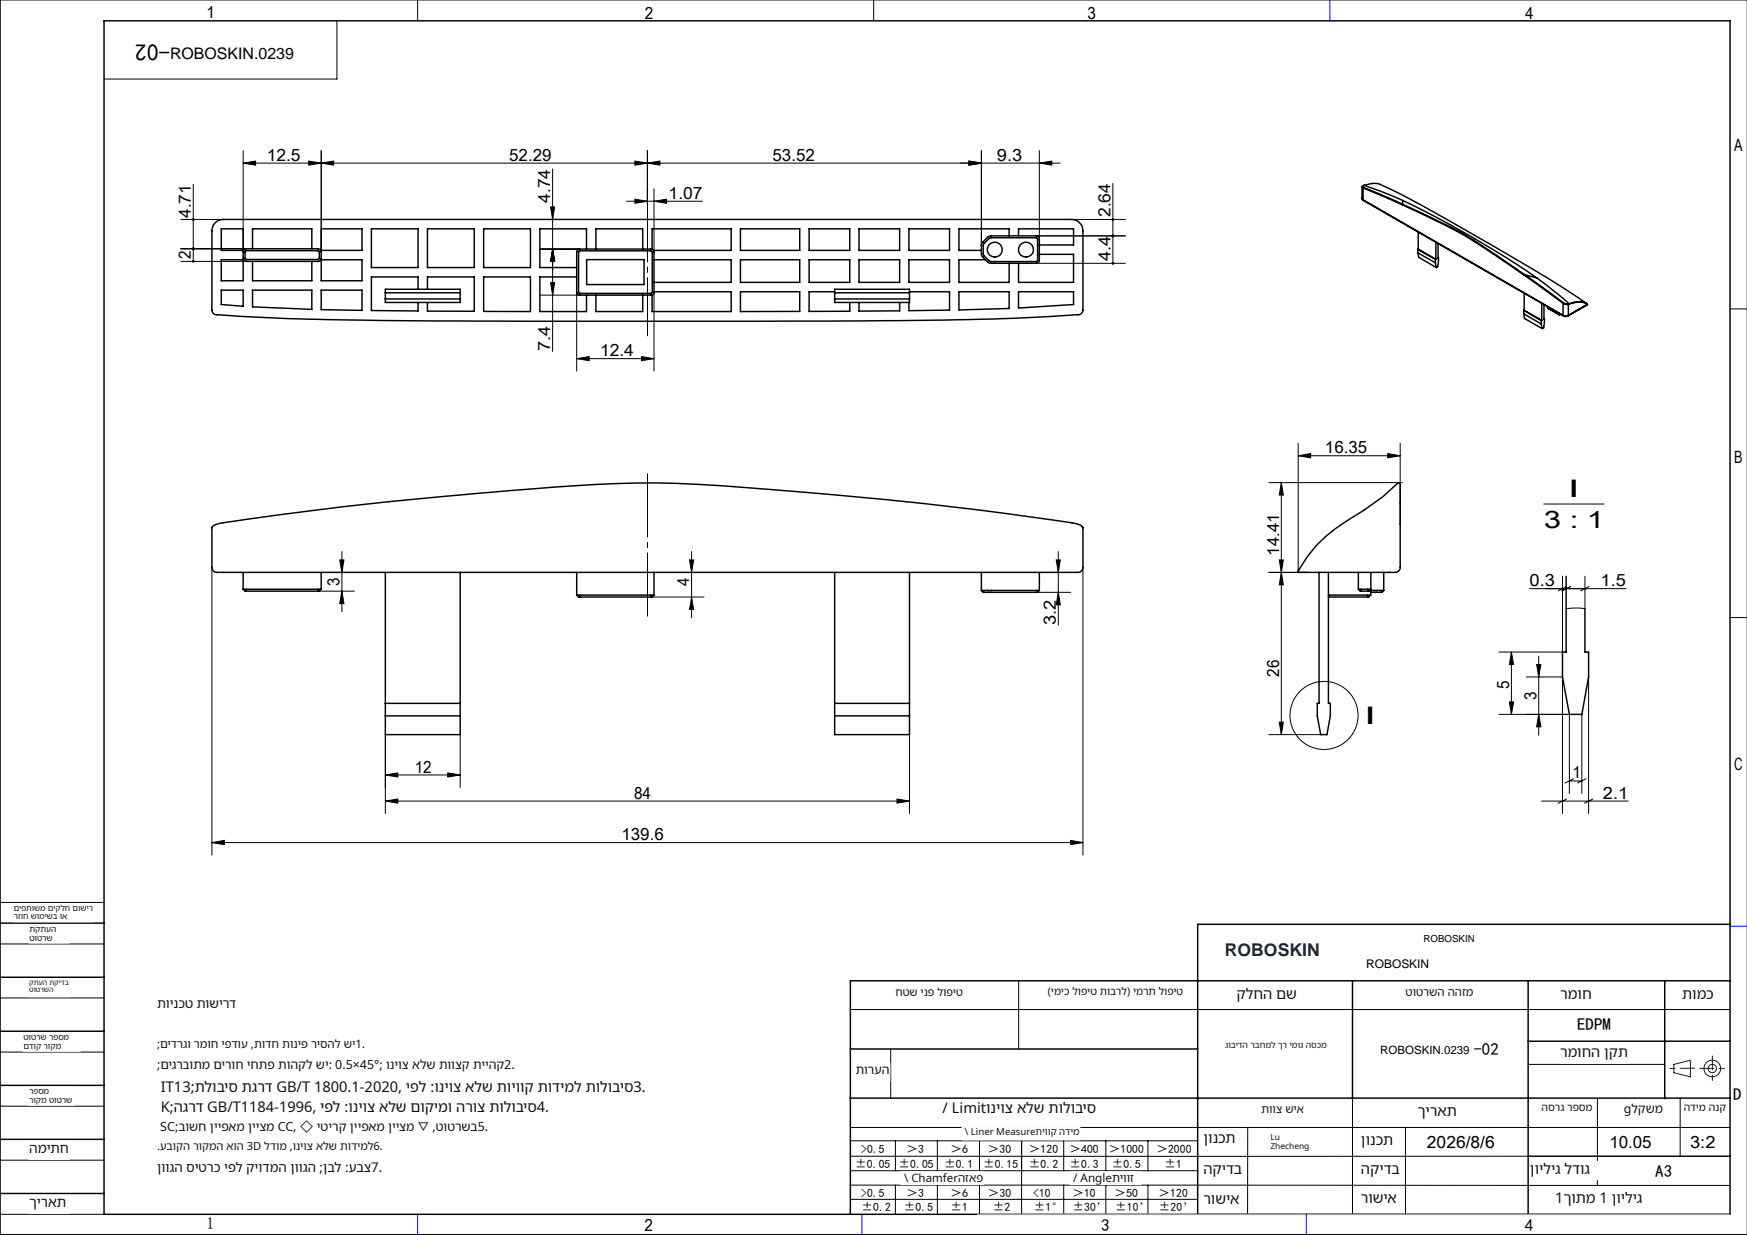
[picture p161: page 1]
טוטרש רפסמ םדוק רוקמ; רוקמ טוטרש; קתעה תקידב; תווצ שיא; הסרג רפסמ; Zhecheng \ Liner Measure; הדימ תיווק; ןויליג לדוג; רמוחה ןקת; תוינכט תושירד; 7. עבצ : ןבל ; ןווגה סיטרכ יפל קיודמה ןווגה; 6. וניוצ אלש תודימל , לדומ D3 עבוקה רוקמה אוה .; 5. טוטרשב , ▽ יטירק ןייפאמ ןייצמ ◇ ,CC בושח ןייפאמ ןייצמ ;SC; 4. וניוצ אלש םוקימו הרוצ תולוביס : יפל 1184-1996,T/GB הגרד ;K; 3. וניוצ אלש תויווק תודימל תולוביס : יפל 1800.1-2020, T/GB תלוביס תגרד ;13IT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

םיפתושמ םיקלח םושיר
רזוח שומישב וא
תקתעה
טוטרש

תומכ ימרת לופיט ( ימיכ לופיט תוברל ) חטש ינפ לופיט

רמוח טוטרשה ההזמ קלחה םש

גובידה רבחמל ךר ימוג הסכמ

וניוצ אלש תולוביס Limit /

הדימ הנק לקשמ g

ןונכת
הקידב
ןויליג 1 ךותמ 1 רושיא

תיווז Angle / הזאפ Chamfer \

>0.5 | ＞3 | ＞6 | ＞30 | <10 | ＞10 | ＞50 | ＞120
±0.2 | ±0.5 | ±1 | ±2 | ±1° | ±30’ | ±10’ ±20’

ROBOSKIN | RP1-derived engineering record

English file: ROBOSKIN.0239-02_debug_port_soft_rubber_cover.pdf Status: derivative identification; NOT a manufacturing release.

Existing dimensions, tolerances, material and revision remain authoritative. Source engineering graphics and original attribution are retained. Technical notes may remain in the source language.
Only searchable project part IDs on original pages are replaced. Outlined/raster labels require the original CAD authoring application.

Original drawing pages: 1
Searchable ID replacements: 2
Source: Roboparty/rp1_hardware
Hardware licence: CERN-OHL-W-2.0 where applicable; see LICENSES.md. Original path and SHA256: electronic_skin/branding/file_manifest.json

Part aliases in this document:
YCL.M000743 -> ROBOSKIN.0239

תודימה , ורמשנ טוטרשבש תולובסהו םירמוחה . הדשו דומע ןייצמ לאמשמ רפסמה . | - ROBOSKIN טוטרשה טסקטל ירבע ארקמ

p1 T1009

םדוק רוקמ טוטרש רפסמ

p1 T1239

המיתח

p1 T1006

ךיראת

p1 T0893

רוקמ טוטרש רפסמ

p1 T0546

רזוח שומישב וא םיפתושמ םיקלח םושיר

p1 T0980

טוטרשה קתעה תקידב

p1 T0979

טוטרש תקתעה

p1 T1374

גובידה רבחמל ךר ימוג הסכמ

p1 T0990

תומכ

p1 T1350

חטש ינפ לופיט

p1 T1137

ימרת לופיט ( ימיכ לופיט תוברל )

p1 T0740

תורעה

p1 T1025

רמוח

p1 T0719

טוטרשה ההזמ

p1 T0447

p1 T1520

קלחה םש

p1 T1093

הדימ הנק

p1 T1438

לקשמ g

p1 T1365

ןונכת

p1 T0513

תווצ שיא

p1 T0796

הקידב

p1 T0951

רושיא

p1 T0567

ןויליג 1 ךותמ 1

p1 T1147

הסרג רפסמ

ROBOSKIN

תודימה , ורמשנ טוטרשבש תולובסהו םירמוחה . הדשו דומע ןייצמ לאמשמ רפסמה . | - ROBOSKIN טוטרשה טסקטל ירבע ארקמ

p1 T0699

### Lu Zhecheng

p1 T1256

### תיווק הדימ Measure Liner \

p1 T0543

### הזאפ Chamfer \

p1 T1363

### תיווז Angle /

p1 T1020

וניוצ אלש תולוביס Limit /

p1 T0720

ןויליג לדוג

p1 T1007

ךיראת

p1 T1026

רמוחה ןקת

p1 T0954

תוינכט תושירד

p1 T0027

1. תודח תוניפ ריסהל שי , םידרגו רמוח יפדוע ;

p1 T0069

2. וניוצ אלש תווצק תייהק ;45°×0.5 : םיגרבותמ םירוח יחתפ תוהקל שי ;

p1 T0101

3. וניוצ אלש תויווק תודימל תולוביס : יפל 1800.1-2020, T/GB תלוביס תגרד ;13IT

p1 T0122

4. וניוצ אלש םוקימו הרוצ תולוביס : יפל 1184-1996,T/GB הגרד ;K

p1 T0133

5. טוטרשב , ▽ יטירק ןייפאמ ןייצמ ◇ ,CC בושח ןייפאמ ןייצמ ;SC

p1 T0142

6. וניוצ אלש תודימל , לדומ D3 עבוקה רוקמה אוה .

p1 T0157

7. עבצ : ןבל ; ןווגה סיטרכ יפל קיודמה ןווגה
