oznav2/tectile_skin/hardware/02_PCB/02_RBE-COMM-433TX/06_PCB_PDF_433TX_2026-09-20.pdf

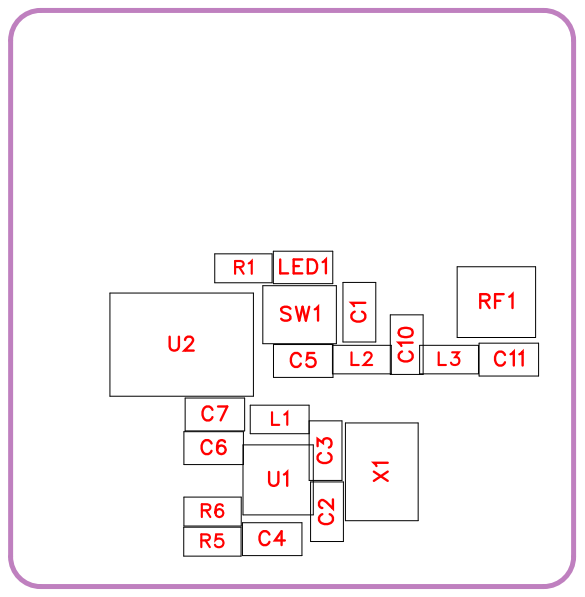
[picture p162: page 1]

C7 | L1
C6 | U1

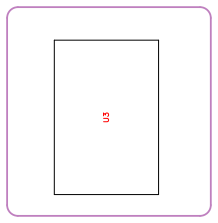
[picture p163: figure]

No. | Quantity | Comment | Designator | Footprint | Value | Manufacturer Part | Manufacturer | Supplier Part | Supplier
1 | 3 | 100nF | C1,C4,C7 | C0603 | 100nF | CC0603KRX 7R9BB104,C GA0603X7R 104K500JT | | | | C14663,C61 19867 | LCSC
2 | 2 | 30pF | C2,C3 | C0603 | 30pF | CC0603FRN PO9BN300 | HRE YAGEO YAGEO FH | YAGEO HRE | C519491 | LCSC
3 | 1 | 1.5pF | C5 | C0603 | 1.5pF | 0603CG1R5 C500NT
4 | 1 | 100pF | C6 | C0603 | 100pF | CC0603JRN PO9BN101 | | | | C14665 | LCSC
5 | 2 | 9pF | C10,C11 | C0603 | 9pF | CGA0603C0 G9R0C500J T
6 | 1 | 220nH | L1 | L0603 | 220nH | SDCL1608C R22JTDF | | | | C22476 | LCSC
7 | 1 | 100nH | L2 | L0603 | 100nH | SDCL1608C R10JTDF | | | | C74310 | LCSC
8 | 1 | 22nH | L3 | L0603 | 22nH | SDCL1608C 22NJTDF | | | | C12099 | LCSC
9 | 1 | KT-0603R | LED1 | LED0603-RD | | KT-0603R | KENTO | | | C2286 | LCSC
10 | 1 | 4.7k | R1 | R0603 | 4.7k | 0603WAF47 01T5E | | | | C23162 | LCSC
11 | 1 | 100k | R5 | R0603 | 100k | 0603WAF10 03T5E | | | | C25803 | LCSC
12 | 1 | 10k | R6 | R0603 | 10k | 0603WAF10 02T5E | | | | C25804 | LCSC

HRE(
AGE

)

YAGEO( )

FH(

) | C1639 | LCSC

YAGEO( )

HRE(

) | C41361254 | LCSC

Sunlord( )

Sunlord( )

Sunlord( )

ROYAL( )

ROYAL( )

ROYAL( )

13

1 | 6GHz | RF1 | IPEX-SMD_B WIPX-1-001 E
6GHz | BWIPX-1-00
1E

BA
SS(

)

C496552 | LCSC
14 | 1 | SKSGPAE01 0 | SW1 | SW-SMD_SK SGAAE010 | | SKSGPAE01 0 | A | C125045 | LCSC
| ] םש עטקמ ] ALPINE
15 | 1 | LT4455 | U1 | SOT-23-6_L2 .9-W1.6-P0.9 5-LS2.8-BL | | LT4455 | | C5178904 | LCSC
16 | 1 | FB1527 | U2 | SOP-8_L4.9-W3.9-P1.27-LS6.0-BL | | FB1527 | | C5182315 | LCSC
17 | 1 | XDCR-1220-006 | U3 | BAT-SMD_C R1220-2ZX | | XDCR-1220-006
18 | 1 | 13.56MHz | X1 | CRYSTAL-S MD_4P-L3.2-W2.5-BL-1 | 13.56MHz | TAXM13.56 M4RLBCCT2 T

LX(

) | C7498147 | LCSC

YJX(

) | C164051 | LCSC

Sunlord Sunlord Sunlord UNI-

ROYAL

UNI-ROYAL

UNI-ROYAL BAT WIRELESS עטקמ ALPS ALPINE [ [ םש

Hummingbird
Wireless

Hummingbird
Wireless LX YJX

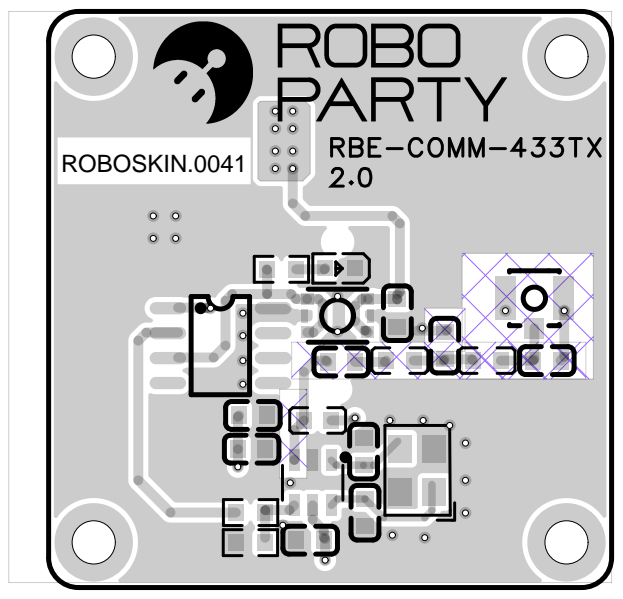
[picture p164: page 4]

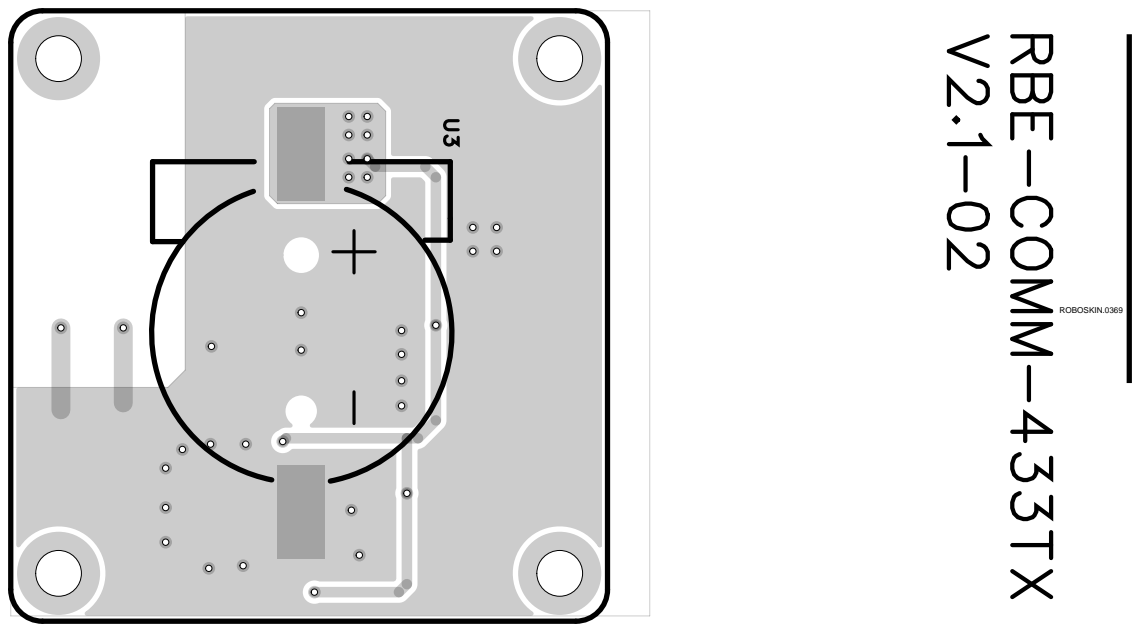
[picture p165: page 5]

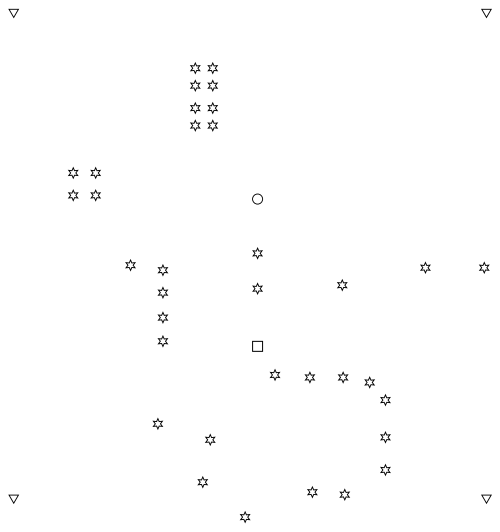
[picture p166: page 6]

ROBOSKIN | RP1-derived engineering record

English file: 06_PCB_PDF_433TX_2026-09-20.pdf
Status: derivative identification; NOT a manufacturing release.

Existing dimensions, tolerances, material and revision remain authoritative. Source engineering graphics and original attribution are retained. Technical notes may remain in the source language.
Only searchable project part IDs on original pages are replaced. Outlined/raster labels require the original CAD authoring application.

Original drawing pages: 6
Searchable ID replacements: 1
Source: Roboparty/rp1_hardware
Hardware licence: CERN-OHL-W-2.0 where applicable; see LICENSES.md. Original path and SHA256: electronic_skin/branding/file_manifest.json

Part aliases in this document:
YCL.E000194 -> unmapped; review required
YCL.E000212 -> ROBOSKIN.0041

תודימה , ורמשנ טוטרשבש תולובסהו םירמוחה . הדשו דומע ןייצמ לאמשמ רפסמה . | - ROBOSKIN טוטרשה טסקטל ירבע ארקמ

p3 T1333

HRE

p3 T0715

YAGEO

p3 T1534

FH

p3 T1531

Sunlord

p3 T0665

UNI-ROYAL

p3 T1347

BAT WIRELESS

p3 T1505

] ALPINE ALPS םש עטקמ ]

p3 T0857

] ALPINE םש עטקמ ]

p3 T1346

Hummingbird Wireless

p3 T1421

LX

p3 T1514

YJX
