oznav2/tectile_skin/hardware/02_PCB/05_RBE-PWR-HANDPlusPro/06_PCB_PDF_HAND.pdf

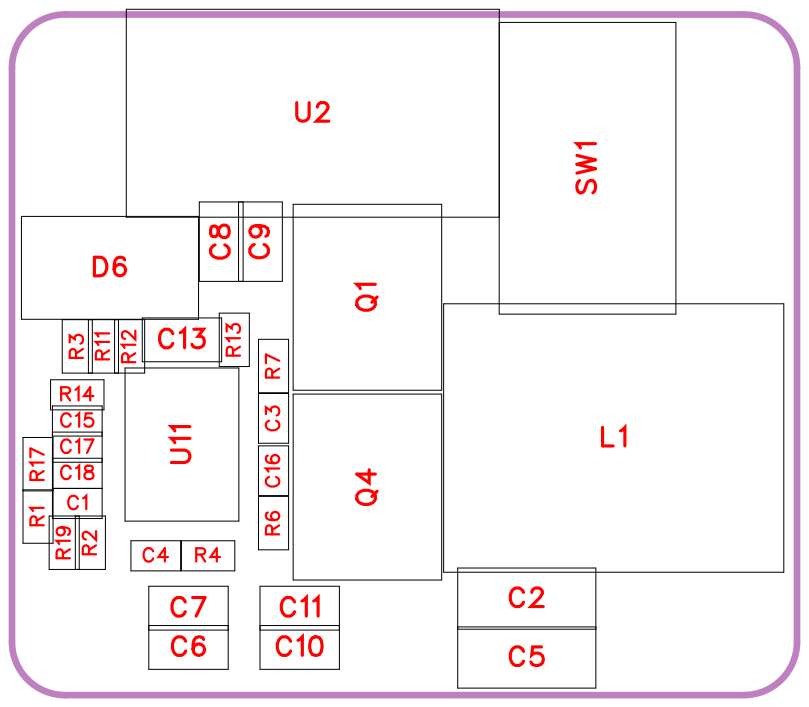
[picture p167: page 1]

C7 | C11 | C2
C6 | C10 | C5

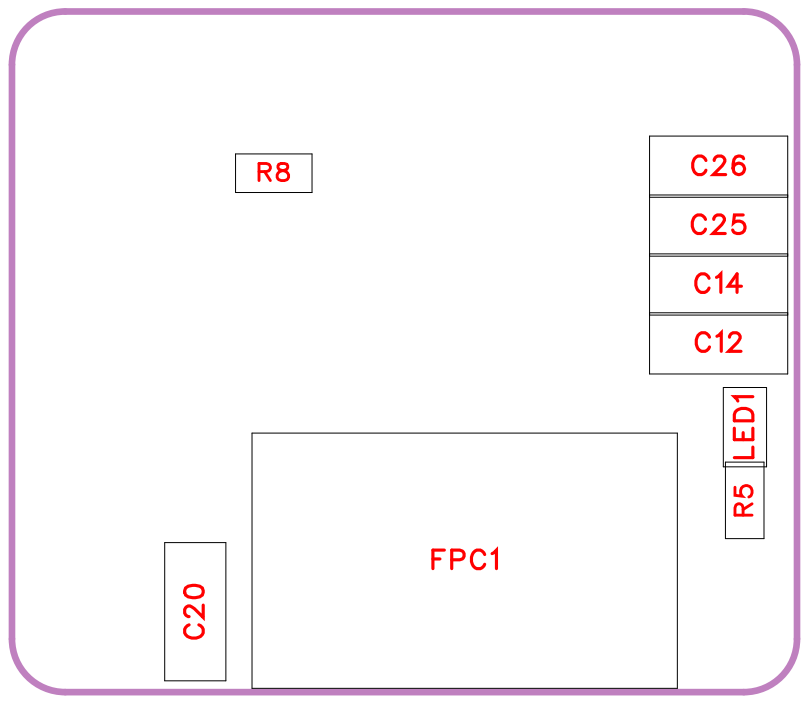
[picture p168: page 2]

No. | Quantity | Comment | Designator | Footprint | Value | Manufacturer Part | Manufacturer | Supplier Part | Supplier
1 | 1 | 1.2nF | C1 | C0402 | 1.2nF | CL10B102KB 8NNNC | SUNG( | | LCSC
2 | 3 | 10uF | C2,C5,C20 | C1206 | 10uF | HGC1206R5 106K500NSP J | | | C7432781 | LCSC
3 | 1 | 100nF | C3 | C0402 | 100nF | CGA0603X7 R104K500JT
4 | 1 | 10pF | C4 | C0402 | 10pF | CL10C100JB 8NNNC | SUNG( | | | | LCSC
5 | 7 | 100nF | C6,C7,C8,C9,C10,C11,C13 | C0603 | 100nF | CGA0603X7 R104K500JT
6 | 4 | 4.7uF | C12,C14,C25,C26 | C1206 | 4.7uF | HHV1206R7 475M101NS PJ | | | C33546020 | LCSC
7 | 1 | 56nF | C15 | C0402 | 56nF | CC0603KRX 7R9BB563 | ) | YAGEO Samsung | C282072 | LCSC
8 | 1 | 2.2uF | C16 | C0402 | 2.2uF | CL10A225K O8NNNC | SUNG( | | C23630 | LCSC
9 | 1 | 4.7nF | C17 | C0402 | 4.7nF | 0603B822K5 00NT
10 | 1 | 220pF | C18 | C0402 | 220pF | CL10C331JB 8NNNC | SUNG( | | | | LCSC
11 | 1 | SMBJ60A | D6 | SMB_L4.5-W 3.7-LS5.4-R D
12 | 1 | PH-6PWB | FPC1 | CONN-SMD_ 6P-P2.00_D EALON_PH-6PWB | | | | | | C2905023 | LCSC
13 | 1 | 33uH | L1 | IND-SMD_L1 1.5-W10.0_F XL1040 | 33uH | FXL1050-330 -M | | | C5359267 | LCSC
14 | 1 | GL0603UG0 1 | LED1 | LED0603-RD | | GL0603UG0 1 | G | | C51933293 | LCSC
15 | 2 | NTMFS6H86 4NL | Q1,Q4 | DFN-8_L5.9-W5.2-P1.27-LS6.2-BL | | NTMFS6H86 4NL
16 | 1 | 768 | R1 | R0402 | 768 | RT0603BRD 07619RL | ) | | | LCSC
17 | 1 | 13.7 | R2 | R0402 | 13.7 | RC0603FR-0 75R76L | ) | | | LCSC
18 | 1 | 110k | R3 | R0402 | 110k | FRC0603F21 03TS
19 | 1 | 750 | R4 | R0402 | 750 | FRC0603F76 80TS
20 | 1 | 100k | R5 | R0603 | 100k | 0603WAF10 03T5E | ROYAL( | | C25803 | LCSC

)
inocera(
)
HRE( | ) | C6119867 | LCSC

)
HRE( | ) | C6119867 | LCSC

inocera(
)

YAGEO(

)
FH( | ) | LCSC

)
SMBJ60A | R+O( | ) | C49066953 | LCSC
PH-6PWB | LON( )
| ng( )
| ht( | )

YAGEO(

YAGEO(

FOJAN( | ) | LCSC
FOJAN( | ) | LCSC

)

Samsung

האוה
[ עטקמ
םש ]
הקימרק
[ עטקמ ]
HRE

Samsung
HRE

האוה
[ עטקמ
םש ]
הקימרק
[ עטקמ ]

FH

Samsung
R+O

הד
[ עטקמ
םש ]
DEALON
] םש עטקמ ]

] Cjiang עטקמ
םש ]

למשח
[ עטקמ ]

# Guiguang Light YAGEO YAGEO FOJAN FOJAN UNI-

ROYAL

21 | 2 | 0 | R6,R7 | R0402 | 0 | 0603WAF20 02T5E | | | LCSC
22 | 1 | 120 | R8 | R0603 | 120 | FRC0603F12 00TS
23 | 1 | 100k | R11 | R0402 | 100k | FRC0603F21 03TS
24 | 1 | 7.68k | R12 | R0402 | 7.68k | FRC0603F76 81TS
25 | 1 | 2 | R13 | R0402 | 2 | FRC0603J2R 0 TS
26 | 1 | 40.2k | R14 | R0402 | 40.2k | 0603WAF39 22T5E | | | LCSC
27 | 1 | 6.19k | R17 | R0402 | 6.19k | FRC0603F37 41TS | ROYAL | FOJAN UNI-
28 | 1 | 22.1k | R19 | R0402 | 22.1k | 0603WAF18 02T5E | | | LCSC
29 | 1 | DSPV02LSG ET | SW1 | SW-SMD_D SPV02LSGE T | | DSPV02LSG ET | | C3293167 | LCSC
30 | 1 | S6B-PH-K-S( LF)(SN) | U2 | CONN-TH_6 P-P2.00_S6B -PH-K-S-LF-SN | | S6B-PH-K-S( LF)(SN) | JST | C157920 | LCSC
31 | 1 | LM5145RGY R | U11 | VQFN-20_L4 .5-W3.5-P0.5 0-BL-EP | | LM5145RGY R

ROYAL( )

FOJAN(

) | C2906988 | LCSC

FOJAN(

) | | LCSC

FOJAN(

) | C2930128 | LCSC

FOJAN(

) | C2907139 | LCSC

ROYAL( )

FOJAN(

) | | LCSC

ROYAL( )

TI(

) | C485912 | LCSC

UNI-

# ROYAL FOJAN FOJAN FOJAN FOJAN UNI-

ROYAL

# Kangshen Texas

Instruments

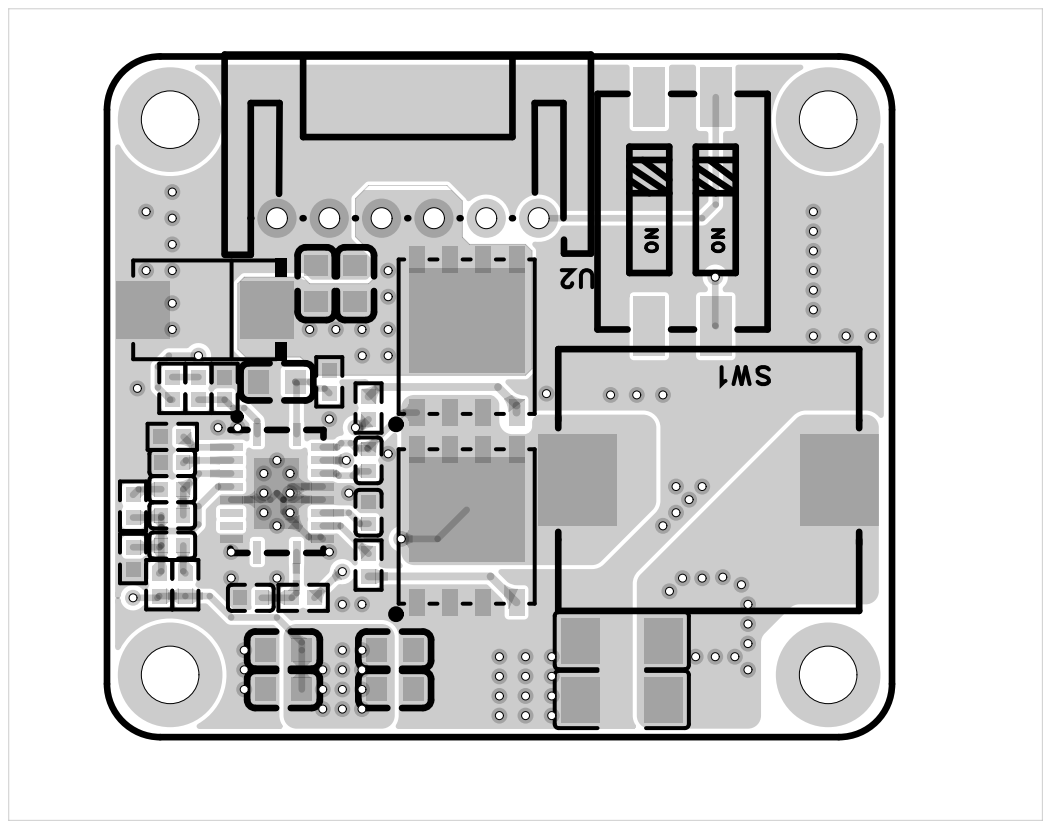
[picture p169: page 5]

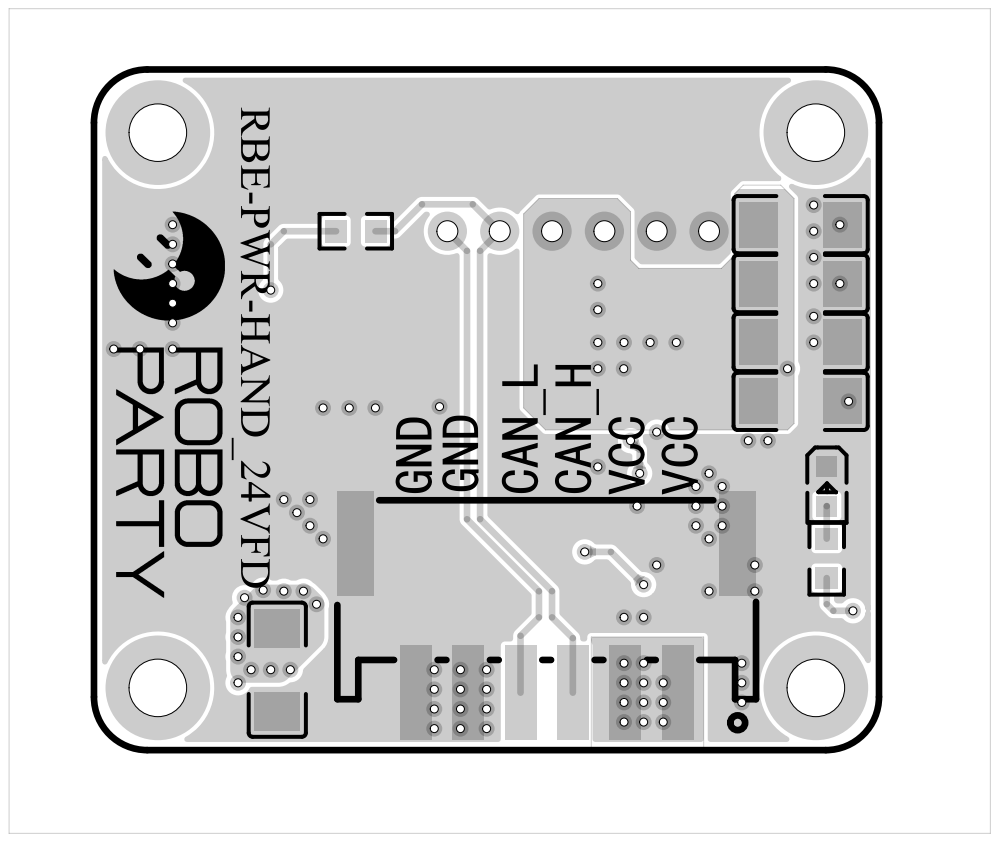
[picture p170: page 6]

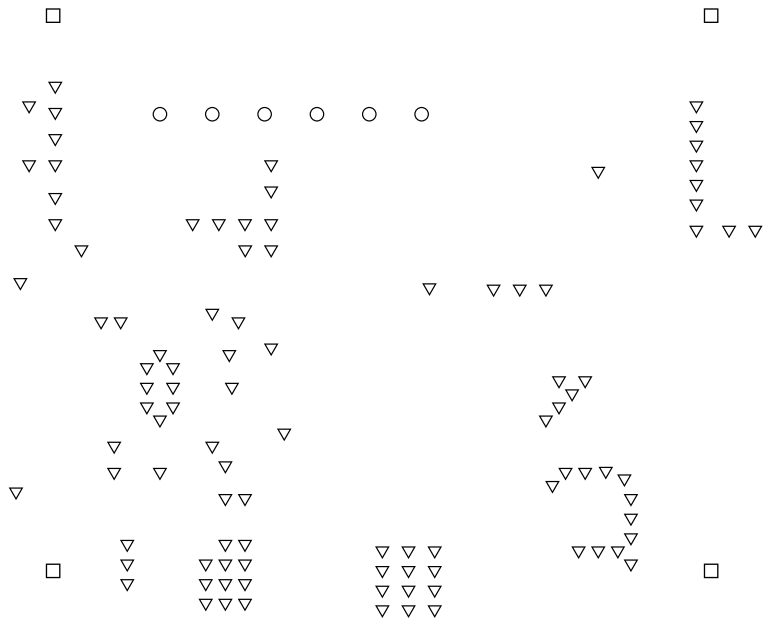
[picture p171: page 7]

ROBOSKIN | RP1-derived engineering record

English file: 06_PCB_PDF_HAND.pdf
Status: derivative identification; NOT a manufacturing release.

Existing dimensions, tolerances, material and revision remain authoritative. Source engineering graphics and original attribution are retained. Technical notes may remain in the source language.
Only searchable project part IDs on original pages are replaced. Outlined/raster labels require the original CAD authoring application.

Original drawing pages: 7
Searchable ID replacements: 0
Source: Roboparty/rp1_hardware
Hardware licence: CERN-OHL-W-2.0 where applicable; see LICENSES.md. Original path and SHA256: electronic_skin/branding/file_manifest.json

Part aliases in this document:

תודימה , ורמשנ טוטרשבש תולובסהו םירמוחה . הדשו דומע ןייצמ לאמשמ רפסמה . | - ROBOSKIN טוטרשה טסקטל ירבע ארקמ

p3 T0440

Samsung

p3 T0644

האוה [ םש עטקמ ]

p3 T1166

הקימרק [ עטקמ ]

p3 T1333

HRE

p3 T0715

YAGEO

p3 T1534

FH

p3 T0793

R+O

p3 T0903

הד [ םש עטקמ ]

p3 T1330

] DEALON םש עטקמ ]

p3 T1497

] Cjiang םש עטקמ ]

p3 T1172

למשח [ עטקמ ]

p3 T1054

Guiguang Light

p3 T0805

FOJAN

p3 T0665

UNI-ROYAL

p4 T0665

UNI-ROYAL

p4 T0805

FOJAN

p4 T0896

Kangshen

p4 T0904

Texas Instruments
