oznav2/tectile_skin/hardware/02_PCB/08_RBE-PWR-MCAP/06_PCB_PDF_MCAP_2026-09-16.pdf

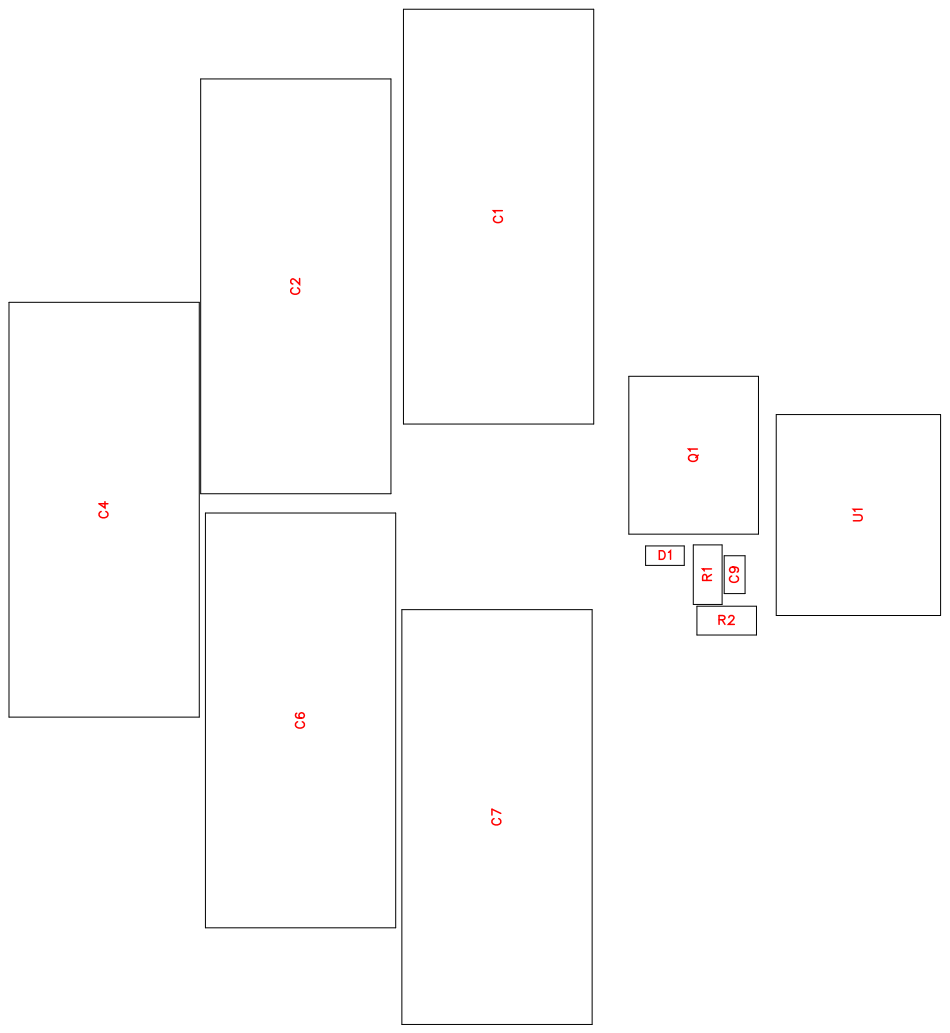
[picture p172: page 1]

No. | Quantity | Comment | Designator | Footprint | Value | Manufacturer Part | Manufacturer | Supplier Part | Supplier
1 | 5 | CAP_TH_BD 13-L30 | C1,C2,C4,C6,C7 | CAP-TH_BD 13-L30-P10.0 0-L45-W15-F D
2 | 1 | 100nF | C9 | C0603 | 100nF | FCC0603B10 4K500CT
3 | 1 | DDZ16ASF-7 | D1 | SOD-323F_L 2.0-W1.6-LS 2.5-RD | | | | | C460845 | LCSC
4 | 1 | HSY0149A | Q1 | TOLL-8_L10. 4-W9.9-P1.2 0-LS11.7-BL _2 | | | | | C53244085 | LCSC
5 | 1 | 280k | R1 | R1206 | 280k | FRC1206F28 03TS
6 | 1 | 680k | R2 | R1206 | 680k | FRC1206J68 4 TS
7 | 1 | XT30PW(2+2 )-M.G.B | U1 | CONN-TH_4 P-XT30PW- M | | XT30PW(2+2 )-M.G.B | | | C19268030 | LCSC

FOJAN(

) | C5137636 | LCSC
DDZ16ASF-7 | ODES( )
HSY0149A | SHUO( )

FOJAN(

) | C2933657 | LCSC

FOJAN(

) | C2907527 | LCSC

ASS(
)

FOJAN

יימ
עטקמ

]
םש ]
עטקמ ]הדיחי
]

HUASHUO

FOJAN FOJAN

] םש עטקמ ] AMASS

הס
עטקמ

]
םש ]

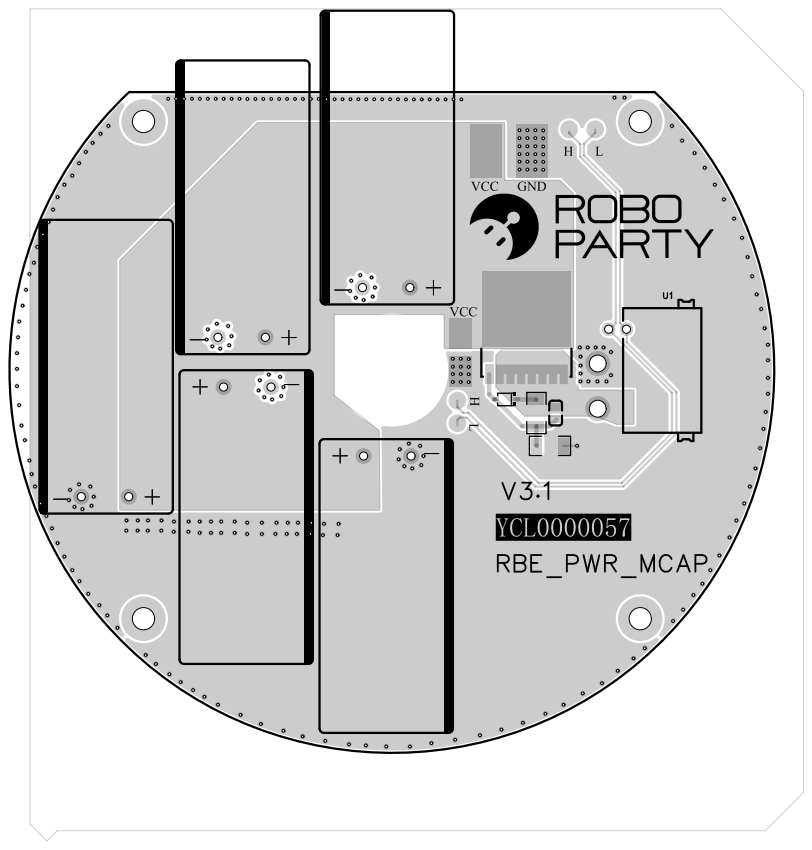
[picture p173: page 4]

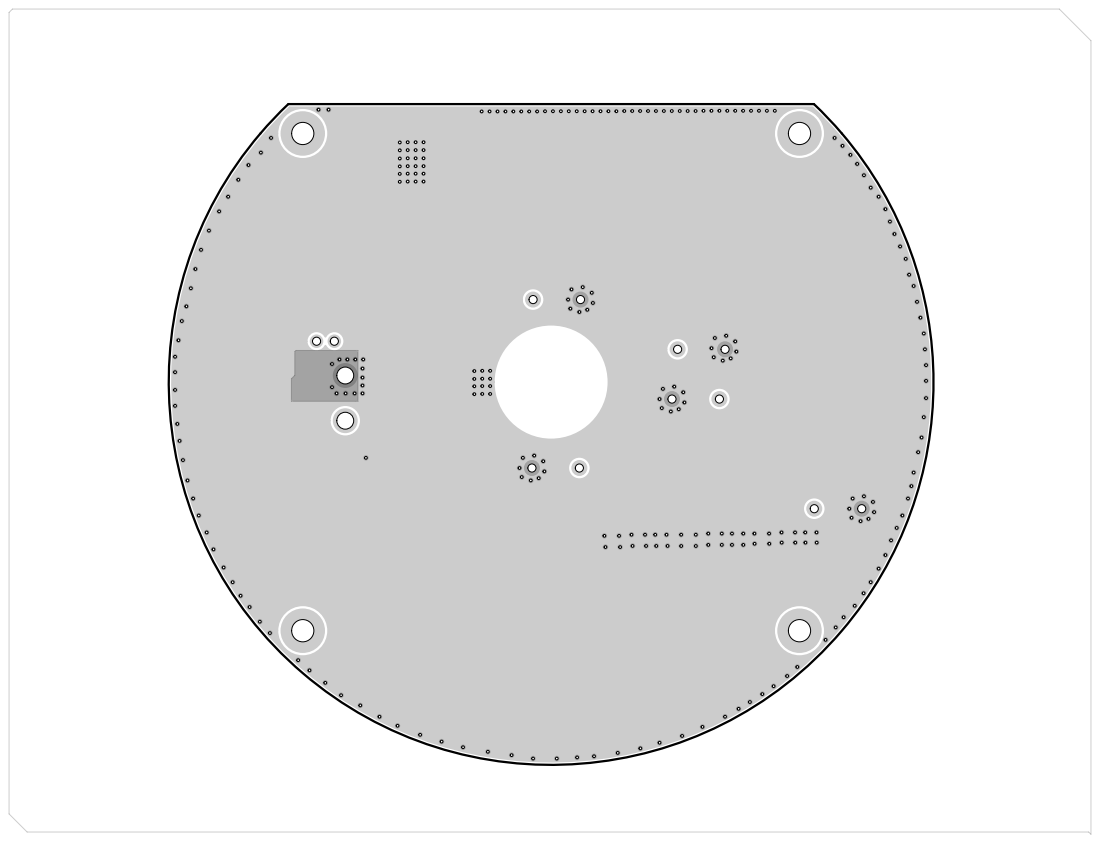
[picture p174: page 5]

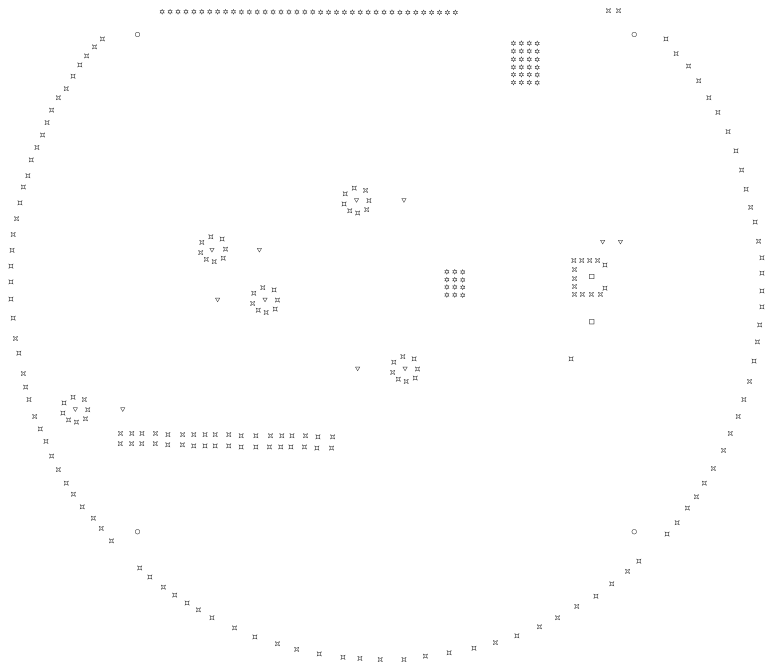
[picture p175: page 6]

ROBOSKIN | RP1-derived engineering record

English file: 06_PCB_PDF_MCAP_2026-09-16.pdf
Status: derivative identification; NOT a manufacturing release.

Existing dimensions, tolerances, material and revision remain authoritative. Source engineering graphics and original attribution are retained. Technical notes may remain in the source language.
Only searchable project part IDs on original pages are replaced. Outlined/raster labels require the original CAD authoring application.

Original drawing pages: 6
Searchable ID replacements: 0
Source: Roboparty/rp1_hardware
Hardware licence: CERN-OHL-W-2.0 where applicable; see LICENSES.md. Original path and SHA256: electronic_skin/branding/file_manifest.json

Part aliases in this document:

תודימה , ורמשנ טוטרשבש תולובסהו םירמוחה . הדשו דומע ןייצמ לאמשמ רפסמה . | - ROBOSKIN טוטרשה טסקטל ירבע ארקמ

p3 T0805

FOJAN

p3 T1275

יימ [ םש עטקמ ]

p3 T0685

הדיחי [ עטקמ ]

p3 T0645

HUASHUO

p3 T1331

] AMASS םש עטקמ ]

p3 T0993

הס [ םש עטקמ ]
