oznav2/tectile_skin/hardware/02_PCB/10_RBE-SENS-IMU/06_PCB_PDF_IMU_2026-09-16.pdf

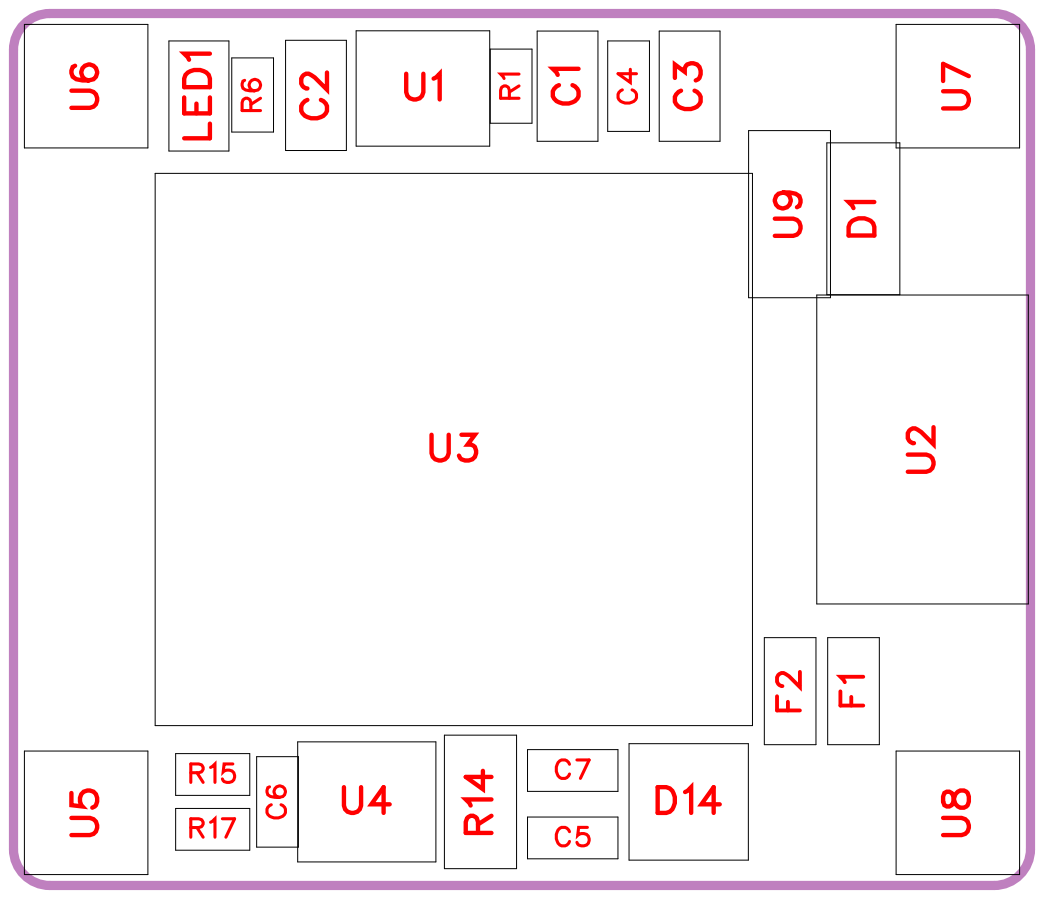
[picture p176: page 1]

R15 | U4 | C7 | D14
R17 | | C5

No. | Quantity | Comment | Designator | Footprint | Value | Manufacturer Part | Manufacturer | Supplier Part | Supplier
1 | 2 | 1uF | C1,C2 | C0603 | 1uF | CL10A105K O8NNNC | | C1592 | LCSC
2 | 1 | 10uF | C3 | C0603 | 10uF | CL10A106M O8NQNC | | C92487 | LCSC
3 | 2 | 100nF | C4,C6 | C0402 | 100nF | CL05B104K O5NNNC | | C1525 | LCSC
4 | 2 | 100pF | C5,C7 | C0402 | 100pF | 0402CG101J 500NT
5 | 1 | 1N5819HW-7 -F | D1 | SOD-123_L2 .7-W1.6-LS3. 7-RD | | 1N5819HW-7 -F | | | C82544 | LCSC
6 | 1 | SM24CANB-02HTG | D14 | SOT-23-3_L2 .9-W1.3-P1.9 0-LS2.4-BR | | SM24CANB-02HTG | | | C151237 | LCSC
7 | 2 | SMD0603-01 0-24V | F1,F2 | F0603 | | SMD0603-01 0-24V | | | C70048 | LCSC
8 | 1 | GL0603UG0 1 | LED1 | LED0603-RD | | GL0603UG0 1 | G | | C51933293 | LCSC
9 | 3 | 1K | R1,R15,R17 | R0402 | 1K | 0402WGF33 0JTCE | | | | LCSC
10 | 1 | 510R | R6 | R0402 | 510R | 0402WGF33 0JTCE | | | | LCSC
11 | 1 | 120 | R14 | R0805 | 120 | 0805W8F120 0T5E | | | C17437 | LCSC
12 | 1 | SPX3819M5-3.3 | U1 | SOT-23-5_L2 .9-W1.6-P0.9 5-LS2.8-BL | | SPX3819M5-3.3 | | | C990001894 1 | LCSC
13 | 1 | WAFER-GH1 .25-4PWB | U2 | גרוב CONN-SMD_ 4P-P1.25_X UNPU_WAF ER-GH1.25-4 PWB | | WAFER-GH1 .25-4PWB | ROYAL XUNPU SIT גרוב | | C3029379 | LCSC
14 | 1 | HI05XX | U3 | HI02_HI05
15 | 1 | SIT3051TK | U4 | DFN-8_L3.0-W3.0-P0.65-BL-EP
16 | 4 | M2 | | | U5,U6,U7,U8 | M2
17 | 1 | SMF5.0CA | | | U9 | SOD-123FL_ L2.8-W1.8-L S3.7-BI | | | | SMF5.0CA | KUU | C2985633 | LCSC

SUNG( )

SUNG( )

SUNG( )

FH(

) | C1546 | LCSC

ODES( )

e(
)

ht(

)
ROYAL( )

ROYAL( )

ROYAL( )

XUNPU( )

SIT3051TK | SIT(
) | C601078 | LCSC

## Samsung Samsung Samsung

FH

יימ
עטקמ

]
םש ]
עטקמ ]הדיחי
]

יימ
עטקמ

]
םש ]
Littelfuse [ עטקמ םש ] Luhai Taiwan Guiguang Light UNI-

ROYAL

UNI-ROYAL

UNI-

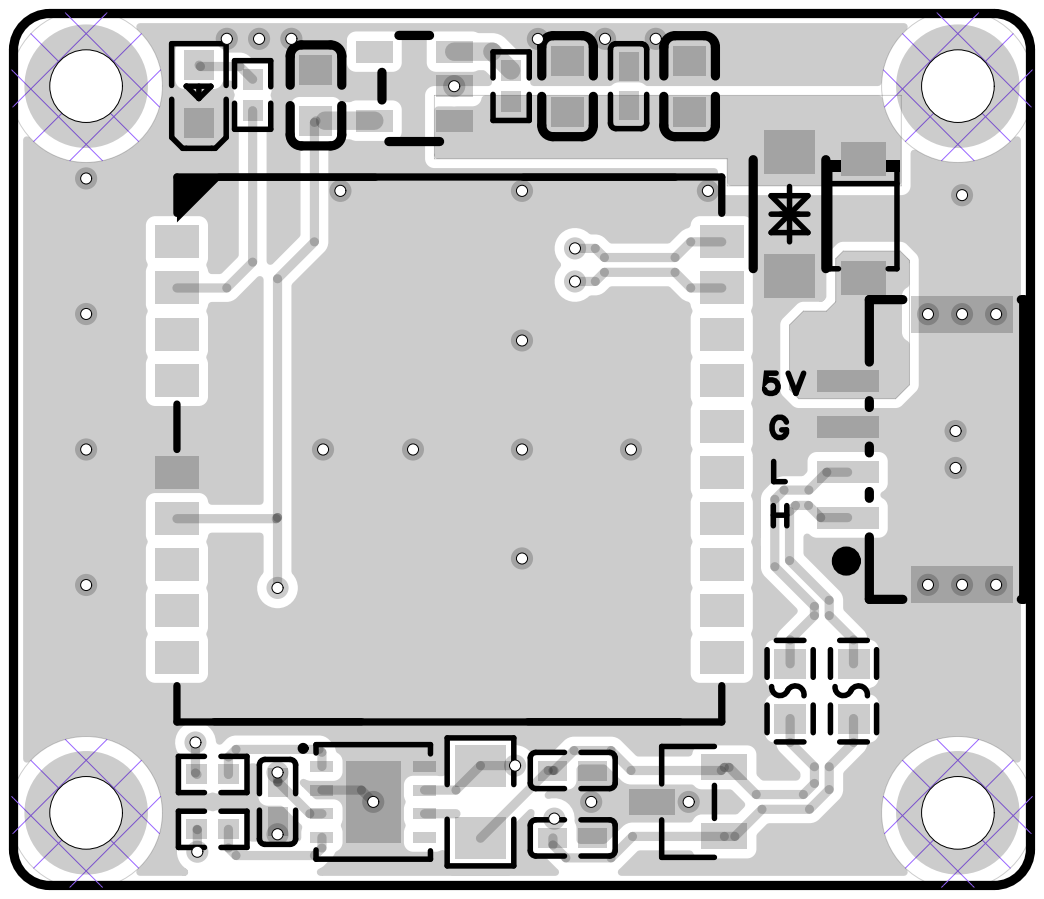
[picture p177: page 4]

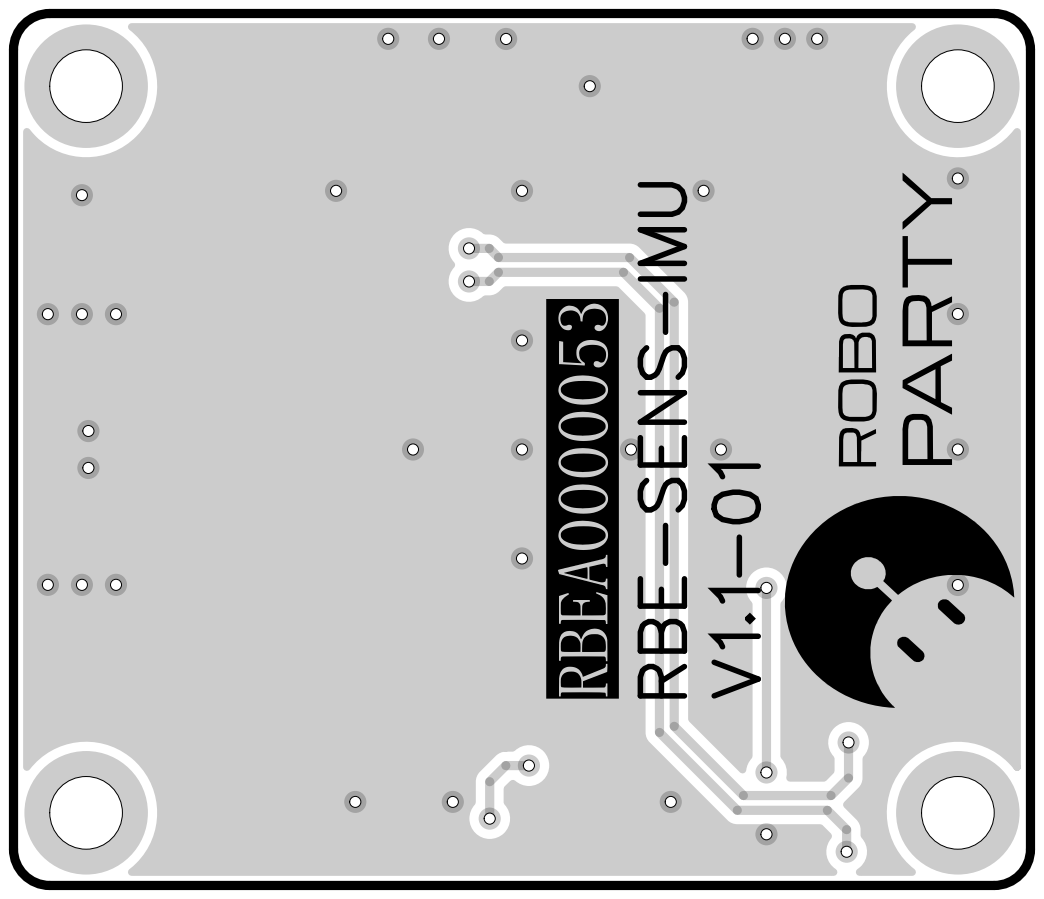
[picture p178: page 5]

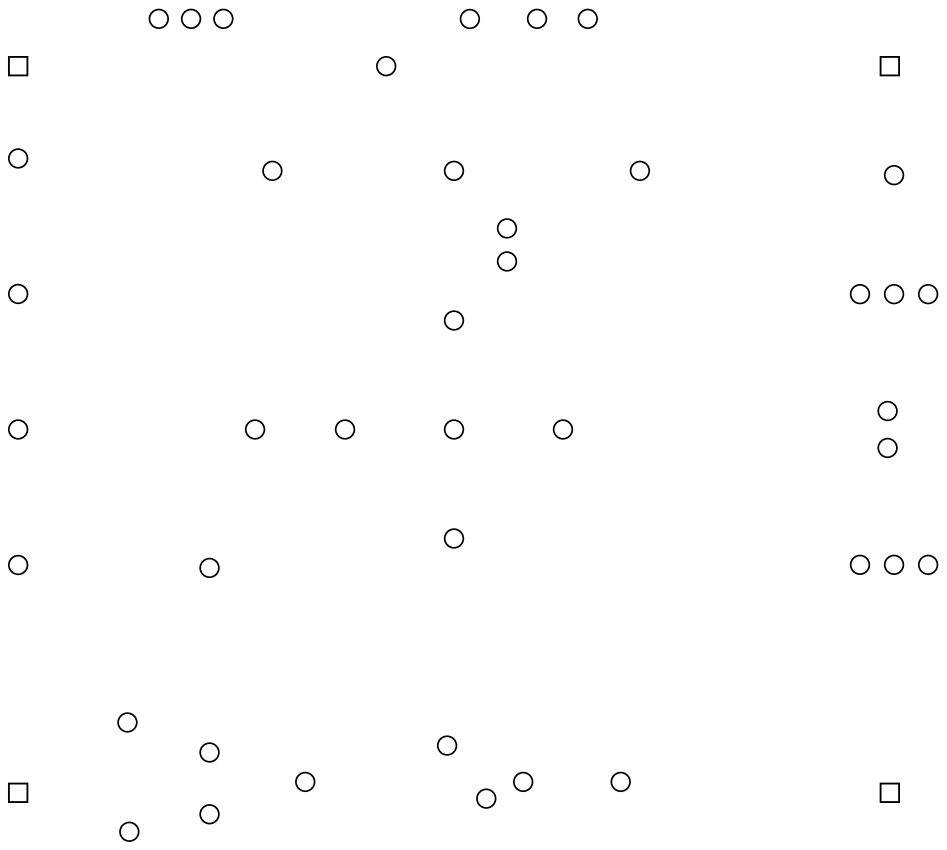
[picture p179: page 6]

ROBOSKIN | RP1-derived engineering record

English file: 06_PCB_PDF_IMU_2026-09-16.pdf
Status: derivative identification; NOT a manufacturing release.

Existing dimensions, tolerances, material and revision remain authoritative. Source engineering graphics and original attribution are retained. Technical notes may remain in the source language.
Only searchable project part IDs on original pages are replaced. Outlined/raster labels require the original CAD authoring application.

Original drawing pages: 6
Searchable ID replacements: 0
Source: Roboparty/rp1_hardware
Hardware licence: CERN-OHL-W-2.0 where applicable; see LICENSES.md. Original path and SHA256: electronic_skin/branding/file_manifest.json

Part aliases in this document:

תודימה , ורמשנ טוטרשבש תולובסהו םירמוחה . הדשו דומע ןייצמ לאמשמ רפסמה . | - ROBOSKIN טוטרשה טסקטל ירבע ארקמ

p3 T0440

Samsung

p3 T1534

FH

p3 T1275

יימ [ םש עטקמ ]

p3 T0685

הדיחי [ עטקמ ]

p3 T0714

] Littelfuse םש עטקמ ]

p3 T0686

Luhai Taiwan

p3 T1054

Guiguang Light

p3 T0665

UNI-ROYAL

p3 T1364

XUNPU

p3 T1332

SIT

p3 T1348

גרוב
