oznav2/tectile_skin/(commit log)

2026-10-24 Create independent ROBOSKIN electronic skin project
    [cost_inputs.csv, example_88_site_bom.csv, harness_connections.csv, patch_circuit_connections.csv, patch_cost_inputs.csv, region_circuit_connections.csv, removable_carrier.scad, system_bom.csv]
2026-10-24 Restore manufacturing hardware with Hebrew and English documentation
    [01_BOM_140WCHG_2026-09-09.xlsx, 01_BOM_433TX_2026-09-20.xlsx, 01_BOM_BACKHUB_2026-09-14.xlsx, 01_BOM_FAN_V2.0.xlsx, 01_BOM_FPC_2026-09-18.xlsx, 01_BOM_HAND_2026-09-09.xlsx, 01_BOM_HEAD_2026-09-09.xlsx, 01_BOM_HOTSWAP_2026-09-18.xlsx]
2026-10-24 Add Hebrew robot overview and complete PCB and harness catalogues
